aaltaay/Open_Duck_Mini_v2/altaay_lab/HARDWARE_AUDIT.md

# HARDWARE_AUDIT

Last updated: 2026-11-02 about 5:05 AM ET (integration pass by agent INT: B14 tried with the real 5.6 mm eye screw stack on coupon T1, B35 decided by D25 with the 75 tie points of cables3d.json, section 6 counts 22 of 35, section 7 test order TO17). Earlier: 2026-11-02 about 12:10 AM ET (final docs pass by agent NL2: section 6 counts, B1 screw count, B18 cleared on paper, new B33 to B35 from cables3d/CABLES_3D.md and DECISIONS.md D23, D24; about 12:47 AM ET the eye washers and the T14 bit from the BOM pass of agent NL1, D21 note). Earlier: 2026-11-01 about 10:55 PM ET (fastener schedule pass by the Claude Code agent: section 1 counts from fasteners/FASTENERS.md, B2, B7, B8, B14, B20, B21 and B30 updated, B31 and B32 added, DECISIONS.md D19 to D21). Earlier: about 6:25 PM ET with fixes at 6:44 PM ET (print-readiness pass, D8 to D12) and the 2:52 PM ET blocker pass. Question answered: "Every bracket, every washer, every item accounted for?"

Answer: every printed part, insert bore, screw hole, bearing seat and servo pocket in the upstream STLs (commit 730c14b) was measured on the box. Every item below is either measured from CAD/STL geometry or confirmed by a cited source. Anything that could not be verified is a BLOCKER with exactly what is needed to clear it (section 6). Nothing is labelled "inferred" as a final answer.

- Brackets: there are no metal brackets. All brackets are printed parts (52 prints, PRINT_CHECK.md).
- Washers: 16, two 0.3 mm M2.5 washers under each eye screw head as a spacer, because the eye pilots are blind (D21 and its note). No washer seats exist in the STLs; every other screw seats on a flat printed face, a recess or a servo horn.
- Nuts: 0. No nut traps or hex pockets exist in the STLs.
- Inserts: 58 M3 heat-set.
- Screws (fasteners/FASTENERS.md section 1, one record per screw in fasteners/fasteners.json): 322 to fit (D38 screw cut, D39 one more, D42 uniform patterns: +2, D47 mic boards: +4). 201 to buy, 59 from the STS3215 bags, 56 factory fitted servo case screws that stay in, 6 from the SG90 bags. 36 left out on purpose: 2 hip roll screws (D18), 11 idle horn screws that stay in the bags 25 by the D38 screw cut and 3 by D39 (F076, F178, F183; F179 and F182 fitted again). D39: every hole left without a screw is closed in the printed parts, except where another instance of the same STL uses it (twin/holes/HOLES_TWIN.md).
- Bearings: 3 x 6804 (20x32x7).

Method: assembly rebuilt from the URDF (Open_Duck_Mini b23317a, mini_bdx/robots/open_duck_mini_v2) and the print STLs; every cylindrical hole found by ray casting along its axis through all parts it passes (clearance, seat, anchor, pilot depth). Scripts and data: altaay_lab/audit/.

## 1. Fasteners and mechanical
Spares: 10 to 20%, or the pack minimum. "Included" = ships with a component.

| Item | Spec | Where (measured) | Need | Included | Buy | Source | US seller, pack, price | Ships to USA | Verified |
|---|---|---|---|---|---|---|---|---|---|
| M3 heat-set insert | 5.7 mm long, 4.0 mm hole, D1 4.6 | body_middle_bottom 8, body_middle_top 8, head 12, leg_spacer 4x4=16, trunk_bottom 6, foot_bottom_pla 2x2=4, foot_top 2x2=4 | 58 | 0 | 100 | bore 3.9 to 4.2 measured; CNC Kitchen hole spec | CNC Kitchen USA, 100 pcs, $10.90 | Yes | Yes |
| M3x8 SHCS | DIN 912 A2 | into inserts: trunk shell 16, head_bot_sheet to head 8, foot_bottom_tpu to foot_bottom_pla 4 | 28 | 0 | 33 | fasteners.json | Bolt Depot 6379, $0.06 each, $1.98 | Yes | Yes |
| M3x10 SHCS | DIN 912 A2 | into inserts: foot_side to foot_top 4, caches to leg_spacer 4, body_middle_bottom to trunk_bottom 4 | 12 | 0 | 14 | fasteners.json | Bolt Depot 6380, $0.84 | Yes | Yes |
| M3x12 SHCS | DIN 912 A2 | trunk_top to trunk_bottom inserts | 2 | 0 | 3 | fasteners.json | Bolt Depot 6381, $0.18 | Yes | Yes |
| M3x6 SHCS | DIN 912 A2 | printed parts to servo horns 64 (legs 56, roll_motor_top 8), thigh plates to leg_spacer inserts 10, head_roll_mount to head inserts 4 | 78 | 0 | 100 | fasteners.json | Bolt Depot 6378, $3.83 per 100 | Yes | Yes |
| M3x6 button head | ISO 7380 A2 (head 1.65 mm max) | hip pitch idle horn 8 (F196, F198, F200, F247, F209, F211, F213, F254) and thigh plate to leg_spacer 2 (F002, F010), where a DIN 912 head hits roll_to_pitch (D19, B31) | 10 | 0 | 12 | fasteners.json, sweep | BelMetric SB3X6SS, $0.09 each, $1.08 | Yes | Yes (read 2026-11-01 10:34 PM ET); head clearance +0.16 mm in CAD, first leg check |
| M3x5 SHCS | DIN 912 A2 | every neck chain horn screw: head_pitch_to_yaw 16, head_yaw_to_roll 4, neck sheets 8 | 28 | 0 | 33 | fasteners.json | Bolt Depot 6377, $0.05 each, $1.65 | Yes | Yes; 20 of them sit in 5.5 mm recesses that are drilled to 6.0 mm (D20, B32) |
| M3x6 horn centre screw | Feetech rocker screw | horn to servo output, 1 per servo | 14 | 14 (servo bag) | 0 | Feetech datasheet item 6-13 | n/a | n/a | Yes (datasheet M3X6) |
| PA3.0x5 idle screw | Feetech, washer head | idle horn to case boss where nothing else holds the idle horn: both hip yaws and head roll | 3 | 3 (servo bag) | 0 | Feetech datasheet drawing | n/a | n/a | Yes; the other 11 stay in the bags |
| M2x6 self-tapping (servo case) | Feetech bag, the "smallest screws" | printed parts to servo case pilots: legs 12 (including the 4 roll_to_pitch bottom holes, B4), trunk 24, neck 6; 2 more left out (D18) | 42 | 42 (servo bag) | 0 | fasteners.json; LeRobot SO-101 guide | n/a | n/a | BLOCKER B2: the 18-screw bag split by size is not published; the 17h kit holds 50 M2x6 if a bag is short |
| M2x5 self-tapping | pan head, 304, METALLIXITY M2/M2.6 kit, 50 of each size, head 3.7 x 1.4 mm (listing) | servo case pilots where M2x6 would bottom: knee sheets 8, roll_to_pitch 6, trunk_top 4, head_yaw_to_roll 2, head_roll_mount 2 | 22 | 0 | kit | fasteners.json | Amazon B0FS13B75Y, 400 pcs, $9.49, ships from Amazon | Yes | Yes (read 2026-11-01 10:30 PM ET); head fit on coupon C4 (B21) |
| M2x4 self-tapping | same kit | camera 4 (head.stl: 4 blind pilots 1.65 mm, 3.1 mm deep, on 20.9 x 12.5 mm) and head_roll_mount to servo 2 | 6 | 0 | kit | fasteners.json; Raspberry Pi Camera Module 3 drawing 21 x 12.5 mm | same kit | Yes | Pattern yes; camera length on test order (PCB thickness not published, B9) |
| M2x8 self-tapping | same kit | trunk_top to servo bottom case 2 | 2 | 0 | kit | fasteners.json | same kit | Yes | Yes |
| M2.5x6 SHCS | DIN 912 A2 | Pi 4, adapter 4, BNO055 4, charger 1, speaker stand to head 4 (nothing is fitted at the head board.stl copy, B7) | 17 | 0 | 20 | MOUNTING.md, fasteners.json | Bolt Depot 6370, $0.09 each, $1.80 | Yes | Yes |
| M2.5x8 SHCS | DIN 912 A2 | eyes 4 per side, each with two 0.3 mm washers (D21 note) | 8 | 0 | 10 | fasteners.json | Bolt Depot 6371, $0.90 | Yes | Yes |
| M2.5 flat washer | ISO 7092 A4 HV200, 2.7 x 5.0 x 0.3 mm | two under each eye screw head: the eye pilots are blind, 3.0 mm deep (D21 note) | 16 | 0 | 48 | BOM.md 17l | BelMetric WFHV2.5X5SSA4, $0.07 each, $3.36 (48 so the BelMetric cart reaches its $5 minimum) | Yes | Yes (read 2026-11-02 12:20 AM ET), in stock |
| M2.5x10 SHCS | DIN 912 A2 | battery_pack_lid to body_back | 4 | 0 | 5 | fasteners.json | Bolt Depot 6372, $0.10 each, $0.50 | Yes | Yes: head sits proud on the lid face (B3); the 2.5 mm lid holes are drilled to 2.7 mm (D20) |
| M2.5x5 SHCS | DIN 912 A2 | speaker_interface to the 4 side pilots 2.12 of speaker_stand (found by the fastener schedule, B8) | 4 | 0 | 5 | fasteners.json | BelMetric BSH2.5X5SS, $0.12 each, $0.60 | Yes | Yes (read 2026-11-01 10:36 PM ET) |
| Antenna screws | SG90 bag screws | holder to SG90 output shaft 2; SG90 tabs to head 4 (pilots 27.5 mm apart vs SG90 tab holes 27.6 mm) | 6 | 6 (SG90 bags) | 0 | GLB ray cast, B5; fasteners.json | n/a | n/a | Geometry yes; bag screw sizes on the test order (SG90 pack) |
| Servo case screws | PA2.0 self-tapping, factory fitted | 4 per servo, inside the case | 56 | 56 (in the servos) | 0 | Feetech datasheet drawing | n/a | n/a | Do not remove |
| Ball bearing | 6804ZZ 20x32x7 | trunk_bottom 2 seats, head 1 seat, all 32.19 mm | 3 | 0 | 10 (pack) | CAD bearing model 19.99/32.19/7.0 | Motoforti 10-pack, $7.74 | Yes | Yes (Amazon showed 1 left, 2026-11-01) |
| Threadlocker | Loctite 243 | metal to metal horn screws only (not into PLA) | 1 | 0 | 1 | Loctite TDS | Amazon, $9.90 | Yes | Yes |

Screw total (fasteners/fasteners.json, FASTENERS.md sections 1 and 2): machine screws to buy 18 + 12 + 2 + 78 + 10 + 28 + 11 + 4 + 3 + 2 = 168 (BOM 17a to 17g, 17i, 17j, 17k), plus 28 kit self-tapping screws (22 M2x5, 6 M2x4, 2 M2x8, BOM 17h) = 221 to buy; 42 + 14 + 3 = 59 from the STS3215 bags; 56 factory case screws stay in the servos; 6 from the SG90 bags; 342 to fit. Left out on purpose: 2 hip roll screws (D18) and 11 idle horn screws. Washers 16 (D21 note). 0 holes without an anchor. The earlier per-hole count (189 + 4 bought, from audit/screws2.json on the URDF meshes) is superseded: the print/ STLs differ from the URDF meshes (FASTENERS.md finding 20) and 4 leg screws were counted twice (finding 23).

## 2. Printed parts
Full per-STL measurements are in PRINT_CHECK.md. Totals: PLA 15% 50 parts, 1304.0 g, 127.7 h; TPU 40% 2 parts, 35.0 g, 3.9 h. Filament bought: 2 kg PLA, 1 kg TPU.

| STL | Qty | | STL | Qty |
|---|---|---|---|---|
| battery_pack_lid | 1 | | left_antenna_holder / right_antenna_holder | 1 / 1 |
| body_back | 1 | | left_cache / right_cache | 1 / 1 |
| body_front | 1 | | left_eye / right_eye | 1 / 1 |
| body_middle_bottom | 1 | | left_roll_to_pitch / right_roll_to_pitch | 1 / 1 |
| body_middle_top | 1 | | leg_spacer | 4 |
| bulb | 2 (guide says 1, CAD has 2) | | neck_left_sheet / neck_right_sheet | 1 / 1 |
| flash_light_module | 1 | | roll_motor_bottom | 2 |
| flash_reflector_interface | 1 | | roll_motor_top | 2 |
| foot_bottom_pla | 2 | | speaker_interface | 1 |
| foot_bottom_tpu (TPU) | 2 | | speaker_stand | 1 |
| foot_side | 2 | | trunk_bottom | 1 |
| foot_top | 2 | | trunk_top | 1 |
| head | 1 | | knee_to_ankle_left_sheet | 4 |
| head_bot_sheet | 1 | | knee_to_ankle_right_sheet | 4 |
| head_pitch_to_yaw | 1 | | head_roll_mount | 1 |
| head_yaw_to_roll | 1 | | | |

## 3. Electronics and modules
Every module, its mount and screw: MOUNTING.md. Every buy line with link and price: BOM.md.

## 4. Cables, connectors, crimps
Every cable as a row (ends, part numbers, route, length, source, tool): CABLE_MAP.md. Connectors to buy: Molex 50-37-5033 housings and 08-70-1040 terminals, BOM.md lines 21 and 22 (counts from wiring/netlist.yaml: the D15 star leads and the D23 ankle feeds), and XT30U pairs (1 used).

## 5. Tools
BOM.md, section "Tools (one-time)": Pinecil V2, insert tips, Engineer PA-09, Bondhus 12192 hex keys (2.0 mm for M2.5 and for the M3 ISO 7380 button heads, 2.5 mm for M3 DIN 912), Klein 11057 stripper, Castle Link V4, and for the drill steps after printing a 6.0 mm and a 2.7 mm HSS bit (D20) and a 4.0 mm bit (D24 and the D25 tie holes) with a T-handle holder (T11 to T14; T15 4.5 mm only if coupon C4 needs it).

## 6. BLOCKERS (status after the 2026-11-04 V1 electrical twin, about 4:50 PM ET)
Rule: an item is CLEARED only when it was measured from the upstream CAD (print STLs at 730c14b, Tnkr GLB of the upstream assembly) or confirmed by a cited source read on 2026-11-01. Everything else stays OPEN. Items that only a real part can settle are on the "Needs test order" list (section 7, priced in BOM.md).

Totals after the V1 knee swap (2026-11-05, D32 and D38): 30 of 73 cleared or decided, 7 settled by the coupon test prints, 7 waiting on the parts check, 22 assembly or bench checks; B70 to B73 new (B71 decided by D38; twin/knee/KNEE_TWIN.md).

Totals after the V1 3D track (2026-11-04 night): 26 of the then 64 rows cleared or decided, 6 then waiting on the parts check; B60 to B64 new (B60 and B61 decided by D34; B63 and B64 cleared, CAD check; B62 open, an assembly and bench check).

Totals after the V1 screws job (phase 2, 2026-11-04 about 8:46 PM ET, D36 and D38): 29 of the then 69 rows cleared or decided, 7 settled by the coupon test prints, 6 then waiting on the parts check; B65 to B69 new (twin/screws/SCREWS_TWIN.md).

Totals after the V1 assembly twin (track 2, 2026-11-04 evening): 22 of the then 59 rows cleared or decided, 6 then waiting on the parts check; B53 to B59 new (B54 fixed in the twin, CAD check; B49 fixed in the twin by D30, its bench check stays open). The count below is the track 1b one, when the table had 52 rows.

Totals after the 2026-11-04 V1 electrical fixes (track 1b, about 5:40 PM ET): 22 of the then 52 rows cleared or decided (B1, B3, B4, B5, B7, B9, B11, B12, B13, B18 cleared on paper, B19, B22, B23, B24, B25, B27, B28, B29, B30 decided by D18, B31 by D19, B34 by D24, B35 by D25), 5 then waiting on the parts check (B8 speaker, B33 ankle plugs at foot_side, B38 PLA at the hot parts, which waits for B36 and B37, and from the structure twin, FEA pass only: B42 roll_to_pitch and B43 the knee sheet eye, which wait for the proof loads of print/PRINT_PLAN.md step 2 check 7 and for D26), 5 then settled by the coupon test prints (B14, B15, B16, B26, B32 decided by D20 and tried on coupon C4), 19 assembly or bench items at that time with real parts that do not block printing (B2, B6, B10, B17, B20, B21, and from the twins and the shared lab gym, sim pass only: B36, B37, B39, B40, B41, from the structure twin: B44 fatigue life, B46 fastener data, and from the V1 electrical twin, sim pass only and calc only: B47 the BMS trip current, B48 power-on inrush, B49 the drain after the guard's poweroff, and from the track 1b fixes: B50 the servo gains in the twin, B51 the restart after a power loss, B52 the IMU on software I2C), 1 for Ahmed to decide later (B45, the floor of the first walks; a proposal, not decided). Print-blocking blockers left: none. B33 is a first-leg check before the other plates print, as D18 and D19; B42 and B43 are left-leg checks before the right leg prints; B38 (PLA or PETG at the hot parts) is settled after B36 and B37, before the full print; B31, B32, B34 and B35 are build steps (button heads at assembly, recess drilling, the D24 hole and the D25 tie holes after printing, and the D25 bundle ties checked at the harness test fit). The coupon session is the first print and needs Ahmed's OK (lab rule 4).

| # | Blocker | Status | How verified, or what is still needed |
|---|---|---|---|
| B1 | Upstream Onshape BOM export (fastener list) | CLEARED (decision, 2026-11-01 about 6:25 PM ET) | The fastener schedule (fasteners/fasteners.json, section 1) is the fastener list for ordering (201 screws by size with the 4 D47 mic screws, 47 inserts); 320 screws are fitted in all, the rest from the servo and SG90 bags or factory fitted. An upstream Onshape export is no longer needed. Upstream issue 33 still lists the screw docs as a TODO. |
| B2 | STS3215 bag contents by size (18 screws) | OPEN, assembly check (not print-blocking), test order 1 | Count the 18-screw servo bag by size on the first servo. The METALLIXITY M2 kit (BOM 17h) covers any short count: it holds 50 M2x6 against the 42 used (listing images, read 2026-11-01 10:31 PM ET). The bag M2 head also gets the 4.0 mm recess fit test on coupon C4 (D20). |
| B3 | battery_pack_lid recess 4.0 vs M2.5 head 4.5 | CLEARED | Measured in the GLB: the M2.5x10 DIN 912 head sits proud on the lid face, clamp 5.2 mm, engagement 4.8 mm into the body_back pilot, no part within 1 mm of the head envelope. No STL edit and no low-head screw needed. Keep M2.5x10 (Bolt Depot 6372). |
| B4 | roll_to_pitch: 4 clearance holes, no anchor | CLEARED | Ray cast through the GLB assembly: each hole lands on an STS3215 case pilot 1.67 mm, 4.6 mm deep. Screw: M2x6 self-tapping, the servo bag type. |
| B5 | Antenna holder holes and 39.2 mm pilot spacing | CLEARED | The 39.2 mm figure was wrong. Head tab pilots measure 27.5 mm apart; SG90 tab holes 27.6 mm (GLB sg90 model). The 2 holder holes (clearance 2.7 in a 5.05 recess) land on the SG90 horn. Screws from the SG90 bags; their sizes are confirmed on the test order (SG90 pack). |
| B6 | Horn to case gap and pilot depth at the 2 M2x5 sites | OPEN, assembly check (not print-blocking), test order 1 and 4 | Real servo plus M2x5 from the METALLIXITY kit. |
| B7 | Second board.stl in the head | CLEARED | There is one board; the adapter is on trunk_top and upstream bom.csv lists one adapter. M2.5x6 count drops from 21 to 17. Basis corrected 2026-11-01 (fasteners/FASTENERS.md finding 22): the head board.stl copy does not share the Pi holes (Pi 58 x 23 mm on the left, copy 28 x 37 mm on the right); the conclusion holds because print/head.stl has no pilots under the copy, so nothing is fitted there. |
| B8 | Speaker retention and size; projector LED retention | OPEN, test order 7 and 10 | CAD speaker_top envelope 38.5 x 38.7 x 15 mm; speaker_interface has 4 holes 2.7 mm that match 4 pilots 2.12 mm in speaker_stand (32 x 32 mm); the pilots are on the hole axis: measured on the mesh 0.01 deg off (2026-11-06 ET, twin/freeze/speaker_pilots.py, CAD check only); the "20.7 deg off" was the feat3d fit reading them along the head y axis, the artefact PR 25 found on the ear pilots. Each 2.05 mm pilot runs through 4.5 mm of stand wall, so the 2 fitted M2.5x5 DIN 912 A2 (BOM 17k, the diagonal pair F353 and F354 since D38) engage 3.4 mm with the tip 1.1 mm short of the far face (FASTENERS.md finding 19); the screws go straight in. Since D52 the interface carries the speaker duct (twin/freeze/speaker_duct.json). Upstream ANGEEK B086JH2BTD (40 mm, 4 ohm, 3 W) is not sold on amazon.com; US equivalent uxcell B07M5K17SK (40 x 40 x 20 mm per listing). Retention needs the real speaker in a printed speaker_interface. Projector: the flash_reflector_interface seat tapers to 20.0 mm (measured); retention of the LED needs the real reflector. |
| B9 | Camera not in CAD | CLEARED (part and mount); screw length on test order 8 | head.stl has 4 blind pilots 1.65 mm, 3.1 mm deep, on 20.9 x 12.5 mm. Raspberry Pi Camera Module 3 mechanical drawing (datasheets.raspberrypi.com): 25 x 24 mm board, 4 x 2.2 mm holes 2 mm from the edges, 21 x 12.5 mm pattern, which matches. Part: Adafruit 5657 ($29.25, in stock) with Adafruit 3157 Pi Zero camera cable 150 mm ($5.95). PCB thickness is not published, so M2x4 vs M2x3 is a test-order item. |
| B10 | STS3215 connector positions not modelled | OPEN, assembly check (not print-blocking), test order 1 | Tnkr: both bus ports sit side by side in a slot in the bottom case, plugs from below. Exact position on the first servo; affects cable routing only. |
| B11 | Seats not in CAD | CLEARED (2026-11-01 about 6:20 PM ET) | Seats found for every part not in the CAD by a free-space search over the swept volume of all moving trunk joints with cable keep-outs (audit/free_space.py, audit/place_parts.py, audit/placements.json): BEC Pro flat on the belly floor, fuse holder and Pololu 2815 on the battery bay front wall, 5 V regulator on the head floor. Foam tape, no new printed part. MOUNTING.md. |
| B12 | BMS fit | CLEARED (2026-11-01 about 6:20 PM ET, D10) | Tenergy 32175 (34 x 16 x 4.5 mm, 10 A working, over-current detect 22 +/- 5 A, full spec table, US seller) fits the measured envelope 17.75 x 47.2 x 5.33 mm. Current check: sim/CURRENT_BUDGET.md. |
| B13 | BNO055 2472 hole spacing | CLEARED (2026-11-01 6:05 PM ET) | Adafruit design file (github.com/adafruit/Adafruit-BNO055-Breakout-PCB, Adafruit BNO055.brd, commit 64c5a38): 4 plated holes, drill 2.5 mm, at 21.59 x 15.24 mm on a 26.67 x 20.32 mm board. CAD pilots 21.9 x 14.9: each hole is 0.23 mm off its pilot, inside normal print tolerance for an M2.5 screw self-tapping a 2.0 mm PLA pilot. Fallback: 2 diagonal screws (diagonals differ by 0.06 mm). |
| B14 | Left eye pilot 2.2 vs right 2.05 | TEST PRINT, coupon session (print/PRINT_PLAN.md, T1) | Print left_eye.stl first (T1) with the stack pieces T1b (bulb) and T1w (head wall) and drive an M2.5x8 through two 0.3 mm washers (BOM 17l), T1b and T1w, 5.6 mm under its head as in the robot: the pilots are blind, 3.0 mm deep, so the robot stack (washers 0.6, bulb 2.0, head wall 3.0) leaves 2.4 mm of thread (D21 note). If loose, add a drop of medium CA glue in the pilot and re-seat, or use an M2.5 thread-forming screw for plastic. PrusaSlicer 2.7 has no hole-only compensation (Orca and Bambu Studio do). |
| B15 | Shallowest blind insert bore (foot_bottom_pla: 5.8 mm deep with a drill-point cone, 1.06 mm floor, for a 5.7 mm insert) | TEST PRINT, coupon C3 | One insert into the bore on coupon C3 cut from the real part (print/make_coupons.py): it must sit flush with no plastic pushed up around it. The 6.7 mm depth quoted earlier does not exist in any STL (print package check, 2026-11-01). |
| B16 | foot_top insert wall 1.5 mm | TEST PRINT, coupon C2 | foot_top printed with enough perimeters to make the 1.5 mm wall solid (print/ slicer override), then a pull test on the coupon. |
| B17 | Kit servo cable lengths on 10 hops | OPEN, assembly check (not print-blocking), test order 1 | Test-fit kit cables at joint limits on the first leg. Contingency X1/X2 (made Mini-SPOX leads) is in the BOM. |
| B18 | USB cable 50 cm vs 502.6 mm rule | CLEARED (on paper, 2026-11-02: 0.9 m cable and its 3D route), test fit on test order 3 | BOM line 20 is now the 0.9 m Adafruit 3878 (Adafruit page, read 2026-11-01). The 3D route of D1 measures 523 mm worst over the full URDF ranges (499 mm in the Runtime head ranges), 563 mm with the 40 mm slack: 337 mm spare, coiled in the belly (cables3d/CABLES_3D.md). Test fit through the neck and the coil on test order 3. |
| B19 | Neck chain join | CLEARED | Tnkr wiring (upstream assembly docs, "as in the creator's wiring diagram"): no splitter; adapter socket 1 to left hip yaw, socket 2 to right hip yaw; the neck chain starts from the left ankle's free bus port and runs up to neck pitch, head pitch, head yaw, head roll. Every STS3215 has 2 ports in parallel. Made lead left ankle to neck pitch: polyline 336.4 + 45.2 + 40 + 68.1 (6.81 rad) = 489.7, cut 490 mm, 2 housings and 6 terminals. Y-lead S1Y dropped. Superseded by D15 (star wiring: SP3 feeds the neck at ID 30). |
| B20 | IMU axis signs | OPEN, bench test after assembly (not print-blocking) | Tilt test: run scripts/calibrate_imu.py from scripts/, then bench/imu_check.py --tilt (calibrate_imu.py only calibrates and saves the offsets; software/SOFTWARE.md sections 2 and 4). The walk script and calibrate_imu.py use raw_imu.py: NDOF mode, axis remap (Y, X, Z) with signs (-, +, +) when upside_down is false (imu.py, IMUPLUS mode, is not used by the walk). The policy reads only raw gyro and accelerometer. Also log 1000 still reads to catch the I2C glitches in UPSTREAM_ISSUES.md G2. |
| B21 | M2x5 head fit | OPEN, assembly check (not print-blocking), test order 1 and 4 | Test fit of M2x5 heads. 24 M2 pan heads sit in 4.0 mm recesses (trunk_top, head_yaw_to_roll, roll_to_pitch; 10 kit M2x5, 14 servo-bag M2x6). Kit head 3.7 x 1.4 mm per its listing image (read 2026-11-01 10:31 PM ET), so 0.3 mm clearance before print shrinkage. Fit test on coupon C4, which holds 4 of these recesses (D20); open a recess to 4.5 mm if a head does not drop in. |
| B22 | 15 A switch that fits the body_back cutout | CLEARED (2026-11-01 about 6:20 PM ET, D8) | Design change: a Pololu 2815 Big MOSFET Slide Switch HP carries the pack current (6 A at 55 C, 16 A at 150 C, 90 A max) and the stock panel switch in the body_back cutout only pulls its control pin to GND (microamps). No STL change. POWER.md section 6. |
| B23 | LED type and resistor | CLEARED | Upstream bom.csv: 1 W LED beads. Tnkr (m7): two 1 W eye LEDs on GPIO27 and GPIO22, each through a 100 ohm resistor. Parts: uxcell 1 W warm white 10 pcs B07DHB13J4 ($6.89), SparkFun PRT-14493 100 ohm 20-pack ($1.50). Pins: D9 (2026-11-01) wires the eyes to GPIO24 (left, pin 18) and GPIO23 (right, pin 16) per the Runtime code; the Tnkr pins GPIO27/GPIO22 are the foot switch pins in the code and are not used. Resistors: 3 needed (2 eyes plus the projector LED, D13); the 20-pack covers it. |
| B24 | Pi Zero 2 W stock | DECIDED (2026-11-01 about 6:20 PM ET, D7), not print-blocking | Bare board out of stock at Adafruit, PiShop, CanaKit and Vilros (checked 2026-11-01). In stock: CanaKit PI-Z2WH-STR32-C4-BLK kit with pre-soldered header, $89.95. The header fits: 44.3 mm free below the Pi in the head (ray cast). |
| B25 | microSD model | CLEARED | SanDisk Ultra 32 GB SDSQUAR-032G-GN6MA, https://www.amazon.com/dp/B073JWXGNT, $21.25, in stock. |
| B26 | TPU hardness | TEST PRINT, coupon session | Print foot_bottom_tpu in Overture TPU 95A, check grip and fit on foot_bottom_pla. |
| B27 | Holder mid tap for the BMS balance lead | CLEARED | Tnkr m1 and m2: the holder strip makes the series link, the MID take-off goes to BMS BM with a 24 to 26 AWG lead. Solder P3 to the strap. |
| B28 | Lead lengths | CLEARED (decision, 2026-11-01 about 6:25 PM ET) | No cost impact: every short lead is extended with the bought 16, 20, 22 and 26 AWG wire (D9 SG90 lead +20 mm of 26 AWG). Holder, regulator and BEC lead lengths are measured on arrival. |
| B29 | Order minimums | CLEARED | Bolt Depot: "Do you have a minimum order? No" (service page). Mouser: no minimum order value for stocked parts (Ordering Options help page, read via search index, direct fetch 403). DigiKey and Newark: qty 1 allowed on every line used (pricing tables). CNC Kitchen, Adafruit, SparkFun, Seeed, Amazon: pack products, no minimum. Shipping excluded by the owner. |
| B30 | Hip roll servo screw head against roll_to_pitch (upstream issue 17) | DECIDED (D18, 2026-11-01 7:32 PM ET), checked on the first leg | CAD: the outer M2 screw in roll_motor_bottom sits 0.31 mm from the roll_to_pitch arm; a pan head overlaps it by 1.3 mm over the full hip roll range, both legs (print/check_hip_roll_screw.py). Leave that screw out; if the servo is not rigid on the first leg, cut a relief in roll_to_pitch before the right leg is printed. The fastener sweep finds the same hit (0.80 mm with the screw on the pilot centre line, fasteners/FASTENERS.md finding 1). The same check on the first leg covers the hip pitch idle horn screws: B31, D19. |
| B31 | Hip pitch idle horn screw heads against roll_to_pitch (fastener sweep) | DECIDED (D19, 2026-11-01 10:50 PM ET), checked on the first leg | CAD sweep (fasteners/sweep_fasteners.py, FASTENERS.md findings 2, 5, 6): at the 8 thigh plate to hip pitch idle horn sites (F196, F198, F200, F247, F209, F211, F213, F254) a DIN 912 M3 head overlaps roll_to_pitch by 1.19 mm at every hip pitch angle, both legs; at F002 and F010 it is hit by 0.19 mm from hip pitch +/-18.9 deg. Fit M3x6 ISO 7380 A2 button heads at these 10 sites (BOM 17j): worst clearance +0.16 mm and +1.16 mm. Turn the hip pitch through its range by hand on the first leg (print/PRINT_PLAN.md left-leg check 5); if a head rubs, cut a relief in roll_to_pitch before the right leg is printed. Open note: at F198 and F211 the head still meets body_middle_bottom past 21.7 deg of hip yaw (FASTENERS.md findings 3 and 4), a joint range point for the sim and controller owners. |
| B32 | Neck chain screw recesses 5.5 mm vs DIN 912 M3 heads 5.50 to 5.68 mm | DECIDED (D20, 2026-11-01 10:50 PM ET), TEST PRINT, coupon C4 | 24 recesses in head_pitch_to_yaw (16), head_yaw_to_roll (4) and head_roll_mount (4) (FASTENERS.md finding 11). A head that does not drop in sits 2.0 to 5.0 mm high and loses its thread. Drill each recess to 6.0 mm after printing (BOM T11, T13; print/PRINT_PLAN.md "After printing"), and the 4 battery_pack_lid holes from 2.5 to 2.7 mm (T12). Coupon C4 holds 4 of these recesses: the head fit and the drill step are tried there first. |
| B33 | Ankle servo plugs and SP4/SP5 at the foot_side apex (cables3d) | OPEN, test fit on the first leg before the other plates print, test order 1 | The ankle servo sockets (ID 24, ID 14: BUS 2 takes the kit cable, BUS 1 the D23 feed SP4 or SP5) sit at the foot_side apex: the plug back is 0.5 to 1.7 mm from foot_side at the zero pose and the SP4/SP5 route touches it (0.5 mm into foot_side in the exact-mesh check); the plug protrusion is UNVERIFIED. Fit the TO1 servo with both plugs in the first printed foot_side and turn the ankle through its range (TEST_PLAN 1.5). If a plug or wire presses on the apex: a 2 mm relief at the foot_side apex (CAD change) before the other plates print. |
| B34 | Projector LED lead passage in the head (D7) | DECIDED (D24, 2026-11-02), drill after printing | flash_light_module sits outside the head left wall and its 4 mm lead channel opens outside the shell; print/head.stl has no passage (cables3d/CABLES_3D.md). D24: drill a 4.0 mm hole through the printed head wall along y at (64.5, 84.8, 209.3) mm (URDF world frame, zero pose), 2.5 mm behind the module, instead of editing head.stl; where and how on the part: print/PRINT_PLAN.md "After printing" step 4. D7 then routes 78 mm worst inside the head; its 160 mm cut stays. Tool: BOM T14 (4.0 mm bit) in the T13 holder. |
| B35 | Cable retention: 9 tie points held by a tie round the bundle only (cables3d, D25) | DECIDED (D25); test fit at the harness build (TEST_PLAN 1.4), not print-blocking | cables3d.json (2026-11-02 4:31 AM ET): 75 tie points, one anchor per spot (15 points share a nearby anchor, one tie round both bundles): 32 MB3A (BOM 34), 23 Panduit ABM1M-AT-C (BOM 34b), 6 stock holes or slots, 3 pairs of 4.0 mm tie holes drilled after printing (print/PRINT_PLAN.md After printing step 5), 2 ties to an anchored neighbour cable. 9 points have no anchor that fits: T016, T017, T023, T024, T085 (neck), T034, T045 (knee loop ends), T026 and T089 (route changes to a mount patch tried and not kept: the cuts would no longer fit with the 40 mm slack). D25 adds no printed parts and no STL change: a tie round the bundle only, checked at both joint limits at the TEST_PLAN 1.4 test fit; a drilled tie-hole pair or a printed anchor only if the bundle reaches a moving part. |
| B36 | STS3215 thermal data: thermal resistance, time constant, sensor position, winding limit (none published) | OPEN, bench test with the TO1 servo (TEST_PLAN 7.3 revised), test order 1 | twin/thermal/THERMAL_TWIN.md bounds them from physics on the measured case, the Faulhaber size class and the only published curve (Robo9, C018): central corner, the hotter knee reaches the 70 C cut after about 10 minutes (plain model) or 4 minutes (backlash model) of continuous walking at 25 C; 50/50 (plain model) and 25/75 do not cut, the backlash 50/50 cuts after 8 to 13 minutes. The TO1 holds at 0.9 and 1.2 A give the values the twin needs; re-run the twin, then the duty limit or the guard with rests (THERMAL_TWIN.md section 6), and SERVO_UPGRADE_OPTIONS.md only if those are not enough. Sim pass only. |
| B37 | CC BEC Pro efficiency, dropout and minimum input, and the trunk electronics heat in the closed body (Castle publishes no efficiency, dropout, minimum input or thermal data) | OPEN, bench tests TEST_PLAN 4.1 and 4.2, and the walking log | twin/thermal, central: 6 to 9 W in the trunk while walking, about 60 % of it the BEC at the assumed 85 %; at the battery stop BEC case 98 to 122 C, trunk air 38 to 48 C, cells 44 to 56 C (P30B discharge limit 60 C), Pololu 2815 59 to 83 C; the 4.2 gate (board under 50 C) is expected to fail. twin/electromech: at a nominal pack the walk speed follows the dropout, 0.752 / 0.706 / 0.663 of the command at 0.10 / 0.30 / 0.60 V (typical corner). Measure the efficiency and the dropout in 4.1 (input sweep down to 6.5 V, D16(b)) and log the BNO055 temperature in TEST_PLAN 9. Sim pass only. |
| B38 | PLA at the servo cases and the hot electronics | OPEN, after B36 and B37, before the full print | PLA HDT 49 to 57 C, Tg 55 to 60 C (Overture Easy PLA gives only Vicat 66.2 C). twin/thermal, central: the eight knee-to-ankle sheets see 54 to 66 C in continuous and 50/50 walking (47 to 55 C at 25/75), trunk_top and roll_to_pitch up to 61 C, the belly floor under the BEC (case 98 to 116 C) and the battery_pack_lid at the 2815 (59 to 76 C) and the BMS (49 to 60 C). Option, not decided: PETG (HDT 69 C) for those parts (THERMAL_TWIN.md section 6). Sim pass only. Structure twin note 2026-11-03 (twin/structure/STRUCTURE_TWIN.md section 5): at 50 C printed PLA keeps about 0.62 of its strength and 0.84 of its modulus (Slavkovic et al. 2024; Grasso et al. 2018), so the knee sheet eye and roll_to_pitch fall to SF about 1.0 walking and 0.7 in push; at 60 C the strength is a BLOCKER and the modulus is about 0.25. Standing, they hold 3.4 to 4.3 MPa, 2 to 10 x the HDT test stress: creep is expected above about 50 C (rate: BLOCKER). PETG (Bambu PETG HF TDS) gives about 1.1 to 1.3 walking up to about 60 C (ASSUMPTION), not 2. FEA pass only. |
| B39 | STS3215 firmware response to its bus volts: does the duty compensate when the supply sags (Feetech does not publish it) | OPEN, bench test with the TO1 servo (TEST_PLAN 7.5), test order 1 | twin/electromech/ELECTROMECH_TWIN.md uses the BAM model (motor volts = bus x duty, so the gain and the torque limit fall with V / 7.4). If the firmware compensates, the nominal-pack walk keeps 0.859 of the command (95 % of the trained speed) against 0.706 (sweep, typical corner), but the knees spend 16 to 18 % of the walk under 6.0 V against 4 to 5 %. It sets most of the twin's walk speed loss. Sim pass only. |
| B40 | Pi Zero 2 W chip temperature rise over the head air (not published) | OPEN, the walking log (TEST_PLAN 9, vcgencmd measure_temp), a bench check after assembly | twin/thermal/THERMAL_TWIN.md section 4, central: head air 34 C at a 25 C room and 41 C at 32 C; the 5 V branch 3 W typical, 5 W conservative; the Pi throttles from 80 C (Raspberry Pi documentation, THERMAL_TWIN.md source S3). The chip's own rise is the missing step. Sim pass only. |
| B41 | Real sole-to-floor friction (the TPU sole on the floors the duck will walk on), not measured | OPEN, bench check of the printed TPU sole (B26) on each floor, before the first walk | The stock policy was trained at floor friction 0.6 only: its friction randomization writes to a visual geom (history/2026-11-03_1524_duck_gym_overlay.md). In the duck's training physics (2 ms Euler, Newton with 1 iteration, pyramidal cone, mu 0.6) our build never falls under the 15 N pushes; in the shared lab gym (overlay gym/overlays/duck: 1 ms, implicitfast, elliptic cone with impratio 5, mu 1.0) it falls in 6 of 6 seeds, and mu 1.0 alone on the training physics also makes it fall (13.8 s). So the push and side step results are marginal, and the real friction says which sim to trust. Measure it, for example the tilt at which a loaded sole starts to slide on a floor sample (mu = tan of that angle). Sim pass only. |
| B42 | roll_to_pitch, both legs (D22 light profile, 2 walls 15 %): walking margin | OPEN, before the right leg prints | twin/structure/STRUCTURE_TWIN.md (FEA pass only, on sim pass only loads): SF 1.48 to 1.63 walking and 1.08 to 1.21 in push recovery (mesh levels 1 to 3), under the lab margin of 2, at the side wall between the two hip roll horn ears. Its profile before D22 (3 walls 15 %, the parts.csv heavy column) gives 1.84 / 1.25 at mesh level 1, against 1.60 / 1.11 there, for +7.2 g and +0.44 h for both legs; 4 or 6 walls with 40 % infill add little; both other print orientations are worse. At 50 C the SF are about 0.62 x these (0.93 to 1.02 walking; B38). Proof load on a spare roll_to_pitch, only if one is printed (STRUCTURE_TWIN.md P6; print/PRINT_PLAN.md step 2 check 7); DECISIONS.md D26. |
| B43 | knee_to_ankle_left_sheet at the knee drive horn eye (both legs) | OPEN, before the right leg prints | STRUCTURE_TWIN.md (FEA pass only, on sim pass only loads): SF 1.63 walking and 1.07 in push recovery (mesh level 2, in-plane: the 2.5 to 3 mm of plastic between a horn screw hole and the eye edge; the knee torque, 4.4 N m walking and up to 8.6 N m in push, gives about 80 % of the stress). The same sheet on the thigh (the hip pitch horn eye) holds 2.70 walking but 1.74 in push. At 50 C the SF are about 0.62 x these (1.02 walking; B38). Options: a CAD change of the eye (P2), 5 walls 40 % (1.82 / 1.20 at mesh level 1, against 1.56 / 1.04 there, +9.4 g and +1.1 h for all 8), PETG (P5). Proof load on the spare sheet (print/PRINT_PLAN.md step 2 check 7); DECISIONS.md D26. |
| B44 | Fatigue life of the knee sheet eye and roll_to_pitch | OPEN, bench fatigue test, needs a rig (not in the lab) | STRUCTURE_TWIN.md section 4 (FEA pass only; 6667 load cycles per hour per leg): on the design curve of Ezeh and Susmel 2018 (P_s 95 %) both last under 1 hour of walking (roll_to_pitch 0.04 to 0.7 h, the knee sheet eye 0.02 to 0.5 h); the thigh sheet (2 to 11 h), foot_top (50 h in the side step) and the neck sheets (28 h in the turn) do not reach 100 hours on it either. On the best-case print data of Gomez-Gras et al. 2018 neither fails (ratio 1.2). No mean S-N data for this filament and these settings were found. Until a rig test: the inspection schedule of TEST_PLAN 9 (floor and falls). |
| B45 | Falls on a hard floor | DECIDE (for Ahmed, later: the floor of the first walks) | STRUCTURE_TWIN.md sections 1.3 and 6 (sim pass only, FEA pass only): the contact stiffness of a fall is not known, so it is a range. A hit in the middle of a printed wall ("soft", 0.14 to 0.34 MN/m) gives the hit part 400 to 900 N and the head 15 to 71 g; an edge on a hard floor ("mid", 1.35 to 3.2 MN/m) 1300 to 2800 N and 54 to 196 g. Even at the soft level roll_to_pitch (7 to 8 of 10 falls), the neck sheets (9 of 10) and head_roll_mount (5 of 10) are under the 1.2 fall margin, and a hand calc puts a wall hit at 31 to 115 MPa in the body shell and 25 to 90 MPa in the head (strength 47.1 MPa). Proposed, not decided (P6): the first walks on a soft floor (foam mat or carpet) with a tether, and spare roll_to_pitch parts (both, 42.5 g with supports, 4.2 h). |
| B46 | Fastener data not published | OPEN, coupon and bench tests | No published pull-out data were found for M2 or M2.5 self-tapping screws in printed PLA pilots, for the M2 case screws in the STS3215 PA+GF pilots, or for the sideways strength of M3 inserts in PLA; the STS3215 horn alloy is not published (it sets the thread check of the M3 horn screws). Computed values in STRUCTURE_TWIN.md section 3 (on sim pass only loads): the left ankle servo case screws are at SF 1.6 walking (PLA bearing in the 2.0 mm sheet), the knee and ankle case screws at 1.1 to 1.9 in push. |
| B47 | Tenergy 32175 over-current trip (22 +/- 5 A after 8 +/- 4 ms) against a hard shove | OPEN, bench check (TEST_PLAN 3.3, pass line 21 A) | twin/electrical/ELECTRICAL_TWIN.md (sim pass only): a 60 N, 0.1 s shove to the left of the standing duck makes the stock policy saturate several servos at once; the pack draws 19.5 to 20.6 A, over 17 A for 4 to 13 ms (6 of 6 seeds, also with the policy running after the fall). A board that trips at 20 A or more trips in 0 of 41 simulated falls and get-ups, one at 17 A in 7. A trip opens the BMS until the load is cut: the duck goes dark (the Pi with no shutdown) until the panel switch is cycled. Walking 8.6 A, get-up throws 11.8 A, 40 N walking pushes 13.2 A (22.6 A for at most 1 ms with the policy running on the floor). Settled by the measured trip current; a board under 21 A gets a second board (BOM line 8, Ahmed's OK) or the risk is accepted. 2026-11-04 about 5:40 PM ET, track 1b FIX (sim pass only; ELECTRICAL_TWIN.md, Track 1b fixes): two twin corrections first: the robot runs P 30 on the legs and P 8 on the head (v2_rl_walk_mujoco.py lines 175 to 179), and with the policy left running on the floor (the stock runtime has no fall stop) the pack held 18.60 A for 4 ms and passed 17 A for 9 ms, tripping a 17 A board in 10 of 36 replays. Fix: twin/electrical/fix/bus_budget.py TargetGuard in the walk loop, the training's own target clip (5.24 rad/s, commented out in the runtime) plus a 10 A servo bus budget; no register change. After: every event under 17 A for 4 ms (worst 15.89 A, floor case at half charge; 13.61 A with the optional fall hold), 0 trips of a 17 A board in 252 replays; falls, pushes survived and the walk unchanged. Track 3 runs it in the real code; TEST_PLAN 3.3 stays the confirmation (any in-band board passes with the guard). |
| B48 | Power-on inrush against the BMS short-circuit function | OPEN, bench check (TEST_PLAN 3.5, 20 power-ons) | Not published: the Tenergy short-circuit threshold and delay, the CC BEC Pro input capacitance and soft start, the STS3215 input capacitance, the Pololu 2815 MOSFET gate charge (its schematic names no part; the gates turn on through 100 kOhm). Calc only (ELECTRICAL_TWIN.md): an instant switch-on gives at most 85 A decaying with 0.099 ohm x C; the over-current function would need about 25 mF on the bus to see 17 A for 4 ms, so it cannot trip; the BEC charging the servo bus at its 20 A peak rating takes about 2.9 ms for 8 mF (ASSUMPTION). The panel switch carries 84 uA (no arc); mate the XT30 with the panel switch off. 2026-11-04 track 1b (calc only): worst cited class values, TI BQ2970 family: short circuit after 125 us at the fastest, at 1.14 x the over-current point at the tolerance edges (19.4 A for a 17 A board). The 2815 turns on through R2 100 kOhm (Pololu schematic 0J1071), so the inrush depends on its unnamed MOSFETs and the unpublished BEC input capacitance. Ready fix if TEST_PLAN 3.5 trips or reads over 17 A (parts, cents, needs Ahmed's OK): 4.7 kOhm in the P15 lead and 2.2 uF from the SW pad to VOUT, a ramp of about 0.81 V/ms whatever the MOSFET, under 17 A for up to 20 mF. |
| B49 | Current drawn after the battery guard's poweroff with the panel switch still on | OPEN, bench check (TEST_PLAN 11, measure once) | Calc only (ELECTRICAL_TWIN.md): the guard powers off the Pi, but the 14 servos (6 or 21 mA idle in the two Feetech copies), the BEC, the 5 V regulator and the halted Pi (not published; 20 to 100 mA at 5 V, ASSUMPTION) stay on: 0.11 to 0.41 A, so 1.2 to 4.4 h from the standing hard stop (about 3.3 V per cell, 489 mAh left) to the P30B 2.5 V minimum; the BMS cuts only at 2.40 V. Meanwhile the TEST_PLAN 11 rule: switch off at the panel switch at once after a hard stop. 2026-11-04 track 1b: no $0 fix exists. Pololu's 2815 page: the ON pin can only turn it on, and only with the slide off; the panel switch grounding SW holds it on, and nothing latches, so a Pi GPIO cannot switch it off (and a GPIO-held off would end when the Pi's own 5 V dies). Fix with a part (needs Ahmed's OK): Pololu 2813 Big Pushbutton Power Switch HP, $8.95 (https://www.pololu.com/product/2813), same size and MOSFET ratings, OFF input for self-shutoff, under 0.2 uA off, with a momentary pushbutton for the body_back cutout (track 2 fit) and GPIO26 on OFF through dtoverlay=gpio-poweroff (active high: no pulse at boot, reboot or walk). Off drain under 10.2 uA with the BMS (10 uA max): more than 5 years to 2.5 V instead of 1.2 to 4.4 hours (calc only). 2026-11-04 V1 track 2 (D30, Ahmed's OK relayed by the lead at 5:58 PM ET): FIXED in the twin, calc only: the Pololu 2813 with the button on A and B and GPIO26 on OFF (gpio-poweroff, active high) switches the duck off after the guard's poweroff; off drain under 10.2 uA (2813 under 0.2 uA, BMS 10 uA), more than 5 years to 2.5 V; same 6 A, 16 A and 90 A ratings as the 2815 against the 15.89 A worst window. Bench check TEST_PLAN 11 stays. |
| B50 | Servo gains in the twin and the gym: the stock runtime writes firmware P 30 to the legs and P 8 to the head (Open_Duck_Mini_Runtime scripts/v2_rl_walk_mujoco.py lines 175 to 179), the trained kp is P 32 (BAM STS3215Actuator) | OPEN, bench check (TEST_PLAN 9 walking log; track 3, real code in the loop) | 2026-11-04 track 1b (sim pass only): every twin and gym result before today used P 32 on all 14 servos. With the real gains the 20 s gym walk covers 1.35 m instead of 1.78 m, the 60 N left shove holds 12.5 A of servo bus instead of 17.2 A, and the head roll data ground at the 40 mOhm hop limit is 0.075 V instead of 0.527 V in the same shoves, 0.125 V with the policy left on the floor (ELECTRICAL_TWIN.md, Track 1b fixes). fix_runs.py rtg in the shared lab gym (overlay gym/overlays/duck) sets them. |
| B51 | Restart after a power loss (a BMS trip, a pulled XT30): the root file system takes a hard power loss, and with "start_paused": false (software/duck_config.altaay.json) odm-walk-guard.service starts the policy 10 s after boot wherever the duck lies | OPEN, bench check (TEST_PLAN 8 and 11) | 2026-11-04 track 1b (calc only): the policy flailing on the floor is the worst current case of the twin. $0 fixes for the lead (software/): "start_paused": true (the runtime then waits for the A button, v2_rl_walk_mujoco.py line 95 and lines 243 to 251), the read-only root (raspi-config nonint do_overlayfs 0; RPi-Distro/raspi-config bookworm aabbd96 lines 3464 to 3495) and the walking logs on a separate ext4 partition flushed each second. The Tenergy board releases an over-current trip on "Cut load": cycle the panel switch, no charger. |
| B52 | BNO055 clock stretching on the Pi's hardware I2C (the upstream IMU opens the hardware bus, raw_imu.py line 21) | OPEN, bench check (TEST_PLAN 10.1) | 2026-11-04 track 1b: the BCM2835 I2C master "does not support clock stretching at arbitrary points" (elinux.org BCM2835 datasheet errata, p35); a third-party build traced about 25 % bad reads and backward falls to it, 0 % on software I2C (UPSTREAM_ISSUES.md G2). $0 fix: software I2C by default (PI_SETUP.md 4b lines, now only if glitches show), checked on both buses and with bench/timing_budget.py. |
| B53 | No screwdriver in the BOM for the 95 cross-head screws (M2 pan heads, Feetech horn and idle screws, SG90 screws) | OPEN, needs Ahmed's OK | V1 track 2 (twin/assembly/ASSEMBLY_TWIN.md item 2): Wera 2050 PH 0 x 60 ($7.91), PH 1 x 80 ($9.76), 851/1 Z PH 0 x 25 bit ($1.95), links in BOM.md "Needs Ahmed's OK". CAD check of the tool paths with their blades. |
| B54 | 10 screws could not be driven in any order with the BOM tools | FIXED in the twin (CAD check) | V1 track 2: BUILD_ORDER.md (0 violations): trunk core order; the 25 mm bit for F126, F128, F130, F132, F348, F350; the 2.5 mm key short arm for F158 to F161; neck pitch -9.4 deg for F083, F084. Check: dry fit in that order (TEST_PLAN 13). |
| B55 | Side projector lamp (flash_light_module, reflector interface, E5) has no mount in the CAD | FIX designed (calc only), test-fit check | VHB 4950 on the 1018 mm2 contact face: 23.6 kPa at the 196 g mid fall, SF 3.5 on 3M's 82.7 kPa design value (MOUNTING.md V1 track 2). |
| B56 | BEC Pro on tape tips about its edge in a mid fall: 75.1 kPa, SF 1.1 | FIX designed (calc only), test-fit check | One BOM 32 tie over the top through two BOM 34 mounts (spares): tape 19.6 kPa (SF 4.2), tie 14.3 N of 80 N. Check the two mount spots at TEST_PLAN 1.4. |
| B57 | Battery service: the lid faces into the trunk, its screws are not reachable in the built duck | FIXED as a procedure (CAD check), RISK left | Body_back off (8 x M3x8, all clear), pulled 20 mm back on its wires (P10 slack 85.2 mm), then the lid screws with the 2.0 mm key short arm (260 to 310 deg free). The module stays on its wires. |
| B58 | microSD and Pi USB service need head_bot_sheet off (8 x M3x8) | RISK left | Card slides 25.9 mm free, 7 % of directions open with the sheet down. Option: microSD extender (needs Ahmed's OK; board size not published, BLOCKER for its fit). |
| B59 | Mass model counts 274 screws and 1 g of ties | BLOCKER (weigh) | Recount: 286 driven screws 174.3 g (model 175.3 g); ties up to +31.5 g; 55 tie mounts unpublished. Total 2654.7 to 2686.2 g plus the mounts (sim/MASS_BUDGET.md V1 track 2). Weigh 10 trimmed ties and 10 mounts of each type. |
| B60 | Camera screws: M2x4 engages 3.0 mm in the 3.2 mm pilots, under the 4.0 mm rule | DECIDED (D34 lead note), checked on TO8 | M2x5 from BOM 17h with the 4 pilots drilled to 4.5 mm (print/PRINT_PLAN.md After printing step 6): 4.0 mm engaged at a 1.0 mm PCB, 0.5 mm to the bottom, 1.7 mm of material left (twin/complete3d/camera_seat.json, CAD check only). PCB thickness on TO8 (B9). Needs a 1/16 in (1.59 mm) HSS drill bit, not in the tool lines: Hyper Tough 3-piece $1.98 at Walmart (https://www.walmart.com/ip/Hyper-Tough-3-Piece-1-16-inch-Hss-Roll-Forged-Drill-Bits-Hss-Material-AU00040K/516905753) or EazyPower $1.95 each at Zoro (https://www.zoro.com/eazypower-drill-bit-hss-116-in-79763/i/G7628266/), both read via search index 2026-11-04; needs Ahmed's OK. |
| B61 | Camera ribbon D12 as a flat strip needs 227.3 mm; the 150 and 200 mm cables are short | DECIDED (D34), checked on TO9 | 300 mm Raspberry Pi Standard-Mini cable (BOM E7, $2.94); 72.7 mm spare in one gentle loop of radius 6 mm, 1.74 mm clear (twin/complete3d/d12_ribbon.json, CAD check only). FPC width, thickness and bend rule BLOCKER until the caliper check on TO9. Clearance (cables3d/check_cables.py full run, 2026-11-05): the 227.3 mm strip route rubs neck_yaw_assembly by 0.6 mm at head roll 0.35 rad (checked as a 1 mm tube; the 16 mm strip is wider), and a strip search with the neck parts swept over the head ranges found no route without a twist (twin/complete3d/d12_ribbon_swept.json): D12 needs one twist or another path, decided at TO9. |
| B62 | OFF wire (Pi GPIO26 to the 2813 OFF input, D30) had no cable entry | OPEN (assembly and bench check, TEST_PLAN 13) | Cable D13 in the netlist, CABLE_MAP.md and cables3d.json on the P13 route: worst 542 mm, cut 590 mm, check pass with notes (calc only). The 2813 OFF pad position is a BLOCKER (Pololu 2813 drawing not read in this session). Clearance: D13 rubs head_pitch_to_yaw by 1.2 mm at head yaw 0.93 rad, inherited from the committed P13 neck route it follows (P13 rubs 2.3 mm there); a local push of the points does not clear it (twin/complete3d/fix_rubs.py): the neck passage of P13 and D13 needs a re-route with the rub as a constraint. |
| B63 | roll_to_pitch mount text said 4 x M2x6 | CLEARED (CAD check: 2 holes per part) | The CAD has 2 pilots per roll_to_pitch (fasteners.json F029 to F032 into the servo bottom case, no empty hole there); the viewer mount text now says 2. |
| B64 | 3D twin gaps: camera off its seat, D12 drawn as a tube, D10 fan-out and SP lead-ins missing, the board.stl copy drawn in the head (B7), no x-ray or labels | CLEARED (twin, CAD check) | Fixed in phase 2 of the V1 3D track (twin/complete3d/COMPLETE3D.md section 9); viewer files regenerated. |
| B65 | Screw count (Ahmed: about 90 % fewer, 2026-11-04 6:36 PM ET) | DECIDED (D38) | 342 to 317 fitted screws, 58 to 48 inserts, 16 to 8 washers (twin/screws/SCREWS_TWIN.md, calc only): covers and boards keep 2 diagonal screws (Pi, servo adapter, camera, speaker stand and interface, eyes), plates 3 (lid, head_bot_sheet), body_front 4 with the tongue and groove, body_back 7 (D38). The servo chain, frame and leg stack keep every screw: 34 of their 39 groups are under the lab margin today (STRUCTURE_TWIN.md table 5). Every unused hole stays. |
| B66 | Shell shear features for the cut shell screws | DECIDED (D38), TEST PRINT, coupons K1 and K2 | print/body_front.stl (3.5 mm groove), print/body_middle_top.stl (3.0 mm tongue), print/body_middle_bottom.stl (back side lips and 6 ribs): CAD fit 0.25 to 0.41 mm, walls 2.5 mm or more, +812 mm2 supported overhang on body_middle_bottom; capacity front side 1732 N, vertical 3564 N, back side 2925 N, up 2261 N (calc only). Re-slice the 3 parts. |
| B67 | Printed cable clip and tie bridge (fast cable work) | DECIDED (D36), TEST PRINT, coupons K3 and K4 | K3 snap strain 0.375 % against 0.535 % allowed (calc only); K4 slot 3.0 x 1.6 mm for the 2.5 mm tie. The 55 stick-on mounts become tie bridges only after the coupons pass and the 3D job places them (X2). |
| B68 | Control button 10b (NKK MB2011SS1W01) out of stock | DECIDED (D38) | NKK MB2011LS1W01-BB, same MB2000 bushing and 13 mm body as the D30 plate inputs, solder lugs, snap-on cap BB; Newark 941 in stock, $10.37 (search index). Plate unchanged (CAD check: same bushing and body). The cap height is not published in what was read: check it clears the body_back opening at the first fit (TEST_PLAN 14.7). |
| B69 | Pi header plugs, P13 service plug, battery bay lever splices | DECIDED (D36) | X1: KK 254 terminals (BOM 22b, $0.085 each) in 1-row housings (22c, price BLOCKER) on the 27 Pi header ends; X3a: XT30U pair in P13 at the neck base (15 A continuous against 2.21 A peak); X4: WAGO 221-415 at G and 221-413 at VSW (20 A). No route or cut length moves. Tug test after the walk (TEST_PLAN 14.4). |
| B70 | Stock policy on STS3250 knees (D32) | OPEN: bench BAM test of one STS3250 (TEST_PLAN 15), then the run2_sts3250 retrain | twin/knee/KNEE_TWIN.md sections 1, 3, 4 (sim pass only): with the knee damping the published torque-speed line implies (1.00 Nm s/rad against the C001's 0.56) the stock policy walks 0.023 to 0.038 m/s against 0.063 to 0.096 and falls in 4 of 5 backlash sessions, no protection active; with 0.56 it walks 0.086 m/s, no fall. Heat is fixed: no knee cut, 47 to 63 C. |
| B71 | roll_to_pitch with STS3250 knee loads | DECIDED (D38: D26 option P1, 3 walls) | twin/knee/KNEE_TWIN.md section 5 (FEA pass only, calc only): 1.48 to 1.45 walking, 1.08 to 1.04 in push; with 3 walls 1.81 / 1.20, above today's values, still under the lab margin 2 (D26 stays open for the margin). parts.csv and print/PRINT_PLAN.md updated, +3.6 g and +0.22 h per part. |
| B72 | Track 1b target guard with STS3250 knees | OPEN: track 3 runs it in the real code | twin/knee/knee_budget.py: the same guard with the knees' torque limit and current law; bus_budget.py would over-predict a held knee 2.3 to 3.5 x and cut its torque in pushes. With knee_budget.py: 0 of 252 replays over 17 A for 4 ms (sim pass only). |
| B73 | Register 21 (position P) for the two knees only | OPEN: the bench BAM fit (TEST_PLAN 15), then track 3 | P 11 (published Kt and R) to 19 (stall line) gives the C001's stiffness at P 30; the runtime writes one P to all 10 leg servos, so IDs 13 and 23 need their own write and a read-back (twin/knee/KNEE_TWIN.md section 6). |

## 7. Needs test order
Parts that only a real part can settle. Full list with prices and links in BOM.md, section "Needs test order". All 17 lines are BOM lines (buy them first; TO16 brings the coupon C4 recess test parts, D20; TO17 the BelMetric order with the T1 eye washers, D21 note), so the build total does not change, except the servo price break (1 at $20.00 now, 13 at $19.00 later is $267.00 vs $266.00).
