aaltaay/Open_Duck_Mini_v2/altaay_lab/audit/ERC_REPORT.md

# ERC report (generated by audit/erc.py from wiring/netlist.yaml)

Components 89, pins 349, cables 70 (4 removed), wires 203 (1 superseded, not joined).
Findings: 0 ERROR, 0 WARN, 8 INFO.

Ampacity limits: chassis wiring, PowerStream wire gauge table (powerstream.com/Wire_Size.htm). Kit servo cables assumed 26 AWG (gauge not published).

## references (0)
No findings.

## schema (0)
No findings.

## pin use (0)
No findings.

## shorts (0)
No findings.

## domains (0)
No findings.

## ampacity (8)
- INFO: cable D1: gauge 'USB 2.0 cable' not parsed (PI.USB -> U2.USB)
- INFO: cable D8: gauge 'SG90 lead' not parsed (SGL.SIG -> PI.33)
- INFO: cable D8: gauge 'SG90 lead' not parsed (SGL.VCC -> J5.S)
- INFO: cable D8: gauge 'SG90 lead' not parsed (SGL.GND -> JG.S)
- INFO: cable D9: gauge 'SG90 lead' not parsed (SGR.SIG -> PI.32)
- INFO: cable D9: gauge 'SG90 lead' not parsed (SGR.VCC -> J5.S)
- INFO: cable D9: gauge 'SG90 lead' not parsed (SGR.GND -> JG.S)
- INFO: cable D12: gauge 'FPC ribbon' not parsed (PI.CSI -> CAM.CSI)

## crimps (0)
No findings.

## connector match (0)
No findings.

## Largest voltage drops at the worst 100 ms current

| mV | cable | from | to | AWG | cut mm | A |
|---|---|---|---|---|---|---|
| 50.3 | SP5 | SPG.S | SV14.BUS1.G | 22 | 450 | 2.11 |
| 50.3 | SP5 | EFR.OUT | SV14.BUS1.V | 22 | 450 | 2.11 |
| 44.0 | SP4 | SPG.S | SV24.BUS1.G | 22 | 420 | 1.98 |
| 44.0 | SP4 | EFL.OUT | SV24.BUS1.V | 22 | 420 | 1.98 |
| 35.0 | P13 | VSW.S | U3.VIN | 20 | 550 | 1.91 |
| 35.0 | P13 | G.S | U3.GND.1 | 20 | 550 | 1.91 |
| 20.3 | DC2 | JGD.S | BMS.P- | 20 | 210 | 2.9 |
| 17.6 | SP2 | EFR.OUT | SV10.BUS2.V | 22 | 150 | 2.21 |
| 14.5 | SP3 | EFN.OUT | SV30.BUS2.V | 22 | 180 | 1.52 |
| 13.9 | SP1 | EFL.OUT | SV20.BUS2.V | 22 | 160 | 1.64 |
| 13.9 | P8 | BMS.P- | XT30.F- | 16 | 150 | 7.04 |
| 13.9 | P6 | BMS.P+ | XT30.F+ | 16 | 150 | 7.04 |
| 13.0 | P14 | XT30.M- | G.S | 16 | 140 | 7.04 |
| 12.9 | SP2 | SPG.S | JG10.S | 22 | 130 | 1.88 |
| 12.3 | P10 | VSW.S | U1.IN+ | 16 | 150 | 6.23 |

Continuity checklist for TEST_PLAN.md section 2: audit/continuity_checklist.csv (203 rows).
