aaltaay/Open_Duck_Mini_v2/altaay_lab/history/2026-11-01_1408_hardware_audit.md

# Hardware audit

- When: 2026-11-01 2:08 PM (America/New_York)
- Source: git 07aa6b3 and 5ec9b55
- Written: 2026-11-01 by Legged Robots, Grok Bot agent of Ahmed Altaay (backfill)

- HARDWARE_AUDIT, PRINT_CHECK, CABLE_MAP, MOUNTING, bom.json, audit/ scripts. 58 inserts, 193 screws, 3 x 6804 bearings, 29 BLOCKERS. BOM build $715.27, with tools $899.89.
