aaltaay/Open_Duck_Mini_v2/altaay_lab/twin/out/REPORT.md

# One duck, one run

Command: `make twin`

Same command, short: `python3 -m altaay_lab.twin.run_twin --short`

This is a simulation. Nothing here was measured on a servo, a cell, or a board.

Policy file that ran: `sts12_runD_policy.onnx` (altaay_lab/problems/retrain_sts12/sts12_runD_policy.onnx). Sha256 7a0be46af5b8061ee7b85aaca4050772da4fbd29303fffad76a93d59225dfb1e. The policy loader was called 4 times and every call loaded this file.
The earlier merged report, 30.07 walking minutes and 17.48 A pack peak, was the stock BEST_WALK_ONNX_2 policy and is superseded.

It walked until the pack cutoff at 2488.80 s (sim pass only).
The clock on this run is 41.48 minutes (sim pass only). It stops at the 10 V pack cutoff or at 45 minutes, whichever comes first.
It covered 379.05 m along the path, and ended 0.39 m from the start (sim pass only).
The command is a room circuit: 6 s forward at 0.20 m/s, then a 2.2 s turn, four times around. An earlier run with the forward command held fixed logged 17.29 m of path and only 1.34 m from the start in 2 minutes, because the heading drifts and the path folds into a curve. That was not a room.
Mean speed along the path was 0.152 m/s (sim pass only, path divided by time).
Battery at the end was 24.2 percent of the 4.50 Ah nameplate, 3413 mAh used (sim pass only for the coulomb count, cited for the nameplate).
The pack hit the 10.0 V walk cutoff at 2488.8 s (sim pass only for the clock, cited for the cutoff).
Pack voltage in the logged stats was 11.28 V mean and 9.90 V minimum (sim pass only).
Pack peak 13.81 A is this 0.20 m/s room loop on the held 12.0 V rail, counting steps whose pack voltage stayed between 8 V and 13.2 V (sim pass only). The 15.837 A in eval_table_bec12.md is a different case: the 0.40 m/s piece of a speed sequence, and that table still drops the regulator by 0.3 V instead of holding 12.0 V. The same table's 0.15 m/s typical peak is 8.956 A. Both peaks are sim pass only. Neither was measured on a pack. No solver step left the 8 V to 13.2 V window.
The 15 A ATOF holds at 110 percent (16.5 A) for at least 360000 s, and it is required to open only from 135 percent (20.25 A), in 0.75 s to 600 s (cited, problems/KNEE_HEAT_CHAFE.md, the Littelfuse 0287 sheet). Time at or above 15 A was 0.000 s, longest run 0.000 s. Time at or above 16.5 A was 0.000 s, longest run 0.000 s. Time at or above 20.25 A was 0.000 s (sim pass only). The fuse does not open on this walk. The rating stays 15 A.
Hottest reading was the left hip yaw at 47.1 C (sim pass only). The limit on that reading is the 60 C operating line on the servo page used by the thermal model, and the 55.0 C rest in the limits file.
The 55 C rest is inside the walk. At 55 C the command goes to zero and the policy stands. Folding to the sit from a walk tips this model, so the session does not fold. It rested 0 times. Upright walking is the figure in the table (sim pass only).
The rest check reached a right knee of 147 deg, then torque off. Stance current was 0.58 A. The crouch, measured after the knee had settled at 21 deg, was 0.26 A. Torque off was 0.000 A (sim pass only). From a 55 C start, torque off reached 45 C in 3.51 min. The powered stand reached 45 C in 4.80 min. Both clocks are sim pass only, on the cited 1.0 ohm.
Knee high stop used here is 147 deg, the register soft stop. The CAD bumper is 150 deg (software/servo_limits.json, CAD check only). The walk model was compiled at 90 deg, and this run raises that stop before the sit.
The 50 C figure in the heat audit is the case temperature for a flat 1.5 A if the copper stayed at its cold resistance and the sensor sat on the case. While this session was walking the right knee was 0.88 A RMS (sim pass only), which is 0.78 W in cold copper at 1.0 ohm (calc only). The knee reading peaked at 38.4 C, under the 55.0 C rest, so the guard did not stand the duck. The knee rested 0 times.
Dock: BLOCKER. The nest sim does not use a camera. It drives on the true pose plus noise. A seat in that sim is not a dock. The mechanical sim used the run D policy (sts12_runD_policy.onnx) and a 12 V rail. It did not sit (sim pass only). The aim offset table has no 12 V row, so that offset stayed at the 7.2 V measurement. Finding the nest by camera was not simulated.
The cell node is three P45B cans, 70 g and 21.55 mm by 70.15 mm (cited, THERMAL_TWIN.md from the P45B sheet). Half of each can faces bay air. The trunk has no vent in this model, so the air exchange is the closed-bay assumption. Specific heat is the old 18650 range, a guess. An earlier 56.7 C figure used two 47 g 18650s for the same three-cell heat, which runs hot.
Charge: the NTC gate is open at a cell temperature of 44.5 C. The hot stop is 57.0 C, where the divider fraction equals the cited 0.442 hot threshold (calc only, bead beta 3950 and the BQ24133 divider). The P45B charge limit is 60 C (cited). The gate does not hold off charge at the end of this discharge. Time to put the used 3413 mAh back at 1.006 A is 3.39 hours (calc only).
Limits this run touched: pack fell to 9.90 V, under the 10.0 V walk cutoff.

## Numbers

| What | Value | Label |
|---|---|---|
| policy file | sts12_runD_policy.onnx | asserted |
| policy sha256 | 7a0be46af5b8061ee7b85aaca4050772da4fbd29303fffad76a93d59225dfb1e | the file |
| policy loads | 4 | asserted |
| earlier merged walking minutes | 30.07 min | stock policy, superseded, sim pass only |
| earlier merged pack peak | 17.48 A | stock policy, superseded, sim pass only |
| walked | yes | sim pass only |
| duration | 41.48 min | sim pass only |
| path | 379.05 m | sim pass only |
| net travel | 0.39 m | sim pass only |
| rests | 0 | sim pass only |
| body speed | 0.130 m/s | sim pass only |
| duck mass | 2.949 kg | CAD mass model |
| battery left | 24.2 percent | sim pass only |
| nameplate | 4.50 Ah | cited |
| pack mean | 11.28 V | sim pass only |
| pack minimum | 9.90 V | sim pass only |
| pack mean current | 4.94 A | sim pass only |
| pack peak current | 13.81 A | sim pass only |
| servo rail set point | 12.0 V | cited |
| regulator efficiency used | 0.94 | cited |
| walk cutoff | 10.0 V | cited |
| hottest part | left hip yaw | sim pass only |
| hottest reading | 47.1 C | sim pass only |
| rest stop | 55 C | limits file |
| rest resume | 45 C | limits file |
| cell temperature | 44.5 C | sim pass only |
| dock | BLOCKER | BLOCKER |
| charge current | 1.006 A | cited |
| time to replace what was used | 3.39 h | calc only |
| NTC allows charge | yes | calc only |
| fuse | 15 A | cited |
| thermal step | 0.1 s | sim pass only |
| scenario length asked | 45.00 min | the command |
| walking minutes | 41.48 min | sim pass only |
| terminal resistance | 1.0 ohm | cited |
| knee high stop | 147 deg | CAD check only |
| sit knee reached | 147 deg | sim pass only |
| torque-off cool from 55 C | reached 45 C in 3.51 min | sim pass only |
| powered-stand cool from 55 C | reached 45 C in 4.80 min | sim pass only |

## What this twin does not model

- A camera finding the nest. That is BLOCKER. The nest program uses the true pose plus noise.
- A pack-voltage sensor on the Pi. The 10 V stop is in the guard, and this sim passes the modeled pack voltage in. The Pi still has no sensor (BLOCKER).
- A bench measurement of the C018 terminal resistance. The heat uses the 1.0 ohm printed in specification A/0 item 5-10. The stall line 12 V / 2.7 A is 4.444 ohm on the same sheet, and the old 3.753 ohm figure was that stall line times the C001 winding share. The audit is altaay_lab/twin/thermal/HEAT_AUDIT.md.
- The i7C current below 10 V, the TRIM resistor, and the wide boost tolerance above 100 W (BLOCKER).
- Felt, dirt, and a measured well contact.
- The turn-offset table at 12 V. The dock uses the 7.2 V aim offset with a 12 V rail.
- Hardware. Every temperature, speed, and current above that says sim pass only is a model output.

The duck mass is the whole robot. The trunk body alone is 1.207 kg. The stock Open Duck Mini model is 2.107 kg. MuJoCo loads 2.949 kg, and the parts rollup is 2.949 kg. The rollup includes three P45B cells at the cited 70 g, the i7C at the cited 75 g, the 3S protection board, the BQ24133 board, and three limb breakers. The protection-board grams are the cited size times 1.2 g/cm3 (calc only). The BQ24133 assembled grams and the breaker package grams are not on a datasheet.

## What was compared

Each row replays this run's walking current for 45 min. The rest is the measured stance current, the measured crouch current, or torque off. Sim pass only. Mass is the change from the C018 knees. No new part is on the bill.

| Option | Walking minutes | Knee peak C | Added mass g | Kind |
|---|---|---|---|---|
| cited 1.0 ohm, powered stand | 45.0 | 38.4 | 0 | this run |
| cited 1.0 ohm, torque-off sit | 45.0 | 38.4 | 0 | sit check |
| old stall-line 4.444 ohm, torque-off sit | 14.5 | 48.2 | 0 | comparison |
| old stall-line 4.444 ohm, powered stand | 3.3 | 52.9 | 0 | the 3 percent run |
| knee current times 0.70 | 45.0 | 33.5 | 0 | retrain |
| 20 deg knee crouch, torque on | 45.0 | 38.4 | 0 | stance |
| knee area times 1.3 | 45.0 | 35.6 | 0 | heatsink |
| knee area times 1.8 | 45.0 | 32.9 | 0 | heatsink |
| STS3250 knees, cited 1.2 ohm | 45.0 | 40.4 | 39 | servo swap |
| gear ratio times 1.5 | 45.0 | 33.0 | 0 | not a catalog part |

Chosen: the cited 1.0 ohm terminal resistance, and a stand with the command at zero when the reading reaches 55 C. This session's upright walking is 41.5 min with the knee at 38.4 C, and it adds no mass. The 45 min replay of the walking current, resting at the measured stance current, walks 45.0 min with the knee at 38.4 C. A separate check folds to 147 deg from a settled stand and turns the gains off. Folding from a walk tips this model, so that fold is not the session rest. Fold-to-sit from a walk and sit-to-stand are not trained yet. The heatsink rows assume extra case area. The servo swap and the gear row are studies. This walk is run D, recorded as D66.
