aaltaay/Open_Duck_Mini_v2/altaay_lab/DECISIONS.md

# DECISIONS (open questions for Ahmed)

Status 2026-11-02: D1 to D25 are all decided. D1 through D7 below are the questions as first asked; the answers are under Decided and Delegated decisions. What still needs Ahmed is in STATE.md.

Status 2026-11-03 about 5:00 PM ET (structure twin integration): D26 below, after D7, is a new open question for Ahmed. It is not decided.

D1. Servo variant. Deep dive done (SERVO_DEEP_DIVE.md). Evidence says apirrone uses the STS3215 7.4 V 1:345 "19 kg.cm" (C001), confidence about 85%. His own BAM identification implies about 5.43 rad/s no load, which matches the C001 datasheet (52 RPM = 5.45 rad/s at 7.4 V), and the sim and policy were trained on that model. The earlier "about 2.7 rad/s" note was wrong; it came from issue #48, not from a datasheet. Issue #48 tracking looks like a servo setup, firmware or supply problem, not a gear ratio problem. Options: (a) buy C001 as written and bench test 1 or 2 first (recommended), (b) C046 or C044 for legs (not recommended: mismatches the trained policy), (c) also ask upstream the draft question in SERVO_DEEP_DIVE.md section 7. Update 2026-11-01: (c) is done. The question was posted on issue #48 by aaltaay on 2026-11-01 1:08 PM ET: https://github.com/apirrone/Open_Duck_Mini/issues/48#issuecomment-6561836208 . No reply recorded yet. C001 deep-dive conclusion (SERVO_DEEP_DIVE.md section 1): upstream uses the C001 (7.4 V, 1:345, 19 kg.cm), about 85% confidence; the BAM model's implied no-load speed of 5.43 rad/s matches the C001 datasheet 5.45 rad/s at 7.4 V; issue #48 is most likely a servo setup, firmware or supply problem, not a wrong variant. Still open for Ahmed: pick (a) or (b).

D2. Accept Feetech under the lab rule? Spec gives rated torque but no thermal duty curve. Warranty is 12 months, 6 months for motor, gears and housing, with round-trip freight paid by us and over-voltage excluded. A sim model exists (MJCF plus BAM). Accept, or require a duty test in the lab first?

D3. Supply voltage. DECIDED 2026-11-01 1:09 PM ET: add a regulator (see Decided). Implemented as a lab change: Castle CC BEC Pro set to 7.2 V, 15 A ATO fuse (POWER.md, WIRING.md, BOM.md lab change lines).

D4. Generic Chinese power parts (BMS, UBEC, charger, holder) have no spec or warranty. Swap the UBEC for Pololu D36V28F5 (US, spec'd)? Swapping changes the as-is build.

D5. Lab-rule features not in the design (docking, get-up, stairs). Build v2 strictly as-is first and add these as a separate lab fork later, or add them before the first build?

D6. Runtime and Playground have no license. Ask upstream to add one before we modify or redistribute code from them? (No message sent; needs Ahmed approval.)

D7. Pi Zero 2 W is out of stock at US resellers (2026-11-01). Wait, pay eBay prices (about $82+), or test a different board (not as-is)?

D26. Weak printed parts from the structure twin (open, 2026-11-03; for Ahmed, not decided). twin/structure/STRUCTURE_TWIN.md (FEA pass only, on sim pass only loads): walking on a flat floor, roll_to_pitch (HARDWARE_AUDIT B42, SF 1.48 to 1.63) and the knee sheet eye (B43, SF 1.63) are under the lab margin of 2; no print setting tested reaches 2. Options, before the right leg prints, for one or both parts: (a) keep the D22 profile and rely on the proof loads (print/PRINT_PLAN.md step 2 check 7) and the inspection schedule (TEST_PLAN 9); (b) P1, roll_to_pitch back to 3 walls, its profile before D22 (+7.2 g and +0.44 h for both legs; SF 1.84 / 1.25 at mesh level 1, against 1.60 / 1.11 there); (c) P2, a CAD change of the knee sheet eye (not modelled; it needs its own FEA); (d) P3, 5 walls 40 % on the knee sheets (+9.4 g and +1.1 h for all 8; 1.82 / 1.20 at mesh level 1, against 1.56 / 1.04 there); (e) P5, PETG for the knee sheets and roll_to_pitch, only if the thermal guard cannot keep them under about 50 C. Numbers: twin/structure/STRUCTURE_TWIN.md section 6. Still open for Ahmed: which, if any?

## Decided
- 2026-11-01 12:51 PM ET (Ahmed): The Open Duck Mini v2 is EXEMPT from the lab 15-step stair rule (see GAPS.md B7). Self-docking and get-up after falls are not exempted.
- 2026-11-01 12:53 PM ET (Ahmed, answers D5): Build v2 stock first, exactly as designed. Add self-docking and get-up after falls later as a separate lab step.
- 2026-11-01 1:09 PM ET (Ahmed, answers D3): Add a regulator so the servos never see more than 7.4 V. Lab pick: Castle Creations CC BEC Pro 010-0004-01 set to 7.2 V, programmed with Castle Link V4 011-0173-00, plus a Littelfuse 15 A ATO fuse after BMS P+ (POWER.md). Nothing bought.

## Delegated decisions (2026-11-01 and 2026-11-02, made by the Claude Code agent under Ahmed's delegation)

Ahmed's words (2026-11-01, about 5:40 PM ET, Claude Code session): objective "allow this project to reach the 3D printing phase", and "The majority of the decisions you're going to have to make, over the majority of it, maybe almost 100%. If something fails, you don't ask me. You just improvise on that solution in a way where it continues and helps you to reach the final destination."
Scope: Open Duck Mini v2 only (lab rule 18). Not lab-wide. Still NOT delegated: buying anything, sending any message or post, deleting anything, starting a print (lab rules 4 and 7). Writer: Claude Code agent, on branch claude/print-ready, through a pull request into altaay-lab (one writer per file, the owner bot is Legged Robots).

- D1 Servo variant. DECIDED about 6:20 PM ET: STS3215 C001 (7.4 V, 1:345, 19 kg.cm), as recommended in SERVO_DEEP_DIVE.md. Buy 1 first (test order TO1) and run the bench test in SERVO_DEEP_DIVE.md section 6 before the other 13. Issue #48 stays on watch; it does not block printing. Supersedes: open question D1.
- D2 Feetech under the lab rule. DECIDED about 6:20 PM ET: accept for the stock build, conditional on the TO1 bench test adding a thermal run (updated 10:13 PM ET from sim/RUNTIME_THERMAL.md: hold the servo at Present Current 1.5 A, the knee's walking RMS, at 7.2 V for 30 minutes or until the temperature settles, log every 10 s, compute the thermal resistance and time constant; pass if the predicted knee temperature after 31 minutes of walking is at least 10 C below both the Max Temperature Limit register and the 70 C cut. The first version held 1.5 Nm for 10 minutes; 1.5 Nm is 1.2 A by the BAM model but 2.0 A by the datasheet torque constant, right at the servo's own 2 A / 2 s cut, so the hold is now set by current; TEST_PLAN.md 7.3). Reason: rated torque and a sim model exist, warranty is 12 months; the sim current budget (sim/CURRENT_BUDGET.md) shows 1.45 A RMS at the worst servo while walking, about half the 2.67 A stall current. Supersedes: open question D2.
- D2 note, 2026-11-03 about 4:00 PM ET (twin/thermal/THERMAL_TWIN.md sections 3 and 7, applied by the twin integration agent for the lead; sim pass only): the 1.5 A hold of TEST_PLAN 7.3 reaches the 70 C cut in about 4 minutes in the twin (1 to 5 over its corners, twin/thermal/to1_predict.json), so it cannot settle. TEST_PLAN 7.3 now holds 0.9 A to settle and 1.2 A to 60 C, and its pass rule is the re-run twin: every knee at least 10 C under the 70 C cut through a full charge of the session the lab runs first (proposed: stand and walk 50/50 at a 32 C room). D2 itself stands (accept for the stock build, conditional on the TO1 thermal run); this note records only the new hold and pass rule. Nothing is bought.
- D4 Generic power parts. DECIDED about 6:20 PM ET: replace the generic HENGE UBEC with an in-stock Pololu step-down regulator (US made, full spec; part in BOM line 9), moved to the head floor next to the Pi so the neck carries pack voltage at lower current instead of 5 V. The generic BMS is replaced too (D10). Charger and holder stay stock (no US equivalent that fits; holder drop is checked at 10 A on the bench, POWER.md). Supersedes: open question D4.
- D6 Licenses. DECIDED about 6:20 PM ET: no message to upstream (none is needed for a personal build). We use Runtime and Playground unmodified at pinned commits and do not republish their code. If the lab later needs to publish modified code, that needs Ahmed's OK and an upstream license first. Current license status: UPSTREAM_ISSUES.md and BOM.md notes. Supersedes: open question D6.
- D7 Pi Zero 2 W stock. DECIDED about 6:20 PM ET: buy the bare board (Adafruit 5291, PiShop, SparkFun) if any is in stock at order time. Fallback, in stock 2026-11-01: CanaKit Pi Zero 2 W Starter Kit with Pre-Soldered Header PI-Z2WH-STR32-C4-BLK ($89.95). The pre-soldered header fits: the Pi hangs from the upper inner wall of head.stl with its components facing down, and there is 44.3 mm free below the whole board (ray cast on the CAD), enough for the header plus 2.54 mm housings. Not print-blocking. Supersedes: open question D7.
- D8 Power path. DECIDED about 6:20 PM ET: pack -> Tenergy 32175 BMS -> XT30U -> 15 A ATO fuse -> Pololu 2815 Big MOSFET Slide Switch HP -> switched pack bus -> (a) Castle CC BEC Pro at 7.2 V -> adapter H1, (b) 20 AWG through the neck -> 5 V regulator in the head -> Pi pins 2 and 6. The stock panel switch in the body_back cutout stays, wired to the Pololu control pin, so it carries microamps only (clears B22 with no STL change). The 15 A fuse from D3 stays. Reason and numbers: sim/CURRENT_BUDGET.md (sim pass only): walking about 4.2 A mean at the pack, about 7.5 A worst 100 ms, falls up to about 17 A for 20 ms with every allowance stacked. Supersedes: POWER.md section 2 estimates.
- D9 GPIO mapping. DECIDED about 6:20 PM ET: wire to the Runtime code at 376de65, not the assembly_guide table: feet left GPIO22 (pin 15), right GPIO27 (pin 13); eyes left GPIO24 (pin 18), right GPIO23 (pin 16); projector GPIO25 (pin 22); antennas left GPIO13 (pin 33), right GPIO12 (pin 32). Reason: we run the Runtime unmodified; the code is what reads the pins. The Tnkr pin choices (feet 7/11, eyes 13/15) would need code changes and clash with the code's feet pins. Supersedes: the open pin note in CABLE_MAP.md D3.
- D10 BMS. DECIDED about 6:20 PM ET: Tenergy P/N 32175 2S protection board (10 A working, over-current detect 22 +/- 5 A, main loop resistance 25 mOhm max, 34 x 16 x 4.5 mm, US seller with a full spec table, in stock 2026-11-01, $22.99). Fits the measured BMS envelope 17.75 x 47.2 x 5.33 mm. Replaces the JZK 8 A board (no datasheet). Clears B12. Supersedes: JZK in BOM line 8.
- D11 Placement of parts not in the CAD. DECIDED about 6:20 PM ET: BEC Pro flat on the belly floor, fuse holder and Pololu 2815 on the inner face of the battery bay front wall (one each side), 5 V regulator on the head floor, all with double-sided foam tape. Found by a free-space search over the swept volume of every moving trunk joint, with keep-outs for cables and unmodelled board components (audit/free_space.py, audit/place_parts.py, audit/placements.json, MOUNTING.md). No new printed part and no STL edit. Clears B11.
- D12 Print path. DECIDED about 6:20 PM ET: print the coupon session first (real geometry cut from the upstream STLs, print/PRINT_PLAN.md), then one leg to test servo fits, then the rest. Still needs Ahmed's OK before the first print (lab rule 4).
- D13 LEDs. DECIDED 6:44 PM ET: eyes stay as upstream (GPIO24/GPIO23 through 100 ohm, about 3 mA, dim but inside GPIO limits); the projector LED (GPIO25) gets a 100 ohm resistor too (our BOM had none). Reason: upstream issue 34 and the issue 33 TODO say 1 W LEDs straight on GPIO overload the pins. Brighter LEDs with MOSFET drivers belong to a later expression step.
- D14 Neck chain on its own Y-lead from the adapter. DECIDED 6:44 PM ET, SUPERSEDED by D15 at 6:48 PM ET. Reason it was made: the ngspice power sim (sim/POWER_PATH_SIM.md) showed the 4 neck servos, hung off the left ankle, dipping to 2.0 to 4.3 V during knee peaks.
- D15 Servo power bypasses the adapter. DECIDED 6:48 PM ET: Castle CC BEC Pro -> 16 AWG -> V+ and GND splices in the belly -> three 22 AWG power leads, one per chain (SP1 left leg at ID 20, SP2 right leg at ID 10, SP3 neck at ID 30). The adapter carries only DATA and GND (H3 to ID 20 and, through a data-only Y, ID 30; H5 to ID 10); its H1 screw terminal is not connected. S1, S6 and S14 are replaced. Reasons: the Waveshare schematic marks "MAX:6A" at the servo header and the adapter is specced for 9 to 12.6 V input (parts check), while the sim BEC output peaks at 8.3 to 9.1 A; the adapter logic runs from USB VBUS (schematic). Power sim at a nominal pack: worst ankle 5.04 V (typical corner) vs 4.78 V with the Y-lead, head servos at 5.0 V or more in both corners. Supersedes: D14, the Tnkr neck wiring (B19), the screw-terminal feed in WIRING.md.
- D16 Battery cut-off and BEC low input. DECIDED 6:55 PM ET: the Tenergy board only cuts at 2.40 V per cell (below the P30B 2.5 V minimum) and Castle does not publish the CC BEC Pro minimum input. So: (a) software stop of walking at about 3.5 V per cell under load and hard stop at servo Present Voltage 6.0 V (about 3.3 V per cell); (b) the BEC is swept from 8.4 V down to 6.5 V on the bench before assembly (TEST_PLAN.md section 4); if it shuts off instead of passing the input through, use the Pololu D42V110F6 (6 V fixed) from POWER.md section 3.
- D16 note, 2026-11-01 10:50 PM ET (from the software agent's battery guard, software/SOFTWARE.md section 5 and bench/battery_guard.py): (a) cannot be applied literally, because while walking the 14-servo median Present Voltage reads 6.0 V at about 3.57 V per cell (sim pass only, bench/sim_profiles.py). So: the walk stop is the 5 s mean of the 14-servo median at or under 6.0 V while walking (near 3.57 V per cell, sim). The 6.0 V hard stop applies standing (3 s mean), and 5.4 V while walking (2 s mean) also hard-stops. D16(b)'s 6 V fixed regulator fallback (Pololu D42V110F6) would need a pack voltage sense first, because the guard reads servo voltage and every servo would then read about 6 V at any charge.
- D11 update 6:49 PM ET: placements re-run with the measured envelopes from the parts check (BEC Pro 47 x 33 x 26 mm to cover all three published sizes, fuse holder 52 x 22 x 18 mm with its cover) plus the D15 power splices and the USB cable slack coil. All still fit with no STL change (audit/placements.json).
- D17 Foot switch contacts. DECIDED 7:24 PM ET: the Runtime feeds feet_contacts into the policy observation (scripts/v2_rl_walk_mujoco.py lines 154 and 167), so contact reliability matters for walking. Omron SS datasheet (en-ss.pdf): SS-10 silver contacts need a minimum load of 5 VDC 160 mA; SS-01 gold alloy crossbar contacts need 5 VDC 1 mA (0.1 A rating, same housing). Decision: Omron SS-01 where in stock at order time (US stock is thin: Avnet showed 0, read via search index), SS-10 as the fallback, and in both cases one external 2.2 kOhm pull-up per foot from Pi pin 17 (3V3) to GPIO22 and GPIO27, about 1.5 mA per foot circuit when closed instead of about 60 uA. Parts: BOM lines 13 and 13b.
- D18 Hip roll screw against roll_to_pitch (upstream issue 17). DECIDED 7:32 PM ET: the CAD check (print/check_hip_roll_screw.py) shows the outer of the 2 servo-bag M2 screws that hold the hip roll servo in roll_motor_bottom sits 0.31 mm from the roll_to_pitch arm; an M2 pan head (4.0 x 1.6 mm) overlaps the arm by 1.3 mm at every hip roll angle from -25 to +25 degrees, on both legs. Decision: leave that outer screw out on both legs (no STL edit, stock first). On the first leg (print/PRINT_PLAN.md left-leg check) confirm the servo is held rigidly by the inner screw plus the roll_motor_top clamp; if it moves under a hand load, make a relief cut in roll_to_pitch (CAD change) before the right leg is printed.
- D19 Hip pitch idle horn screws against roll_to_pitch. DECIDED 10:50 PM ET: the fastener sweep (fasteners/FASTENERS.md section 3 findings 2, 5 and 6 and the section 5 table, fasteners/sweep_fasteners.py, method as print/check_hip_roll_screw.py) shows that at the 8 sites where a thigh plate screws to the idle horn of the hip pitch servo (F196, F198, F200, F247 left; F209, F211, F213, F254 right) the head sits in a 6.5 mm recess only 0.8 mm deep, with the roll_to_pitch wall 1.83 mm above the recess floor. A DIN 912 M3 head (3.0 mm tall) overlaps roll_to_pitch by 1.19 mm at every hip pitch angle, on both legs. At F002 and F010 (thigh plate to leg_spacer) a DIN 912 head is hit by 0.19 mm from hip pitch +18.9 deg (left) and -18.9 deg (right) on. Decision: M3x6 ISO 7380 A2 button head screws (head 5.7 x 1.65 mm max, ISO 7380-1 via https://westfieldfasteners.co.uk/Standards/ScrewBolt-SHBtn-M.html) at these 10 sites, stock parts unchanged (BOM line 17j). The CAD sweep gives a worst clearance of +0.16 mm at the 8 idle horn sites (under the 0.3 mm lab margin) and +1.16 mm at F002 and F010. Check on the first leg, as for D18 (print/PRINT_PLAN.md left-leg check 5): turn the hip pitch through its range by hand; if a head rubs, make a relief cut in roll_to_pitch (CAD change) before the right leg is printed. Not fixed by the button head (FASTENERS.md findings 3 and 4): at F198 and F211 the head, button or DIN 912, meets body_middle_bottom once hip yaw passes 21.7 deg (left_hip_yaw +21.7, right_hip_yaw -21.7; URDF limit 30 deg), where the bare thigh passes close. That is a joint range point for the sim and controller owners, checked at the first powered joint sweep (TEST_PLAN 8.3).
- D20 Neck chain screw recesses. DECIDED 10:50 PM ET: 24 M3 heads sit in 5.5 mm recesses: head_pitch_to_yaw 16 (M3x5 to the drive and idle horns, recess 2.0 mm deep), head_yaw_to_roll 4 (M3x5 to the drive horn, 4.0 mm deep), head_roll_mount 4 (M3x6 into head inserts, 5.0 mm deep) (fasteners/FASTENERS.md section 3 finding 11; depths from fasteners.json). DIN 912 / ISO 4762 M3 heads measure 5.50 mm (smooth) to 5.68 mm (knurled) (https://westfieldfasteners.co.uk/Standards/ScrewBolt-SHCap-M.html) and FDM holes print undersize, so a head would sit on the face, 2.0 to 5.0 mm higher than designed, and lose most of its thread (an M3x5 engages only 2.4 mm of horn). Decision: drill those 24 recesses to 6.0 mm after printing (print/PRINT_PLAN.md "After printing"; BOM T11 and T13). Confirm on the coupon session with a recess fit test: coupon C4 (head_yaw_to_roll) already holds 4 of these 5.5 mm recesses and 4 of the 4.0 mm recesses, so no new coupon is needed (print/make_coupons.py measures both). The same coupon tests the 4.0 mm recesses for the M2 pan heads: 24 sites in trunk_top, head_yaw_to_roll and roll_to_pitch, 14 with servo-bag M2x6 (B2) and 10 with kit M2x5 (B21; kit head 3.7 x 1.4 mm per its Amazon listing image, read 10:31 PM ET). Also drill the 4 battery_pack_lid clearance holes from 2.5 to 2.7 mm (FASTENERS.md finding 13) so the lid clamps instead of threading.
- D21 Eye screws. DECIDED 10:50 PM ET: the 4 pilots in each eye are blind, 3.0 mm deep behind a 1.5 mm front skin (1.3 mm on the left eye; ray cast on print/left_eye.stl and right_eye.stl, FASTENERS.md section 3 finding 14 and print/make_coupons.py T1), not open as MOUNTING.md said. The screw passes the bulb (2.0 mm) and the head wall (3.0 mm) before the eye, so an M2.5x8 alone lands on the pilot floor (M2.5x6 would leave only 1.0 mm of thread). Decision: M2.5x8 DIN 912 A2 (BOM 17g, unchanged) with one 0.5 mm flat washer under each head: 2.5 mm of thread engaged, 0.5 mm short of the floor. 8 washers, ISO 7092 small series (2.7 x 5.0 x 0.5 mm) so the washer stays close to the 4.5 mm head (BOM line 17l). Still below the 2 x d rule (5.0 mm), set by the pilot depth; the eyes are light parts. Tested on coupon T1 (print/PRINT_PLAN.md).
- D21 note, 2026-11-02 12:47 AM ET (from the netlist and BOM pass by agent NL1, BOM lines 17g and 17l): the 0.5 mm washer came only in a special-order box of 2000, so line 17l is now the stocked BelMetric WFHV2.5X5SSA4 (ISO 7092 A4 HV200, 2.7 x 5.0 x 0.3 mm). Two go under each eye screw head: a 0.6 mm stack, 2.4 mm of thread engaged, 0.6 mm short of the blind pilot floor. 16 washers needed, 48 on the buy list (BOM 17l, the store's $5 minimum). The robot stack under the head becomes 5.6 mm (washers 0.6, bulb 2.0, head wall 3.0).
- D21 note, 2026-11-02 2:13 AM ET (agent PRT, print/PRINT_PLAN.md T1): coupon T1 tests the 5.6 mm stack with two printed pieces, T1b (a bulb) and T1w (the head wall behind the left eye), under two 0.3 mm washers; S1 is 11 pieces, 41.2 g, 4.14 h. Lead decision L2 (2026-11-02, under Ahmed's delegation): the 8 washers T1 needs come from BOM 17l, so the test order gets the BelMetric lines 17j, 17k and 17l as one order, TO17, $5.04 (the store's $5 minimum checkout). Plan only; nothing is bought.
- D22 Lighter print profile. DECIDED 2026-11-02 12:12 AM ET: adopt variant (c) of print/MASS_STUDY.md. Every part prints with 2 walls unless a rule needs more. The insert bores of the 10 insert parts (body_middle_bottom, body_middle_top, foot_top x2, foot_bottom_pla x2, leg_spacer x4) and the 5 screw pilots of body_back get a solid ring (a 100 % infill modifier, print/config/mod_ring.ini) instead of extra walls on the whole part. The head (4 walls), the neck chain (5 walls, 40 %), the knee sheets, roll_motor_bottom, the antenna holders, trunk_top, trunk_bottom, the eyes, the speaker stand and all spares stay heavy (their settings before D22). Reason: it saves 128.2 g (the build goes from 31 % to 25 % over the trained model) and moves the centre of mass 0.5 mm forward. Sim pass only. Gate: light copies of coupons C2a, C2b and C3 (C2aL, C2bL, C3L) print next to the current ones in session S1. If a light ring fails the insert pull or fit check, those parts keep 4 walls (+61.7 g). Applied in print/ (config/ with the old base kept as config/pla_print_heavy.ini and tpu_print_heavy.ini, parts.csv profile, rings and heavy columns, make_coupons.py, slice.py, PRINT_PLAN.md, SLICE_SUMMARY.md), PrusaSlicer 2.7.2 estimates: coupon session S1 36.2 g, 3.60 h and S2 17.6 g, 2.19 h; full print on a 220 bed 18 jobs, 1347.8 g PLA, 17.6 g TPU, 118.6 h (was 15 jobs, 1474.5 g, 18.1 g, 126.4 h); a failed gate adds 61.5 g and 4.1 h. Supersedes: the 3-wall base and the whole-part insert walls of the print package before D22.
- D23 Ankle power feeds. DECIDED 2026-11-02 12:12 AM ET (sim/POWER_FIX.md option 3b, study by agent PW): add cables SP4 and SP5, a 22 AWG pair (V and G only, data cavity empty) from the belly splices SPV and SPG to the free BUS 1 port of SV24 (left ankle) and SV14 (right ankle). Reason: the TEST_PLAN 9 ankle gate failed in sim as wired (D15 star). With the feeds the ankle time under 6 V at a nominal pack falls from 23.9 % to 5.8 % (typical corner; 67.0 % to 20.5 % high-side), with no new purchases (BOM spares) and +11.7 g. Sim pass only. The 3S pack is held until the TEST_PLAN 9 walking log on the real robot: 3 x 18650 cannot fit the battery bay (a 20 x 41 x 76.5 mm box), so 3S means a pouch pack, a 3S BMS, a 3S charger, a pack monitor and an over-voltage cut; POWER_FIX.md has the 3S plan (option 6+3b passes both corners in sim). Until then: 2S with the tighter bench gates (TEST_PLAN 3.2, 4.1, 4.2, 5, 9). Applied in wiring/netlist.yaml, BOM.md and cables3d/ (routes and ties of SP4 and SP5). Supersedes: the 22 AWG made-lead plan of sim/POWER_PATH_SIM.md item 4 (contingency X1/X2 stays for the B17 length test fit only).
- D23 note (2026-11-02 about 2:20 AM ET, agent PWR, sim pass only): the as-built model (sim/power_path_sim.py topology as_built, every length from the netlist: SP4 390 mm, SP5 420 mm, P9 and P14 included) gives, at a nominal pack for our 2.65 kg build, ankle time under 6.0 V 6.2 % (typical) and 21.4 % (high-side), close to the 3b study. The knee is now the lowest leg servo (right knee 9.6 % under 6 V, typical) and the neck chain, with no second feed, has the lowest servo in the high-side corner (head roll 4.88 V). Pack RMS 5.90 to 5.92 A, 99 % of the Pololu 2815's 6 A point at 55 C (TEST_PLAN 4.2). Details: sim/POWER_PATH_SIM.md 'As built'.
- D23 note (2026-11-02, lead decision L1 under Ahmed's delegation, after PWR's 2:20 AM ET report): TEST_PLAN 9 times the knees and the head roll too, with the 10 % gate on each (Option A). As written into TEST_PLAN.md section 9 (agent SW's text of 4:46 AM ET, applied by agent INT): no servo under 6.0 V for more than 10 % of the walking time at a nominal pack, counted in time (ankles, knees and head roll named). The section 5 hop gate stays 40 mOhm per conductor (fix before assembly); its note that the sim holds every servo under 10 % only to about 28 mOhm (VERIFICATION.md E6b; 29 mOhm in PWR's run, before the D25 cut changes) is the early warning that section 9 may fail and the 3S plan comes up (sim/POWER_FIX.md option 6).
- D23 note (2026-11-02 about 6:15 AM ET, lead decision L3 under Ahmed's delegation; written by agent SFX, sim pass only): TEST_PLAN 5 gets three bands per conductor for the 2S pack with SP4/SP5, in place of the single 40 mOhm gate of the L1 note. Pass: at most 28 mOhm per conductor ("Gate: 28 mOhm per conductor"), the largest whole mOhm at which every section 9 gate holds in sim for our build (right knee 9.9 % under 6.0 V at 28 mOhm, 10.2 % at 29 mOhm; the typical corner is 27.6 mOhm). Warn: over 28 up to 40 mOhm: the build goes on; the sim predicts a knee over 10 % in section 9 at a nominal pack (right knee 13.4 %, ankles 8.0 % at 40 mOhm), so the walking log decides, and the 3S plan (sim/POWER_FIX.md option 6) is made ready for Ahmed. Fail: over 40 mOhm: a contact or crimp worse than any corner we modelled as typical; find and fix it before the full assembly. VERIFICATION.md E6b runs the pass value (it must pass, else FAIL) and the 40 mOhm warn limit (WARN with the knee and ankle numbers; FAIL only if a servo goes under 4.5 V there).
- D24 Projector lead hole. DECIDED 2026-11-02 12:12 AM ET (cables3d/CABLES_3D.md finding): flash_light_module sits outside the head's left wall and its 4 mm lead channel opens outside the shell; print/head.stl has no passage, so D7 has no inside route. Decision: drill a 4.0 mm hole through the printed head wall, along y at (64.5, 84.8, 209.3) mm (URDF world, zero pose; head.stl frame (83.5, 84.7, 144.5) mm), 2.5 mm behind the module, instead of editing head.stl (stock STL kept). How and where on the part: print/PRINT_PLAN.md "After printing" step 4. D7 then runs inside the head and through the hole into the channel, 78 mm worst, so its cut stays 160 mm. Tool: BOM T14, a 4.0 mm HSS bit, turned in the T13 holder. Clears HARDWARE_AUDIT B34. Supersedes: the cables3d proposal to add the hole to head.stl.
- D25 (decided 2026-11-02 by the lead under Ahmed's delegation; carried out by agent CAB, history/2026-11-02_0437_d25_cable_retention_twist.md and history/2026-11-02_0455_d25_bundle_ties_route_tries.md): cable retention, joint loops, twist and the camera cable.
  1. Stick-on mounts: MB3A (BOM 34) where a flat 19 x 19 mm patch fits, else a Panduit ABM1M-AT-C 12.7 x 12.7 mm (new BOM line 34b, Hisco, 1 pack of 100, $72.41; tie width up to 0.1 in, the line 32 tie is at that maximum). One anchor per spot: a tie point whose spot is taken shares the nearest anchor of its link (one tie round both bundles).
  2. Where no mount fits, in this order: (i) a tie to a neighbour cable that its own anchor holds; (ii) two 4.0 mm tie holes (BOM T14) drilled through the printed part after printing, checked in CAD (1.6 mm of plastic round and between the holes, wall 1.6 to 12 mm, screws, inserts and empty holes at least 1.6 mm off, 1.5 mm free behind the wall, the strap at least 1 mm from moving parts over the joint sweep; print/PRINT_PLAN.md After printing step 5); (iii) the loop tie moved further along the route while the loop still meets 3 x OD; (iv) a route change to a mount patch, kept only if the loops still meet 3 x OD and every cut still fits with the 40 mm slack.
  3. No new printed parts and no STL change (keep it simple). Where nothing above fits, a tie round the bundle only, checked at both joint limits at the TEST_PLAN 1.4 test fit ("bundle tie, test fit"). A drilled tie-hole pair or a printed anchor is the fallback only if the test fit shows the bundle reaching a moving part.
  Result: 75 tie points: 32 MB3A, 23 ABM1M-AT-C, 6 stock holes or slots, 3 drilled tie-hole pairs (T014 and T084 in neck_right_sheet, T072 in the left leg's knee_to_ankle_right_sheet), 2 ties to an anchored neighbour cable, 9 bundle ties checked at the test fit (T016, T017, T023, T024, T085 at the neck; T034, T045 at the knee loop ends; T026 and T089, where the route changes were tried and not kept: T026 would leave D2 and D3 18 to 25 mm short of the 40 mm slack, T089 would put the SP5 route 18 mm past its 430 mm cut). Nothing is open.
  4. Head yaw: the neck bundle runs over head pitch and head yaw as one loop (no tie on head_pitch_to_yaw). All 43 joint loops meet 3 x OD over the full URDF range, head yaw +/-160 deg included, and within the Runtime head ranges. Keep the full loop; manual moves keep head yaw within +/-45 deg (TEST_PLAN 8.2b).
  5. Twist: made multi-wire cables are twisted where one lay fits after 20 mm untwisted ends (NASA-STD-8739.4A 7.2.16 to 7.2.18, lay 8 to 16 x the bundle OD): SP3, SP4, SP5, P13, D2, D3, D4, D6, D10 and SD1 branch b. Their cuts carry the take-up: SP4 and SP5 V and G +10 mm (400 and 430 mm), D10 LRC +10 mm (220 mm). Kit cables stay as shipped.
  6. D12 keeps the 150 mm camera cable (test order TO9). The fallback, Adafruit 5818 (200 mm), is named in the BOM E7 note; it has no buy line.
- D27 V1 scope. DECIDED by Ahmed 2026-11-04 about 4:08 PM ET: "Now let's do this as a version 1, forget about the wheel. Forget about chasing a human and that's fine." Scope: V1 is the stock walking duck on legs, indoors, our 2.65 kg build; no heel wheels and no human pace work (answers STATE.md open question 6, asked 2026-11-03). The wheel and human pace sim work stays as history; none of it is built. Then about 5:05 PM ET: "if you see bad signals or bad spikes, we got to fix that, not just detect them", so every V1 FAIL or RISK gets a fix shown in the twin (V1_PLAN.md, How it runs).
- D28 Electrical fixes in the walk loop and the Pi setup. DECIDED 2026-11-04 about 5:50 PM ET by the lead under Ahmed's instruction of about 5:05 PM ET ("if you see bad signals or bad spikes, we got to fix that, not just detect them"); work by the track 1b agent (twin/electrical/ELECTRICAL_TWIN.md, Track 1b fixes; history/2026-11-04_1740_v1_elec_fixes.md). The walk loop runs the target guard (twin/electrical/fix/bus_budget.py: the training's own target clip plus a 10 A servo budget); start_paused is true; the Pi runs a read-only root with logs on their own partition; the BNO055 runs on software I2C. Scope: the robot's V1 runtime setup (software/); track 3 runs the guard in the real code. Sim pass only.
- D29 Eye lamps. DECIDED by Ahmed 2026-11-04 about 5:12 PM ET: "The lamp is cheap. We can have two lamps in each eye." He had asked at about 5:05 PM ET "Also, why do we have the LED on the side? Put it in the eyeglass disc." and was told that the side LED is the upstream projector lamp and that each eye disc already has its eye LED. Read by the lead as: each eye disc holds two 1 W LED beads, its eye LED and a lamp LED; the side projector lamp (flash_light_module, flash_reflector_interface, the BOM E5 reflector and its lead) is dropped, which supersedes D24. The two lamp LEDs stay on the projector GPIO, each with its own resistor, so the runtime's lamp button works unchanged. Scope: the V1 head; track 2 does the fit, mount, wire, BOM and mass work.
- D30 Main switch: Pololu 2813 pushbutton power switch. DECIDED by Ahmed 2026-11-04 5:58 PM ET: "yes, swap to the 2813", after he was told that the Pi cannot switch the Pololu 2815 off, so the cells pass 2.5 V within hours after the battery hard stop (HARDWARE_AUDIT B49). Scope: BOM line 10 becomes the Pololu 2813 ($8.95); the 2815 stays as line 10r with quantity 0; line 10b becomes a momentary button in a printed plate in the body_back cutout; the Pi switches the duck fully off through the 2813's OFF input (GPIO26, the gpio-poweroff overlay). Applied by the assembly track (twin/assembly/ASSEMBLY_TWIN.md). Nothing is bought.
- D31 Camera cable 200 mm. DECIDED by Ahmed 2026-11-04 6:07 PM ET: "yes, use the 200 mm camera cable". Superseded by D34 the same evening, before it was applied.
- D32 Knee servos: Feetech STS3250 on both knees. DECIDED by Ahmed 2026-11-04 6:18 PM ET: "yes, put STS3250s on both knees", after he asked "can we replace them with something stronger, maybe even safer?" and was shown SERVO_UPGRADE_OPTIONS.md Option A. Scope: the two knee servos become STS3250 (OpenELAB STS3250-C002, $73.99 each); the other 12 stay STS3215 C001; the 2S pack, BEC, fuse and BMS stay; the walk policy is retrained with the new knees (RunPod, STATE.md open question 1). The knee track runs the swap in the twin (twin/knee/). Nothing is bought.
- D33 Eyes back to the original; reverts D29. DECIDED by Ahmed 2026-11-04 6:42 PM ET: "I'm thinking about reverting the eyes the way they were, having the flashlight module like how we had it originally. Because it's just going to look creepy, to be honest with you, with a the eyes flashing light, we don't want that. Keeping it black is nice. It gives it a friendly look." Asked whether the eyes keep the original dim blinking glow, at 6:44 PM ET: "Yes, revert to the original." Scope: one eye LED per eye with the upstream random blink (the runtime's eyes.py), the side projector lamp as upstream, and D24 (the projector lead hole) stands again. D29 was never applied.
- D34 Camera cable 300 mm; supersedes D31. DECIDED by Ahmed 2026-11-04 6:48 PM ET: "yes, switch to the 300 mm camera cable", after the 3D track found that the camera ribbon, as a flat strip without a twist, needs a 227.4 mm route (twin/complete3d/COMPLETE3D.md), so 200 mm is 27 mm short. Scope: BOM E7 becomes a 300 mm Pi Zero camera cable (part and price from the 3D track); the extra length lies in a gentle loop, not a fold. Lead note, same exchange: the 4 camera screws become M2x5 from the BOM 17h kit with their pilots drilled to 4.5 mm, because M2x4 engages 3.0 mm, under the 4 mm rule. Nothing is bought.
- D35 Assembly. DECIDED 2026-11-04 about 7:20 PM ET by the lead under Ahmed's V1 request ("every component is accounted for: how it's going to attach to each other"); work by the assembly track (twin/assembly/ASSEMBLY_TWIN.md and BUILD_ORDER.md; history/2026-11-04_1855_v1_assembly.md). Build in the BUILD_ORDER.md order; tape the side lamp to the head (VHB 4950); tie the BEC Pro over the top with one spare cable tie; service the cells by taking body_back off and pulling it 20 mm back on its wires. The three Wera cross-head screwdrivers wait for Ahmed's OK (STATE.md open question 8). CAD check and calc only.
- D36 Parts list additions. DECIDED by Ahmed 2026-11-04 7:47 PM ET: "yes, add all of them to the parts list", for three Wera cross-head screwdrivers (PH0 x 60 $7.91, PH1 x 80 $9.76, a PH0 x 25 bit $1.95), WAGO 221 lever splices for the battery bay (about $0.94 each), KK 254 crimp plugs and an XT30U plug pair so the head and the Pi unplug (twin/screws/SCREWS_TWIN.md X1, X3a, X4). At 7:50 PM ET, "yes." for a 1/16 in drill bit ($1.98) for the camera pilots (D34). They go on the parts list; nothing is bought.
- D37 Self-charging is a V1 must-have. DECIDED by Ahmed 2026-11-04 7:50 PM ET: "But I feel like self-charging is extremely, extremely important. If there is actually any feature we want to add on version 1, whether we use Kmini, Q Mini, or we use Open Duck Mini, I really want a self-charge. It's a toy. It has to charge itself", and "The self-charge is important." Scope: whichever robot V1 uses finds its charger and docks by itself; for V1 this replaces D5's "the dock stays a later lab step". The robot choice for phase one is compared in a separate session.
- D38 Lead calls under Ahmed's delegation of 2026-11-04 7:50 PM ET ("While you do all of the other stuff, stop asking me about the other stuff. Just make your best decisions, merge, and let's pause."): (1) the back shell keeps 7 screws, not 3 (one upside-down landing would fall from SF 1.21 to 0.45, twin/screws/SCREWS_TWIN.md); (2) the out-of-stock 2813 button gets an in-stock replacement that fits the D30 plate (track 2d); (3) D26 P1, three walls on roll_to_pitch, is taken (twin/knee/KNEE_TWIN.md: 1.45 to 1.81 walking, 1.04 to 1.20 in push, still under 2, so the rest of D26 stays open); (4) the cable rubs B61 and B62 go to track 4; (5) the knee retrain waits for a bench BAM test of one STS3250, a purchase for Ahmed's OK (STATE.md open question 9).
- D39 Closed holes and fewer screws, set by the stress test. DECIDED by Ahmed 2026-11-04 9:03 PM ET (artifact comments on the 3D view): "Hey dude, throughout the entire design, any hole without a screw, close it. I know you did some managing of the screws, but fix up the 3D design with it, please." At 9:16 PM ET, after the lead had read his corner example ("one screw at each corner") as a rule: "Well, it's not me who says that, dude. It's the stress test where it could break that you add the screw to. That's not my rules. I was just giving you an example, but you removed the screws earlier, and you forgot to fix the design. The design needs to be focused on fewer screws. If you can remove more, please go ahead and do so, but I don't know. We already did a pass." Scope: every fastener hole and insert bore in a printed part that has no screw is filled; this reverses track 2d's "holes stay, so any screw can come back", so a screw that has to come back means a reprint. Holes that do a job stay open (vents, cables, ties, light, sound, the camera lens, bearings, tool access). Screws stay only where the stress checks need them, with one more pass for screws that can go; where a rattle or plug check needs it, a printed seat, pin or wall holds the part instead of a screw. Track 2e (V1_PLAN.md); CAD check and calc only.
- D40 V1 stays on Open Duck Mini v2; Qmini is dropped. DECIDED by Ahmed 2026-11-04 9:37 PM ET: "no, we're not going to be using Q mini because I don't like it, so we're sticking with this one." Scope: V1 and the self-charging work (D37) are built on this robot. The Qmini comparison is closed; its session had reached the same answer (stay with the duck).
- D41 Self-charging dock: design it now, heat included. DECIDED by Ahmed 2026-11-04 9:37 PM ET, asked whether to start the dock design now or wait for the Qmini comparison: "I want, but assume the heat as well, so it needs to be good. We need full research." At 9:43 PM ET: "So instead of having pins or pegs, how about we do a magnetic field, just like how the robo cleaners and wireless phones ?? Could you study that?" Scope: track 8 researches and designs how the duck finds its dock, walks in, sits and charges by itself, with contacts and wireless (inductive) charging both studied; heat is checked at every step (hot servos at docking, charging heat in the body, the pack's charge temperature window, cooling on the dock, a 32 C room); the dock works with today's pack and with a DeWalt 20V MAX pack (track 9, his same 9:37 PM ET message). Research and twin checks first; nothing is bought or printed.
- D42 Uniform screw patterns. LEAD CALL 2026-11-04 about 10:35 PM ET under D38's delegation ("the screws left must form a uniform pattern"), after Ahmed's comments on the 3D view at about 10:35 PM ET: "You still mist. Why are the belly screws not uniform? What the fuck is this? Do you see the error first before you do anything?" and, about the head bottom plate, "Over here, you also have three screws. Why is it only three, and why are they also not uniform?" D39 still holds (the stress test decides where a screw goes, fewer screws is the aim); on top, the screws left on any part form a uniform pattern: mirror-symmetric about the part's own centre line, or a diagonal pair through the centre, never an L, a Z or a scattered triangle. Scope (track 2f, twin/holes/HOLES_TWIN.md addendum): body_front on its 4 corners (F067, F068, F071, F072; F069 out), the battery lid on all 4 (F027 back), head_bot_sheet on 4 mirrored corners (F083, F084, F089, F090; F088 out); every other screw group audited (twin/holes/data/sym_checks.json). Also from Ahmed at about 10:45 PM ET on the back shell ears ("And these two, I thought we need to remove from them as well: these two holes."): the F075 and F076 ear plugs were not flush (a 6 mm dimple up to 5.4 mm deep on the slanted face), so every plug cap is now fitted to the part surface and checked for flushness (0.05 mm). Screws 316 to 318, inserts 47 to 48. CAD check only, calc only.
- D43 Dock charge path and dock behaviour code. DECIDED by Ahmed 2026-11-04 11:06 PM ET: "go with contacts, use the winner". Scope: the dock charges through contacts (no wireless charging); the dock behaviour code is a port of osrf/autodock (Apache-2.0, commit fd9c2a9), the winner of the dock survey (track 8: 62 projects, scored rubric). The duck repo LICENSE is Apache-2.0, so the copy is allowed with its headers and LICENSE kept.
- D44 Battery cells. DECIDED by Ahmed 2026-11-04 11:09 PM ET: "go with the P45B cells then .. Or are there better batteries out there? .. Okay, cool. Are our batteries swappable?" Scope: the DeWalt DCB200 is rejected (not a fit); the pack moves to 2S1P Molicel P45B 21700 unless the battery study (track 9) finds a better cell by the D45 criteria; the battery bay resize follows in track 9.
- D45 Swapping, self-charge and how to choose. DECIDED by Ahmed 2026-11-04 11:13 PM ET: "I think we're good on the swappable battery, but we definitely need to secure the self-charge. And the research is ongoing, so take your time. Regardless of what this research says, just go ahead and implement the changes, please. I do really expect the simplest solution, the cheapest and the most reliable one, all at once". Scope: no tool-free swappable pack (a battery change stays a screwdriver job); the self-charging dock is a must; the dock and battery changes are implemented without a further go, choosing the simplest, cheapest and most reliable option together.
- D46 Precision, the walk retrain and perception. DECIDED by Ahmed 2026-11-05 1:29 AM ET: "Okay, that's fine, but I'm also all about precision. Like, we need to achieve a precision. If you need to train the walk, do so. The ducky, I really wanted to be extremely, good, agile. I hope we have enough technology built in, such as Wi-Fi, Bluetooth. I don't know, what about perception? Why don't we rely on perception as well?" Scope: robot (duck). Precision is a goal in its own right, not only a forgiving dock: the dock work reports the error at the seat (lateral, yaw, fore-aft) as well as the rate; the walk is retrained for precision and agility (V1 track 10: creep, turns that match left and right, sidesteps both ways); perception (the head camera and the dock's tags) closes the dock loop down to the paddle; Wi-Fi and Bluetooth are on the Pi Zero 2 W but are not used for docking (the dock gate stays hardware, with no Wi-Fi handshake).
- D47 Companion hardware: microphones, ears and looking at the caller (V1 track 11). DECIDED by Ahmed 2026-11-05 ET (scope), details by the track under D45 (simplest, cheapest, most reliable together): "I'm thinking of having a companion... It's going to be powered by a Hermes agent, an AI agent of sorts, so it's going to be a fun toy. Maybe it can also send email for us, but this is all software... It's going to be a homebody, so maybe we don't need the additional speed." Then: "Forget about the safety tests for now, but do focus on these items that you mentioned, such as a mic or maybe the ear twist. I'm thinking that if we call it, it would just look at the human, things like that. I don't think we should change the eyes much right now." Then: "Yeah, maybe we don't need the software stuff yet. I'm just trying to really cover the hardware." Scope: hardware only for now. Two I2S MEMS mics (Adafruit 3421, SPH0645LM4H; BOM E8, $13.90), one per side wall of the head, 120.5 mm apart, sharing the MAX98357A clocks, data on GPIO20 (pin 38), one overlay (googlevoicehat-soundcard); front or back settled by a head turn; the 2 antenna SG90s become the ears (no new servo); the camera does the last step of the look; no radar, UWB, BLE or PIR. The head gets 2 bosses, a port tube and a 1.2 mm sound port per side (twin/companion/mic_seat.py, CAD check only), screws in mirror pairs (D42), no empty hole (D39). The agent (Hermes) stays off-board; email and any other action stay off-board and need a parent's approval. Eyes unchanged. Safety tests skipped for now (Ahmed). twin/companion/COMPANION.md.
- D48 Companion accuracy, self-noise and the hybrid (V1 track 11, hardware). DECIDED by Ahmed 2026-11-05 about 2:45 PM ET (scope), details by the track under D45: "I do care about accuracy... Maybe we do a hybrid. We do two mics, and maybe then we need to drill and change the shape of the 3D head. Make sure they're being positioned properly, so when it turns its head, it finds a human... We could do, and we probably will do, Bluetooth direction as well, like a mixed algorithm... how do we make sure the speaker and the mic do not interfere? The servos, when it walks, probably are going to disturb the mic, so we probably need a multi-directional answer." Scope: two mics stay (GCC-PHAT on the pair, the head turn for front or back and to bring the voice broadside, the camera for the last step); no third mic (one I2S data pin carries 2 slots); the seats stay mirrored on the side walls, no reshape (section, close-ups and port checks in twin/companion/); GPIO16 now drives the MAX98357A SD pin so the amp is off while the duck listens (half duplex in hardware); a foam ring on each port tube; listening gated on motion; the mic cables D14 and D15 are twisted and routed away from the pack feed P13 and the SG90 leads. Bluetooth (and UWB) direction finding needs a worn tag and is not in V1; the UART pins GPIO14 and 15 stay free for it. twin/companion/COMPANION.md section 11.
- D49 The duck listens all the time; its own noise is removed by a learned model (V1 track 11, design and plan). DECIDED by Ahmed 2026-11-05 ET. At 5:40 PM ET, quoting the D48 line "Walking: it doesn't listen while walking or turning its neck. How loud the servo noise really is needs a bench test.": "... but thats really not cool, maybe a machine learning that can figure this out 😕 ??" At 7:22 PM ET: "yes, add it to the design". Scope: listening stays on while the duck walks and moves its neck or ears. Ego-noise is removed in layers (twin/companion/COMPANION.md section 12): L1 a motor-informed estimate from the joint commands, joint speeds, ear commands, gait phase and IMU (the small-robot NPSS idea of Ito et al. 2005, with a motion template table as its first version); L2 RNNoise retrained with the duck's ego-noise; L3 an openWakeWord model of the duck's own name trained with that ego-noise; L4 DeepFilterNet on the home PC for the speech the agent hears. Direction finding weights each time-frequency bin by the L1 ego-noise mask before GCC-PHAT. Audio frames and servo state share one clock (CLOCK_MONOTONIC_RAW, ALSA timestamps, a chirp check). Motion gating (D48) stays only as the fallback. A bench data plan from day one is TEST_PLAN 17 (380 min, about 9.0 GB raw, big files kept out of git). No new parts; no software module is written (D47).
- D50 Awake while docked. DECIDED by Ahmed 2026-11-05 7:32 and 7:33 PM ET: "How long to charge? Can the Ducky stay running for like 8 hours?" Then: "Since it's a home buddy, it doesn't need to be small. And since it can charge for like 6 hours at night, that's awesome." Scope: robot (duck) and its dock. The duck stays on while docked: a fourth chest contact (SYS) brings the dock's gated 9 V, ORed with the fused pack through two ideal diodes (BOM DK6, DK7) at the 2813 input, so the dock runs the duck and the pack only charges (the MCP73213 keeps its CC/CV, 10 % end of charge and 6 h timer); torque off while docked, servo power left on; the 2813 OFF stays a full shutdown and the wake pulse stays for it; the extra size goes into the dock (9 V 4 A adapter), not the duck. twin/dock/DOCK_TWIN.md section 11.
- D51 Touch: two MPR121 boards and copper pads (V1 freeze). APPROVED by Ahmed. His words: "How about we need to make it as real as possible for Ducky, understood and friendly, and show a lot of emotions? However, we need to keep ... focus on the hardware design right now." The part choice (2x Adafruit MPR121 (1982) with copper-foil pads at I2C 0x5A and 0x5B) is the expression study's, carried in the freeze brief of 2026-11-06 ET. Scope: the head board TCHH (0x5A, ADDR left on its pull-down) on VHB 4950 on the inner roof of the head, the body board TCHB (0x5B, ADDR to 3Vo) on VHB on the left inner side wall of body_middle_top; pads of Adafruit 1127 copper foil on the inner shell, each with a 3 mm guard ring to GND: PH1 head top 30 x 30 mm, PH2 back of the head 20 x 30 mm, PB1 back behind the neck 17 x 34 mm (twin/freeze/touch_pads.json, CAD check only; palm about 3.6 to 11.9 pF through the wall, calc only). Cheeks were looked for and not placed: no place on both side walls passes (the speaker grille and duct on the right, the side lamp opening on the left). Wiring: D16 Pi header to TCHH, D17 and D18 to PH1 and PH2, D19 taps D2 at the BNO055 for TCHB, D20 to PB1; no new GPIO, polled (IRQ unwired) on the software I2C bus 1. BOM E9 ($15.90) and E10 ($19.95). Nothing is bought.
- D52 Speaker duct (V1 freeze). APPROVED by Ahmed, freeze brief of 2026-11-06 ET: "fix the about -8 dB rear leakage per the study. Change the CAD, keep clear of the mics and the ears". Origin: the expression study he asked for ("expressive and friendly hardware"); the brief's line is the study's fix, not his own wording. Scope: print/speaker_interface.stl gets a round duct, one piece with its plate, 33.0 mm bore, 1.9 mm wall, 12.0 mm long, to 1.0 mm short of the inner wall, sealed there by a ring of BOM 29 foam with one liner left on (it seals and does not bond); the 36 holes of the outer grille ring (r 18 mm), which the duct would leave outside, are closed flush in print/head.stl; 91 holes stay (286 mm2); grille corner about 4.1 kHz (calc only). The duct clears the fitted interface screw heads by 2.0 mm, the mic boards by 30.8 mm and the ear servos by 53 mm (twin/freeze/speaker_duct.json, CAD check only). The bench A/B sweep of the expression study settles the gain.
- D53 Ears on hardware PWM (V1 freeze). APPROVED by Ahmed, freeze brief of 2026-11-06 ET: "dtoverlay=pwm-2chan,pin=12,func=4,pin2=13,func2=4". Origin: the expression study he asked for ("expressive and friendly hardware"); the quoted line is the study's config, not his own wording. Scope: GPIO12 (PWM0, right ear) and GPIO13 (PWM1, left ear) in config.txt (software/PI_SETUP.md 4c, check_pi_setup.sh), netlist pin notes, WIRING.md; pulses stop after each move. Open for Ahmed: the Runtime's antennas.py uses Blinka software PWM, so it must write the hardware PWM channels instead, a Runtime change against D6 (Runtime unmodified).
- D54 Cliff sensor (V1 freeze). APPROVED by Ahmed. His words: "If there are good algorithms out there using vision, let's use that... If you think we need a cliff sensor or a distance sensor, let's do that." Then, after the study: "As far as the sensor, do you think it's necessary? Cool." The part (Adafruit 5396, VL53L4CD downward ToF) is perception study 3.1. Scope: BOM line 5b ($14.95), I2C 0x29 on the software I2C bus 1 (BNO055 0x28 with ADR low, MPR121 0x5A and 0x5B: no clash), optional interrupt to GPIO17 (pin 11, wire D22 in the D21, D19 and D2 bundles). Seat in print/body_front.stl, centred, low in the chest, beam 52 deg below horizontal: 4 printed standoffs, 2 x M2.5x6 (17f) on the diagonal pair of the board's holes (D42), the other 2 holes on solid standoffs (D39), a window that follows the 18 deg field of view (14 deg half angle); sensor 165 mm and window centre 150 mm above the floor standing (the study said about 140: the 17.8 mm board tilted in the 10 mm wall has to sit higher so the cone clears the bottom rim); window z -31.1 to -6.8 mm, 6.8 mm under the D50 pad and 39 mm under the 6 mm lead hole; floor spot 93 to 178 mm ahead of the toe, 209 mm slant on a flat floor, trigger over 250 mm (a 32 mm drop trips it); no foot in the field of view in the 7 stock walk cases, walking slant 190 to 216 mm (twin/freeze/cliff_seat.json and cliff_walk.json; CAD check only and sim pass only). body_front now prints with its front face on the bed. Wires D21 from TCHB, D22 the interrupt. Nothing is bought.
- D55 Being picked up (V1 freeze, design only, no new hardware). APPROVED by Ahmed. His words: "Don't forget the motion when people pick up the robot." The freeze brief of 2026-11-06 ET set the design: detect it "from the IMU (lift and tilt), from servo load dropping on the leg servos, and from the cliff ToF jumping to a long range; at least 2 of 3 must agree", then "go limp and safe, stop walking, with an optional 'whee' reaction; on set-down, check the floor before any step". Scope: twin/companion/COMPANION.md section 13; no software module is written (D47).
- D56 One arbitration layer (V1 freeze, design). DECIDED by Ahmed. His words: "we're going to have a server that processes these things" and "...all of this data is going to work in harmony. Collectively". Scope: every input (camera and home server, mics, touch, IMU, servo load, cliff ToF, dock) feeds one arbiter on the Pi with a fixed priority: 1 safety (cliff, picked up, falling, low battery), 2 dock and charge, 3 people, 4 play. The home server only suggests: an off-board command carries a 300 ms time-to-live against a 100 ms heartbeat, and the robot keeps the final say on safety. twin/companion/COMPANION.md section 14.
- D57 No colour eyes for now. DECIDED by Ahmed 2026-11-06 ET: "no colour eyes for now, keep them simple". Scope: the optional RGBW eye of the expression study (Adafruit 4776 on GPIO10, SPI) is not added; the eyes stay as they are (one dim warm white bead per eye, D33); GPIO10 stays free in the netlist. Deferred, not rejected for good (COMPANION.md section 15).
- D58 Feet-contact dock. DECIDED by Ahmed 2026-11-06 ET, after the feet-dock study he asked for ("we can just make each foot a contact... why does it have to look like a toilet"). His words: "Yeah, I think I would like to go with the feet... It looks natural, and it really makes much, much sense." The concept (sketches and sims, no CAD yet; sim pass only and calc): each foot is a contact. The duck walks onto a thin flat mat (about 7 mm, with a bevel and two foot pockets) and charges through its soles: two pads per foot carry the four nets of D50 (CHG+, SENSE, GND, SYS), spring pins in the mat (2 rows of 7 at a 6 mm pitch per pad, a pad counted made with at least 2 pins within 1.0 mm; pin force 0.30 to 0.58 N over 1.2 mm of travel). Standing on the mat with torque on: the best tall stance (hip pitch -15, knee +5, ankle 0 deg) draws about 0.86 A on the bus and warms the hottest servo winding about +4 K; with torque off the standing duck falls within a second, so standing is the torque-on mode. Sitting on the mat with torque off is the other mode (D59 alert sit: 4 of 4 pads made, sim pass only), so D50's "torque off while docked" stands when the duck sits. Alignment: about 7 mm of lateral margin in the sim walk-in; fore-aft is the tight axis (about 1 mm before the foot stagger at the stop). Bench tests before any build: (1) a 6 h hold of the stance on a real servo pair with the thermal log; (2) a flex test of the new wires in the knee loop (to 150 deg since D59, TEST_PLAN.md 19.7); (3) pad wear and contact resistance after walking on carpet and tile (pass under 50 milliohm per pad). Superseded: the wall and paddle dock's dock-side geometry of D43 to D50 (the dock, paddle, carrier and seat parts of twin/dock); its CAD stays in the repo until the feet-dock CAD job replaces it. Carried over: D50's electrical design (the four nets, the gate, awake while docked). BLOCKERs: no flex-life data for any wire in this loop geometry; the contact resistance of the pad finish against gold crown pins is not measured; the sim servo has no deadband or hunting. SUPERSEDED by D61 on 2026-11-11 ET: the nest dock with four pins under the body replaces the feet contacts; no CAD and no part of D58 was made. The text above is kept as written.
- D59 Alert sit (option A1b). APPROVED by Ahmed 2026-11-06 ET. His words: "Yes it's great!", then "go ahead and make the changes for the sitting and new angles then". The duck sits on its folded legs with the head up and alert, then lets its torque go: it rests on hard stops, a TPU seat under the rear belly and a TPU bumper under the front, so it can charge with torque fully off on the feet-dock pads (D58; sim pass only). Reference: Ahmed pointed at the Pollen Robotics and Hugging Face Microduck's sit; we took the pose idea only (no parts, files or code). Changes (twin/sit/SIT.md, CAD check only; stress calc only): knee fold to 150 deg (the shin sheets joggled 9 mm outboard below the knee horn, a 54.8 mm shin spacer at the back edge carrying a TPU knee bumper, the thigh sheets and the leg cover relieved where the shin passes); hip roll outward stop at 8 deg (a printed lug on roll_to_pitch); ankle stop at -95 deg (TPU pads on the foot plates, a heel notch in foot_top and foot_side, the heel screw and its insert moved 20 mm toward the toe out of the notch); a TPU face where the leg cover meets roll_to_pitch at hip pitch -75 deg; neck back stop +25 deg (a printed block on trunk_top behind the neck, held by the hip yaw servo screws F127 and F129 lengthened M2x6 to M2x12 through its 4 mm flange, with a TPU face in a pocket on each pillar that the stock neck sheet's back edge meets, the sheet loaded in its plane; the neck sheets stay stock) and head forward stop -25 deg (a printed hook on the left arm of head_pitch_to_yaw with a TPU face in a pocket that the left neck sheet's front edge meets, at twice the radius of the first lug; the right side carries the neck cables); TPU seat block and belly bumper on VHB. The stop loads are the energy method (the impact speed from the sim, the stack compliance of the TPU face) or the sustained push, whichever is larger (SIT.md section 4, 2026-11-07). The URDF and MJCF ranges are the hard stops; every servo command and the servo angle limit registers stay 3 deg inside them (software/servo_limits.json, bench/set_angle_limits.py); joint zeros to 0.5 deg, matched between legs (software/CALIBRATION.md). The sit and stand path leans the trunk forward at the middle waypoints and brings hip roll back to 0 before rising (sim pass only, twin/sit/SIT.md section 5). No tail pad. BLOCKERs: the pull-out strength of the two M2x12 screws that hold the neck stop block (TEST_PLAN.md 19.8; the two screws are not in any bag or kit, BOM 17m, nothing bought); unpowered servo friction (bench test, TEST_PLAN.md 19.5); the calibration repeatability at the stops (software/CALIBRATION.md); the joggled sheet's strength on a printed coupon (TEST_PLAN.md 19.6). Design round 2 (2026-11-10 ET, lead's brief after the stress of 2026-11-07, twin/sit/SIT.md section 4): the neck pads low on the sheets' back edges (r 28) with a foot behind the block, so the screws carry no pull-out at the stop; the hook's doubler over the whole arm face with a 10 mm face; a conformal TPU face on each hip roll lug (roll_pad_left, roll_pad_right); every sim and record run again on it.
- D60 Get-up after a fall goes through the sit. DECIDED 2026-11-07 about 1:16 AM ET, by Ahmed on the coordinator's recommendation. Asked "Go with option 1?" (option 1: keep the head-up sit and teach a new get-up through it; option 2: move the stops and reshape the knee and ankle parts for the old get-up), he answered: "Whatever you recommend. I don't know. Whatever you recommend." The recommendation was option 1, so option 1 was taken. The alert sit stays as designed (D59), the neck +25 and head -25 stops included: the head stops are not moved and the knee and ankle contacts are not relieved for the get-up. Get-up after a fall will roll onto the belly, tuck into the sit pose, then use the sit's own stand-up; it is to be found by a search on our own machines first and, if that fails, trained as part of the walk retrain (track 10, the shared lab gym (overlay gym/overlays/duck)) after the freeze. Why: the stored get-up programs need knee -88, ankle +80.7, neck +61 and head -43 deg, which the printed parts cannot reach on the base either (sim pass only; twin/sit/getup/GETUP_SIT.md, SIT.md section 8).
- D61 Nest charging dock; supersedes D58. DECIDED by Ahmed 2026-11-11 ET, after the natural-dock study he asked for. His words that drove it: the mat is "Against the wall"; he prefers no tags: "it looks more futuristic and it would be better if we can pull it off in software only, using the camera"; and "I want something that feels natural and the pad feels natural". Shown the nest concept: "I like that". Asked whether to record the decision and start the CAD: "Yes go ahead". The concept (sketches, sims and arithmetic, no CAD yet; twin/dock/nest/README.md): a felt nest about 2 mm thick against the wall, about 49 cm across, with a golden cloth disc 10 cm across in the middle (the sun, plus), a 32 mm felt gap, then a pale gold cloth ring out to 47 cm (minus), and a soft rim 3 cm high along the wall that holds the plug and the electronics; the sun centre is 190 mm from the wall (concept values, calc only; twin/dock/nest/NATURAL_DOCK_IDEAS.md section 6 A). Duck side: four spring pins under the body, 2 in the TPU seat block (plus) and 2 in the belly bumper (minus), 20 mm apart in each pair, the pairs 130 mm apart (sim pass only; 130 mm in the study's section 1, 130.5 mm in the sim's pin table). Nothing in the feet, no wires down the legs, plain soles. About 15 to 20 g added, all in the trunk (calc only, an estimate with no part chosen; BLOCKER). Sequence: walk on, turn 180 deg on the spot, sit facing the room (the D59 alert sit, torque off), later stand and walk straight out. No tags or markers: the duck finds the nest by camera only (untested, BLOCKER). What it changes: D58 (feet-contact dock) is replaced. D50's four nets become two; awake while docked is kept, the nest runs the duck through the ideal diode DK6 and the pack only charges. D43 stands (contacts, not wireless), but its tags are dropped. D59 (the sit) is unchanged; the duck now charges through the belly pins, not through foot pads. The charger (MCP73213, 8.40 V, 1.0 A, 6 h timer) moves from the dock into the duck, and the nest becomes a gated supply of about 9.5 V (calc only; the MCP73213 dropout is a BLOCKER): about 1.9 to 3.2 W of new heat in the trunk while charging, against 0.11 W before (calc only; twin/dock/nest/stripes/STRIPE_MAT_STUDY.md section 2.5). Why not the others: (1) D58 as drawn does not fit. In the sit each sole is rolled about 8 deg (7.9 to 8.2 deg, sim pass only) and rests on its inner edge, and the printed sole's flat face is only 84.8 x 15.8 mm (CAD check only), so D58's two 44 x 34 mm pads per sole have no flat face to sit on (STRIPE_MAT_STUDY.md section 1.1). (2) The striped mat needs 20 diodes and 10 sprung sole contacts, puts up to 2.0 W typical in the feet (calc only) and has the weakest safety case: a large bare striped field with 5 mm gaps that any coin bridges, and one check plus a leak test (STRIPE_MAT_STUDY.md sections 2.3, 3.3 and 7). (3) Wireless: phone-size coils forgive about 10 mm against the 45 mm the nest forgives, a coil pad makes the mat 3 to 6 mm thick, and a 15 W receiver cannot cover the 24.6 W peak of awake while docked (13.6 to 17.4 W typical; calc only; NATURAL_DOCK_IDEAS.md section 4). (4) Thickness: the stock walk crossed a 2 mm mat 6 of 6 times, a 3 mm mat 5 of 6 and the 7 mm mat 0 of 6 (sim pass only, from the earlier feet-dock analysis as cited in NATURAL_DOCK_IDEAS.md section 4.4; that analysis is not in the repo), so the 7 mm mat of D58 trips the duck and a 2 mm one does not when crossed straight (see the mat-edge BLOCKER below for steering). Evidence (sim pass only unless marked; twin/dock/nest/sim/NEST_SIM.md; the pose is a stand-in of true pose plus noise, not a camera): 540 runs of the whole sequence (3 pose noise levels x 2 voltages x 3 mat frictions x 30 seeds). The first sit ends charging in 93.1 % (503 of 540), within 3 sits in 94.1 % (508 of 540); of the 511 runs that reached the sit, 98.4 % (503) charge at the first sit and 99.4 % within 3 sits. Falls: 29 of 540, all at 7.2 V (10.7 % of the 270 runs at 7.2 V, 0 at 6.0 V), all while steering across the 2 mm mat edge in the walk-on; the same 29 seeds with the mat removed: 0 falls; straight crossings with no steering at 7.2 V: 80 of 80. Zero falls in the fine moves, turn and stop (511), in the sits (522), in the stand-ups for a re-sit (11) and in the walk-off (511). The seat pins may land within 45 mm of the sun centre at any heading (calc only; NATURAL_DOCK_IDEAS.md section 6 A). No part touched the wall or the rim in 511 runs. BLOCKERs: (a) mat-edge falls when steering at 7.2 V; the fix to try first is to line up before the mat and cross straight with no yaw command (a sim re-run is in progress, no result yet), then a real felt edge on the bench. (b) The stock walk cannot creep slowly or side-step right, and its step size changes with battery voltage (move sizes differ by a factor 1.6 to 3.3 between 6.0 and 7.2 V, sim pass only); this goes on the walk retrain list (track 10). (c) Nothing is sensed after the turn: the first sit is blind. (d) Camera-only nest finding is untested. (e) Bumper pin reach: the gap under the bumper is 2.5 to 3.0 mm with one mat contact model and 2.7 to 6.0 mm with the other, against an assumed 5 mm pin (sim pass only; NEST_SIM.md section 2.7); the pin part and its spring force and travel are assumptions, and pin pockets for a belly-down fall are not designed. (f) Pin on cloth: contact resistance, dirt, hair and wear are not measured; the fallback is metal inlays in the same shapes. (g) The two-net "is it the duck" safety gate (a signature plus a leak check) is untested. (h) Charger heat inside the duck: the thermal twin is not re-run with it; the MCP73213 dropout is not read. (i) Real felt and carpet are not modelled (the sim mat is rigid). (j) The rim and wall margins are small: at worst the head came 23.5 mm from the wall and a foot 9.5 mm from the rim (sim pass only). (k) Prices: felt, cloth, rim, adapter and pins are not priced. Nothing bought. Runner-up kept on record: the pond rug (the same duck parts, a flat two-tone rug along the wall, plus or minus 247 mm of room along the wall; calc only; NATURAL_DOCK_IDEAS.md section 6 B). Next steps: CAD of the belly pins, the mat and the wall box; replace the old wall and paddle dock in the 3D viewer; redo the dock electrical design for two nets; bench tests (pins on cloth, the gate, a felt edge); camera-only nest finding. The wall and paddle dock's files in twin/dock stay in the repo until that CAD job replaces them.
- D62 Striped felt nest; supersedes the spring-pin nest in D61. APPROVED by Ahmed 2026-11-12 6:19 PM ET. The cute sit stays. The duck charges while sitting, torque off, head up, facing the room. The mat stays against the wall. Finding stays camera only. The four spring pins under the body are dropped. Nothing sticks out of the duck. The feet stay plain. No new wire runs down a leg. The mat is felt, 2 mm, with two 1 mm steps at the stations already scored (247 mm and 267 mm from the sun). The sun stays 190 mm from the wall. The contact is a flush striped field: 20 mm foil, 5 mm felt, five 3 mm gold wells in the seat. The seat may land anywhere inside +/-254 mm along the wall and +/-161 mm deep, up to 46 deg, and still have one well on each pole (calc only, the flush study). On the stored 540 seeds (sim pass only, not hardware): the blind walk puts the first seat in that window in 380 of 540, with 0 falls. The same walk with the 40 mm wall card does it in 533 of 540, with 1 fall. The true-pose walk does it in 540 of 540. The old pins do it in 35 of 540 blind. The 40 mm card is a plain square on the wall at 350 mm, not a coded tag. It is still a mark. The mat is official either way. Without the card the first-sit count is 380 of 540. The charger stays the MCP73213 board already drawn, in the duck, on the 2S P45B pack, 8.40 V, 1.00 A, 6 hour timer. The mat is a gated supply into that board. Awake while docked stays. Not taken: magnetic pads (largest housing read is 16.5 mm, capture distance not published, 5 of 540 blind seats); inductive including Qi2 15 W and Qi2 25W (a 10 mm coil offset holds 3 of 540 blind seats, and 15 W does not cover the awake-while-docked peak); a cradle or wedge (a low slope does not slide the foot, and a tall guide is a step the walk already trips on); springs in the mat (a field dense enough for the 3 mm wells is about 45,000 pins). The drawing is altaay_lab/cad/nest_v2/. The spring-pin CAD in twin/dock/nest/cad/ stays in the repo and is not the nest to build. Open BLOCKERs, not hardware passes: dirt on the gold (contact resistance unmeasured); the gate board, and a coin short across a live 5 mm gap once the field is on; charger heat at 2.30 W and 3.50 W (the thermal twin was not re-run at those watts); a real camera detector. Nothing in this decision was run on hardware. D61 is not edited. This entry supersedes the spring pins in D61. The sit, the wall, the camera, and the in-duck charger stay.
- D63 Castle CC BEC Pro set to 12.0 V on the 3S rail. Recorded 2026-11-13. Supersedes the 7.2 V set point of D3 for this rail, and supersedes the 16 V pass-through used in the first 3S walks (problems/sts12.py, problems/train_sts12.py, problems/retrain_sts12/eval_table.md). 16 V is outside the cited output range, 4.8 V to 12.5 V in POWER.md section 3 and 4.9 V to 12.5 V on the Castle chart (twin/battery/BATTERY_STUDY.md). 12.0 V is inside both. It is inside the C018 page range 4 V to 14 V and the Waveshare range 6 V to 12.6 V, and it equals the PDF line that prints 12.0 V as both minimum and maximum. The netlist pack domain is 9.0 V to 12.6 V (about 3.0 V to 4.2 V per cell). U3 VIN uses that domain. The old 7.2 V domain and the 16 V set point stay in the files, marked superseded. D61 was not edited. BLOCKER: Castle does not publish the minimum input or the behavior below the set point. A 3S pack is under 12 V for most of the discharge (full is 12.6 V, the domain floor is 9.0 V). With the 0.3 V dropout assumption, the sim regulates only when the BEC input is at least 12.3 V. Below that the sim follows the input minus 0.3 V. The real part might shut off. The bench sweep has to be run at 12.0 V before this is trusted on hardware. The netlist protection board is still the Tenergy 32175 2S part, and the netlist charger is still the 8.4 V 2S board. Neither covers 12.6 V. That remains the open item in problems/STS12.md. Nothing bought. No retrain. The check is altaay_lab/verify/check_power_limits.py. A power-design change has to pass it before a sim uses the change. The shared sim default in sim/power_path_sim.py stays 7.2 V so the two-cell runs still regulate. The 3S studies pass 12.0 V themselves. A 2S pack cannot hold 12 V.
- D64 Keep the Castle regulator. DECIDED by Ahmed 2026-11-13 10:18 PM ET. His words: "we definitely need regulator and all the nice stuff so we study it properly". The adopted servo rail keeps the Castle CC BEC Pro, part 010-0004-01, set to 12.0 V (D63), and a power-design change still has to pass verify/check_power_limits.py. The straight-wire ranking in problems/SYSTEM_VOLTAGE.md is a study result. It is not the rail to build. On that study the wire scored higher (sim pass only) because a 12.0 V Castle on this 3S pack is in dropout while walking: the regulator input stays under 12.3 V, which is 12.0 plus the 0.3 V dropout assumption. Open follow-up, not a part pick: find a regulator that holds a fixed servo voltage across the whole 3S discharge. The study list is a buck-boost, a lower set point such as 10 to 11 V, or a 4S pack with a buck. The 4S row in that same study already fails the bay, a cited 4S protection board, and the 15 V nest. D61 was not edited. Nothing bought. No retrain. The part on the rail is superseded by D65. This paragraph is kept as written.
- D65 Held 12.0 V servo rail on the 3S pack. Recorded 2026-11-14. Ahmed's D64 stands: the duck keeps a regulator. This entry picks the part that holds the voltage. The rail is the TDK-Lambda i7C2W020A120V-0F1-R, set to 12.0 V. It is a non-isolated buck-boost. Catalog output is 8 V to 24 V, so 12.0 V is inside it. Input operating range is 9 V to 36 V, which covers the pack domain 9.0 V to 12.6 V. Output tolerance is plus or minus 4 percent, so the servo domain is 11.52 V to 12.48 V, inside Waveshare 6 V to 12.6 V and the Feetech page 4 V to 14 V. At 12 V out the cited current is 16.5 A at 10 V in and 20 A from 12 V in up. Overcurrent threshold is 26 A typical. The walk peak in problems/retrain_sts12/eval_table_bec12.md is 15.837 A on the sequence row and 15.599 A at 0.40 m/s (sim pass only). 16.5 minus 15.837 is 0.663 A (calc only). Efficiency is cited as 94 to 97 percent. The sim uses 0.94, the low end of that band. Buy page, DigiKey, $86.34, 18 in stock, read 2026-11-14. Datasheet is the i7C catalog, 4 February 2025, V8. Heatsink outline 34 x 36.8 x 24.9 mm, 75 g. The Castle body in the mass model is 29 g, so this part is 46 g more (calc only). Not rejected: a buck set to 10 V or 11 V, because a buck cannot hold a voltage above its input, and the pack floor is 9.0 V. Stall at 12 V is 30 kg.cm. At 11 V that is 27.5 kg.cm and at 10 V it is 25.0 kg.cm (calc only, 30 times the voltage ratio). That option does not hold across the whole pack, so it is not the pick. Castle is not the pick: its datasheet does not show a fixed output from 9.0 V to 12.6 V, and it does not publish dropout. Vicor PI3740 is about 5 A to 7 A at 12 V, under the peak. The i7C 8 A and 12.5 A models are under the peak on the 12 V column. The protection board is BatterySpace PCM-L04S30-566: 30 A continuous discharge, 20 A charge, overcurrent 120 A to 160 A, overcharge 4.25 V plus or minus 0.025 V, loop at most 30 mohm, charge voltage 12.6 V on the spec page. Tenergy 32007 at 9 A working is not used, because a 16 A peak sits in its 13 A to 21 A trip band. The PCM is 60 x 60 x 5 mm. The measured slot is about 17.75 x 47.2 x 5.33 mm and cannot hold it. The pocket was redrawn on the rear face of print/body_back.stl (CAD check only): a boss 66 x 66 x 8 mm, a recess 61 x 61 x 6 mm, board center x -159.2, y 0, z 40 mm. The edited solid is watertight. The board box does not meet the plastic or the cell cylinders. Added plastic is 14387 mm3, about 18 g at 1.24 g per cm3 (CAD check only). The walk mass was not re-run. The charger in the netlist is the BQ24133 board. CELL tied to VREF regulates 12.6 V (cited). A 12.3 V number is not a pin setting. The Pi can end charge early at 12.3 V. That is software, not a second hardware set point. The pack bead reaches TS. Bias is 2.87 kOhm from VREF, and 12.7 kOhm to ground in parallel with the bead. Calc only, from the cited bead (31.77 kOhm at 0 C, 10 kOhm at 25 C, 2.472 kOhm at 60 C) and the cited TS window: the fraction is 0.760 at 0 C, 0.661 at 25 C, and 0.419 at 60 C. 0 C is above 0.745, so charge stops. 25 C is inside the window. 60 C is below 0.442, so charge stops. An open bead is 0.816 and stops. A short is 0 and stops. The limb breakers EFL, EFR, and EFN are in series with the live feeds: SP1 and SP4 leave EFL, SP2 and SP5 leave EFR, SP3 leaves EFN. The 16 AWG pack leads get an abrasion sleeve. A 1 ohm nick on that lead is still about 11.5 A, under the 15 A fuse and under the 120 A trip, so a current limit on the main lead cannot see it without also opening on the walk. The current table that was read starts at 10 V in, 16.5 A at 12 V out. No 9 V row was found. Turn-on is 9.5 V typical. Walking stops at 10.0 V pack, 3.33 V per cell, which is that first cited row. 16.5 A covers the 15.837 A peak by 0.663 A (calc only). Below 10.0 V the duck does not walk. Servo Present Voltage stays near 12 V while the regulator holds, so this cutoff is pack voltage, in the netlist and in bench/battery_guard.py. The Pi has no pack-voltage sensor, so reading that 10.0 V is still BLOCKER. BLOCKER still open: wider boost tolerance when the input is under 20 V and the power is over 100 W (that chart was not read), the TRIM ohm, the resistor order codes for 2.87 kOhm, 12.7 kOhm, and 8.25 kOhm, and the pack-voltage sensor. D61 was not edited. Nothing bought. No retrain. The check is verify/check_power_limits.py.
- D66 Run D is the twin's default walk. Recorded 2026-11-14. Run C stays in problems/retrain_sts12/ and is superseded as the current walk. The policy is sts12_runD_policy.onnx (sha256 7a0be46af5b8061ee7b85aaca4050772da4fbd29303fffad76a93d59225dfb1e, the file), the final 300,482,560 export, 101 in and 14 out. Rewards add knee_current -0.5 and pack_hinge -0.02 on top of run C. The 13 A hinge is a reward threshold. The fuse stays 15 A (cited). The model is the current mass rollup, 2.949 kg (CAD mass model), the held 12.0 V rail (cited), and a knee stop of 147 deg. `make twin` had been walking BEST_WALK_ONNX_2 because the walk set ODM_ONNX after parts_truth imported added_mass_sim. That import setdefaulted the stock file, and current_budget froze the path. The merged report's 30.07 walking minutes and 17.48 A pack peak are that stock policy and are superseded. This `make twin` rerun (sim pass only, twin/out/REPORT.md): 41.48 walking minutes, 0 rests, right knee 0.88 A RMS, knee peak 38.4 C, hottest reading left hip yaw 47.1 C, pack peak 13.81 A, 0.000 s at or above 15 A. That peak is under the 15 A fuse and under the cited 16.5 A regulator row at 10 V in. The policy loader recorded sts12_runD_policy.onnx on every call. Fold-to-sit from a walk and sit-to-stand are not trained. Camera docking is BLOCKER. No hardware. D61 was not edited. Nothing bought. The check is verify/check_power_limits.py.
