aaltaay/Open_Duck_Mini_v2/altaay_lab/STATE.md

# STATE

Last updated: 2026-11-11 7:38 PM ET (America/New_York) by the nest dock archive and handover job (branch claude/nest-dock-archive-handover; the Nest dock section below; the project is paused pending Ahmed). Before that: 2026-11-11 5:03 PM ET (America/New_York) by the nest dock decision job (D61, branch claude/nest-dock-d61). Before that: 2026-11-10 about 11:30 AM ET (America/New_York) by the get-up through the sit job (task 44, branch claude/getup-via-sit; the get-up notes below). Before that: 2026-11-04 about 5:40 PM ET (America/New_York) by the V1 electrical fixes track (track 1b, twin/electrical/fix, branch claude/v1-elec; the lead integrates). Before that: 2026-11-04 about 4:50 PM ET by the V1 electrical track (twin/electrical). Before that: 2026-11-03 about 10:40 PM ET by the twin wave 2 integration agent for the lead (the live twin, get-up, walking speed, human pace and wheels, the GPU retrain stage 0; branch claude/twin-wave2, the lead commits). Before that: 2026-11-03 about 5:00 PM ET by the structure twin integration agent (twin wave 1, the structure twin); 2026-11-03 about 4:00 PM ET by the twin integration agent (power and heat, plus the shared lab gym port); 2026-11-02 about 6:33 AM ET by agent SFX, the last fixes for PR 6. Each job has its own entry in history/.

Phase: digital twin first. Ahmed, 2026-11-03: nothing is printed until the full digital twin is done (physics, heat, strength, the real robot code against the twin, falls, get-up and dock in sim). Nothing bought, nothing printed.

## Nest dock (2026-11-11 ET, D61; twin/dock/nest/HANDOVER.md and README.md; sim pass only, calc only, CAD check only)
- PAUSED 2026-11-11 evening ET, pending Ahmed. The next agent starts at twin/dock/nest/HANDOVER.md (status, the ranked open problems, his standing rules).
- Decided by Ahmed (D61): the nest charging dock replaces the feet-contact dock (D58). A felt mat about 2 mm thick against the wall with a 10 cm golden cloth disc (plus) and a pale gold ring (minus); four spring pins under the body (2 in the seat block, 2 in the belly bumper, 130 mm apart; sim pass only); nothing in the feet. The duck walks on, turns 180 deg, sits facing the room with the torque off (D59), later stands and walks straight out. No tags: camera only (untested, BLOCKER).
- Status: concept decided; CAD drawn but NOT installed; nothing built, nothing bought, nothing on hardware. All the work is archived in twin/dock/nest/ (reports, figures, scripts, raw results, clips, the CAD). The scripts were moved from a working folder, syntax-checked and not re-run after the move.
- First sim of the whole sequence, steering walk-on (sim pass only; twin/dock/nest/sim/NEST_SIM.md; the pose is a stand-in, not a camera): the first sit ends charging in 93.1 % of 540 runs (503). 29 falls, all at 7.2 V, all while steering across the 2 mm mat edge. Landing window 45 mm radius (calc only).
- Re-run with "line up, then cross the edge straight" (sim pass only; twin/dock/nest/sim/v2/NEST_SIM_V2.md section 3; finished after D61 was written): the fix did NOT work overall. First sit 84.3 % (455 of 540) against 93.1 %; within 3 sits 91.3 % (493) against 94.1 % (508); falls 13 against 29. 6.0 V got worse (215 against 263 of 270 at the first sit, 3 falls where there were none); 7.2 V is the same at the first sit (240 of 270) and better within 3 sits (259 against 241). The 10 falls left at 7.2 V happen while walking straight, so the trips are not only a steering matter. It points to a walk retrain (toe lift over a small edge, a right side-step), which needs GPU spend and Ahmed's OK.
- D61's text is now partly contradicted and is kept as written: it names the straight crossing as the fix to try first with no result yet, and it quotes 80 of 80 straight crossings at 7.2 V (the larger samples give 5 falls in 180 walks and 10 in 270 runs, sim pass only). It also says there is no CAD yet. D61's "head 23.5 mm from the wall, a foot 9.5 mm from the rim" covered only the 511 runs that reached a sit; over all 540 runs of that controller the worst values are the same (23.5 mm and 9.5 mm, 0 runs inside the wall plane or the rim; sim pass only). A new decision entry by Ahmed settles this; D61 is not edited.
- Wall and rim with the straight crossing, all 540 runs (sim pass only; twin/dock/nest/sim/v2/NEST_SIM_V2.md section 3, corrected after a review finding): 9 runs had a part inside the wall plane or the rim (5 that reached a sit, by 0 to 4 mm; 3 fallen ducks; 1 that never sat, head 105.9 mm beyond the wall plane on its feet), against 0 of 540 with the steering walk-on. The first summaries counted only the runs that reached a sit (5); sim/analyze.py and sim/v2/compare.py are fixed and their summaries made again from the archived run files.
- CAD (twin/dock/nest/cad/NEST_CAD.md; CAD check only unless marked): the duck pins, the mat and the rim are drawn and checks A to H pass. Archived, NOT installed: print/, the URDF, the netlist, the BOM and the viewer still show the old wall and paddle dock. Ahmed was shown the renders and has NOT yet said the look is approved. The mat is about 47 cm across the ring (felt 451 x 534 mm); its edge is two 1 mm steps, not simulated yet; 14.4 g added to the duck (calc only). The spring pin part was chosen from search results only, data sheet unverified: BLOCKER.
- Electrical change, not designed yet: D50's four nets become two, awake while docked is kept, the MCP73213 charger moves into the duck (about 1.9 to 3.2 W of heat in the trunk, calc only; thermal twin not re-run, BLOCKER). The gate board in the rim is not designed.
- Open problems in rank order (detail in HANDOVER.md section 6): (1) Ahmed's approval of the CAD look; (2) mat edge trips and the untested ideas (a mixed controller, aiming 10 to 20 mm right at 7.2 V, the two 1 mm stepped edge or a tapered edge in sim, a walk retrain); (3) camera-only nest finding and sensing after the turn; (4) the pin data sheet and pin-on-cloth tests; (5) the electrical redo; (6) the head-to-wall margin and moving the sun from 190 to 215 mm; (7) landing the CAD and swapping the viewer's wall dock for the nest; (8) records that still mention the D58 foot pads (TEST_PLAN.md, twin/sit/SIT.md).
- Known script issues (twin/dock/nest/README.md): twin/sit/sit_sim.py and the nest's sit_contacts.py toggle floor contact at run time, which has no effect in MuJoCo 3.17 (the numbers this touches are not worked out: BLOCKER); the superseded feet harness had the mat in the world body, so its stagger numbers are off.
- Runner-up on record: the pond rug.

## V1 sit (2026-11-06 ET, twin/sit/SIT.md; D58 and D59; CAD check only, calc, sim pass only)
- The alert sit (A1b) is in the CAD: joggled shin sheets, shin spacer, the hip roll stop lug with its conformal TPU face, the neck stop block on trunk_top with its two TPU faces and a back foot, and the head hook on head_pitch_to_yaw with its 10 mm TPU face (round 2, 2026-11-10; the first pass's neck and head lugs are gone, the neck sheets are stock), TPU knee bumpers, ankle pads, hip pads, seat and belly bumper; the heel screw moved 20 mm; ranges knee 150, ankle -95, hip roll out 8, hip pitch back 75, neck +25, head -25 deg with software limits 3 deg inside (software/servo_limits.json) and a calibration procedure (software/CALIBRATION.md). Robot set 49 STLs, 68 parts; mass 2807.8 g.
- 2026-11-10 (round 2; calc, sim pass only, CAD check only): every stress row passes (sit_stress.json all_ok, shove, abuse and stall): the neck block's screws see 0.0 N (the pad load passes in front of the block's foot; TEST_PLAN.md 19.8 stays as a check), the head hook 2.90 and 1.84 against 1.5 at the free 12 N forward shove, the roll lug's pad 3.83 at service. Every sim run again on the round-2 model: stand-up 20 / 20 / 20 at 0 / 0.5 / 1.0 deg zero error and 20 / 20 / 19 on held-out seeds, push 0 falls (4 pads at the end in 16 of 17), walk 0.1004 against 0.1029 m/s with 0 falls, balance gate PASS (75.6 mm worst margin; with the torque off about 4.3 N forward at the head tips it). The sweep is clean (6 of 6 stops, path, walk and get-up states). Cables: the neck loops go round the block now; with the run lengths taken again from the points, the knee kit leads S5 and S10 and the ankle feeds SP4 and SP5 are 17 to 25 mm short of the slack rule (fit taut): BLOCKER until the test fit (twin/sit/SIT.md sections 6 and 8). Fall get-up on the real geometry is open (D60, SIT.md section 8).
- The feet-contact dock is decided (D58); the wall and paddle dock's CAD stays until the feet-dock CAD job. Note 2026-11-11: D58 is replaced by the nest dock (D61, section above); the wall and paddle dock's CAD now stays until the nest CAD job. BLOCKERs: unpowered servo friction, calibration repeatability, the joggled sheet coupon (TEST_PLAN.md 19).

## V1 freeze pass (2026-11-06 ET, twin/freeze/FREEZE.md; CAD check only, calc only, sim pass only)
- Mic seats now in print/head.stl (the ear mount unchanged); C1, C3 and E4 FAILs cleared at their cause; test order total $228.49 confirmed; speaker stand pilots coaxial (the 20.7 deg was a fit artefact).
- Added: touch (D51), speaker duct (D52), ears on hardware PWM (D53), cliff ToF (D54), being picked up (D55), one arbiter (D56), no colour eyes for now (D57). Wiring sheet 6 (touch and cliff). Nothing bought.

## Done (2026-11-01 evening into 2026-11-03)

- 2026-11-05 about 1:00 AM ET, V1 battery job (track 9; twin/battery/BATTERY_STUDY.md, BAY.md, CHARGE_INTERFACE.md; D44, D45; sim pass only, calc only, CAD check only): the DeWalt DCB200 is not a fit (3.0 Ah and 624 to 644 g, not 5 Ah and 500 g; only a belly seat works and the shins hit it at the hip yaw and roll range ends; the duck goes to 3.24 kg and walks at a third of the speed). The pack is now 2S1P Molicel P45B 21700 (D44), spot-welded, no holder: body_back's bay grown (2.25 to 9.65 mm walls, 0 overlap), lid, BMS and XT30 seats unchanged; +24.3 g, 2.72 kg, centre of mass 1.1 mm back; 21.6 to 32.4 Wh, about 39 walking minutes at 32 C (calc on the twin) against 24.6; falls, walk and get-ups as today. The P50B is the in-stock drop-in. No tool-free swap (D45).
- 2026-11-04 about 8:46 PM ET, V1 screws job phase 2 (twin/screws/SCREWS_TWIN.md, calc only, CAD check only; D36, D38): 342 to 317 fitted screws, 58 to 48 inserts, 16 to 8 washers (fasteners.json LEAVE OUT (D38 screw cut), BOM need counts, MOUNTING.md); body_front, body_middle_top and body_middle_bottom in print/ carry the tongue, groove, lips and ribs (coupons K1 to K4 proposed for S1, TEST_PLAN 14); Pi header on KK 254 plugs (X1), P13 service plug (X3a), WAGO splices G and VSW (X4); 10b NKK MB2011LS1W01-BB; Wera tools and the 1/16 in bit on tool lines T16 to T19. Build time (cited per operation times): fastening 0.81 to 0.73 h, cables 5.79 to 5.51 h; insert time BLOCKER.
- 2026-11-04 about 7:40 PM ET, V1 3D track phase 2 (twin/complete3d/COMPLETE3D.md section 9, CAD check only): the camera is seated on its measured pilots with 4 x M2x5 in pilots drilled to 4.5 mm (D34); D12 is the 300 mm flat strip, route 227.3 mm, 72.7 mm spare in one gentle loop (D34); new cable D13, the OFF wire (D30), cut 590 mm, check pass with notes; the D10 fan-out is drawn; SP1, SP2, SP4 and SP5 reach their splice bodies; the head_board ghost is gone; the viewer has an x-ray switch and part and cable labels; HARDWARE_AUDIT B60 to B64.
- V1 assembly, track 2 (2026-11-04, twin/assembly/ASSEMBLY_TWIN.md, CAD check and calc only): every part held (side lamp and BEC fixes, B55, B56); every one of the 286 driven screws reachable in BUILD_ORDER.md (0 violations; B53 drivers need Ahmed's OK, B54); battery and microSD service steps (B57, B58); mass recount (B59); D30 applied (Pololu 2813, NKK button in a printed plate, GPIO26 on OFF); D29 reverted (D33), only the viewer LED labels changed.
- Every-part BOM (BOM_FULL.md: 196 rows, 798 pieces, 0 needing action) and the cable-by-cable harness build sheet (HARNESS_BUILD.md).
- Mass budget: the build is 2.65 kg (2652.8 g; 2.77 kg before D22), 26 % over the trained 2.107 kg; the stock policy still walks it on flat ground, slower (sim pass only; the walks ran at 2.77 and 2.64 kg, and the print/MASS_STUDY.md (c) walk again at 2.65 kg).
- Sourcing pass: missing purchase lines and test equipment TE1 to TE4 (SOURCING_2026-11-02.md, BOM.md).
- Connectors, splices, solder joints and small parts in the 3D view (viewer/scene_extras.json, blueprint/).
- Fastener schedule: 317 screws to fit, 196 to buy, 48 inserts, 8 washers (D38 screw cut), two 0.3 mm under each eye screw (fasteners/; D19 to D21 and the D21 notes).
- Pi setup from a blank SD card, and bench scripts tested on a simulated servo bus (software/, bench/).
- Servo upgrade options in case the TO1 heat test fails (SERVO_UPGRADE_OPTIONS.md).
- Clean wiring sheets, one subsystem per sheet (wiring/sheets/).
- Verification matrix of every check that needs no robot (VERIFICATION.md, verify/).
- Every cable routed in 3D with seats, ties and joint loops (cables3d/).
- Light print profile: 128 g lighter, gated by light coupons in S1 (print/MASS_STUDY.md; D22).
- Power fix: second feeds SP4 and SP5 into both ankles, 3S pack held (sim/POWER_FIX.md; D23).
- Power path as wired is the checked case now (sim/POWER_PATH_SIM.md 'As built'; VERIFICATION.md E6, E6b, C7; sim pass only): D15 plus the D23 feeds with the netlist lengths. Nominal pack, our 2.65 kg build: ankles under 6 V 6.4 % of the walk (typical corner, gate 10 %) and 21.4 % (high-side); the knees and the head roll are now the lowest servos (right knee 9.8 %, typical); no servo under 4.5 V. Pololu 2815 at 99 % of its 6 A point (sim RMS 5.93 A; TEST_PLAN 4.2 heat check).
- Netlist final pass and final docs pass (agents NL1 and NL2, 12:44 and 1:17 AM ET).
- Eye screw stack coupon (agent PRT): coupon T1 clamps the real 5.6 mm stack, two 0.3 mm washers (BOM 17l) on the printed bulb T1b and head wall T1w (D21 note). S1 is now 17 coupons, 46.8 g PLA, 4.69 h. Every heat shrink sleeve is counted (34, by the BOM_FULL rule) and drawn; the 16 eye washers are drawn; C4 checks the kit counts per size.
- Walking voltage log on its own timer (agent SW): bench/power_log.py --walk reads every servo at a random time in each 27 ms slot, only inside the walk loop's own sleep, so no read delays a control write, and counts time under 6 V by phase of the 20 ms cycle for every servo (TEST_PLAN 9). 63 bench tests pass on the simulated bus.
- Cable retention, D25 (agent CAB): 75 tie points: 32 MB3A mounts (BOM 34), 23 Panduit ABM1M-AT-C mounts (new BOM 34b), 6 stock holes or slots, 3 drilled tie-hole pairs (print/PRINT_PLAN.md After printing step 5), 2 ties to an anchored neighbour cable and 9 bundle ties checked at the TEST_PLAN 1.4 test fit. All 43 joint loops meet 3 x OD in CAD; the made multi-wire cables are twisted; C3 passes.
- Integration pass (agent INT): the four jobs' texts in DECISIONS.md, TEST_PLAN.md, HARDWARE_AUDIT.md, BOM.md, print/PRINT_PLAN.md and the scripts; test order line TO17; scene extras, viewer data and BOM_FULL regenerated; the full verification run.
- Last fixes for PR 6 (agent SFX): sim/mass_budget.py re-run on today's netlist (2652.8 g) and the print/MASS_STUDY.md (c) walk re-run on that model (C8: the 15 N pushes run moved from 0.631 to 0.618, run-to-run noise; no falls, in the duck's training physics only: in the shared lab gym our build falls in that push series, see the twin and gym lines below); sim/POWER_PATH_SIM.md 'As built' and its figure re-run; TEST_PLAN 5 in three bands (lead decision L3); the cable check writes "test fit" for D12, S2 and S7 (they reach, but with less than the 40 mm slack) and "fail" only for a cable that cannot reach; viewer data and BOM_FULL rebuilt.
- Electromechanical twin (twin/electromech/ELECTROMECH_TWIN.md, 2026-11-03, sim pass only): the walk, the 14 servos (gain and torque limit from each servo's supply volts, BAM) and the as-built power path (the ngspice circuit, solved every 2 ms) with a 2S P30B pack from its data sheet and the D16 guard, in one closed loop. At 7.4 V it is the trained robot exactly; the network matches ngspice within 3.8 mV. The sag slows the walk: at a nominal pack our build walks at 79 % (typical) to 76 % (high-side) of its trained speed (backlash model). No fall in 85 closed-loop runs, but only in the duck's training physics (2 ms Euler, Newton with 1 iteration, pyramidal cone, floor friction 0.6); in the shared lab gym (overlay gym/overlays/duck: 1 ms, implicitfast, elliptic cone with impratio 5, floor friction 1.0) our build falls in the 15 N push series in 6 of 6 seeds, with no supply sag (history/2026-11-03_1524_duck_gym_overlay.md): the push result is marginal, not a margin. From a full charge the walk falls under 85 % of its full-charge speed at minute 14 to 17, before the D16 walk stop (minute 18 to 30).
- Thermal twin (twin/thermal/THERMAL_TWIN.md, 2026-11-03, sim pass only): with the stock walk on our 2.65 kg build, the hotter knee reaches the STS3215's 70 C torque cut after about 10 minutes of continuous walking (plain sim model) or 4 minutes (backlash model) at a 25 C room, 7 and 3 minutes at 32 C; stand and walk 50/50 (plain model) peaks at 61 to 68 C and 25/75 at 50 to 66 C with no cut, while the backlash 50/50 cuts after 8 to 13 minutes. A thermal guard with rests prevents every cut in sim (central set). Confidence medium that continuous walking cuts within a charge, low on the minutes: the STS3215 thermal data are still a BLOCKER (B36; TO1 measures them, TEST_PLAN 7.3). Trunk while walking 6 to 9 W; at the battery stop trunk air 38 to 48 C, cells 44 to 56 C, CC BEC Pro case 98 to 122 C at the assumed 85 % efficiency (B37). The knee-to-ankle sheets see 54 to 66 C in continuous and 50/50 walking (PLA HDT 49 to 57 C; B38).
- Duck port to the shared lab gym (overlay gym/overlays/duck, 2026-11-03, sim pass only; history/2026-11-03_1524_duck_gym_overlay.md): an independent copy of the control loop gives this repo's numbers to the digit on the Playground scene (VERIFICATION.md C8, sim/ADDED_MASS_SIM.md tables 1 and 2). The side step finding and the push result depend on the 2 ms, 1 iteration training numerics (sim/ADDED_MASS_SIM.md and VERIFICATION.md C8 notes of 2026-11-03).
- Structure twin (twin/structure/STRUCTURE_TWIN.md, 2026-11-03, sim pass only, FEA pass only; history/2026-11-03_1640_twin_structure.md): loads at all 14 joints of our 2.65 kg build from 16 walking runs, 100 single pushes and the 15 N push series with converged contact forces (30 Newton iterations), 10 falls over a range of contact stiffness, FEA of the seven leg and neck stages (roll_to_pitch to mesh level 3, the shin to level 2), the horn and case screws and the inserts, fatigue on two cited bounds and the hot case from the thermal twin; a weak list and proposals P1 to P8, none decided (HARDWARE_AUDIT.md B42 to B46, DECISIONS.md D26). With converged contact forces our build falls in 4 of 4 runs of the 15 N push case (sim/ADDED_MASS_SIM.md note of 2026-11-03).
- Get-up after falls (lab requirement 2), scripted, sim pass only (the shared lab gym (overlay gym/overlays/duck), getup/GETUP.md, 2026-11-03): in sim the duck gets up by itself from most falls, with its 14 joints and inside the STS3215 limits; not yet from falls that end head down on a down ramp. 74 rest poses from falls in gym runs: back 53 %, side 23 %, front 24 %. Scripted programs found by search: from the back the legs fold into a backward bridge (hips -68 deg, knees bent backward -88 deg) with a fast throw, the robot stands on its feet lying back and rises; side and front falls first roll onto the back with a fast head-yaw swing. Our 2.65 kg build: back 114 of 114 and side 60 of 60 (7.2 and 6.0 V, floor friction 0.6 to 1.0); front 22 of 54: 16 of 18 on a flat floor, 6 of 36 on down ramps. Trained mass: back 103 of 120, side 34 of 42, front 25 of 54. Upright 10.3 s (back), 11.8 s (side), 13.5 s (front) after the program starts. No servo over 2.0 A for more than 0.19 s or over 80 % duty for more than 0.50 s (the Feetech protections need 2 s); a get-up warms a cold knee by 0.5 C (thermal twin). Torque is not the limit (holding any pose on the way needs at most 44 % of the servo limit at 7.2 V, 53 % at 6.0 V); balance is, so each get-up is a dynamic throw. The real joint stops are a BLOCKER (GAPS.md B6 note). Nothing ran on hardware.
  Note 2026-11-07 ET (fall get-up retest, sim pass only; twin/sit/getup/GETUP_SIT.md): the earlier sim results used the sim model's +-90 deg knee and ankle ranges, which the printed parts cannot reach (the CAD contacts are knee -28.5, ankle +49.5, head yaw -108/+82, neck +37.5 deg; the stored programs need knee -88, ankle +80.7, neck +61 and head -43). With the CAD contacts as limits the base raises 0 of 296 cases (254 of 296 on the sim ranges) and the sit model 0 of 296 (its own new limits are the neck +25 and head -25 stops). Get-up after falls on the real geometry is open; D60 (2026-11-07): it will go through the sit (roll onto the belly, tuck into the sit, the sit's stand-up), searched first, else trained in the walk retrain.
  Note 2026-11-10 ET (get-up through the sit, D60, sim pass only; twin/sit/getup/GETUP_VIA_SIT.md and VIA_SIT_EVAL.md): the search's program (roll onto the belly, a flat-foot sit-up into the sit, the sit's own stand-up) is a get-up family of the shared lab gym (overlay gym/overlays/duck) now and was run again on the merged sit model (aad3a9a): 248 of 296, the same as the search case by case (back 156 of 156, side 68 of 68, front 24 of 72). Every front rest on a down ramp (48) still fails at the tuck: training (track 10). Hip pitch at its torque limit for up to 1.08 s in the sit-up, no servo over a Feetech protection line for its 2 s (calc only); every pose inside the stops (0.30 deg of give at most) and the neck and head rule of SIT.md section 3. Not run on hardware (TEST_PLAN.md 19.9).
- V1 electrical twin (twin/electrical/ELECTRICAL_TWIN.md, 2026-11-04, sim pass only and calc only; history/2026-11-04_1647_v1_electrical.md): 38 falls of the collision duck, the 3 scripted get-ups and the walk in the shared lab gym (overlay gym/overlays/duck) replayed through the as-built power network with the P30B pack. Nothing fails. RISK: a 60 N shove to the left of the standing duck makes the pack draw 19.5 to 20.6 A, over 17 A for 4 to 13 ms (6 of 6 seeds), inside the Tenergy 32175 band (22 +/- 5 A after 8 +/- 4 ms), so a low-band board switches the duck off until the panel switch is cycled; fix ($0): TEST_PLAN 3.3 pass line, trip at 21 A or more (0 of 41 events trip a 20 A board). RISK: left switched on after the guard's battery poweroff, the duck still draws 0.11 to 0.41 A and takes its cells below the P30B 2.5 V minimum in 1.2 to 4.4 hours (calc only); fix: the TEST_PLAN 11 switch-off rule and a measurement. OK: no net regeneration in walking or any fall (only the later get-up throw, -4.06 W, 0.026 J); the data ground at the far knee and ankle 0.10 V walking (typical), 0.21 V high-side, against the adapter's 0.8 V VIL. BLOCKERs B47 to B49 (HARDWARE_AUDIT.md section 6).
- V1 electrical fixes, track 1b (twin/electrical/ELECTRICAL_TWIN.md section Track 1b fixes, 2026-11-04, sim pass only and calc only; history/2026-11-04_1740_v1_elec_fixes.md): B47 fixed in the twin by a target guard for the walk loop (twin/electrical/fix/bus_budget.py: the training's own target clip, commented out in the runtime, plus a 10 A servo bus budget; no register change), with the same falls and the same walk; two twin corrections (the runtime's real gains P 30 / P 8, and the policy left running on the floor); B49 has no $0 fix (a part for Ahmed's OK, the Pololu 2813); B48 bounded with a ready soft start; the head roll data ground is fine with the real gains; software I2C for the BNO055 by default; new B50 to B52. Track 3 runs the guard in the real code.
- GPU retrain of the current duck, stage 0: ready and tested on CPU, not run (train/TRAIN.md in the shared lab gym (overlay gym/overlays/duck), 2026-11-03, sim pass only). A training overlay on the upstream Open_Duck_Playground pin b9be205 with our mass, the friction fix, the gym's contact physics at 2 ms (it matches 1 ms in the CPU check), voltage-scaled servos, pushes, terrain and a knee heat cost; a RunPod launcher with a spend ledger that refuses any run that would pass $18, under the $20 cap. Ahmed approved the RunPod spend on 2026-11-03, capped at $20 (the lead's record; DECISIONS.md does not carry his words yet). Nothing ran on a GPU and nothing was spent: the environment has no RunPod key yet. The speed study puts the forward command range at up to about 0.35 m/s on this hardware, but above 0.2 m/s every gait shown runs at the servos' limit and cuts the knee within 4 to 7 minutes (walking speed line below).

## Decisions
D1 to D25 are in DECISIONS.md, all decided (D14 superseded by D15). Tonight: D19 button heads at the hip pitch, D20 drill the neck recesses, D21 eye screw washers, D22 light print profile, D23 ankle feeds with the 3S pack held, D24 drill the projector lead hole, D25 cable retention, joint loops, twist and the camera cable. Lead decisions under Ahmed's delegation: L1, TEST_PLAN 9 times every servo, none under 6.0 V for more than 10 % of the walk at a nominal pack (D23 note); L2, the BelMetric lines 17j to 17l join the test order as one order, TO17, so coupon T1 has its washers (D21 note); L3, TEST_PLAN 5 hop bands per conductor: pass up to 28 mOhm, warn over 28 up to 40 mOhm (the walking log decides and the 3S plan is made ready for Ahmed), fail over 40 mOhm (D23 note).

## Numbers now
- Assembly (2026-11-04, V1 track 2): 286 screws driven (342 fitted less 56 factory; 261 after the D38 cut, BUILD_ORDER.md not yet regenerated), 115 reachable with everything in place, all 286 in BUILD_ORDER.md; mass 2654.7 g counted, up to 2686.2 g with the tie upper bound (+1.26 %), tie mounts not published; side lamp tape SF 3.5, BEC with its tie SF 4.2 (mid fall).
- Print package (print/PRINT_PLAN.md, PrusaSlicer 2.7.2 estimates, D22 profile): coupon session S1 46.8 g PLA and S2 17.6 g TPU; the full print on a 220 bed 18 jobs, 1360.4 g PLA, 17.6 g TPU, 119.9 h; with the coupons 1407.2 g PLA, 35.1 g TPU, 126.9 h.
- Mass: 2.72 kg by sim/MASS_BUDGET.md (2720.1 g with the STS3250 knees, D32, roll_to_pitch at 3 walls, D38, and the 2S1P P45B pack, D44; not weighed).
- Fasteners: 317 screws to fit, 196 to buy, 48 inserts, 8 washers (D38 screw cut). Heat shrink: 34 sleeves.
- Tie points (D25): 75, as listed above.
- BOM.md, item prices without shipping: build total $1,303.35, with the expression parts $1,432.49, with tools $1,704.15 (D65 replaced the Castle and the 2S board; before that build total $1,258.70, with the expression parts $1,387.84, with tools $1,659.50 (the full dock job of 2026-11-06 adds +$67.20 on DK1 and DK5, priced at last; the V1 freeze of 2026-11-06 ET adds the cliff ToF, line 5b, +$14.95 (D54), and in the expression part the two touch boards E9, +$15.90, and the copper foil E10, +$19.95 (D51); before that $1,176.55, $1,269.84 and $1,541.50; D50 adds DK6 and DK7, +$8.74; before that, V1 track 8 adds the duck side of the dock, lines DK1 to DK5, +$12.41 with two lines priced BLOCKER; before that $1,155.40 after D44, when the totals were re-run 2026-11-05: they were stale at $1,146.28 before; the line items gave $1,163.39); test order $228.49 (17 lines).
- Power path as built (sim pass only): see the line above. TEST_PLAN 5 hop bands (L3): pass up to 28 mOhm per conductor (in sim every servo then meets section 9: right knee 9.9 % at 28 mOhm, 10.2 % at 29), warn up to 40 mOhm (right knee 13.4 %, ankles 8.0 % at 40 mOhm), fail over 40 mOhm.
- Twin (sim pass only): backlash walk, share of the trained speed at full / nominal / near D16: 93 / 79 / 76 % (typical), 91 / 76 / 68 % (high-side). Closed-loop knee time under 6.0 V at nominal 4 to 5 % (typical) and 27 to 30 % (high-side), against 11 to 14 % and 33 to 34 % in the open-loop replay with the same pack. Knee to the 70 C cut, central, 25 C room, continuous walking: about 10 minutes (plain model), 4 minutes (backlash model).
- Live twin in the shared lab gym (overlay gym/overlays/duck, twin_live/TWIN_LIVE.md, 2026-11-03): the walk, the 14 servos, the as-built power path, the P30B pack and the heat in one loop on the gym physics (the walk and the power path every 1 ms, the heat in 0.5 s steps), our 2.65 kg build, from a full charge (sim pass only). Continuous walking reaches the STS3215's 70 C cut after about 16 minutes (plain model) and 8 minutes (backlash model) of walking at a 25 C room, 10 and 5.5 minutes at 32 C, and the duck falls each time. That is later than the heat twin's 10 and 4 minutes at 25 C, mainly because a hot winding has more resistance and draws less current (with the resistance held cold the live twin gives 9.1 and 4.7 minutes). With bench/walk_with_guard.py and the heat twin's rest rule (rest standing, torque on, at 55 C; walk again at 45 C) no session fell, but a charge of continuous walking gives 12.8 / 8.1 walking minutes at 25 C and 3.6 / 2.4 at 32 C (plain / backlash): at 32 C the standing knee settles at 48 to 50 C, so the first rest lasts until the pack is empty. Stand and walk 50/50 does not cut at 25 C (17.6 / 13.7 walking minutes per charge, no guard) and 25/75 does not cut at either room; at 32 C the backlash-model 50/50 falls from weak knees (hot windings and sag) after 11.9 walking minutes without a guard, and walks 2.5 minutes with it (plain 3.8). Best $0 lever: torque-off rests on a stand (19.1 walking minutes at 25 C, 15.4 at 32 C, plain model; no stand is chosen or sourced). The pack lasts 27 to 60 minutes of session time (walking 4.1 to 4.7 A in the plain model, 5.4 to 5.7 A in the backlash model; standing 2.0 to 2.2 A).
- Terrain (the shared lab gym, overlay gym/overlays/duck: 1 ms, implicitfast, elliptic cone, floor friction 1.0, the trained servos with no supply sag, 5 seeds per course and mass; sim pass only): the stock policy walks only on flat ground. It fails every up ramp, even 5 deg (0 of 40), and the down ramps from 10 deg (0 of 30; 5 deg down passes 10 of 10), and it stubs its toe and falls at the 13 mm threshold (0 of 10) and the 50 mm bump (0 of 10). Our build also trips on a 3 mm edge (0 of 5; the trained mass passes 5 of 5): its median swing peak is 9.7 to 10.0 mm against 12.7 to 13.8 mm at the trained mass. Low friction (mu 0.30) and the friction patches pass (one fall of our build at the 3 mm patch edge), ice (mu 0.10) passes 3 of 5 for each mass at about half speed, and walking to a dock target works 10 of 10 (no docking scored). Terrain needs a policy trained on terrain: a training job, not a fix in the sim.
- Structure twin (2026-11-03, sim pass only, FEA pass only): walking on a flat floor at room temperature, roll_to_pitch (SF 1.48 to 1.63) and the knee sheet eye of the shin (1.63) are under the lab margin of 2; in push recovery 1.08 to 1.21 and 1.07; at 50 C about 1.0 walking. Even the soft fall contact level puts roll_to_pitch (7 to 8 of 10 falls), the neck sheets (9 of 10) and head_roll_mount (5 of 10) under the 1.2 fall margin. Screws and inserts hold walking except the left ankle servo case screws (SF 1.6); fatigue life unknown (B44). Proposals and bench checks in twin/structure/STRUCTURE_TWIN.md section 6, nothing decided (D26).
- V1 electrical twin (twin/electrical/ELECTRICAL_TWIN.md, 2026-11-04, sim pass only): pack current, worst event: walking 8.6 A, get-up throws 11.8 A, 40 N walking pushes 13.2 A (up to 22.6 A for at most 1 ms with the policy running on the floor), the 60 N left shove of the standing duck 20.6 A peak, held 19.8 A for 4 ms and 17.4 A for 12 ms; net servo bus power never negative in walking or falls; data ground offset at the far servo, walking: knees 0.10 V and ankles 0.07 V (typical), head roll 0.15 V (typical) and 0.38 V (high-side), falls at the 40 mOhm hop limit 0.52 V, all under the adapter's 0.8 V VIL; after the guard's poweroff 0.11 to 0.41 A (calc only).
- V1 electrical fixes (2026-11-04, sim pass only): with the runtime's real gains and the policy left running on the floor, the pack held 18.60 A for 4 ms before the fix (10 of 36 replays trip a 17 A board); with the target guard the worst is 15.89 A (floor, half charge), 13.61 A with the fall hold, 0 trips in 252 replays; walk 1.353 m in 20 s either way; head roll data ground 0.075 V at the 40 mOhm hop limit in the shoves, 0.125 V with the policy on the floor (0.8 V threshold; track 1 had 0.527 V); off drain with the Pololu 2813 (if approved) under 10.2 uA, more than 5 years to 2.5 V (calc only).
- Walking speed (speed/SPEED.md in the shared lab gym (overlay gym/overlays/duck), 2026-11-03, sim pass only: 1 ms, implicitfast, elliptic cone, floor friction 1.0, this repo's STS3215 twin model at 7.2 V and 6.0 V; our 2.65 kg build unless noted). Today the stock policy walks 0.097 m/s at its trained 0.15 m/s command with the servo model at 7.4 V (0.091 m/s at 7.2 V); at a 0.4 m/s command and 7.2 V it reaches 0.19 m/s (0.20 m/s at the trained mass), and it falls from 0.45 (at 6.0 V from 0.3). Walks planned by the upstream reference motion generator stay inside the servos' torque-speed limits at every 1 ms sample only up to 0.12 m/s at 7.2 V and 0.10 m/s at 6.0 V, on a 0.12 m stance (on the upstream 0.16 m stance none fits at any speed); the swing hip pitch and then the knee limit them, mostly through the servo's own geared rotor (1:345). Closed-loop gaits searched with CMA-ES on the stock policy's own cycle with an IMU balance loop walk 20 s on 5 of 5 seeds at 0.36 m/s at 7.2 V and 0.34 m/s at 6.0 V (each searched at its voltage), with the most loaded servos at their force limit 22 to 34 % of the time, so no reserve for pushes or slopes; the searches were still gaining when they stopped, so these are speeds shown, not a ceiling. At 0.36 m/s the thermal twin (central corner) puts the knee's 70 C cut at 3.7 minutes of continuous walking in a 25 C room and the D16 battery stop at 14 minutes. Human pace is out of reach for this leg and servo: a dynamically similar walk is 0.6 to 0.7 m/s, and 1.3 m/s would be a run. BLOCKER: the servo's torque and rotor inertia on our own units (the C001 data sheet is weaker than the sim model; Blockers below).
- Human pace on legs (Ahmed's question of 2026-11-03: can the duck walk at a human pace, so we can take it outside? human_pace/HARDWARE_OPTIONS.md in the shared lab gym, overlay gym/overlays/duck; model bounds, sim pass only). Walking at about 1.3 m/s is impossible at this size: it is Froude number 1.08 on the 160 mm crouch hip height (0.88 on the 196 mm straight leg), past the walk-to-run change near 0.5, so it would be a run. The best same-size bus servos (C044 at 7.2 V, STS3250 at 12 V) give about 0.2 to 0.45 m/s with a retrain (model bound with an 80 % torque margin; none reaches 0.6 m/s). 0.6 m/s needs small brushless CAN joints on new legs (+1.5 to 2.7 kg; joint bound 0.7 to 1.25 m/s, capped near 0.88 m/s by the Froude number) or a 1.5x duck (about 63 cm, 12 kg). 1.3 m/s walking needs a duck about twice the size (about 84 cm, 25 kg; model bound), which would likely lose the stair exemption (Ahmed decides). Nothing bought.
- Human pace on wheels (wheels/WHEELS.md in the shared lab gym, overlay gym/overlays/duck, 2026-11-03, sim pass only): on wheels the duck holds 1.3 m/s at today's size in sim. Best option: powered heel wheels (2 LKMTECH MF5015-V2 hub motors, 90 mm wheels, a 12 V boost; about +400 g and $272 of parts; a wheel motor already used elsewhere in the lab, a candidate for Ahmed, not a decision). It still walks on its soles indoors with the stock policy (0.086 m/s against 0.096 m/s without wheels, 0 falls in 3 runs), and outdoors raises its toes 60 deg and balances on the heel wheels: 1.3 m/s on flat (top 5 m/s), ramps 5 to 20 deg up and down 24 of 24, 15 N pushes cruising and standing, doorway thresholds of 13 to 25 mm at 0.6 m/s (not at 1.3 m/s on the 12 V boost), 10 mm gravel and loose pebbles; 58 to 94 minutes of rolling at 1.3 m/s on pavement per charge. Limits: square edges only to about 15 mm, no curbs (the legs cannot hop), the park tier's roots, rocks, 51 mm steps and 51 mm water bars fail, a 15 mm washboard topples it, grass is a BLOCKER (no surface model), and rolling back to walking falls 5 of 5 (walking to rolling works 5 of 5). Nothing bought; the motor's data sheet, driver input range and warranty are BLOCKERs (Chinese, single source, the US listing backordered).

## Blockers and checks
- 2026-11-05 V1 knee swap (D32, twin/knee/KNEE_TWIN.md, sim pass only): B70 to B73 new. RISK B70: on STS3250 knees the stock policy walks a third to two fifths as fast and falls in 4 of 5 backlash sessions (the knee damping of the published torque-speed line, 1.00 against 0.56 Nm s/rad); fix: the run2_sts3250 retrain after a bench BAM test of one STS3250 (TEST_PLAN 15). Heat is fixed (no knee cut, 47 to 63 C) and the 1b guard still gives 0 trips at 17 A with knee_budget.py (B72). BLOCKERs: the bench BAM test at 7.2 V, register 15 and the 7.2 V operation, the STS3250 heat values, the factory registers 19, 21, 22, 28 and the model number, the M2 thread depth.
- 2026-11-04 V1 3D track: 26 of the then 64 rows cleared or decided; B60 to B64 new (HARDWARE_AUDIT.md).
- 2026-11-04 V1 track 2: 22 of the then 59 rows cleared or decided; B53 to B59 new (HARDWARE_AUDIT.md).
- Blockers: 30 of 73 cleared or decided, 7 waiting on the parts check, 7 settled by the coupon test prints, 22 assembly or bench checks, 1 for Ahmed to decide later (B45, the floor of the first walks). None blocks the coupon print; B38 comes before the full print, B42 and B43 before the right leg prints (HARDWARE_AUDIT.md section 6). B42 to B46 come from the structure twin (FEA pass only; the structure line above). B47 to B49 come from the V1 electrical twin (sim pass only and calc only; the V1 electrical line in Done): the BMS trip current, power-on inrush and the drain after the guard's poweroff, all bench checks. B50 to B52 come from the V1 electrical fixes (track 1b): the servo gains in the twin, the restart after a power loss, and the IMU on software I2C, all bench checks; B47 is fixed in the twin (target guard, track 3 runs it in the real code), B49 needs a part for Ahmed's OK (Pololu 2813, $8.95).
- Twin and gym BLOCKERs (HARDWARE_AUDIT.md B36 to B41, sim pass only): the STS3215 thermal data (B36, TEST_PLAN 7.3); the CC BEC Pro efficiency, dropout and minimum input (B37, TEST_PLAN 4.1); PLA at the hot parts (B38); whether the Feetech firmware compensates for its bus volts, not published: in sim it moves the nominal-pack walk from 0.706 to 0.859 of the command, 95 % of the trained speed (B39, proposed bench test TEST_PLAN 7.5); the Pi Zero 2 W chip rise over the head air (B40, the walking log); the real sole-to-floor friction, which the policy only saw at 0.6 and the gym runs at 1.0 (B41). The twin's own open items: the real hop and holder resistance (TEST_PLAN 5 and 3.2), and the real servos tracking worse than the sim servo in upstream issue #48 (UPSTREAM_ISSUES.md G1: hip pitch, knee and ankle track 31 to 49 % in the partly read thread; our question is posted there, no maintainer reply seen, DECISIONS.md D1).
- The sim servo may be stronger than the real one: every twin and gym result uses the BAM fit of the STS3215 (3.23 Nm at 7.4 V), while the C001 data sheet gives 1.91 Nm stall (19.5 kg.cm) at 7.4 V (SERVO_UPGRADE_OPTIONS.md), and upstream issue 48 (UPSTREAM_ISSUES.md G1) reports real servos tracking worse than the sim servo. Its rotor inertia (armature 0.027 kg m2 in the model) has never been measured on our units. A weaker real servo lowers every speed of the walking speed line (speed/SPEED.md section 6; sim pass only). TO1 (TEST_PLAN 7.3) measures the servo; a step-response test of one knee on the bench would measure the armature.
- BLOCKERs from twin wave 2 (sim pass only; not numbered in HARDWARE_AUDIT.md section 6 yet, so not in the counts above): how the STS3215 releases its 70 C cut and its overload action with register 19 = 44 (the live twin assumes the torque comes back at 70 C with no hysteresis, and 20 % torque on overload; TEST_PLAN 7.3 item 3 logs the release); the real knee and hip stops the scripted get-up uses (GAPS.md B6 note); for the heel wheels, grass (no surface model), the MF5015-V2 data sheet, driver input range and warranty, and the roll-to-walk switch; for the GPU retrain, the RunPod key and whether a pod can terminate itself (checked on the first pod).
- Verification re-run in full 2026-11-03, 3:47 to 3:59 PM ET, after the twin integration (history/2026-11-03_1601_twin_integration.md): the same result, 22 PASS, 0 FAIL, 0 NOT RUN and the same 21 WARN findings, so VERIFICATION.md stays the 2026-11-02 page, with a dated C8 note added by hand (the gym result).
- Verification re-run in full 2026-11-03, 5:01 to 5:14 PM ET, after the structure integration (history/2026-11-03_1716_twin_structure_integration.md): the same result, 22 PASS, 0 FAIL, 0 NOT RUN and the same 21 WARN findings; C9 reads 46 rows with 0 disagreements.
- Verification re-run in full 2026-11-03, 10:42 to 10:53 PM ET, after the twin wave 2 integration (history/2026-11-03_2257_twin_wave2_integration.md): the same result, 22 PASS, 0 FAIL, 0 NOT RUN and the same 21 WARN findings (C9's WARN on the dated decision range in GAPS.md now points at line 67, two lines lower); E8 63 tests pass; C9 reads 46 rows with 0 disagreements. VERIFICATION.md stays the committed page.
- Verification (VERIFICATION.md, full run 2026-11-02 6:19 to 6:32 AM ET): 22 checks, 22 PASS, 0 FAIL, 0 NOT RUN (0 FAIL and 21 WARN findings: risks, test fits and notes to measure on the bench). The integration run's 2 FAILs are closed without loosening a check: C8 now compares with the (c) walk re-run on today's model, and E6b checks the TEST_PLAN 5 pass gate of 28 mOhm per conductor (every servo within the section 9 gates in sim) and warns at the 40 mOhm warn limit (right knee 13.4 %). E8: 63 bench tests pass; C3 passes (D12, S2 and S7 test fits are WARN); C9 finds 0 disagreements (4 WARN, all from before). Sim and test pass only; nothing has run on real parts.
- 3D view data (viewer/make_viewer_data.py --write-bom, run of 11:08 UTC): 62 cable runs, 59 pass, 3 test fit (D12, S2, S7), 0 fail; printed parts 52/52, servos 14/14, inserts 48/48, bearings 3/3; 317 screws (since D38 the viewer draws only fitted screws: 38 left out or not fitted rows skipped; XT30 pairs 2 of 2, line 12); BOM_FULL 196 rows. The page reads "test fit" with the changed page copy the lead publishes.

## Open questions for Ahmed (one at a time, most important first)
- 2026-11-04 V1 track 2: question 7 was answered yes (D30, relayed by the lead at 5:58 PM ET). New: OK to buy the three Wera drivers for the 95 cross-head screws ($19.62, BOM.md "Needs Ahmed's OK", B53)?
1. Asked 2026-11-03, approved by Ahmed the same day ("go ahead and do a run pod", for training the current model), capped at $20 as asked: rented GPU time (RunPod) to train a walk policy at our real mass and on small terrain, and a get-up policy. Waiting for the RunPod key: the environment has none, so nothing ran on a GPU and nothing was spent; stage 0 is ready and tested on CPU (Done above; sim pass only). The stock policy walks on flat ground only in the shared lab gym (overlay gym/overlays/duck); this box has no GPU. (lab rule 7)
2. On hold until the twin is done (Ahmed, 2026-11-03): OK to start the coupon print session? S1: 17 coupons, 46.8 g PLA, 4.69 h. S2: one TPU sole, 17.6 g, 2.19 h (print/PRINT_PLAN.md; lab rule 4).
3. OK to buy the test order (BOM.md "Needs test order", 17 lines, $228.49)? (lab rule 7; it was $231.50 before D34 moved TO9 to the $2.94 300 mm cable)
4. Which printer will print the duck? The package needs a bed of at least 220 x 220 mm.
5. Before the right leg prints: DECISIONS.md D26 (roll_to_pitch and the knee sheet eye, HARDWARE_AUDIT B42 and B43), and the floor for the first walks (B45).
6. Asked 2026-11-03: keep developing the heel-wheel version in sim (the roll-to-walk switch, the wheel mounts)? (the human pace on wheels line above; sim pass only) ANSWERED 2026-11-04 about 4:08 PM ET: no wheels in V1 ("forget about the wheel"), DECISIONS.md D27.
7. Asked 2026-11-04: OK to swap the main switch to the Pololu 2813 pushbutton power switch ($8.95, https://www.pololu.com/product/2813) with a momentary button in body_back, so the Pi can switch the duck fully off after the battery hard stop (HARDWARE_AUDIT B49; twin/electrical/ELECTRICAL_TWIN.md, Track 1b fixes)? Nothing is bought until he says yes. ANSWERED 2026-11-04 5:58 PM ET: yes ("yes, swap to the 2813"), DECISIONS.md D30.
8. Asked 2026-11-04: OK to add three Wera cross-head screwdrivers to the tools (PH0 x 60 $7.91, PH1 x 80 $9.76, a PH0 x 25 bit $1.95; links in BOM.md)? The BOM had no tool for the 95 cross-head screws (twin/assembly/ASSEMBLY_TWIN.md). Nothing is bought until he says yes. ANSWERED 2026-11-04 7:47 PM ET: yes ("yes, add all of them to the parts list"), DECISIONS.md D36.
10. Asked 2026-11-06 (V1 freeze, D53): the ears on hardware PWM need the Runtime's antennas.py to write the PWM channels instead of Blinka software PWM; D6 keeps the Runtime unmodified. OK to change that one file? (software/PI_SETUP.md 4c)
11. Asked 2026-11-06 (V1 freeze, D54): the cliff sensor sits 165 mm above the floor (window centre 150 mm), not the study's 140 mm, so the cone clears the chest's bottom rim; its floor spot is 93 to 178 mm ahead of the toe. OK as is? (twin/freeze/FREEZE.md)
9. For when the duck resumes (Ahmed paused it 2026-11-04, D38): OK to buy one STS3250 ($73.99, OpenELAB) for the bench BAM test that the knee retrain needs (D32, twin/knee/KNEE_TWIN.md)? Nothing is bought until he says yes.

## Next
1. Coupon session; results into history/.
2. Test order: TEST_PLAN.md sections 1 to 7 (cables, battery and BMS, BEC dropout, Pololu 2815 heat, 5 V regulator, one servo with register 85, firmware and the thermal hold, Kelvin hop: pass up to 28 mOhm, warn up to 40, fail over 40).
3. First leg print and its checks (D18, D19, the B33 foot_side fit), then the other plates: the full print on a 220 bed is 18 jobs, 1360.4 g PLA, 17.6 g TPU, 119.9 h (with the coupons 1407.2 g PLA, 126.9 h). After printing, the drill steps: the D20 recesses, the D24 projector hole and the 3 D25 tie-hole pairs (print/PRINT_PLAN.md). Then the freeze tag.
4. Harness build and the test fit: TEST_PLAN 1.3 (sleeves, twist), 1.4 (loops, the 75 tie points, and the fixed-length D12, S2 and S7 at both joint limits), 1.5 (ankle plugs).
5. Staged power-up with the hip yaw and head yaw limits (TEST_PLAN 8.2a, 8.2b), then the walking voltage log (sections 8 to 12). The log decides the 3S pack (D23); a hop in the section 5 warn band makes the 3S plan ready before the log.
6. Later lab step: self-docking, in sim first. Get-up after falls already works in sim with scripted programs (sim pass only; Done above); the real knee and hip stops are a BLOCKER.
   Note 2026-11-07 ET to Next 6 (fall get-up retest, sim pass only; twin/sit/getup/GETUP_SIT.md): the earlier sim results used the sim model's +-90 deg knee and ankle ranges, which the printed parts cannot reach (the CAD contacts are knee -28.5, ankle +49.5, head yaw -108/+82, neck +37.5 deg; the stored programs need knee -88, ankle +80.7, neck +61 and head -43). With the CAD contacts as limits the base raises 0 of 296 cases (254 of 296 on the sim ranges) and the sit model 0 of 296 (its own new limits are the neck +25 and head -25 stops). Get-up after falls on the real geometry is open; D60 (2026-11-07): it will go through the sit (roll onto the belly, tuck into the sit, the sit's stand-up), searched first, else trained in the walk retrain.
   Note 2026-11-10 ET to Next 6: the get-up through the sit gets up in 248 of 296 cases on the merged sit model (sim pass only; twin/sit/getup/VIA_SIT_EVAL.md); open: the 48 down-ramp front rests (training) and the hip pitch hold on a real servo (TEST_PLAN.md 19.9).

## Open for other owners (not blockers)
- sim/MASS_BUDGET.md models 274 screws; fasteners.json fits 342 (VERIFICATION.md C9 WARN): the screw mass (175 g) is from the older count, and a re-run on fasteners.json changes the mass model, so it belongs to the sim owner.
- sim/MASS_BUDGET.md counts 1 g of cable ties ("a few small cable ties", UNVERIFIED); the 75 ties and 55 stick-on mounts of D25 are not in it, and no lab file gives their mass.
- print/MASS_STUDY.md's own slice of variant (c) differs from print/SLICE_SUMMARY.md by 0.01 g (left_roll_to_pitch support 1.29 against 1.30 g); its (c) walk now runs the SLICE_SUMMARY.md table, which is the build. A single nominal 15 N pushes run moves by about 0.01 from changes this small (MASS_STUDY.md walking section).
- bench/sim_profiles.py still replays the star profiles (the battery guard replays and the D16 table in software/SOFTWARE.md section 5 rest on them): its own job.
- walk_with_guard.py's guard tick still reads inside its cycle (0.71 ms every 0.25 s). On the Pi, the share of the walk read (9.coverage) and when a servo copies Present Voltage into its reply are UNVERIFIED.
- UPSTREAM_ISSUES.md was triaged against the decisions up to D12 only; D13 to D25 are not checked against the upstream issues (VERIFICATION.md C9 WARN).
- Not published: the XT30U cup diameter, the resistor, LED and cell holder lead diameters (3 sleeve sizes open), the holder lead length. The projector's 4 mm lead channel holds one sleeved joint at a time: the cathode joint sits staggered behind the resistor (a fit check at the build).

3D view (private artifact): https://claude.ai/artifact/PHSJH2PwQZLhZnTf9WgaMo
