aaltaay/Open_Duck_Mini_v2/altaay_lab/MOUNTING.md

# MOUNTING

Last updated:
V1 freeze note (2026-11-06 ET, twin/freeze/; CAD check only): rows for the cliff ToF (D54), the two touch boards and their pads (D51) and the speaker duct (D52) at the end; the speaker stand pilots are coaxial (B8 corrected); the mic seats are in print/head.stl.

D42 note (2026-11-04 11:01 PM ET, twin/holes/HOLES_TWIN.md addendum): the screws left on a part form a uniform pattern. body_front: 4 corners (F067, F068 into body_middle_top; F071, F072 into body_middle_bottom; F069 out, hole closed). Battery lid: all 4 M2.5x10 (F027 back). head_bot_sheet: 4 mirrored corners (F083, F084, F089, F090; F088 out, hole closed). Plug caps are flush with the part surface (0.05 mm).

D39 note (2026-11-04 10:12 PM ET, twin/holes/HOLES_TWIN.md): every pilot and clearance hole of a left out screw is closed in the printed parts, so a left out screw comes back only with a reprint. Left eye: F179 and F182 are fitted, F178 and F183 are out (one bulb STL serves both eyes). Back shell: 6 screws (F076 out) with 4 printed seats under its lower ears. The Pi, adapter and camera rest on their 2 closed seats, which stay solid.
 2026-11-02 about 12:05 AM ET (final docs pass: BNO055 wires from the underside, adapter USB-C side exit, fuse holder lead and XT30 and amp seats from cables3d/CABLES_3D.md; seat centres from audit/placements.json after the tape fix; SP4 and SP5, D23; about 12:47 AM ET two 0.3 mm eye washers per screw and the P7 lead extensions from the netlist and BOM pass, D21 note). Earlier: 2026-11-01 about 10:55 PM ET fastener schedule pass (FASTENERS.md section 9, D20, D21), 6:57 PM ET placement pass, first at 6:20 PM ET for parts not in the CAD; 2:52 PM ET blocker pass. Measured on the upstream assembly (URDF meshes + print STLs, STL commit 730c14b) with trimesh: for each modelled board, rays were cast down each hole to find the printed part under it, the pilot diameter, and where the pilot starts and ends below the board top face ("engagement window"). Scripts: audit/screws2.py, audit/sites.py; data: audit/screws2.json, audit/screws_head.json.

Screw rule: choose the length so the thread end stays inside the pilot (length less than the window far end) and engages at least 3 mm (length minus window near end). All electronics pilots are 2.0 mm printed holes, which an M2.5 machine screw self-taps into (no insert, no nut, no washer; no nut traps or washer seats exist in the STLs). The one washer use is a spacer: two 0.3 mm washers under each eye screw head, because the eye pilots are blind (D21 and its note).

| Component | Printed part it mounts to | Holes (CAD) | Pilot | Engagement window below board top (mm) | Screw | Engagement | Orientation | Status |
|---|---|---|---|---|---|---|---|---|
| Raspberry Pi Zero 2 W | head.stl | 4, clearance 2.6 in CAD; real board 2.75 on 58 x 23 mm (Raspberry Pi product brief RP-008359-DS-1) | 2.0 plastic | 1.4 to 6.4 | M2.5x6 DIN 912 A2, 2 pcs (the diagonal pair, D38; the other 2 holes stay empty) | 4.6 | flat, components side up, in head | verified CAD; real 65 x 30 vs CAD 65.9 x 31.25 OK |
| Waveshare Bus Servo Adapter (A) | trunk_top.stl, on 4 bosses 5 mm high (standoffs printed in) | 4 at 2.5, board 42.02 x 33.02 x 1.6 (Waveshare wiki 42 x 33, 2.5 holes) | 2.0 plastic | 1.6 to 6.6 | M2.5x6, 4 pcs | 4.4 | flat; the bosses fix the 42 mm side along x, so the USB-C end of the long edge faces forward and the plug exits sideways (-y) at x -73; both servo sockets are on the +y edge, H3 = front socket (lab choice) | verified; USB-C side exit from cables3d/CABLES_3D.md, confirm at the first fit |
| Second board.stl copy | head.stl | 4 holes on 28 x 37 mm, right side of the head; print/head.stl has no pilots under them (the URDF head mesh did), so nothing is fitted there | none in print/head.stl | n/a | none | n/a | n/a | CLEARED (B7): nothing is fitted there; upstream bom.csv lists one adapter, which sits on trunk_top (basis corrected by fasteners/FASTENERS.md finding 22: the copy does not share the Pi holes) |
| BNO055 (Adafruit 2472) | trunk_top.stl | 4 at 2.5; CAD board 20 x 27 x 3.0 | 2.0 plastic | 3.0 to 8.0 with the 3.0 CAD board; 1.6 to 6.6 with the real 1.6 PCB | M2.5x6, 4 pcs (M2.5x8 would reach 8.0 and bottom out with a 1.6 PCB) | 4.4 | flat, chip up; board x (20 mm edge) along robot +X (forward), 27 mm edge along +Y (left), z up. Centre at (-87.1, 0, 43.3) mm in the trunk frame. Wires leave from the underside: the board sits just under the trunk_top plate with only 3 mm above it, so solder the four D2 wires from below and lead them down (cables3d/CABLES_3D.md); header edge forward (lab choice, B20) | B13 CLEARED (HARDWARE_AUDIT.md): Adafruit design file holes 21.59 x 15.24 mm, each 0.23 mm off its CAD pilot (CAD 21.9 x 14.9) |
| USB-C 2S charger | body_back.stl | 2 at 2.5 (14.4 pitch); only 1 has a pilot under it; D39: stays on 1 screw, the USB-C end sits line to line in the body_back slot (20 N plug, 0.144 N m, 4 N on the slot edge; twin/holes/HOLES_TWIN.md) | 2.0 plastic | 2.1 to 6.9 | M2.5x6, 1 pc | 3.9 | USB-C facing out of the body_back opening | 2nd hole has no pilot (ray hits holder.stl at 5.2 mm); 1 screw plus the USB-C cutout hold it |
| Replaced (D30) by the NKK MB2011SS1W01 button in a printed plate, see V1 track 2 below. Control switch (stock panel slide switch, CAD power_switch.stl 23.4 x 7.4 x 16.8) | body_back.stl cutout | 2 at 1.8 aimed at no printed part | none | none | none: held by the cutout, as upstream | n/a | actuator out through body_back | verified contact 0.00 mm (CAD). B22 CLEARED 2026-11-01 about 6:20 PM ET by design change: this switch now only pulls the Pololu 2815 control pin to GND (microamps), so its current rating no longer matters. Part with a datasheet: BOM line 10b |
| 2S BMS: Tenergy 32175 (34 x 16 x 4.5 mm, Tenergy page) in the upstream BMS slot (CAD bms.stl 40.6 x 15.85 x 3.6) | between body_back and battery_pack_lid, standing, centre (-126.3, -26.7, 18.9) | none | none | n/a | none: sandwiched, as upstream; wrap in kapton tape before it goes in | n/a | flat on the battery bay | B12 CLEARED 2026-11-01 about 6:20 PM ET: fits the measured free envelope 17.75 x 47.2 x 5.33 mm with 1.75 mm (width), 13.2 mm (length, room for the wire exits) and 0.83 mm (thickness) to spare |
| 2S1P Molicel P45B pack (D44, V1 track 9): 2 x 21.40 x 70.00 mm cells side by side in y, axes along z, spot-welded nickel strip, PVC sleeve; envelope 22.2 x 43.7 x 71.0 mm (twin/battery/BAY.md). Replaces the 2x18650 holder (76 x 41 x 20 CAD) | body_back battery bay, grown for the pack: cell axes at x -133.1, y -9.35 and +12.2 mm, z -4.0 to 67.0 (trunk frame), closed by battery_pack_lid (unchanged) | none | none | n/a | none: captive between the bay walls, the bay floor ledges and the lid pad, a 1 mm foam pad (BOM 7) on the lid pad | n/a | cells along z, side by side in y | CAD check only: 0 overlap with the edited body_back and with every other part; 0.5 mm to the lid pad (x -121.5); walls left 9.65 mm back, 5.5 and 7.5 mm at the chamfers, 2.25 mm at +y, 5.1 mm at -y (unchanged); lid screws F017, F018, F027, F028 3.3 mm or more from the cut, charger screw F123 1.0 mm as before. Service as before (ASSEMBLY_TWIN.md section 3, D45) |
| battery_pack_lid | body_back.stl | 4 clearance 2.5 in a 4.0 recess | 2.0 plastic | 2.1 to 15.3 (2 holes) and 2.1 to 20.1 (2 holes) | M2.5x10 DIN 912, 4 pcs (D42: F027 back, its pilot reopened) | 4.8 (clamp 5.2) | n/a | CLEARED (B3): measured in the GLB assembly, the head sits proud on the lid face with no part within 1 mm of the head envelope. No STL edit and no low-head screw needed |
| Speaker | speaker_stand.stl and speaker_interface.stl, stand screwed to head.stl | stand: 4 clearance 2.7; speaker_interface: 4 clearance 2.7 on 32 x 32 mm over the 4 side pilots 2.12 of speaker_stand | 2.0 plastic in head; 2.12 plastic in speaker_stand | 3.0 to 8.0 (stand to head); 2.2 to 5.4 (interface to stand) | M2.5x6, 4 pcs (stand to head); speaker_interface screws to the 4 side pilots of speaker_stand: 4 x M2.5x5 (fasteners/, BOM 17k) | 3.0 (stand); 3.4 (interface, measured on the pilot axis) | facing the right side wall (D52 duct) | BLOCKER B8 (test order 7): CAD envelope 38.5 x 38.7 x 15 mm. The stand pilots are on the interface hole axis (0.01 deg, twin/freeze/speaker_pilots.py; the 20.7 deg was a feat3d fit artefact), so the M2.5x5 go straight in (fasteners/FASTENERS.md finding 15). Upstream ANGEEK 40 mm 4 ohm 3 W; US part uxcell B07M5K17SK 40 x 40 x 20 mm. Retention needs the real speaker |
| Eyes (left_eye, right_eye, bulb x2) | head.stl: screw passes bulb (2.0 mm, clearance 2.7) then head wall (3.0 mm, clearance 2.7) into the eye | 4 per side (8 total), at y = +/-27.5 and +/-52.5, z = 126.9 and 151.9 mm | right_eye 2.05, left_eye 2.2 | 5.0 to 8.0 below the bulb face (blind pilot 3.0 mm with a 1.5 mm front skin, 1.3 mm on the left eye; ray cast, print/left_eye.stl, right_eye.stl) | M2.5x8 DIN 912 A2 plus two 0.3 mm washers under the head (BOM 17l), 8 screws, 16 washers (D21 note) | 2.4 engaged, 0.6 mm to the floor (BOM 17g) | facing forward | BLOCKER B14 (test order 11): left pilot 2.2 vs right 2.05 (a 2.2 pilot leaves about 0.15 mm thread depth per side for M2.5). Needed: test print of left_eye; if loose, use 2.05 or an M2.5 thread-forming screw. LED: 1 W bead with 100 ohm (B23, Tnkr m7); eye glass seat ø29.6 x 1.85 mm |
| Projector LED (stays, D33) | flash_light_module.stl + flash_reflector_interface.stl | none found (V1 track 2: VHB 4950 on the 1018 mm2 contact face, see below) | none | n/a | none found | n/a | forward | Reflector seat measured: tapers to 20.0 mm, about 10 mm deep, narrow end 8.07 mm. Part: Aurorad S5 20 x 15 mm. Height and retention on test order 10 |
| Antenna servos, the ears (SG90 x2, 32.6 x 13 x 30.97 CAD; GPIO12 and 13) | head.stl side plate, one per side: each servo hangs under it on its 2 tabs, the body ends in the plate pocket; antenna holders on the output shafts | tab holes 2.0 mm, 27.5 mm apart; holders: 2 clearance 2.7 in 5.05 recess onto the SG90 horn | head: blind 1.5 mm, 4.7 mm to the drill tip, coaxial with the tab holes (axis 0.4 deg, centre 0.001 mm off) | 2.5 to 7.2 above the tab underside (each tab flat on 7.25 mm of plastic, 58.5 mm2 per tab) | SG90 bag screws: 2 tab screws per servo, 1 holder screw per horn (6 total) | a 7 mm screw has 4.5 mm in the pilot (2.25 x d, calc only); bag screw length not published | output shaft out through the side plate (sideways, 14 deg up) | CLEARED (B5): the 39.2 mm figure was wrong; tab pilots 27.5 mm vs SG90 tab holes 27.6 mm (GLB sg90 model). Bag screw sizes checked with test order 6. The body ends bear on the pocket ends (117.7 mm2, gap 0 to 0.1 mm): that and the 2 screws stop it turning. The ear clears the shell by 2.02 mm and the mic boards by 10.07 mm over -90 to 90 deg. Same in print/head.stl and twin/companion/stl/head.stl (twin/companion/ear_mount.json, CAD check only, 2026-11-05 ET) |
| Castle CC BEC Pro (envelope 47 x 33 x 26 mm to cover the 3 published sizes, plus 8 mm for the leads) | belly floor (inside body_middle_bottom), between the battery bay and trunk_bottom, centre (-64.5, -0.5, -9.8) on the 1.1 mm tape (audit/placements.json seat fix; was -71.5, -0.5, -7.0), 47 mm edge along y, 26 mm up | none | none | n/a | double-sided foam tape (BOM line 29) on the 47 x 33 face against the floor | n/a | flat, leads toward the battery bay | B11 CLEARED 2026-11-01 about 6:20 PM ET by the free-space search (audit/free_space.py, audit/place_parts.py): fully free in the swept volume of hip yaw, hip roll and neck pitch over their full ranges, 1 mm clearance, clear of the cable corridors and the unmodelled adapter components; 57.7 mm from the BNO055 (the walk script runs the BNO055 in NDOF mode via raw_imu.py, but the policy reads only raw gyro and accelerometer, which a magnetic field from the BEC does not change) |
| 5 V regulator (Pololu step-down, BOM line 9) | head floor below the Pi (the Pi hangs from the upper inner wall of head.stl, components down, 44.3 mm free below it, measured by ray casting) | | | | double-sided foam tape (BOM line 29) | | flat | Fed from the switched pack bus through the neck (P13, 20 AWG), 5 V leads to Pi pins 2 and 6 kept short. Replaces the HENGE UBEC (D4) |
| Fuse holder FHAC0001ZXJ (body 50 x 17.2 x 17.2 mm plus cover on a strap; envelope 52 x 22 x 18) | inner face of the battery bay front wall, BMS side, centre (-103.9, -20.0, 25.0) on the tape (placements.json) | | | | double-sided foam tape (BOM line 29) | | 52 mm edge along y | B11 CLEARED 2026-11-01 (same method as the BEC Pro). Inline between XT30 and the Pololu 2815. The -y end lead leaves only about 4 mm from the body wall, so it turns at once; both 90 mm holder leads get a 16 AWG red extension at splices JFI (20 mm) and JFO (40 mm) (wiring/netlist.yaml P7, from cables3d/CABLES_3D.md) |
| Replaced (D30) by the Pololu 2813, see V1 track 2 below. Pololu 2815 Big MOSFET Slide Switch HP (20.3 x 25.4 x 4.1 mm, 0.8 x 1.0 x 0.16 in, Pololu page) | inner face of the battery bay front wall, opposite side to the fuse, standing, centre (-110.9, 24.0, 36.5) on the tape (placements.json) | | | | double-sided foam tape (BOM line 29) | | on-board slide switch set OFF | Carries the full pack current (6 A with the MOSFETs at 55 C, 16 A at 150 C, 90 A max, Pololu table at 12 V, 22 C still air). Control pin wired to the body_back control switch. Thermal check TEST_PLAN 4.2 (sim RMS 99 to 101 % of 6 A with D23); a second 2815 fits in parallel below it (40.8 mm free, sim/POWER_FIX.md) |
| Servo power splices (D15): V+ and GND, soldered in adhesive heat shrink, envelope 30 x 16 x 10 mm | belly, on the trunk_bottom side face near the BEC, centre (-62.0, 0.0, 39.0) | | | | cable tie or foam tape | | | Feed SP1 to SP5 (22 AWG; SP4 and SP5 are the D23 ankle feeds) from the BEC output (16 AWG) |
| USB cable slack (Adafruit 3878, about 0.4 m coiled), envelope 45 x 35 x 10 mm | belly side wall, left side, centre (-76.5, 45.9, 22.5) on the tape (placements.json) | | | | cable tie to the coil, foam tape | | | Keeps the extra length away from the hip joints |
| XT30 pair | body_back, left of the holder, standing (Tnkr placement), centre (-123.0, 31.0, 30.0), female half down | | | | none: inline | | | Seat from cables3d/CABLES_3D.md terminals |
| MAX98357A amp | head floor, flat, right of the speaker stand (Tnkr placement), centre (62.0, -68.0, 180.1) on the 1.1 mm tape | | | | double-sided foam | | | Seat from cables3d/CABLES_3D.md terminals |
| Foot switches Omron SS-01 (D17; SS-10 fallback) | foot_top.stl: 2 slots per foot, 6.4 x 19.8 mm (measured) | none | none | n/a | none: press fit | n/a | lever down toward foot_bottom | CLEARED seat (B11 part): slot equals the Omron SS datasheet body 19.8 x 6.4 x 10.2; press fit per upstream docs/assembly_guide.md and issue #14; 2 per foot per Tnkr m11. Fit checked with test order 14 |
| Camera Module 3 (Adafruit 5657) | head.stl: 4 blind pilots 1.65 mm, 3.1 mm deep, on 20.9 x 12.5 mm (measured) | 4 at 2.2 on 21 x 12.5 (Raspberry Pi drawing) | 1.65 plastic | PCB thickness not published | M2x4 self-tapping, 4 pcs | test order 8 | facing forward | CLEARED part and pattern (B9); screw length on test order |
| I2S mic boards, left and right (Adafruit 3421, BOM E8, D47) | head.stl as edited by twin/companion/mic_seat.py (twin/companion/stl/head.stl): per side 2 printed bosses 5.0 mm on the inner side wall, 3.5 mm high, plus a port tube 4.0 OD / 2.0 bore, 3.5 mm long, on the PCB port, and a 1.2 mm sound port through the wall on the same axis (a sound hole, kept by D39) | 2 at 2.5 plated, 11.43 mm apart, on a 16.51 x 12.7 mm board; PCB port 1.025 mm at (8.255, 7.822) mm from the outline corner, 0.71 mm from the mic centre (the 3421 board files and fab print, read 2026-11-05) | 1.65 plastic, 5.6 deep | PCB thickness not published: 0.8 to 1.6 checked (the product page's 1.8 mm overall points to about 0.8) | M2x6 self-tapping, 2 per board, 4 pcs (BOM 17h kit) | 5.2 to 4.4 (rule 4.0); tip gap 0.4 to 1.2 mm; 0.9 mm of wall past the pilot | board back to the wall, PCB port on the tube, a closed-cell foam ring from the BOM 29 tape on the port tube end (D48); the pair is a mirror pair about the board centre line (D42), both holes used (D39); left board SEL to GND, right SEL to 3V | CAD check only (mic_seats.json PASS: 6.05 mm to the SG90, 121.6 mm mic spacing; seats redrawn 2026-11-05 about 7:50 PM ET) |

## IMU axes (BNO055)
- Board lies flat in trunk_top; local x to robot +X (forward, toward the eyes), local y to +Y, local z to +Z (up). URDF +X is forward; the battery sits at x about -126 mm (back).
- Runtime raw_imu.py (Open_Duck_Mini_Runtime 376de65, lines 27 to 48; the walk uses raw_imu.py, not imu.py) sets axis_remap (Y, X, Z) with signs (-, +, +) when imu_upside_down is false. Verify on hardware: run scripts/calibrate_imu.py from scripts/, then bench/imu_check.py --tilt (pitch nose down should read the sign the policy expects; software/SOFTWARE.md section 4). Sign is BLOCKER B20 until tested (test order 5).

## Screw count from this file
M2.5x6: Pi 4 + adapter 4 + BNO055 4 + charger 1 + speaker stand 4 = 17 before D38; since D38 and D54 the BOM 17f Need is 13 with the 2 cliff ToF screws (BOM buys 20). Nothing is fitted at the head board.stl copy (B7).
M2x4 self-tapping: camera 4 (METALLIXITY kit, BOM 17h).
M2.5x8: eyes 4 since D38 (2 per eye, the diagonal pair), each with two 0.3 mm M2.5 washers (8 washers; BOM line 17g, line 17l; D21 note). M2.5x10: lid 4 since D42 (3 from D38 to D41) (drill the lid holes to 2.7 mm, D20). D38 also: Pi, servo adapter, camera, speaker stand and speaker interface on their 2 diagonal screws; head_bot_sheet on 3 of 8; body_front on 4 of 8 with the tongue and groove; body_back on 7 of 8 with the lips (twin/screws/SCREWS_TWIN.md). Every unused hole stays, so a screw can go back.
M2.5x5: speaker_interface to speaker_stand 4 (BOM 17k buys 5).
Every other screw (horns, inserts, servo cases): fasteners/FASTENERS.md section 4.

## V1 track 2 (2026-11-04, twin/assembly/ASSEMBLY_TWIN.md; CAD check and calc only)
Fall shock: mid 196 g head, 128 g trunk (twin/structure/STRUCTURE_TWIN.md); VHB 4950 design value 82.7 kPa (3M, 12 lb/in2), dynamic overlap shear 552 kPa.

| Part | Mount | Check |
|---|---|---|
| Pololu 2813 (D30), 20.3 x 25.4 x 4.1 mm (0.8 x 1.0 x 0.16 in), 2.7 g (Pololu) | VHB 4950 on the 2815 seat on the lid face, 353 mm2 contact (THERMAL_TWIN.md) | 9.6 kPa at the mid fall, SF 8.6. Its own small pushbutton stays in parallel. Button on A and B (P15), GPIO26 on OFF |
| NKK MB2011SS1W01 button (BOM 10b) | printed plate twin/assembly/button_plate_d30.stl in the body_back cutout: 15.0 x 6.5 x 3.0 mm plug in the measured 15.5 x 7.0 mm opening, 23.4 x 11.0 x 1.5 mm flange outside, 6.4 mm hole; the button nut clamps it; VHB on the 149 mm2 flange ring | flange takes the push; 42 mm free behind the plug; 4.0 mm of the 8.5 mm bushing left for the nut |
| Side lamp (flash_light_module, flash_reflector_interface, E5, LED; 12.5 g) | VHB 4950 on the module's 1018 mm2 contact face with the head; VHB between the reflector interface and the module; a VHB ring under E5 | 23.6 kPa at the mid fall, SF 3.5 (needs 291 mm2) |
| Castle CC BEC Pro | the tape as before, plus one BOM 32 tie over the top through two BOM 34 mounts beside it (spares) | tipping edge 75.1 kPa (SF 1.1) before; after: tape 19.6 kPa (SF 4.2), tie 14.3 N of 80 N |
| USB cable slack coil | one BOM 32 tie to a BOM 34 mount (not tape alone) | 13.8 N of 80 N |
| Eye LED beads | dome in the bulb's 8.0 mm centre hole, a VHB ring from the bead base to the bulb back | needs 7 mm2 |

Service: the lid faces into the trunk. Cells and XT30: 7 x M3x8 body_back screws out (D38), pull body_back 20 mm back on its wires, then the 4 lid screws (D42) with the 2.0 mm key's short arm. microSD and Pi USB: the 8 x M3x8 head_bot_sheet screws out (2 with the neck pitch at -9.4 deg), drop the sheet down the neck. Build order: twin/assembly/BUILD_ORDER.md.

## V1 track 8: the duck side of the contact dock (2026-11-05, twin/dock/DOCK_TWIN.md; CAD check and calc only)
The pad sticks on the existing flat chest face. Its four leads pass one 6.0 mm hole printed in print/body_front.stl since the D50
review (PR 24, round 4; twin/dock/chest_hole.py): it replaces the 4 mm hole that was to be drilled after printing, which could not
pass the bundle. The hole carries the leads, so D39 does not close it. The 0.8 mm pocket that would locate the pad is not made.

| Part | Mount | Check |
|---|---|---|
| Chest contact pad (BOM DK1), 100 x 64 x 0.8 mm FR4, 9.5 g (calc: FR4 1.85 g/cm3); superseded by the four-strip 100 x 76 mm pad of the V1 track 8 phase 3 rows below (D50) | VHB 4950 (BOM 29) over its whole back, 6400 mm2, on the flat chest face of body_front (flat from trunk z -2.8 to 78.9 mm, ray tests on the V1 STL), pad at trunk z 0 to 64, centred on y 0; the three solder pads on its back over the lead hole at the pad centre (now the printed 6 mm feedthrough, D50 rows below), leads 20 AWG (CHG+, GND) and 26 AWG (SENSE) | fall shock 128 g (the V1 track 2 trunk value): 11.9 N, 1.9 kPa of 82.7 kPa (SF 44); the paddle presses at most 3 N straight on (no peel) and drags 0.45 N (PTFE 0.15, ASSUMPTION), 0.07 kPa. Behind the hole inside the trunk: the DK2 seat and the inside splices (D50 rows below) |
| Pololu 5382 ideal diode (BOM DK2) with the 100 k across it (DK5) | VHB 4950 inside the trunk on the chest side, next to the pad leads | seat since D50: twin/dock/dock_seats.json, on the inner face of body_front at world (33, 0, 24) (CAD check only) |
| Charge path fuse holder (BOM DK3, the L3 part, 50 x 17.2 x 17.2 mm) | inline on the CHG+ lead between DK2 and the pack side (BMS P+) | seat since D50: twin/dock/dock_seats.json, standing on the left inner side wall of body_middle_bottom at (-85, -42, 26) (CAD check only) |
| Cell NTC (BOM DK5) | in the seat between the two cells that the battery track left (twin/battery/BAY.md), lead along the pack to the SENSE strip; the wake branch (zener, diode, 10 k) from SENSE to the Pololu 2813 ON pad | as BAY.md |

## V1 track 8 phase 3: awake while docked (2026-11-05, D50; CAD check only for the pad, calc only for the rest)
| Part | Mount | Check |
|---|---|---|
| Chest contact pad DK1, now 100 x 76 x 0.8 mm with four strips (SYS, GND, SENSE, CHG+ from the bottom), 11.2 g (calc) | VHB 4950 (BOM 29) over its back on the flat chest face of body_front, trunk z 0 to 76 (flat from -2.8 to 78.9 mm) | fall shock 128 g: 14.1 N on 7600 mm2, 1.9 kPa of 82.7 kPa. Lead feedthrough printed in print/body_front.stl (twin/dock/chest_hole.py, section twin/dock/stl/chest_hole_section.png; CAD check only): one 6.0 mm hole at world (y 0, z 38) through the 10 mm chest wall (x 36 to 46). Strain relief printed in the wall: a 45 deg bell mouth 2 mm deep inside (10 mm across at the inner face), where the leads turn, and a 0.8 mm 45 deg chamfer on the pad side, so the leads bend over a wide mouth, not a sharp edge; -0.33 cm3, re-sliced 57.63 g and 3.97 h (+0.07 g, no support). A grommet ring standing proud inside was tried and dropped: body_front prints +x up, the ring would hang under the chest wall and needs 1.8 g of support inside the shell. Only the four pad conductors pass it (3 x 20 AWG at 1.9 mm and 1 x 26 AWG at 1.3 mm: a 4.6 mm bundle, 0.7 mm a side to spare). The GND branch (splice JGD, to DK2 G and BMS P-) and the SENSE branch (splice JSN, to the NTC and the wake branch) are joined inside the trunk, 60 mm from the pad (wiring/netlist.yaml DC2, DC3). The outer mouth lies under the pad |
| DK6 Pololu 5382 (SYS) and DK7 Pololu 5383 (pack side), 7.6 x 12.7 mm, 0.2 g each | VHB 4950 under trunk_top beside the 2813 (SW1): DK6 at world (-104, 1, 45), DK7 at (-104, 13, 45), 16 mm leads to SW1 VIN; DK2 on the inner face of body_front at (33, 0, 24); the DK3 holder standing on the left inner side wall of body_middle_bottom at (-85, -42, 26) | twin/dock/dock_seats.json and dock_seats.png: clear of every part, box and routed cable by 1 mm, large face 1.5 mm off the wall (CAD check only); no screw, no new hole (D42, D39) |

## V1 freeze (2026-11-06 ET, twin/freeze/; CAD check only)
| Part | Mount | Check |
|---|---|---|
| Cliff sensor, Adafruit 5396 VL53L4CD (BOM 5b, D54), 25.4 x 17.8 x 4.6 mm, 1.8 g | print/body_front.stl, low in the chest, centred: 4 printed standoffs 5.0 mm, 3.3 mm high, on a floor that grows from the inner face; 2 x M2.5x6 DIN 912 (17f) from the back of the board into 2.0 mm pilots in the standoffs on the diagonal pair of holes (D42), the other 2 holes on solid standoffs (D39); sensor face 52 deg below horizontal; a window through the wall on the 18 deg field of view (14 deg half angle) | 4.4 mm engaged; 1.7 mm of wall over the board's upper end; window z -31.1 to -6.8 mm, 6.8 mm under the dock pad (D50), 39 mm under the 6 mm lead hole; seat 10.9 mm from body_middle_bottom, 15.7 mm from DK2; no foot in the field of view in the stock walk (cliff_walk.json, sim pass only). body_front prints front face down (parts.csv up -x) |
| Touch boards, Adafruit MPR121 1982 (BOM E9, D51), 33.0 x 19.1 mm | TCHH: VHB 4950 on the inner roof of the head at (-35, 35, 223) mm, parts down, 12.5 deg tilt; TCHB: VHB on the left inner side wall of body_middle_top at (-88, 52, 74) mm, parts facing in | 13.1 and 9.5 mm from every other part, 8.4 and 31.5 mm from the pad guard rings (touch_pads.json) |
| Touch pads, copper foil Adafruit 1127 (BOM E10, D51) | stuck on the inner shell, no air gap (AN3863): PH1 head top 30 x 30 mm, PH2 back of the head 20 x 30 mm, PB1 inner roof of body_middle_top behind the neck 17 x 34 mm; a 3 mm guard ring 3 mm outside each, to GND | wall 3.0 mm under each; 4.1 mm or more from every cable, 3 mm or more from every part |
| Speaker duct (D52) | one piece with print/speaker_interface.stl: bore 33.0 mm, wall 1.9 mm, 12.0 mm long, 1.0 mm short of the inner head wall, a ring of BOM 29 foam on its end with one liner left on | 2.0 mm from the fitted interface screw heads (hex key reaches them), 0.62 mm from speaker_stand (screwed to it), 30.8 mm from the right mic board, 53 mm from the ear servo; the 36 outer grille holes closed flush in print/head.stl |

## V1 sit (2026-11-06 ET, D59, twin/sit/SIT.md; CAD check only, calc only)
Every sit part but the neck stop block is TPU 95A on VHB 4950 (BOM 29, 1.1 mm; no new holes); the block (PLA) sits under two lengthened stock screws. VHB design value 82.7 kPa (3M, as above); fall shock 196 g (the head value of twin/structure/STRUCTURE_TWIN.md, the larger one, used for every part here). Stop and sitting loads press the pads onto their faces (compression); only a fall loads the tape in shear.

| Part | Mount | Check |
|---|---|---|
| Seat, print/sit_seat.stl (22.6 g, 1 per robot) | VHB on its 1670 mm2 top face, under body_middle_bottom's rear belly (sitlib/sit_cad.py SEAT: x -110 mm, lowest point z -66 mm at the zero pose), printed on that face | fall shear 43.5 N, 26 kPa, SF 3.2; sitting load in compression |
| Belly bumper, print/sit_bumper.stl (12.2 g, 1) | VHB on its 1440 mm2 top face, under the front belly (x +20 mm, lowest point z -69 mm, 3 mm off the floor in the sit) | fall shear 23.4 N, 16 kPa, SF 5.1 |
| Knee bumper, print/knee_bumper.stl (1.2 g, 2) | VHB on the front face of shin_spacer (392 mm2), facing the knee servo case at the 150 deg fold | fall shear 2.3 N, 5.9 kPa; the stop load is compression (twin/sit/sit_stress.json) |
| Ankle pads, print/ankle_pad.stl (0.17 g, 4) | VHB in a pocket 0.3 mm larger than the pad on the pad seats of foot_top and foot_side (45 mm2 each) | the pocket walls take any shear; the -95 deg stop load is compression |
| Hip pads, print/hip_pad.stl (0.24 g, 2) | VHB on the top face of roll_to_pitch (132 mm2) where the thigh cover lands at hip pitch -75 deg | compression at the stop; fall shear 0.5 N |
| Neck pads, print/neck_pad.stl (0.23 g, 2) | VHB in a pocket 2.5 mm deep (0.4 mm larger than the pad) on the front face of each pillar of the neck stop block (60 mm2), low on the stock neck sheet's back edge at +25 deg (round 2: centre r 28.0 mm from the neck axis, on the edge's lower straight run, the face 33 deg from the horizontal) | compression at the stop; the sheet's slide along the face (0.39 of the stop force) goes into the pocket's lower wall, not the VHB (twin/sit/sit_stress.json: pad SF 4.28 at service, 2.63 at the 12 N back shove with the torque on; pocket wall 5.97 and 3.67) |
| Head pad, print/head_pad.stl (0.93 g, 1) | 12 x 6.1 x 10 mm (round 2: a 10 mm face, 6 mm in the first round), VHB in a pocket 2.5 mm deep in the hook of head_pitch_to_yaw (73 mm2), the face on the left neck sheet's front edge at head -25 deg, r 29.3 mm | compression at the stop; the slide (0.52 of the stop force) on the pocket wall (sit_stress.json: pad SF 3.15 and pocket wall 2.76 at the free 12 N forward shove; the hook's root 2.90 and the arm with its doubler 1.84 against 1.5, SIT.md section 4) |
| Roll pads, print/roll_pad_left.stl and roll_pad_right.stl (0.11 g each, 1 of each; round 2) | VHB in the conformal pocket of the hip roll stop lug on each roll_to_pitch (the pocket is the roll_motor_bottom case corner's path, 3.0 mm pad plus 1.1 mm VHB deep, 12 x 9 mm), the pad's face on the case corner at hip roll -8 deg, r 17.5 mm; left and right are a mirror pair, not interchangeable | compression at the stop over 32 mm2 of the case (sit_stress.json: pad SF 3.83 at service, 1.92 at the fall load, 2.29 at the stall); the lug's walls round the pocket take any shear |
| Neck stop block, print/neck_stop.stl (14.7 g, 1, PLA) | the two hip yaw servo screws F127 and F129, M2x6 to M2x12 through the block's 4 mm flange (seat 6 mm higher, the stock thread engagement in the servo case; a 4.6 mm counterbore open above, driven with the body shell off, as the stock screws are); round 2: a 4 mm foot behind the pillars to x -56 (|y| 15 to 22) rests on trunk_top's flat top face, off the F126/F128 recesses; no VHB, no new hole | the pad load's line passes in front of the foot's back edge (the tip pivot, 28.7 mm behind the screws), so the stop puts no pull on the screws in any design case (0.0 N, calc only; the first round's block put 482 N on one screw at the fall load); the pull test of TEST_PLAN.md 19.8 stays as a check of the assembly; pillar SF 12.5 at service, 7.7 at the 12 N back shove with the torque on; the two M2x12 are not in any bag or kit (BOM 17m) |
