aaltaay/Open_Duck_Mini_v2/altaay_lab/V1_PLAN.md

# V1 plan

Written 2026-11-04 4:21 PM ET (America/New_York) by the lead. The lead keeps this file; the status column changes at each merge.

Ahmed, 2026-11-04 about 4:08 PM ET: "Now let's do this as a version 1, forget about the wheel. Forget about chasing a human and that's fine. Do make sure that our design works, is optimized, and there are no missing pieces: electronics, cables, spin, power, electricity, heat test, vibration. I guess all of the good stuff. I need a true digital twin so we're not surprised when we start printing. The designs also need to be optimized so every component is accounted for: how it's going to attach to each other, all of it, please."
Then: "But don't waste my tokens, please." "Each one needs to have some serious outcome or find serious gaps." "Or start one by one to make sure we're not just doing a wrong motion here." "And have a plan in case we don't finish today."
Then, about 5:05 PM ET, after track 1: "Also, why do we have the LED on the side? Put it in the eyeglass disc." "Well, dude, just continue all of them, dude. Don't leave leftover branches, and make sure: if you see bad signals or bad spikes, we got to fix that, not just detect them. Anticipate any possible problems, please, please, please." "continue through all the tests dont stop." He listed the scope again: electronics, cables, spin, power, electricity, heat test, vibration.

V1 scope: the stock walking duck on legs, indoors, our 2.65 kg build. No wheels, no human pace work. The dock stays a later lab step (DECISIONS.md D5). Nothing is printed or bought. "Spin" is read as joint rotation: what each joint hits as it turns, and what the cables do.

## Pause (2026-11-04 about 7:50 PM ET)
Ahmed: "Just make your best decisions, merge, and let's pause." The running tracks (2b, 2c, 2d) finish and merge; tracks 3 to 7 wait for his go. Self-charging is now a V1 must-have (D37). A separate session compares Open Duck Mini v2 with Qmini for phase one.
2026-11-04 9:03 and 9:16 PM ET: Ahmed asked for track 2e from the 3D view (artifact comments); it runs during the pause.
2026-11-04 9:37 PM ET: Ahmed keeps this robot (D40, no Qmini), starts the self-charging dock now with heat included (D41, track 8) and asks for a study of a DeWalt 20V MAX pack (track 9). At 9:43 PM ET he asks for wireless charging to be studied too (track 8). Tracks 3 to 7 still wait for his go.
2026-11-04 11:06 to 11:13 PM ET: Ahmed picks contacts and the osrf/autodock port for the dock (D43, track 8), 2S1P Molicel P45B 21700 cells instead of the DeWalt DCB200 (D44, track 9), and no tool-free swap, the self-charge a must, changes implemented without a further go, simplest, cheapest and most reliable together (D45, tracks 8 and 9).
2026-11-05 1:29 AM ET: Ahmed asks for precision, a walk retrain if needed, and perception (D46, tracks 8 and 10). Track 10 is new: the walk retrain; its run waits on his RunPod OK.

## How it runs
- One track at a time, one agent per track. Track 1 was the pilot. Since "continue through all the tests dont stop" (about 5:05 PM ET) the tracks run back to back: each starts as soon as the one before is merged.
- A track must end with serious outcomes: FAIL or RISK items with numbers and a fix, or "checked, nothing serious" with the evidence. Full detail only for FAIL and RISK.
- Fix, not just detect: every FAIL or RISK gets a fix that the twin runs again and shows working, with the numbers before and after. A bench check alone is not a fix. Where a number is not published, the fix must hold at the worst cited value, and the bench check stays. A fix that needs a part names the part and its price and waits for Ahmed's OK; nothing is bought.
- Anticipate: each track ends with the problems in its area that no track covers yet, each with the check that settles it. The lead keeps them in the list at the end of this file.
- Branches: every V1 track pushes to one reused branch, claude/v1-elec in both repos, restarted from the base after each merge, so the tracks leave no new branches. Cloud sessions cannot delete remote branches (the git proxy refuses), so the older merged branches wait for Ahmed.
- If a track finds nothing serious after its first pass, it stops and says so.
- Each finished track is merged the same day (PR, then merge), with its history entry and its own lines in STATE.md, HARDWARE_AUDIT.md and TEST_PLAN.md. Nothing finished stays only on the box.

## Tracks, in order
| # | track | the question | status |
|---|---|---|---|
| 1 | electrical | Does the power system trip, over-volt or drop out? Power-on inrush and the summed get-up and fall peaks against the BMS limits, regeneration at a full 8.4 V pack and with the BMS open, the servo bus signal with the ground offset at the far servo; one quick pass over the 5 V side, protection, grounding and charging. | done 2026-11-04 (twin/electrical/ELECTRICAL_TWIN.md): 0 FAIL, 2 RISK with $0 fixes. B47: a hard 60 N shove of the standing duck draws 19.5 to 20.6 A, so a BMS at the low end of its 22 +/- 5 A band trips (TEST_PLAN 3.3 pass line 21 A). B49: left switched on after the battery hard stop, the cells pass 2.5 V in 1.2 to 4.4 hours (switch-off rule, TEST_PLAN 11). B48: power-on data not published (TEST_PLAN 3.5). Regeneration and the far servo signal are OK. Sim pass only and calc only. |
| 1b | electrical fixes | Fix what track 1 found, in the twin: B47 (the shove spike), B49 (the drain after the hard stop), B48 (power-on, fixed for the worst cited case), the far servo ground margin, and the bus signal edges at the real baud rate and cable lengths. What happens to the Pi and its microSD if the BMS trips anyway? | done 2026-11-04 (twin/electrical/ELECTRICAL_TWIN.md, Track 1b fixes; D28). B47 FIXED by a target guard in the walk loop (the training's own target clip plus a 10 A servo budget): worst 4 ms window 18.60 A before, 15.89 A after, 0 trips at 17 A in 252 replays, falls and walk unchanged. Track 1 corrected: the runtime's real gains (P 30 legs, P 8 head) and the fall hold in floor runs. BMS trip anyway: it releases when the load is cut; $0 software fixes (start_paused, read-only root, B51). B49: no $0 fix; the Pololu 2813 pushbutton switch waits for Ahmed's OK. B48: bounded, a soft start is ready if TEST_PLAN 3.5 fails. Signals OK after the fixes; BNO055 on software I2C (B52). Sim pass only and calc only. |
| 2 | assembly | Is every part held by something? Can every screw be driven in some order? Can the cells, the microSD and the Pi be serviced? Does the mass model count every piece (342 screws fitted, 274 modelled; the D25 ties not counted)? Ahmed's LED ask (D29): two LEDs in each eye disc, its eye LED and a lamp LED, and the side projector lamp goes (fit, mount, wire, light, BOM, mass, and viewer labels that say which LED is which). The fit of a momentary button for the Pololu 2813 swap (B49, waits for Ahmed's OK). | done 2026-11-04 (twin/assembly/ASSEMBLY_TWIN.md, BUILD_ORDER.md; D35). Held: the side lamp had no mount, now taped (SF 3.5 in the mid fall); the BEC Pro could tip off its tape (SF 1.1), now tied over the top (SF 4.2). All 286 screws can be driven in the BUILD_ORDER.md order (only 115 with every part in place). Cells and XT30: body_back off and pulled 20 mm. RISK left: the microSD and the Pi USB need head_bot_sheet off (8 screws); track 2d takes it. Mass 2654.7 g, up to 2686.2 g if the ties weigh their upper bound (BLOCKER: weigh them). D30 applied (Pololu 2813, button plate in body_back). Ahmed reverted the lamp move (D33): the head stays as upstream, every LED named in the viewer. CAD check and calc only. |
| 2b | everything in 3D | Ahmed: "I don't see that all cables have been modeled" and "I also don't see the camera being inserted". Every part seated, every cable drawn with both ends on the right connector, every screw, labels, an x-ray view, the camera seated with its screws (M2x5, D34) and the 300 mm flat ribbon (D34). | done 2026-11-04 (twin/complete3d/COMPLETE3D.md): 48 cables in 68 runs, all drawn, 48 of 48 with both ends at the right part; 146 labels, none overlapping; an x-ray switch; the camera seated on its measured pilots with M2x5 (D34); D12 the 300 mm flat strip; the OFF wire D13 (D30); the head_board ghost out of the viewer. RISK left (B61, B62): D12, D13 and P13 rub the swept neck parts at head roll (0.6 and 1.2 mm); SP4 and SP5 rub foot_side (0.49 and 2.1 mm, older); track 4 re-routes them. CAD check only. |
| 2c | knee servos | D32: STS3250 on both knees, in the twin: heat, torque, speed, current, falls, get-up, the printed knee parts, the runtime settings, and the RunPod training option. | done 2026-11-05 (twin/knee/KNEE_TWIN.md; D32, D38): heat fixed, no 70 C cut in any session (hottest knee 47 to 63 C at a 32 C room); knee saturation 0.00 to 0.03 % of walking (was 21 to 22 %); 0 trips at 17 A with the 1b guard. RISK B70: with the damping the sheet implies, the stock policy walks 0.023 to 0.038 m/s (was 0.063 to 0.096) and falls in 4 of 5 backlash sessions; fix: the run2_sts3250 retrain after a bench BAM test of one STS3250 (TEST_PLAN 15, open question 9). roll_to_pitch at 3 walls (D26 P1): 1.81 walking, 1.20 in push. Mass 2.70 kg; BOM build $1,146.28 with line 1b (nothing bought). Sim pass only, FEA pass only, calc only. |
| 2d | fewer screws, fast assembly | Ahmed: "Cut the screws where it's safe" (target 90 %), "Cable management and thinking about how a human can assemble it fast". Every joint at the minimum that holds with margin 2, snap fits and ties where safe, magnets only on unloaded covers with a backup, assembly hours before and after, the microSD and Pi USB access. | done 2026-11-04 (twin/screws/SCREWS_TWIN.md; D36, D38): 342 to 317 fitted screws, inserts 58 to 48, washers 16 to 8, no magnets; the back shell keeps 7 screws; a tongue and groove on body_front and lips and ribs on body_middle_bottom carry the fall loads (coupons K1 to K4); assembly 6.6 h to 6.2 h. 90 % is not safe: 75 are servo internals and the 168 servo horn and case screws are under margin in falls (D26). PLA with coupons 1389.0 g to 1400.0 g, 125.0 h to 126.5 h. The 2813 button is now NKK MB2011LS1W01-BB (in stock). CAD check and calc only. |
| 2e | closed holes, fewer screws | Ahmed (artifact comments, 2026-11-04 9:03 PM ET): "throughout the entire design, any hole without a screw, close it". At 9:16 PM ET, about his corner example: "It's the stress test where it could break that you add the screw to. That's not my rules." and "The design needs to be focused on fewer screws. If you can remove more, please go ahead and do so". Every fastener hole and insert bore left without a screw is filled in the printed part; holes that do a job stay open (vents, cables, ties, light, sound, the lens, bearings, tool access). Screws stay only where the stress checks need them, with one more pass for screws that can go; printed seats, pins or walls keep a part on fewer screws from rocking or turning. | running: phase 1 (hole inventory, stress checks, new meshes), then phase 2 applies it |
| 3 | real code in the loop | Does the robot's own runtime code, run unchanged against the sim (simulated servo bus and IMU), stand and walk? Ids, signs, units, IMU orientation (B20), the start pose, loop timing, faults. Runs the track 1b spike fix (twin/electrical/fix/bus_budget.py) in the real code, with start_paused and the torque-on surge at power-up. | not started |
| 4 | joint motion | Where do the real parts hit each other through each joint's turn, the walk, the get-up (knees -88 deg, hips -68 deg) and falls? What do the cables do through that motion? | not started |
| 5 | vibration (lean) | Does walking vibration push the IMU outside what the policy was trained on? Does the head ring on the neck chain? Does a servo chatter at hold? Which screws and connectors loosen? | not started |
| 6 | heat (lean) | The twin's reading for every bench heat test, and the one lever not tried yet: lower holding gains while standing. The main heat result is already known (the live twin). | not started |
| 7 | electrical leftovers (lean) | The anticipated electrical items no track covers: the BEC dropout at half charge, the 5 V rail with every extra on, ESD on carpet. | not started |
| 8 | self-charging dock (D37, D41) | Ahmed (9:37 PM ET): "I want, but assume the heat as well, so it needs to be good. We need full research." At 9:43 PM ET: "So instead of having pins or pegs, how about we do a magnetic field, just like how the robo cleaners and wireless phones ?? Could you study that?" How the duck finds its dock, walks in, sits and charges by itself: how real docking robots do it, contacts against wireless charging, the camera marker, the approach and the sit, the behavior layer, power states while docked, safety, cost, and heat at every step (hot servos at docking, charging heat in the body, the pack's charge temperature window, cooling on the dock, a 32 C room). It must work with today's pack and with a DeWalt pack (track 9). | phase 2 done 2026-11-05, acceptance not met yet (18/16/10 of 20; sim pass only). 2026-11-04 11:06 PM ET (D43): contacts, no wireless; behaviour code ported from osrf/autodock (Apache-2.0, fd9c2a9), the dock survey winner; 11:13 PM ET (D45): implement without a further go, simplest, cheapest, most reliable. 2026-11-05 1:29 AM ET (D46): precision and perception. 2026-11-05 about 3:40 AM ET: contacts on the chest (three strips on body_front, a sprung paddle that swivels +/- 10 deg), the port with 11 unit tests (software/dock/), the dock STLs (916 g, 67.0 h), the hardware gate with no microcontroller, the MCP73213 charger, heat at 25 and 32 C (cells at or under 45 C through every charge). The gym acceptance (20 seeds per floor, bar 19/20 within 3 tries and no fall), best run acc8: hard 18/20, train 16/20, soft 10/20, falls 0, 1, 10; every docked run has the pins inside their window. The soft floor falls because the stock policy falls on its first back pulse there. Options (twin/dock/DOCK_TWIN.md section 4.6): track 10's walk first, then a ramped dock mat, no retries on soft floors. 2026-11-05 about 3:50 AM ET: the duck-side dock parts in BOM.md (DK1 to DK5) and MOUNTING.md; no STL change for V1. 2026-11-05 about 4:35 AM ET: review fixes (PR 20: the undock's own timeout and detections, gates fail instead of being waived; PR 24: the sim's settle gain), acc10 re-run: the same 18/16/10 of 20; undock 19/19, 16/16 and 0/10 (on the soft floor every undock falls on the back pulses). 2026-11-05 about 8:00 PM ET, phase 3 (D50): awake while docked: a fourth contact carries the dock's 9 V, ORed with the pack at the 2813 input; the MCP73213 stays (4.3 h from empty, 2.4 h from 48 %, full in a 6 h night, calc only); cells at or under 45 C while charging with the duck awake at 25 and 32 C (sim pass only); +$8.74 on the duck, dock adapter price BLOCKER. 2026-11-05 about 10:50 PM ET (PR 24 review 4): the chest leads pass one 6.0 mm hole now printed in body_front with a 45 deg bell mouth inside (the drilled 4 mm hole could not pass the bundle); GND and SENSE branch at splices inside the trunk, so only the four pad conductors pass it (CAD check only) |
| 9 | battery option: DeWalt 20V MAX | Ahmed (9:37 PM ET): "I'm really trying to maybe replace the batteries with DCB200. It's a Dewalt. I think for 5 A, we're talking about 500 g, around that. You could do your research and spec". The DCB200 and its family against today's 2S P30B pack and simpler upgrades: specs, mass and centre of mass, the mount, the power path (15 to 20 V against 7.4 V servos), protection, charging on the dock, runtime, walk, falls, heat, cost. | running: phase 1 (research, spec, twin numbers); 2026-11-04 11:09 PM ET (D44): DCB200 rejected, pack to 2S1P Molicel P45B 21700 unless the study finds a better cell by the D45 criteria, bay resize here; 11:13 PM ET (D45): no tool-free swap (screwdriver job), implement without a further go |
| 10 | walk retrain for precision and agility (D46) | Ahmed (2026-11-05 1:29 AM ET): "If you need to train the walk, do so. The ducky, I really wanted to be extremely, good, agile." A walk policy for the V1 build (V1 inertials, STS3250 knees) that creeps, turns the same both ways and sidesteps both ways, so the dock's last mile and the soft floor work without turn, walk, turn back moves. | 2026-11-05: recipe merged in the shared lab gym (overlay gym/overlays/duck, PR 23: the run3 preset and a fail-closed precision eval, train/TRAIN.md); the training run waits on Ahmed's RunPod OK and the key. Then the dock acceptance is re-run with the new policy (gym/overlays/duck/dock/DOCK.md) |
| 11 | companion hardware (D47) | Ahmed (2026-11-05 ET): "if we call it, it would just look at the human"; a mic, the ear twist; "maybe we don't need the software stuff yet. I'm just trying to really cover the hardware." Which mics and how many give the voice direction in the small head, on the Pi Zero 2 W next to the MAX98357A; the antenna SG90s as ears; what turns the head to the caller. | done 2026-11-05 (twin/companion/COMPANION.md; D47): 2 x Adafruit 3421 SPH0645LM4H I2S mics ($13.90, BOM E8) on the side walls, 121.6 mm apart since the 2026-11-05 about 7:50 PM ET seat fix (was 120.5; 0.34 deg at the front, calc only), shared I2S clocks with the amp, data on GPIO20; 3 or 4 mics need a codec or USB array (one data pin carries 2 slots); seats in head.stl CAD check PASS; no radar, UWB, BLE or PIR. BLOCKERs: the 3421 page and the SPH0645LM4H datasheet not reachable, D14 and D15 3D routes, SG90 travel and speed, noise at the ports (bench). D48 (2026-11-05 about 5:25 PM ET): accuracy and self-noise pass, GPIO16 to the amp SD (half duplex), D14 and D15 routed, sheets rebuilt; BLE or UWB direction later, with a worn tag. D49 (2026-11-05 about 7:40 PM ET): the duck listens always; ego-noise removed by a motor-informed model, RNNoise and a wake word trained on the duck's own noise, a heavier enhancer on the home PC; motion gating only as the fallback; bench data plan TEST_PLAN 17 (380 min, about 9.0 GB raw); no new parts, no software yet. |
| freeze | pre-freeze cleanup (2026-11-06 ET) | Fix the standing drift and add the hardware Ahmed approved before the design freeze: mic seats into print/head.stl, the C1, C3 and E4 FAILs, the test order total, the speaker stand pilots; touch, the speaker duct, ears on hardware PWM, the cliff ToF, being picked up, one arbiter. | done 2026-11-06 (twin/freeze/FREEZE.md; D51 to D57): every check without the robot runs with no FAIL; CAD check only, calc only, sim pass only. |

## If we do not finish today
- This file is the plan, and it is merged, so it survives the box.
- Finished tracks are merged the same day, so their work survives too. A track still running when the box stops starts again from its question above.
- To resume in a new session: clone this repo (branch altaay-lab) and the shared lab repo (main), read this file and STATE.md, and start the first track that is not done.

## Anticipated problems not yet covered
The lead adds each track's list here, with the track that settles each one.
- From track 1b: the torque-on surge at power-up and microSD wear (track 3); the BEC dropout at half charge, the 5 V rail with every extra on, ESD on carpet (track 7); the Pololu 2813 losing its state on a short pack break (track 5, connector breaks under vibration).
- From track 2: the body_back pull on its wires at each battery service (track 4); wear of the lid screw holes, hand torque on the 25 mm bit, VHB cure time and the Loctite cure order in the build (track 2d); the 2813 button (NKK MB2011SS1W01) is out of stock at both stores read (an in-stock alternative before any order); the tie and tie mount masses (weigh 10 of each), then the final mass with the knee swap for the gym model and the RunPod training.
- From track 1b: at 2652.8 g the stock policy topples from 15 N standing pushes. Settled by the walk policy trained at our real mass (RunPod, STATE.md open question 1); track 3 checks that the real code does not make it worse.
- From track 2b: the cable rubs at head roll (D12, D13, P13) and at foot_side (SP4, SP5), B61 and B62 (track 4); the camera ribbon's real width and thickness (caliper at TO9); the Pololu 2813 OFF and A/B pad layout (read it on the board).
- From track 2c: a bench BAM test of one STS3250 at 7.2 V before the retrain; the STS3250's 60 C rated limit at a 32 C room (the thermal guard stays on); register 21 for the knees only, and the 1b guard with knee_budget.py (track 3).
- From track 2d: warm creep of the PLA lips and clips (track 6), rattles feeding the IMU and plugs or screws loosening (track 5), wear of the lid screw threads at each service, the fit of the new tongue, lips and clips (coupons K1 to K4), the KK 254 housing price (BLOCKER).
- From track 11 (D47 to D49): the ego-noise levels and spectra of the servos, ears and footsteps, the mic overload point, the direction error while walking, and the Pi Zero 2 W CPU time of the walk policy, RNNoise, the wake word and the face detection (TEST_PLAN 17 and a bench CPU run); the mic boards (BOM E8) are not bought.
