aaltaay/Open_Duck_Mini_v2/altaay_lab/redteam/VERDICT_2026-11-13.md

# Red team verdict, 2026-11-13

A skeptical read of what merged into altaay-lab on 2026-11-13 and 2026-11-14, and of the twin those merges sit on. The question is whether we are deceiving ourselves. Nothing here was measured on a servo, a cell, a board, or a printed part. Nothing was bought.

Labels used below: sim pass only, calc only, CAD check only, cited, BLOCKER. A sim pass only number is a model output. A calc only number is arithmetic. Neither is a duck.

## Verdict in plain words

We know the file history, the cited datasheet windows we actually opened, and which model bugs we caught because a reviewer or a rerun tripped over them. We believe a 3S pack, a 12 V servo, a Castle set to 12.0 V, a 55 C rest, PETG knee sheets, and three limb breakers will make a walking duck. That belief is a stack of sims and assumptions. Gate 0 is open. The twin does not match a real duck, and the bill cannot be ordered as one consistent duck.

The straight-wire ranking is a study. Ahmed kept the regulator on 2026-11-13 at 10:18 PM ET (D64): "we definitely need regulator and all the nice stuff so we study it properly". The adopted rail is the Castle CC BEC Pro at 12.0 V (D63), checked by verify/check_power_limits.py. The wire is not the rail to build.

## What landed, and what not to quote

PRs 84, 83, 85, 86, and 87 merged as merge commits. PR 87's first commit, 6d8c153, logged joint current and then ran the knee heat with two bugs: a fall time stored as a list, and a thermal step of 0.5 s on current bins of 0.1 s, so four bins of every five never heated the model. The heat clocks in that commit, and the same clocks in the PR 87 description, are UNRELIABLE. Do not quote them.

Those unreliable clocks were: reading 55 C at 1.22 min, 60 C at 1.43 min, case peak 61.41 C, 32 C case peak 62.14 C, guard walk share 0.142 at 25 C and 0.090 at 32 C, guard case peaks 50.44 C and 51.20 C. History was not rewritten. Commit a0e2251, which merge 89da799 brought in with 6d8c153, is the correction: the first fall time is a scalar, and each current bin is one thermal step. The CPU rerun of that correction is the table in problems/RUNC_JOINT_CURRENT.md.

The corrected design row, 0.15 m/s typical, 10 min current, central corner, cut at 70 C, 25 C room, sim pass only: reading 55 C at 1.16 min, 60 C at 1.37 min, case peak 61.06 C, case at 49 C at 1.40 min. At 32 C the case peaks at 61.90 C and does not reach 62 C. The 55/45 guard walk share is 0.140 at 25 C and 0.090 at 32 C. Guard case peaks are 50.31 C and 51.01 C. The 32 C guard cooled over the last 10 min of the 90 min run. Right-knee motor RMS on the 60 s typical walk is 1.551 A (sim pass only).

Fixing the skip moved the 55 C clock by a few seconds. It did not remove it. The one-minute knee is still what this model prints. See the implausible-numbers section.

## Claims that are not hardware

Sim pass only, not a bench pass:

- Every walk speed, pack current, and per-joint current in the run C log, including 0.1233 m/s and 8.132 A pack peak at 0.15 m/s typical against the PR 85 print of 0.1183 m/s and 8.114 A.
- Every temperature and walk share in the thermal twin, including the corrected 1.16 min and the older knee-heat clocks (60 C in 3.33 min on the backlash log, body 94.67 C with the cut disabled).
- The 55/45 guard shares in PR 86 (0.388 at 25 C and about 0.20 at 32 C on the Kt-scaled old log) and the corrected run C shares above.
- MuJoCo trunk masses after the mass write: wire about 1.0994 kg, Castle kept about 1.1354 kg. The check that MuJoCo reads the file is sim pass only.
- Structure margins, sit counts, and dock seat counts elsewhere in the twin. They were not re-run for this verdict. They stay sim pass only or FEA pass only, as their own notes say.
- The 2S power-path gate that still fails in verify: a servo under 6.0 V for 11.1 percent of a nominal walk (sim pass only). That fail was already in VERIFICATION.md before these merges. It is the 2S model, not a new 12 V result.

Calc only:

- Winding resistance 3.753 ohm: C018 stall line 4.444 ohm times the C001 winding share 2.5/2.96. The C018 page does not print a separate winding resistance.
- Torque constant scale Kt 7.4 V over Kt 12 V, about 0.702, used to map an old log onto the 12 V servo.
- Dropout loss equals current times 0.30 V. Regulating loss equals output power times (1/0.85 - 1).
- eFuse blanking 150 ms to 557 ms at 600 nF, from the cited ITIMER current and voltage delta.
- Chafe current 11.46 A at 12.6 V and 1.00 ohm, and 131.3 W in the nick.
- Fuse percent-of-rating rows. The time windows are cited. The percents are calc only.
- Run time in twin/battery/BATTERY_STUDY.md: 39 walking minutes and 50 minute sessions for a 2S1P P45B (calc only on a twin run). No reserve is stated. That figure is not a 3S walk and not a measurement.

CAD check only:

- Placements and sheet routes that the lab already marks that way. The three limb breakers have no 3D route. Cable EF is no_route. They are not in series with SP1 to SP5.

Cited:

- Castle output window used as the gate: 4.9 V to 12.5 V on the chart, and 4.8 V to 12.5 V in POWER.md. 12.0 V is inside both. 16 V is outside both.
- C018 page range 4 V to 14 V, and Waveshare 6 V to 12.6 V. The PDF that prints 12.0 V as both minimum and maximum was not adopted.
- P45B discharge 0 C to 60 C. PLA low-edge HDT 49 C. PETG HF 62 C at 1.8 MPa and 69 C at 0.45 MPa.
- TPS259827 window in SLVSFE7, including ILIM 7.23 A to 9.07 A over temperature at 182 ohm.
- ATOF fuse time-current windows used in the knee-heat note.
- Robo9 / STS3215 C018 bench curve cited in twin/thermal/THERMAL_TWIN.md: about 48 C to 60 C in 40 to 50 minutes under an oscillation, not under this walk.

Assumed, and still BLOCKER until a bench replaces them:

- Castle dropout 0.30 V. Castle does not publish it.
- Castle efficiency 0.85. Castle does not publish it.
- What the Castle does when the input is below the set point. The sim follows input minus 0.3 V. The part might shut off.
- C018 operating temperature and torque-off current. The 60 C line, the 70 C cut, and the 21 mA idle are the C001 sheet.
- The 3.753 ohm split.
- Knee-sheet creep at about 4.3 MPa (the structure twin's standing stress, itself sim pass only).
- Whether 600 nF is under the TPS25982 startup limit. The Pi pin for power-good. Normal-walk time above 7.23 A.
- 2S protection board and 2S charger on a 3S pack. See below.

## Numbers that look implausible

Knee 55 C in about one minute at about 1.5 A RMS. After the bin fix the model still says 1.16 min to a 55 C reading at 1.551 A RMS (sim pass only). The unreliable draft said 1.22 min. The only published clock we cited for this servo family, the Robo9 oscillation, took on the order of 40 to 50 minutes to climb from about 48 C to 60 C (cited, THERMAL_TWIN.md). That hold is not this walk, and it does not look like one minute. Until one servo is logged on the bench, the one-minute knee is a model output we should not believe as a hardware time.

The 3.753 ohm winding. It is an assumed share of a stall line, not a measured resistance. Copper heat scales with it. If the winding is softer or stiffer, the one-minute clock moves. Calc only, and BLOCKER as a C018 fact.

The 0.85 regulator efficiency. Used when someone asks what a buck would dissipate. At the STS12 current that hypothetical is about 10 W and a case near 172 C (sim pass only, the playbook). The walk itself is modeled in dropout, at about 1.44 W and about 61 C (sim pass only). Quoting 0.85 as if Castle measured it is how a scary case temperature gets invented. BLOCKER.

The 0.30 V dropout. The whole "regulates only above 12.3 V" sentence hangs on it. Full pack is 12.6 V (calc only, 3 times 4.2 V). If the real dropout is larger, or the part shuts off, the 12.0 V set point does not mean 12.0 V at the servo for any useful part of the discharge. BLOCKER.

The 50 minute run time with no reserve. BATTERY_STUDY.md prints 50 minute sessions and 39 walking minutes for a 2S P45B (calc only). No reserve, no 3S measurement, no heater, no failed-cell margin. A home duck that plans on 50 minutes is planning on that calc.

## Model bugs found today, and what they say

16 V set point. The first 3S walks told the solver to regulate at 16 V. That is outside the cited 4.8 V to 12.5 V output. The sim then spent the walk in dropout, which looks like a wire, and the files talked as if 16 V were a Castle setting. PR 84 moved the 3S studies to 12.0 V and left the shared 2S default at 7.2 V. The behavior below the set point is still unpublished. A legal set point is not a measured regulator.

Mass patch not reaching MuJoCo. PR 85 edited the trunk inertial in memory and did not write the file. MuJoCo loaded the unpatched trunk, so the Castle-on and Castle-off walks were the same body. The identical speed and current were not a physics result. PR 87 wrote the file and the digits moved (sim pass only). Any earlier "we removed the part and the walk did not change" line from that patch has the same hole until someone checks the loaded body mass.

Thermal bins skipped. Commit 6d8c153 advanced the thermal model at 0.5 s and sampled the schedule once per step. The walk bins are 0.1 s. Four of five bins were skipped. A repeating pattern of one hot bin and four cold bins can be held at the hot value for the whole step. The fall list bug is the twin of that: the code looked fine on the walks that did not fall, and it crashes when one does. No logged walk in that set fell, so the crash did not show up in the table. The heat bug did show up, and only because the clocks were regenerated after the step was changed.

That is the point. These bugs lived in code that had already printed a confident table and a pull-request description. Passing a self-check on the walks that do not fall, or publishing a temperature to two decimals, did not prove the integrator. Other callers of twin_thermal.simulate still default to a 0.5 s step (knee_heat_chafe.py, thermal_cases.py, gate_p45b.py). Their inputs are not all 0.1 s bins, so they are not automatically the same four-out-of-five skip, and they were not re-audited bin by bin for this note. A second untested script can be wrong in the same quiet way. Treat every thermal clock that was not regenerated after a bin-width check as untrusted, including the 6d8c153 set, which is UNRELIABLE.

## Parts still on the old 2S components

The walk pack in the netlist domain is 9.0 V to 12.6 V. The protection board on the netlist is still the Tenergy 32175, a 2S board whose over-charge point is about 8.61 V (cited). The charger on the netlist is still the 8.4 V 2S board. D62 still describes that 2S charger on a 2S pack. D61 was not edited, and this verdict does not edit it. A 3S pack on a 2S protector is not a finished power path. check_power_limits.py prints both as open items. They are BLOCKER for gate 0 electrical, not a footnote.

The limb breakers, the PETG knee sheets, and the 55 C rest rule are now written down (netlist cable EF, part_limits, FMEA). The breakers are not in series with the live feeds. The slicer profile for those sheets is still PLA (D22). The rest rule is not the code on the Pi. Writing the row is not installing the part.

## Top 5 measurements

These five would cut more uncertainty than another sim pass.

1. One STS3215 bench heat and current test. Hold a C018 near the logged knee RMS, about 1.5 A, at the voltage the rail actually delivers, and log Present Temperature and current until 55 C or 30 minutes. That is the measurement that tells us whether 1.16 min is the servo or the model.
2. Castle at a 12.0 V set point, input swept from 12.6 V down to 9.0 V at a few amps. Does it hold 12.0 V, pass the input through, or shut off? That replaces the 0.30 V dropout and the 0.85 efficiency, or shows they were the wrong model.
3. Cold resistance of one C018 winding, next to a stall-current measurement at a known voltage. That confirms or throws out 3.753 ohm.
4. One limb's supply current during a real walk, as a time above 7.23 A, not as a 100 ms average. That is the blanking check for the TPS259827. Until it exists, nuisance trip is BLOCKER.
5. Rested full-pack voltage and a few minutes of pack voltage and current on a real 3S walk. That puts a clock and a voltmeter on the dropout claim and on the 50 minute calc, which has no reserve.

## Gate 0

Open. DEFINITION_OF_DONE.md: the duck is not printed, the pack is not welded, and the full order is not placed before gate 0 passes. Gate 0 needs the twin and the bill to describe the same duck. They do not. The thermal twin, the run C walk, and the structure twin are sim pass only. The netlist still carries a 2S protector and a 2S charger beside a 3S domain. The regulator we kept has no measured dropout. The heat clock we quote was, in the commit that first published it, an integrator bug. The corrected clock is still only a sim. Gate 0 has not passed.
