aaltaay/Open_Duck_Mini_v2/altaay_lab/compliance/DOMESTIC_CONTENT.md

# Domestic component share for one duck

This is not legal advice. A lawyer has to apply the test. Nothing was bought. No one was contacted. A sentence is quoted only from a page that was opened. A number is marked cited, calc only, or BLOCKER.

The walking duck is the end product in this worksheet. Tools, the controller, process aids, and the nest are not components of that article. Nest lines stay on the order. They are not in the share. If the duck and the nest are sold as one article, a lawyer adds the nest lines, and most of those lines have no price.

## What the test requires

DA 26-786, opened as text this session, accepts the definition and does not restate the arithmetic in the body. Cited from that text:

"We accept the National Security Determinations' definitions of "foreign-produced," "power inverters," and "advanced robotic devices," as provided in the Appendices below."

https://docs.fcc.gov/public/attachments/DA-26-786A1.txt

The appendix text is not in that text file. The FCC FAQ states the definition in words. The FAQ page was opened this session. It says it was updated Tuesday, October 27, 2026. Cited from the question "What constitutes "foreign-produced"? Is there a content threshold?":

"For the purposes of "foreign-produced advanced robotic devices," the term "foreign-produced" refers to any article that would not qualify as a "domestic end product," as that term is defined in 48 CFR § 25.101(a). The FCC's Covered List therefore tracks this language."

The same answer says the test has two prongs. Cited:

"The device must be "manufactured in the United States" and "the cost of domestic components shall exceed 65 percent for items delivered in calendar years 2024 through 2028 and 75 percent for items delivered starting in calendar year 2029.""

Cited from the same answer:
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
