aaltaay/Open_Duck_Mini_v2/altaay_lab/cables3d/cables_detail.png

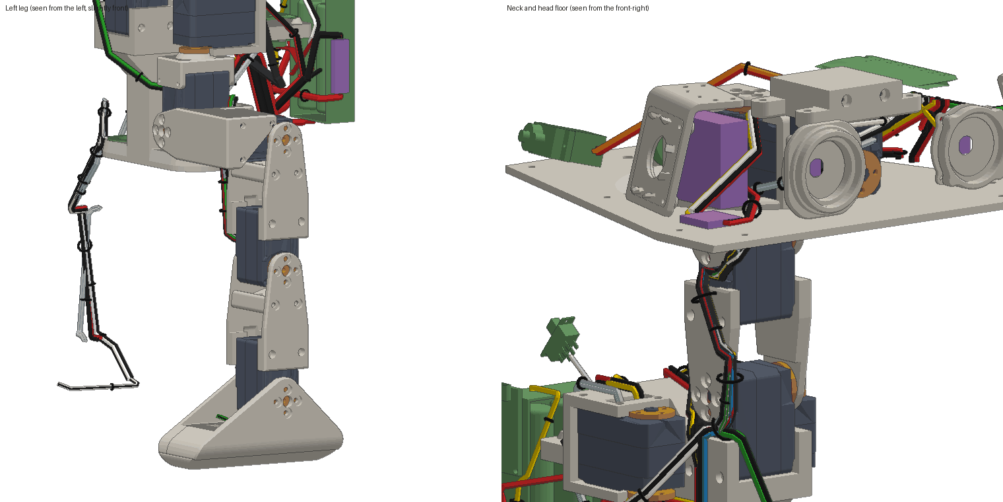
altaay_lab/cables3d/cables_detail.png
