aaltaay/Open_Duck_Mini_v2/altaay_lab/cad/dfa/dfa_before_after.png

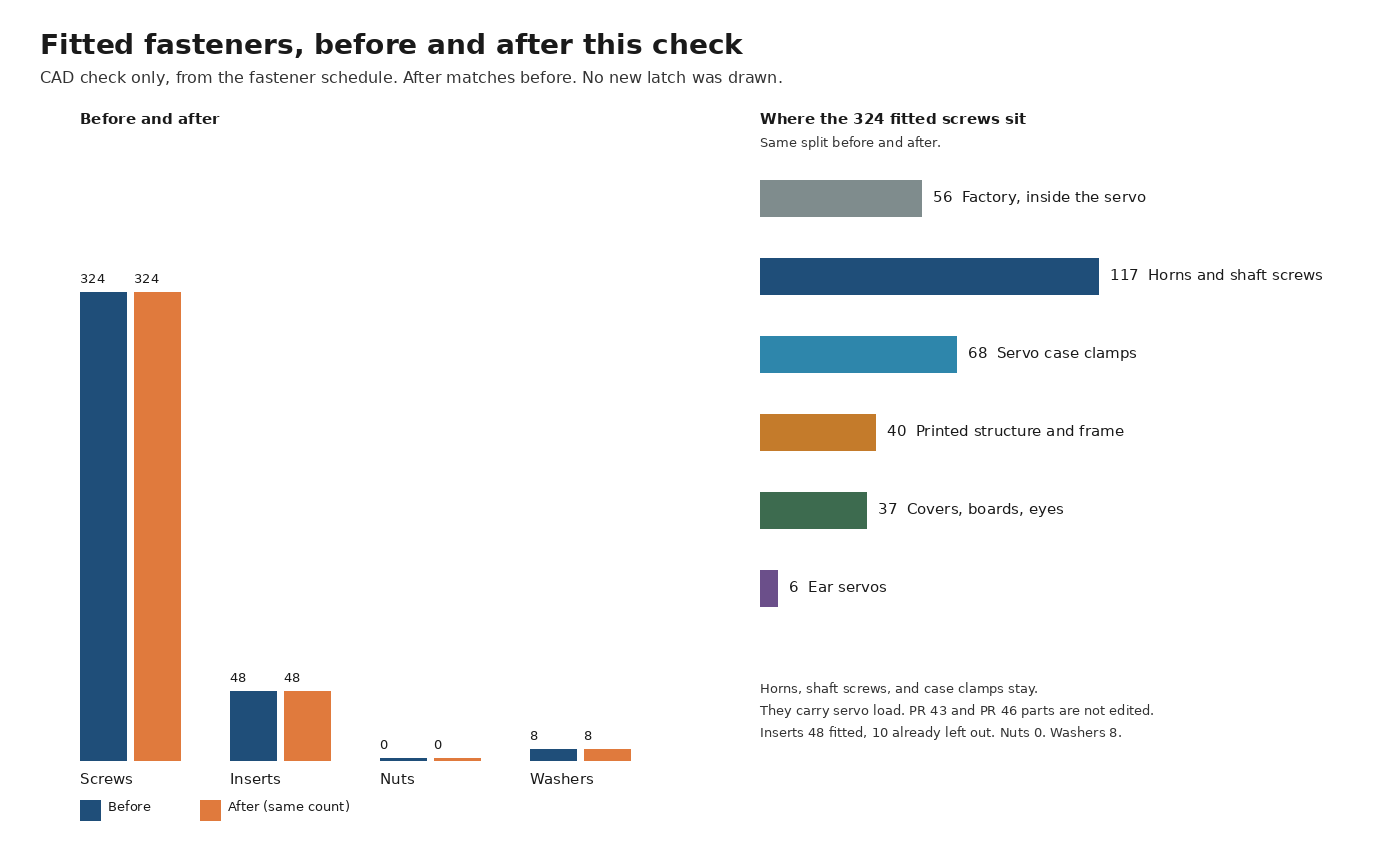
altaay_lab/cad/dfa/dfa_before_after.png
