aaltaay/Open_Duck_Mini_v2/altaay_lab/cad/nest_v2/renders/mat_top.png

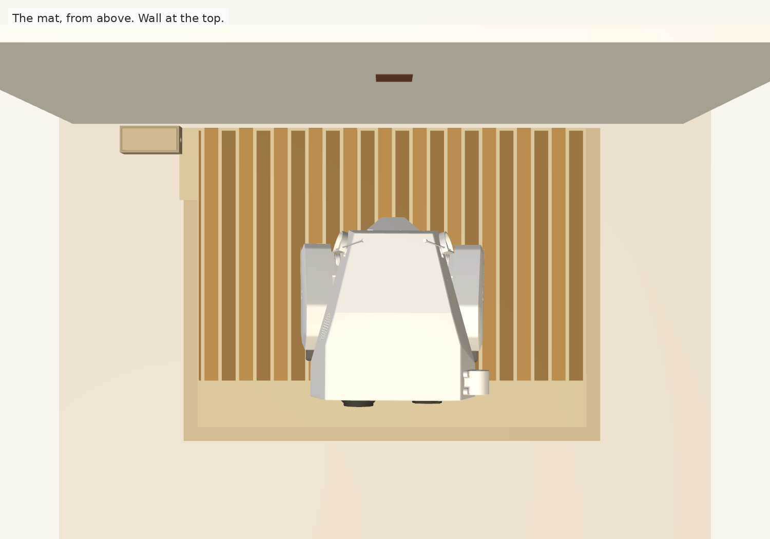
altaay_lab/cad/nest_v2/renders/mat_top.png
