aaltaay/Open_Duck_Mini_v2/altaay_lab/cad/nest_v2/renders/sit_front.png

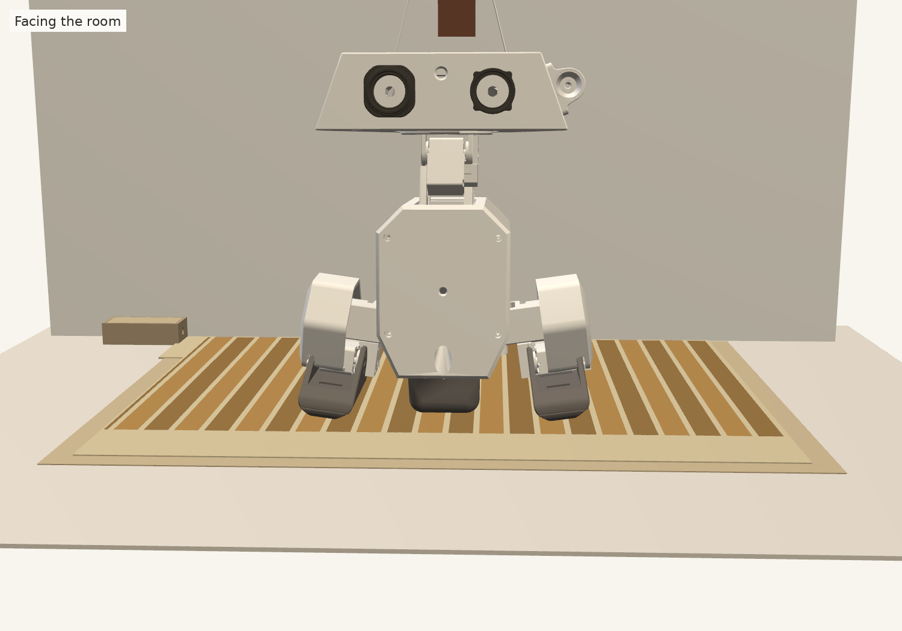
altaay_lab/cad/nest_v2/renders/sit_front.png
