aaltaay/Open_Duck_Mini_v2/altaay_lab/cad/nest_v2/renders/sit_three_quarter.png

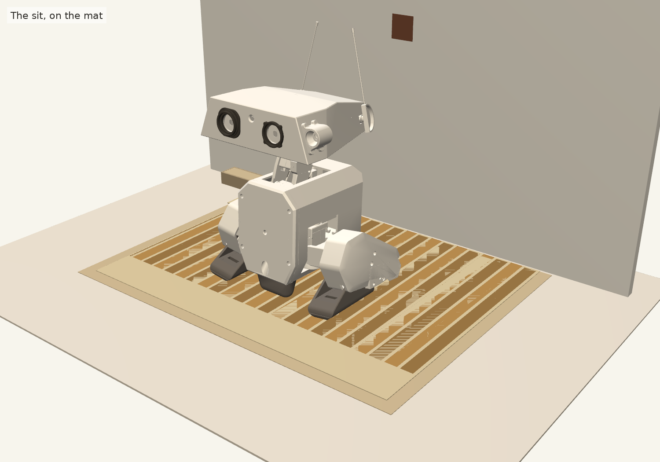
altaay_lab/cad/nest_v2/renders/sit_three_quarter.png
