aaltaay/Open_Duck_Mini_v2/altaay_lab/fasteners/fasteners_exploded.png

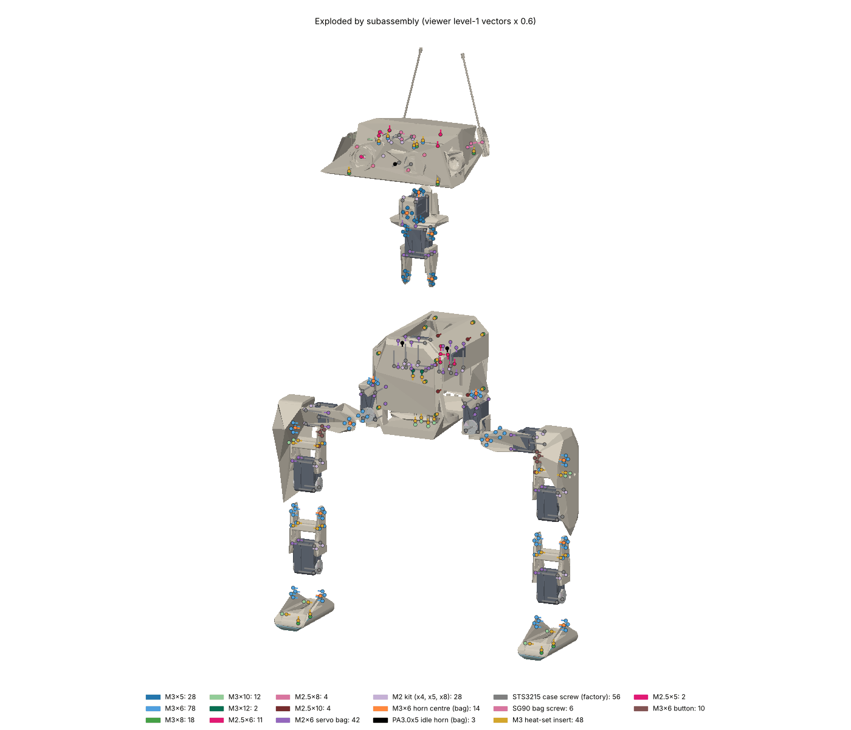
altaay_lab/fasteners/fasteners_exploded.png
