aaltaay/Open_Duck_Mini_v2/altaay_lab/sim/added_mass_forward_walk.png

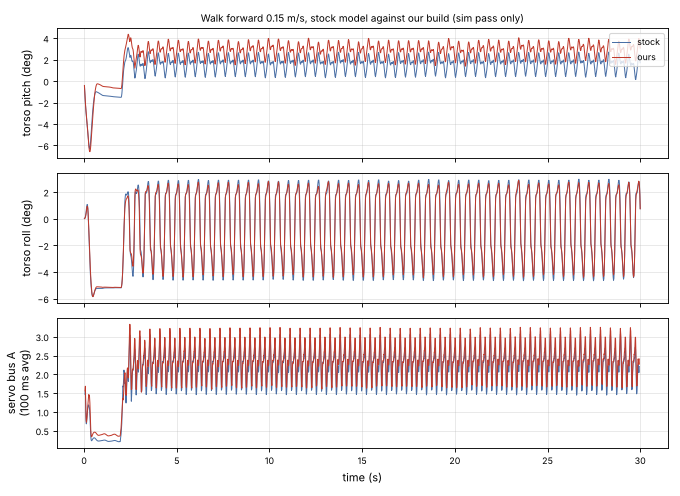
altaay_lab/sim/added_mass_forward_walk.png
