aaltaay/Open_Duck_Mini_v2/altaay_lab/sim/added_mass_margin_sweep.png

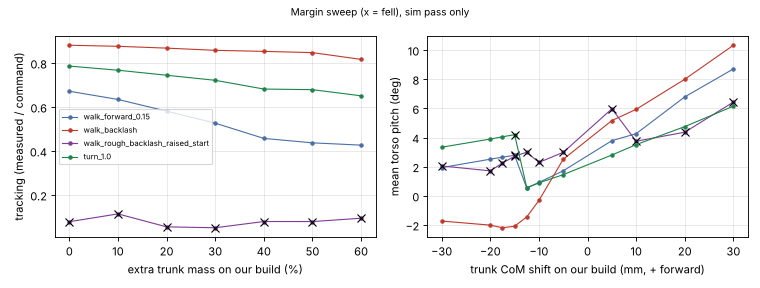
altaay_lab/sim/added_mass_margin_sweep.png
