aaltaay/Open_Duck_Mini_v2/altaay_lab/sim/mass_budget.png

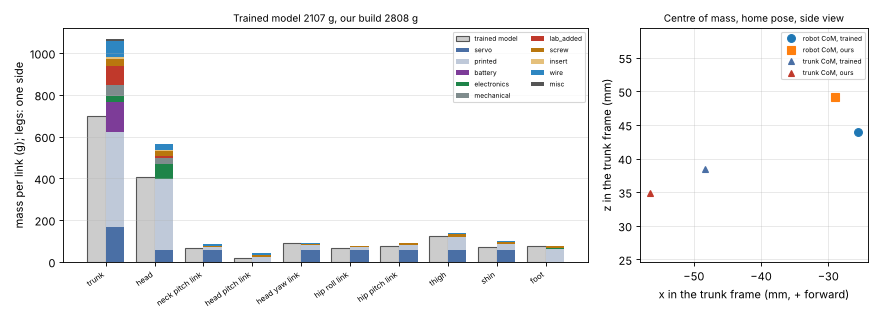
altaay_lab/sim/mass_budget.png
