aaltaay/Open_Duck_Mini_v2/altaay_lab/sim/odm_v2_power_path_voltages.png

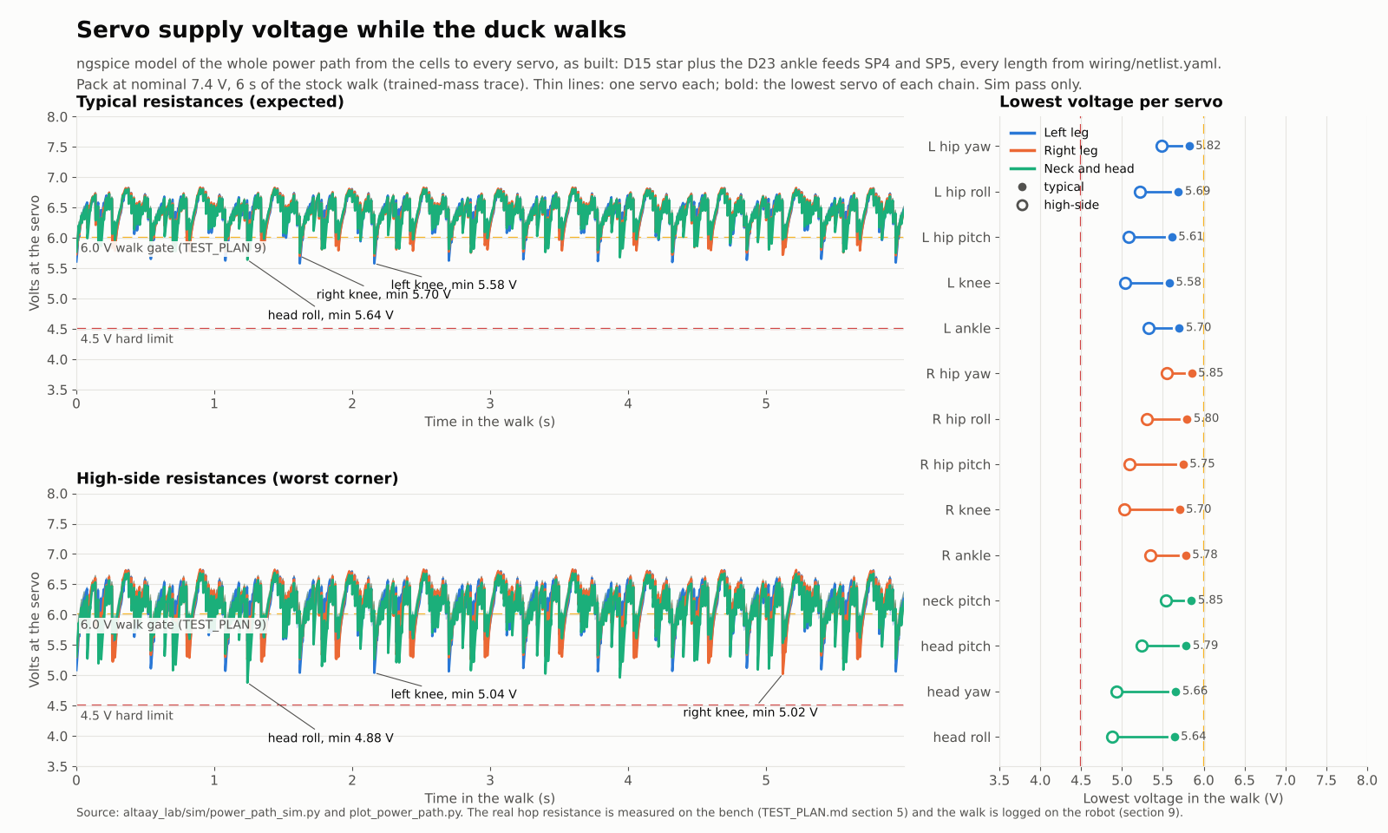
altaay_lab/sim/odm_v2_power_path_voltages.png
