aaltaay/Open_Duck_Mini_v2/altaay_lab/sim/odm_v2_stock_walk_still_17s_turn.png

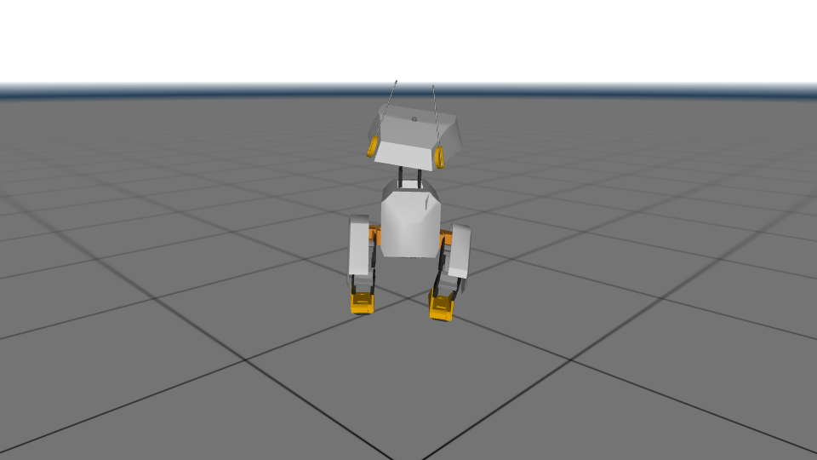
altaay_lab/sim/odm_v2_stock_walk_still_17s_turn.png
