aaltaay/Open_Duck_Mini_v2/altaay_lab/sim/runtime_thermal.png

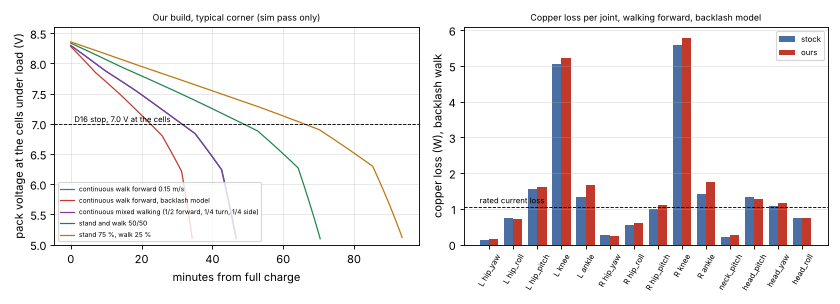
altaay_lab/sim/runtime_thermal.png
