aaltaay/Open_Duck_Mini_v2/altaay_lab/twin/camera/figs/floor_stand.png

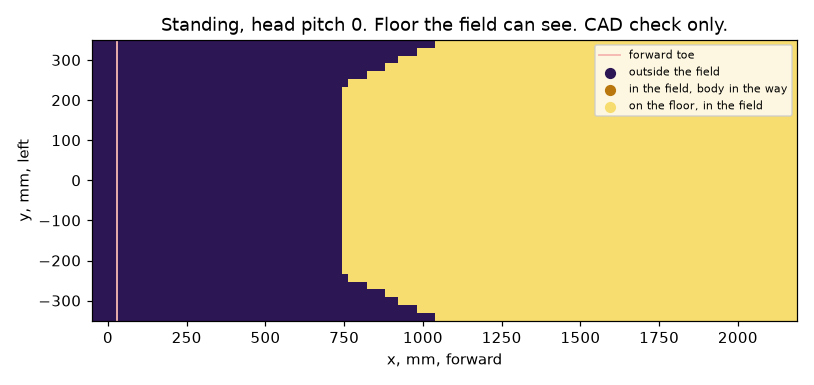
altaay_lab/twin/camera/figs/floor_stand.png
