aaltaay/Open_Duck_Mini_v2/altaay_lab/twin/camera/figs/pixels_range.png

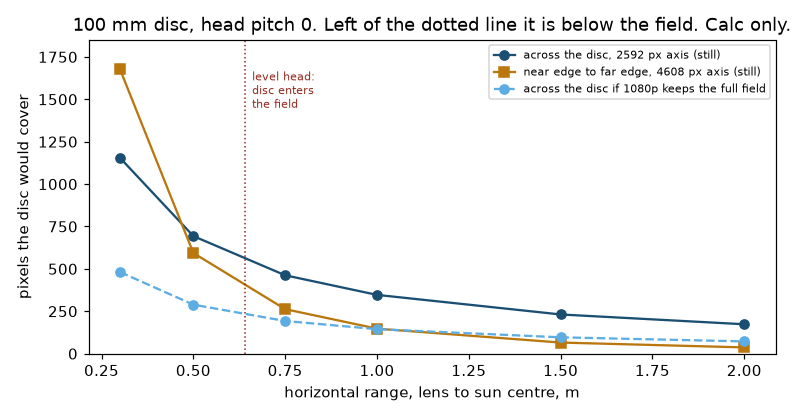
altaay_lab/twin/camera/figs/pixels_range.png
