aaltaay/Open_Duck_Mini_v2/altaay_lab/twin/camera/figs/side_cone.png

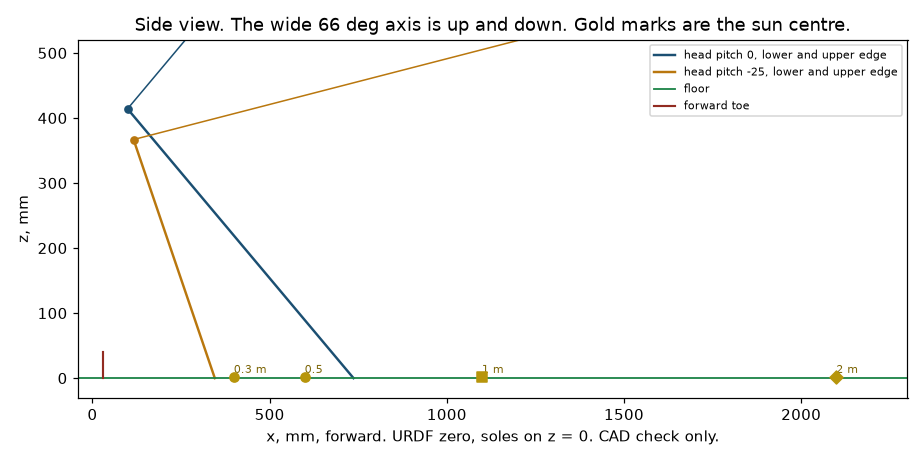
altaay_lab/twin/camera/figs/side_cone.png
