aaltaay/Open_Duck_Mini_v2/altaay_lab/twin/companion/mic_seat_left.png

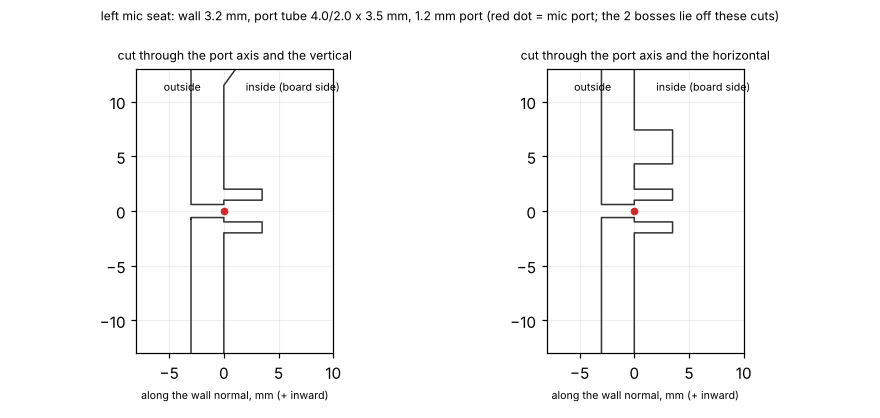
altaay_lab/twin/companion/mic_seat_left.png
