aaltaay/Open_Duck_Mini_v2/altaay_lab/twin/companion/mic_section.png

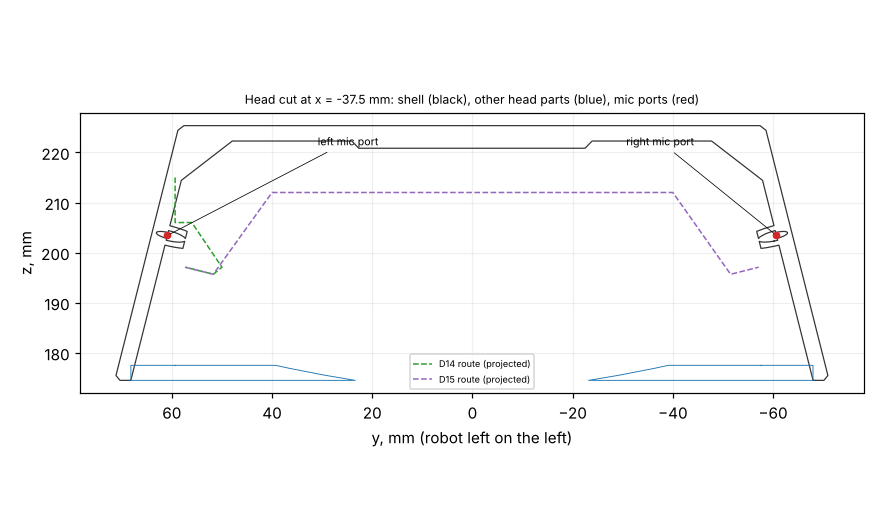
altaay_lab/twin/companion/mic_section.png
