aaltaay/Open_Duck_Mini_v2/altaay_lab/twin/dock/blind/F1_blind.png

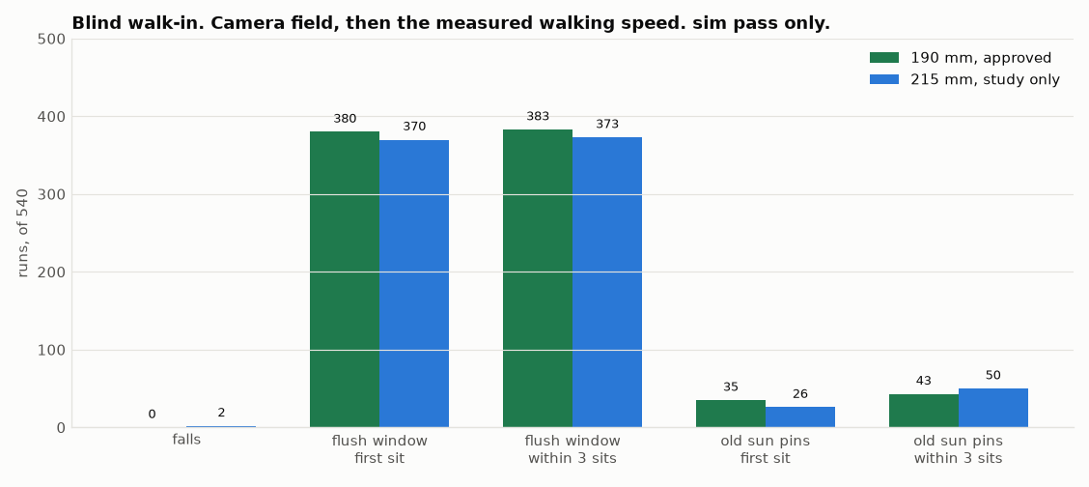
altaay_lab/twin/dock/blind/F1_blind.png
