aaltaay/Open_Duck_Mini_v2/altaay_lab/twin/dock/closeup/F1_closeup.png

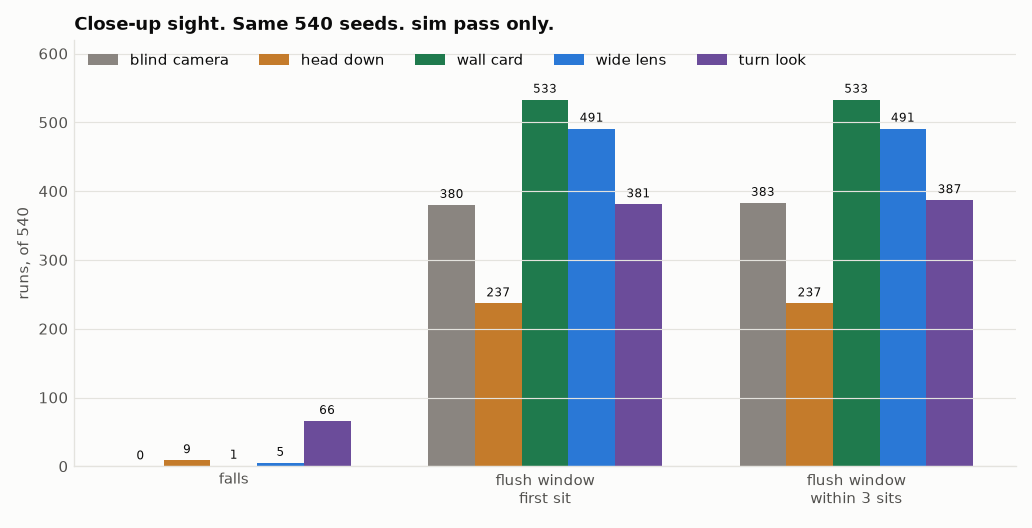
altaay_lab/twin/dock/closeup/F1_closeup.png
