aaltaay/Open_Duck_Mini_v2/altaay_lab/twin/dock/dock_seats.png

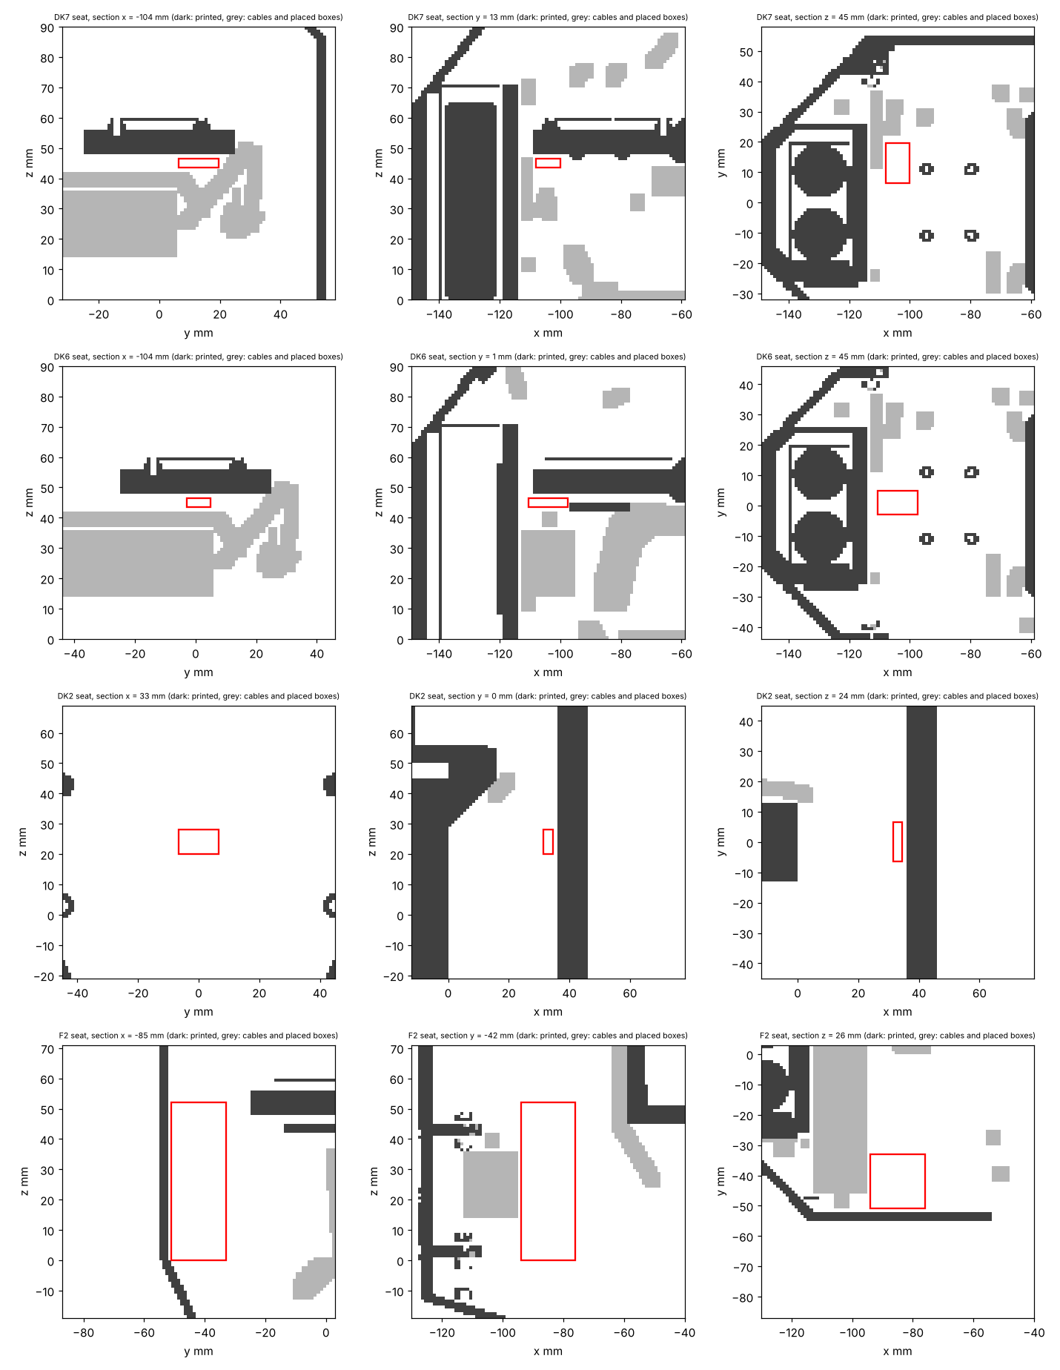
altaay_lab/twin/dock/dock_seats.png
