aaltaay/Open_Duck_Mini_v2/altaay_lab/twin/dock/flush/figs/F1_belly_field.png

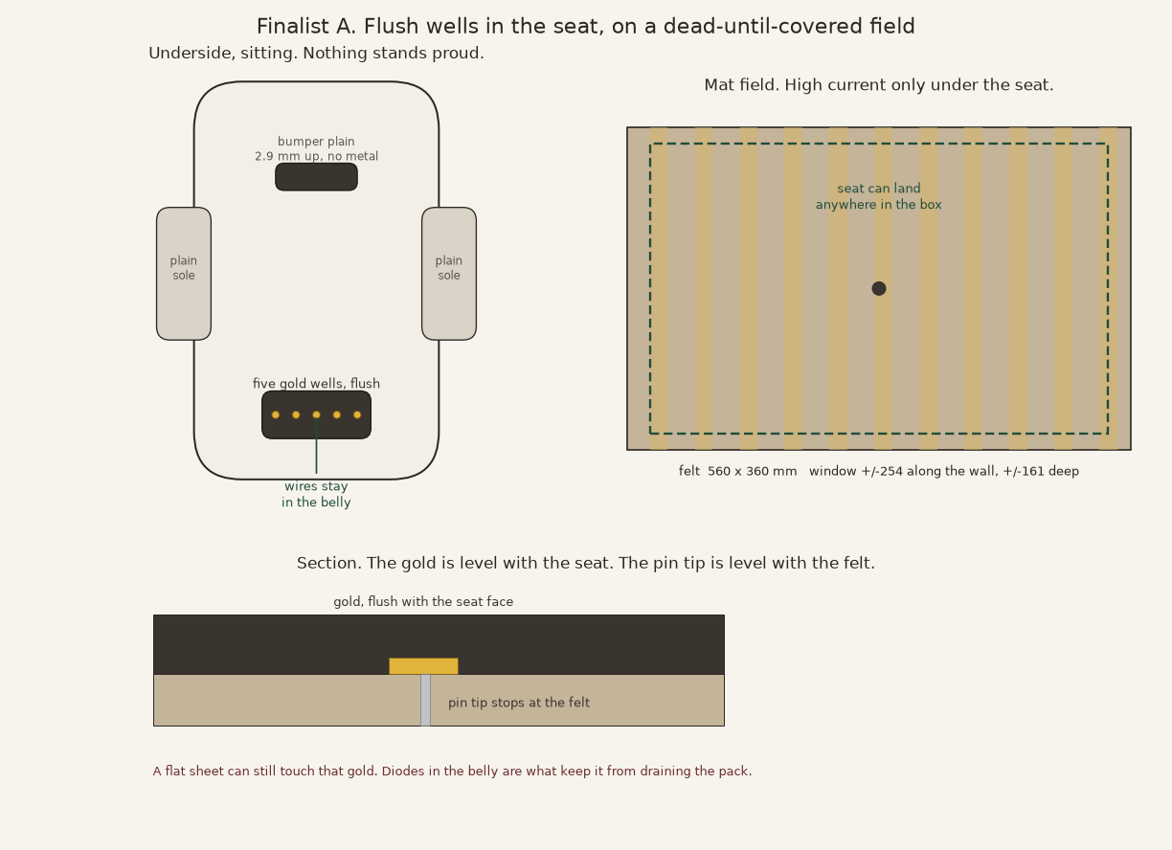
altaay_lab/twin/dock/flush/figs/F1_belly_field.png
