aaltaay/Open_Duck_Mini_v2/altaay_lab/twin/dock/flush/figs/F2_feet_zones.png

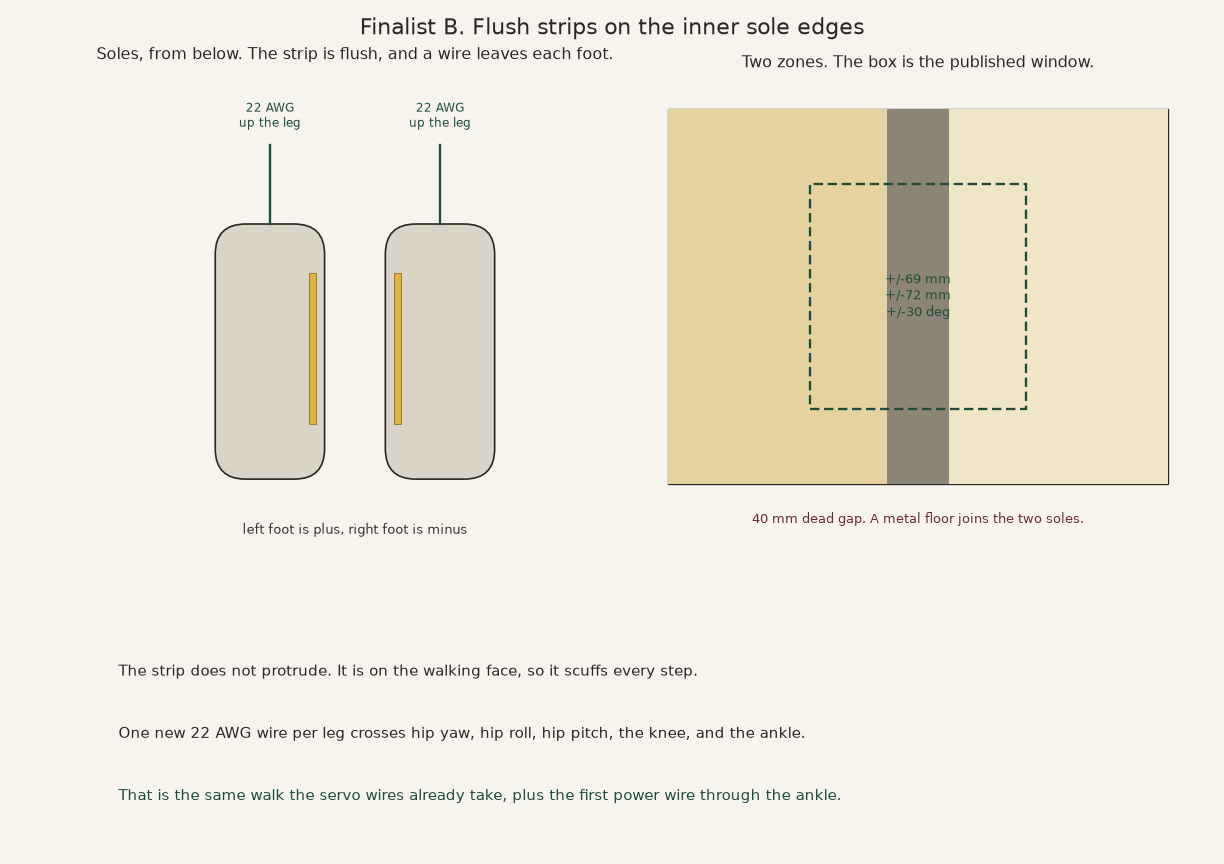
altaay_lab/twin/dock/flush/figs/F2_feet_zones.png
