aaltaay/Open_Duck_Mini_v2/altaay_lab/twin/dock/nest/A1_nest_sun_side_top.png

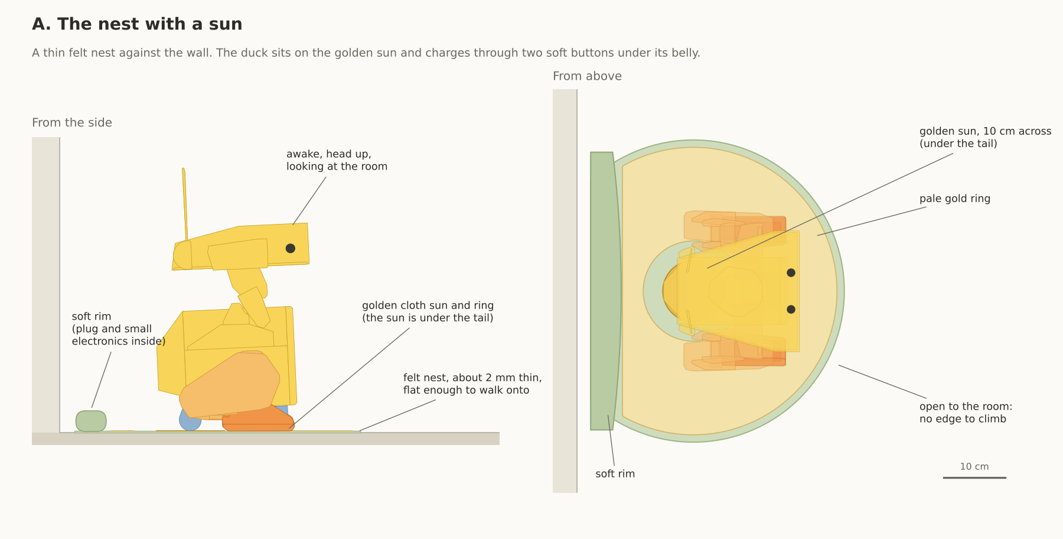
altaay_lab/twin/dock/nest/A1_nest_sun_side_top.png
