aaltaay/Open_Duck_Mini_v2/altaay_lab/twin/dock/nest/A2_nest_sun_approach.png

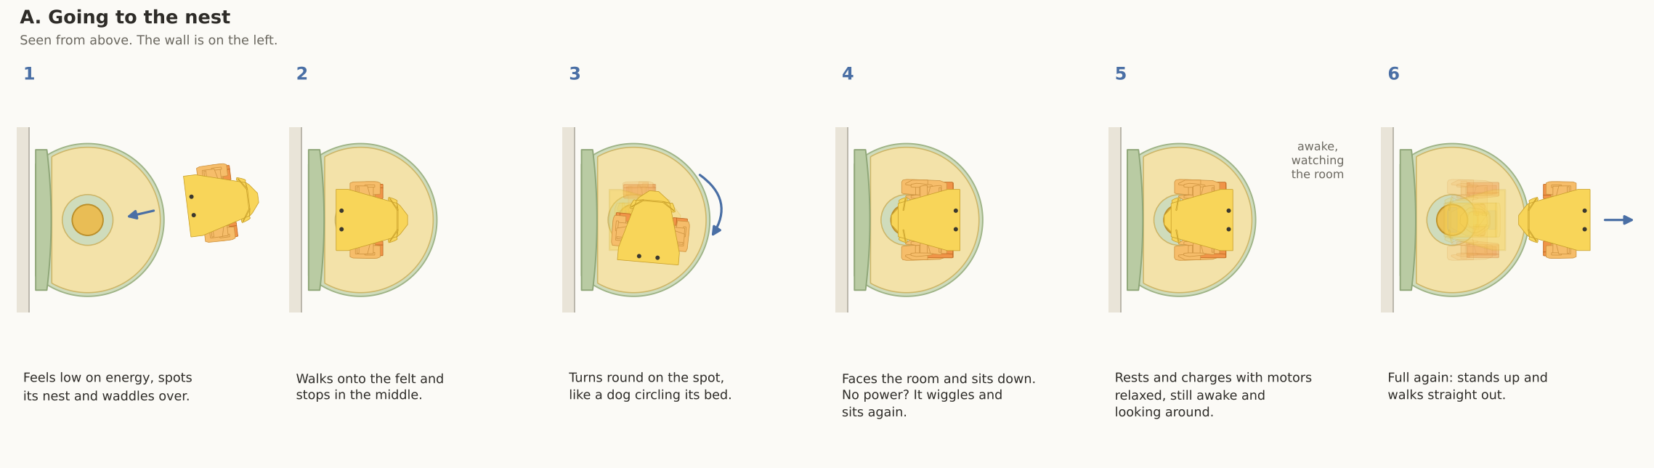
altaay_lab/twin/dock/nest/A2_nest_sun_approach.png
