aaltaay/Open_Duck_Mini_v2/altaay_lab/twin/dock/nest/A3_nest_sun_technical.png

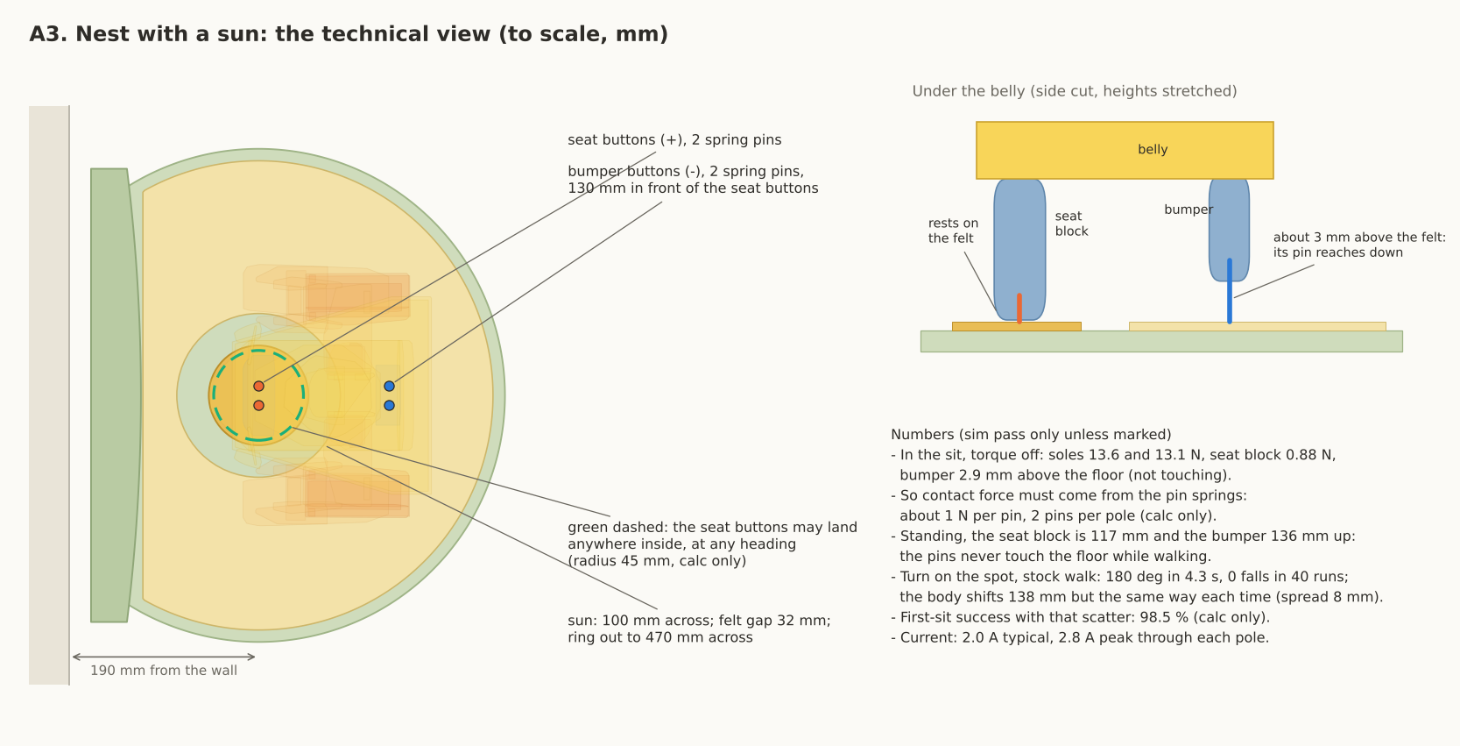
altaay_lab/twin/dock/nest/A3_nest_sun_technical.png
