aaltaay/Open_Duck_Mini_v2/altaay_lab/twin/dock/nest/B1_pond_rug_side_top.png

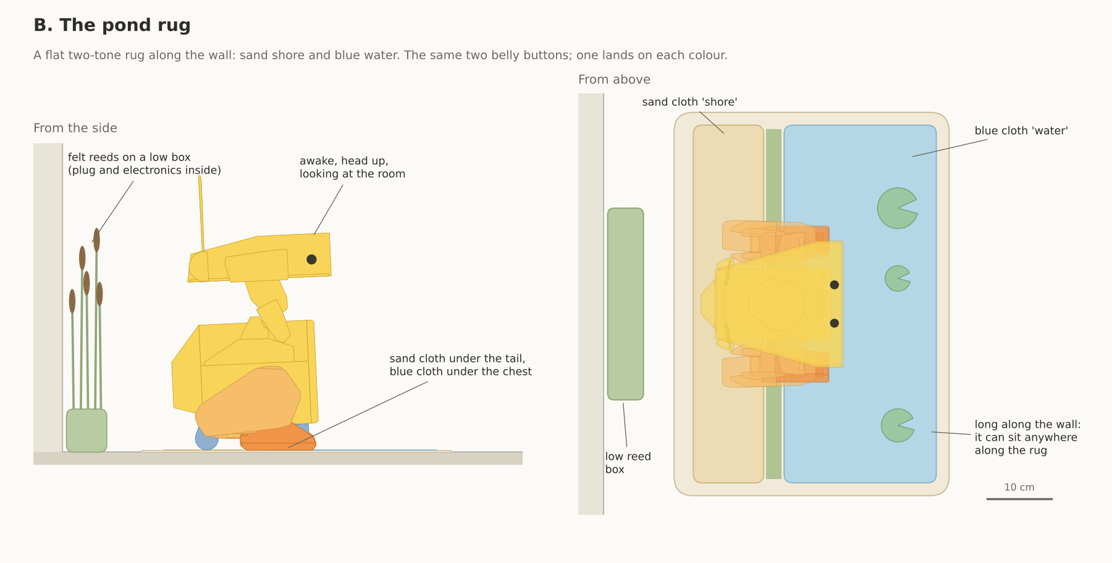
altaay_lab/twin/dock/nest/B1_pond_rug_side_top.png
