aaltaay/Open_Duck_Mini_v2/altaay_lab/twin/dock/nest/B2_pond_rug_approach.png

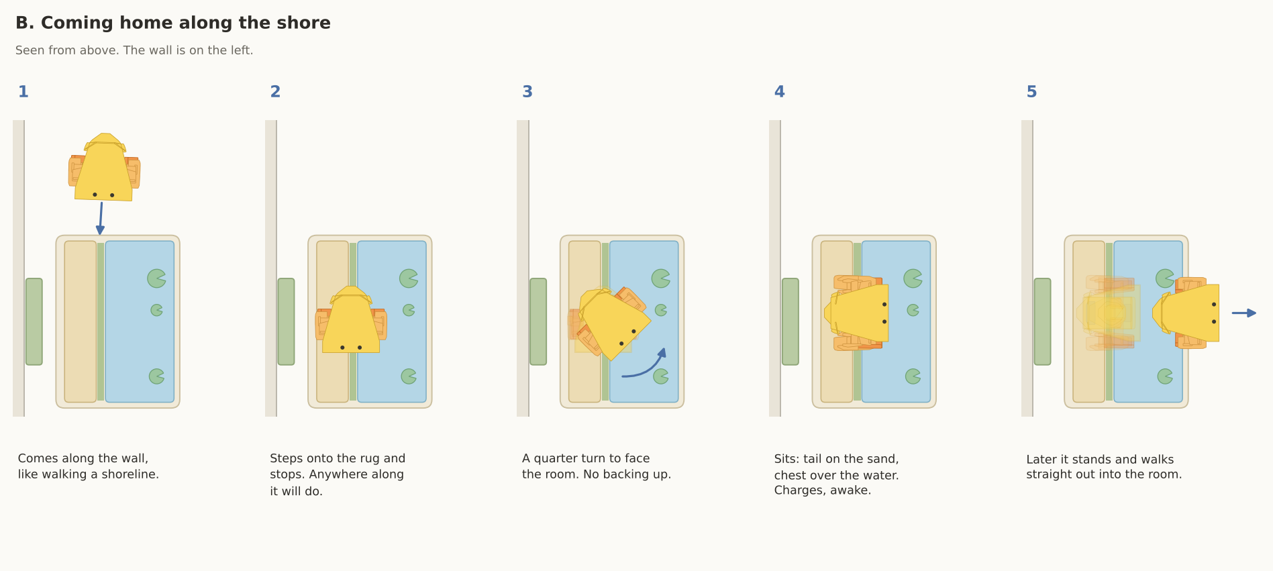
altaay_lab/twin/dock/nest/B2_pond_rug_approach.png
