aaltaay/Open_Duck_Mini_v2/altaay_lab/twin/dock/nest/B3_pond_rug_technical.png

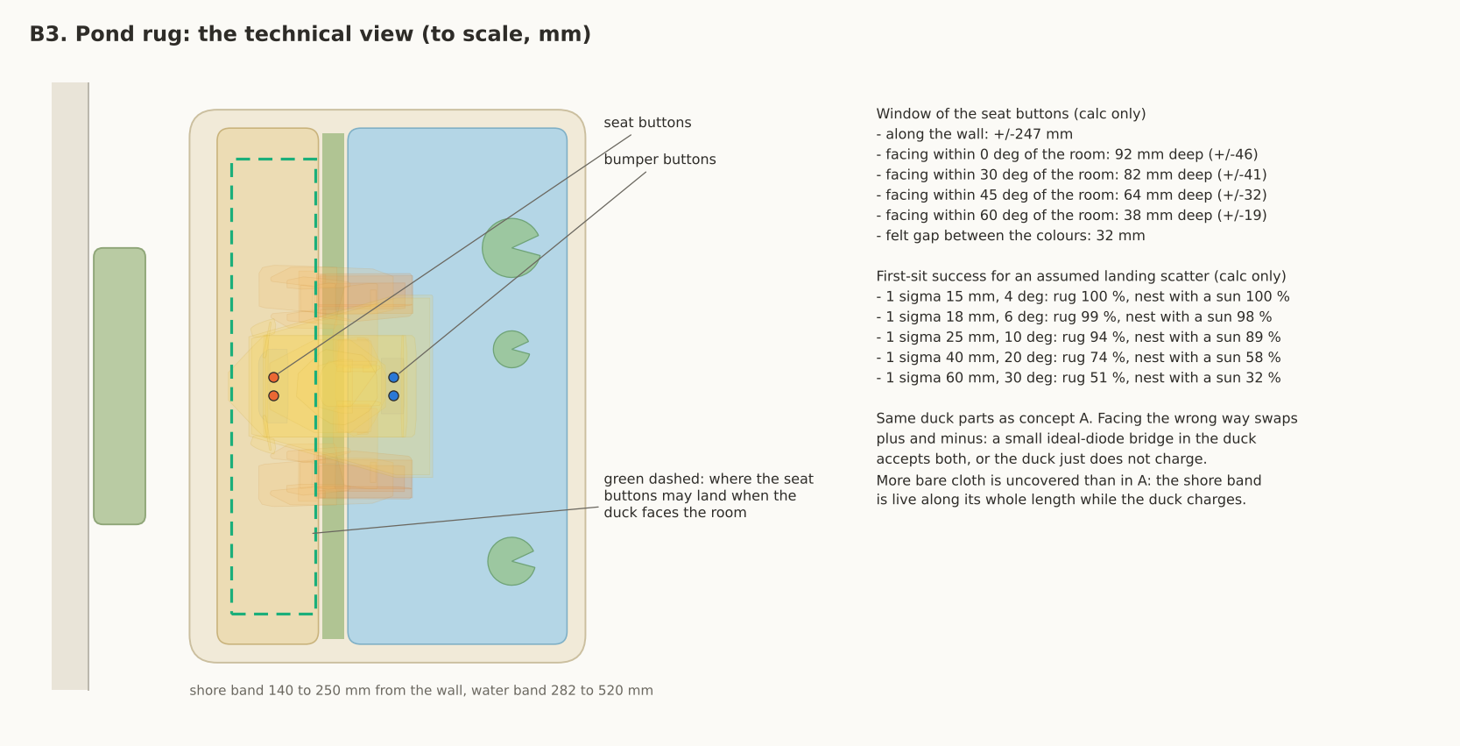
altaay_lab/twin/dock/nest/B3_pond_rug_technical.png
