aaltaay/Open_Duck_Mini_v2/altaay_lab/twin/dock/nest/C1_plain_nest_side_top.png

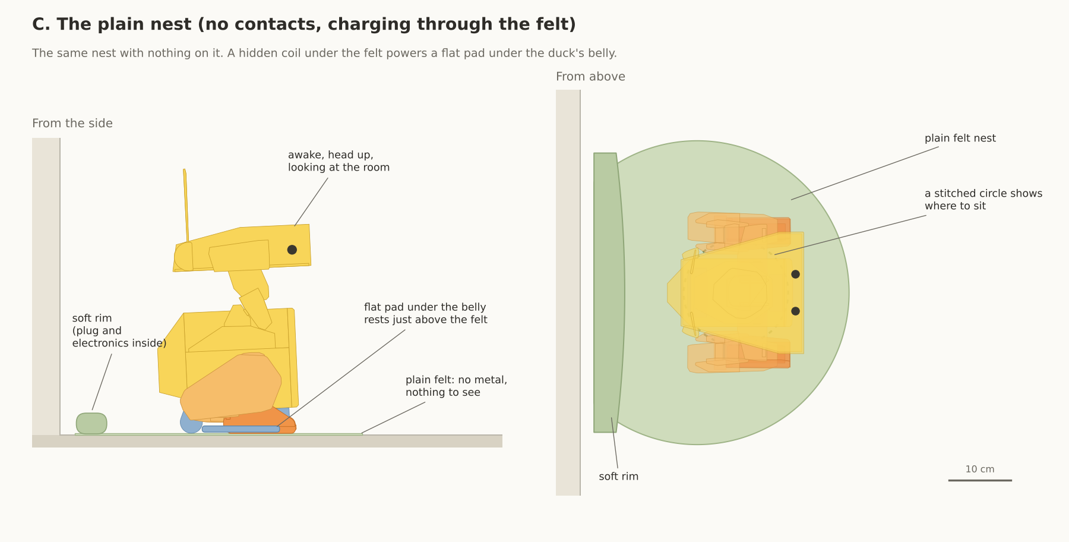
altaay_lab/twin/dock/nest/C1_plain_nest_side_top.png
