aaltaay/Open_Duck_Mini_v2/altaay_lab/twin/dock/nest/C2_plain_nest_approach.png

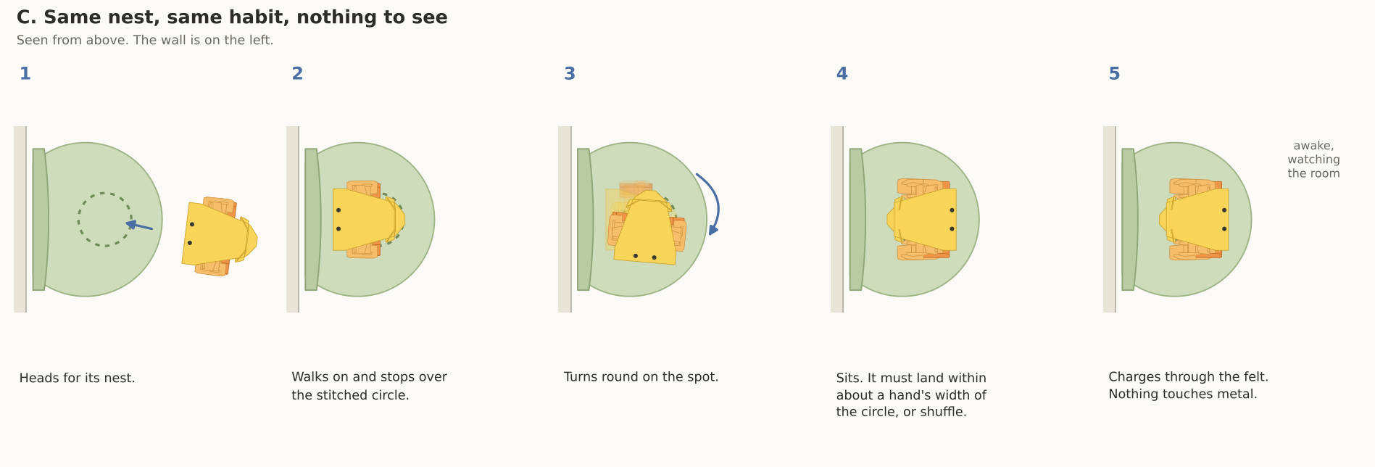
altaay_lab/twin/dock/nest/C2_plain_nest_approach.png
