aaltaay/Open_Duck_Mini_v2/altaay_lab/twin/dock/nest/C3_plain_nest_technical.png

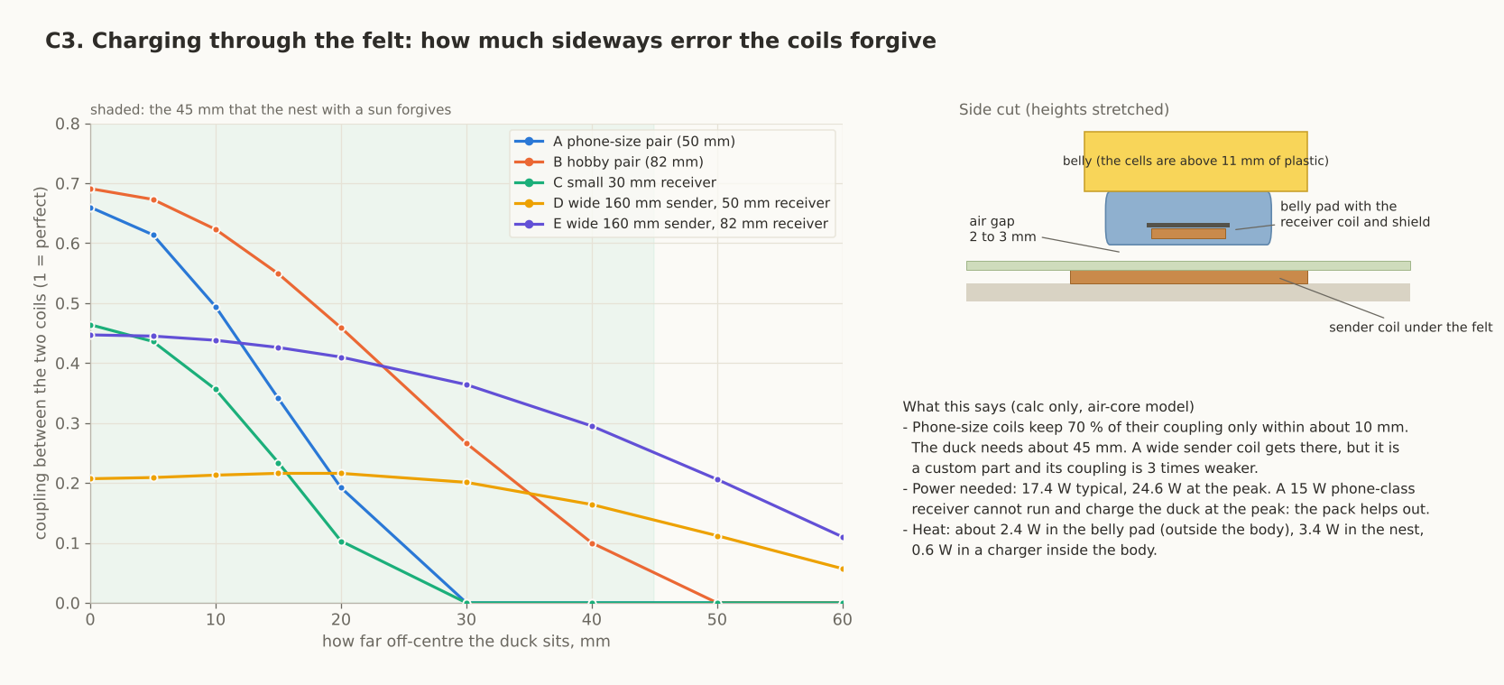
altaay_lab/twin/dock/nest/C3_plain_nest_technical.png
