aaltaay/Open_Duck_Mini_v2/altaay_lab/twin/dock/nest/cad/renders/mat_layers.png

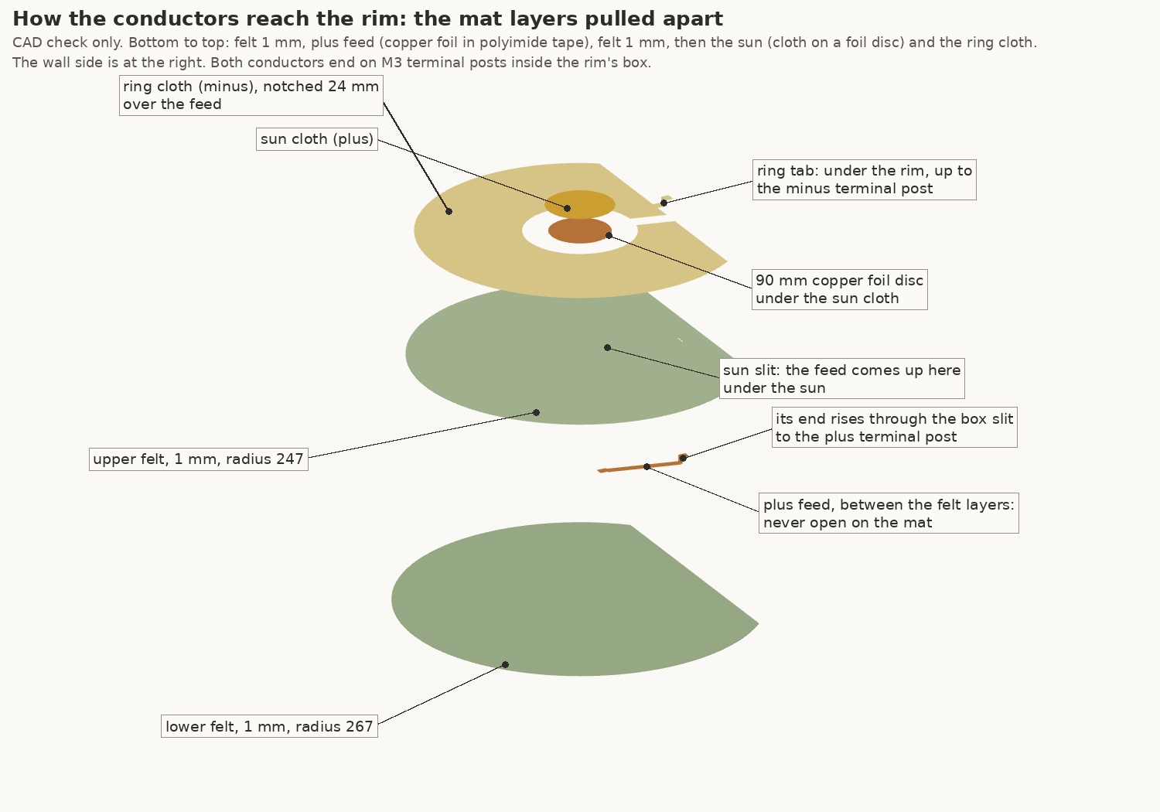
altaay_lab/twin/dock/nest/cad/renders/mat_layers.png
