aaltaay/Open_Duck_Mini_v2/altaay_lab/twin/dock/nest/cad/renders/nest_alone.png

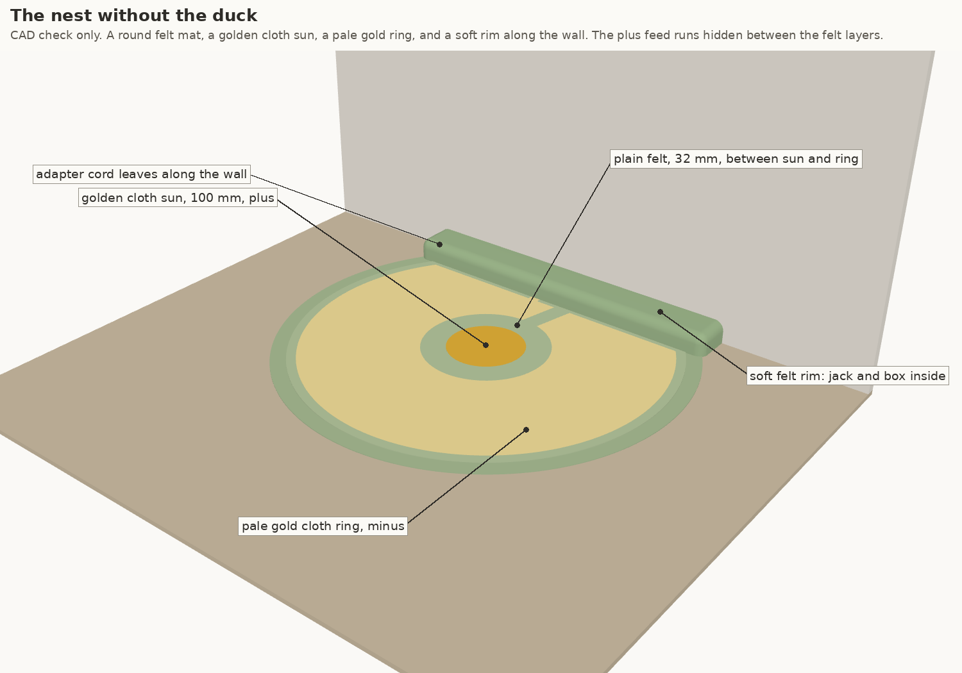
altaay_lab/twin/dock/nest/cad/renders/nest_alone.png
