aaltaay/Open_Duck_Mini_v2/altaay_lab/twin/dock/nest/cad/renders/nest_three_quarter.png

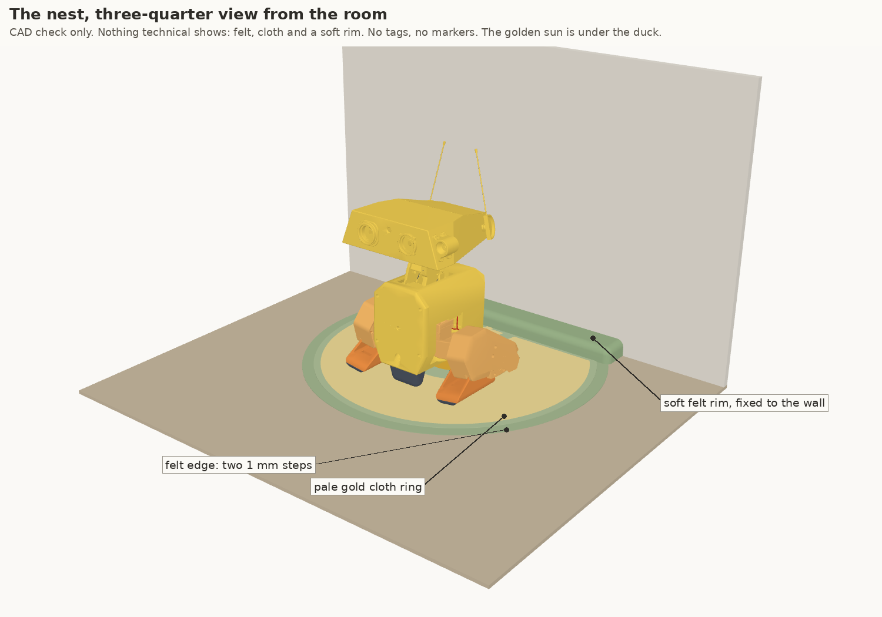
altaay_lab/twin/dock/nest/cad/renders/nest_three_quarter.png
