aaltaay/Open_Duck_Mini_v2/altaay_lab/twin/dock/nest/cad/renders/pins_underside.png

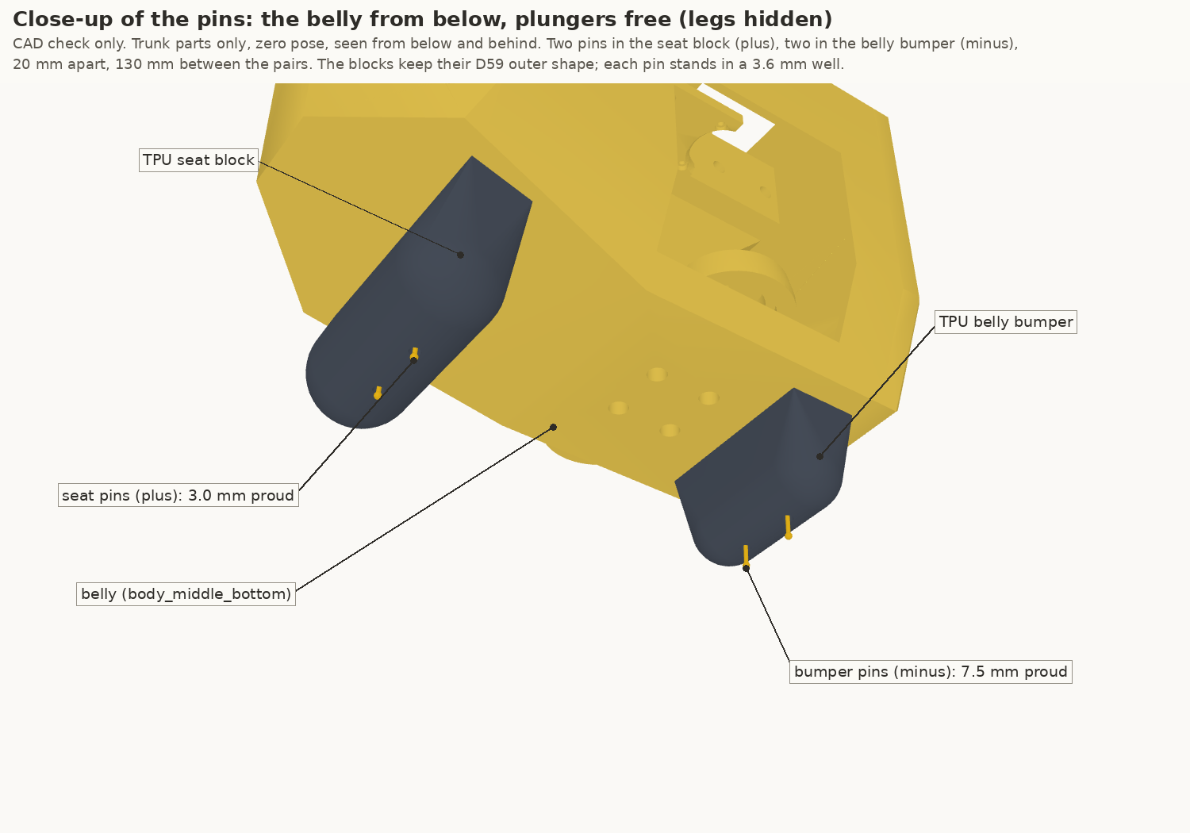
altaay_lab/twin/dock/nest/cad/renders/pins_underside.png
