aaltaay/Open_Duck_Mini_v2/altaay_lab/twin/dock/nest/sim/F1_pin_landing.png

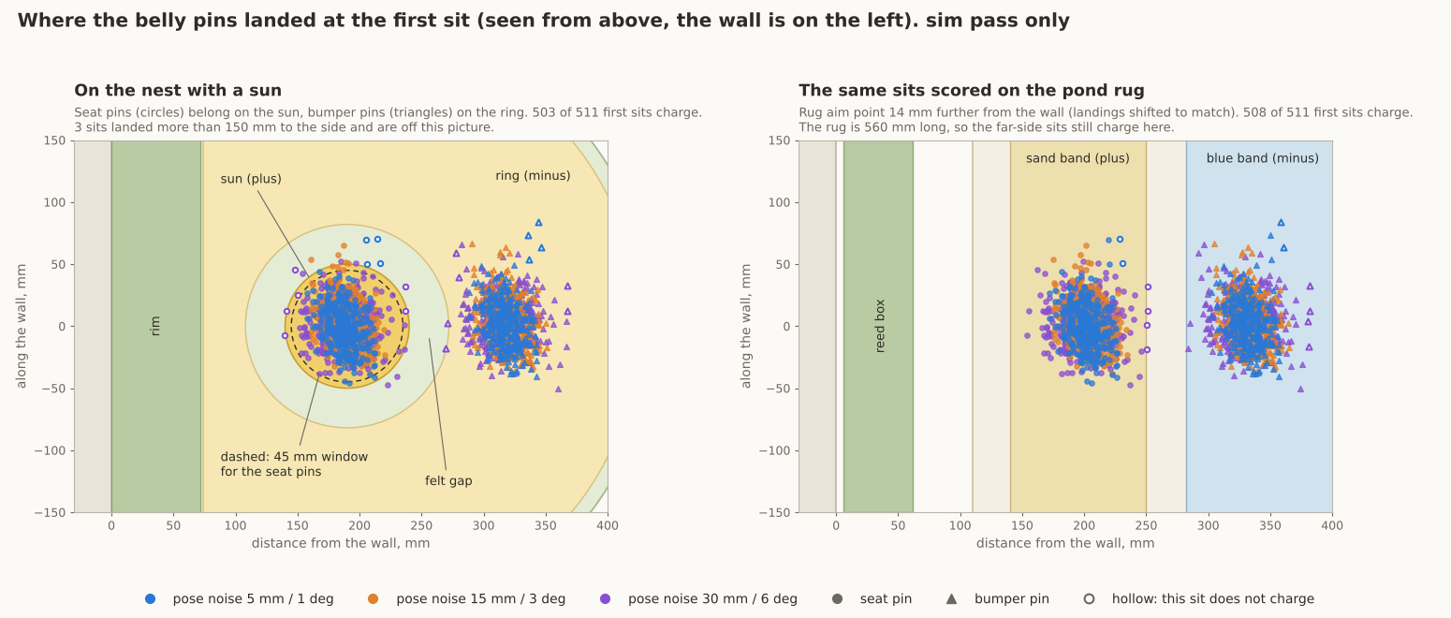
altaay_lab/twin/dock/nest/sim/F1_pin_landing.png
