aaltaay/Open_Duck_Mini_v2/altaay_lab/twin/dock/nest/sim/F2_run_traces.png

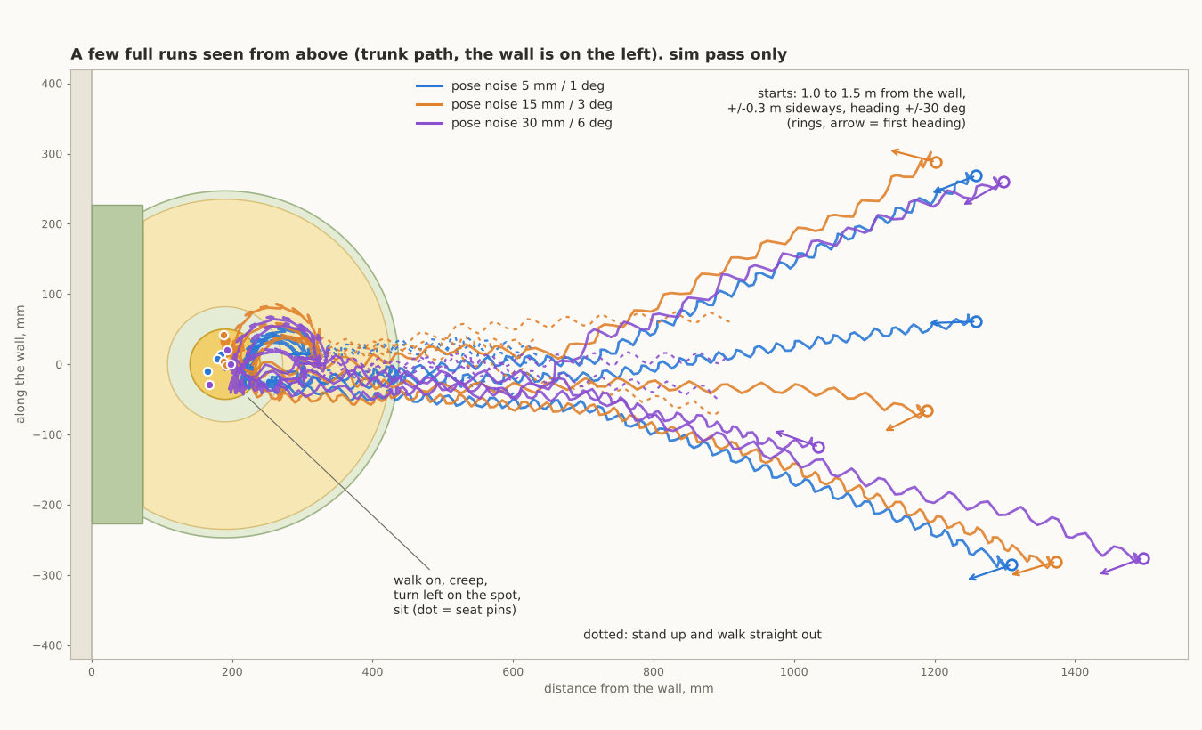
altaay_lab/twin/dock/nest/sim/F2_run_traces.png
