aaltaay/Open_Duck_Mini_v2/altaay_lab/twin/dock/nest/sim/F3_success.png

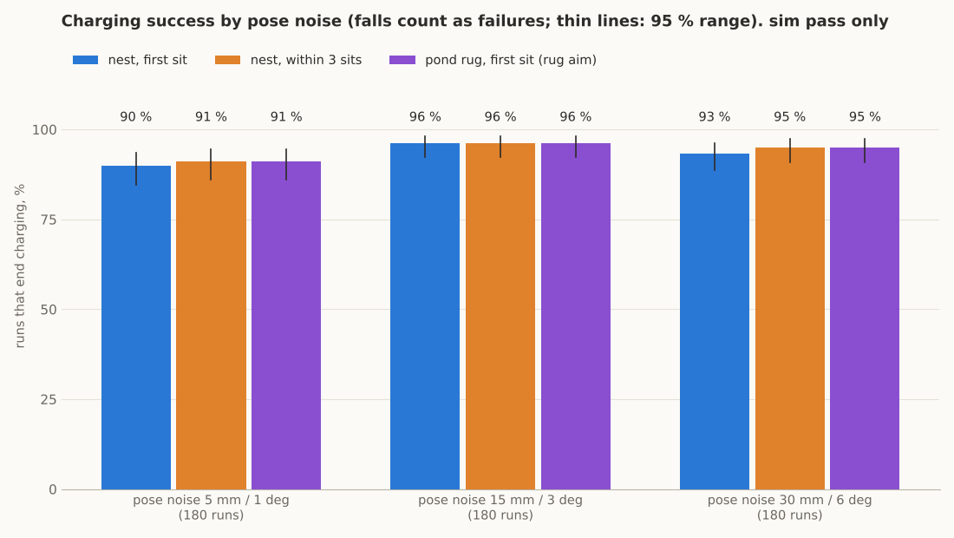
altaay_lab/twin/dock/nest/sim/F3_success.png
