aaltaay/Open_Duck_Mini_v2/altaay_lab/twin/dock/nest/sim/v3/V3_clearance.png

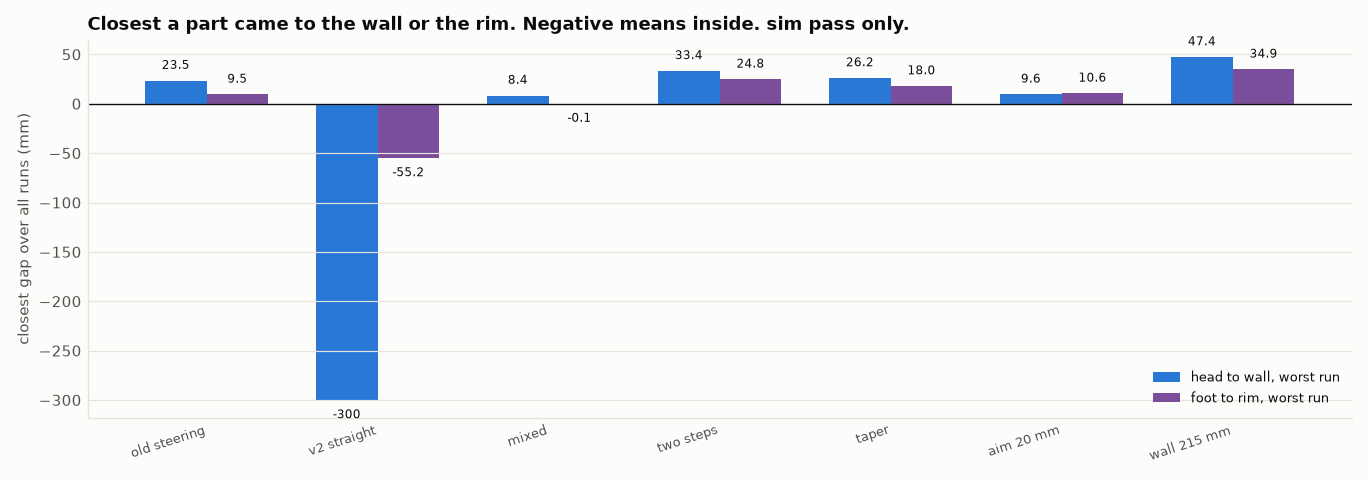
altaay_lab/twin/dock/nest/sim/v3/V3_clearance.png
