aaltaay/Open_Duck_Mini_v2/altaay_lab/twin/dock/nest/stripes/F1_pattern_poses.png

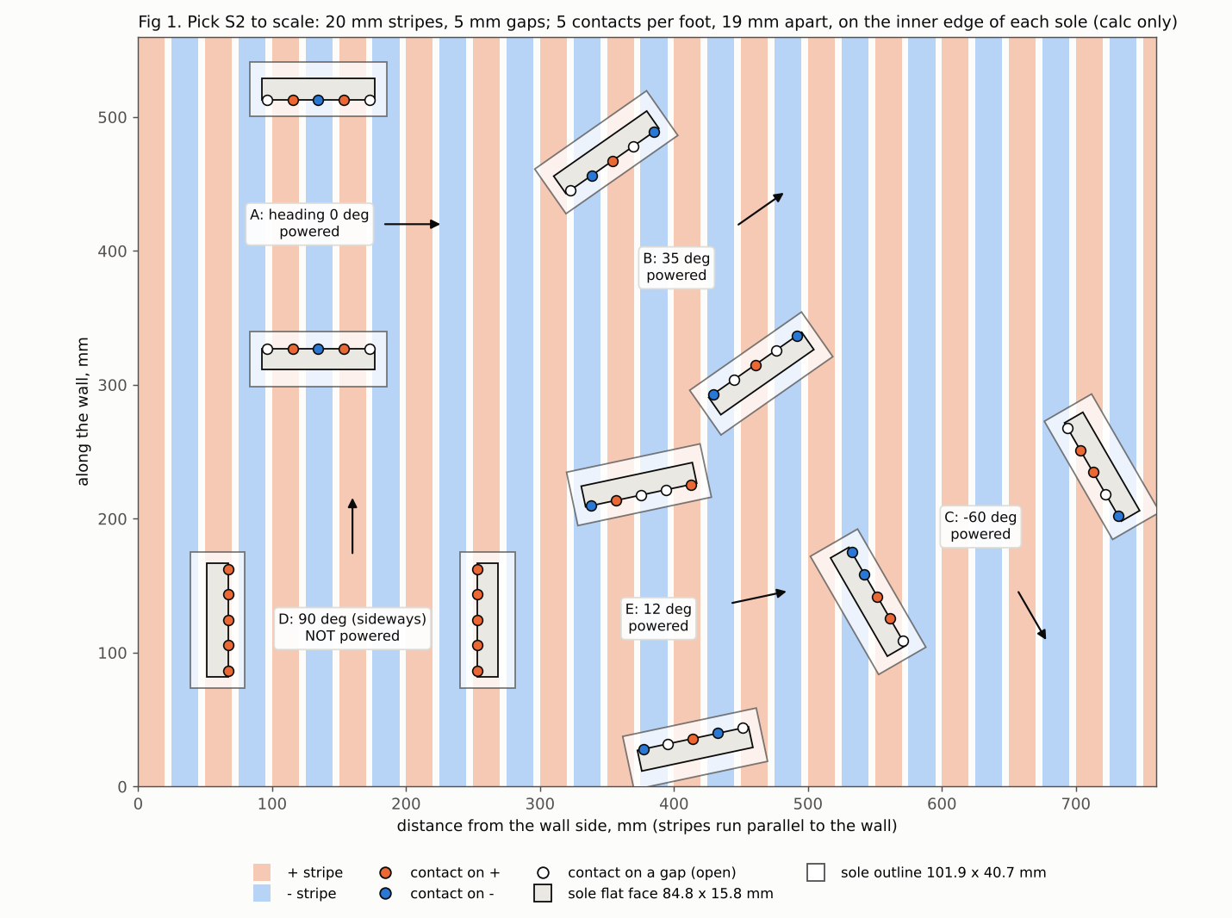
altaay_lab/twin/dock/nest/stripes/F1_pattern_poses.png
