aaltaay/Open_Duck_Mini_v2/altaay_lab/twin/dock/nest/stripes/F2_coverage.png

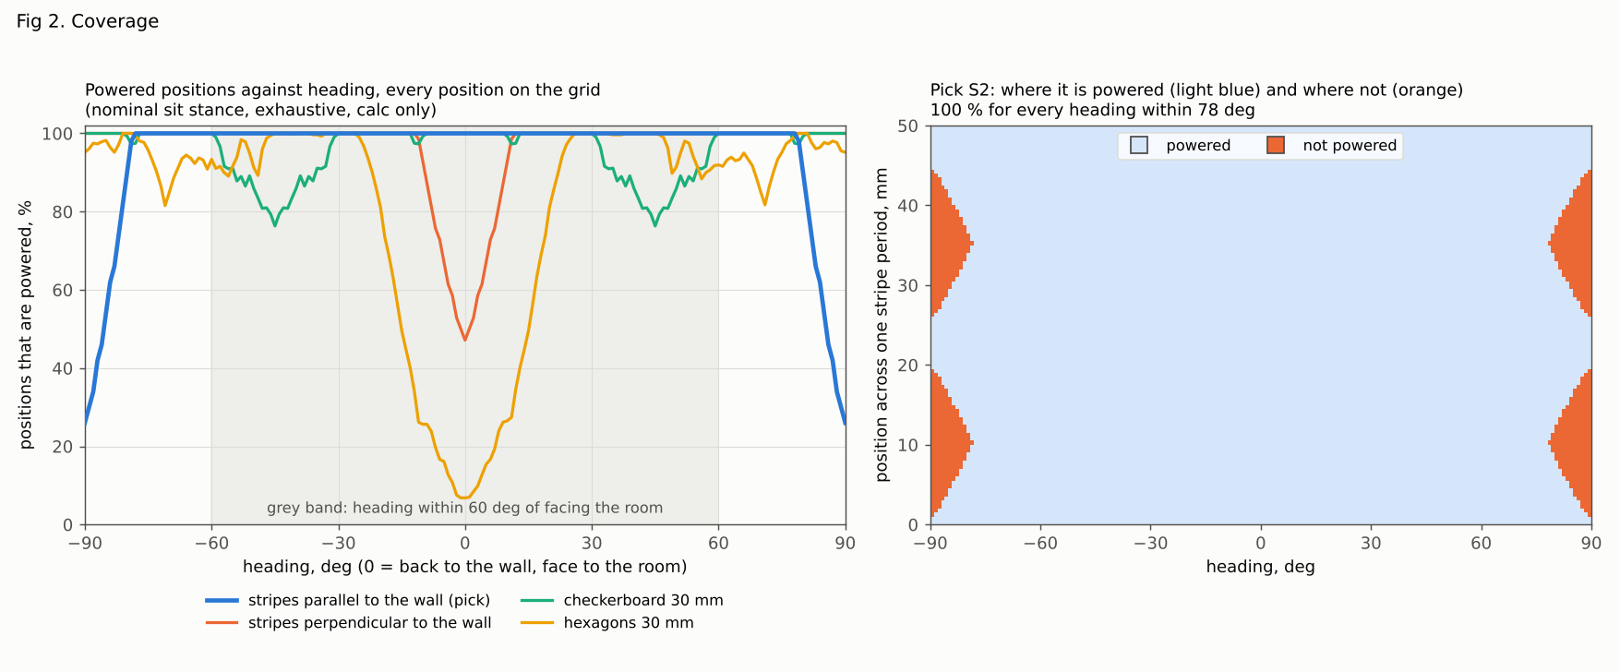
altaay_lab/twin/dock/nest/stripes/F2_coverage.png
