aaltaay/Open_Duck_Mini_v2/altaay_lab/twin/dock/nest/stripes/F3_circuit_2net.png

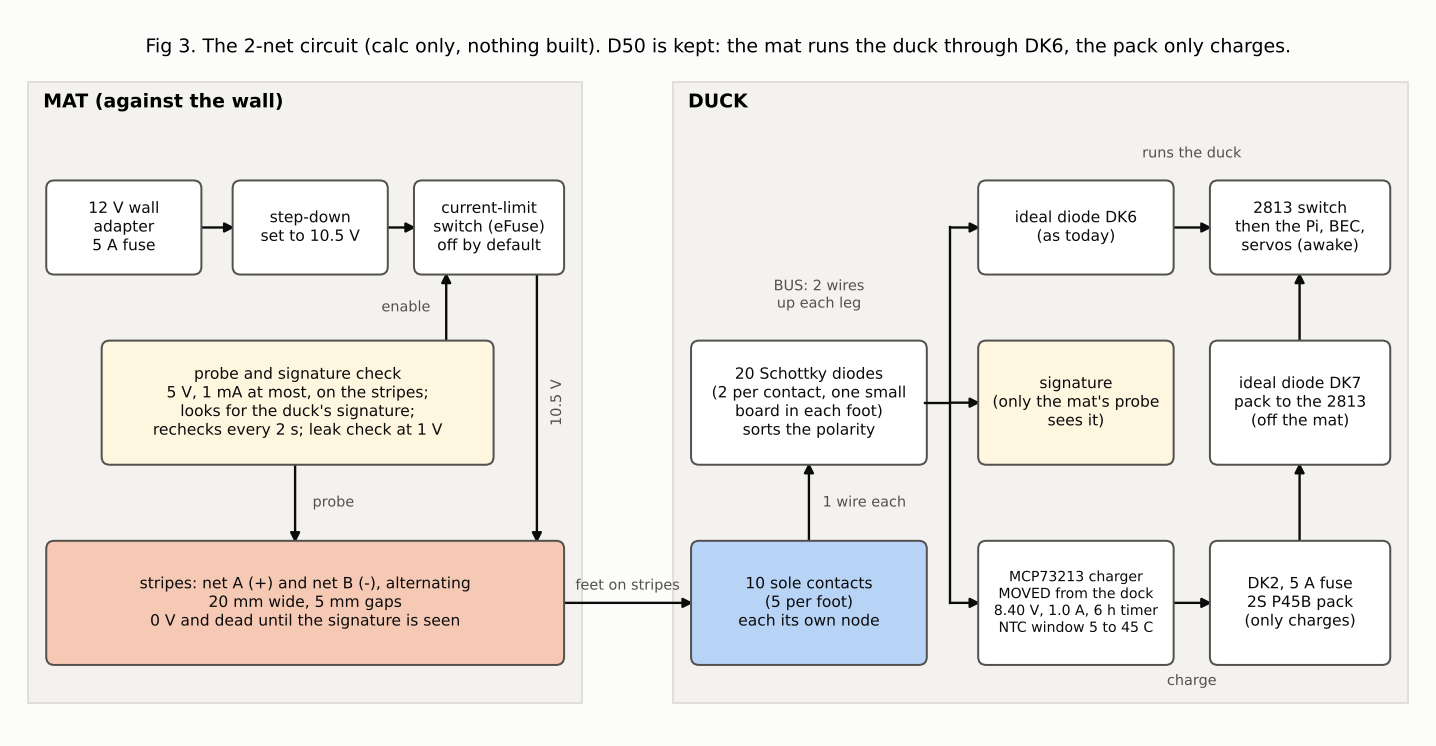
altaay_lab/twin/dock/nest/stripes/F3_circuit_2net.png
