aaltaay/Open_Duck_Mini_v2/altaay_lab/twin/dock/nest/stripes/F4_mat_wall_top.png

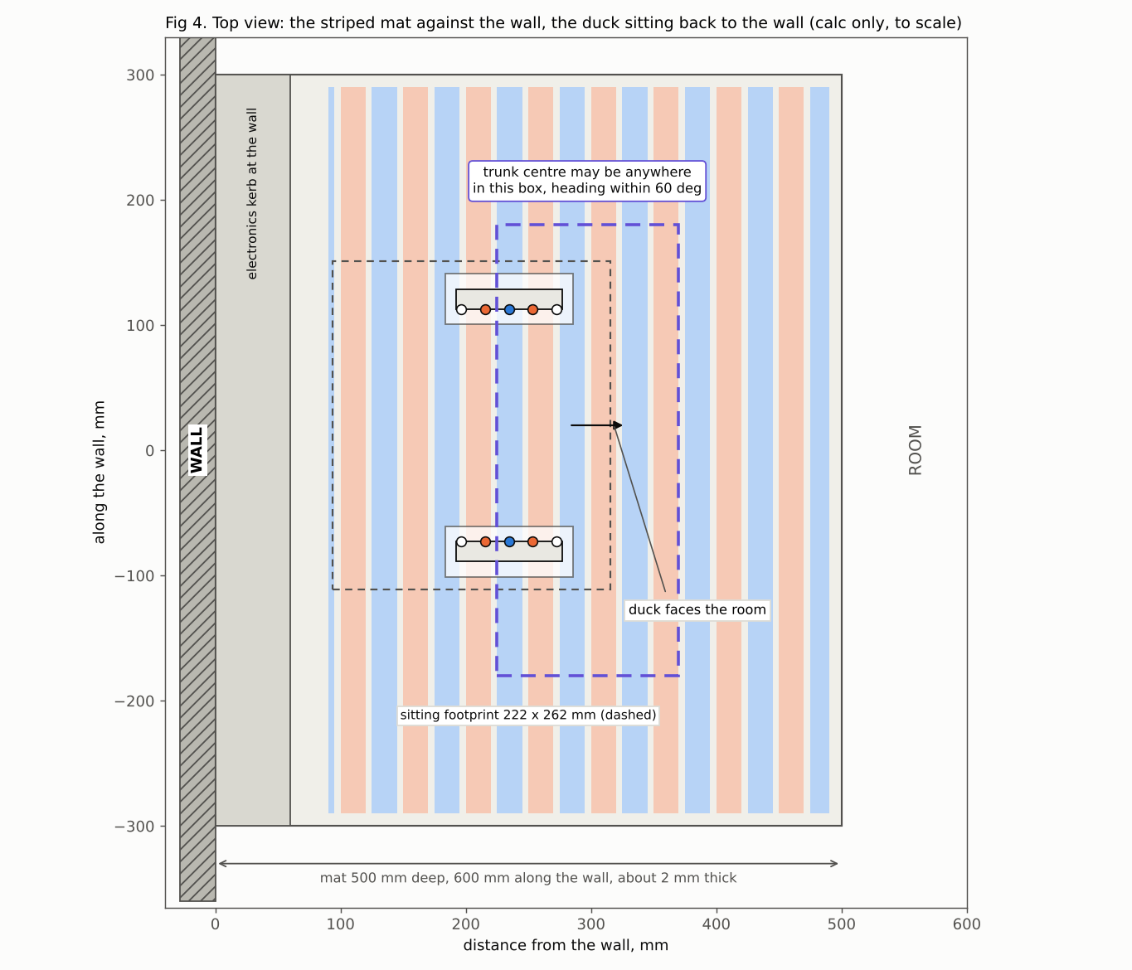
altaay_lab/twin/dock/nest/stripes/F4_mat_wall_top.png
