aaltaay/Open_Duck_Mini_v2/altaay_lab/twin/dock/nest/T1_sit_contacts.png

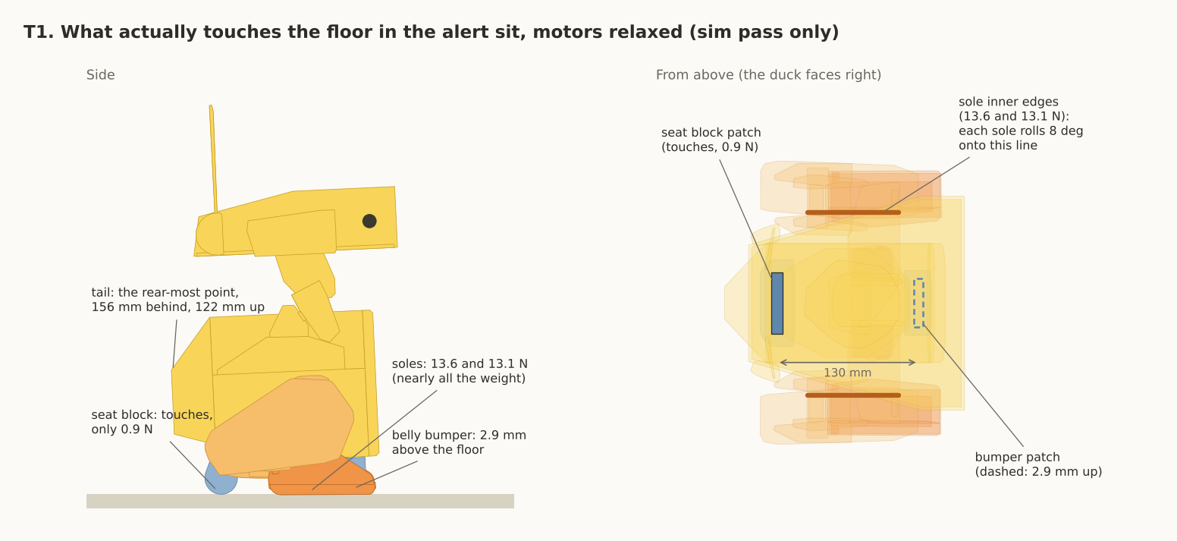
altaay_lab/twin/dock/nest/T1_sit_contacts.png
