aaltaay/Open_Duck_Mini_v2/altaay_lab/twin/dock/stl/chest_hole_section.png

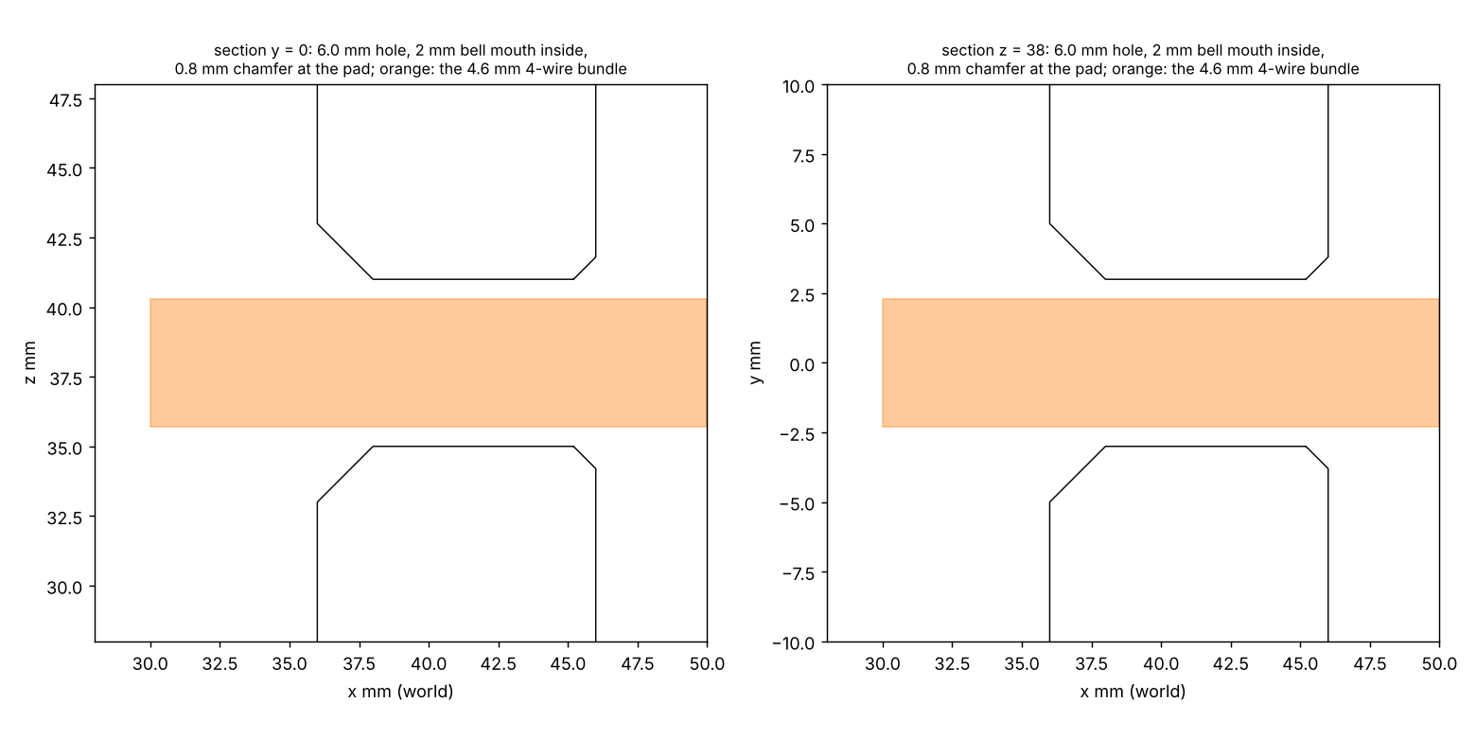
altaay_lab/twin/dock/stl/chest_hole_section.png
