aaltaay/Open_Duck_Mini_v2/altaay_lab/twin/electromech/em_twin_states.png

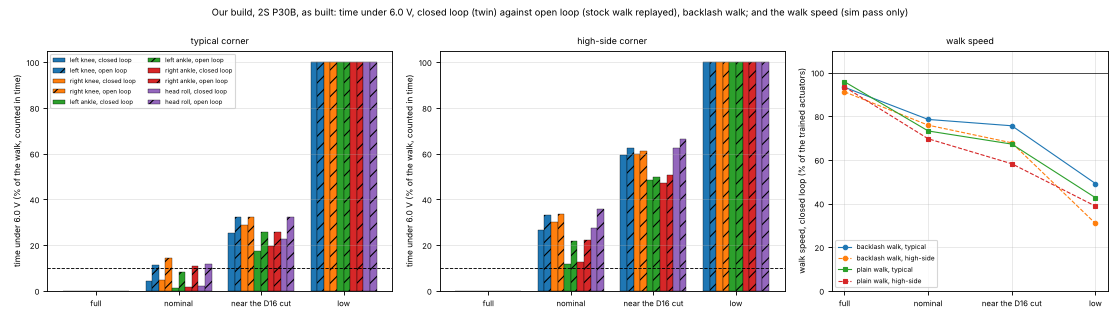
altaay_lab/twin/electromech/em_twin_states.png
