aaltaay/Open_Duck_Mini_v2/altaay_lab/twin/life/heat_modes.png

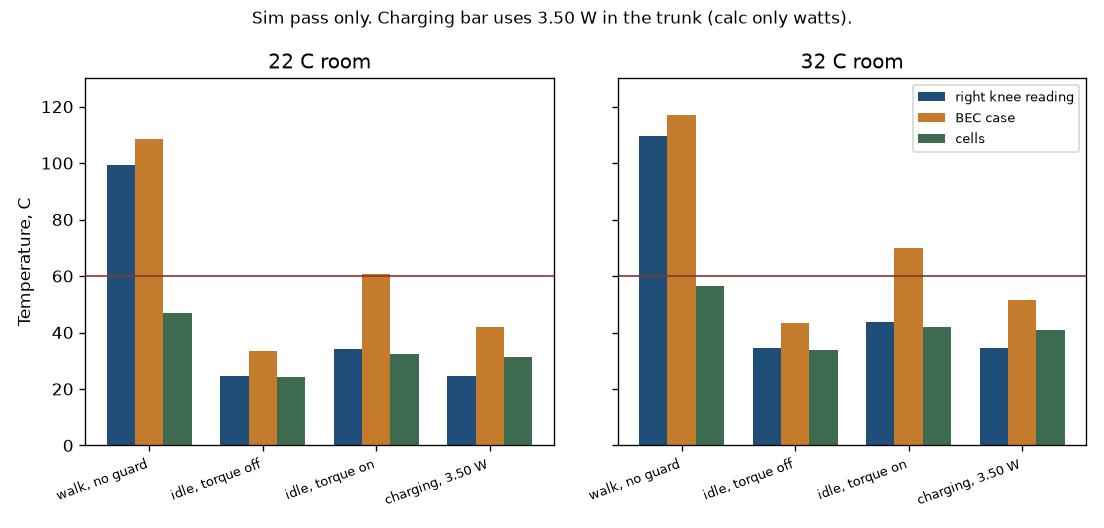
altaay_lab/twin/life/heat_modes.png
