aaltaay/Open_Duck_Mini_v2/altaay_lab/twin/life/stress_sf.png

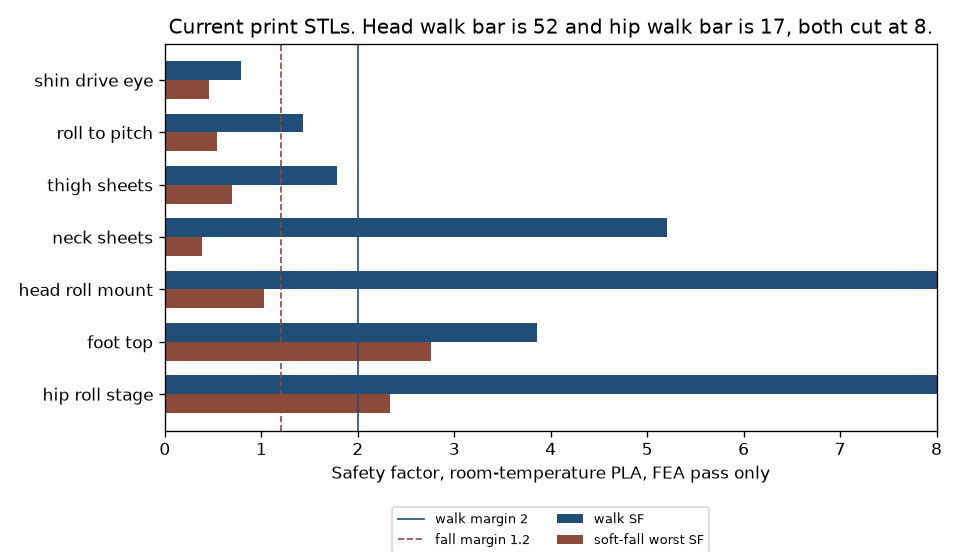
altaay_lab/twin/life/stress_sf.png
