aaltaay/Open_Duck_Mini_v2/altaay_lab/twin/out/walk.png

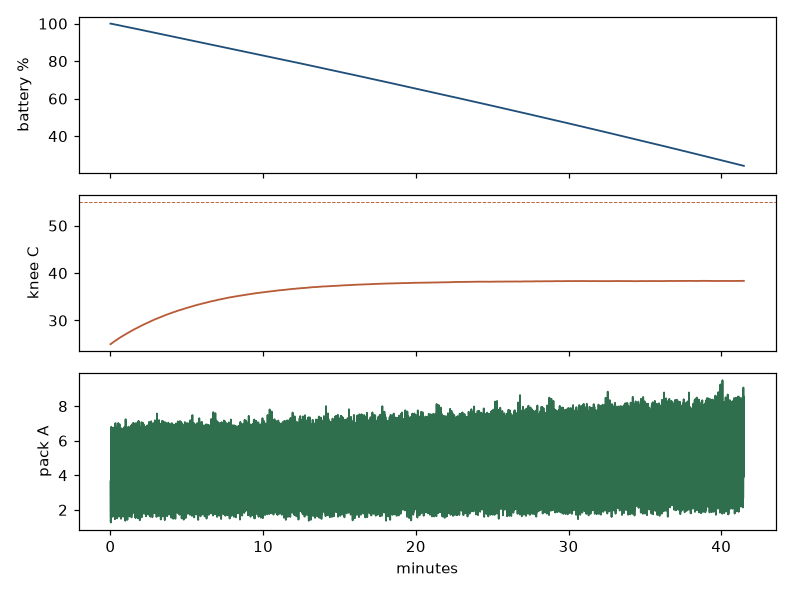
altaay_lab/twin/out/walk.png
