aaltaay/Open_Duck_Mini_v2/altaay_lab/twin/structure/topology/img/final_roll_right_xz.png

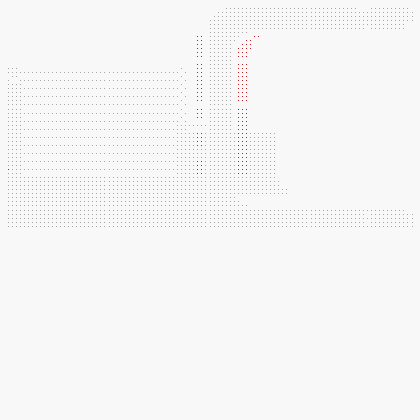
altaay_lab/twin/structure/topology/img/final_roll_right_xz.png
