aaltaay/Open_Duck_Mini_v2/altaay_lab/twin/structure/topology/img/final_shin_xy.png

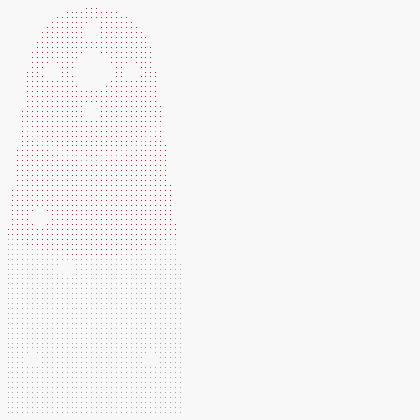
altaay_lab/twin/structure/topology/img/final_shin_xy.png
