aaltaay/Open_Duck_Mini_v2/altaay_lab/twin/thermal/twin_thermal.png

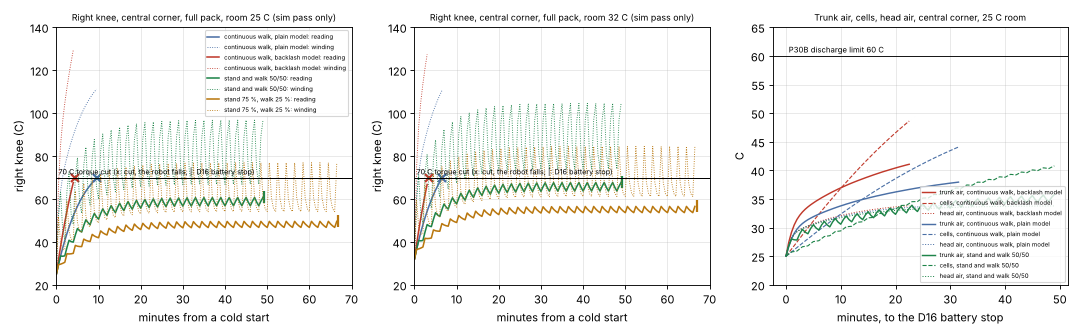
altaay_lab/twin/thermal/twin_thermal.png
