aaltaay/Open_Duck_Mini_v2/altaay_lab/wiring/odm_v2_schematic.png

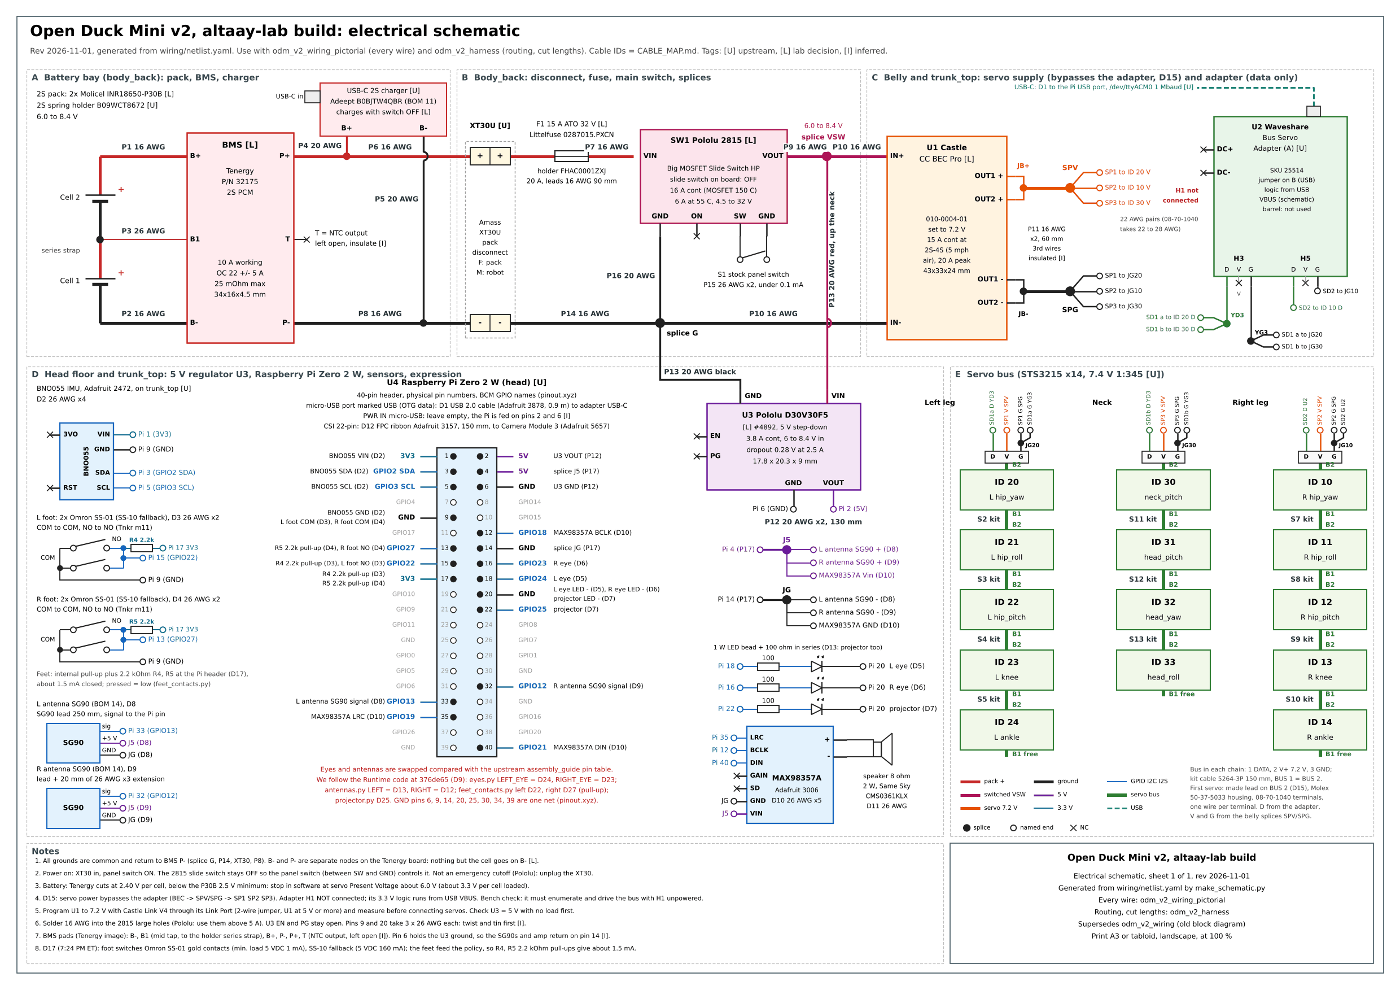
altaay_lab/wiring/odm_v2_schematic.png
