aaltaay/Open_Duck_Mini_v2/altaay_lab/BOM.md

# BOM (final, end to end)

Last updated: 2026-11-02 about 5:10 AM ET integration pass (agent INT): line 26 sleeve counts per size, line 27 Need 1389 g (coupon T1 stack pieces), line 30 counts from the current netlist (15 splices), lines TO11 and T14 text, new test order line TO17 (BelMetric 17j to 17l, lead decision L2; test order total $231.50); earlier 2026-11-02 about 5:00 AM ET D25 cable pass (agent CAB): new line 34b (Panduit ABM1M-AT-C), lines 24, 32, 34 and 35 Need from cables3d.json of 4:31 AM ET, line 32 Buy back to 1 pack, E7 fallback note; earlier 2026-11-02 about 12:45 AM ET (netlist final pass: lines 21 and 22 Need for the D23 ankle feeds, wire Need L5, 24 and 25 from wiring/netlist.yaml, line 17l now the stocked 0.3 mm washer, lines 32 and 34 Need from cables3d.json of 11:50 PM ET, line 28 Need from print/PRINT_PLAN.md, new tools T14 and T15, test order TO6 text, blocker list matched to HARDWARE_AUDIT.md; earlier 2026-11-01 about 11:30 PM ET tie mount pass from cables3d/cables3d.json retention: new lines 34 adhesive tie mounts and 35 isopropyl alcohol, line 32 Need and Buy; earlier 10:50 PM ET fastener schedule pass from fasteners/FASTENERS.md and DECISIONS.md D19 to D21: Need for 17a, 17d, 17e and 17h, new lines 17j to 17l, tools T11 to T13, test order TO16; 10:00 PM ET sourcing pass from SOURCING_2026-11-02.md, 7:00 PM ET print-readiness pass and 2:52 PM ET blocker pass). Prices read on supplier pages 2026-11-01, before tax. Shipping is excluded by the owner's rule; every line ships to the USA. Nothing purchased.

Rules: every quantity comes from CAD/STL measurement (HARDWARE_AUDIT.md, PRINT_CHECK.md, CABLE_MAP.md, MOUNTING.md) or a cited source. Anything that could not be verified is marked BLOCKER with what is needed. Spares are 10 to 20% or the pack minimum, whichever is larger.

Columns: Need = measured requirement; Buy = what to order; Line = price for the Buy quantity.

## Robot

| # | Item | Spec | Need | Buy | Pack | Line $ | Supplier | Link | Ships to USA | Verified |
|---|---|---|---|---|---|---|---|---|---|---|
| 1 | Smart serial bus servo | Feetech STS3215 7.4 V 1:345 (C001); ships with one 15 cm 5264-3P cable and a screw bag each; 12 since D32 (the two knees are line 1b) | 12 | 12 | 1 | 228.00 | Seeed Studio | https://www.seeedstudio.com/STS3215-19kg-cm-7-4V-Serial-Servo-p-6338.html | Yes | Yes: $19.00 each at 10+ ($20.00 at 1 to 9), in stock 2026-11-01. Bag split: test order (B2) |
| 1b | Smart serial bus servo, knees (D32) | Feetech STS3250-C002 (the STS3250 without bracket): 50 kg.cm and 4.2 A at 12 V, rated input 6 to 12 V, aluminium case tapped 4-M2.0, 74.5 g, the same 45.22 x 24.72 x 35 mm outline, 25T horn and 5264 connector as the C001 (SERVO_UPGRADE_OPTIONS.md F5, F9) | 2 | 2 | 1 | 147.98 | OpenELAB | https://openelab.com/products/feetech-sts3250-c002-servo-12v | No: ships from China, 8 to 15 business days | Design (D32), nothing bought: $73.99 each read 2026-11-01 (SERVO_UPGRADE_OPTIONS.md P5). Chinese part, single source (lab rule 6). Buy one first for TEST_PLAN 15 (7.2 V, registers, bench BAM fit), then the second. twin/knee/KNEE_TWIN.md.
| 2 | Servo bus adapter | Waveshare Bus Servo Adapter (A), SKU 25514, 42x33 mm, 2 servo sockets (H3, H5 in parallel per schematic). Used for USB data only (D15): its schematic marks "MAX:6A" at the servo header and its spec input is 9 to 12.6 V, so servo power bypasses it and H1 stays unconnected; logic runs from USB VBUS | 1 | 1 | 1 | 4.99 | Waveshare | https://www.waveshare.com/bus-servo-adapter-a.htm | Yes (from China/HK) | Yes; flagged Chinese part, single source |
| 3 | Compute | Raspberry Pi Zero 2 W | 1 | 1 | 1 | 19.05 | Adafruit 5291 | https://www.adafruit.com/product/5291 | Yes | DECIDED (D7). Re-read 2026-11-01 9:02 to 9:08 PM ET: bare board still out of stock everywhere checked: Adafruit 5291 $19.05 "Out of stock" (header version 6008, $19.80, out of stock), SparkFun DEV-18713 $19.00 "Out of stock", PiShop.us $17.25 "Out of stock", CanaKit PI-Z2W $16.35 and PI-Z2WH $19.60 "Sold Out", Vilros RPZW2 $17.43, every variant sold out. Chicago Electronic Distributors no longer takes orders (its page sends buyers to PiShop.us). Micro Center and DigiKey refuse curl (403); DigiKey search index copies of SC0721 disagree (0 to 133 in stock), so UNVERIFIED. In stock with the board: PiShop.us Starter Kit K2B-1388 $74.95, "Current Stock: 170" (https://www.pishop.us/product/raspberry-pi-zero-2-w-starter-kit/; kit adds a case, mini HDMI adapter, OTG cable, blank 32 GB microSD, 5.1 V 2.5 A supply, unsoldered 2x20 header, heatsinks); CanaKit PI-Z2WH-STR32-C4-BLK $89.95, "Add to Cart", no count shown (https://www.canakit.com/raspberry-pi-zero-2-w.html), with pre-soldered header (fits: 44.3 mm free below the Pi). Kit price minus this line goes to contingency X4 |
| 4 | microSD | SanDisk Ultra 32 GB microSDHC A1 C10, SDSQUAR-032G-GN6MA | 1 | 1 | 1 | 21.25 | Amazon | https://www.amazon.com/dp/B073JWXGNT | Yes | Yes (in stock 2026-11-01, B25) |
| 5 | IMU | Adafruit BNO055 breakout 2472 (NOT 4646: 4646 hole pattern does not match CAD, MOUNTING.md) | 1 | 1 | 1 | 34.95 | Adafruit 2472 | https://www.adafruit.com/product/2472 | Yes | Yes (in stock 2026-11-01) |
| 5b | Cliff sensor (D54) | Adafruit 5396 VL53L4CD time-of-flight breakout, STEMMA QT: ST VL53L4CD, 0 to 1300 mm, 18 deg diagonal FoV, up to 100 Hz, I2C 0x29, active 22 mA typ / 24 mA max at 2.8 V, VCSEL peak 40 mA (ST DS13812 Rev 3 Table 12); 25.4 x 17.8 x 4.6 mm, 1.8 g. In the chest of body_front, 52 deg down, on 4 printed standoffs with 2 x M2.5x6 (17f); wires D21 and D22 soldered, the STEMMA QT sockets not used (twin/freeze/cliff_seat.json) | 1 | 1 | 1 | 14.95 | Adafruit | https://www.adafruit.com/product/5396 | Yes | Yes: $14.95 (1 to 9), in stock, read 2026-11-06 ET |
| 6 | Li-ion cell | Molicel INR21700-P45B (D44, D65): 4.5 Ah, 45 A, 70.0 g max, 21.40 x 70.00 mm; 3S1P. Alternate if out of stock: Molicel P50B, same size, $11.99 each, in stock 2026-11-04 | 3 | 3 | 1 | 29.97 | 18650 Battery Store | https://www.18650batterystore.com/products/molicel-p45b | Yes | Price yes ($9.99 each, read 2026-11-04 ET); out of stock that day. The order bill buys three from illumn at $8.99. |
| 7 | 3S pack build (D44, D65) | 3S1P pack build, no holder: pure nickel strip 0.15 x 8 mm, PVC sleeve, fish-paper rings, 16 AWG leads, a 1 mm foam pad on the lid pad; spot-welded, never soldered (twin/battery/BAY.md). Replaces the 2x18650 holder (Amazon B09WCT8672, $9.99) | 1 | 1 | 1 | 0.00 | not chosen | BLOCKER: strip, sleeve and welding (tool or pack shop) not sourced or priced | No | No: BLOCKER |
| 8 | 3S BMS | BatterySpace PCM-L04S30-566: 11.1 V 3S, 30 A continuous discharge, 20 A charge, overcurrent 120 A to 160 A, overcharge 4.25 V plus or minus 0.025 V, loop at most 30 mohm, 60 x 60 x 5 mm. Seated in the rear pocket on body_back (CAD check only, D65). The old 17.75 x 47.2 mm slot does not hold it | 1 | 1 | 1 | 34.25 | BatterySpace | https://www.batteryspace.com/custom-protection-circuit-module-pcm-with-equilibrium-function-for-11-1v-li-ion-battery-pack-at-30a-with-thermistor.aspx | Yes | Yes: $34.25, in stock, read 2026-11-14. Spec http://www.batteryspace.com/prod-specs/7758.pdf . Replaces Tenergy 32175. |
| 9 | 5 V regulator | Pololu D30V30F5 5 V step-down, 3.4 A typical max, input 5 to 45 V (subject to dropout), 0.7 x 0.8 in, US made; on the head floor, fed from the switched pack bus through the neck (D4, D8) | 1 | 1 | 1 | 29.95 | Pololu (Las Vegas, NV) | https://www.pololu.com/product/4892 | Yes | Yes: $29.95, status "Rationed (Active and Preferred)", backorders allowed; supply outlook: "505 completed units in stock", parts on site for "at least 100 more units within a few days" (https://www.pololu.com/product/4892/supply-outlook), read 2026-11-01 9:02 PM ET. Replaces the HENGE UBEC (no datasheet) |
| 10 | Main power switch (D30) | Pololu 2813 Big Pushbutton Power Switch with Reverse Voltage Protection, HP: 4.5 to 40 V, 6 A at 55 C and 16 A at 150 C MOSFET temperature, 90 A max (the 2815 ratings), off state under 0.2 uA, 0.8 x 1.0 x 0.16 in, 2.7 g; momentary button on A and B (line 10b), Pi GPIO26 (pin 37) on OFF with dtoverlay=gpio-poweroff,gpiopin=26 (twin/assembly/ASSEMBLY_TWIN.md item 6) | 1 | 1 | 1 | 8.95 | Pololu (Las Vegas, NV) | https://www.pololu.com/product/2813 | Yes | Yes: $8.95, status "Rationed (Active and Preferred)", backorders allowed, read 2026-11-04 with curl (V1 track 2); D30, Ahmed's OK relayed by the lead at 5:58 PM ET |
| 10r | Main power switch: replaced (D30) | Pololu 2815 Big MOSFET Slide Switch with Reverse Voltage Protection, HP: 4.5 to 32 V, 6 A at 55 C and 16 A at 150 C MOSFET temperature, 90 A max, 0.8 x 1.0 x 0.16 in; on-board slide set OFF, controlled by line 10b | 0 | 0 | 1 | 8.49 | Pololu (Las Vegas, NV) | https://www.pololu.com/product/2815 | Yes | Yes: $8.49, status "Rationed (Active and Preferred)", backorders allowed; supply outlook: "30 completed units in stock", parts for "at least 100 more units within a few days" (https://www.pololu.com/product/2815/supply-outlook), read 2026-11-01 9:02 PM ET (B22 cleared, D8) |
| 10b | Control button (D30, D38) | NKK MB2011LS1W01-BB momentary pushbutton, MB2000 series (same 1/4-40 threaded bushing with keyway and 13 mm body as the MB2011SS1W01 the D30 plate was drawn for: NKK MB2000 drawing, https://mm.digikey.com/Volume0/opasdata/d220001/medias/docus/923/MB2000Bushing.pdf, via search index), solder lug terminals (code 01), L plunger with its snap-on cap BB (the S plunger takes screw-on caps; NKK codes via search index); across the 2813 A and B pins (cable P15); held in the body_back cutout by the printed plate twin/assembly/button_plate_d30.stl, unchanged | 1 | 1 | 1 | 10.37 | Newark (941 in stock, search index) | https://www.electronicsdatasheets.com/parts/nkk-switches/MB2011LS1W01-BB | Yes | Yes: $10.37 at 1 (Newark via electronicsdatasheets.com, search index 2026-11-04); replaces MB2011SS1W01 (0 in stock, $8.16). Snap-on cap height not read: check it clears the body_back opening at the first fit |
| 10b-old | Control switch: replaced (D30) | Stock panel slide switch in the body_back cutout (CAD power_switch.stl: flange 23.4 x 7.4, body 15.7 x 7.4, actuator 5.4 x 3.8 mm), switches only the Pololu 2815 control pin (microamps) | 0 | 0 | 1 | 6.00 | see Verified | (part with datasheet: see Verified) | Yes | PENDING parts check: a datasheet part matching the CAD shape is being sourced; $6.00 is a placeholder; the upstream part (Amazon B0CH3JCQM5) also works electrically now |
| 11 | 3S charger board | TI BQ24133 board, CELL at VREF, regulates 12.6 V (circuitry/BQ24133_BOARD.md). The Adeept 8.4 V board is not ordered. Assembled cost is BLOCKER because several passives have no opened order code | 1 | 1 | 1 | 0.00 | built | circuitry/BQ24133_BOARD.md | Yes | BLOCKER for the assembled dollar total. The chip regulation is 12.6 V (cited). |
| 12 | XT30 pair | Amass XT30U, 10 pairs; 15 A continuous, 30 A peak ([I] https://shop.pimoroni.com/products/amass-xt30-connector, search text); 2 pairs used: the battery disconnect and the P13 service plug at the neck base (X3a, D36: 2.21 A peak) | 2 | 1 | 10 pairs | 8.58 | Amazon | https://www.amazon.com/dp/B08P5HVMYT | Yes | Yes |
| 13 | Foot contact switch | Omron SS-01 (gold alloy contacts, 0.1 A, minimum load 5 VDC 1 mA) preferred, Omron SS-10 (silver, minimum load 5 VDC 160 mA) as the fallback; same body 19.8 x 6.4 x 10.2 mm (Omron SS datasheet), 2 per foot (Tnkr m11) (D17) | 4 | 5 | 1 | 14.70 | DigiKey | https://www.digikey.com/en/products/detail/aratas-formerly-omron-components/SS-10/369860 | Yes | SS-10: $2.94 each at 1 ($2.43 at 10), 3,148 in stock, DigiKey 39-SS-10-ND (read via search index 2026-11-01; direct fetch 403 at 9:28 PM ET). SS-01 (read via search index only): DigiKey SW1059-ND showed 5,728 and 6,556 in stock at $2.14 in two cached copies of unknown date, while a DigiKey DE copy shows a 26 week standard lead time; Avnet Americas 0 in stock, 180 week factory lead time. Live US stock UNVERIFIED; buy SS-01 if DigiKey shows stock at order time, else SS-10 (D17). Seat: foot_top has 2 slots 6.4 x 19.8 mm per foot (measured), press fit per upstream |
| 13b | Foot switch pull-up | 2.2 kOhm 5% 1/4 W through-hole, pack of 25; one per foot from Pi pin 17 (3V3) to GPIO22 / GPIO27 (D17) | 2 | 25 | 25 | 0.75 | Adafruit 2782 | https://www.adafruit.com/product/2782 | Yes | Yes: $0.75, in stock 2026-11-01 |
| 14 | Antenna servo | SG90-class 9 g, 10-pack | 2 | 10 | 10 | 19.99 | Amazon (Miuzei) | https://www.amazon.com/dp/B072V529YD | Yes | Yes: lead 250 +/- 5 mm per listing (B28); tab holes 27.6 mm match head pilots 27.5 mm (B5) |
| 15 | Game controller | Microsoft Xbox Wireless Controller with Bluetooth (the Runtime drives the walk from an Xbox controller over Bluetooth, README "Setup xbox one controller over bluetooth") | 1 | 1 | 1 | 64.99 | Microsoft Store (also Walmart, Best Buy) | https://www.microsoft.com/en-us/d/xbox-wireless-controller/8mzbmmcjzpb2 | Yes | Read via search index: list price $64.99 after the May 2025 increase; retailers lower; stock not verified. Upstream BOM has none (UPSTREAM_ISSUES.md G9) |
| L1 | Servo buck-boost | TDK-Lambda I7C2W020A120V-0F1-R set to 12.0 V. Input 9 V to 36 V, output 8 V to 24 V, 20 A, heatsink, 34 x 36.8 x 24.9 mm, 75 g. Castle 010-0004-01 is superseded (D65) | 1 | 1 | 1 | 86.34 | DigiKey | https://www.digikey.com/en/products/detail/tdk-lambda/I7C2W020A120V-0F1-R/22260923 | Yes | Yes: $86.34, 18 in stock, read 2026-11-14. Datasheet https://product.tdk.com/info/en/catalog/datasheets/i7c_e.pdf |
| L3 | Inline fuse holder | Littelfuse FHAC0001ZXJ ATO 20 A, body 50 x 17.2 x 17.2 mm plus cover on a strap, 16 AWG leads 90 mm (Littelfuse drawing, parts check 2026-11-01); seat measured on the battery bay front wall (MOUNTING.md) | 1 | 1 | 1 | 7.74 | Newark 56P4171 | https://www.newark.com/littelfuse/fhac0001zxj/fuse-holder-in-line/dp/56P4171 | Yes | Yes: 3,553 in stock 2026-11-01; not re-read at the 2026-11-01 9:05 PM ET recheck: Newark and Mouser refuse plain curl (HTTP/2 stream reset, empty reply), so only the search index can re-read this line until that changes |
| L4 | Fuse | Littelfuse 0287015.PXCN ATO 15 A | 1 | 5 | 1 | 2.20 | DigiKey | https://www.digikey.com/en/products/detail/littelfuse-inc/0287015-PXCN/2519816 | Yes | Yes: $0.44 each, min qty 1 (read via search index, direct fetch 403). Rating vs BMS: B12 |
| DK1 | Chest contact pad (dock, D43, D50) | One 100 x 76 x 0.8 mm FR4 board, 2 oz, ENIG, four strips 100 x 17.5 mm with 2 mm gaps (SYS at trunk z 0 to 17.5, GND 19.5 to 37, SENSE 39 to 56.5, CHG+ 58.5 to 76), a solder pad per strip on the back; on the flat chest face of body_front (twin/dock/DOCK_TWIN.md sections 2 and 12) | 1 | 3 | 3 | 58.90 | OSH Park (Portland, OR) | https://docs.oshpark.com/services/two-layer-hhdc | Yes (US made) | index: 2 layer 2 oz 0.8 mm service, $5 per sq in x 11.78 sq in for 3 copies, ENIG standard; the area rule, not a live quote (sourcing 2026-11-06) |
| DK2 | Charge input ideal diode (dock, V1 track 8) | Pololu 5382 ideal diode reverse voltage protector, 4 to 60 V, 10 A, under 10 mOhm, LM74700-Q1 with an N-channel MOSFET, blocks reverse current: from the CHG+ strip to the pack side, so the strips never carry pack current; 100 k across it (line DK5) lets the dock read the pack | 1 | 1 | 1 | 3.79 | Pololu | https://www.pololu.com/product/5382 | Yes | Yes: $3.79 on the Pololu listing and blog, read via the search index 2026-11-05 |
| DK3 | Charge path fuse holder (dock, V1 track 8) | Littelfuse FHAC0001ZXJ inline ATO holder, the line L3 part, a second one on the CHG+ lead after DK2 | 1 | 1 | 1 | 7.74 | Newark 56P4171 | https://www.newark.com/littelfuse/fhac0001zxj/fuse-holder-in-line/dp/56P4171 | Yes | As line L3; seat in twin/dock/dock_seats.json (MOUNTING.md V1 track 8) |
| DK4 | Charge path fuse (dock, V1 track 8) | Littelfuse 0287005.PXCN ATOF 5 A 32 V fast acting, DigiKey F4197-ND | 1 | 2 | 1 | 0.88 | DigiKey | https://www.digikey.com/en/products/result?keywords=0287005.PXCN | Yes | $0.44 each, min qty 1 (an aggregator's DigiKey snapshot via the search index 2026-11-05; not read on DigiKey; the link is a DigiKey search) |
| DK5 | Cell NTC and wake branch parts (dock, V1 track 8) | 10 k NTC B3950 (Adafruit 372) in the cell seat to the SENSE strip; 3.9 V zener onsemi 1N5228B, a 1N4148 and 10 k (SENSE to the Pololu 2813 ON pad); 100 k across DK2. The 1N4148 and the resistors come from the dock kits (DOCK_TWIN.md section 7, K4f and K4g) | 1 set | 2 NTC, 2 zeners | 1 | 8.30 | Adafruit, DigiKey | https://www.adafruit.com/product/372 | Yes | page: NTC $4.00 (Adafruit); index: zener $0.15 (DigiKey) |
| DK6 | Dock supply ideal diode (D50, V1 track 8) | Pololu 5382 ideal diode, 4 to 60 V, 10 A, under 10 mOhm, blocks reverse current: from the SYS strip (the dock's gated 9 V) to the switch input node PACK_OR, so the docked duck runs on the dock and the strip is dead when undocked | 1 | 1 | 1 | 3.79 | Pololu | https://www.pololu.com/product/5382 | Yes | Yes: $3.79 (as DK2) |
| DK7 | Pack side ideal diode (D50, V1 track 8) | Pololu 5383 ideal diode, 4 to 60 V, 12 A continuous (about 40 A for a few seconds), under 5 mOhm, LM74700-Q1, 7.6 x 12.7 mm, 0.2 g: between the fused pack (JFO) and the 2813 input, so the dock supply never back-feeds the pack | 1 | 1 | 1 | 4.95 | Pololu | https://www.pololu.com/product/5383 | Yes | page: $4.95, in stock 2026-11-06 (was RobotShop while Pololu was out) |

Subtotal: $892.79

## Fasteners and mechanical

| # | Item | Spec | Need | Buy | Pack | Line $ | Supplier | Link | Ships to USA | Verified |
|---|---|---|---|---|---|---|---|---|---|---|
| 16 | M3 heat-set insert | CNC Kitchen M3 x 5.7, D1 4.6 mm, hole 4.0 mm | 48 | 100 | 100 | 10.90 | CNC Kitchen USA | https://cnckitchenus.store/products/heat-set-insert-m3-x-5-7-100-pieces | Yes (US store) | Yes |
| 17a | M3x8 SHCS | DIN 912 A2 stainless, Bolt Depot 6379 | 18 | 33 | each | 1.98 | Bolt Depot | https://boltdepot.com/Product-Details?product=6379 | Yes (US) | Yes. D42: Need 18 (uniform patterns: body_front on its 4 corners F067, F068, F071, F072; head_bot_sheet on 4 mirrored corners F083, F084, F089, F090; F069 and F088 out; twin/holes/HOLES_TWIN.md addendum). D39: Need 17 (F076 out, back shell on 6 with the ear seats, twin/holes/HOLES_TWIN.md). Need 28 by the per-screw count (fasteners/FASTENERS.md section 2; was 44), Buy cut to the spare rule. $0.06 each from the earlier read (52 for $3.12); Bolt Depot refused plain curl at 2026-11-01 10:30 PM ET (HTTP 403, Cloudflare challenge), so not re-read |
| 17b | M3x10 SHCS | DIN 912 A2, Bolt Depot 6380 | 12 | 14 | each | 0.84 | Bolt Depot | https://boltdepot.com/Product-Details?product=6380 | Yes | Yes |
| 17c | M3x12 SHCS | DIN 912 A2, Bolt Depot 6381 | 2 | 3 | each | 0.18 | Bolt Depot | https://boltdepot.com/Product-Details?product=6381 | Yes | Yes |
| 17d | M3x6 SHCS | DIN 912 A2, Bolt Depot 6378 (horn screws; the 10 hip pitch sites take line 17j, D19) | 78 | 100 | 100 | 3.83 | Bolt Depot | https://boltdepot.com/Product-Details?product=6378 | Yes | Yes. Need 78 by the per-screw count (FASTENERS.md section 2; was 88); one pack of 100 still covers it |
| 17e | M3x5 SHCS | DIN 912 A2, Bolt Depot 6377 (short horn sites: every neck chain horn screw, FASTENERS.md section 4) | 28 | 33 | each | 1.65 | Bolt Depot | https://boltdepot.com/Product-Details?product=6377 | Yes | Yes. Need 28 by the per-screw count (was 12). $0.05 each, $3.78 per 100 (read via search index 2026-11-01 about 10:45 PM ET; plain curl refused, HTTP 403) |
| 17f | M2.5x6 SHCS | DIN 912 A2, Bolt Depot 6370 (electronics; 2 since D54 for the cliff ToF in body_front) | 13 | 20 | each | 1.80 | Bolt Depot | https://boltdepot.com/Product-Details?product=6370 | Yes | Yes (one board: nothing is fitted at the head board.stl copy, B7, FASTENERS.md finding 22) |
| 17g | M2.5x8 SHCS | DIN 912 A2, Bolt Depot 6371 (eyes, each with two 0.3 mm washers from line 17l under the head: 2.4 mm engaged, 0.6 mm to the blind pilot floor, D21) | 4 | 10 | each | 0.90 | Bolt Depot | https://boltdepot.com/Product-Details?product=6371 | Yes | Yes |
| 17i | M2.5x10 SHCS | DIN 912 A2, Bolt Depot 6372 (battery lid, pilot depth 2.1 to 15.3 mm; the 2.5 mm lid holes are drilled to 2.7 mm, D20) | 4 | 5 | each | 0.50 | Bolt Depot | https://boltdepot.com/Product-Details?product=6372 | Yes | Yes: head sits proud on the lid face, clamp 5.2 mm, engagement 4.8 mm, no interference (GLB measured, B3). D42: Need 4 (the lid on all 4 corners, F027 back) |
| 17h | M2 self-tapping kit | METALLIXITY 304 SS M2/M2.6 pan head kit, 400 pcs: 50 each of M2x4, M2x5, M2x6, M2x8 and M2.6x6, x8, x10, x12; M2 head 3.7 x 1.4 mm (listing images). Used: 22 x M2x5 and 2 x M2x8 at servo case pilots, 2 x M2x5 for the camera (the diagonal pair, D38; pilots drilled to 4.5 mm, D34) and 2 x M2x4 at head_roll_mount (FASTENERS.md section 4), 4 x M2x6 at the two mic boards (D47); its 50 M2x6 also cover the 42 servo-bag screws if a bag is short (B2) | 32 (M2x5 24, M2x6 4, M2x4 2, M2x8 2; D38: 2 camera screws out; D47: 4 M2x6 for the two mic boards) | 1 | kit | 9.49 | Amazon (ships from Amazon) | https://www.amazon.com/dp/B0FS13B75Y | Yes | Yes: $9.49, "Only 6 left in stock - order soon", sold by METALLIXITY, ships from Amazon, read 2026-11-01 10:30 PM ET with plain curl; 50 pcs of each size and the head size from the listing images, read 10:31 PM ET. The kit covers every size with spares (50 against 22, 6 and 2), so no extra line. Head fit on coupon C4 and camera length on test order (B21, B9). Alternatives checked 9:08 PM ET: MCMASKE B0B7SK7BKN $13.99 has M2x5 but no M2x4, LBY B07GL2WLDD $9.89 has only M2x6, x10, x16 |
| 17j | M3x6 button head | ISO 7380-1 A2 stainless hex socket button head (head 5.7 x 1.65 mm max, ISO 7380-1), BelMetric SB3X6SS; the 10 hip pitch sites: idle horn F196, F198, F200, F247 (left), F209, F211, F213, F254 (right) and leg_spacer F002, F010 (D19) | 10 | 12 | each | 1.08 | BelMetric (US: "Stocked in the USA", since 1976, +1-978-649-6201) | https://belmetric.com/m3x0-5-button-head-cap-screw-a2-stainless-iso-7380-1/ | Yes (US) | Yes: $0.09 each (1 to 24), $0.07 at 25 to 99, in stock, variant 6 mm SB3X6SS, read 2026-11-01 10:34 PM ET (variant price from the store's own attribute call). Not Bolt Depot: it refused plain curl. Commodity, many sources |
| 17k | M2.5x5 SHCS | DIN 912 A2, BelMetric BSH2.5X5SS; speaker_interface to the 4 side pilots of speaker_stand, F352 to F355 (HARDWARE_AUDIT B8) | 2 | 5 | each | 0.60 | BelMetric (US) | https://belmetric.com/m2-5x0-45-a2-stainless-din-912-allen-socket-head-cap-screw/ | Yes (US) | Yes: $0.12 each (1 to 24), in stock, variant 5 mm BSH2.5X5SS, read 2026-11-01 10:36 PM ET. Commodity |
| 17l | M2.5 flat washer, small series | ISO 7092 A4 HV200, 2.7 x 5.0 x 0.3 mm, BelMetric WFHV2.5X5SSA4; two under each eye screw head (0.6 mm stack: 2.4 mm engaged, 0.6 mm to the blind pilot floor, D21) | 8 | 48 | each | 3.36 | BelMetric (US) | https://belmetric.com/small-o-d-washer-a4-stainless-iso-7092-hv-200-hardened/ | Yes (US) | Yes: $0.07 each (1 to 99; $0.04 at 100 and up), in stock and purchasable, variant WFHV2.5X5SSA4 (M2.5, OD 5 mm, ID 2.7 mm, 0.3 mm thick, A4 HV200) from the store's own attribute call and the page's variant data, read with plain curl 2026-11-02 12:20 AM ET. Buy 48, not 19, so the BelMetric cart (17j to 17l, $5.04) reaches the store's $5 minimum checkout. Replaces the A2 0.5 mm washer Y7092-A2-2.5-2000, a special order box of 2000 for $20.00. Commodity, many sources |
| 17m | M2x12 self-tapping pan head | 304 SS pan head thread-forming screw, M2 x 12 mm (dk 4.0, k 1.6 as the servo bag M2x6): F127 and F129, the hip yaw servo screws that also hold the neck back stop block (D59; twin/sit/SIT.md section 1, fasteners.json); the stock M2x6 cannot reach the case through the block's 4 mm flange, and neither the servo bag nor line 17h (M2x4 to M2x8) has an M2x12 | 2 | 2 | each | 0.00 | BLOCKER | BLOCKER: price not read (no listing read for an M2 x 12 thread-forming pan head in this session); nothing bought | - | BLOCKER: no listing read; a commodity size (M2 x 12 thread-forming pan head, 304 SS), to be read live and bought with the next order; nothing bought in this pass |
| 18 | Ball bearing | 6804ZZ 20x32x7 (CAD model measured 19.99/32.19/7.0), Motoforti 10-pack | 3 | 10 | 10 | 7.74 | Amazon | https://www.amazon.com/dp/B0D99THG1M | Yes | UNVERIFIED at the 2026-11-01 evening recheck: the Motoforti page returned HTTP 503 to plain curl 6 times from 9:08 to 9:40 PM ET while other Amazon pages loaded; the search index has no copy of the listing. Last good read: $7.74, "only 1 left" earlier on 2026-11-01. In-stock US alternative: VXB Bearings (Anaheim, CA) 6804ZZ, 20 x 32 x 7 mm, chrome steel, double metal shields, pre-lubricated, $7.77 each, schema "InStock" (https://vxb.com/products/6804zz-bearing-20x32x7-shielded-20mm-bore); or VXB 10-pack $39.99, "InStock" (https://vxb.com/products/10-pack-6804zz-bearings), read 9:27 PM ET. Fallback buy: 4 singles (3 needed plus 1 spare) = $31.08 |
| 19 | Threadlocker | Loctite 243, 6 mL, P/N 1330799 | 1 | 1 | 1 | 9.90 | Amazon | https://www.amazon.com/dp/B004L439FE | Yes | Yes |
| 29 | Foam mounting tape | 3M VHB 4950, 3/4 in x 5 yd, 1.1 mm (45 mil) acrylic foam, for the BEC Pro, fuse holder, Pololu 2813 (D30), 5 V regulator, amp, the eye LED rings, the side lamp module, its reflector interface and E5 (D33), the D30 button plate flange (MOUNTING.md; twin/assembly/ASSEMBLY_TWIN.md item 1), the chest contact pad DK1 (4 strips of 100 mm), the two MPR121 touch boards (D51) and the foam ring on the speaker duct end, one liner left on (D52); the D59 sit parts: seat (2 strips of 80 mm), belly bumper (2 of 60 mm), 2 knee bumpers (28 mm each), 2 hip pads (22 mm each), 4 ankle pads (8 mm each), about 0.41 m (MOUNTING.md V1 sit) | 1.2 m | 1 | 5 yd | 19.00 | Zoro (3M) | https://www.zoro.com/3m-double-sided-foam-tape-34-in-w-5-yd-l-45-mil-acrylic-foam-double-sided-4950/i/G4323846 | Yes | Read via search index (zoro.com refuses curl, 403); price is the low end of the range shown, stock not verified |

Subtotal: $73.75

## Cables, connectors, wire

| # | Item | Spec | Need | Buy | Pack | Line $ | Supplier | Link | Ships to USA | Verified |
|---|---|---|---|---|---|---|---|---|---|---|
| 20 | USB data cable | Adafruit 3878 USB C to Micro B, 0.9 m, 3.5 mm diameter; the route needs 502.6 mm by the lab rule, coil the rest in the belly (placement usb_slack) | 1 | 1 | 1 | 3.50 | Adafruit | https://www.adafruit.com/product/3878 | Yes | Yes: $3.50, in stock 2026-11-01 (B18 cleared) |
| 21 | Mini-SPOX housing | Molex 50-37-5033, 3 pos 2.5 mm (mates STS3215 5264 sockets); 7 made-lead housings after D15 and D23: ID 20, ID 10 and ID 30 BUS 2 (power plus data), adapter H3 and H5 (data only) and ID 24 and ID 14 BUS 1 (SP4, SP5: V and G only), netlist count | 7 | 10 | 1 | 1.43 | Newark 57H1785 | https://www.newark.com/search?st=50-37-5033 | Yes | Yes: $0.143 each at 1+ (one made lead, S14); not re-read at the 2026-11-01 9:05 PM ET recheck: Newark and Mouser refuse plain curl (HTTP/2 stream reset, empty reply), so only the search index can re-read this line until that changes |
| 22 | Mini-SPOX crimp terminal | Molex 08-70-1040 (5263, 22 to 28 AWG); 17 crimped ends in the netlist (D15, D23) | 17 | 30 | 1 | 5.40 | Newark 54H5573 | https://www.newark.com/search?st=08-70-1040 | Yes | Yes: $0.180 each at 25+ (Mouser $0.23, 160,210 in stock, read via search index); not re-read at the 2026-11-01 9:05 PM ET recheck: Newark and Mouser refuse plain curl (HTTP/2 stream reset, empty reply), so only the search index can re-read this line until that changes |
| 22b | KK 254 crimp terminal (X1, D36) | Molex 08-50-0114, KK 254 2759 series, 22 to 30 AWG, 3 A ([I] https://www.datasheets.com/molex/08-50-0114, search text; 4 A on Octopart); the 27 Pi header ends (D2 to D10, P12, P17) crimped instead of soldered, so the Pi unplugs | 27 | 30 | each | 2.55 | Octopart (lowest listed) | https://octopart.com/part/molex/08-50-0114 | Yes | Yes: $0.085 each (Octopart, search index 2026-11-04) |
| 22c | KK 254 crimp housings (X1, D36) | Molex KK 254 1-row housings (2695 series), one per Pi header cable, widths from the pin map in wiring/netlist.yaml (11 cables) | 11 | 11 | each | 0.00 | BLOCKER | BLOCKER: price not read (no listing found for 22-01-3027 in this session) | Yes | BLOCKER: price |
| L5 | Power wire 16 AWG | BNTECHGO silicone red and black 25 ft each (netlist cut lengths: red 0.68 m, black 0.66 m, with the P7 extensions) | 1.3 m | 1 | 50 ft | 19.98 | Amazon | https://www.amazon.com/dp/B01MCRY7OT | Yes | Yes |
| 23 | Wire 20 AWG | BNTECHGO silicone red 25 ft and black 25 ft (netlist cut lengths: red 1.51 m, black 1.26 m since D50; the dock SYS leads are red) | 2.8 m | 1 | 50 ft | 12.48 | Amazon | https://www.amazon.com/BNTECHGO-Gauge-Silicone-Wire-Temperature/dp/B01F8PO5XE | Yes | Yes |
| 24 | Wire 22 AWG | BNTECHGO silicone 6 colors 25 ft each (netlist cut lengths: black 1.78 m, red 1.31 m, yellow 0.48 m, with SP4 and SP5 and the 30 mm splice tails) | 3.6 m | 1 | 150 ft | 16.98 | Amazon | https://www.amazon.com/BNTECHGO-Silicone-Spool-Color-100ft/dp/B09X4KY56S | Yes | Yes |
| 25 | Wire 26 AWG | BNTECHGO silicone 7 colors 25 ft each (netlist cut lengths 12.7 m in all, black 4.37 m the most of one colour, 2026-11-05 with D50) | 12.7 m | 1 | 175 ft | 15.98 | Amazon | https://www.amazon.com/dp/B08F9CF85N | Yes | Yes |
| 26 | Heat shrink | Wirefy 3:1 adhesive lined, 180 pcs, 3.5 in each: 70 x 3/32 in, 50 x 1/8 in, 25 x 3/16 in, 16 x 1/4 in, 9 x 3/8 in, 5 x 1/2 in, 5 x 3/4 in (the 3/4 in count is 180 less the other six). The robot uses 42 sleeves (BOM_FULL rule, with D50): 6 x 3/32, 11 x 1/8, 10 x 3/16, 9 x 1/4, 3 x 3/8 in, and 3 small lead joints whose size waits for the lead diameters (D50 adds 4 x 3/32 on the NTC and wake diode leads, 1/8 on splice JSN, 3/16 on splice JGD and the two DK3 holder leads; calc only) | 1 | 1 | 180 | 14.99 | Amazon | https://www.amazon.com/Wirefy-180-Heat-Shrink-Tubing/dp/B084GDLSCK | Yes | Yes; count per size from the amazon.fr listing of the same ASIN B084GDLSCK read through the search index 2026-11-02 about 1:30 AM ET (amazon.com is outside this session's network); 3.5 in pieces from the everymarket.com and thecncsource.com listings and wirefyshop.com, search index, same time |
| 26b | Lever splices (X4, D36) | WAGO 221 pocket pack: 3 each of 221-412, 221-413 and 221-415 (24 to 12 AWG, 20 A, 600 V: [I] https://core-electronics.com.au/wago-snap-action-solderless-connection-5-conductor-221-415.html, search text); splice G uses one 221-415 (4 wires), VSW one 221-413 (3 wires), in the battery bay | 2 | 1 | 9 | 13.25 | eBay | https://www.ebay.com/p/2255633067 | Yes | Yes: $13.25 with free shipping (eBay, search index 2026-11-04); outline not read: the 3D job checks the battery bay space |
| 30 | Solder wire | Adafruit 1886: tin-lead, 63/37 since 2019-09-20 (page), no-clean rosin core, 0.5 mm (page also says about 0.6 mm), 50 g. Leaded: easier on 16 AWG with the Pinecil; wash hands after use | 145 soldered wire ends in wiring/netlist.yaml, 24 of them 16 AWG, 15 splices with 52 wire ends in them (recounted 2026-11-02 about 5:15 AM ET by agent INT with the viewer/bom_full.py rule behind BOM_FULL.md K01: solder, header pin, resistor and LED lead, splice and XT30 cup ends of active wires; ends marked 'holder lead' or 'BEC lead', the part's own lead, are not counted) | 1 | 50 g | 9.25 | Adafruit 1886 | https://www.adafruit.com/product/1886 | Yes (US store) | Yes: $9.25, "7 in stock", read 2026-11-01 9:25 PM ET. 50 g is about 21 to 30 m of wire at 0.6 to 0.5 mm (calculated with 8.4 g/cm3). Lead-free option: Adafruit 2473, Sn99.3 Cu0.7, 2.2 % no-clean rosin flux, 0.5 mm, 50 g, $12.50, "29 in stock" (https://www.adafruit.com/product/2473). Adafruit 0.8 mm spools 5897 and 734 are out of stock. Commodity, many sources |
| 31 | Flux pen (optional, recommended for 16 AWG) | Chip Quik CQ4LF no-clean liquid flux pen, 10 mL, for leaded and lead-free solder, classification printed as "INM0", shelf life over 24 months (page) | 1 | 1 | 10 mL | 7.95 | Adafruit 3468 | https://www.adafruit.com/product/3468 | Yes (US store) | Yes: $7.95, "In stock", read 2026-11-01 9:26 PM ET. Commodity, many sources |
| 32 | Cable ties | Commercial Electric GT-100MCB, 4 in (about 100 mm), 0.1 in (2.5 mm) wide, PA66 nylon, 18 lbf, UL 21 rated, UV black (page); one through each line 34 or 34b mount, through each drilled tie-hole pair (print/PRINT_PLAN.md After printing), through the stock holes and around the bundle along every cable (cables3d/cables3d.json retention), and at the servo power splices and the USB slack coil (MOUNTING.md) | 75 along the cables (cables3d.json retention, file of 2026-11-02 4:31 AM ET: 27 through line 34 MB3A mounts, 24 through line 34b ABM1M-AT-C mounts (D59); 3 through drilled tie-hole pairs; 6 through stock holes in printed parts; 2 to an anchored neighbour cable; 9 round the bundle only, checked at the TEST_PLAN 1.4 test fit (D25: no anchor fits there)) plus 1 to 3 (MOUNTING.md); 94 with 20 % spares | 1 | 100 | 9.41 | Home Depot | https://www.homedepot.com/p/Commercial-Electric-4in-Miniature-Standard-UL-21-Rated-Cable-Zip-Ties-100-Pack-UV-Black-GT-100MCB/203531918 | Yes | Yes: $9.41 a pack ("09¢ /tie"), "Includes 100 ties", width 0.1 in, page data buyable, stock count not in the page; re-read 2026-11-01 11:23 PM ET with plain curl (first read 9:25 PM ET). Buy back to 1 pack: the D25 count with spares is 94 (it was 2 packs for the 114 of the 2:27 AM ET file). The search page showed $10.78 for the same model at the first read; the product page says local store prices may vary. Commodity, many sources |
| 34 | Adhesive tie mount | HellermannTyton 151-01629 (type MB3A): 19.0 x 19.0 x 4.8 mm, 4-way, for ties up to 3.6 mm wide (the 2.5 mm line 32 ties fit), 3M VHB acrylic foam adhesive, two predrilled 3.0 mm holes at 13.2 mm centres for a screw as the backup (the M2.6 self-tapping screws in the line 17h kit pass), PA66 impact modified, heat and UV stabilized, black, -40 to +80 C, UL 94 HB (HellermannTyton spec sheet, https://ftcelectronics.com/datasheets-3c/151-01629.pdf, read 2026-11-01 11:17 PM ET). One line 32 tie through each. Fitting: wipe the spot with isopropyl alcohol first; press 30 s; let the adhesive cure before loading (alcohol: line 35) | 27 (cables3d.json retention, file of 2026-11-02 4:31 AM ET: the spots where a flat 19 x 19 mm patch with 4.8 mm free height fits, exact-ray check, one mount per spot; 24 more spots take only the line 34b mount; cables3d/CABLES_3D.md. D59 sit: 32 to 27, the stop lugs and cuts took 5 spots: T030, T035 and T044 take the small mount now, T046 and T071 a tie round the bundle at the test fit, twin/sit/sit_cables.py); 39 with 20 % spares | 1 | 100 | 58.00 | Standard Electric Supply (US) | https://www.standardelectricsupply.com/Hellermann-Tyton-151-01629-151-01629-offers-adhesive-mounts-in-a-variety-of-sizes-to-match-your-cable-tie-size-and-extreme-dut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 | Yes (US) | Read via search index (the site gives plain curl a Cloudflare challenge, HTTP 403, 2026-11-01 11:17 PM ET): $58.00 per 100, 1,100 in stock, same-day shipping in the newest copy; an older copy showed $56.00 per 100 and 400 in stock. Read live with plain curl, the fallback: Hisco (Houston, TX) $112.00 per pack of 100, "Available to Order - 0 on Hand", maker lead time 14 days (https://www.hisco.com/Product/151-01629-22951, 11:18 PM ET). VHB option with no screw hole stated: Panduit ABMM-AV-C, 0.75 x 0.75 in, Elliott Electric $131.00 per 100, "Available from manufacturer" (https://www.elliottelectric.com/P/Item/PAN/ABMMAVC, 11:21 PM ET) |
| 34b | Adhesive tie mount, small | Panduit ABM1M-AT-C: 4-way cable tie mount, 0.50 x 0.50 in (12.7 x 12.7 mm), nylon 6.6, acrylic adhesive tape for indoor high-temperature use, white, in strips of 2, packs of 100, for miniature cable ties (Hisco page). Largest tie width 0.1 in (2.54 mm): Steiner Electric listing title "Cable Tie Mount, 4-Way, Adhesive Mount, 0.1 in W Max, Nylon, White" (https://www.steinerelectric.com/Product/Panduit-ABM1M-AT-C-Cable-Tie-Mount4-WayAdhesive-Mount0-1-in-W-MaxNylonWhite-328854); height 0.16 in (4.06 mm): myMectronic (https://www.mymectronic.com/part-detail/Panduit/ABM1MATC); North Coast lists ABM1M-AT-M at .50 x .50 in (12.7 mm), height 0.15 in (https://www.northcoast.com/product/detail/287824/panduit-abm1m-at-m); all read through a search index at about 4:50 AM ET 2026-11-02. The 2.5 mm (0.1 in) line 32 tie is at the 0.1 in (2.54 mm) maximum; the CAD check left 4.1 mm free height. No screw hole. Goes where cables3d finds a flat 13 x 13 mm patch but no 19 x 19 mm one (exact-ray check). One line 32 tie through each. Fitting as line 34 (alcohol wipe, line 35) | 24 (cables3d.json retention, file of 2026-11-02 4:31 AM ET; D59 sit: 23 to 24, +3 from line 34, -2 where the cuts took the patch, T047 and T048); 28 with 20 % spares | 1 | 100 | 72.41 | Hisco (Houston, TX) | https://www.hisco.com/Catalog/Electrical/Cable-Ties-Fasteners/Cable-Tie-Mounts/ABM1M-AT-C-38146 | Yes (US) | Yes: $72.41 per package of 100 (5 packs $70.29 each), "Availability: 2 In Stock" (packages), maker lead time 38 days when not in stock, minimum 1 package, country of origin US, not discontinued in the page data (Hisco #10014870), read 2026-11-02 2:43 AM ET with plain curl. Not single source: Steiner Electric, Stanion, Heilind and Connecticc are other US distributors that list it (search index, about 4:50 AM ET; prices not read). If the 2 Hisco packs go first, the 38-day lead time applies there. Equal named in D25: HellermannTyton MB2APT 151-00996 (13.0 x 13.0 x 4.1 mm, ties up to 2.7 mm, HellermannTyton catalogue 2016/2017 p. 1.7 via docs.rs-online.com, read 1:53 AM ET), no US price read. No test order: the fit is checked at the dry fit (TEST_PLAN.md 1.4) |
| 35 | Isopropyl alcohol | Techspray 1610-P, 99.8 % anhydrous isopropyl alcohol, no denaturant, ACS reagent grade, 1 pint bottle, flammable (flash point 53 C), shelf life 1825 days (page). Wipe each line 34 and 34b mount spot and each line 29 VHB tape spot with a clean cloth or paper towel wetted with it, then let it dry before the adhesive goes on; 3M's VHB surface preparation bulletin calls for a 50:50 isopropyl alcohol and water wipe on most surfaces and 3M also lists 70:30 (read via search index; 3m.com refuses curl), so a 70 % pharmacy rubbing alcohol also works | 1 bottle (55 mount spots of lines 34 and 34b plus the line 29 tape spots) | 1 | 1 pt | 14.33 | TestEquity (Moorpark, CA) | https://www.testequity.com/brand/Techspray/category/Chemicals-Cleaning-And-Abrasives/Industrial-Chemicals-And-Cleaners/Alcohol/754CH610-1610-P | Yes (US; ground only, "Cannot Ship Air") | Yes: $14.33, schema "InStock", no minimum shown, read 2026-11-01 11:25 PM ET. Smaller bottle checked: MG Chemicals 824-100ML (125 mL) $9.75 at TestEquity but minimum 10 and "OutOfStock" (https://www.testequity.com/product/484-431-824-100ML), $11.24 "Sold out" at Marvac (https://marvac.com/collections/isopropyl-alcohol), both 11:25 PM ET. Same cart as line 32: Home Depot Max Pro ISO-3467, 10 oz, "99.9% pure", $16.99, page data buyable (https://www.homedepot.com/p/Max-Pro-10-oz-Isopropyl-Alcohol-Precision-All-Purpose-Cleaner-ISO-3467/319907805, 11:24 PM ET). Commodity, many sources |
| 33 | Polyimide (Kapton) tape | Adafruit 3057 polyimide tape, 10 mm wide, 33 m roll, stable from about -269 C to +400 C (page); thickness and dielectric strength not stated (UNVERIFIED). Wraps the Tenergy BMS, 34 x 16 x 4.5 mm (MOUNTING.md: "wrap in kapton tape before it goes in") | about 0.2 m (2 turns of 77 mm around the 34 x 4.5 mm section to cover the 16 mm width, calculated) | 1 | 33 m roll | 4.95 | Adafruit 3057 | https://www.adafruit.com/product/3057 | Yes (US store) | Yes: $4.95, "35 in stock", read 2026-11-01 9:26 PM ET. Commodity, many sources |

Subtotal: $282.84

## Print material

| # | Item | Spec | Need | Buy | Pack | Line $ | Supplier | Link | Ships to USA | Verified |
|---|---|---|---|---|---|---|---|---|---|---|
| 27 | PLA | Overture Easy PLA 1.75 mm 1 kg, black (need 1407 g sliced with the light profile of DECISIONS.md D22: robot set 1258 g (roll_to_pitch at 3 walls since D38) plus the coupon session and 10 spares, print/PRINT_PLAN.md; about 593 g left for failed prints; 1450 g if the D22 coupon gate fails. D59 sit: the robot set +28.5 g of PLA (joggled shin sheets and the longer shin spacer in place of the shin knee_to_ankle pair and leg_spacer, the cache cuts, the foot notches, the hip roll lugs, the neck stop block 14.7 g, the head hook +8.2 g of filament on head_pitch_to_yaw (24.8 g with its support), the roll lugs 25.8 g each; print/SLICE_SUMMARY.md D59 rows: robot set 1355.5 g) and one spare of each shin sheet +22.7 g, so about 1440 g, still 2 x 1 kg) | 1420 g | 2 | 1 kg | 29.98 | Amazon | https://www.amazon.com/dp/B09LCK7QJ2 | Yes | Yes; note 2026-11-01: Easy Black was out of stock at overture3d.com (other colors in stock, nozzle 190 to 220 C, bed 25 to 60 C); any in-stock color works |
| 28 | TPU | Overture TPU 95A 1.75 mm 1 kg, black (need 75.1 g sliced with the D22 profile: two soles, one of them in coupon session S2, print/PRINT_PLAN.md, 35.1 g; the D59 sit parts 40.0 g: seat 22.6 g, belly bumper 12.2 g, 2 knee bumpers, 4 ankle pads, 2 hip pads, 2 neck pads 0.5 g, 1 head pad 0.9 g, 2 roll pads 0.2 g; hardness not stated upstream) | 75.1 g | 1 | 1 kg | 23.99 | Amazon | https://www.amazon.com/dp/B0BGMP1MZ7 | Yes | Yes: maker states "95A Shore hardness", nozzle 210 to 240 C, bed 35 to 50 C, print at 20 to 40 mm/s; Matte Black $22.99 in stock at overture3d.com 2026-11-01; grip on the coupon session (B26) |

Subtotal: $53.97

## Expression (optional upstream)

| # | Item | Spec | Need | Buy | Pack | Line $ | Supplier | Link | Ships to USA | Verified |
|---|---|---|---|---|---|---|---|---|---|---|
| E1 | Speaker | Same Sky CMS0361KLX, 36 x 36 x 14.5 mm square frame, 8 ohm, 2 W, 4 x 1.6 mm holes; fits the CAD envelope 38.5 x 38.7 x 15 mm (1.2 mm per side, 0.2 to 0.8 mm depth); MAX98357A gives 1.8 W into 8 ohm; held with foam tape (BOM 29) | 1 | 1 | 1 | 14.82 | DigiKey 102-1304-ND | https://www.digikey.com/en/products/detail/same-sky-formerly-cui-devices/CMS0361KLX/765285 | Yes | Read via search index: $14.82, 2,707 in stock (digikey.com refuses curl). B8 open: fit checked on test order TO7 and TO10 (HARDWARE_AUDIT.md); alternative Same Sky CLS0361-L152 (36 x 6 mm) if depth is tight |
| E2 | I2S amplifier | Adafruit MAX98357A 3006 | 1 | 1 | 1 | 5.95 | Adafruit | https://www.adafruit.com/product/3006 | Yes | Price yes; mount NO (not in CAD) |
| E3 | LEDs | 1 W warm white LED beads, 10 pcs (upstream bom.csv: 1 W beads) | 3 | 10 | 10 | 6.89 | Amazon (uxcell) | https://www.amazon.com/dp/B07DHB13J4 | Yes | Yes (B23) |
| E3b | LED resistor | 100 ohm 1/4 W, 20 pcs (Tnkr m7: 100 ohm per eye LED on GPIO; a third one for the projector LED, D13) | 3 | 20 | 20 | 1.50 | SparkFun PRT-14493 | https://www.sparkfun.com/resistor-100-ohm-1-4-watt-pth-20-pack-thick-leads.html | Yes | Yes (B23) |
| E4 | Eye glass | round discs for the CAD eye glass ø29.6 x 1.85 mm, 60 pcs | 2 | 60 | 60 | 8.89 | Amazon (FINGERINSPIRE) | https://www.amazon.com/dp/B0C4H17QSH | Yes | Price yes; disc fit checked with the left_eye test print |
| E5 | Projector reflector | Aurorad S5 aluminium reflector 20x15 mm, 7 mm LED hole (CAD seat tapers to 20.0 mm, about 10 mm deep, narrow end 8.07 mm) | 1 | 1 | 1 | 9.15 | Amazon (Aurorad) | https://www.amazon.com/dp/B0BGS3C42N | Yes | Price yes (in stock, ships in 3 to 4 days); seat height on test order |
| E6 | Camera | Raspberry Pi Camera Module 3, 21 x 12.5 mm holes match head.stl pilots 20.9 x 12.5 (B9) | 1 | 1 | 1 | 29.25 | Adafruit 5657 | https://www.adafruit.com/product/5657 | Yes | Yes (in stock 2026-11-01) |
| E7 | Camera cable (D34) | Raspberry Pi Camera Cable Standard-Mini 300 mm, 22-pin 0.5 mm (Pi Zero) to 15-pin 1 mm (camera); flat strip route 227.3 mm, 72.7 mm spare in one gentle loop of radius 6 mm (twin/complete3d/COMPLETE3D.md section 9) | 1 | 1 | 1 | 2.94 | X-On Electronics | https://www.xonelec.com/mpn/raspberrypi/rpicameracablestandardmini300mm | Yes | Price US$2.94 via search index 2026-11-04, stock not verified; same part at Pakronics, RPI-SC1129, A$3.52 (https://www.pakronics.com.au/products/raspberry-pi-camera-cable-standard-mini-300mm-rpi-sc1129); width and thickness BLOCKER until the TO9 caliper check (B61) |
| E7r | Camera cable, replaced (D34) | Pi Zero camera cable 150 mm, Adafruit 3157: 77 mm short of the flat strip route (B61) | 0 | 0 | 1 | 0.00 | Adafruit 3157 | https://www.adafruit.com/product/3157 | Yes | replaced (D34), quantity 0 |
| E8 | I2S microphones (D47) | Adafruit I2S MEMS Microphone Breakout SPH0645LM4H, product 3421: Knowles SPH0645LM4H-B bottom-port I2S mic (datasheet Rev B: 2.048 to 4.096 MHz clock, AOP 120 dB SPL, SNR 65 dB(A)); 2 boards, one per side wall of the head, SEL low on the left, high on the right, sharing the MAX98357A clocks, data on GPIO20; board 16.51 x 12.7 mm (board files), 16.7 x 12.7 x 1.8 mm overall and 0.4 g (product page); Adafruit marks its ICS-43434 board (6049) discontinued with the SPH0645LM4H as the drop-in; the bare SPH0645LM4H is listed obsolete at one parts index and a DigiKey search result, so buy both boards in one order (single source, Knowles, US maker; not Chinese) | 2 | 2 | 1 | 13.90 | Adafruit 3421 | https://www.adafruit.com/product/3421 | Yes | Yes: $6.95 each (1 to 9), "In stock", read on the Adafruit page 2026-11-05 about 7:45 PM ET with plain curl; Jameco also lists 3421 (jameco.com) |
| E9 | Touch boards (D51) | Adafruit MPR121 12-key capacitive touch breakout, STEMMA QT, product 1982: I2C 0x5A, 0x5B with ADDR to 3Vo; 3 to 5 V (own regulator); 33.0 x 19.1 mm; mass not published. Head board TCHH (0x5A) on VHB on the inner roof of the head, body board TCHB (0x5B) on VHB on the left inner side wall of body_middle_top; polled on the software I2C bus 1 (IRQ unwired) (twin/freeze/touch_pads.json) | 2 | 2 | 1 | 15.90 | Adafruit | https://www.adafruit.com/product/1982 | Yes | Yes: $7.95 each (1 to 9), in stock, read 2026-11-06 ET |
| E10 | Touch pad foil (D51) | Adafruit 1127 copper foil tape with conductive adhesive, 25 mm x 15 m, 0.07 mm: pads PH1 30 x 30 mm (head top), PH2 20 x 30 mm (back of the head), PB1 17 x 34 mm (back behind the neck), each with a 3 mm guard ring 3 mm outside it to GND (NXP AN3863); about 0.3 m of tape in all | 0.3 m | 1 | 15 m | 19.95 | Adafruit | https://www.adafruit.com/product/1127 | Yes | Yes: $19.95, 22 in stock, read 2026-11-06 ET; $0 if a roll is on hand |

Subtotal: $129.14

## Tools (one-time)

| # | Item | Spec | Need | Buy | Pack | Line $ | Supplier | Link | Ships to USA | Verified |
|---|---|---|---|---|---|---|---|---|---|---|
| T1 | Soldering iron | Pine64 Pinecil V2 (needs a USB-C PD 20 V 3.25 A supply: lines T6 and T6b) | 1 | 1 | 1 | 25.99 | Pine64 | https://pine64.com/product/pinecil-smart-mini-portable-soldering-iron/ | Yes (ships from Pine64; US warehouse not verified) | Yes |
| T2 | Insert tips | Pinecil threaded insert tips set and adapter | 1 | 1 | 1 | 14.99 | Pine64 | https://pine64.com/product/pinecil-threaded-insert-tips-set-and-adapter/ | Yes | Yes |
| T3 | Crimper | Engineer PA-09 (Mini-SPOX 5263 and JST XH per DigiKey chart) | 1 | 1 | 1 | 37.93 | Amazon | https://www.amazon.com/Engineer-PA-09-Micro-Connector-Crimpers/dp/B002AVVO7K | Yes | Yes |
| T4 | Hex keys | Bondhus 12192 hex L-keys 1.5 to 6 mm, 7 pc (2.0 mm for M2.5, 2.5 mm for M3 SHCS) | 1 | 1 | 7 pc | 7.84 | Crawford Tool | https://crawfordtool.com/products/bondhus-12192-metric-hex-key-set-l-wrenches-7-pieces-1-5mm-to-6mm | Yes | Yes |
| T5 | Wire stripper | Klein 11057, 22 to 32 AWG stranded | 1 | 1 | 1 | 21.97 | Home Depot | https://www.homedepot.com/p/Klein-Tools-Klein-Kurve-Wire-Stripper-and-Cutter-20-30-AWG-Solid-22-32-AWG-Stranded-11057/100352112 | Yes | Yes |
| L2 | BEC programmer | Castle Link V4 011-0173-00 (needs Windows 10 PC) | 1 | 1 | 1 | 29.95 | Castle Creations | https://castlecreations.com/products/accessories-castle-link-v4-psoc-usb-programming-kit-011-0173-00 | Yes | Yes |
| T6 | USB-C PD supply for T1 | Amazon Basics 65W One-Port GaN, PD 3.0: 5 V 3 A, 9 V 3 A, 12 V 3 A, 15 V 3 A, 20 V 3.25 A; no cable in the box; 1 year limited warranty (page). Pinecil V2 need: "minimum of 3 amps"; the stock ST-B2 short tip is 6.2 ohm, so 20 V / 6.2 ohm = 3.2 A = 64 W (Pine64 power chart, https://wiki.pine64.org/wiki/Pinecil); Pine64 recommends "a USB-C PD65W, 20V, 3+ A charger"; this charger is on Pine64's tested list (https://wiki.pine64.org/wiki/Pinecil_Power_Supplies). Store spec: "USB type C: PD and QC 3.0 12V-20V 3A" (https://pine64.com/product/pinecil-smart-mini-portable-soldering-iron/) | 1 | 1 | 1 | 18.89 | Amazon (ships from and sold by Amazon.com) | https://www.amazon.com/dp/B087MD5MYH | Yes | Yes: $18.89, "In Stock", "Ships from and sold by Amazon.com", read 2026-11-01 9:10 PM ET. Multi-source item (any PD 3.0 65 W supply with a 20 V 3.25 A profile) |
| T6b | USB-C to USB-C cable, 5 A | Adafruit 4199, USB 3.1 Gen 4 with E-Mark, 1 m; Adafruit: it "includes an EMARK chip ... you can use this for high current (5A) charging". The 3.2 A short tip draw at 20 V is above 3 A, so the cable needs the 5 A e-marker | 1 | 1 | 1 | 9.95 | Adafruit 4199 | https://www.adafruit.com/product/4199 | Yes (US store) | Yes: $9.95, "In stock", read 2026-11-01 9:12 PM ET. Not silicone; the silicone cables on Pine64's list read "Currently unavailable" on Amazon today (B096XWD2HG, B093GFBD2M). Also fits as the PC to Waveshare adapter USB-C cable for the Feetech tool |
| T7 | Robot charge adapter, 5 V | Amazon Basics 12W One-Port USB-A wall charger, up to 2.4 A, no Quick Charge, cable not included (page). Adeept board (line 11) input from its listing: "Charging board input voltage DC 3-6V (DC 3.7V 5V recommended)", input current 2 A and charging current 1.1 A for the 2A version, charging voltage 8.4 V; no PD or QC input is listed (https://www.amazon.com/Adeept-18650-Charge-Charging-Board/dp/B0BJTW4QBR, read 9:08 PM ET) | 1 | 1 | 1 | 8.70 | Amazon (ships from and sold by Amazon.com) | https://www.amazon.com/dp/B0773J79KC | Yes | Yes: $8.70, "In Stock", "Ships from and sold by Amazon.com", read 2026-11-01 9:13 PM ET. Commodity, many sources |
| T7b | USB-A to USB-C cable | Amazon Basics USB-A to USB-C, USB 2.0, USB-IF certified, 3 ft, maximum current 3 A, 15 W at 5 V (page). An A to C cable carries the resistor that tells the board it may draw 5 V (Adafruit on its A to C cable: "The cable has built in resistors to force it to 5V power", https://www.adafruit.com/product/4474), so it works whether or not the Adeept board has USB-C CC pull-down resistors (its listing does not say) | 1 | 1 | 1 | 4.88 | Amazon (ships from and sold by Amazon.com) | https://www.amazon.com/dp/B085SBKFJR | Yes | Yes: $4.88, "In Stock", "Ships from and sold by Amazon.com", read 2026-11-01 9:14 PM ET. Also a PC (USB-A) to Waveshare adapter data cable. The 6 ft version B01GGKYN0A read "Temporarily out of stock" |
| T8 | microSD card reader (optional, often on hand) | Adafruit 5212 USB Type C microSD card reader/writer, mass storage, no driver (page); USB-C plug, so the PC needs a USB-C port | 1 | 1 | 1 | 6.95 | Adafruit 5212 | https://www.adafruit.com/product/5212 | Yes (US store) | Yes: $6.95, "86 in stock", read 2026-11-01 9:23 PM ET. USB-A readers checked are out: Adafruit 939 "No longer stocked", SparkFun COM-13004 "Out of stock", PiShop reader "Out of stock" |
| T9 | Wire stripper 12 to 20 AWG | Klein 11055, "Strips, cuts, loops 10-18 AWG solid and 12-20 AWG stranded wire" (page); covers the 16 AWG and 20 AWG runs that T5 (22 to 32 AWG) cannot | 1 | 1 | 1 | 20.99 | Home Depot | https://www.homedepot.com/p/Klein-Tools-Solid-and-Stranded-Copper-Wire-Stripper-and-Cutter-11055/100630708 | Yes | Yes: $20.99, page data buyable, not discontinued, stock count not in the page; read 2026-11-01 9:31 PM ET |
| T10 | Heat gun | Wagner Furno 300, dual temperature, corded, 10 A, 20 cu ft/min, minimum temperature 750 F, 2 year limited warranty (page specs); for the adhesive lined 3:1 heat shrink (line 26); shrink each joint before it goes near printed PLA | 1 | 1 | 1 | 29.00 | Home Depot | https://www.homedepot.com/p/Wagner-Furno-300-Dual-Temperature-Corded-Heat-Gun-0503059/206723935 | Yes | Yes: $29.00, page data buyable, not discontinued, stock count not in the page; read 2026-11-01 9:31 PM ET |
| T11 | Drill bit 6.0 mm | HSS jobber, black oxide, 118 deg point, round shank, 70 mm flutes, Qualtech DWDMM6.00; opens the 24 neck chain screw recesses from 5.5 to 6.0 mm after printing and on coupon C4 (D20, print/PRINT_PLAN.md "After printing") | 1 | 1 | 1 | 1.41 | Drills and Cutters (Doral, FL) | https://drillsandcutters.com/6-00mm-hss-jobber-length-drill-bit/ | Yes (US) | Yes: $1.41 (list $2.47), "Ships Today!", read 2026-11-01 10:42 PM ET. Commodity, many sources |
| T12 | Drill bit 2.7 mm | HSS jobber, black oxide, 118 deg point, round shank, Qualtech DWDMM2.70; opens the 4 battery_pack_lid clearance holes from 2.5 to 2.7 mm (D20) | 1 | 1 | 1 | 0.74 | Drills and Cutters (Doral, FL) | https://drillsandcutters.com/2-70mm-hss-jobber-length-drill-bit/ | Yes (US) | Yes: $0.74 (list $1.29), "Ships Today!", read 2026-11-01 10:42 PM ET. Commodity, many sources |
| T13 | Hand holder for T11, T12, T14 and T15 | Qualtech DWTD328 T-handle tap wrench for 1/16 to 1/4 in taps, carbon steel; turns the bits by hand, slowly, so the cut in PLA stays controlled (no power tool) | 1 | 1 | 1 | 7.99 | Drills and Cutters (Doral, FL) | https://drillsandcutters.com/1-16-1-4-t-handle-tap-wrench/ | Yes (US) | Price yes: $7.99 (list $14.01), "Ships Today!", read 2026-11-01 10:42 PM ET. The page rates it by tap size only; its grip on round 2.7 and 6.0 mm shanks is not stated (UNVERIFIED). Fallback: turn the bits by hand, as print/PRINT_PLAN.md already does with bare bits, or a cordless drill at low speed if one is on hand |
| T14 | Drill bit 4.0 mm | HSS jobber, black oxide, 118 deg point, round shank, 75 mm long, 54 mm flutes, Qualtech DWDMM4.00; drills the 4.0 mm lead hole for the projector LED (D7) through the printed head wall (D24) and the three D25 cable tie-hole pairs (two in neck_right_sheet, one in the left leg's knee_to_ankle_right_sheet) (print/PRINT_PLAN.md "After printing" steps 4 and 5); turned in the T13 holder | 1 | 1 | 1 | 0.93 | Drills and Cutters (Doral, FL) | https://drillsandcutters.com/4-00mm-hss-jobber-length-drill-bit/ | Yes (US) | Yes: $0.93 (list $1.62), in stock, "Ships Today!", read 2026-11-02 12:36 AM ET with plain curl. Commodity, many sources |
| T15 | Drill bit 4.5 mm (contingency) | HSS jobber, black oxide, 118 deg point, round shank, 80 mm long, 56 mm flutes, Qualtech DWDMM4.50; opens the M2 screw recesses only if coupon C4 shows a servo-bag screw head that does not fit (D20 coupon gate) | 1 | 1 | 1 | 0.96 | Drills and Cutters (Doral, FL) | https://drillsandcutters.com/4-50mm-hss-jobber-length-drill-bit/ | Yes (US) | Yes: $0.96 (list $1.69), in stock, "Ships Today!", read 2026-11-02 12:36 AM ET with plain curl; same supplier as T11 to T14, so it rides on that order. Commodity, many sources |
| T16 | Screwdriver PH 0 (D36) | Wera 2050 PH 0 x 60 mm, blade 3.0 mm, for the cross-head screws (twin/assembly/ASSEMBLY_TWIN.md item 2, B53) | 1 | 1 | 1 | 7.91 | Haus of Tools | https://hausoftools.com/products/wera-05118022001-2050-precision-phillips-electronics-screwdriver-ph-0-x-60-mm | Yes | Yes (D36) |
| T17 | Screwdriver PH 1 (D36) | Wera 2050 PH 1 x 80 mm, blade 4.0 mm | 1 | 1 | 1 | 9.76 | Haus of Tools | https://www.hausoftools.com/products/wera-05118024001-2050-ph-screwdriver-for-phillips-screws-for-electronic-applications-ph-1-x-80-mm | Yes | Yes (D36) |
| T18 | Bit PH 0 x 25 mm (D36) | Wera 851/1 Z PH 0 x 25 mm, 1/4 in hex, for the six screws with 35.6 to 58.5 mm free | 1 | 1 | 1 | 1.95 | Jensen Tools | https://www.jensentools.com/product/873SC5651-05056500001 | Yes | Yes (D36) |
| T19 | Drill bit 1/16 in (D36) | Hyper Tough 3 piece 1/16 in HSS roll forged bits, AU00040K; the camera pilots (print/PRINT_PLAN.md After printing) | 1 | 1 | 3 | 1.98 | Walmart | https://www.walmart.com/ip/Hyper-Tough-3-Piece-1-16-inch-Hss-Roll-Forged-Drill-Bits-Hss-Material-AU00040K/516905753 | Yes | Yes: $1.98 for 3 (Walmart, search index 2026-11-04) |

Subtotal: $271.66

## Test equipment (if not on hand)

Not in any total: buy a line only if Ahmed does not already own that instrument (TEST_PLAN.md section 0 says which tests use it).

| # | Item | Spec | Need | Buy | Pack | Line $ | Supplier | Link | Ships to USA | Verified |
|---|---|---|---|---|---|---|---|---|---|---|
| TE1 | Digital multimeter | Klein MM420: auto-ranging TRMS, 4000 count; DC V 400.0 mV, 4.000 V, 40.00 V ranges at +/-(0.5 % + 5 digits); DC current up to 10.00 A at +/-(2.0 % + 5 digits); 500 mA / 600 V and 10 A / 600 V fuses; continuity "Audible signal <50 ohm"; CAT III 600 V (Klein manual, https://data.kleintools.com/sites/all/product_assets/documents/instructions/klein/MM420%20Instructions_web.pdf; product page https://www.kleintools.com/catalog/multimeters/digital-multimeter-auto-ranging-600v-0) | 1 | 1 | 1 | 69.97 | Home Depot | https://www.homedepot.com/p/Klein-Tools-600-Volt-Digital-Multimeter-TRMS-Auto-Ranging-Temp-MM420/320822810 | Yes | Yes: $69.97, page data buyable, not discontinued, stock count not in the page; read 2026-11-01 9:15 PM ET. Budget option: SparkFun TOL-12966, $21.50, "In stock", DC current to 10 A, continuity buzzer, 1999 count, no accuracy published (https://www.sparkfun.com/digital-multimeter-basic.html, read 9:16 PM ET) |
| TE2 | Bench DC supply with current limit | Siglent SPD1168X: linear, 0 to 16 V, 0 to 8 A, 128 W, resolution 1 mV / 1 mA, ripple and noise <= 350 uVrms / 3 mVpp / <2 mArms, remote sense, USB and LAN (page). Meets 8.4 V and the 8 A limit of TEST_PLAN 8.4, at its maximum current | 1 | 1 | 1 | 305.00 | Siglent Technologies America (North Plains, OR) | https://siglentna.com/product/spd1168x/ | Yes | Yes: $305.00, "In Stock: will ship in 1-3 days", read 2026-11-01 9:17 PM ET; same $305.00 and "In Stock" at https://shop-us.siglent.com/products/spd1168x/. Flag: Siglent is a Chinese brand sold by its US company. No 10 A supply was found in stock today: Korad KA3010P on Amazon reads "Currently unavailable" (https://www.amazon.com/dp/B072RDTNHL) |
| TE3 | Digital calipers 150 mm | iGaging 100-700-06 Absolute Origin: 0 to 150 mm, resolution 0.01 mm, accuracy 0.02 mm, IP54, hardened stainless steel, CR2032, DIN 862, 2 year warranty (page). Good enough for coupon C1 (32.10 to 32.25 mm) and the BNO055 hole check (B13) | 1 | 1 | 1 | 83.95 | Penn Tool Co. (Maplewood, NJ) | https://www.penntoolco.com/igaging-6-ip54-digital-caliper-absolute-origin-100-700-06/ | Yes | Yes: $83.95, page schema "InStock" (no count shown), read 2026-11-01 9:22 PM ET. Premium option: Mitutoyo 500-196-30, $205.28, schema "InStock" (https://www.penntoolco.com/62529482/). Rejected: Adafruit 3720, $14.95, accuracy +/-0.2 mm, too coarse for C1; Adafruit 294 (Mitutoyo) "No longer stocked" |
| TE4 | DC electronic load | Siglent SDL1020X-E: 150 V, 30 A, 200 W, CC / CV / CR / CP, resolution 1 mV / 1 mA, 4-wire sense, battery test mode, over-current, over-power, over-voltage and over-temperature protection (page). Covers every load step in TEST_PLAN sections 3 and 4 (table in SOURCING_2026-11-02.md section 4) | 1 | 1 | 1 | 574.00 | Siglent Technologies America (North Plains, OR) | https://siglentna.com/product/sdl1020x-e/ | Yes | Yes: $574.00, "In Stock: will ship in 1-3 days", read 2026-11-01 9:18 PM ET; same $574.00 and "In Stock" at https://shop-us.siglent.com/products/sdl1020x-e/ (9:35 PM ET). Flag: Chinese brand sold by its US company |

Subtotal: $1032.92

Change 2026-11-04 about 8:50 PM ET (V1 screws job phase 2, D36 and D38, twin/screws/SCREWS_TWIN.md): Need from the screw cut: 16 58 to 48, 17a 28 to 18, 17f 17 to 11, 17g 8 to 4, 17i 4 to 3, 17k 4 to 2, 17h 30 to 28, 17l 16 to 8 (Buy and $ kept: the packs already bought cover the new need); new lines 22b and 22c (KK 254, X1), 26b (WAGO 221, X4), 12 Need 2 (XT30U in P13, X3a), T16 to T18 (the Wera tools, from 'Needs Ahmed's OK'), T19 (1/16 in drill); 10b NKK MB2011LS1W01-BB in place of the out-of-stock MB2011SS1W01 (+$2.21). Robot +$2.21, cables +$15.80, tools +$21.60.

## Totals

| Scope | $ |
|---|---|
| Robot | 892.79 |
| Fasteners and mechanical | 73.75 |
| Cables, connectors, wire | 282.84 |
| Print material | 53.97 |
| Expression (optional upstream) | 129.14 |
| Tools (one-time) | 271.66 |
| Build total (robot + fasteners + cables + filament) | 1303.35 |
| Build + expression pack | 1432.49 |
| Build + expression + tools | 1704.15 |

ORDER.md is the live cart. This table stays the older rollup. The build total $1258.70 (calc only) is robot $848.14 plus fasteners $73.75 plus cables $282.84 plus filament $53.97. Tools $271.66 are one-time and are outside that build total. The order's buy-today total and its per-duck parts total (tools and full filament spools left out) are in bom/order/ORDER.md.

Change 2026-11-05 about 7:50 PM ET (V1 track 11): line E8 verified on adafruit.com/product/3421 ($6.95 each, in stock, 0.4 g, 16.7 x 12.7 x 1.8 mm) and against its datasheet and board files; no cost change. Nothing bought.

Change 2026-11-05 about 4:50 PM ET (V1 track 11, companion, D47): line E8, 2 x Adafruit 3421 SPH0645LM4H I2S mic boards ($13.90) in Expression; 17h Need 28 to 32 (4 x M2x6 from the same kit, no new line); the mic wires come from the 26 AWG stock already bought. Expression $79.39 to $93.29, build + expression $1247.20 to $1261.10, build + expression + tools $1518.86 to $1532.76. Nothing bought.

Change 2026-11-05 about 8:00 PM ET (V1 track 8 phase 3, D50, awake while docked): DK6 (Pololu 5382, $3.79) and DK7 (Pololu 5383, $4.95) added; DK1 grows to four strips (price still BLOCKER). +$8.74 on the build total. The dock side (9 V 4 A adapter, two more spring pins) is costed in twin/dock/DOCK_TWIN.md section 11.

Change 2026-11-07 about 3:40 AM ET (V1 sit stop redesign, twin/sit/SIT.md section 4; D59): new line 17m, 2 x M2x12 self-tapping pan head for F127 and F129, which now hold the neck back stop block through its 4 mm flange (the stock M2x6 go back to the servo bag: 2 fewer used). PLA need and TPU need follow print/SLICE_SUMMARY.md (the neck stop block, two neck pads and one head pad added; the neck sheets stock again). BLOCKER: no listing read for 17m, so no price in the totals; nothing bought.

Change 2026-11-06 ET (V1 freeze pass, twin/freeze/; D51, D52, D54): new line 5b cliff ToF Adafruit 5396 ($14.95, in the build total), new lines E9 two MPR121 touch boards Adafruit 1982 ($15.90) and E10 copper foil Adafruit 1127 ($19.95); line 17f Need 11 to 13 (2 x M2.5x6 for the ToF; Buy 20 covers it); line 29 also takes the touch boards and the speaker duct foam ring. The test order total stays $228.49 (it is the sum of TO1 to TO17; the $231.50 in STATE.md and START_HERE.md was the total before D34 moved TO9 from the $5.95 150 mm cable to the $2.94 300 mm one, commit 068176b). Nothing is bought.

Change 2026-11-05 about 3:50 AM ET (V1 track 8, D43, D45): the duck side of the contact dock, lines DK1 to DK5 in Robot: the chest contact pad (price BLOCKER), the Pololu 5382 ideal diode ($3.79), a second FHAC0001ZXJ holder ($7.74) and two 5 A ATO fuses ($0.88), the cell NTC and wake branch parts (BLOCKER); line 29 Need 0.4 to 0.8 m (the pad), Buy unchanged. +$12.41 on the build total. The dock itself (charger, gate, printed dock) is costed in twin/dock/DOCK_TWIN.md section 7, not here.

Change 2026-11-05 about 12:45 AM ET (V1 track 9, D44): line 6 becomes 2 x Molicel INR21700-P45B ($19.98, +$2.00; out of stock at the seller 2026-11-04 ET, the P50B is the in-stock alternate at $11.99 each); line 7 becomes the 2S1P pack build with no holder (-$9.99 for the holder; the strip, sleeve and welding are a BLOCKER at $0.00 until priced). The bay in body_back grows for the pack (twin/battery/BAY.md). The BOM totals were stale before this change (the line items gave $1,163.39 build, not the $1,146.28 shown; audit/bom_totals.py re-run): after D44 the build is $1,155.40. Nothing bought.

Change 2026-11-01 evening (print-readiness pass, D4, D7, D8, D10, D13, D15): Tenergy BMS (+$16.10 vs JZK), Pololu 2815 main switch ($8.49, the old $6.00 placeholder becomes the line 10b control switch), Pololu D30V30F5 (+$12.66 vs HENGE), game controller (+$64.99, line 15), foam tape (+$19.00, line 29), Adafruit USB cable (-$1.50), Same Sky speaker (+$2.43). Before this pass the build total was $716.65.

Change 2026-11-01 late evening (sourcing pass, SOURCING_2026-11-02.md): solder (+$9.25, line 30), flux pen (+$7.95, line 31), cable ties (+$9.41, line 32) and polyimide tape for the BMS wrap (+$4.95, line 33) add $31.56 to the build total, now $868.70. Tools add the Pinecil PD supply and 5 A cable (T6, T6b), the 5 V robot charge adapter and cable (T7, T7b), the optional microSD reader (T8), a 12 to 20 AWG stripper for the 16 and 20 AWG runs (T9) and a heat gun (T10): +$99.36, so build + expression + tools is $1,189.13 ($1,182.18 without T8). The new Test equipment section ($1,032.92) stays outside every total. Before this pass the build total was $837.14 and build + expression + tools $1,058.21.

Change 2026-11-01 10:50 PM ET (fastener schedule pass, fasteners/FASTENERS.md, DECISIONS.md D19 to D21): Need from the per-screw count: 17a 44 to 28 (Buy 52 to 33, -$1.14), 17d 88 to 78 (Buy unchanged, one pack of 100), 17e 12 to 28 (Buy 14 to 33, +$0.95), 17h 6 to 30 by size (22 M2x5, 6 M2x4, 2 M2x8; the kit holds 50 of each, so no new line). New lines: 17j M3x6 ISO 7380 button heads for the 10 hip pitch sites (D19, +$1.08), 17k M2.5x5 for speaker_interface (+$0.60), 17l M2.5 small series washers for the eye screws (D21, +$20.00: the only small series 0.5 mm washer read live comes in a minimum box of 2000). Fasteners and mechanical $68.90 to $90.39; build total +$21.49, now $890.19; build + expression $972.59. Tools T11 to T13 (6.0 and 2.7 mm HSS bits and a T-handle holder for the D20 drill steps) add $10.14, so build + expression + tools is $1,220.76. Test order: TO16 (+$9.65, coupon C4 recess test), total $226.46. Before this pass the build total was $868.70 and build + expression + tools $1,189.13.

Change 2026-11-01 about 11:30 PM ET (tie mount pass, cables3d/cables3d.json retention of 11:26 PM ET): the cable agent's retention list holds 93 ties: 77 on adhesive tie mounts, 8 through 5 mm holes in printed parts, 8 around the bundle in free air; no printed guides. New line 34, adhesive tie mounts: HellermannTyton 151-01629, 19 mm square, 3M VHB acrylic foam, two 3.0 mm screw holes; one pack of 100 covers 77 plus 20 % (+$58.00, read via search index; the live read is $112.00 at Hisco). New line 35, isopropyl alcohol for the mount spots and the line 29 tape (+$14.33). Line 32: Need 1 to 3 becomes 93 plus 1 to 3, so Buy goes from 1 to 2 packs (+$9.41). Cables, connectors, wire $122.30 to $204.04; build total +$81.74, now $971.93; build + expression $1,054.33; build + expression + tools $1,302.50. Before this pass the build total was $890.19 and build + expression + tools $1,220.76.

Change 2026-11-02 about 12:45 AM ET (netlist final pass, wiring/netlist.yaml rev 2026-11-02, D23, D24): no new purchase for D23. Line 21 Need 5 to 7 and line 22 Need 13 to 17 (SP4 and SP5 end in a housing with V and G only at the ankle BUS 1), Buy unchanged (10 and 30). Wire Need from the netlist cut lengths: L5 1.1 to 1.3 m (P3, P6, P8, P11 longer, P7 extensions), 24 1.9 to 3.5 m (SP4, SP5), 25 8.8 to 9.1 m (foot jumpers, D10, D11; the D9 extension is gone); line 23 unchanged; every colour stays inside its 25 ft. Line 17l: the stocked BelMetric WFHV2.5X5SSA4 (0.3 mm, two per eye screw, 16) replaces the $20.00 box of 2000; Buy 48 for the $5 minimum checkout (-$16.64). Lines 32 and 34 Need follow cables3d.json of 11:50 PM ET (76 mounts, 12 free-air ties, 5 printed holes); Buy unchanged. Line 28 Need 35.1 g (D22 profile). New tools T14, 4.0 mm bit for the D24 head hole (+$0.93), and T15, 4.5 mm bit as the coupon C4 contingency (+$0.96). Fasteners and mechanical $90.39 to $73.75; build total -$16.64, now $955.29; build + expression $1,037.69; build + expression + tools $1,287.75. Before this pass the build total was $971.93 and build + expression + tools $1,302.50.

Change 2026-11-02 about 4:31 to 5:00 AM ET (D25 cable pass by agent CAB, cables3d/cables3d.json retention of 4:31 AM ET; this note written by agent INT from the line changes): new line 34b, Panduit ABM1M-AT-C small tie mounts for the 23 spots where only a 13 x 13 mm patch fits (+$72.41); line 32 Need 75 along the cables (94 with spares), Buy back from 2 packs to 1 (-$9.41); lines 34 and 35 Need 32 MB3A and 55 mount spots; line 24 Need 3.6 m. Cables, connectors, wire $204.04 to $267.04; build total +$63.00, now $1,018.29; build + expression $1,100.69; build + expression + tools $1,350.75. Before this pass the build total was $955.29 and build + expression + tools $1,287.75.

Change 2026-11-02 about 5:10 AM ET (integration pass, agent INT, from the PRT job and lead decision L2): no line price changes. Line 27 Need 1384 to 1389 g (the coupon T1 stack pieces T1b and T1w, print/PRINT_PLAN.md), still 2 spools. Line 26: count per size of the kit and the 34 sleeves of the BOM_FULL rule. Line 30: counts from the current netlist by the BOM_FULL rule (145 soldered wire ends, 24 of them 16 AWG, 15 splices; it said 13 splices). Test order: new line TO17, the BelMetric lines 17j, 17k and 17l as one order ($5.04, the store's $5 minimum checkout), so coupon T1 gets its 8 eye washers from line 17l; test order total $226.46 to $231.50. The build total stays $1,018.29 (TO17 buys BOM lines).

Previous BOM (before this audit): core $684.99, grand $730.94 with lab changes. The build total now adds fasteners, inserts, bearings, filament, wire, connectors and heat shrink that were missing or unverified, and moves the Castle Link to Tools.

Order minimums (B29, cleared): Bolt Depot has no minimum order (service page); DigiKey and Newark allow qty 1 on every line used; Mouser has no minimum for stocked parts (help page, read via search index); the rest are pack products. BelMetric (17j to 17l): "No Quantity Minimums" for stocked parts (its 50th anniversary page, read 2026-11-01 10:36 PM ET), its store data shows a $5 minimum checkout (read again 2026-11-02 12:20 AM ET); these 3 lines are $5.04 because line 17l buys 48 stocked washers. Drills and Cutters (T11 to T15): single pieces in the cart, no minimum seen. Standard Electric Supply (34): sold by the pack of 100 (search index copy); its order minimum could not be read (plain curl refused). TestEquity (35): quantity 1 in the price table, no minimum shown. Shipping is excluded by the owner's rule.

Not costed: sales tax and the line 10b control switch (upstream part, $6.00 placeholder, price not readable). The test equipment section (TE1 to TE4, $1,032.92) is listed but kept out of the totals because Ahmed may own it.

## Contingency (not in totals)

| # | Item | Qty | $ | Trigger |
|---|---|---|---|---|
| X1 | Extra Molex 50-37-5033 housings (Newark 57H1785, $0.143) | 20 | 2.86 | Kit 15 cm servo cables too short on test fit (CABLE_MAP S-hops) |
| X2 | Extra Molex 08-70-1040 terminals (Newark 54H5573, $0.170 at 50+) | 60 | 10.20 | Same as X1 (10 made leads at 22 AWG) |
| X3 | (closed) the BOM cable is now the 0.9 m Adafruit 3878 | 0 | 0.00 | B18 cleared on paper |
| X4 | Pi Zero 2 W in a kit if the bare board is still out of stock: PiShop.us K2B-1388 ($74.95) or CanaKit PI-Z2WH-STR32-C4-BLK ($89.95) | 1 | 55.90 to 70.90 more than line 3 | B24 / D7 |

## Removed from the previous BOM

- Barrel jack lead (old row 12): the lab build feeds the adapter through its screw terminal H1, so 0 needed.
- Braided cable sheath (old row 21): not required by any measured route; price was unverified. Dropped.
- Adafruit 4646 BNO055: replaced by 2472 because 4646 holes do not match the CAD pilots (MOUNTING.md).
- Castle Link V4 moved to Tools.
- Y-lead parts (old Need 3 housings, 9 terminals): dropped, the neck chain hangs off the left ankle (B19).
- AITRIP 20 A BMS: measured not to fit the CAD envelope (B12); replaced by the upstream JZK part, rating decision open.
- IMSCREWS M2x5 100 pcs: replaced by the METALLIXITY kit, which also has the camera M2x4.

## BLOCKERS that affect this BOM

See HARDWARE_AUDIT.md section 6 for all 73 with the method for each.
- 8: the Tenergy 32175 must trip at 21 A or more (TEST_PLAN 3.3, B47; twin/electrical/ELECTRICAL_TWIN.md, sim pass only); a board under that means a second board at $22.99 (buying needs Ahmed's OK) or accepting that a hard shove can switch the duck off.
- 17j: hip pitch button heads clear roll_to_pitch by +0.16 mm in CAD; checked on the first leg (B31, D19).
- 17e, T11, T13: the 24 neck chain recesses are drilled to 6.0 mm after printing, confirmed on coupon C4 first (B32, D20).
- 1, 17h, 20, 28, E1, E5, E7 and row 11: fit or length settled only by the test order below.
- DK1 and DK5 (V1 track 8): price not read; seats placed (twin/dock/dock_seats.json); the 2813 ON pad position is a stand-in.

## Needs test order

Parts where only a real part can settle the question. Every line below is already a BOM line, so buying these first adds nothing to the build total except the servo price break (1 now at $20.00 plus 13 later at $19.00 is $267.00, $1.00 more than 14 at once). Nothing has been bought.

| # | What to buy | Qty | $ | BOM line | Why (blockers) |
|---|---|---|---|---|---|
| TO1 | Feetech STS3215 7.4 V, Seeed | 1 | 20.00 | 1 | Count the 18-screw bag by size (B2); horn to case gap and pilot depth at the 2 M2x5 sites (B6); bus port positions (B10); kit cable length on the longest hop (B17); M2x5 head fit (B21) |
| TO2 | Tenergy 32175 2S protection board | 1 | 22.99 | 8 | Fit in the printed BMS slot, solder pad access, over-current and over-discharge behavior on the bench (B12 is cleared on paper; this confirms it) |
| TO3 | Adafruit 3878 USB C to Micro B 0.9 m | 1 | 3.50 | 20 | Route through the neck at the joint limits, coil the slack (B18 cleared on paper) |
| TO4 | METALLIXITY M2 self-tapping kit | 1 | 9.49 | 17h | M2x5 head fit (B21); M2x4 vs camera PCB thickness (B9) |
| TO5 | Adafruit BNO055 2472 | 1 | 34.95 | 5 | Hole spacing with calipers (B13); IMU axis tilt test (B20) |
| TO6 | Miuzei SG90 10-pack | 1 | 19.99 | 14 | Bag screw sizes for the antenna holder and tabs (B5); D9 lead reach without an extension (cables3d: 170 mm worst on the 250 mm lead) |
| TO7 | Same Sky CMS0361KLX speaker | 1 | 14.82 | E1 | Depth in speaker_interface (0.2 to 0.8 mm margin), retention (B8) |
| TO8 | Raspberry Pi Camera Module 3, Adafruit 5657 | 1 | 29.25 | E6 | PCB thickness (caliper) for the M2x5 in the pilots drilled to 4.5 mm (B9, B60) |
| TO9 | Raspberry Pi Camera Cable Standard-Mini 300 mm, X-On Electronics (D34) | 1 | 2.94 | E7 | Flat strip route and gentle loop fit, both ZIF ends seated, caliper width and thickness (TEST_PLAN 13, B61) |
| TO10 | Aurorad S5 reflector | 1 | 9.15 | E5 | Height in the 20.0 mm seat |
| TO11 | Bolt Depot M2.5x8 SHCS, 10 pcs, plus a left_eye test print | 10 | 0.90 | 17g | Left eye pilot 2.2 mm vs right 2.05 mm (B14); eye glass disc fit; the pilots are blind, so T1 clamps the robot stack, 5.6 mm: two 0.3 mm washers from 17l on the printed bulb T1b and head wall T1w (D21 note, PRINT_PLAN T1) |
| TO12 | CNC Kitchen M3 inserts, 100 pcs | 1 | 10.90 | 16 | Bore depth 5.8 vs 6.7 (B15); foot_top wall 1.5 mm pull test (B16) |
| TO13 | Overture TPU 95A 1 kg | 1 | 23.99 | 28 | Print foot_bottom_tpu, grip and fit (B26) |
| TO14 | Omron SS-10, DigiKey | 1 | 2.94 | 13 | Press fit in the foot_top 6.4 x 19.8 mm slot |
| TO15 | Adeept USB-C 2S charge board | 1 | 7.99 | 11 | Hole pattern vs CAD 2.5 mm at 14.4 mm pitch (no drawing published) |
| TO16 | Bolt Depot M3x5 SHCS, 5 pcs, the 6.0 mm HSS bit and the T-handle holder | 5 + 1 + 1 | 9.65 | 17e, T11, T13 | Coupon C4 recess fit: a DIN 912 M3 head in the 5.5 mm recesses, then one recess opened to 6.0 mm (D20, B32); the M2 heads come from TO1 and TO4 |
| TO17 | BelMetric, one order (the store's $5 minimum checkout): 12 M3x6 button heads, 5 M2.5x5 SHCS, 48 M2.5 flat washers 0.3 mm | 12 + 5 + 48 | 5.04 | 17j, 17k, 17l | Coupon T1 eye screw stack: 8 of the 17l washers, two under each M2.5x8 head, 5.6 mm with T1b and T1w (B14, D21 note); 17j (D19 first-leg hip pitch check, B31) and 17k (speaker_interface, B8) ride along to reach the minimum: 12 x $0.09 + 5 x $0.12 + 48 x $0.07 (lines 17j to 17l). Lead decision L2 |

Test order total: $228.49.

## Needs Ahmed's OK (V1 track 2, 2026-11-04; not on the buy lines)
The three Wera tools are tool lines T16 to T18 since D36 (2026-11-04). Still only proposed, nothing bought:
- Option only, not recommended now: 25 cm microSD extender cablecc EP-009 (microSD to SD), $7.99 (Amazon B08SW7ZCDM via specpicks.com); socket board size not published.
