aaltaay/Open_Duck_Mini_v2/altaay_lab/SOURCING_2026-11-02.md

# SOURCING 2026-11-02: missing purchase lines and stock rechecks

Written by agent P (sourcing agent) for the lead agent, under Ahmed's BOM rules. Nothing bought, nothing signed in, nothing posted. BOM.md and every other file are untouched; the lead applies these lines.

Clock: every page below was read on 2026-11-01 between 9:02 PM and 9:40 PM ET (2026-11-02 UTC). In ET this is still the same day as the BOM reads (2:00 PM to 7:00 PM ET), only a few hours later.

Method: plain curl 8.5.0 with its default user agent (curl/8.5.0), no browser user agent. Page dumps are in this session's scratch folder, not in git. Where a site refused curl, the line says "read via search index" and gives what the search result showed. Prices exclude shipping and tax.

Amazon note: on some Amazon pages the buy box price is hidden from curl. There the price was read in the page's own "This item:" block, which also names the seller and stock text.

## 0. Index

| Brief item | Proposed line | Section | Line $ |
|---|---|---|---|
| 1 Solder wire | 30 | Cables, connectors, wire | 9.25 |
| 2 Cable ties | 32 | Fasteners and mechanical | 9.41 |
| 3 Flux pen (optional) | 31 | Cables, connectors, wire | 7.95 |
| 4 Polyimide (Kapton) tape | 33 | Fasteners and mechanical | 4.95 |
| 5 USB-C PD supply for the Pinecil | T6 and T6b (5 A cable) | Tools (one-time) | 18.89 + 9.95 |
| 6 Supply for the Adeept charge board | T7 and T7b (USB-A to C cable) | Tools (one-time) | 8.70 + 4.88 |
| 7 Multimeter | TE1 | Test equipment (if not on hand) | 69.97 |
| 8 Bench DC supply | TE2 | Test equipment (if not on hand) | 305.00 |
| 9 Calipers 150 mm | TE3 | Test equipment (if not on hand) | 83.95 |
| 10 Electronic load | TE4 | Test equipment (if not on hand) | 574.00 |
| 11 microSD reader (optional) | T8 | Tools (one-time) | 6.95 |
| Found missing (not in the brief) | T9 stripper 12 to 20 AWG, T10 heat gun | Tools (one-time) | 20.99 + 29.00 |
| 12 to 17 rechecks | lines 3, X4, 18, 17h, 13, 9, 10, L1 | section 5 below | |

## 1. Fasteners and mechanical (add after line 29)

| # | Item | Spec | Need | Buy | Pack | Line $ | Supplier | Link | Ships to USA | Verified |
|---|---|---|---|---|---|---|---|---|---|---|
| 32 | Cable ties | Commercial Electric GT-100MCB, 4 in (about 100 mm), PA66 nylon, 18 lbf, UL 21 rated, UV black (page); at the servo power splices and the USB slack coil (MOUNTING.md) | 1 to 3 | 1 | 100 | 9.41 | Home Depot | https://www.homedepot.com/p/Commercial-Electric-4in-Miniature-Standard-UL-21-Rated-Cable-Zip-Ties-100-Pack-UV-Black-GT-100MCB/203531918 | Yes | Yes: $9.41 ("09¢ /tie"), page data buyable, not discontinued, stock count not in the page; read 2026-11-01 9:25 PM ET. The search page showed $10.78 for the same model; the product page says local store prices may vary. Commodity, many sources |
| 33 | Polyimide (Kapton) tape | Adafruit 3057 polyimide tape, 10 mm wide, 33 m roll, stable from about -269 C to +400 C (page); thickness and dielectric strength not stated (UNVERIFIED). Wraps the Tenergy BMS, 34 x 16 x 4.5 mm (MOUNTING.md: "wrap in kapton tape before it goes in") | about 0.2 m (2 turns of 77 mm around the 34 x 4.5 mm section to cover the 16 mm width, calculated) | 1 | 33 m roll | 4.95 | Adafruit 3057 | https://www.adafruit.com/product/3057 | Yes (US store) | Yes: $4.95, "35 in stock", read 2026-11-01 9:26 PM ET. Commodity, many sources |

Reasoning:
- 32: MOUNTING.md names cable ties at the servo power splices (tie or foam tape) and at the USB slack coil; a UL rated nylon 4 in tie from a US store is the plain choice.
- 33: Not optional: MOUNTING.md tells the builder to wrap the BMS in kapton before it goes between body_back and the lid; the splices need none, they sit in adhesive heat shrink (line 26).

## 2. Cables, connectors, wire (add after line 26)

| # | Item | Spec | Need | Buy | Pack | Line $ | Supplier | Link | Ships to USA | Verified |
|---|---|---|---|---|---|---|---|---|---|---|
| 30 | Solder wire | Adafruit 1886: tin-lead, 63/37 since 2019-09-20 (page), no-clean rosin core, 0.5 mm (page also says about 0.6 mm), 50 g. Leaded: easier on 16 AWG with the Pinecil; wash hands after use | 145 soldered wire ends in wiring/netlist.yaml, 24 of them 16 AWG, 13 splices (count by agent P) | 1 | 50 g | 9.25 | Adafruit 1886 | https://www.adafruit.com/product/1886 | Yes (US store) | Yes: $9.25, "7 in stock", read 2026-11-01 9:25 PM ET. 50 g is about 21 to 30 m of wire at 0.6 to 0.5 mm (calculated with 8.4 g/cm3). Lead-free option: Adafruit 2473, Sn99.3 Cu0.7, 2.2 % no-clean rosin flux, 0.5 mm, 50 g, $12.50, "29 in stock" (https://www.adafruit.com/product/2473). Adafruit 0.8 mm spools 5897 and 734 are out of stock. Commodity, many sources |
| 31 | Flux pen (optional, recommended for 16 AWG) | Chip Quik CQ4LF no-clean liquid flux pen, 10 mL, for leaded and lead-free solder, classification printed as "INM0", shelf life over 24 months (page) | 1 | 1 | 10 mL | 7.95 | Adafruit 3468 | https://www.adafruit.com/product/3468 | Yes (US store) | Yes: $7.95, "In stock", read 2026-11-01 9:26 PM ET. Commodity, many sources |

Reasoning:
- 30: Adafruit is the preferred US electronics supplier; the only in-stock rosin core sizes there today are 0.5 mm. That size is right for the Pi header and BMS pads and still works on 16 AWG (more wire fed per joint). SparkFun's 0.8 mm spools use water-soluble flux, which must be washed off, so they are not proposed.
- 31: No-clean flux helps solder wet stranded 16 AWG in the splices and XT30 cups, and it needs no cleaning inside the heat shrink.

## 3. Tools (one-time) (add after line L2)

| # | Item | Spec | Need | Buy | Pack | Line $ | Supplier | Link | Ships to USA | Verified |
|---|---|---|---|---|---|---|---|---|---|---|
| T6 | USB-C PD supply for T1 | Amazon Basics 65W One-Port GaN, PD 3.0: 5 V 3 A, 9 V 3 A, 12 V 3 A, 15 V 3 A, 20 V 3.25 A; no cable in the box; 1 year limited warranty (page). Pinecil V2 need: "minimum of 3 amps"; the stock ST-B2 short tip is 6.2 ohm, so 20 V / 6.2 ohm = 3.2 A = 64 W (Pine64 power chart, https://wiki.pine64.org/wiki/Pinecil); Pine64 recommends "a USB-C PD65W, 20V, 3+ A charger"; this charger is on Pine64's tested list (https://wiki.pine64.org/wiki/Pinecil_Power_Supplies). Store spec: "USB type C: PD and QC 3.0 12V-20V 3A" (https://pine64.com/product/pinecil-smart-mini-portable-soldering-iron/) | 1 | 1 | 1 | 18.89 | Amazon (ships from and sold by Amazon.com) | https://www.amazon.com/dp/B087MD5MYH | Yes | Yes: $18.89, "In Stock", "Ships from and sold by Amazon.com", read 2026-11-01 9:10 PM ET. Multi-source item (any PD 3.0 65 W supply with a 20 V 3.25 A profile) |
| T6b | USB-C to USB-C cable, 5 A | Adafruit 4199, USB 3.1 Gen 4 with E-Mark, 1 m; Adafruit: it "includes an EMARK chip ... you can use this for high current (5A) charging". The 3.2 A short tip draw at 20 V is above 3 A, so the cable needs the 5 A e-marker | 1 | 1 | 1 | 9.95 | Adafruit 4199 | https://www.adafruit.com/product/4199 | Yes (US store) | Yes: $9.95, "In stock", read 2026-11-01 9:12 PM ET. Not silicone; the silicone cables on Pine64's list read "Currently unavailable" on Amazon today (B096XWD2HG, B093GFBD2M). Also fits as the PC to Waveshare adapter USB-C cable for the Feetech tool |
| T7 | Robot charge adapter, 5 V | Amazon Basics 12W One-Port USB-A wall charger, up to 2.4 A, no Quick Charge, cable not included (page). Adeept board (line 11) input from its listing: "Charging board input voltage DC 3-6V (DC 3.7V 5V recommended)", input current 2 A and charging current 1.1 A for the 2A version, charging voltage 8.4 V; no PD or QC input is listed (https://www.amazon.com/Adeept-18650-Charge-Charging-Board/dp/B0BJTW4QBR, read 9:08 PM ET) | 1 | 1 | 1 | 8.70 | Amazon (ships from and sold by Amazon.com) | https://www.amazon.com/dp/B0773J79KC | Yes | Yes: $8.70, "In Stock", "Ships from and sold by Amazon.com", read 2026-11-01 9:13 PM ET. Commodity, many sources |
| T7b | USB-A to USB-C cable | Amazon Basics USB-A to USB-C, USB 2.0, USB-IF certified, 3 ft, maximum current 3 A, 15 W at 5 V (page). An A to C cable carries the resistor that tells the board it may draw 5 V (Adafruit on its A to C cable: "The cable has built in resistors to force it to 5V power", https://www.adafruit.com/product/4474), so it works whether or not the Adeept board has USB-C CC pull-down resistors (its listing does not say) | 1 | 1 | 1 | 4.88 | Amazon (ships from and sold by Amazon.com) | https://www.amazon.com/dp/B085SBKFJR | Yes | Yes: $4.88, "In Stock", "Ships from and sold by Amazon.com", read 2026-11-01 9:14 PM ET. Also a PC (USB-A) to Waveshare adapter data cable. The 6 ft version B01GGKYN0A read "Temporarily out of stock" |
| T8 | microSD card reader (optional, often on hand) | Adafruit 5212 USB Type C microSD card reader/writer, mass storage, no driver (page); USB-C plug, so the PC needs a USB-C port | 1 | 1 | 1 | 6.95 | Adafruit 5212 | https://www.adafruit.com/product/5212 | Yes (US store) | Yes: $6.95, "86 in stock", read 2026-11-01 9:23 PM ET. USB-A readers checked are out: Adafruit 939 "No longer stocked", SparkFun COM-13004 "Out of stock", PiShop reader "Out of stock" |
| T9 | Wire stripper 12 to 20 AWG | Klein 11055, "Strips, cuts, loops 10-18 AWG solid and 12-20 AWG stranded wire" (page); covers the 16 AWG and 20 AWG runs that T5 (22 to 32 AWG) cannot | 1 | 1 | 1 | 20.99 | Home Depot | https://www.homedepot.com/p/Klein-Tools-Solid-and-Stranded-Copper-Wire-Stripper-and-Cutter-11055/100630708 | Yes | Yes: $20.99, page data buyable, not discontinued, stock count not in the page; read 2026-11-01 9:31 PM ET |
| T10 | Heat gun | Wagner Furno 300, dual temperature, corded, 10 A, 20 cu ft/min, minimum temperature 750 F, 2 year limited warranty (page specs); for the adhesive lined 3:1 heat shrink (line 26); shrink each joint before it goes near printed PLA | 1 | 1 | 1 | 29.00 | Home Depot | https://www.homedepot.com/p/Wagner-Furno-300-Dual-Temperature-Corded-Heat-Gun-0503059/206723935 | Yes | Yes: $29.00, page data buyable, not discontinued, stock count not in the page; read 2026-11-01 9:31 PM ET |

Reasoning:
- T6: Minimum PD profile for full power over USB-C is PD 3.0 fixed 20 V at 3.25 A (65 W): the 6.2 ohm stock tip draws 3.2 A at 20 V. 12 V 3 A is the bare minimum to heat, slowly (Pine64 wiki). This is the cheapest 65 W supply on Pine64's own tested list, sold by Amazon.com.
- T6b: The supply has no cable, and above 3 A the cable must be e-marked for 5 A; Adafruit states that for 4199.
- T7: The Adeept input is plain 5 V (3 to 6 V, 2 A), so no PD supply is needed; a 2.4 A USB-A port covers the 2 A input. If test order TO15 shows the board charges from T6 over a C to C cable, drop T7 and T7b: T6 offers 5 V 3 A.
- T7b: USB-A plus an A to C cable is the one path that gives 5 V whatever the board's CC resistors are; 3 A rated.
- T8: Optional; the only in-stock reader at the US electronics stores checked has a USB-C plug.
- T9: Found missing: BOM.md "Not costed" lists "a 16 to 20 AWG stripper"; T5 stops at 22 AWG.
- T10: Found missing: the older audit/mkbom.py listed "a heat gun or lighter for heat shrink" as not costed, and the current BOM has neither; adhesive lined 3:1 tube needs real heat. The lead can drop it if one is on hand.
- T7 and T7b could sit in the Robot section next to line 11 instead (like line 15, an off-board accessory); the brief allowed only these sections, so they are under Tools.

## 4. New section: Test equipment (if not on hand)

Not in the build totals. Each line is only for what Ahmed does not already own.

| # | Item | Spec | Need | Buy | Pack | Line $ | Supplier | Link | Ships to USA | Verified |
|---|---|---|---|---|---|---|---|---|---|---|
| TE1 | Digital multimeter | Klein MM420: auto-ranging TRMS, 4000 count; DC V 400.0 mV, 4.000 V, 40.00 V ranges at +/-(0.5 % + 5 digits); DC current up to 10.00 A at +/-(2.0 % + 5 digits); 500 mA / 600 V and 10 A / 600 V fuses; continuity "Audible signal <50 ohm"; CAT III 600 V (Klein manual, https://data.kleintools.com/sites/all/product_assets/documents/instructions/klein/MM420%20Instructions_web.pdf; product page https://www.kleintools.com/catalog/multimeters/digital-multimeter-auto-ranging-600v-0) | 1 | 1 | 1 | 69.97 | Home Depot | https://www.homedepot.com/p/Klein-Tools-600-Volt-Digital-Multimeter-TRMS-Auto-Ranging-Temp-MM420/320822810 | Yes | Yes: $69.97, page data buyable, not discontinued, stock count not in the page; read 2026-11-01 9:15 PM ET. Budget option: SparkFun TOL-12966, $21.50, "In stock", DC current to 10 A, continuity buzzer, 1999 count, no accuracy published (https://www.sparkfun.com/digital-multimeter-basic.html, read 9:16 PM ET) |
| TE2 | Bench DC supply with current limit | Siglent SPD1168X: linear, 0 to 16 V, 0 to 8 A, 128 W, resolution 1 mV / 1 mA, ripple and noise <= 350 uVrms / 3 mVpp / <2 mArms, remote sense, USB and LAN (page). Meets 8.4 V and the 8 A limit of TEST_PLAN 8.4, at its maximum current | 1 | 1 | 1 | 305.00 | Siglent Technologies America (North Plains, OR) | https://siglentna.com/product/spd1168x/ | Yes | Yes: $305.00, "In Stock: will ship in 1-3 days", read 2026-11-01 9:17 PM ET; same $305.00 and "In Stock" at https://shop-us.siglent.com/products/spd1168x/. Flag: Siglent is a Chinese brand sold by its US company. No 10 A supply was found in stock today: Korad KA3010P on Amazon reads "Currently unavailable" (https://www.amazon.com/dp/B072RDTNHL) |
| TE3 | Digital calipers 150 mm | iGaging 100-700-06 Absolute Origin: 0 to 150 mm, resolution 0.01 mm, accuracy 0.02 mm, IP54, hardened stainless steel, CR2032, DIN 862, 2 year warranty (page). Good enough for coupon C1 (32.10 to 32.25 mm) and the BNO055 hole check (B13) | 1 | 1 | 1 | 83.95 | Penn Tool Co. (Maplewood, NJ) | https://www.penntoolco.com/igaging-6-ip54-digital-caliper-absolute-origin-100-700-06/ | Yes | Yes: $83.95, page schema "InStock" (no count shown), read 2026-11-01 9:22 PM ET. Premium option: Mitutoyo 500-196-30, $205.28, schema "InStock" (https://www.penntoolco.com/62529482/). Rejected: Adafruit 3720, $14.95, accuracy +/-0.2 mm, too coarse for C1; Adafruit 294 (Mitutoyo) "No longer stocked" |
| TE4 | DC electronic load | Siglent SDL1020X-E: 150 V, 30 A, 200 W, CC / CV / CR / CP, resolution 1 mV / 1 mA, 4-wire sense, battery test mode, over-current, over-power, over-voltage and over-temperature protection (page). Covers every load step in TEST_PLAN sections 3 and 4 (table below) | 1 | 1 | 1 | 574.00 | Siglent Technologies America (North Plains, OR) | https://siglentna.com/product/sdl1020x-e/ | Yes | Yes: $574.00, "In Stock: will ship in 1-3 days", read 2026-11-01 9:18 PM ET; same $574.00 and "In Stock" at https://shop-us.siglent.com/products/sdl1020x-e/ (9:35 PM ET). Flag: Chinese brand sold by its US company |

Test equipment subtotal: $1,032.92.

Reasoning:
- TE1: A US brand meter with a full published accuracy table, 10 A range and audible continuity; its 400.0 mV range (0.1 mV) resolves the Kelvin test: 35 mOhm x 2.0 A = 70 mV.
- TE2: The cheapest in-stock US-sold bench supply found that reaches both 8.4 V and 8 A with a current limit; linear, so low noise on the servo bus.
- TE3: 0.02 mm accuracy at well under half the Mitutoyo price; the cheap Adafruit caliper is 10 times too coarse.
- TE4: One instrument sets the exact current for every load test below; resistors cannot hold 2 A, 2.4 A, 5 A and 10 A at the changing sweep voltages. It is the most expensive line; the resistor option below is the fallback.

Load current each test needs (TEST_PLAN.md, read today):

| TEST_PLAN step | Where the load sits | Current | Power in the load | Notes |
|---|---|---|---|---|
| 3.2 holder drop | pack, 7.4 to 8.4 V | 10 A for 30 s | 74 to 84 W | TE2 stops at 8 A, so run it from the pack into TE4 |
| 3.3 BMS trip (optional) | 0.5 ohm across the pack at 8.4 V | 16.8 A at most | about 141 W for under 1 s | see finding F2 |
| 4.1 BEC input sweep | BEC output, 7.2 V | 2 A | 14.4 W | |
| 4.1 BEC soak | BEC output, 7.2 V | 5 A for 10 min | 36 W | |
| 4.2 Pololu 2815 | VOUT, about 7.4 V | 5 A | 37 W | |
| 4.3 5 V regulator | 5.00 V | 2.4 A for 1 min | 12 W | the brief called this section 5; it is 4.3 |
| 4.4 fuse holder and 5 Kelvin hop | TE2 in current limit | 2.0 A (section 5) | under 1 W | no load needed |

Resistor fallback (not proposed as a line, price UNVERIFIED): 2 x 1.5 ohm 100 W aluminium housed resistors on a heat sink (one: 4.8 A at 7.2 V; two in series: 2.4 A at 7.2 V; two in parallel: 9.9 A at 7.4 V) plus 1 x 2.0 ohm 100 W (2.5 A at 5 V). The current then follows V / R at each sweep step and must be read on TE1. Prices could not be read: Amazon returned HTTP 503 to curl for uxcell B07FS6FSFT twice (9:30 and 9:34 PM ET), and DigiKey, Mouser, Newark and Jameco refuse curl.

## 5. Rechecks (stock was thin on 2026-11-01 afternoon)

| BOM line | Proposed Verified text for today |
|---|---|
| 3 (and X4) | DECIDED (D7). Re-read 2026-11-01 9:02 to 9:08 PM ET: bare board still out of stock everywhere checked: Adafruit 5291 $19.05 "Out of stock" (header version 6008, $19.80, out of stock), SparkFun DEV-18713 $19.00 "Out of stock", PiShop.us $17.25 "Out of stock", CanaKit PI-Z2W $16.35 and PI-Z2WH $19.60 "Sold Out", Vilros RPZW2 $17.43, every variant sold out. Chicago Electronic Distributors no longer takes orders (its page sends buyers to PiShop.us). Micro Center and DigiKey refuse curl (403); DigiKey search index copies of SC0721 disagree (0 to 133 in stock), so UNVERIFIED. In stock with the board: PiShop.us Starter Kit K2B-1388 $74.95, "Current Stock: 170" (https://www.pishop.us/product/raspberry-pi-zero-2-w-starter-kit/; kit adds a case, mini HDMI adapter, OTG cable, blank 32 GB microSD, 5.1 V 2.5 A supply, unsoldered 2x20 header, heatsinks); CanaKit PI-Z2WH-STR32-C4-BLK $89.95, "Add to Cart", no count shown (https://www.canakit.com/raspberry-pi-zero-2-w.html). X4 stays as written |
| 18 | UNVERIFIED today: the Motoforti page returned HTTP 503 to plain curl 6 times from 9:08 to 9:40 PM ET while other Amazon pages loaded; the search index has no copy of the listing. Last good read: $7.74, "only 1 left" earlier on 2026-11-01. In-stock US alternative: VXB Bearings (Anaheim, CA) 6804ZZ, 20 x 32 x 7 mm, chrome steel, double metal shields, pre-lubricated, $7.77 each, schema "InStock" (https://vxb.com/products/6804zz-bearing-20x32x7-shielded-20mm-bore); or VXB 10-pack $39.99, "InStock" (https://vxb.com/products/10-pack-6804zz-bearings), read 9:27 PM ET. Fallback buy: 4 singles (3 needed plus 1 spare) = $31.08 |
| 17h | Price yes: $9.49, "Only 6 left in stock - order soon", sold by METALLIXITY, ships from Amazon, read 2026-11-01 9:08 PM ET (same count as the afternoon read). Head fit and camera length on test order (B21, B9). Not out, so no swap; no drop-in kit was found with both M2x4 and M2x5: MCMASKE B0B7SK7BKN $13.99 "In Stock" has M2x5 but no M2x4, LBY B07GL2WLDD $9.89 has only M2x6, x10, x16 |
| 13 | SS-10: $2.94 each at 1 ($2.43 at 10), 3,148 in stock, DigiKey 39-SS-10-ND (read via search index; direct fetch 403 at 9:28 PM ET). SS-01 (read via search index only): DigiKey SW1059-ND showed 5,728 and 6,556 in stock at $2.14 in two cached copies of unknown date, while a DigiKey DE copy shows a 26 week standard lead time; Avnet Americas 0 in stock, 180 week factory lead time. Live US stock UNVERIFIED; buy SS-01 if DigiKey shows stock at order time, else SS-10 (D17) |
| 9 | Yes: $29.95, status "Rationed (Active and Preferred)", backorders allowed; supply outlook: "505 completed units in stock", parts on site for "at least 100 more units within a few days" (https://www.pololu.com/product/4892/supply-outlook), read 2026-11-01 9:02 PM ET. Replaces the HENGE UBEC (no datasheet) |
| 10 | Yes: $8.49, status "Rationed (Active and Preferred)", backorders allowed; supply outlook: "30 completed units in stock", parts for "at least 100 more units within a few days" (https://www.pololu.com/product/2815/supply-outlook), read 2026-11-01 9:02 PM ET (B22 cleared, D8) |
| L1 | Yes: Horizon Hobby CSE010000401 $54.95, "In Stock", page data stockLevel 369 (horizon-us-inventory), not discontinued, read 2026-11-01 9:02 PM ET; Motion RC 010-0004-01 $54.95, schema "InStock", no count shown (https://motionrc.com/products/castle-creations-20a-bec-pro-010-0004-01), read 9:04 PM ET; castlecreations.com not re-read (it refuses curl). Motion RC still lists "Input voltage: 16V to 40V" (D16 sweep stands) |

Reasoning:
- 3: Same picture as the afternoon; the PiShop kit is the cheapest in-stock way to get the board. Chicago Electronic Distributors should come off the list.
- 18: Not shown out, but not readable; VXB is a US bearing seller with a readable price and stock.
- 17h: Still in stock at the same thin count; nothing to swap yet.
- 13: The only US distributor with possible SS-01 stock (DigiKey) refuses curl, so the order-day check stays.
- 9, 10, L1: In stock with counts; no alternative needed.

## 6. Text for the lead to update in BOM.md

If all of sections 1 to 3 are added (T8 optional):
- Fasteners and mechanical: $68.90 + $14.36 = $83.26.
- Cables, connectors, wire: $90.74 + $17.20 = $107.94.
- Tools (one-time): $138.67 + $92.41 = $231.08 ($238.03 with T8).
- Build total (robot + fasteners + cables + filament): $837.14 + $31.56 = $868.70.
- Build + expression pack: $919.54 + $31.56 = $951.10.
- Build + expression + tools: $1,058.21 + $31.56 + $92.41 = $1,182.18 ($1,189.13 with T8).
- Test equipment (if not on hand), outside the totals: $1,032.92.

Proposed "Not costed" line: Not costed: sales tax and the line 10b control switch (upstream part, $6.00 placeholder, price not readable). The test equipment section (TE1 to TE4, $1,032.92) is listed but kept out of the totals because Ahmed may own it.

## 7. Findings outside the brief

- F1. TEST_PLAN section 0 asks for "about 1 ohm 50 W" for the load tests. That fits none of them: 1 ohm at the 7.2 V BEC output draws 7.2 A (52 W), not 2 A or 5 A, and 10 A through 1 ohm (step 3.2) is 100 W. The table in section 4 above lists what each step needs.
- F2. TEST_PLAN 3.3 shorts the pack through a 0.5 ohm resistor and expects the BMS to trip. At 8.4 V that is at most 16.8 A before any wiring or cell resistance, under the bottom of the Tenergy trip window (22 +/- 5 A, so 17 to 27 A). The BMS may not trip even when it is good. The lead may want a lower resistance or to keep the step optional, as written.
- F3. TEST_PLAN 3.2 says "bench supply in current limit": TE2 tops out at 8 A, so 10 A needs the pack into TE4 (or a 10 A supply; none found in stock today).
- F4. The TE1 continuity beep sounds below 50 ohm (Klein manual), so the TEST_PLAN 2 pass "under 1 ohm" must be read on the ohms range with the probe leads shorted first, not judged by the beep.
- F5. BOM line 11 (Adeept charge board) now reads "Only 3 left in stock - order soon" (read 9:08 PM ET). It is also test order TO15; a different board would need a new fit check against the CAD (38.2 x 18.1 x 5.2 mm, holes at 14.4 mm pitch).
- F6. Newark and Mouser refuse plain curl today (HTTP/2 stream reset and empty reply at 9:05 PM ET). Lines L3, 21, 22, X1 and X2 (Newark) can only be re-read via the search index until that changes.
- F7. The PRINT_PLAN pull tests need "a 5 kg weight or luggage scale": a filled 5 L water jug is about 5 kg, so no line is proposed.
- F8. TEST_PLAN 3.1 needs both cells within 0.05 V before they go in, and the BOM has no single-cell charger. If they arrive further apart, TE4 in constant current can bring the higher cell down; otherwise a charger line is needed.
- F9. A PC to Waveshare adapter USB cable for the Feetech firmware tool was not in the BOM (line 20 is the Pi cable). T6b (USB-C PC) or T7b (USB-A PC) covers it.

## 8. Could not source or verify

- Motoforti 6804ZZ (line 18) stock and price today: Amazon 503 to curl; VXB alternative given.
- Omron SS-01 live US stock: DigiKey, Mouser, Newark, Arrow, Avnet and TME refuse curl; search index copies conflict.
- Raspberry Pi Zero 2 W bare board: no US seller in stock (kits only).
- Resistor fallback prices for TE4.
- Stock counts at Home Depot (lines 32, T9, T10, TE1): the pages show buyable and not discontinued, but no count.
- Whether the Adeept board has USB-C CC pull-down resistors (not in its listing); T7 and T7b avoid the question.
- Polyimide tape thickness and dielectric strength (not on the Adafruit page).
