aaltaay/Open_Duck_Mini_v2/altaay_lab/history/2026-11-12_2305_us_parts.md

# 2026-11-12 11:05 PM ET: US-made parts study

A part-by-part look for United States equivalents is in problems/US_PARTS.md, with the line table in problems/US_PARTS.csv. The share math is problems/us_parts_share.py. The selected BOM, the order, the twin, and the domestic worksheet were not edited.

One line passes: 3DXTech ECOMAX PLA, made in Grand Rapids, two spools at $36.00. All passing swaps: domestic $119.33 of $941.38, which is 12.68 percent (calc only). Per-duck parts stay $957.75 because full spools are outside that total. No set of passing swaps clears 65 percent, and none clears 75 percent. The 14 servos have no US equivalent that meets torque, speed, size, and the bus. Nothing was bought. Not legal advice.
