aaltaay/Open_Duck_Mini_v2/altaay_lab/history/2026-11-12_2149_12v_order_share.md

# 12 V servo on the order, and one share

2026-11-12 9:49 PM ET. The order line is the Waveshare 12 V ST-3215-C018, SKU 22414, at $20.63 (cited, problems/NEST3.md). Fourteen is $288.82 (calc only). The 7.4 V Seeed line at $280.00 is superseded.

Buy-today total is $1204.26 (calc only). Per-duck parts, leaving one-time tools ($130.95) and full filament spools ($115.56) out, are $957.75 (calc only). BOM.md build total $1258.70 (calc only) stays the older robot, fastener, cable, and filament rollup.

Domestic share is 5.23 percent (calc only, $47.33 of $905.36). The 6.07 percent in the earlier history notes and the 5.28 percent from 9:45 PM ET are superseded. The Waveshare page did not print a country of origin, so the servos are unknown and counted foreign. Not legal advice. D61 was not edited.
