aaltaay/Open_Duck_Mini_v2/altaay_lab/history/2026-11-12_2132_order_rest.md

# 2026-11-12 9:32 PM ET: more live pages on the order bill

Opened US seller pages for the PLA and TPU spools, the four silicone wire gauges, the KK 254 replacement terminal, the microSD card, the Xbox controller, the 1 W LEDs, Loctite 243, polyimide tape, 0.5 mm solder, a 3:1 adhesive heat-shrink kit, 4 inch cable ties, and the crimper, hex keys, fine stripper, and 65 W USB-C supply.

PA6-CF was already on the bill. The named heat-shrink ASIN and the named USB-A to USB-C cable were unavailable. Felt, cloth, foam, gold wells, and the weld kit still have no listing that met the lab spec on a page opened today. The charger board, rim gate, and well-route stay blocked. Nothing was bought.
