aaltaay/Open_Duck_Mini_v2/altaay_lab/history/2026-11-12_1816_order_pages.md

# 2026-11-12 6:16 PM ET: live pages for the order bill

Opened US seller pages for the charger passives, the two fuses, the speaker, the foot switch fallback, the in-stock amplifier board, the surface-mount small-signal diode, the 4.7 V zener that replaced the out-of-stock candidate, the Mini-SPOX housing order code, and the Bolt Depot socket screws already named in the bill.

A page that was out of stock was replaced only when a live page showed the same value, package, and rating. Lines that still have no opened page, no part number, or no design stay BLOCKER. Nothing was bought.
