aaltaay/Open_Duck_Mini_v2/altaay_lab/history/2026-11-12_1804_order_bill.md

# 2026-11-12 6:04 PM ET: one order bill for the duck and the nest

Labels: calc only for the gram arithmetic in the bill, CAD check only where a count is taken from fasteners.json or NEST_CAD.md, and a cited page where a supplier page was opened the same day. Pages that were not opened stay BLOCKER. Nothing was bought.

- The bill is altaay_lab/bom/order/. It collects the existing BOM, the netlist, the charger board, the nest CAD, the flush study, the wall card, the shin-eye grams, and the topology gram delta. It does not add a new part.
- The match script fails if a current-design part is missing from the bill, or if the bill names a part the current design does not have.
- altaay_lab/compliance/ is not in the tree. Maker screening was not started here.
- verify/c9_docs.py passed. Its warnings are older files, not this bill.
