aaltaay/Open_Duck_Mini_v2/altaay_lab/history/2026-11-12_1808_order_review.md

# 2026-11-12 6:08 PM ET: two gaps the review named

The order bill was missing two things the existing files already name.

- BOM.md lines 22b and 22c are now on the bill. The terminal is Molex 08-50-0114. The housing line stays BLOCKER: 22-01-3027 is not a Molex number, and the widths cannot be one buy. Netlist cable D13 is the end that already says KK 254 socket. That end was not in the old count of 27, so the terminal need is 28. Buy 34 is 28 times 1.2, rounded up (calc only, the existing spare rule). The page was not opened, so there is no price.
- FLUSH_CONTACTS.md section 6 asks for an ideal-diode path from each of the five wells to either rail. The part is not chosen. That line is BLOCKER. It is not DK6, not DK7, not the charger board, and not the rim gate.
