aaltaay/Open_Duck_Mini_v2/altaay_lab/history/2026-11-11_2310_parts_order_gaps.md

# 2026-11-11 11:10 PM ET: part numbers and live stock

Labels: catalog numbers are from the QA Technology 2023 catalog, pages 32 and 33. Stock words are from distributor pages opened this evening. Nest sizes cited from the nest CAD stay CAD check only. BOM.md and bom.json were not edited.

- The spring probe part number is now 100-PRP4030S (tip 30 Round, 1.40 mm, standard spring). The drawn 2.3 mm tip is not on that catalog. The socket 100-SDN250S is on the same pages. TestEquity showed the socket out of stock. No in-stock page was opened for the probe.
- Felt, the two gold cloths, the 90 mm foil disc, the rim foam, the gate board, the pack weld, and the M2x12 screw still have no orderable part number. Shieldex Nora Dell 1401101S80 was opened and is not gold. 3M 1181 X 1/2 can be bought for the feed and is 12.7 mm wide.
- Molex 22-01-3027 is not a real housing number. The 2-circuit housing is 0022012027. The 11-piece line still cannot be ordered, because header pins are shared.
- The bare Pi Zero 2 W was out of stock at Adafruit 5291 and as a CanaKit bare board. CanaKit kit PI-Z2WH-STR32-C4-BLK showed Add to Cart. The P45B was sold out at 18650 Battery Store and at Liion Wholesale. No P50B stock page was opened.
- Heat shrink, solder, polyimide tape, the MAX98357A board, the Castle Link, and the electronic load were out of stock on the pages that opened.
