aaltaay/Open_Duck_Mini_v2/altaay_lab/history/2026-11-11_2024_bench_parts_compliance.md

# 2026-11-11 8:24 PM ET: bench plan for the nest, parts audit, compliance first pass, definition of done, twin checklist

Labels: datasheets opened this session are cited in PARTS_AUDIT.md. Sim, calc, and CAD numbers stay labeled
in the files they came from. Nothing was bought, built, or run on hardware.

- TEST_PLAN.md section 19 no longer sends charge current through the feet. D61 put the pins under the body.
  The knee-loop flex test is the leg bundle only. New section 20 is the nest bench, cheapest and riskiest
  first: cloth contact, snag, hair and dirt, a short wear look, the two-wire gate, a real felt edge, the
  180 deg sit, charger heat in the duck, and camera-only finding. Sections 1 to 19 keep their numbers.
- twin/sit/SIT.md now says the torque-off rest charges through the nest pins, not the feet-dock pads.
- PARTS_AUDIT.md: the QA Technology 100-40 catalog, the STS3215 sheet, the P45B sheet version 1.2, the Pi
  Zero 2 W brief, and the Camera Module 3 brief were opened. The pin tip assumed in the nest CAD is not on
  the catalog page. The STS3215 operating range on the sheet is -20 C to 60 C, not the twin's 70 C cut, and
  the sheet stall is lower than the twin. The P45B maximum size is larger than the drawn bay. The Pi at
  Adafruit and the P45B at the named cell store were out of stock. The MCP73213 datasheet was not opened.
  Nothing is orderable today by the rule in that file. The bill was not edited. Proposed changes are listed
  there.
- COMPLIANCE_FIRST_PASS.md is research, not legal advice. The three items that can force a design change
  before freeze are the live cloth on the floor, the charger heat inside the duck, and a homemade pack
  against UN 38.3 plus the cell envelope. FCC modular approval for the Pi was not confirmed from the grant.
- DEFINITION_OF_DONE.md is gates 0 through 8. A passing sim is not done. Nothing physical is built before
  gate 0. Every gate is open.
- TWIN_CHECKLIST.md is the gate 0 checklist, one row per twin plus the missing camera, felt, pin, limits,
  and bill rows. No row is PASS. The ranked blockers are in that file.

STATE.md was not edited. Nothing under twin/dock/nest/ was edited. No decision record was edited.
