aaltaay/Open_Duck_Mini_v2/altaay_lab/history/2026-11-01_2211_sourcing_pass.md

# Sourcing pass: missing purchase lines, test equipment section, stock rechecks, test plan fixes

- When: 2026-11-01 10:11 PM (America/New_York)
- Source: this commit, branch claude/every-part
- Written: 2026-11-01 by the Claude Code agent (integration by its sub-agent I1; lines and rechecks from SOURCING_2026-11-02.md by its sourcing sub-agent; steps 7.3 and 8.0 from the sim sub-agent's proposed text)

- BOM.md: lines 30 to 33 (solder, flux pen, cable ties, polyimide tape for the BMS wrap) added to "Cables, connectors, wire" as the lead asked (the sourcing file had 32 and 33 under "Fasteners and mechanical"; the build total is the same either way). Tools T6 and T6b (Pinecil PD supply, 5 A cable), T7 and T7b (5 V charge adapter, A to C cable), T8 (microSD reader, optional), T9 (12 to 20 AWG stripper), T10 (heat gun). New section "Test equipment (if not on hand)": TE1 Klein MM420, TE2 Siglent SPD1168X, TE3 iGaging calipers, TE4 Siglent SDL1020X-E, subtotal $1,032.92, outside every total.
- Verified cells from the 9:02 to 9:40 PM ET rechecks: lines 3, 9, 10, 11, 13, 17h, 18 (Motoforti UNVERIFIED, VXB alternative) and L1; L3, 21 and 22 note that Newark and Mouser refuse plain curl. "Not costed" now lists only sales tax and the line 10b placeholder.
- Totals (audit/bom_totals.py): build $868.70 (was $837.14), build + expression $951.10, build + expression + tools $1,189.13 with the optional T8 ($1,182.18 without). bom.json rebuilt (72 rows). Neither BOM script needed a change.
- BOM_FULL.md (viewer/make_viewer_data.py --write-bom): the 8 needs with no purchase line now point at lines 30, 32, T6, T7 and TE1 to TE4. 181 rows: bought 73, in kit 20, printed 37, made 32, tool 17, SHORT 1, MISSING 1. The two left come from the newer fastener schedule, not this pass: F02 M2.5x5 at the speaker stand has no line; F11 M3x5 needs 28 where line 17e buys 14.
- TEST_PLAN.md:
  - Section 0 lists TE1 to TE4 and which tests use the bench supply and which the electronic load; the "1 ohm 50 W" load is gone.
  - 3.2 runs 10 A from the pack into the load, because the supply stops at 8 A.
  - 3.3 was a 0.5 ohm short, at most 16.8 A, under the 17 A bottom of the Tenergy trip window. It is now a 7 step program on the load, 15 to 27 A, 50 ms per step. The pack starts at 7.40 V or less so 27 A stays under the load's 200 W. Sources read for it: SDL1000X datasheet and user manual (9:53 PM ET), Tenergy spec table (9:57 PM ET).
  - Sections 2, 3.3 and 12 read the 1 ohm passes in ohms: the MM420 beeps for anything under 50 ohm (Klein manual, 9:52 PM ET).
  - 7.3 (sim/RUNTIME_THERMAL.md): hold at 1.5 A Present Current for 30 min or until the temperature settles, then predict the knee after 31 min of walking against the Max Temperature Limit register and the 70 C cut.
  - New 8.0 (sim/ADDED_MASS_SIM.md): weigh the robot before any power (2.77 +/- 0.05 kg) and find its centre of mass on a toe scale and a heel scale. Move rear parts forward if it is more than 4 mm behind the ankle axes. The centre of mass part waits until 8.1 to 8.3 pass, because the robot must hold its pose with torque on and should not get its first power standing on scales.
- Left for the file owners: the T1 spec still says the PD supply is "not costed"; DECISIONS.md D2 still says 1.5 Nm; audit/continuity_checklist.csv (from audit/erc.py) still says "beep, under 1 ohm"; BOM_VIEW in viewer/make_viewer_data.py has no entry for the 15 new lines (15 "no view mapping" warnings); the BOM "BLOCKERS that affect this BOM" list predates D8 and D10.
