aaltaay/Open_Duck_Mini_v2/altaay_lab/bom/order/ORDER.md

# Order: one Duckie and one nest

One bill for one finished duck and its nest. Prices that were read on a live page on 2026-11-12 use the label cited, checked 2026-11-12. Shipping and tax are not included, the same rule as BOM.md. Nothing was bought, and nothing was added to a cart.

Current bill, 2026-11-14. The servo line is the 12 V Waveshare ST-3215-C018, SKU 22414, at $20.63 each for four or more (cited, problems/NEST3.md). Fourteen is $288.82 (calc only, 14 times 20.63). The pack is three P45B cells. The charger to build is the BQ24133 board at 12.6 V (D65). The servo regulator is the TDK-Lambda I7C2W020A120V-0F1-R at $86.34 (cited, DigiKey, read 2026-11-14). The protection board is BatterySpace PCM-L04S30-566 at $34.25 (cited, read 2026-11-14). Castle at $54.95 and Tenergy 32175 at $22.99 are superseded. The nest supply on this bill that still says 8.70 V to 10.0 V is the old 2S window and is superseded by the 15.0 V nest (problems/NEST3.md, circuitry/SERVO_RAIL.md).

BOM.md build total $1258.70 (calc only) is the older table in that file: robot, fasteners, cables, and filament. It is not this cart. The buy-today total below is every priced in-stock line on this order, including one-time tools and full filament spools. The per-duck parts total leaves those two groups out. Earlier buy-today figures $839.60, $1186.45, and $1195.44 are superseded.

Update 2026-11-12 6:23 PM ET, D62. The official nest is the flush striped felt mat and the five seat wells in altaay_lab/cad/nest_v2/. The spring pins in twin/dock/nest/cad/NEST_CAD.md and the QA Technology probe are superseded. Do not order them. The Mill-Max 0906 line below stays on this bill as a record of a pin that was studied. It is not a pin field to buy, and it is not the duck-side contact. Felt and foil still have no orderable part (BLOCKER). Still open, and not a reason to buy: dirt on the gold, the gate board and a coin short, charger heat, and a camera detector. This note does not change the dollar total.

This file only collects parts that the lab files already name. It does not add a new contact, a new board, or a new fastener pattern. Where a file has no part number, the line says BLOCKER.

Maker screening against restricted lists is altaay_lab/compliance/. The sentence that said that folder was not in the tree is superseded.

## What was reused

- BOM.md, fasteners/fasteners.json, and fasteners/FASTENERS.md for the duck screws, inserts, washers, wire, and tools.
- wiring/netlist.yaml for the duck components. Splices whose part text says solder stay on the solder line. G, VSW, SPV, and SPG name WAGO 221, so they are the wago line.
- circuitry/CHARGER_BOARD.md stays the 2S MCP73213 record. The board to build is circuitry/BQ24133_BOARD.md. The Adeept board is not ordered.
- BOM.md lines 22b and 22c for the Pi-header KK 254 terminals and housings. Cable D13 in wiring/netlist.yaml is the end that already says KK 254 socket. Mini-SPOX does not cover that header.
- altaay_lab/cad/nest_v2/ for the official nest at 190 mm: felt, foil stripes, five wells, and the cord pocket. twin/dock/nest/cad/NEST_CAD.md is the superseded spring-pin drawing. Its six extra inserts and six extra screws are not this nest.
- twin/dock/flush/FLUSH_CONTACTS.md for the five seat wells and the undesigned ideal-diode path from each well to either rail. The Mill-Max 0906 pin is not ordered as a field. Proud probes are not ordered. DK6 and DK7 stay the supply OR diodes. They are not that path.
- twin/dock/closeup/CLOSEUP.md for the 40 mm wall card. It is a plain square, not a coded tag.
- twin/structure/shin_eye/SHIN_EYE.md and shin_eye/slice.json for PA6-CF grams. twin/structure/TOPOLOGY.md for the PLA gram delta. print/SLICE_SUMMARY.md and print/PRINT_PLAN.md for the installed slice.
- The foot carve in the topology study is not ordered. That study already left it out.

## Not ordered, and why

- Chest pad, charge ideal diode DK2, the SENSE splice, the wake branch, and the Adeept USB-C board. CHARGER_BOARD.md and D61 already retire them. The netlist still contains those ids. check_order.py excludes them by those citations.
- The paddle dock in twin/dock/DOCK_BOM_FULL.md. D61 replaced it. Its gate, springs, ballast, and tags are not this nest.
- QA Technology probes, and a field of Mill-Max spring pins. D62 superseded both. The nest CAD still draws the long probes. They are not on this bill. The pin line in the BLOCKER list is the studied part, not a quantity to buy.
- A knee servo other than the STS3215. D32 names one. The current pick for this bill is STS3215 on all 14 joints, including the two knees.
- A second splice part on the same node. G, VSW, SPV, and SPG are WAGO in the netlist. The other splices stay solder. This bill does not buy both for one node.
- The 5 V wall supply that existed only to feed the Adeept board.
- Test equipment TE1 to TE4. BOM.md already keeps them out of the build. Their pages were not opened today, so they are not copied here as prices.
- Magnets: none. The flush study looked at a magnetic connector and did not pick it. fasteners.json has no magnet.
- Standoffs to buy: none. FASTENERS.md says the bosses are printed.
- Nuts to buy: none. fasteners.json has no nut. The DC jack brings its own nut.

## Totals

These sums are calc only. They add the line_usd column. A line is in that column only when a page opened today showed a price, the part was not out of stock, and the buy quantity is known. A proposed pick is in the sum and is labeled proposed pick, not yet verified. Designed-later lines stay out.

- Adafruit: $155.05
- Amazon: $300.87
- Bolt Depot: $11.68
- CNC Kitchen USA: $10.90
- CanaKit: $89.95
- BatterySpace: $34.25
- DigiKey: $136.62
- MatterHackers: $57.99
- Overture: $35.98
- Pine64: $40.98
- Pololu: $47.64
- Waveshare: $288.82
- SparkFun: $9.00
- illumn: $26.97

Grand total of lines that can be bought today: $1246.70

Per-duck parts, calc only: $1000.19. That is the buy-today total minus one-time tools (crimper, hex keys, stripper, 65 W supply, Pinecil, and insert tips, $130.95) and minus full filament spools (PLA $35.98, TPU $21.59, PA6-CF $57.99, together $115.56). 1246.70 minus 130.95 minus 115.56 is 1000.19. Against the previous per-duck total of $957.75, this bill is $42.44 more (calc only): the regulator is $86.34 instead of $54.95, the protection board is $34.25 instead of $22.99, and two resistor lines left the priced total because their new values were not opened. A spool can cover more than one duck. Dollars for the grams actually printed are BLOCKER. The controller stays in the parts total. The three limb breakers and the pack-lead sleeve are on the bill without a price (BLOCKER).
## Filament grams

Calc only. Not weighed.

- Installed robot PLA is 1355.5 g (print/SLICE_SUMMARY.md total). The shin sheets in that total are 23.2 g and 22.2 g. 1355.5 minus 23.2 minus 22.2 is 1310.1 g of PLA that stays.
- Topology deltas that stay PLA are 44.09 minus 7.48, which is 36.61 g (twin/structure/TOPOLOGY.md). The 7.48 g is the shin row, and those sheets move to PA6-CF instead. The topology shin base is 10.38 g each. The installed slice is 11.58 g each. The 36.61 g is from the other slice, added onto the installed set. It is about 3 percent of 1310 g, which matches pads on existing parts, not a new body.
- Duck PLA after those two studies: 1310.1 plus 36.61 is 1346.71 g. The existing spare rule is 10 to 20 percent. At 20 percent, 1346.71 times 1.2 is 1616.05 g, which is under 2 kg. The buy stays 2 spools of 1 kg, the existing line. The spool page was opened. Two 1 kg spools are in the total. Nest box grams are still not sliced, so whether those two spools cover the nest is still BLOCKER.
- Nest box and lid were not sliced (NEST_CAD.md). Whether 2 spools cover them is BLOCKER. No guessed gram number is added.
- TPU is 75.1 g (print/PRINT_PLAN.md, the D59 robot set). One 1 kg spool is the existing line. The flush wells were not re-sliced, so that delta is BLOCKER.
- PA6-CF is 28.03 g for the drive pair plus 17.97 g for the idle pair, 46.00 g (twin/structure/shin_eye/slice.json). One 0.5 kg spool covers that. The drive sheet is the recessed web. The idle sheet is the stock shin. The spacer stays PLA. Hot tensile, wet tensile, and the printer chamber are still BLOCKER in SHIN_EYE.md. The filament is still the named material.

## Fasteners

Duck counts are the fitted rows in fasteners/fasteners.json (CAD check only). Nest adds, from NEST_CAD.md section 5, 6 inserts, 4 of M3x6 button head, and 2 of M3x8. No new screw size. The lid is four corners. The terminals are a mirror pair. That is the pattern already in that file. D39 and D42 are unchanged by this bill.

## BLOCKER lines

A line stays BLOCKER when the part is not designed yet, the count is not in the files, the named page was unavailable, or no same-spec listing was opened. A proposed pick has a live price and is labeled proposed pick, not yet verified.

- sdread: USB-C microSD reader. out of stock
- pin: Short-stroke spring pin for the flush mat. count is not in FLUSH_CONTACTS.md
- adapter: Nest wall supply, 8.70 V to 10.0 V. tolerance was not opened
- alcohol: Isopropyl alcohol, 99.8 percent, 1 pint. page not opened 2026-11-12
- asm: Charger board assembly. no gerber in the lab files
- bearing: Ball bearing 20 x 32 x 7 mm. page not opened 2026-11-12
- button: Momentary pushbutton. page not opened 2026-11-12
- camcable: Camera cable, standard to mini, 300 mm. page not opened 2026-11-12
- feed: Copper foil tape, 1/2 in, for the hidden feed. page not opened 2026-11-12
- felt1: Nest felt, 1 mm. no maker part number in the lab files
- felt2: Rim felt, 2 mm. no maker part number in the lab files
- foam: Rim bolster foam. no maker part number in the lab files
- fs17h: M2 self-tapping kit, 304 SS. page not opened 2026-11-12
- fs17j: M3x6 button head, A2. page not opened 2026-11-12
- fs17k: M2.5x5 socket head, A2. page not opened 2026-11-12
- fs17l: M2.5 flat washer, 0.3 mm. page not opened 2026-11-12
- fs17m: M2x12 thread-forming pan head. no listing in the lab files and none opened today
- gate: Rim gate board. the board is not designed
- glass: Eye glass discs. page not opened 2026-11-12
- holder: ATO inline fuse holder. page not opened 2026-11-12
- jack: DC jack, 2.1 mm. page not opened 2026-11-12
- kk-h: KK 254 crimp housings, 2695 series. the line as specified cannot be ordered
- l2: BEC programmer. page not opened 2026-11-12
- mount: Adhesive tie mount, 19 mm. page not opened 2026-11-12
- mounts: Adhesive tie mount, 12.7 mm. page not opened 2026-11-12
- nestpla: Nest box and lid, PLA, grams not sliced. grams were not sliced
- nozzle: Hardened nozzle, 0.6 mm recommended. no listing opened today
- pcb: Charger board fabrication. no gerber in the lab files
- reflector: Projector reflector. page not opened 2026-11-12
- ring: Pale gold conductive cloth, ring. no maker part number in the lab files
- sg90: SG90-class 9 g servo, pack of 10. page not opened 2026-11-12
- spoxt: Mini-SPOX crimp terminal. page not opened 2026-11-12
- sun: Gold conductive cloth, sun disc. no maker part number in the lab files
- t10: Heat gun. page not opened 2026-11-12
- t11: Drill bit 6.0 mm. page not opened 2026-11-12
- t12: Drill bit 2.7 mm. page not opened 2026-11-12
- t13: T-handle tap wrench. page not opened 2026-11-12
- t14: Drill bit 4.0 mm. page not opened 2026-11-12
- t15: Drill bit 4.5 mm. page not opened 2026-11-12
- t16: Screwdriver PH 0. page not opened 2026-11-12
- t17: Screwdriver PH 1. page not opened 2026-11-12
- t18: Bit PH 0 x 25 mm. page not opened 2026-11-12
- t19: Drill bit 1/16 in, pack of 3. page not opened 2026-11-12
- t7b: USB-A to USB-C cable, 3 ft. page not opened 2026-11-12
- t9: Wire stripper, 12 to 20 AWG. page not opened 2026-11-12
- vhb: Foam tape, 3M VHB 4950, 3/4 in x 5 yd. page not opened 2026-11-12
- wall: Wall card, 40 mm square, cut from felt, no electronics. no separate part to buy until the felt has a part number
- waveshare: Bus servo adapter, USB data only. page not opened 2026-11-12
- weld: 2S pack build: nickel strip, sleeve, fish paper, weld. no maker part number in the lab files
- well-route: Duck-side ideal-diode path for each flush well. part is not chosen
- wells: Flush gold wells in the seat, 3 mm, five of them. no maker part number in the lab files
- xt30: XT30U pair, pack. page not opened 2026-11-12
## Check

python3 altaay_lab/bom/order/check_order.py

The script fails if a netlist part, a charger part, a print part, or a fastener line is missing from ORDER.csv, or if ORDER.csv maps a token the current design does not have.
