aaltaay/Open_Duck_Mini_v2/altaay_lab/cad/nest_v2/BOM.md

# Nest v2 cost notes

Prices live in this file only. Nothing was bought. A page that was not opened is BLOCKER, not a guess.

## Opened

Mill-Max 0906-0-15-20-76-14-11-0, spring pin. DigiKey product page, opened 2026-11-12:

https://www.digikey.com/en/products/detail/mill-max-manufacturing-corp/0906-0-15-20-76-14-11-0/1147049

The page's bulk table, USD:

| Quantity | Unit price |
|---|---|
| 1 | 0.86 |
| 10 | 0.733 |
| 25 | 0.6868 |
| 50 | 0.654 |
| 100 | 0.6227 |
| 250 | 0.58364 |
| 500 | 0.55574 |

This pin is not in the picked mat. It is the part a spring field (option e) would use. A point-tip grid fine enough for a 3 mm well, over a 560 mm by 360 mm field, is about 45,000 pins (calc only, NEST_V2.md). At the quantity-1 price that is about 38,700 USD (calc only, 45000 times 0.86). At the 500-piece price it is about 25,000 USD (calc only, 45000 times 0.55574). The page's 1,000-piece break was not copied here. Either way it is not a rug.

The picked mat uses no Mill-Max pins.

## Not opened, so no dollar figure

- Felt sheet. BLOCKER.
- Copper foil tape for the stripes. BLOCKER.
- The five gold well discs. BLOCKER. They can be punched from the same foil if a later pass says so. That is not a price.
- EDAC magnetic housings. BLOCKER.
- Qi2 coil and receiver module. BLOCKER. The ST brief and the WPC page that were opened do not print a price.
- The 40 mm wall card. It is a felt or printed square. No electronics. Not on the order list, so no price.

## What the picked mat adds, without a price

| Part | Count | Note |
|---|---|---|
| Felt, 1 mm sheet | 2 | base and top, cut |
| Foil stripe, 20 mm | 23 | 11 plus, 12 minus, on 2 buses |
| Gold well, 3 mm | 5 | in the seat, flush |
| Cord pocket, printed | 1 | no screws |
| Felt cap | 1 | sits in the pocket opening, 0.4 mm clear a side |
| Wall card, 40 mm | 1 | optional, Ahmed has not approved it |
| Charger board | 0 new | already drawn, in the duck |

The gate board that turns the field on is not designed. Its pocket is sized. It is not a line on this list.
