aaltaay/Open_Duck_Mini_v2/altaay_lab/twin/dock/DOCK_BOM_FULL.md

# DOCK_BOM_FULL: every item of the charging dock

Generated by twin/dock/dock_bom.py --write from dock_assembly.json, dock_fasteners.json, dock_netlist.yaml and stl/slice.json; do not edit by hand. Prices and links: DOCK_TWIN.md section 7. CAD check only, calc only.

## Printed parts

| Part | Qty | g each | h each | Line |
|---|---|---|---|---|
| dock_seat_base | 1 | 97.44 | 7.85 | K7 |
| dock_seat_top | 1 | 19.81 | 1.66 | K7 |
| dock_spine | 1 | 53.16 | 3.95 | K7 |
| dock_base_l | 1 | 97.19 | 6.67 | K7 |
| dock_base_r | 1 | 96.23 | 6.55 | K7 |
| dock_column_l1 | 1 | 86.63 | 5.86 | K7 |
| dock_column_l2 | 1 | 87.43 | 5.96 | K7 |
| dock_column_l3 | 1 | 87.24 | 5.88 | K7 |
| dock_column_r1 | 1 | 115.09 | 7.81 | K7 |
| dock_column_r2 | 1 | 87.23 | 5.88 | K7 |
| dock_column_r3 | 1 | 59.02 | 4.01 | K7 |
| dock_paddle | 1 | 46.04 | 3.31 | K7 |
| dock_paddle_carrier | 1 | 11.7 | 1.0 | K7 |
| dock_spring_cup | 2 | 13.39 | 1.17 | K7 |
| dock_spring_carriage | 2 | 1.42 | 0.16 | K7 |
| dock_spring_drum | 2 | 0.31 | 0.07 | K7 |
| dock_bay_tray | 1 | 89.59 | 6.07 | K7 |
| dock_bay_lid | 1 | 38.44 | 2.5 | K7 |

Total 1102.5 g, 77.8 h.

## Bought parts and board parts

| Id | Item | Line | Mount |
|---|---|---|---|
| pin_SYS_R | Spring pin SYS_R (Mill-Max 0933) | K5 | press-fit into the 1.60 mm bore, solder cup at the back |
| pin_SYS_L | Spring pin SYS_L (Mill-Max 0933) | K5 | press-fit into the 1.60 mm bore, solder cup at the back |
| pin_GND_R | Spring pin GND_R (Mill-Max 0933) | K5 | press-fit into the 1.60 mm bore, solder cup at the back |
| pin_GND_L | Spring pin GND_L (Mill-Max 0933) | K5 | press-fit into the 1.60 mm bore, solder cup at the back |
| pin_SENSE | Spring pin SENSE (Mill-Max 0933) | K5 | press-fit into the 1.60 mm bore, solder cup at the back |
| pin_CHG | Spring pin CHG (Mill-Max 0933) | K5 | press-fit into the 1.60 mm bore, solder cup at the back |
| rod_l | Guide rod left, 4 x 76 mm | K8a | pressed into the carrier crossbar and the carriage |
| cf_l | Constant-force spring left (Century CF37CS), coil | K8c | coil on the printed drum (fixed: it stays on the drum at every push) |
| cf_l_strip | Constant-force spring left (Century CF37CS), extended strip | K8c | the strip from the coil to the carriage, its length rebuilt for the push; its end under an M3x8 on the carriage |
| rod_r | Guide rod right, 4 x 76 mm | K8a | pressed into the carrier crossbar and the carriage |
| cf_r | Constant-force spring right (Century CF37CS), coil | K8c | coil on the printed drum (fixed: it stays on the drum at every push) |
| cf_r_strip | Constant-force spring right (Century CF37CS), extended strip | K8c | the strip from the coil to the carriage, its length rebuilt for the push; its end under an M3x8 on the carriage |
| seat_spring_b | Seat spring (Century CC-28CS) | K8d | in the post pocket, round the guide pin |
| seat_spring_f | Seat spring (Century CC-28CS) | K8d | in the post pocket, round the guide pin |
| switch | Seat microswitch (Omron D2F-01L) | K3 | 2 x M2x12 through its holes into the slotted tower, nylon nuts; height set at BT5 |
| ballast_l | Ballast bar left (1018 steel 120 x 63.5 x 7.9) | K8k | in the base pocket, held down by the bay tray |
| ballast_r | Ballast bar right (1018 steel 120 x 63.5 x 7.9) | K8k | in the base pocket, held down by the bay tray |
| foot_1 | Rubber foot (Adafruit 550) | K10 | adhesive, in a 2 mm pocket |
| foot_2 | Rubber foot (Adafruit 550) | K10 | adhesive, in a 2 mm pocket |
| foot_3 | Rubber foot (Adafruit 550) | K10 | adhesive, in a 2 mm pocket |
| foot_4 | Rubber foot (Adafruit 550) | K10 | adhesive, in a 2 mm pocket |
| foot_5 | Rubber foot (Adafruit 550) | K10 | adhesive, in a 2 mm pocket |
| foot_6 | Rubber foot (Adafruit 550) | K10 | adhesive, in a 2 mm pocket |
| foot_7 | Rubber foot (Adafruit 550) | K10 | adhesive, in a 2 mm pocket |
| foot_8 | Rubber foot (Adafruit 550) | K10 | adhesive, in a 2 mm pocket |
| foot_9 | Rubber foot (Adafruit 550) | K10 | adhesive, in a 2 mm pocket |
| foot_10 | Rubber foot (Adafruit 550) | K10 | adhesive, in a 2 mm pocket |
| foot_11 | Rubber foot (Adafruit 550) | K10 | adhesive, in a 2 mm pocket |
| foot_12 | Rubber foot (Adafruit 550) | K10 | adhesive, in a 2 mm pocket |
| tag_0 | AprilTag tag36h11 id 0 (40 mm) | K13 | printed on paper, glued on the mast face |
| tag_1 | AprilTag tag36h11 id 1 (60 mm) | K13 | printed on paper, glued on the mast face |
| tag_2 | AprilTag tag36h11 id 2 (60 mm) | K13 | printed on paper, glued on the mast face |
| evm | Charger board (Microchip MCP73213EV-2SOVP) | K1 | on VHB 4950 in a printed rim (bump-ons removed); no mounting holes |
| vhb_evm | VHB pad under the charger board | K12b |  |
| swg | Gate switch (Pololu 2815) | K2 | on VHB 4950 in a printed rim (as the robot's 2813) |
| vhb_swg | VHB pad under the 2815 | K12b |  |
| fuse_holder | Adapter fuse holder (Littelfuse FHAC0001ZXJ) with 5 A ATO fuse | K9 | on VHB 4950 in a printed rim |
| vhb_fh | VHB pad under the fuse holder | K12b |  |
| jack | DC jack (Same Sky PJ-005A) | K6b | through the 8 mm hole in the tray's rear wall, nut and washer outside |
| plug | Adapter plug 5.5 x 2.1 mm (Mean Well P1J) | K6 |  |
| adapter_cord | Adapter cord (part of K6, 1.5 m; 0.25 m drawn) | K6 |  |
| adapter | Wall adapter Mean Well GSM36U09-P1J (stand-in size) | K6 | in the wall socket |
| perf | Gate board (Adafruit 1609 Perma-Proto half) | K4i | 2 x M3x8 into inserts in 2 printed standoffs |
| gate_U1 | U1 TI LM393P (A1 hot side, A2 cold side) | K4a | soldered on the gate board |
| gate_U2 | U2 TI LM393P (B1 pack there, B2 not over) | K4a | soldered on the gate board |
| gate_U3 | U3 TI NE555P one-shot, 110 ms | K4b | soldered on the gate board |
| gate_VR1 | VR1 TI TL431A 2.50 V reference (cathode and ref tied) | K4c | soldered on the gate board |
| gate_Q1 | Q1 onsemi 2N3904 gate driver | K4d | soldered on the gate board |
| gate_Q3 | Q3 onsemi 2N3904 STAT inverter | K4d | soldered on the gate board |
| gate_D1 | D1 1N4148 TRIG clamp to the 9 V rail | K4f | soldered on the gate board |
| gate_D2 | D2 1N4148 wake pulse onto SENSE | K4f | soldered on the gate board |
| gate_R1 | R1 2.2 k TL431 bias | K4g | soldered on the gate board |
| gate_R2 | R2 10 k REF to SENSE | K4g | soldered on the gate board |
| gate_R3 | R3 26.7 k = 22 k + 4.7 k in series (window A top) | K4g | soldered on the gate board |
| gate_R4 | R4 42 k = 22 k + 10 k + 10 k in series (window A middle) | K4g | soldered on the gate board |
| gate_R5 | R5 32 k = 22 k + 10 k in series (window A bottom) | K4g | soldered on the gate board |
| gate_R6 | R6 14.7 k = 10 k + 4.7 k in series (window B top) | K4g | soldered on the gate board |
| gate_R7 | R7 38.9 k = 22 k + 10 k + 4.7 k + 2.2 k in series (window B middle) | K4g | soldered on the gate board |
| gate_R8 | R8 47 k (window B bottom) | K4g | soldered on the gate board |
| gate_R9 | R9 1 M CHG+ divider top | K4g | soldered on the gate board |
| gate_R10 | R10 330 k = 220 k + 100 k + 10 k in series (CHG+ divider bottom) | K4g | soldered on the gate board |
| gate_R11 | R11 10 k OK pull-up | K4g | soldered on the gate board |
| gate_R12 | R12 10 k Q1 base | K4g | soldered on the gate board |
| gate_R13 | R13 10 k STAT pull-up to V_SYS (never to the always-on 9 V: the charger is unpowered then) | K4g | soldered on the gate board |
| gate_R14 | R14 10 k Q3 base | K4g | soldered on the gate board |
| gate_R15 | R15 10 k Q3 collector pull-up to V_SYS: at power-up STAT and Q3 rise with V_SYS, so Q3C never falls and the 555 does not fire (no pulse loop after each wake) | K4g | soldered on the gate board |
| gate_R16 | R16 10 k TRIG pull-up | K4g | soldered on the gate board |
| gate_R17 | R17 100 k 555 timing: 1.1 x 100 k x 1 uF, 110 ms | K4g | soldered on the gate board |
| gate_R18 | R18 1 k wake pulse series | K4g | soldered on the gate board |
| gate_C1 | C1 100 nF U1 supply | K4h | soldered on the gate board |
| gate_C2 | C2 100 nF U2 supply | K4h | soldered on the gate board |
| gate_C3 | C3 100 nF U3 supply | K4h | soldered on the gate board |
| gate_C4 | C4 1 uF 555 timing | K4h | soldered on the gate board |
| gate_C5 | C5 10 nF trigger coupling (Q3 collector falling edge to TRIG) | K4h | soldered on the gate board |
| gate_C6 | C6 10 nF 555 CV | K4h | soldered on the gate board |

## Gate board parts (dock_netlist.yaml)

| Ref | Part | Line |
|---|---|---|
| U1 | TI LM393P (A1 hot side, A2 cold side) | K4a |
| U2 | TI LM393P (B1 pack there, B2 not over) | K4a |
| U3 | TI NE555P one-shot, 110 ms | K4b |
| VR1 | TI TL431A 2.50 V reference (cathode and ref tied) | K4c |
| Q1 | onsemi 2N3904 gate driver | K4d |
| Q3 | onsemi 2N3904 STAT inverter | K4d |
| D1 | 1N4148 TRIG clamp to the 9 V rail | K4f |
| D2 | 1N4148 wake pulse onto SENSE | K4f |
| R1 | 2.2 k TL431 bias | K4g |
| R2 | 10 k REF to SENSE | K4g |
| R3 | 26.7 k = 22 k + 4.7 k in series (window A top) | K4g |
| R4 | 42 k = 22 k + 10 k + 10 k in series (window A middle) | K4g |
| R5 | 32 k = 22 k + 10 k in series (window A bottom) | K4g |
| R6 | 14.7 k = 10 k + 4.7 k in series (window B top) | K4g |
| R7 | 38.9 k = 22 k + 10 k + 4.7 k + 2.2 k in series (window B middle) | K4g |
| R8 | 47 k (window B bottom) | K4g |
| R9 | 1 M CHG+ divider top | K4g |
| R10 | 330 k = 220 k + 100 k + 10 k in series (CHG+ divider bottom) | K4g |
| R11 | 10 k OK pull-up | K4g |
| R12 | 10 k Q1 base | K4g |
| R13 | 10 k STAT pull-up to V_SYS (never to the always-on 9 V: the charger is unpowered then) | K4g |
| R14 | 10 k Q3 base | K4g |
| R15 | 10 k Q3 collector pull-up to V_SYS: at power-up STAT and Q3 rise with V_SYS, so Q3C never falls and the 555 does not fire (no pulse loop after each wake) | K4g |
| R16 | 10 k TRIG pull-up | K4g |
| R17 | 100 k 555 timing: 1.1 x 100 k x 1 uF, 110 ms | K4g |
| R18 | 1 k wake pulse series | K4g |
| C1 | 100 nF U1 supply | K4h |
| C2 | 100 nF U2 supply | K4h |
| C3 | 100 nF U3 supply | K4h |
| C4 | 1 uF 555 timing | K4h |
| C5 | 10 nF trigger coupling (Q3 collector falling edge to TRIG) | K4h |
| C6 | 10 nF 555 CV | K4h |

## Screws, nuts, inserts (dock_fasteners.json)

| Spec | Count | Line |
|---|---|---|
| 5/16-32 hex nut and washer (with the jack) | 1 | K6b |
| M2 nylon insert lock nut DIN 985 A2 | 2 | K8n |
| M2x12 DIN 7985 A2 pan head | 2 | K8m |
| M3 heat-set insert CNC Kitchen M3 x 5.7 | 20 | K8o |
| M3 nylon insert lock nut DIN 985 A2 | 15 | K8i |
| M3x12 DIN 912 A2 | 8 | K8h |
| M3x16 DIN 912 A2 | 4 | K8f |
| M3x18 DIN 912 A2 | 4 | K8e |
| M3x30 DIN 912 A2 | 9 | K8g |
| M3x8 DIN 912 A2 | 14 | K8l |

## Wires (dock_netlist.yaml, cut lengths from the 3D routes)

| Cable | From | To | Gauge | Colour | Cut mm |
|---|---|---|---|---|---|
| KC2 | J1.TIP | FD.IN | 16 AWG | red | 90 |
| KC2 | J1.SLV | GATE.GND | 20 AWG | black | 140 |
| KC3 | FD.OUT | SWG.VIN | 16 AWG | red | 90 |
| KC3 | SWG.VIN | GATE.V9 | 26 AWG | red | 120 |
| KC4 | SWG.VOUT | CH.VDD | 20 AWG | red | 100 |
| KC4 | SWG.GND | GATE.GND | 26 AWG | black | 110 |
| KC4 | CH.VSS | GATE.GND | 20 AWG | black | 80 |
| KC4 | CH.STAT | GATE.STAT | 26 AWG | white | 110 |
| KC4 | CH.VBATP | GATE.CHGS | 26 AWG | yellow | 130 |
| KC4 | SWG.VOUT | GATE.VSYS | 26 AWG | red | 130 |
| KC5 | SWG.CTRL | MS.C | 26 AWG | blue | 370 |
| KC5 | MS.NO | GATE.Q1C | 26 AWG | green | 320 |
| KP1 | CH.VBATP | PADDLE.CHG | 20 AWG | red | 420 |
| KP1 | GATE.SNS | PADDLE.SNS | 26 AWG | white | 360 |
| KP1 | GATE.GND | PADDLE.GND_L | 20 AWG | black | 360 |
| KP1 | SWG.VOUT | PADDLE.SYS_L | 20 AWG | red | 410 |
| KP2 | PADDLE.GND_L | PADDLE.GND_R | 20 AWG | black | 50 |
| KP2 | PADDLE.SYS_L | PADDLE.SYS_R | 20 AWG | red | 50 |

Wire to cut, by gauge and colour (line K11): 20 AWG black 630 mm, 20 AWG red 980 mm, 26 AWG black 110 mm, 26 AWG blue 370 mm, 26 AWG green 320 mm, 26 AWG red 250 mm, 26 AWG white 470 mm, 26 AWG yellow 130 mm.
