aaltaay/Open_Duck_Mini_v2/altaay_lab/bom_full.csv

id | section | item | spec | qty | unit | spare | where | line | supplier | buy | pack | line_cost | link | status | note | source
P01 | Printed parts | Ankle pad | print/ankle_pad.stl, TPU, light (base), 0.2 g, 0.04 h each | 4 | pcs | 0 | Left foot 2, Right foot 2 | 28 | Amazon | 1 | 1 kg | 23.99 | https://www.amazon.com/dp/B0BGMP1MZ7 | printed | TPU 2 walls 40 % (the sole profile): the 6 x 7.5 x 3 mm ankle stop pads on VHB 4950; 2 per foot (D59) | [L] print/parts.csv, CAD instances in the viewer
P02 | Printed parts | Battery pack lid | print/battery_pack_lid.stl, PLA, light (base), 13.6 g, 0.99 h each | 1 | pcs | 0 | Trunk | 27 | Amazon | 2 | 1 kg | 29.98 | https://www.amazon.com/dp/B09LCK7QJ2 | printed | 2 walls 15 % (upstream default): a lid whose screws thread into body_back; no rule asks for more | [L] print/parts.csv, CAD instances in the viewer
P03 | Printed parts | Body back | print/body_back.stl, PLA, rings (base + 4 pilot rings), 79.2 g, 6.54 h each | 1 | pcs | 0 | Trunk | 27 | Amazon | 2 | 1 kg | 29.98 | https://www.amazon.com/dp/B09LCK7QJ2 | printed | 2 walls 15 % plus a 1.5 mm solid ring round each of its 5 screw pilots (4 lid and 1 charger; D42 reopened the F027 lid pilot that D39 closed): the pilot rule at each hole instead of 3 walls on the whole shell; no coupon | [L] print/parts.csv, CAD instances in the viewer
P04 | Printed parts | Body front | print/body_front.stl, PLA, light (base), 57.6 g, 3.94 h each | 1 | pcs | 0 | Trunk | 27 | Amazon | 2 | 1 kg | 29.98 | https://www.amazon.com/dp/B09LCK7QJ2 | printed | 2 walls 15 % (upstream default): no rule asks for more; front face on the bed since D54 (the cliff ToF seat grows from the inner face) | [L] print/parts.csv, CAD instances in the viewer
P05 | Printed parts | Body middle bottom | print/body_middle_bottom.stl, PLA, rings (base + 4 insert rings), 106.5 g, 9.35 h each | 1 | pcs | 0 | Trunk | 27 | Amazon | 2 | 1 kg | 29.98 | https://www.amazon.com/dp/B09LCK7QJ2 | printed | 2 walls 15 % plus a 2.0 mm solid ring round each of its insert bores | [L] print/parts.csv, CAD instances in the viewer
P06 | Printed parts | Body middle top | print/body_middle_top.stl, PLA, rings (base + 6 insert rings), 74.6 g, 6.62 h each | 1 | pcs | 0 | Trunk | 27 | Amazon | 2 | 1 kg | 29.98 | https://www.amazon.com/dp/B09LCK7QJ2 | printed | 2 walls 15 % plus a 2.0 mm solid ring round each of its 6 insert bores (D39 closed 2): the insert rule at each bore; waits for the S1 gate (C2aL C2bL C3L): if a light coupon fails it prints with 4 walls (insert) and no rings | [L] print/parts.csv, CAD instances in the viewer
P07 | Printed parts | Eye bulb | print/bulb.stl, PLA, light (base), 2.1 g, 0.17 h each | 2 | pcs | 0 | Head 2 | 27 | Amazon | 2 | 1 kg | 29.98 | https://www.amazon.com/dp/B09LCK7QJ2 | printed | 2 walls 15 % (upstream default); guide says x1 but the CAD has 2 (issue #26) | [L] print/parts.csv, CAD instances in the viewer
P08 | Printed parts | Flash light module | print/flash_light_module.stl, PLA, light (base), 8.6 g, 0.80 h each | 1 | pcs | 0 | Head | 27 | Amazon | 2 | 1 kg | 29.98 | https://www.amazon.com/dp/B09LCK7QJ2 | printed | 2 walls 15 % (upstream default); its 4.0 mm hole is a 14.6 mm light channel and not an insert bore | [L] print/parts.csv, CAD instances in the viewer
P09 | Printed parts | Flash reflector interface | print/flash_reflector_interface.stl, PLA, light (base), 2.3 g, 0.24 h each | 1 | pcs | 0 | Head | 27 | Amazon | 2 | 1 kg | 29.98 | https://www.amazon.com/dp/B09LCK7QJ2 | printed | 2 walls 15 % (upstream default): no rule asks for more | [L] print/parts.csv, CAD instances in the viewer
P10 | Printed parts | Foot bottom plate | print/foot_bottom_pla.stl, PLA, rings (base + 2 insert rings), 9.8 g, 0.78 h each | 2 | pcs | 0 | Left foot, Right foot | 27 | Amazon | 2 | 1 kg | 29.98 | https://www.amazon.com/dp/B09LCK7QJ2 | printed | 2 walls 15 % plus a 2.0 mm solid ring round each of its 2 blind insert bores 5.8 mm (C3): the insert rule at each bore; waits for the S1 gate (C2aL C2bL C3L): if a light coupon fails it prints with 4 walls (insert) and no rings | [L] print/parts.csv, CAD instances in the viewer
P11 | Printed parts | Foot sole (TPU) | print/foot_bottom_tpu.stl, TPU, light (base), 17.6 g, 2.18 h each | 2 | pcs | 0 | Left foot, Right foot | 28 | Amazon | 1 | 1 kg | 23.99 | https://www.amazon.com/dp/B0BGMP1MZ7 | printed | TPU 2 walls 40 % (upstream infill; B26): no strength rule for the sole; coupon T2 is the left leg sole and checks fit | [L] print/parts.csv, CAD instances in the viewer
P12 | Printed parts | Foot side | print/foot_side.stl, PLA, light (base), 13.5 g, 1.14 h each | 2 | pcs | 0 | Left foot, Right foot | 27 | Amazon | 2 | 1 kg | 29.98 | https://www.amazon.com/dp/B09LCK7QJ2 | printed | 2 walls 15 % (upstream default): no rule asks for more; D59: heel notch where the shin clamp passes down to the -95 deg ankle stop and a flat seat for the ankle pad; D59: the heel screw (F024/F026) and its insert moved 20 mm toward the toe | [L] print/parts.csv, CAD instances in the viewer
P13 | Printed parts | Foot top | print/foot_top.stl, PLA, rings (base + 2 insert rings), 23.4 g, 2.06 h each | 2 | pcs | 0 | Left foot, Right foot | 27 | Amazon | 2 | 1 kg | 29.98 | https://www.amazon.com/dp/B09LCK7QJ2 | printed | 2 walls 15 % plus a 2.0 mm solid ring round each of its 2 insert bores (the 1.5 mm bore wall of B16 prints solid either way): the insert rule at each bore; waits for the S1 gate (C2aL C2bL C3L): if a light coupon fails it prints with 4 walls (insert) and no rings; D59: heel notch where the shin clamp passes down to the -95 deg ankle stop and a flat seat for the ankle pad; D59: the heel screw (F024/F026) and its insert moved 20 mm toward the toe | [L] print/parts.csv, CAD instances in the viewer
P14 | Printed parts | Head shell | print/head.stl, PLA, heavy (insert), 262.0 g, 21.77 h each | 1 | pcs | 0 | Head | 27 | Amazon | 2 | 1 kg | 29.98 | https://www.amazon.com/dp/B09LCK7QJ2 | printed | 4 walls (insert) as before D22: 12 insert bores and a bearing seat (horizontal in this orientation); in the sim its mass is the forward counterweight (a light head costs one step of backward margin; MASS_STUDY.md option d) | [L] print/parts.csv, CAD instances in the viewer
P15 | Printed parts | Head bot sheet | print/head_bot_sheet.stl, PLA, light (base), 57.2 g, 3.76 h each | 1 | pcs | 0 | Head | 27 | Amazon | 2 | 1 kg | 29.98 | https://www.amazon.com/dp/B09LCK7QJ2 | printed | 2 walls 15 % (upstream default): a 3 mm floor sheet | [L] print/parts.csv, CAD instances in the viewer
P16 | Printed parts | Head pad | print/head_pad.stl, TPU, light (base), 0.9 g, 0.18 h each | 1 | pcs | 0 | Trunk | 28 | Amazon | 1 | 1 kg | 23.99 | https://www.amazon.com/dp/B0BGMP1MZ7 | printed | TPU 2 walls 40 % (the sole profile): the 12 x 6.1 x 10 mm head forward stop face in the hook's pocket on VHB 4950 (D59) | [L] print/parts.csv, CAD instances in the viewer
P17 | Printed parts | Head pitch to yaw | print/head_pitch_to_yaw.stl, PLA, heavy (neck), 24.8 g, 2.65 h each | 1 | pcs | 1 | Neck | 27 | Amazon | 2 | 1 kg | 29.98 | https://www.amazon.com/dp/B09LCK7QJ2 | printed | 5 walls 40 % (neck) as before D22: neck chain (G5); thinnest part at head_pitch and head_yaw (G6); D59: the -25 deg head forward stop hook on the left arm (a TPU face in its pocket) | [L] print/parts.csv, CAD instances in the viewer
P18 | Printed parts | Head roll mount | print/head_roll_mount.stl, PLA, heavy (neck+fit), 15.7 g, 1.42 h each | 1 | pcs | 1 | Head | 27 | Amazon | 2 | 1 kg | 29.98 | https://www.amazon.com/dp/B09LCK7QJ2 | printed | 5 walls 40 % and fit (neck+fit) as before D22: neck chain (G5); servo pocket line to line (0.00 mm net) | [L] print/parts.csv, CAD instances in the viewer
P19 | Printed parts | Head yaw to roll | print/head_yaw_to_roll.stl, PLA, heavy (neck+fit), 29.1 g, 2.81 h each | 1 | pcs | 1 | Neck | 27 | Amazon | 2 | 1 kg | 29.98 | https://www.amazon.com/dp/B09LCK7QJ2 | printed | 5 walls 40 % and fit (neck+fit) as before D22: neck chain (G5); servo pocket 0.10 mm undersize (C4) | [L] print/parts.csv, CAD instances in the viewer
P20 | Printed parts | Hip pad | print/hip_pad.stl, TPU, light (base), 0.2 g, 0.03 h each | 2 | pcs | 0 | Left hip bracket, Right hip bracket | 28 | Amazon | 1 | 1 kg | 23.99 | https://www.amazon.com/dp/B0BGMP1MZ7 | printed | TPU 2 walls 40 % (the sole profile): the 22 x 6 x 1.5 mm hip pitch -75 deg face on VHB 4950 (D59) | [L] print/parts.csv, CAD instances in the viewer
P21 | Printed parts | Knee bumper | print/knee_bumper.stl, TPU, light (base), 1.2 g, 0.15 h each | 2 | pcs | 0 | Left shin, Right shin | 28 | Amazon | 1 | 1 kg | 23.99 | https://www.amazon.com/dp/B0BGMP1MZ7 | printed | TPU 2 walls 40 % (the sole profile): the 28 x 14 x 3 mm knee stop pad on VHB 4950 (D59) | [L] print/parts.csv, CAD instances in the viewer
P22 | Printed parts | Knee to ankle left sheet | print/knee_to_ankle_left_sheet.stl, PLA, heavy (wall3+fit), 6.7 g, 0.63 h each | 2 | pcs | 1 | Left thigh, Right thigh | 27 | Amazon | 2 | 1 kg | 29.98 | https://www.amazon.com/dp/B09LCK7QJ2 | printed | 3 walls and fit (wall3+fit) as before D22: thinnest leg plate (G6); servo tabs line to line (0.01 mm); the thigh pair only since D59 (the shins print shin_left_sheet and shin_right_sheet); front edge trimmed where the shin clamp passes at the knee fold (twin/sit/SIT.md) | [L] print/parts.csv, CAD instances in the viewer
P23 | Printed parts | Knee to ankle right sheet | print/knee_to_ankle_right_sheet.stl, PLA, heavy (wall3+fit), 6.1 g, 0.59 h each | 2 | pcs | 1 | Left thigh, Right thigh | 27 | Amazon | 2 | 1 kg | 29.98 | https://www.amazon.com/dp/B09LCK7QJ2 | printed | 3 walls and fit (wall3+fit) as before D22: thinnest leg plate (G6); servo tabs line to line (0.01 mm); the thigh pair only since D59 (the shins print shin_left_sheet and shin_right_sheet); front edge trimmed where the shin clamp passes at the knee fold (twin/sit/SIT.md) | [L] print/parts.csv, CAD instances in the viewer
P24 | Printed parts | Left antenna holder | print/left_antenna_holder.stl, PLA, heavy (wall3), 3.6 g, 0.28 h each | 1 | pcs | 1 | Head | 27 | Amazon | 2 | 1 kg | 29.98 | https://www.amazon.com/dp/B09LCK7QJ2 | printed | 3 walls (wall3) as before D22: thinnest part (2.0 mm); first hit if the head swings (G6) | [L] print/parts.csv, CAD instances in the viewer
P25 | Printed parts | Left leg cover | print/left_cache.stl, PLA, light (base), 49.5 g, 4.38 h each | 1 | pcs | 0 | Left thigh | 27 | Amazon | 2 | 1 kg | 29.98 | https://www.amazon.com/dp/B09LCK7QJ2 | printed | 2 walls 15 % (upstream default): a cover (PRINT_PLAN.md G6: not spared); D59: recessed where the joggled shin | [L] print/parts.csv, CAD instances in the viewer
P26 | Printed parts | Left eye | print/left_eye.stl, PLA, heavy (wall3), 1.8 g, 0.17 h each | 1 | pcs | 0 | Head | 27 | Amazon | 2 | 1 kg | 29.98 | https://www.amazon.com/dp/B09LCK7QJ2 | printed | 3 walls (wall3) as before D22: 4 screw pilots; whole-part test print T1 (B14) in this profile | [L] print/parts.csv, CAD instances in the viewer
P27 | Printed parts | Left roll to pitch | print/left_roll_to_pitch.stl, PLA, heavy (wall3+fit), D38, 25.8 g, 2.42 h each | 1 | pcs | 0 | Left hip bracket | 27 | Amazon | 2 | 1 kg | 29.98 | https://www.amazon.com/dp/B09LCK7QJ2 | printed | 3 walls and fit (wall3+fit) as before D22: D38 takes D26 option P1 for the structure twin's weakest part (twin/structure/STRUCTURE_TWIN.md P1; with STS3250 knees twin/knee/KNEE_TWIN.md section 5); servo pocket line to line (0.10 mm face overlap); G12 check; D59: the 8 deg outward hip roll stop lug | [L] print/parts.csv, CAD instances in the viewer
P28 | Printed parts | Leg spacer | print/leg_spacer.stl, PLA, rings (base + 4 insert rings), 6.0 g, 0.72 h each | 2 | pcs | 0 | Left thigh, Right thigh | 27 | Amazon | 2 | 1 kg | 29.98 | https://www.amazon.com/dp/B09LCK7QJ2 | printed | 2 walls 15 % plus a 2.0 mm solid ring round each of its 4 insert bores (2 per end): the insert rule at each bore; waits for the S1 gate (C2aL C2bL C3L): if a light coupon fails it prints with 4 walls (insert) and no rings; the thigh spacer only since D59 (the shins use shin_spacer.stl) | [L] print/parts.csv, CAD instances in the viewer
P29 | Printed parts | Neck left sheet | print/neck_left_sheet.stl, PLA, heavy (neck), 7.5 g, 0.70 h each | 1 | pcs | 1 | Neck | 27 | Amazon | 2 | 1 kg | 29.98 | https://www.amazon.com/dp/B09LCK7QJ2 | printed | 5 walls 40 % (neck) as before D22: neck chain (G5); thin sheet at neck_pitch and head_pitch (G6); D59: the +25 deg neck back stop lug | [L] print/parts.csv, CAD instances in the viewer
P30 | Printed parts | Neck pad | print/neck_pad.stl, TPU, light (base), 0.2 g, 0.04 h each | 2 | pcs | 0 | Trunk 2 | 28 | Amazon | 1 | 1 kg | 23.99 | https://www.amazon.com/dp/B0BGMP1MZ7 | printed | TPU 2 walls 40 % (the sole profile): the 10 x 6 x 3 mm neck back stop faces in the block's pockets on VHB 4950; 1 per pillar (D59) | [L] print/parts.csv, CAD instances in the viewer
P31 | Printed parts | Neck right sheet | print/neck_right_sheet.stl, PLA, heavy (neck), 6.7 g, 0.62 h each | 1 | pcs | 1 | Neck | 27 | Amazon | 2 | 1 kg | 29.98 | https://www.amazon.com/dp/B09LCK7QJ2 | printed | 5 walls 40 % (neck) as before D22: neck chain (G5); thin sheet at neck_pitch and head_pitch (G6); D59: the +25 deg neck back stop lug | [L] print/parts.csv, CAD instances in the viewer
P32 | Printed parts | Neck stop | print/neck_stop.stl, PLA, heavy (neck), 14.7 g, 1.38 h each | 1 | pcs | 0 | Trunk | 27 | Amazon | 2 | 1 kg | 29.98 | https://www.amazon.com/dp/B09LCK7QJ2 | printed | 5 walls 40 % (neck): the neck back stop block on trunk_top behind the neck (F127 and F129 M2x12); stands on its base (D59) | [L] print/parts.csv, CAD instances in the viewer
P33 | Printed parts | Right antenna holder | print/right_antenna_holder.stl, PLA, heavy (wall3), 3.6 g, 0.28 h each | 1 | pcs | 1 | Head | 27 | Amazon | 2 | 1 kg | 29.98 | https://www.amazon.com/dp/B09LCK7QJ2 | printed | 3 walls (wall3) as before D22: thinnest part (2.0 mm); first hit if the head swings (G6) | [L] print/parts.csv, CAD instances in the viewer
P34 | Printed parts | Right leg cover | print/right_cache.stl, PLA, light (base), 49.6 g, 4.37 h each | 1 | pcs | 0 | Right thigh | 27 | Amazon | 2 | 1 kg | 29.98 | https://www.amazon.com/dp/B09LCK7QJ2 | printed | 2 walls 15 % (upstream default): a cover (PRINT_PLAN.md G6: not spared); D59: recessed where the joggled shin | [L] print/parts.csv, CAD instances in the viewer
P35 | Printed parts | Right eye | print/right_eye.stl, PLA, heavy (wall3), 4.5 g, 0.36 h each | 1 | pcs | 0 | Head | 27 | Amazon | 2 | 1 kg | 29.98 | https://www.amazon.com/dp/B09LCK7QJ2 | printed | 3 walls (wall3) as before D22: 4 screw pilots | [L] print/parts.csv, CAD instances in the viewer
P36 | Printed parts | Right roll to pitch | print/right_roll_to_pitch.stl, PLA, heavy (wall3+fit), D38, 25.8 g, 2.44 h each | 1 | pcs | 0 | Right hip bracket | 27 | Amazon | 2 | 1 kg | 29.98 | https://www.amazon.com/dp/B09LCK7QJ2 | printed | 3 walls and fit (wall3+fit) as before D22: D38 takes D26 option P1 for the structure twin's weakest part (twin/structure/STRUCTURE_TWIN.md P1; with STS3250 knees twin/knee/KNEE_TWIN.md section 5); servo pocket line to line (0.10 mm face overlap); G12 check; D59: the 8 deg outward hip roll stop lug | [L] print/parts.csv, CAD instances in the viewer
P37 | Printed parts | Roll motor bottom | print/roll_motor_bottom.stl, PLA, heavy (wall3), 8.8 g, 0.72 h each | 2 | pcs | 1 | Left hip, Right hip | 27 | Amazon | 2 | 1 kg | 29.98 | https://www.amazon.com/dp/B09LCK7QJ2 | printed | 3 walls (wall3) as before D22: thinnest hip part (2.97 mm median) at hip yaw and hip roll; G12 screw (G6) | [L] print/parts.csv, CAD instances in the viewer
P38 | Printed parts | Roll motor top | print/roll_motor_top.stl, PLA, light (fit), 7.1 g, 0.73 h each | 2 | pcs | 0 | Left hip, Right hip | 27 | Amazon | 2 | 1 kg | 29.98 | https://www.amazon.com/dp/B09LCK7QJ2 | printed | 2 walls 15 % with fit: servo pocket line to line (0.01 mm); no rule asks for more walls | [L] print/parts.csv, CAD instances in the viewer
P39 | Printed parts | Roll pad left | print/roll_pad_left.stl, TPU, light (base), 0.1 g, 0.04 h each | 1 | pcs | 0 | Left hip bracket | 28 | Amazon | 1 | 1 kg | 23.99 | https://www.amazon.com/dp/B0BGMP1MZ7 | printed | TPU 2 walls 40 % (the sole profile): the hip roll -8 deg stop face in the left lug pocket on VHB 4950 | [L] print/parts.csv, CAD instances in the viewer
P40 | Printed parts | Roll pad right | print/roll_pad_right.stl, TPU, light (base), 0.1 g, 0.04 h each | 1 | pcs | 0 | Right hip bracket | 28 | Amazon | 1 | 1 kg | 23.99 | https://www.amazon.com/dp/B0BGMP1MZ7 | printed | TPU 2 walls 40 % (the sole profile): the right lug face | [L] print/parts.csv, CAD instances in the viewer
P41 | Printed parts | Shin left sheet | print/shin_left_sheet.stl, PLA, heavy (wall3+fit), 11.6 g, 1.09 h each | 2 | pcs | 1 | Left shin, Right shin | 27 | Amazon | 2 | 1 kg | 29.98 | https://www.amazon.com/dp/B09LCK7QJ2 | printed | 3 walls and fit (wall3+fit) as the knee_to_ankle sheet it is made from (D59): the plate joggled 9 mm and the clamp block with its M2 counterbores (twin/sit/SIT.md); thinnest leg plate (G6) | [L] print/parts.csv, CAD instances in the viewer
P42 | Printed parts | Shin right sheet | print/shin_right_sheet.stl, PLA, heavy (wall3+fit), 11.1 g, 1.07 h each | 2 | pcs | 1 | Left shin, Right shin | 27 | Amazon | 2 | 1 kg | 29.98 | https://www.amazon.com/dp/B09LCK7QJ2 | printed | 3 walls and fit (wall3+fit) as the knee_to_ankle sheet it is made from (D59); see shin_left_sheet | [L] print/parts.csv, CAD instances in the viewer
P43 | Printed parts | Shin spacer | print/shin_spacer.stl, PLA, rings (base + 4 insert rings), 7.3 g, 0.94 h each | 2 | pcs | 0 | Left shin, Right shin | 27 | Amazon | 2 | 1 kg | 29.98 | https://www.amazon.com/dp/B09LCK7QJ2 | printed | 2 walls 15 % plus a 2.0 mm solid ring round each of its 4 insert bores as leg_spacer (D59: at the shin back edge; 54.8 mm long; carries the knee bumper); waits for the S1 gate like leg_spacer | [L] print/parts.csv, CAD instances in the viewer
P44 | Printed parts | Sit bumper | print/sit_bumper.stl, TPU, light (sparse), 12.2 g, 1.46 h each | 1 | pcs | 0 | Trunk | 28 | Amazon | 1 | 1 kg | 23.99 | https://www.amazon.com/dp/B0BGMP1MZ7 | printed | TPU 2 walls and 10 % infill (sparse): the belly bumper under the front on VHB 4950; printed on its flat glue face (D59) | [L] print/parts.csv, CAD instances in the viewer
P45 | Printed parts | Sit seat | print/sit_seat.stl, TPU, light (sparse), 22.6 g, 2.67 h each | 1 | pcs | 0 | Trunk | 28 | Amazon | 1 | 1 kg | 23.99 | https://www.amazon.com/dp/B0BGMP1MZ7 | printed | TPU 2 walls and 10 % infill (sparse): the seat under the rear belly on VHB 4950; printed on its sloped glue face (D59) | [L] print/parts.csv, CAD instances in the viewer
P46 | Printed parts | Speaker interface | print/speaker_interface.stl, PLA, light (base), 2.4 g, 0.22 h each | 1 | pcs | 0 | Head | 27 | Amazon | 2 | 1 kg | 29.98 | https://www.amazon.com/dp/B09LCK7QJ2 | printed | 2 walls 15 % (upstream default); laid flat (PRINT_CHECK had it on a 48 mm2 edge) | [L] print/parts.csv, CAD instances in the viewer
P47 | Printed parts | Speaker stand | print/speaker_stand.stl, PLA, heavy (wall3), 10.0 g, 1.11 h each | 1 | pcs | 0 | Head | 27 | Amazon | 2 | 1 kg | 29.98 | https://www.amazon.com/dp/B09LCK7QJ2 | printed | 3 walls (wall3) as before D22: 2 screw pilots | [L] print/parts.csv, CAD instances in the viewer
P48 | Printed parts | Trunk bottom frame | print/trunk_bottom.stl, PLA, heavy (insert+fit), 42.0 g, 3.54 h each | 1 | pcs | 0 | Trunk | 27 | Amazon | 2 | 1 kg | 29.98 | https://www.amazon.com/dp/B09LCK7QJ2 | printed | 4 walls and fit (insert+fit) as before D22: frame part; both legs hang from its 2 hip yaw 6804 seats 32.19 mm (C1); 6 insert bores | [L] print/parts.csv, CAD instances in the viewer
P49 | Printed parts | Trunk top frame | print/trunk_top.stl, PLA, heavy (wall3+fit), 75.1 g, 6.13 h each | 1 | pcs | 0 | Trunk | 27 | Amazon | 2 | 1 kg | 29.98 | https://www.amazon.com/dp/B09LCK7QJ2 | printed | 3 walls and fit (wall3+fit) as before D22: frame part that holds the 2 hip yaw servos and the neck pitch servo; 3 servo pockets line to line (0.10 mm face overlap) | [L] print/parts.csv, CAD instances in the viewer
P50 | Printed parts | Antenna rod (optional) | URDF antenna.stl, PLA, 1.8 g for 2 (print/PRINT_PLAN.md optional part) | 2 | pcs | 0 | Head 2 | 27 | Amazon | 2 | 1 kg | 29.98 | https://www.amazon.com/dp/B09LCK7QJ2 | printed | In the CAD but not in print/: export from the URDF mesh (PRINT_PLAN.md) | [L] print/PRINT_PLAN.md
S01 | Servos | Feetech STS3215 C001, ID 10, right hip yaw | 7.4 V 1:345; ships with 1 horn set, 1 x 15 cm 5264 cable and a screw bag (BOM line 1) | 1 | pcs | 0 | Trunk | 1 | Seeed Studio | 12 | 1 | 228.0 | https://www.seeedstudio.com/STS3215-19kg-cm-7-4V-Serial-Servo-p-6338.html | bought |  | [U] Runtime IDs (WIRING.md section 2), CAD; model from wiring/netlist.yaml
S02 | Servos | Feetech STS3215 C001, ID 11, right hip roll | 7.4 V 1:345; ships with 1 horn set, 1 x 15 cm 5264 cable and a screw bag (BOM line 1) | 1 | pcs | 0 | Right hip | 1 | Seeed Studio | 12 | 1 | 228.0 | https://www.seeedstudio.com/STS3215-19kg-cm-7-4V-Serial-Servo-p-6338.html | bought |  | [U] Runtime IDs (WIRING.md section 2), CAD; model from wiring/netlist.yaml
S03 | Servos | Feetech STS3215 C001, ID 12, right hip pitch | 7.4 V 1:345; ships with 1 horn set, 1 x 15 cm 5264 cable and a screw bag (BOM line 1) | 1 | pcs | 0 | Right hip bracket | 1 | Seeed Studio | 12 | 1 | 228.0 | https://www.seeedstudio.com/STS3215-19kg-cm-7-4V-Serial-Servo-p-6338.html | bought |  | [U] Runtime IDs (WIRING.md section 2), CAD; model from wiring/netlist.yaml
S04 | Servos | Feetech STS3250-C002, ID 13, right knee | 50 kg.cm, same outline, 25T horn and 5264 ports as the C001 (BOM line 1b, D32) | 1 | pcs | 0 | Right thigh | 1b | OpenELAB | 2 | 1 | 147.98 | https://openelab.com/products/feetech-sts3250-c002-servo-12v | bought |  | [U] Runtime IDs (WIRING.md section 2), CAD; model from wiring/netlist.yaml
S05 | Servos | Feetech STS3215 C001, ID 14, right ankle | 7.4 V 1:345; ships with 1 horn set, 1 x 15 cm 5264 cable and a screw bag (BOM line 1) | 1 | pcs | 0 | Right shin | 1 | Seeed Studio | 12 | 1 | 228.0 | https://www.seeedstudio.com/STS3215-19kg-cm-7-4V-Serial-Servo-p-6338.html | bought |  | [U] Runtime IDs (WIRING.md section 2), CAD; model from wiring/netlist.yaml
S06 | Servos | Feetech STS3215 C001, ID 20, left hip yaw | 7.4 V 1:345; ships with 1 horn set, 1 x 15 cm 5264 cable and a screw bag (BOM line 1) | 1 | pcs | 0 | Trunk | 1 | Seeed Studio | 12 | 1 | 228.0 | https://www.seeedstudio.com/STS3215-19kg-cm-7-4V-Serial-Servo-p-6338.html | bought |  | [U] Runtime IDs (WIRING.md section 2), CAD; model from wiring/netlist.yaml
S07 | Servos | Feetech STS3215 C001, ID 21, left hip roll | 7.4 V 1:345; ships with 1 horn set, 1 x 15 cm 5264 cable and a screw bag (BOM line 1) | 1 | pcs | 0 | Left hip | 1 | Seeed Studio | 12 | 1 | 228.0 | https://www.seeedstudio.com/STS3215-19kg-cm-7-4V-Serial-Servo-p-6338.html | bought |  | [U] Runtime IDs (WIRING.md section 2), CAD; model from wiring/netlist.yaml
S08 | Servos | Feetech STS3215 C001, ID 22, left hip pitch | 7.4 V 1:345; ships with 1 horn set, 1 x 15 cm 5264 cable and a screw bag (BOM line 1) | 1 | pcs | 0 | Left hip bracket | 1 | Seeed Studio | 12 | 1 | 228.0 | https://www.seeedstudio.com/STS3215-19kg-cm-7-4V-Serial-Servo-p-6338.html | bought |  | [U] Runtime IDs (WIRING.md section 2), CAD; model from wiring/netlist.yaml
S09 | Servos | Feetech STS3250-C002, ID 23, left knee | 50 kg.cm, same outline, 25T horn and 5264 ports as the C001 (BOM line 1b, D32) | 1 | pcs | 0 | Left thigh | 1b | OpenELAB | 2 | 1 | 147.98 | https://openelab.com/products/feetech-sts3250-c002-servo-12v | bought |  | [U] Runtime IDs (WIRING.md section 2), CAD; model from wiring/netlist.yaml
S10 | Servos | Feetech STS3215 C001, ID 24, left ankle | 7.4 V 1:345; ships with 1 horn set, 1 x 15 cm 5264 cable and a screw bag (BOM line 1) | 1 | pcs | 0 | Left shin | 1 | Seeed Studio | 12 | 1 | 228.0 | https://www.seeedstudio.com/STS3215-19kg-cm-7-4V-Serial-Servo-p-6338.html | bought |  | [U] Runtime IDs (WIRING.md section 2), CAD; model from wiring/netlist.yaml
S11 | Servos | Feetech STS3215 C001, ID 30, neck pitch | 7.4 V 1:345; ships with 1 horn set, 1 x 15 cm 5264 cable and a screw bag (BOM line 1) | 1 | pcs | 0 | Trunk | 1 | Seeed Studio | 12 | 1 | 228.0 | https://www.seeedstudio.com/STS3215-19kg-cm-7-4V-Serial-Servo-p-6338.html | bought |  | [U] Runtime IDs (WIRING.md section 2), CAD; model from wiring/netlist.yaml
S12 | Servos | Feetech STS3215 C001, ID 31, head pitch | 7.4 V 1:345; ships with 1 horn set, 1 x 15 cm 5264 cable and a screw bag (BOM line 1) | 1 | pcs | 0 | Neck | 1 | Seeed Studio | 12 | 1 | 228.0 | https://www.seeedstudio.com/STS3215-19kg-cm-7-4V-Serial-Servo-p-6338.html | bought |  | [U] Runtime IDs (WIRING.md section 2), CAD; model from wiring/netlist.yaml
S13 | Servos | Feetech STS3215 C001, ID 32, head yaw | 7.4 V 1:345; ships with 1 horn set, 1 x 15 cm 5264 cable and a screw bag (BOM line 1) | 1 | pcs | 0 | Neck | 1 | Seeed Studio | 12 | 1 | 228.0 | https://www.seeedstudio.com/STS3215-19kg-cm-7-4V-Serial-Servo-p-6338.html | bought |  | [U] Runtime IDs (WIRING.md section 2), CAD; model from wiring/netlist.yaml
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
