aaltaay/Open_Duck_Mini_v2/altaay_lab/twin/dock/nest/cad/nest_assembly_new_parts.stl

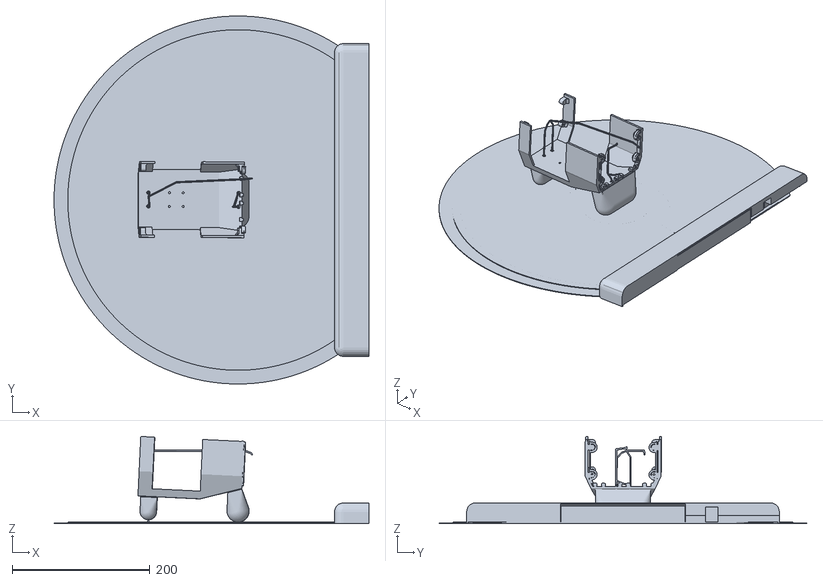
[picture p77: CAD file, 2026-11-12]
altaay_lab/twin/dock/nest/cad/nest_assembly_new_parts.stl
457.0 x 534.0 x 126.4
