aaltaay/Open_Duck_Mini_v2/altaay_lab/cad/nest_v2/step/stripe_plus.step

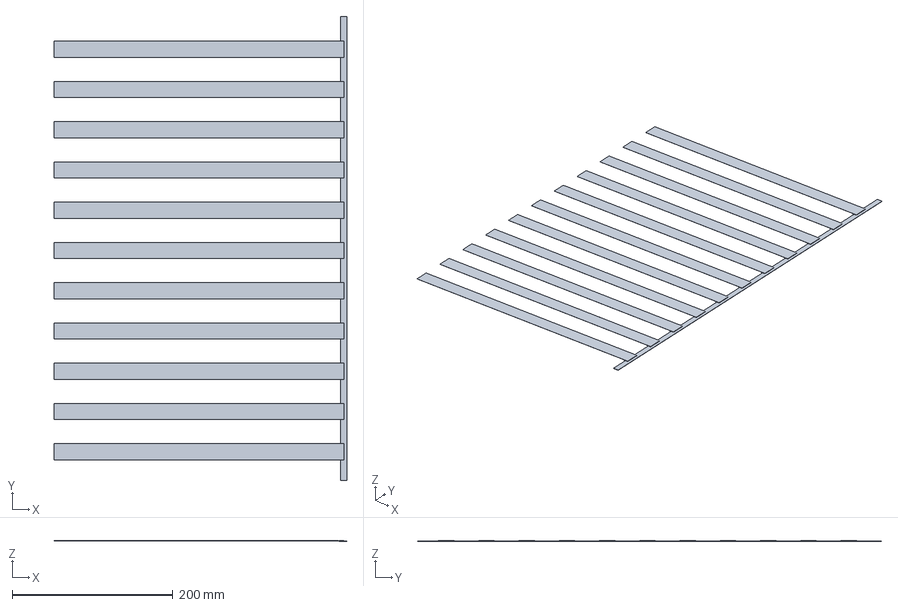
[picture p78: CAD file, 2026-11-12]
altaay_lab/cad/nest_v2/step/stripe_plus.step
364.0 x 577.0 x 1.00 mm
