aaltaay/Open_Duck_Mini_v2/altaay_lab/twin/assembly/button_plate_d30.stl

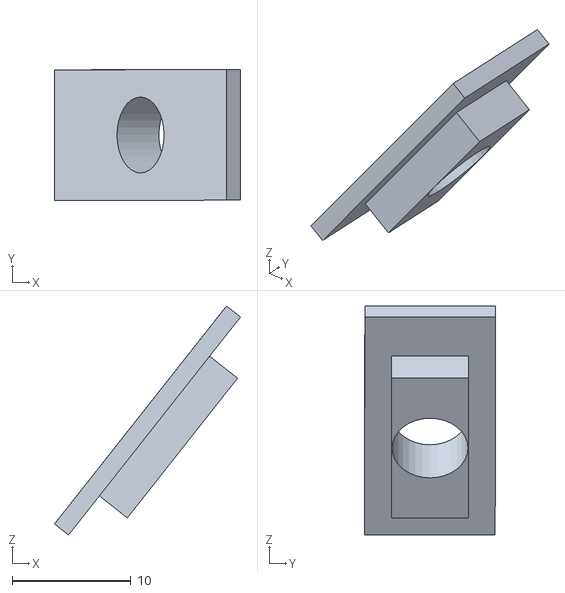
[picture p79: CAD file, 2026-11-04]
altaay_lab/twin/assembly/button_plate_d30.stl
15.7 x 11.0 x 19.3
