aaltaay/Open_Duck_Mini_v2/altaay_lab/twin/companion/stl/head.stl

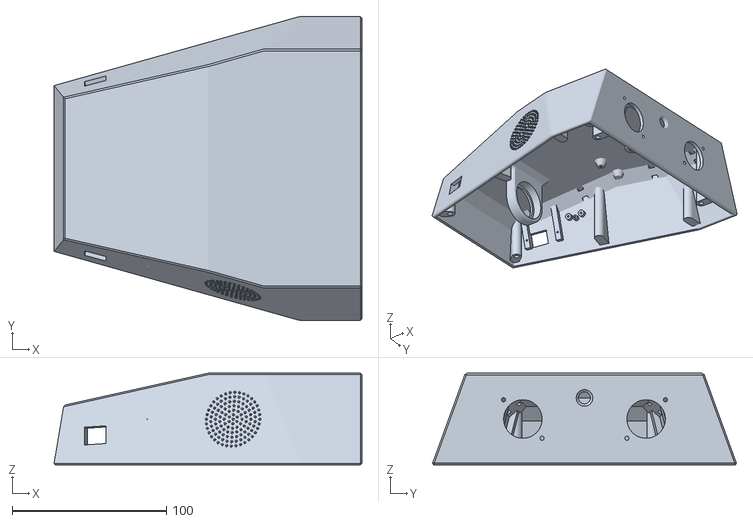
[picture p80: CAD file, 2026-11-06]
altaay_lab/twin/companion/stl/head.stl
199.8 x 197.3 x 59.4
