aaltaay/Open_Duck_Mini_v2/altaay_lab/twin/dock/nest/cad/step/pin_gauge.step

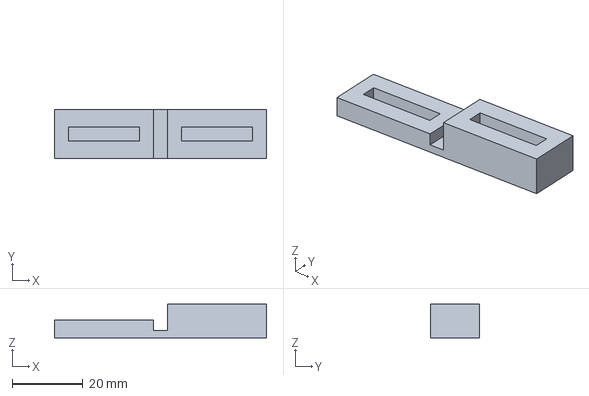
[picture p81: CAD file, 2026-11-12]
altaay_lab/twin/dock/nest/cad/step/pin_gauge.step
60.0 x 14.0 x 9.50 mm
