aaltaay/Open_Duck_Mini_v2/altaay_lab/twin/dock/nest/cad/stl/nest_box_tray.stl

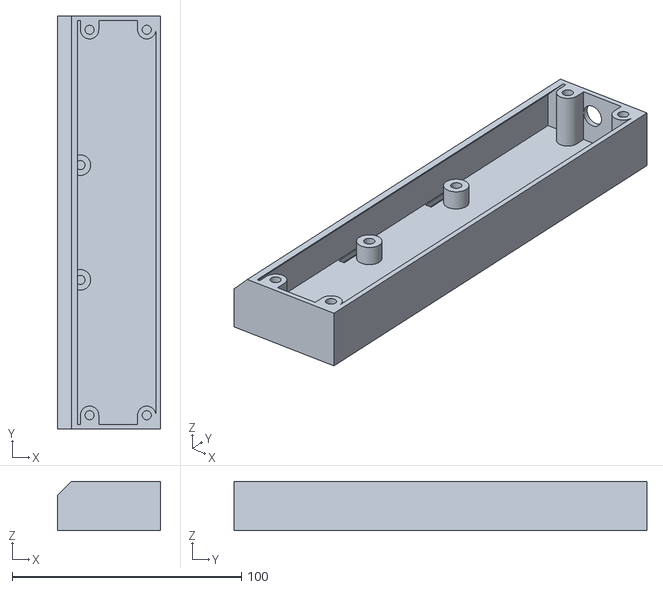
[picture p82: CAD file, 2026-11-12]
altaay_lab/twin/dock/nest/cad/stl/nest_box_tray.stl
44.9 x 180.0 x 21.5
