aaltaay/Open_Duck_Mini_v2/altaay_lab/twin/dock/stl/dock_spring_carriage.stl

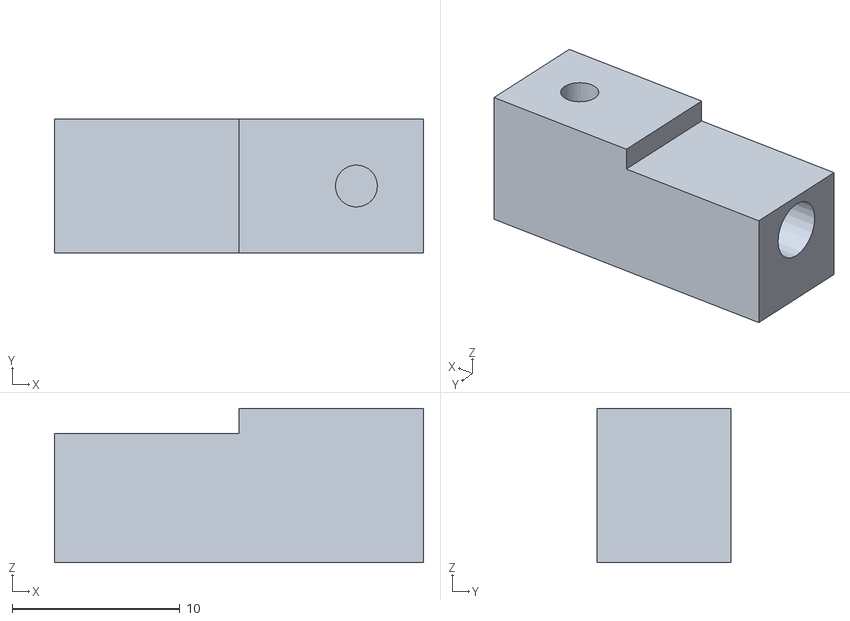
[picture p83: CAD file, 2026-11-06]
altaay_lab/twin/dock/stl/dock_spring_carriage.stl
22.0 x 8.00 x 9.20
