aaltaay/Open_Duck_Mini_v2/altaay_lab/twin/structure/topology/stl/knee_to_ankle_left_sheet.stl

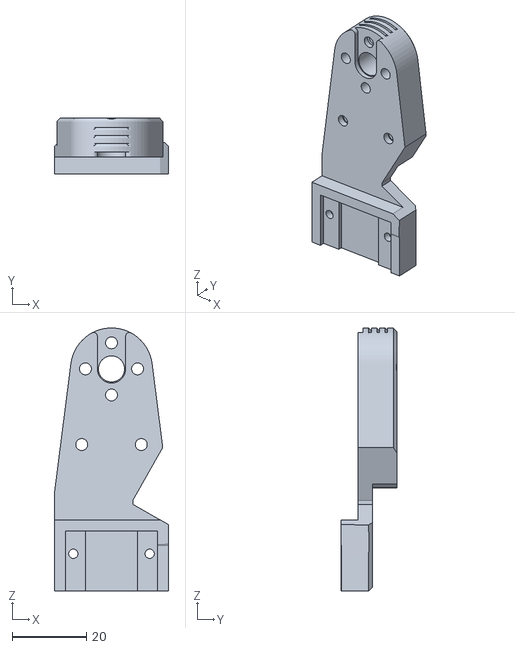
[picture p85: CAD file, 2026-11-12]
altaay_lab/twin/structure/topology/stl/knee_to_ankle_left_sheet.stl
30.7 x 15.0 x 70.6
