aaltaay/Open_Duck_Mini_v2/altaay_lab/twin/structure/topology/stl_topo/foot_top.stl

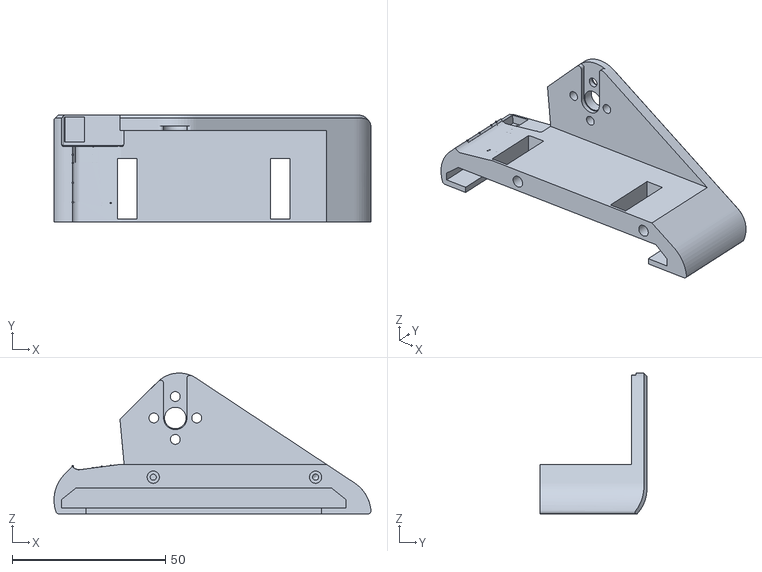
[picture p86: CAD file, 2026-11-12]
altaay_lab/twin/structure/topology/stl_topo/foot_top.stl
103.5 x 34.9 x 46.0
