aaltaay/Open_Duck_Mini_v2/mini_bdx/robots/open_duck_mini_v2/left_roll_to_pitch.stl

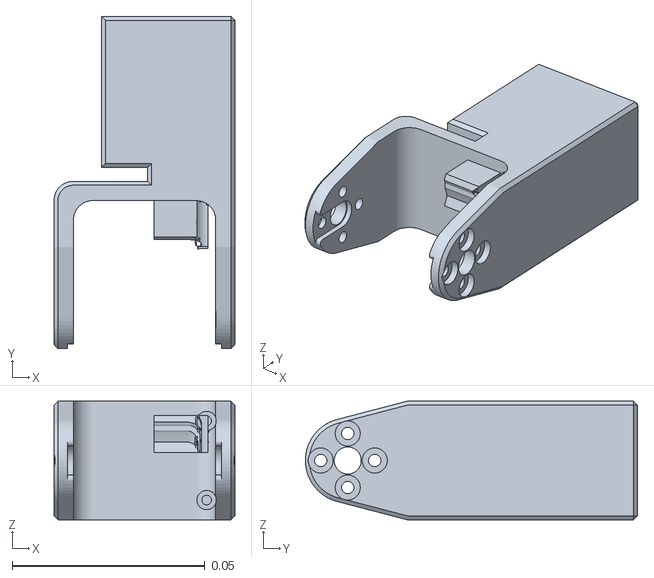
[picture p87: CAD file, 2026-11-10]
mini_bdx/robots/open_duck_mini_v2/left_roll_to_pitch.stl
0.0469 x 0.0861 x 0.0307
