aaltaay/Open_Duck_Mini_v2/print/body_back.stl

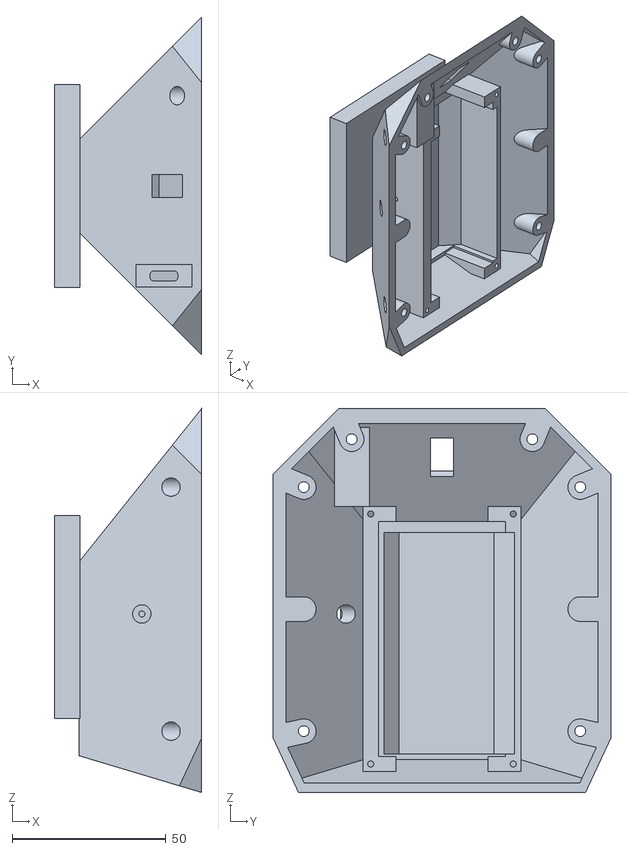
[picture p88: CAD file, 2026-11-14]
print/body_back.stl
48.0 x 110.0 x 125.0
