aaltaay/Open_Duck_Mini_v2/altaay_lab/cad/nest_v2/step/felt_top.step

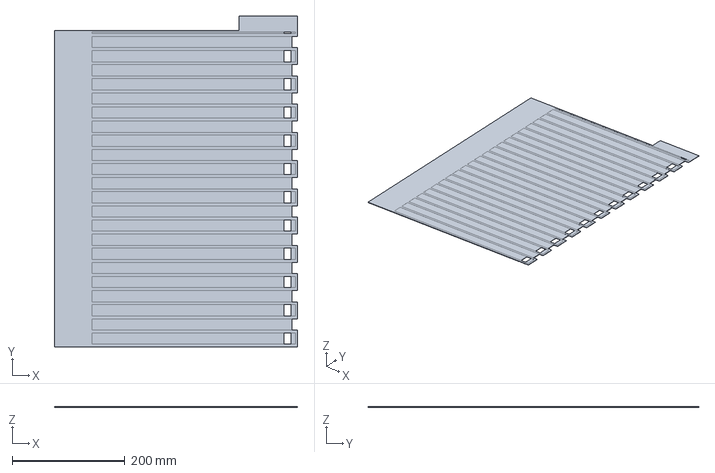
[picture p89: CAD file, 2026-11-12]
altaay_lab/cad/nest_v2/step/felt_top.step
431.0 x 586.0 x 1.00 mm
