aaltaay/Open_Duck_Mini_v2/altaay_lab/twin/dock/nest/cad/step/nest_bolster_right.step

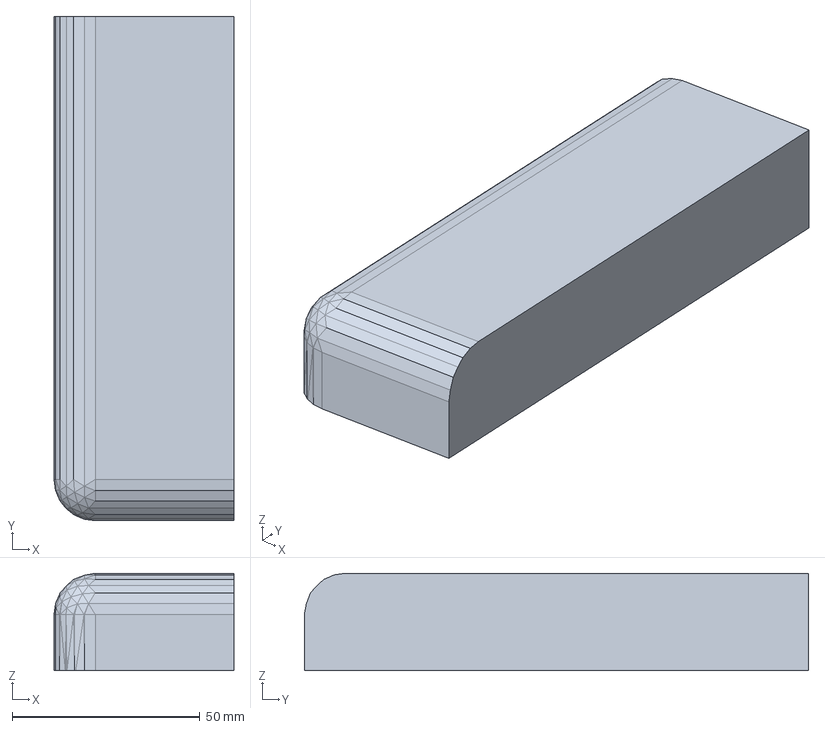
[picture p90: CAD file, 2026-11-12]
altaay_lab/twin/dock/nest/cad/step/nest_bolster_right.step
48.0 x 134.5 x 26.0 mm
