aaltaay/Open_Duck_Mini_v2/altaay_lab/twin/dock/nest/cad/stl/body_middle_bottom_feedthroughs.stl

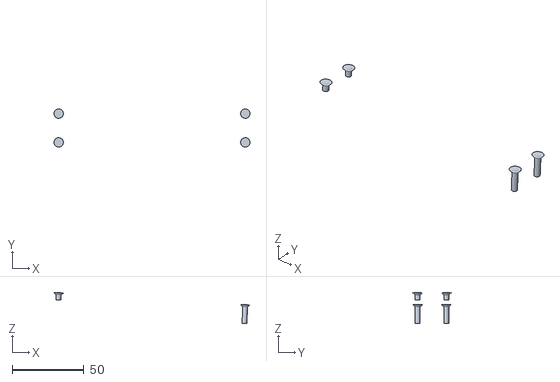
[picture p91: CAD file, 2026-11-12]
altaay_lab/twin/dock/nest/cad/stl/body_middle_bottom_feedthroughs.stl
136.5 x 26.6 x 21.6
