aaltaay/Open_Duck_Mini_v2/altaay_lab/twin/dock/stl/dock_column_r3.stl

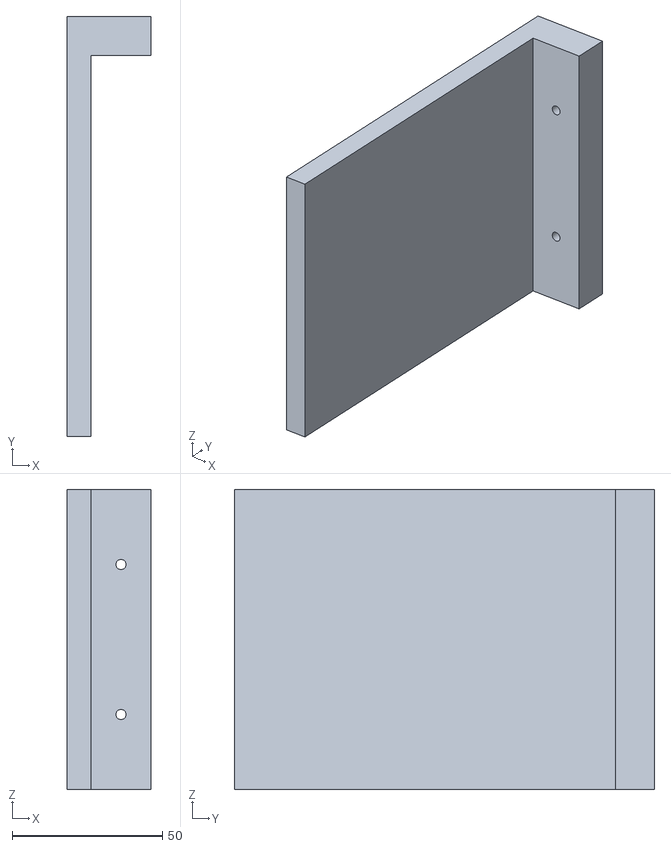
[picture p92: CAD file, 2026-11-06]
altaay_lab/twin/dock/stl/dock_column_r3.stl
28.0 x 140.0 x 100.0
