aaltaay/Open_Duck_Mini_v2/altaay_lab/twin/structure/shin_eye/stl/shin_left_sheet_taper_cbore.stl

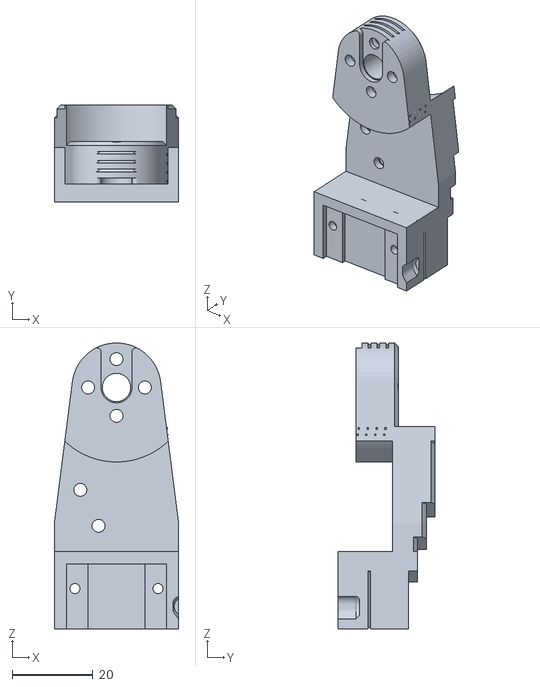
[picture p93: CAD file, 2026-11-12]
altaay_lab/twin/structure/shin_eye/stl/shin_left_sheet_taper_cbore.stl
30.7 x 24.1 x 70.6
