aaltaay/Open_Duck_Mini_v2/print/shin_right_sheet.stl

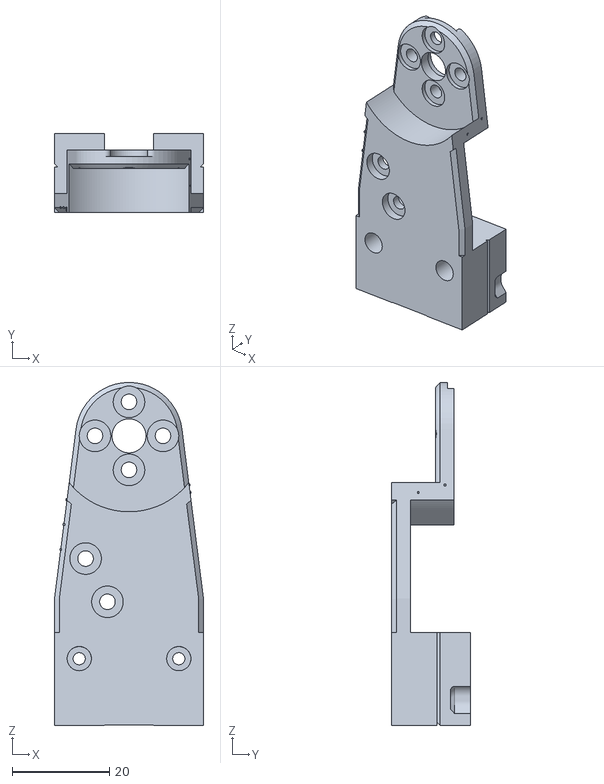
[picture p96: CAD file, 2026-11-10]
print/shin_right_sheet.stl
30.7 x 16.2 x 70.6
