aaltaay/Open_Duck_Mini_v2/altaay_lab/cad/nest_v2/step/cord_cap.step

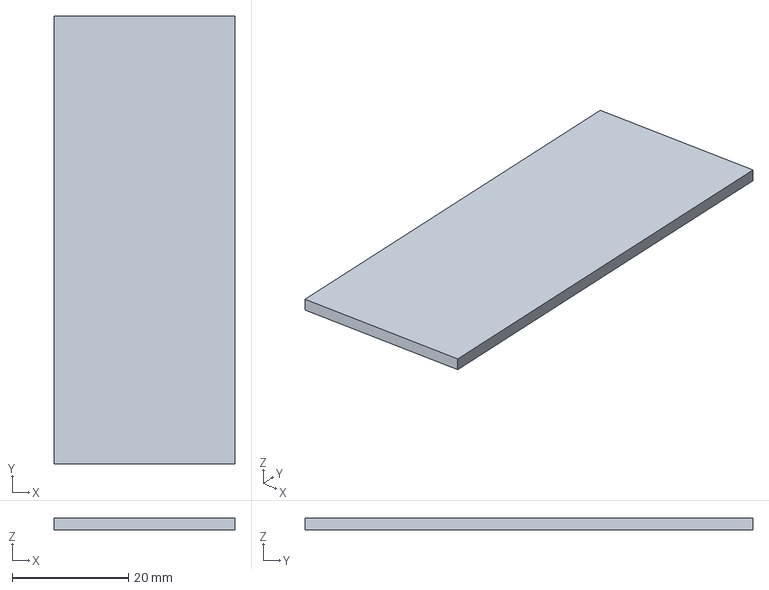
[picture p97: CAD file, 2026-11-12]
altaay_lab/cad/nest_v2/step/cord_cap.step
31.2 x 77.2 x 2.00 mm
