aaltaay/Open_Duck_Mini_v2/altaay_lab/twin/dock/nest/cad/step/nest_felt_base.step

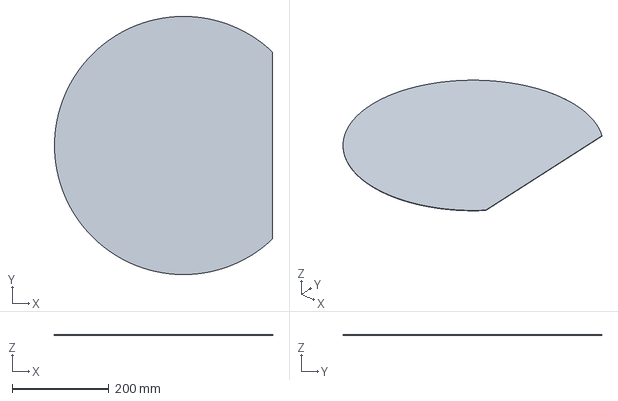
[picture p98: CAD file, 2026-11-12]
altaay_lab/twin/dock/nest/cad/step/nest_felt_base.step
451.0 x 534.0 x 1.00 mm
