aaltaay/Open_Duck_Mini_v2/altaay_lab/twin/dock/nest/cad/stl/body_middle_bottom.stl

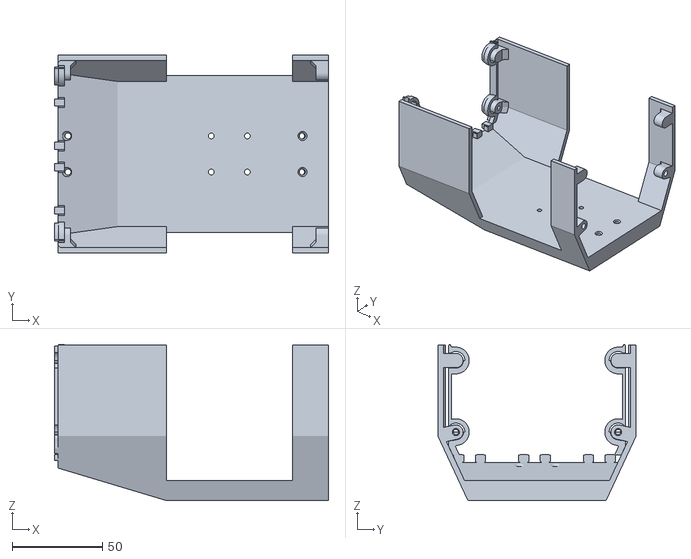
[picture p99: CAD file, 2026-11-12]
altaay_lab/twin/dock/nest/cad/stl/body_middle_bottom.stl
152.0 x 110.0 x 86.6
