aaltaay/Open_Duck_Mini_v2/altaay_lab/twin/dock/stl/dock_bay_lid.stl

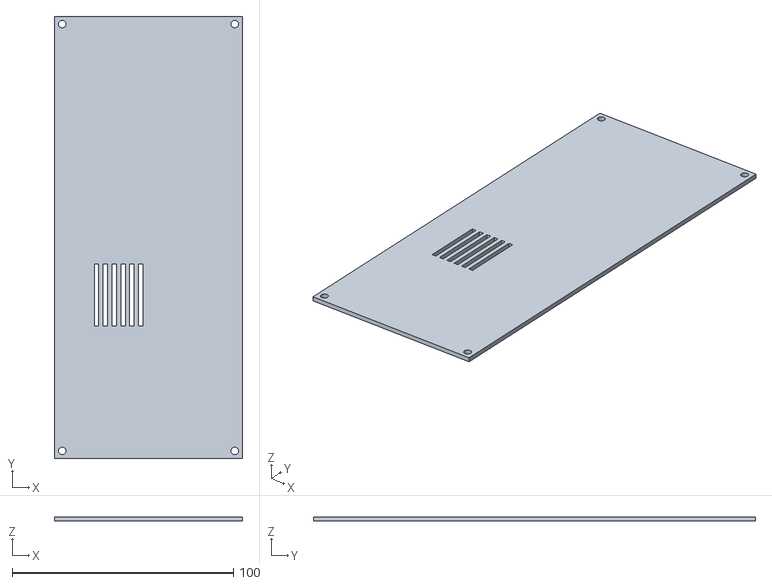
[picture p100: CAD file, 2026-11-06]
altaay_lab/twin/dock/stl/dock_bay_lid.stl
85.0 x 200.0 x 2.00
