aaltaay/Open_Duck_Mini_v2/altaay_lab/twin/structure/topology/stl/neck_left_sheet.stl

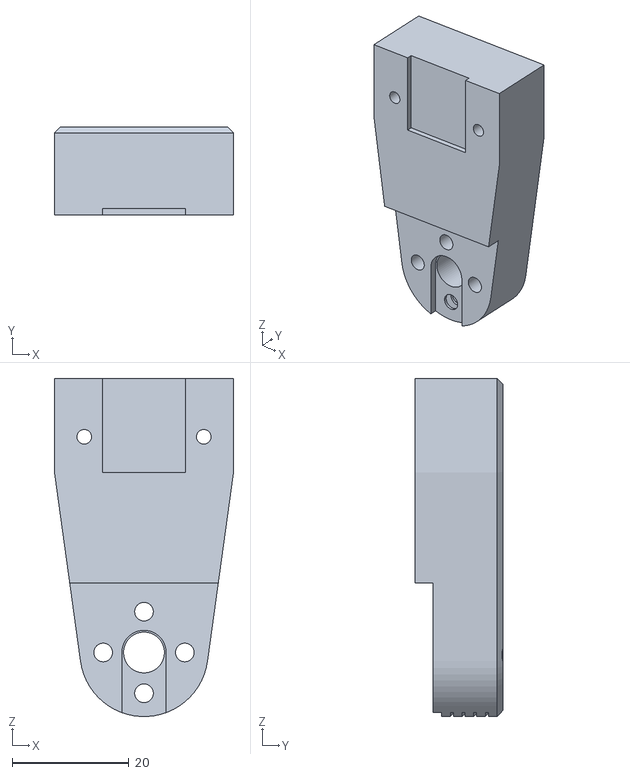
[picture p102: CAD file, 2026-11-12]
altaay_lab/twin/structure/topology/stl/neck_left_sheet.stl
30.7 x 15.1 x 58.0
