aaltaay/Open_Duck_Mini_v2/mini_bdx/robots/open_duck_mini_v2/knee_bumper.stl

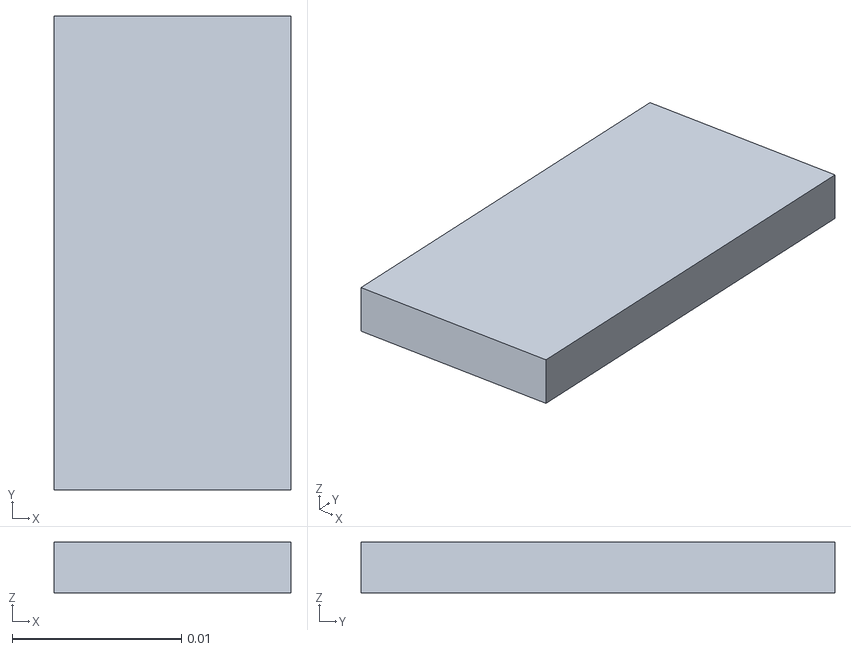
[picture p103: CAD file, 2026-11-10]
mini_bdx/robots/open_duck_mini_v2/knee_bumper.stl
0.014 x 0.028 x 0.003
