aaltaay/Open_Duck_Mini_v2/print/shin_spacer.stl

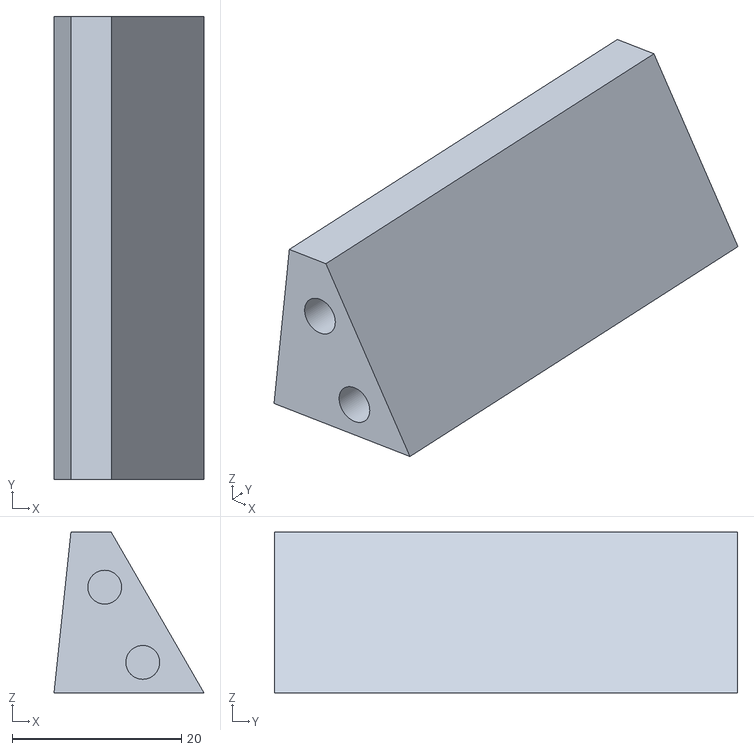
[picture p104: CAD file, 2026-11-10]
print/shin_spacer.stl
17.7 x 54.8 x 19.0
