aaltaay/Open_Duck_Mini_v2/altaay_lab/cad/nest_v2/step/seat_wells.step

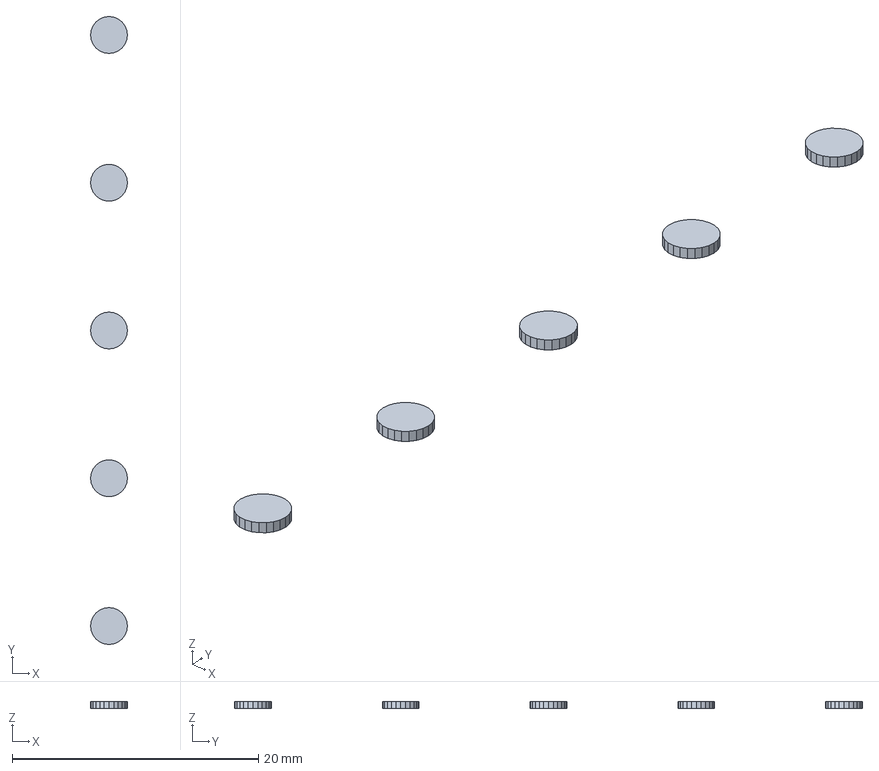
[picture p105: CAD file, 2026-11-12]
altaay_lab/cad/nest_v2/step/seat_wells.step
3.00 x 51.0 x 0.6 mm
