aaltaay/Open_Duck_Mini_v2/altaay_lab/twin/dock/nest/cad/step/nest_feed.step

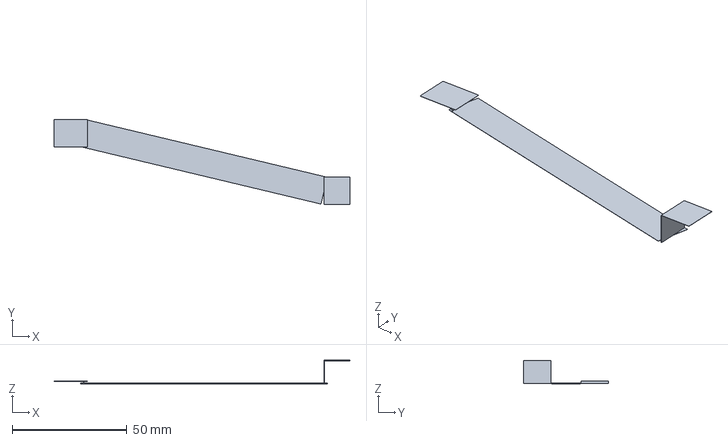
[picture p106: CAD file, 2026-11-12]
altaay_lab/twin/dock/nest/cad/step/nest_feed.step
129.0 x 37.0 x 10.1 mm
