aaltaay/Open_Duck_Mini_v2/altaay_lab/twin/dock/nest/cad/stl/sit_bumper.stl

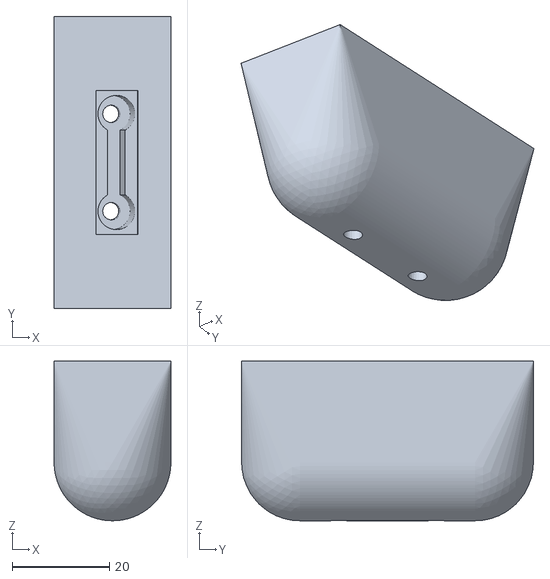
[picture p107: CAD file, 2026-11-12]
altaay_lab/twin/dock/nest/cad/stl/sit_bumper.stl
24.0 x 60.0 x 32.8
