aaltaay/Open_Duck_Mini_v2/altaay_lab/twin/dock/stl/dock_seat_base.stl

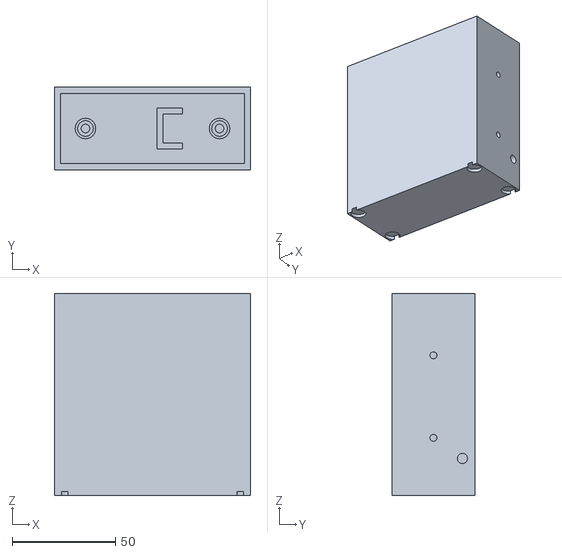
[picture p108: CAD file, 2026-11-06]
altaay_lab/twin/dock/stl/dock_seat_base.stl
95.0 x 40.0 x 98.0
