aaltaay/Open_Duck_Mini_v2/altaay_lab/twin/structure/topology/stl/neck_right_sheet.stl

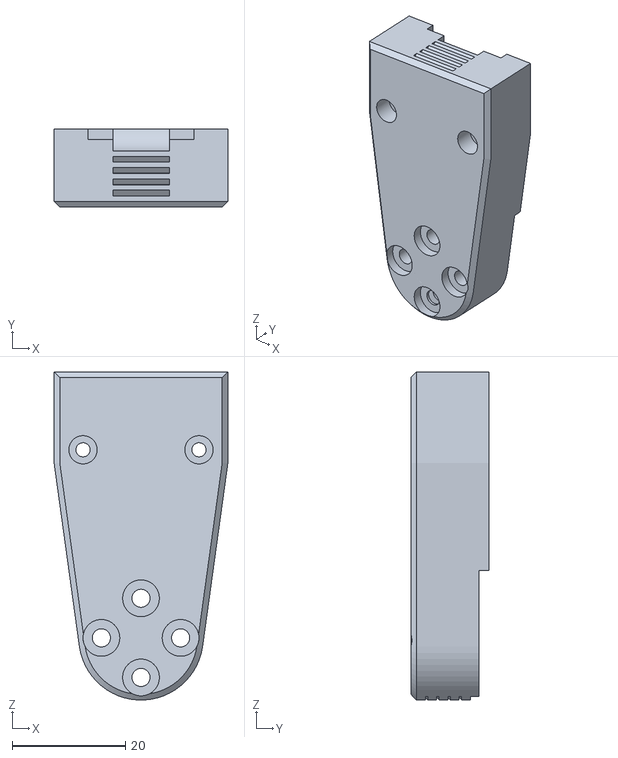
[picture p110: CAD file, 2026-11-12]
altaay_lab/twin/structure/topology/stl/neck_right_sheet.stl
30.7 x 13.8 x 58.0
