aaltaay/Open_Duck_Mini_v2/mini_bdx/robots/open_duck_mini_v2/roll_pad_left.stl

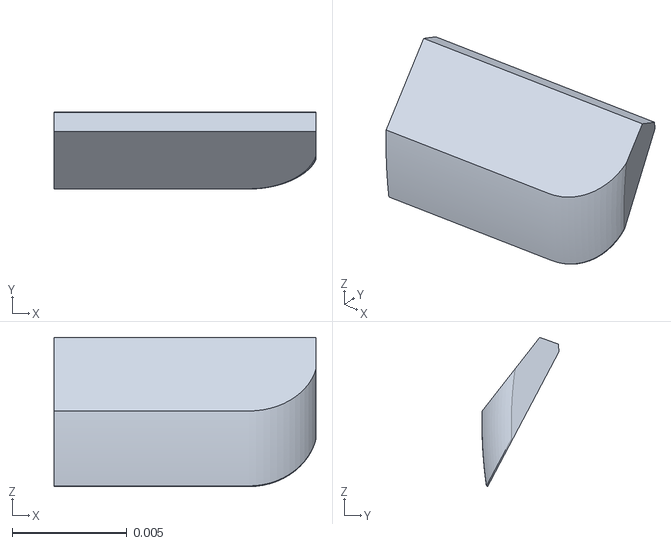
[picture p111: CAD file, 2026-11-10]
mini_bdx/robots/open_duck_mini_v2/roll_pad_left.stl
0.0114 x 0.00336 x 0.00651
