aaltaay/Open_Duck_Mini_v2/print/head_pitch_to_yaw.stl

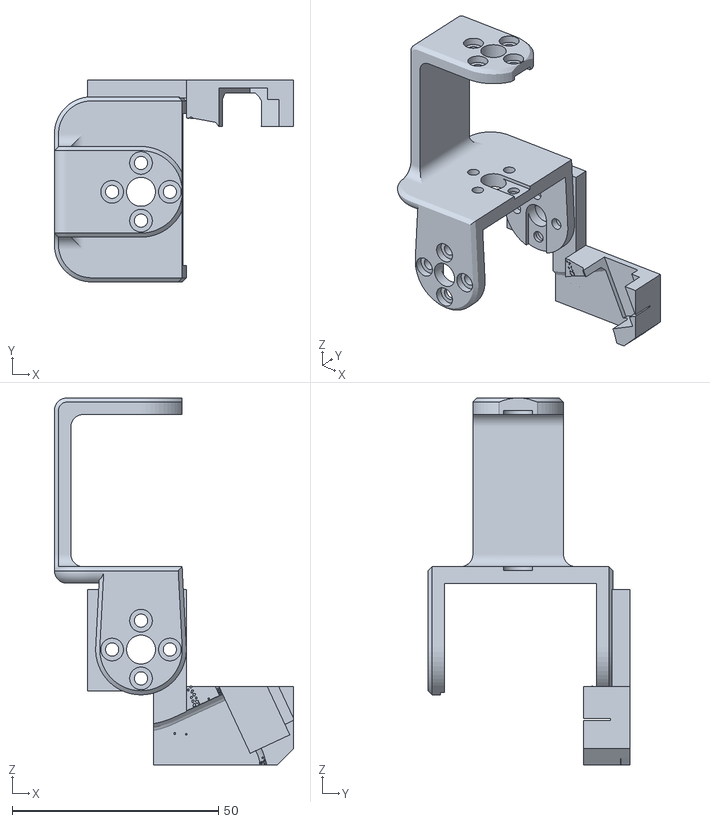
[picture p112: CAD file, 2026-11-10]
print/head_pitch_to_yaw.stl
58.0 x 48.9 x 89.0
