aaltaay/Open_Duck_Mini_v2/altaay_lab/cad/nest_v2/step/felt_base.step

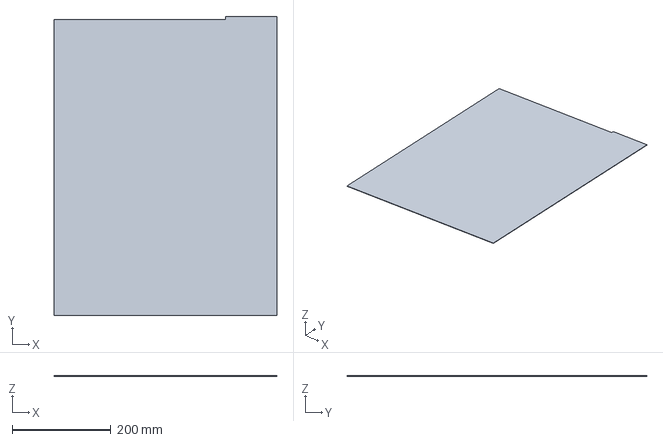
[picture p113: CAD file, 2026-11-12]
altaay_lab/cad/nest_v2/step/felt_base.step
451.0 x 606.0 x 1.00 mm
