aaltaay/Open_Duck_Mini_v2/altaay_lab/twin/dock/nest/cad/step/nest_sun_foil.step

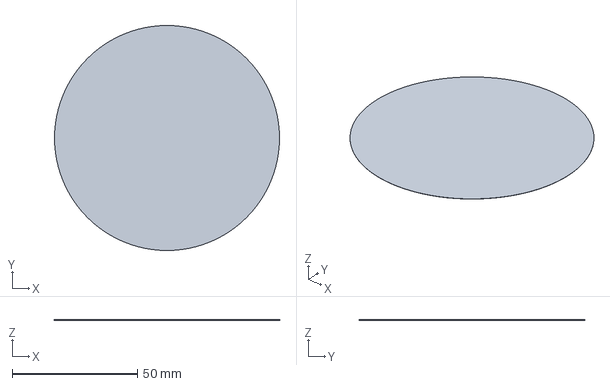
[picture p114: CAD file, 2026-11-12]
altaay_lab/twin/dock/nest/cad/step/nest_sun_foil.step
90.0 x 90.0 x 0.07 mm
