aaltaay/Open_Duck_Mini_v2/altaay_lab/twin/dock/nest/cad/stl/sit_seat.stl

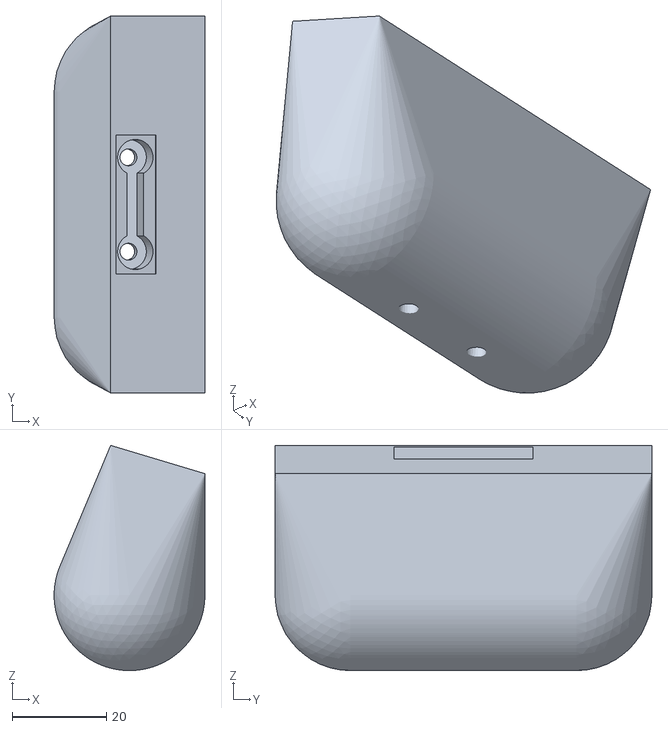
[picture p115: CAD file, 2026-11-12]
altaay_lab/twin/dock/nest/cad/stl/sit_seat.stl
32.0 x 80.0 x 47.8
