aaltaay/Open_Duck_Mini_v2/altaay_lab/twin/dock/stl/dock_bay_tray.stl

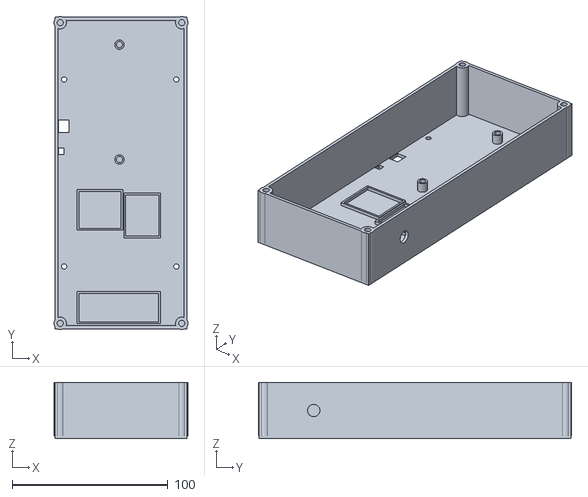
[picture p116: CAD file, 2026-11-06]
altaay_lab/twin/dock/stl/dock_bay_tray.stl
86.0 x 201.0 x 36.0
