aaltaay/Open_Duck_Mini_v2/mini_bdx/robots/open_duck_mini_v2/left_cache.stl

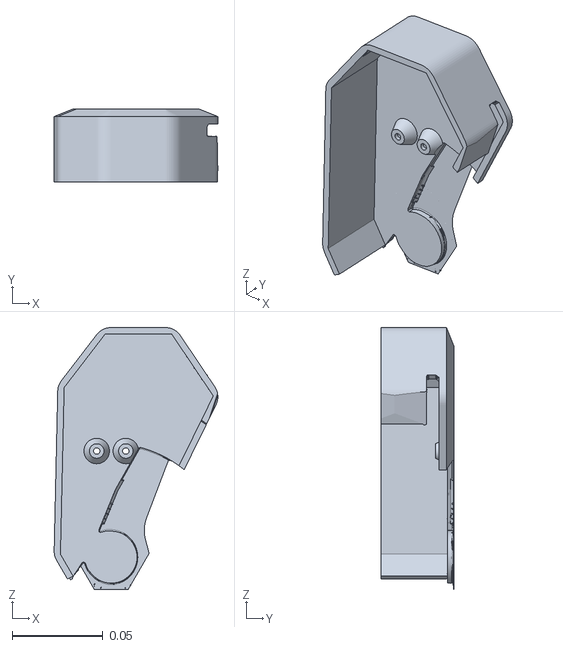
[picture p119: CAD file, 2026-11-10]
mini_bdx/robots/open_duck_mini_v2/left_cache.stl
0.09 x 0.0402 x 0.144
