aaltaay/Open_Duck_Mini_v2/print/neck_stop.stl

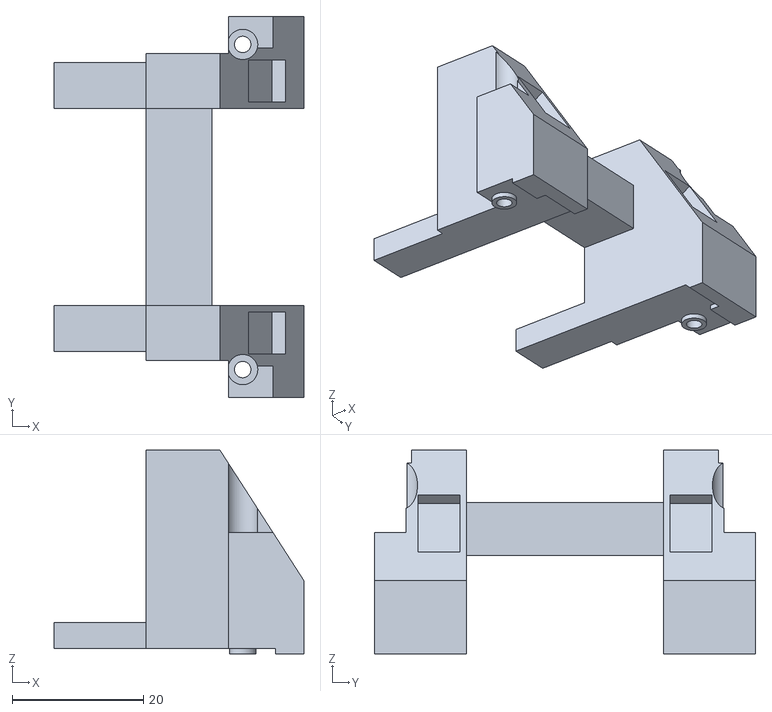
[picture p120: CAD file, 2026-11-10]
print/neck_stop.stl
38.0 x 58.0 x 31.0
