aaltaay/Open_Duck_Mini_v2/altaay_lab/twin/dock/stl/dock_paddle.stl

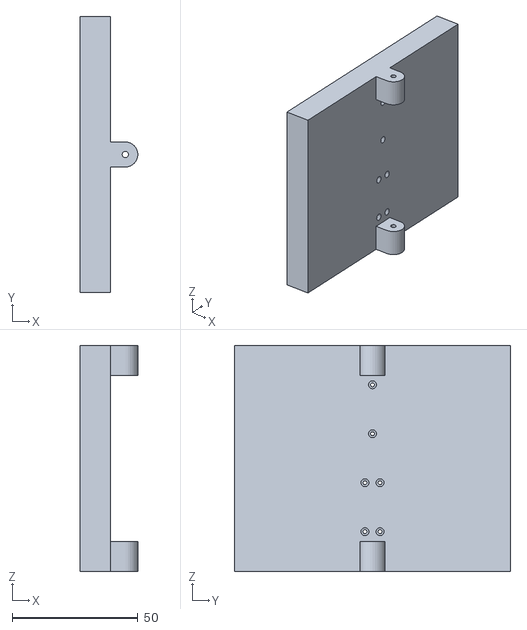
[picture p122: CAD file, 2026-11-06]
altaay_lab/twin/dock/stl/dock_paddle.stl
23.0 x 110.0 x 90.0
