aaltaay/Open_Duck_Mini_v2/altaay_lab/twin/structure/topology/stl/right_roll_to_pitch.stl

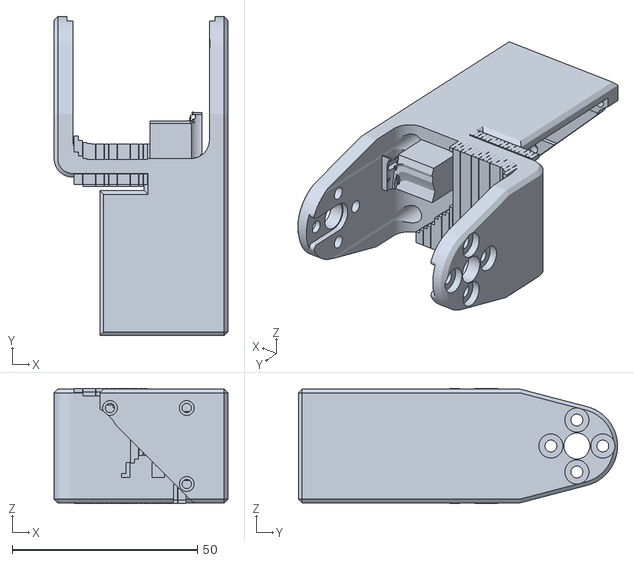
[picture p123: CAD file, 2026-11-12]
altaay_lab/twin/structure/topology/stl/right_roll_to_pitch.stl
46.9 x 86.1 x 31.1
