aaltaay/Open_Duck_Mini_v2/print/foot_side.stl

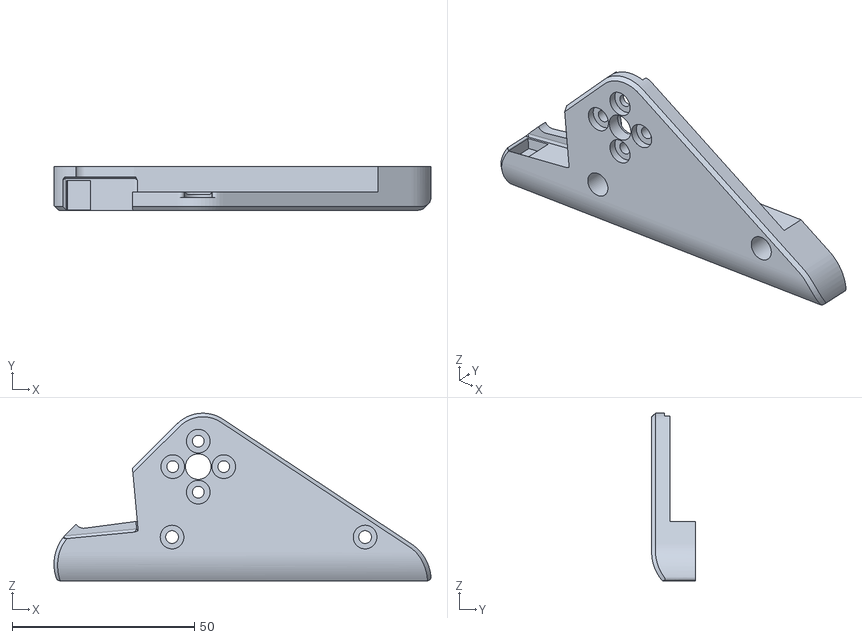
[picture p124: CAD file, 2026-11-10]
print/foot_side.stl
103.5 x 12.0 x 46.0
