aaltaay/Open_Duck_Mini_v2/altaay_lab/cad/nest_v2/step/cord_pocket.step

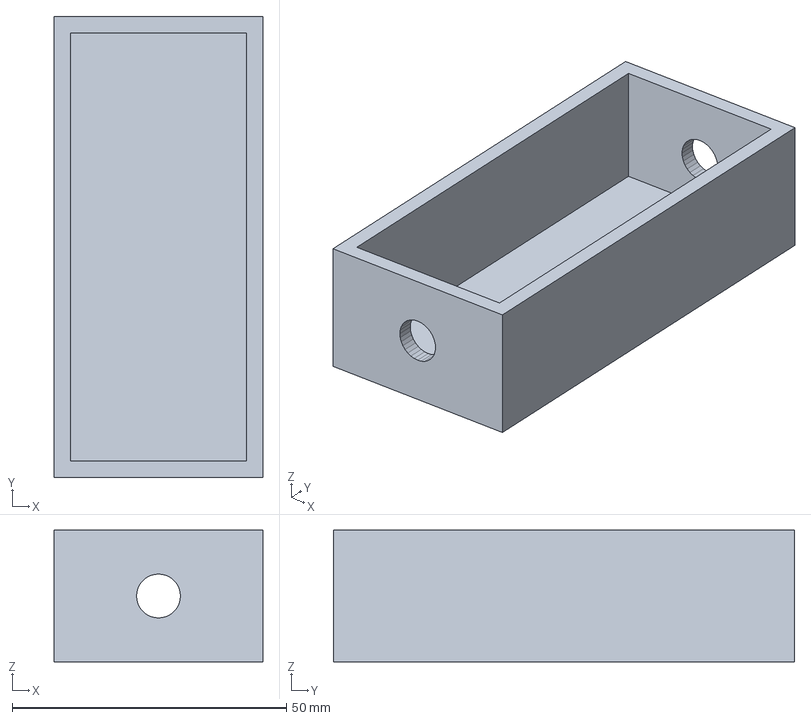
[picture p125: CAD file, 2026-11-12]
altaay_lab/cad/nest_v2/step/cord_pocket.step
38.0 x 84.0 x 24.0 mm
