aaltaay/Open_Duck_Mini_v2/altaay_lab/twin/dock/nest/cad/step/nest_box_lid.step

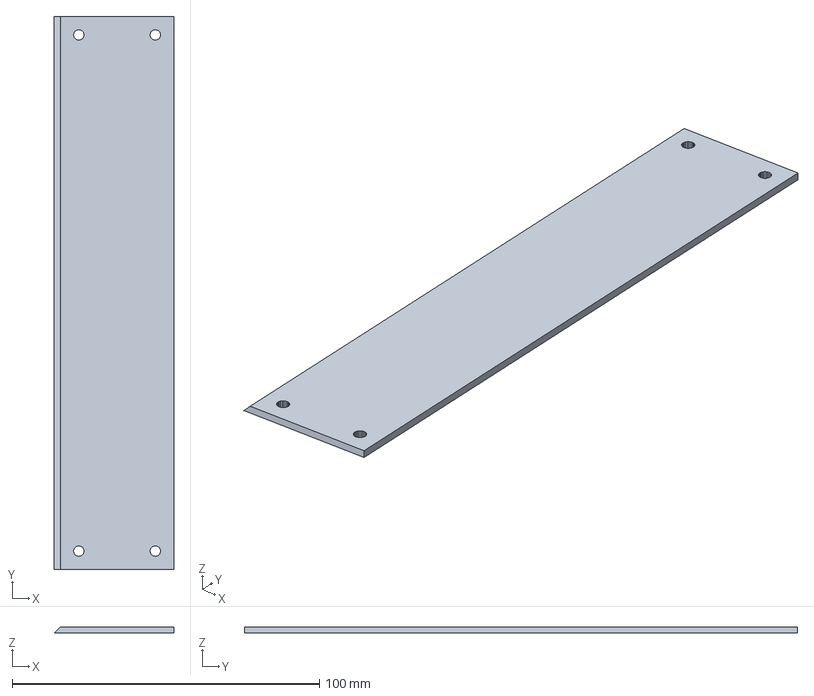
[picture p126: CAD file, 2026-11-12]
altaay_lab/twin/dock/nest/cad/step/nest_box_lid.step
38.9 x 180.0 x 2.00 mm
