aaltaay/Open_Duck_Mini_v2/altaay_lab/twin/dock/stl/dock_spring_cup.stl

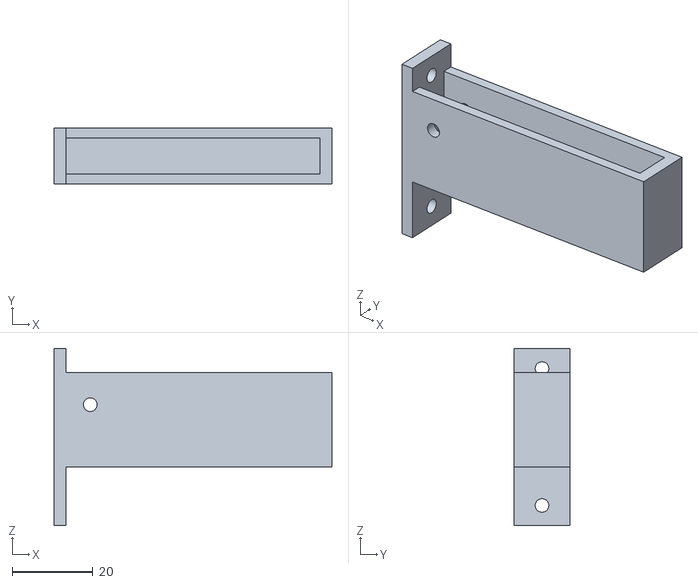
[picture p127: CAD file, 2026-11-06]
altaay_lab/twin/dock/stl/dock_spring_cup.stl
69.0 x 14.0 x 44.0
