aaltaay/Open_Duck_Mini_v2/altaay_lab/twin/structure/topology/stl/shin_left_sheet.stl

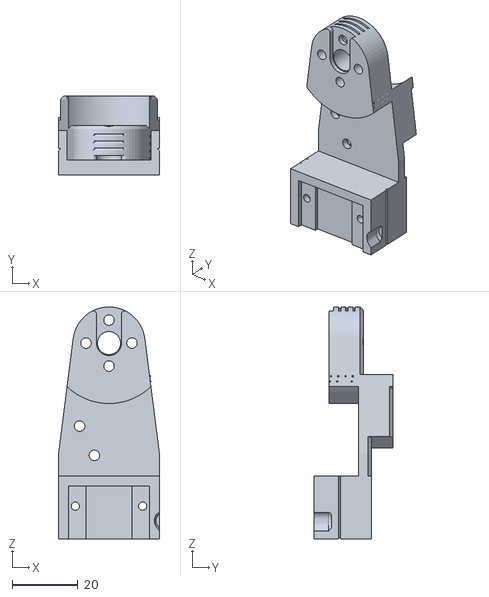
[picture p128: CAD file, 2026-11-12]
altaay_lab/twin/structure/topology/stl/shin_left_sheet.stl
30.7 x 24.1 x 70.6
