aaltaay/Open_Duck_Mini_v2/print/sit_seat.stl

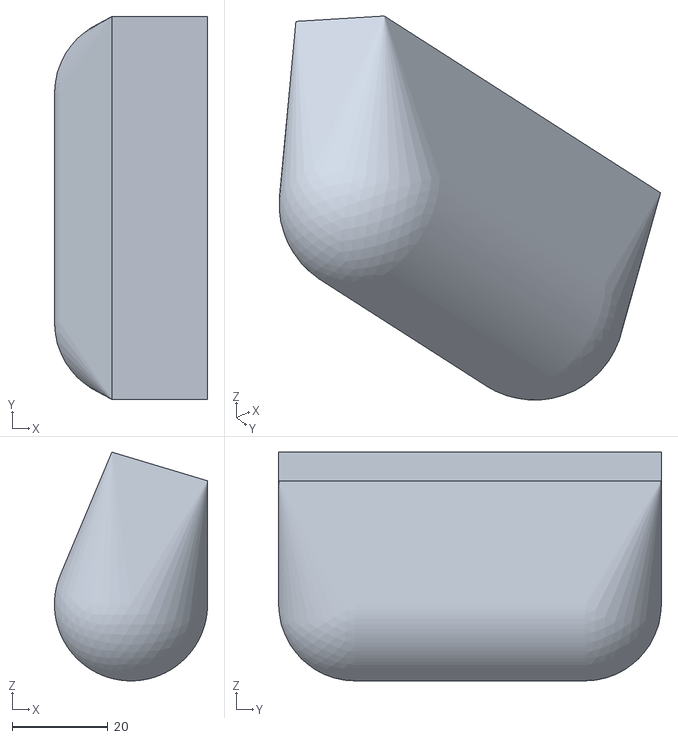
[picture p130: CAD file, 2026-11-10]
print/sit_seat.stl
32.0 x 80.0 x 47.8
