aaltaay/Open_Duck_Mini_v2/altaay_lab/cad/nest_v2/step/wall_card.step

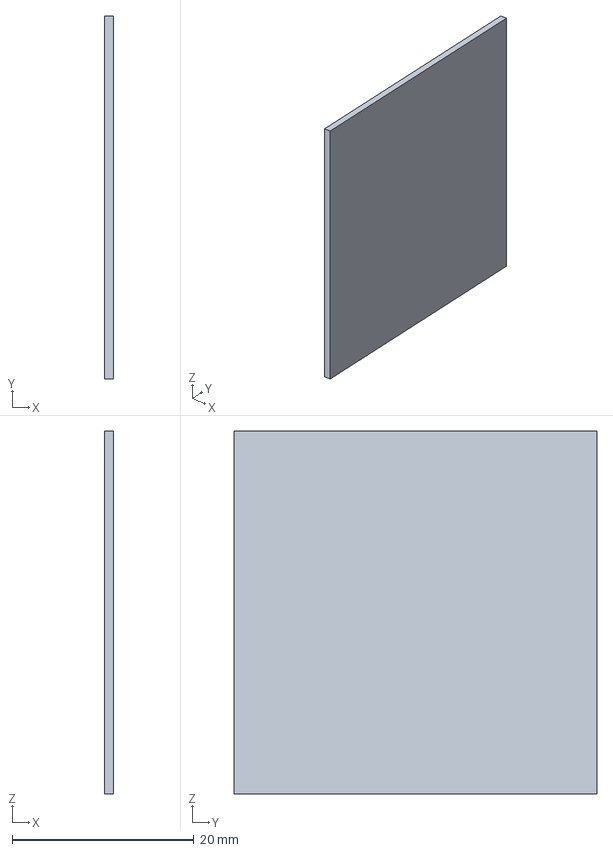
[picture p131: CAD file, 2026-11-12]
altaay_lab/cad/nest_v2/step/wall_card.step
1.00 x 40.0 x 40.0 mm
