aaltaay/Open_Duck_Mini_v2/altaay_lab/twin/dock/nest/cad/step/nest_sun.step

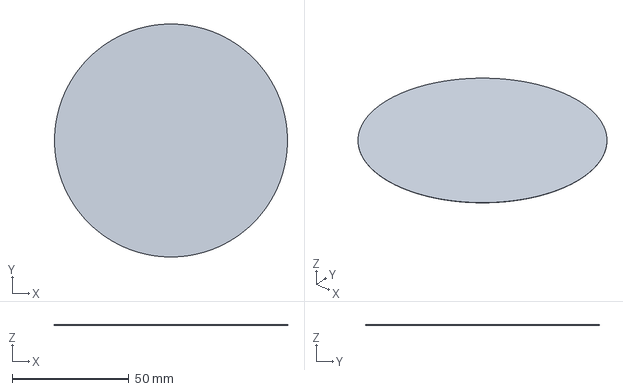
[picture p132: CAD file, 2026-11-12]
altaay_lab/twin/dock/nest/cad/step/nest_sun.step
100.0 x 100.0 x 0.1 mm
