aaltaay/Open_Duck_Mini_v2/altaay_lab/twin/dock/stl/dock_column_l2.stl

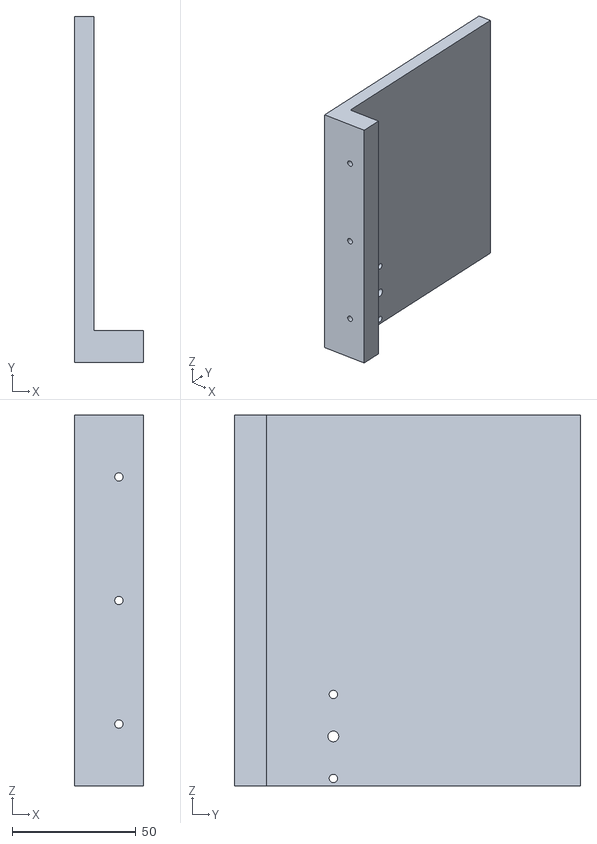
[picture p133: CAD file, 2026-11-06]
altaay_lab/twin/dock/stl/dock_column_l2.stl
28.0 x 140.0 x 150.0
