aaltaay/Open_Duck_Mini_v2/mini_bdx/robots/open_duck_mini_v2/foot_top.stl

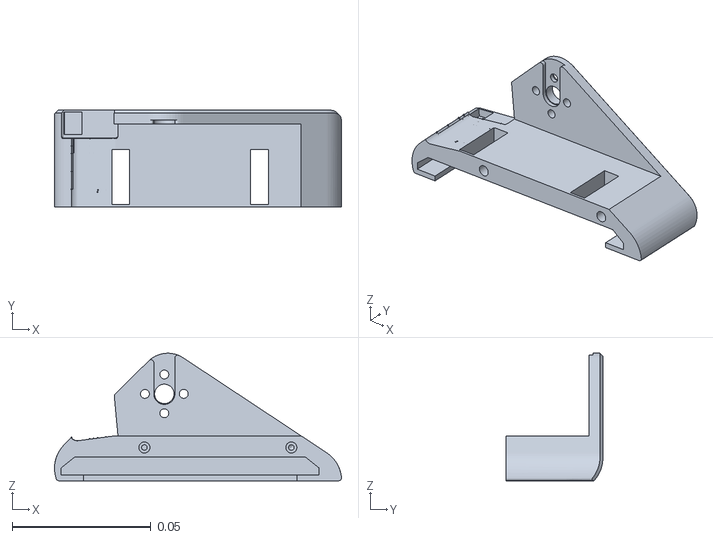
[picture p134: CAD file, 2026-11-10]
mini_bdx/robots/open_duck_mini_v2/foot_top.stl
0.103 x 0.0349 x 0.046
