aaltaay/Open_Duck_Mini_v2/print/right_roll_to_pitch.stl

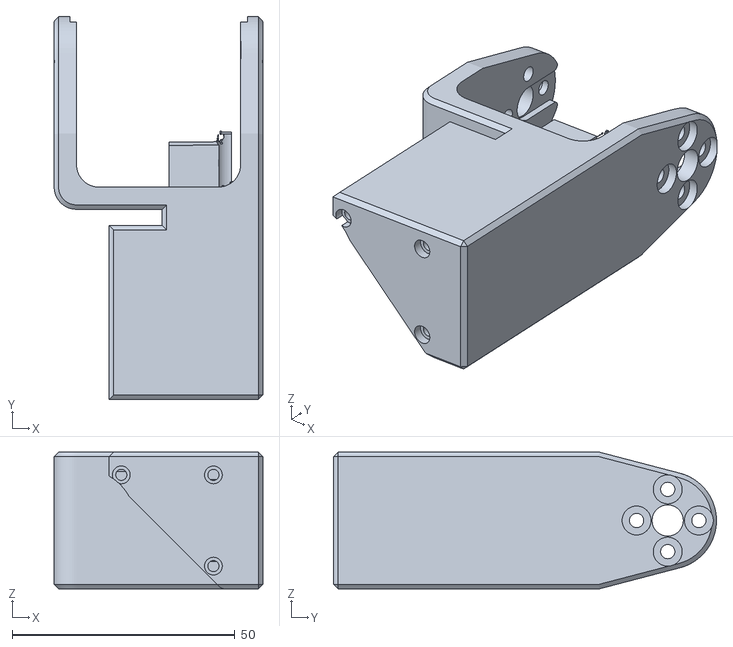
[picture p135: CAD file, 2026-11-10]
print/right_roll_to_pitch.stl
46.9 x 86.1 x 30.7
