aaltaay/Open_Duck_Mini_v2/altaay_lab/twin/dock/nest/cad/step/nest_rim_cover.step

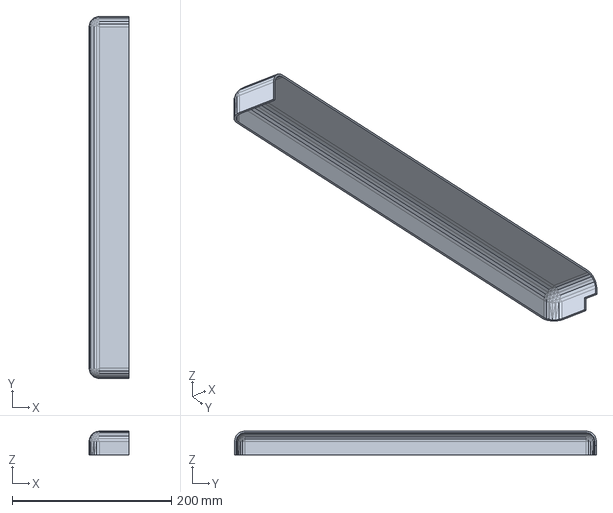
[picture p136: CAD file, 2026-11-12]
altaay_lab/twin/dock/nest/cad/step/nest_rim_cover.step
50.0 x 454.0 x 30.0 mm
