aaltaay/Open_Duck_Mini_v2/altaay_lab/twin/dock/stl/dock_spine.stl

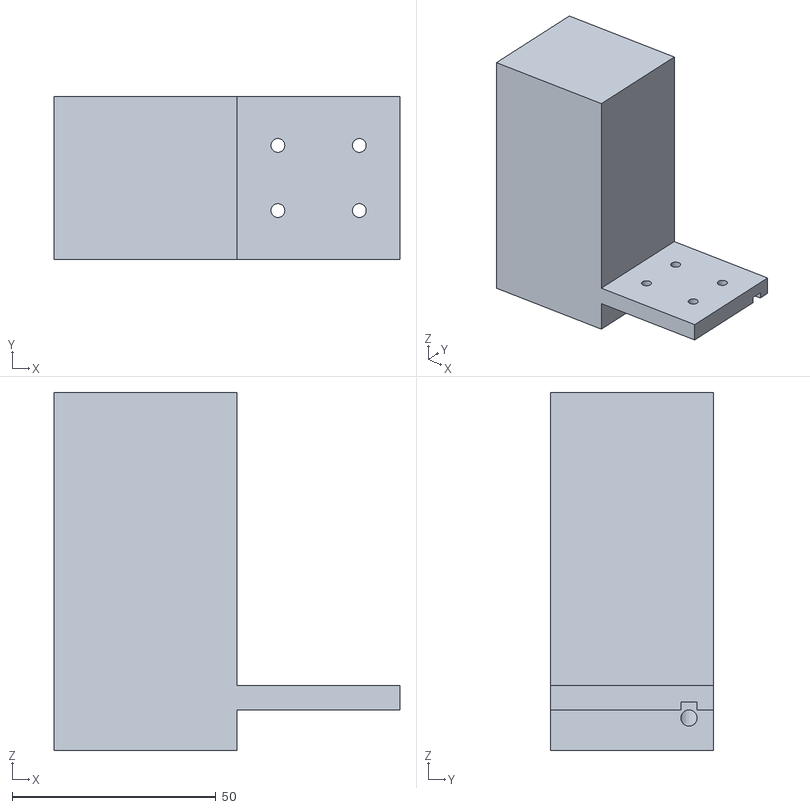
[picture p137: CAD file, 2026-11-06]
altaay_lab/twin/dock/stl/dock_spine.stl
85.0 x 40.0 x 88.0
