aaltaay/Open_Duck_Mini_v2/mini_bdx/robots/open_duck_mini_v2/ankle_pad.stl

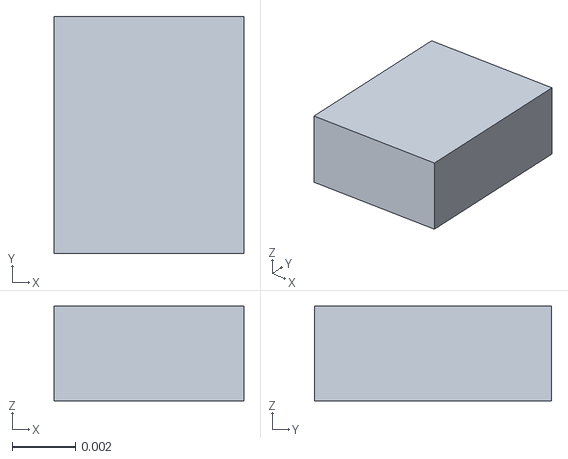
[picture p138: CAD file, 2026-11-10]
mini_bdx/robots/open_duck_mini_v2/ankle_pad.stl
0.006 x 0.0075 x 0.003
