aaltaay/Open_Duck_Mini_v2/print/roll_pad_left.stl

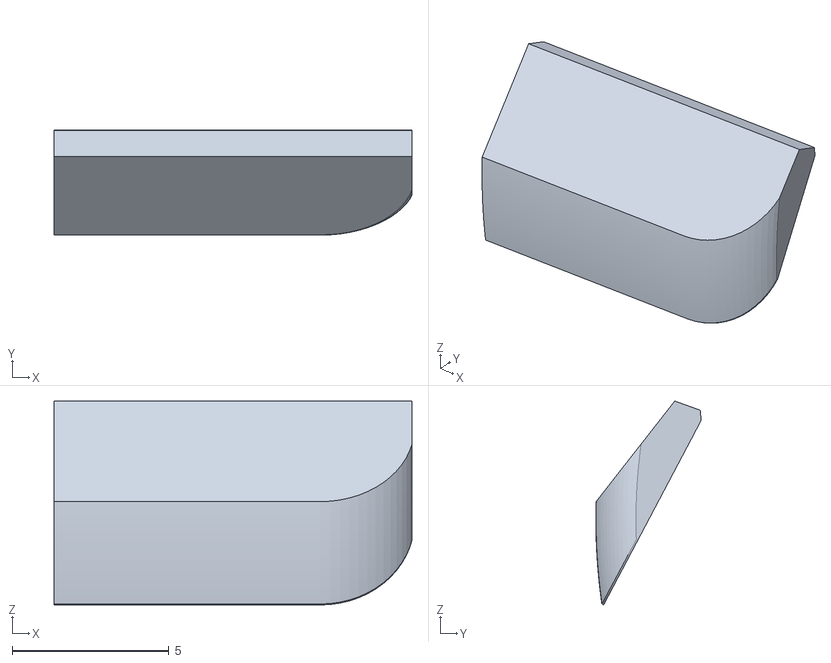
[picture p139: CAD file, 2026-11-10]
print/roll_pad_left.stl
11.4 x 3.36 x 6.51
