aaltaay/Open_Duck_Mini_v2/altaay_lab/twin/dock/nest/cad/step/nest_ring.step

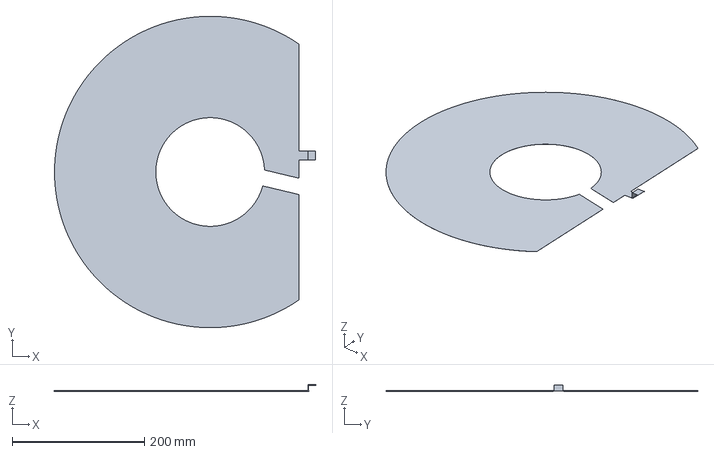
[picture p140: CAD file, 2026-11-12]
altaay_lab/twin/dock/nest/cad/step/nest_ring.step
394.0 x 470.0 x 9.10 mm
