aaltaay/Open_Duck_Mini_v2/mini_bdx/robots/open_duck_mini_v2/sit_bumper.stl

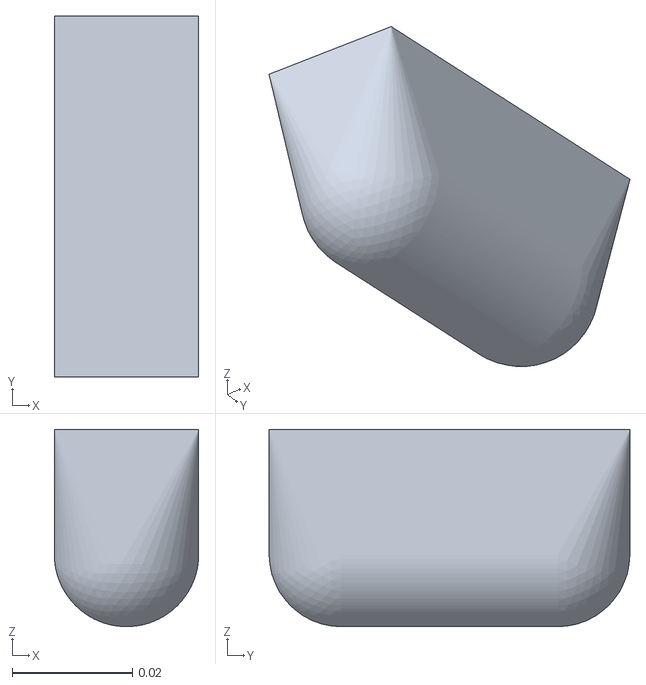
[picture p141: CAD file, 2026-11-10]
mini_bdx/robots/open_duck_mini_v2/sit_bumper.stl
0.024 x 0.06 x 0.0328
