aaltaay/Open_Duck_Mini_v2/altaay_lab/twin/dock/nest/cad/step/pin_carrier_bumper.step

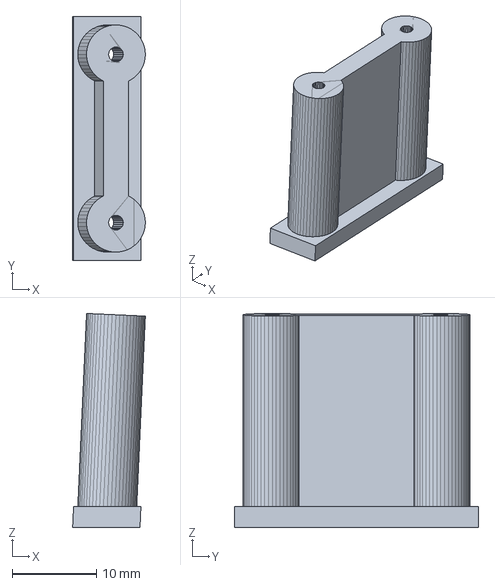
[picture p142: CAD file, 2026-11-12]
altaay_lab/twin/dock/nest/cad/step/pin_carrier_bumper.step
8.65 x 29.0 x 25.4 mm
