aaltaay/Open_Duck_Mini_v2/mini_bdx/robots/open_duck_mini_v2/head_pitch_to_yaw.stl

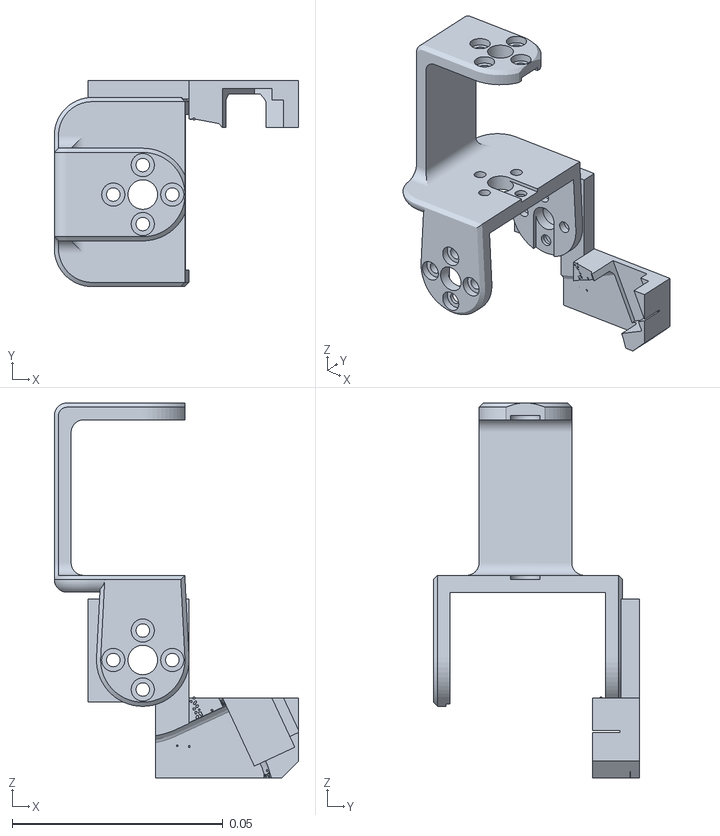
[picture p143: CAD file, 2026-11-10]
mini_bdx/robots/open_duck_mini_v2/head_pitch_to_yaw.stl
0.058 x 0.0489 x 0.089
