aaltaay/Open_Duck_Mini_v2/print/ankle_pad.stl

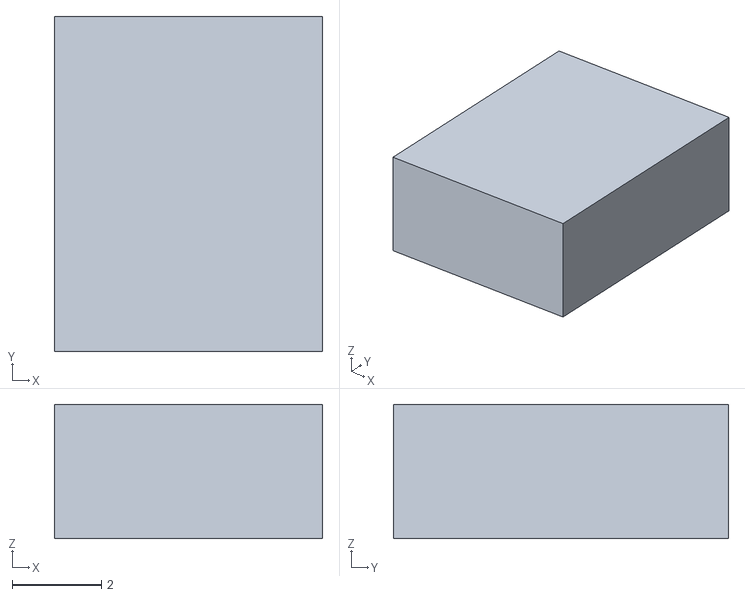
[picture p144: CAD file, 2026-11-10]
print/ankle_pad.stl
6.00 x 7.50 x 3.00
