aaltaay/Open_Duck_Mini_v2/altaay_lab/twin/dock/nest/cad/step/nest_felt_top.step

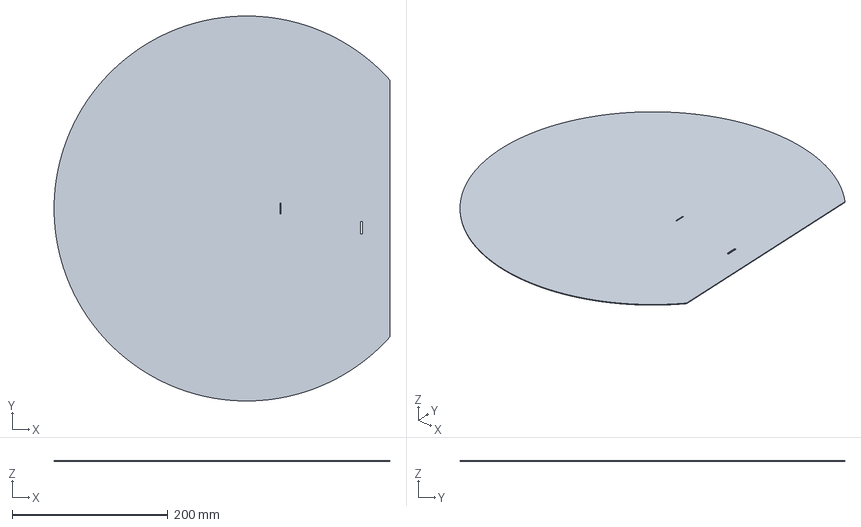
[picture p145: CAD file, 2026-11-12]
altaay_lab/twin/dock/nest/cad/step/nest_felt_top.step
431.0 x 494.0 x 1.00 mm
