aaltaay/Open_Duck_Mini_v2/altaay_lab/twin/dock/stl/dock_spring_drum.stl

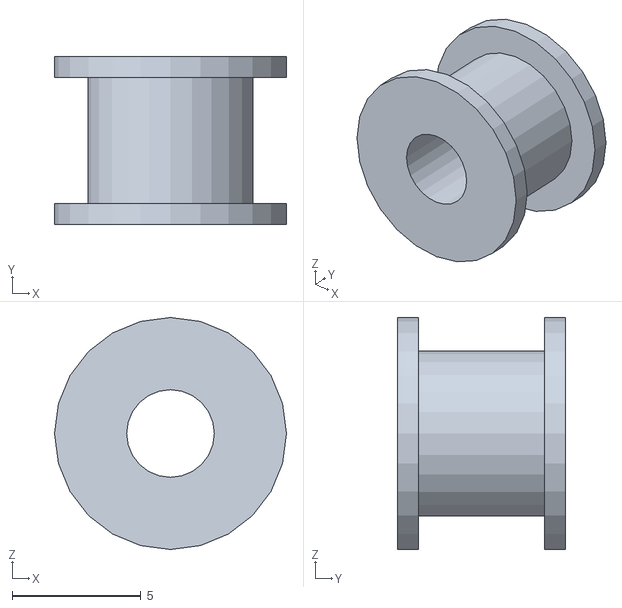
[picture p146: CAD file, 2026-11-06]
altaay_lab/twin/dock/stl/dock_spring_drum.stl
9.00 x 6.50 x 9.00
