aaltaay/Open_Duck_Mini_v2/mini_bdx/robots/open_duck_mini_v2/hip_pad.stl

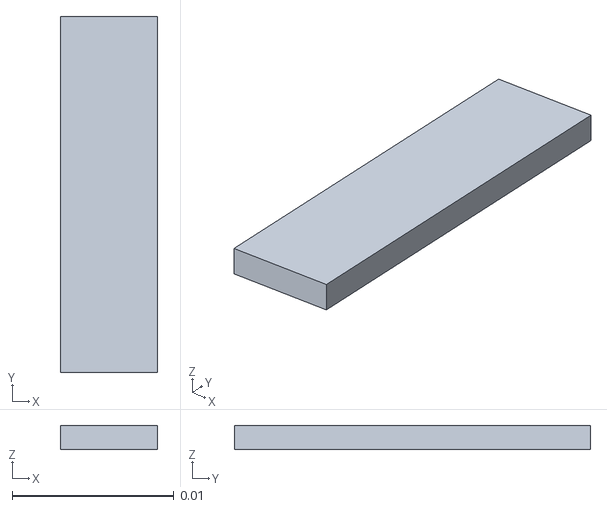
[picture p147: CAD file, 2026-11-10]
mini_bdx/robots/open_duck_mini_v2/hip_pad.stl
0.006 x 0.022 x 0.0015
