aaltaay/Open_Duck_Mini_v2/altaay_lab/twin/dock/nest/cad/step/spring_pin_ref.step

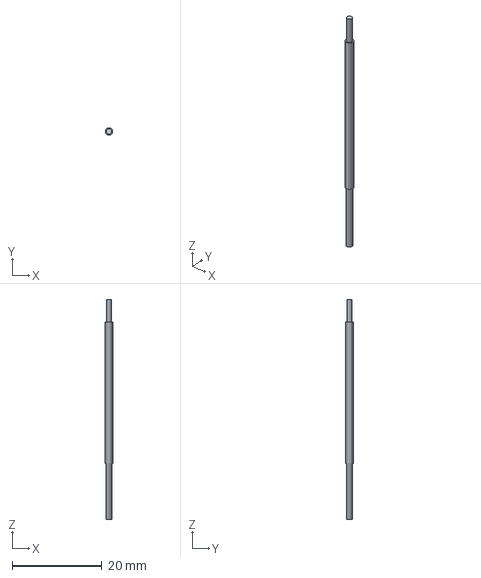
[picture p148: CAD file, 2026-11-12]
altaay_lab/twin/dock/nest/cad/step/spring_pin_ref.step
1.68 x 1.68 x 49.0 mm
