aaltaay/Open_Duck_Mini_v2/mini_bdx/robots/open_duck_mini_v2/left_knee_to_ankle_left_sheet.stl

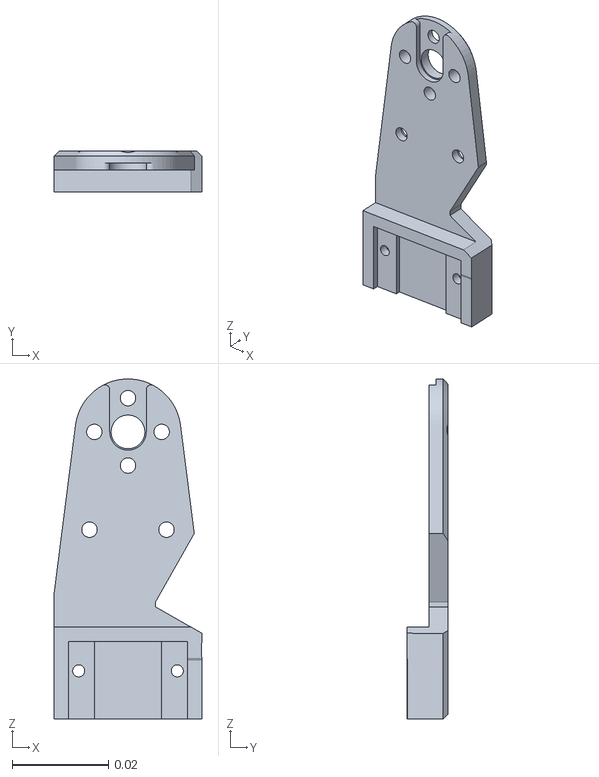
[picture p150: CAD file, 2026-11-10]
mini_bdx/robots/open_duck_mini_v2/left_knee_to_ankle_left_sheet.stl
0.0307 x 0.00845 x 0.0706
