aaltaay/Open_Duck_Mini_v2/print/neck_pad.stl

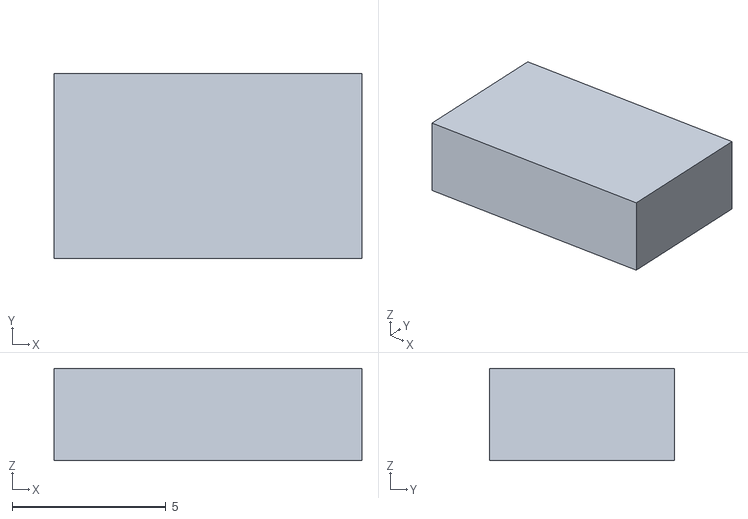
[picture p151: CAD file, 2026-11-10]
print/neck_pad.stl
10.0 x 6.00 x 3.00
