aaltaay/Open_Duck_Mini_v2/altaay_lab/twin/dock/nest/cad/step/pin_carrier_seat.step

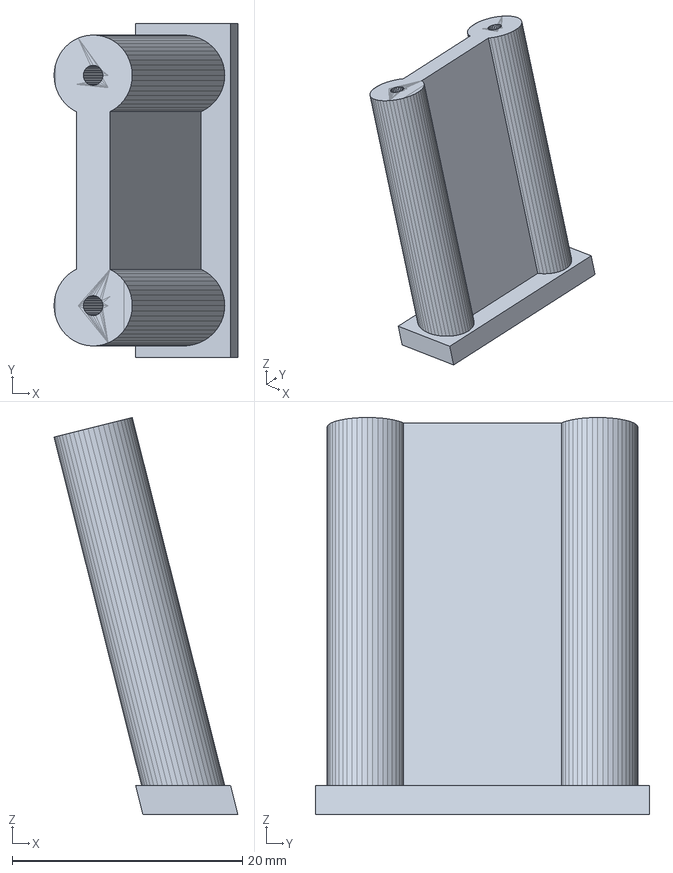
[picture p152: CAD file, 2026-11-12]
altaay_lab/twin/dock/nest/cad/step/pin_carrier_seat.step
16.0 x 29.0 x 34.5 mm
