aaltaay/Open_Duck_Mini_v2/altaay_lab/twin/dock/stl/dock_column_l1.stl

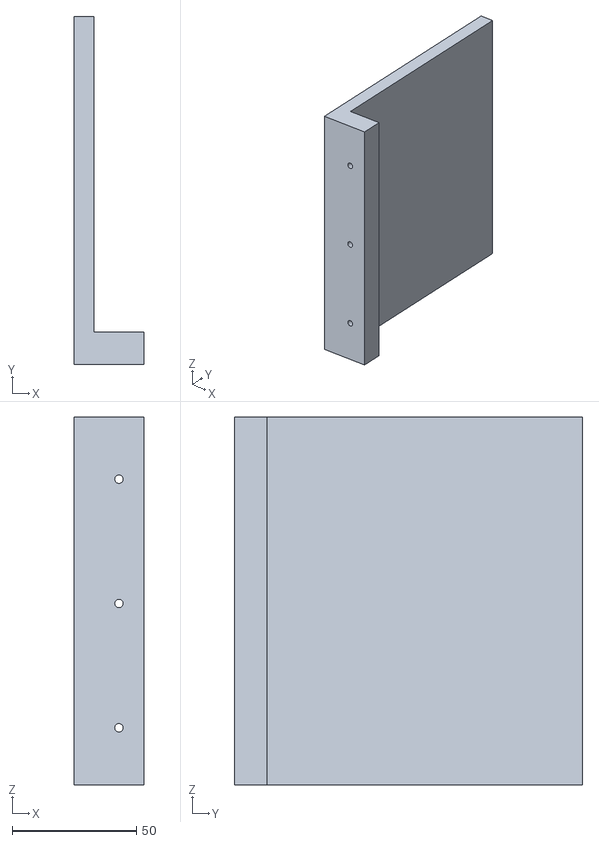
[picture p153: CAD file, 2026-11-06]
altaay_lab/twin/dock/stl/dock_column_l1.stl
28.0 x 140.0 x 148.0
