aaltaay/Open_Duck_Mini_v2/mini_bdx/robots/open_duck_mini_v2/shin_left_sheet.stl

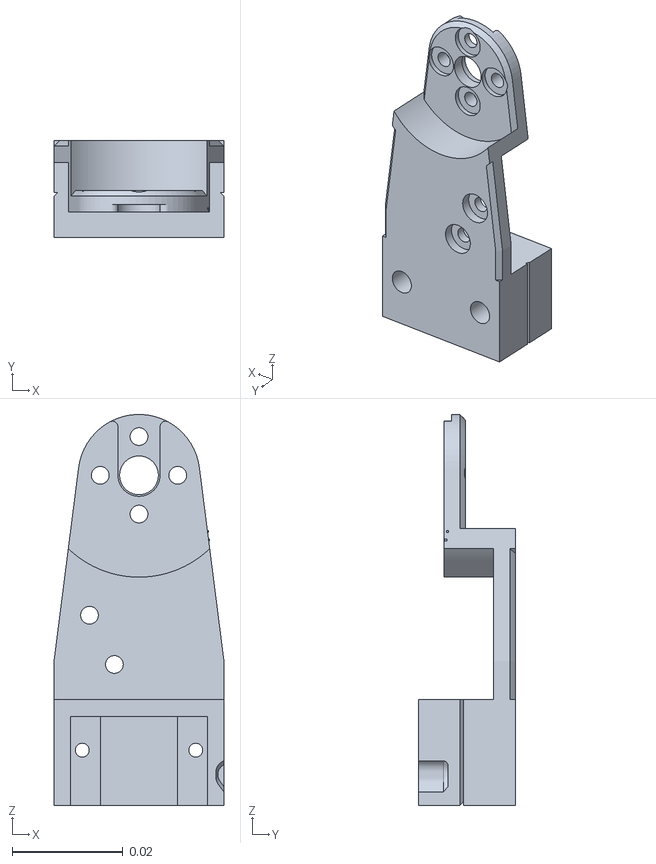
[picture p154: CAD file, 2026-11-10]
mini_bdx/robots/open_duck_mini_v2/shin_left_sheet.stl
0.0307 x 0.0175 x 0.0706
