aaltaay/Open_Duck_Mini_v2/print/sit_bumper.stl

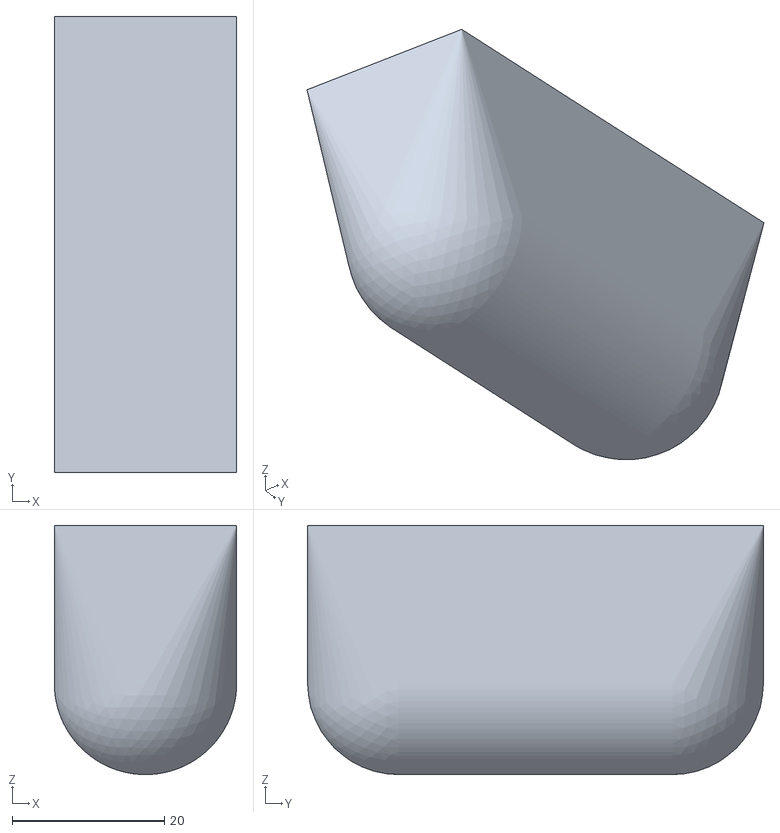
[picture p155: CAD file, 2026-11-10]
print/sit_bumper.stl
24.0 x 60.0 x 32.8
