aaltaay/Open_Duck_Mini_v2/mini_bdx/robots/open_duck_mini_v2/sit_seat.stl

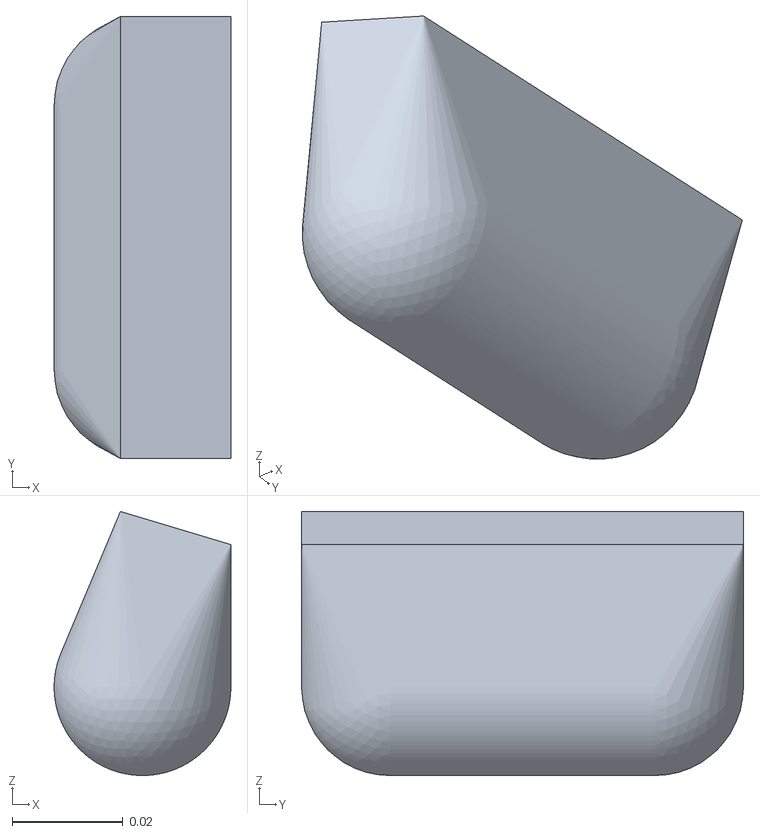
[picture p157: CAD file, 2026-11-10]
mini_bdx/robots/open_duck_mini_v2/sit_seat.stl
0.032 x 0.08 x 0.0478
