aaltaay/Open_Duck_Mini_v2/print/knee_to_ankle_right_sheet.stl

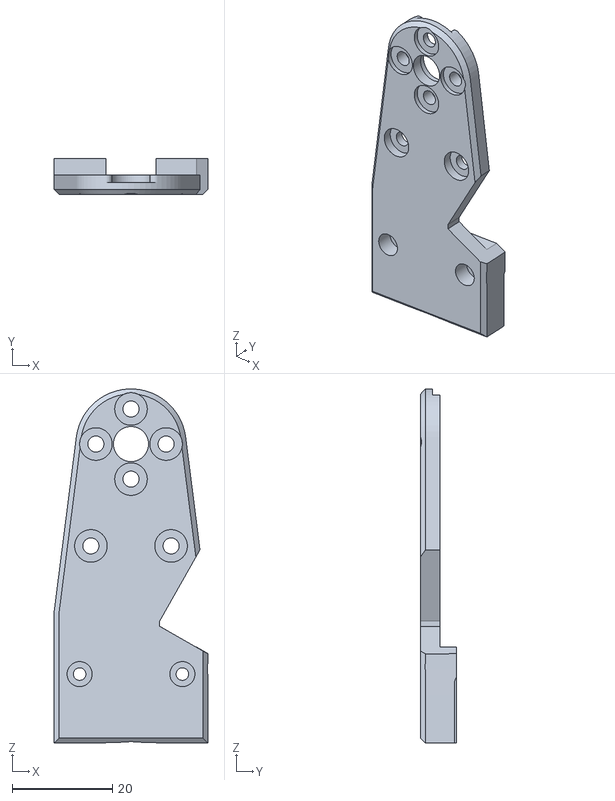
[picture p158: CAD file, 2026-11-10]
print/knee_to_ankle_right_sheet.stl
30.7 x 7.20 x 70.6
