aaltaay/Open_Duck_Mini_v2/altaay_lab/twin/dock/stl/dock_base_l.stl

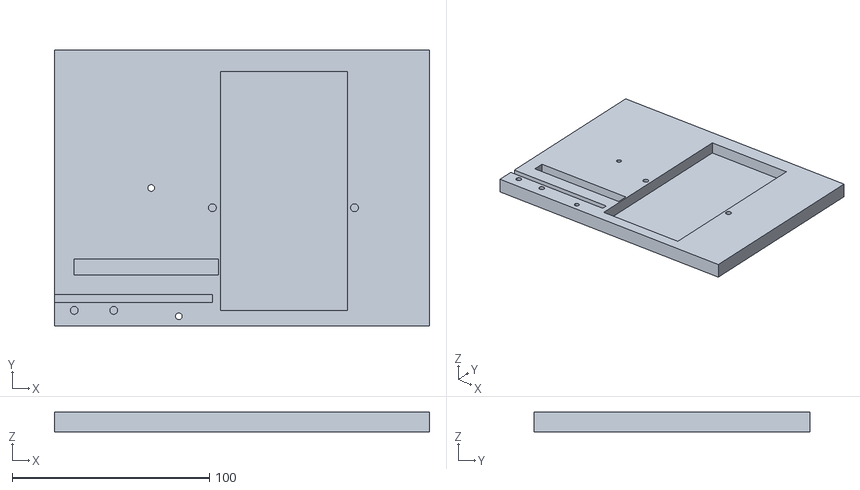
[picture p159: CAD file, 2026-11-06]
altaay_lab/twin/dock/stl/dock_base_l.stl
190.0 x 140.0 x 10.0
