aaltaay/Open_Duck_Mini_v2/mini_bdx/robots/open_duck_mini_v2/shin_spacer.stl

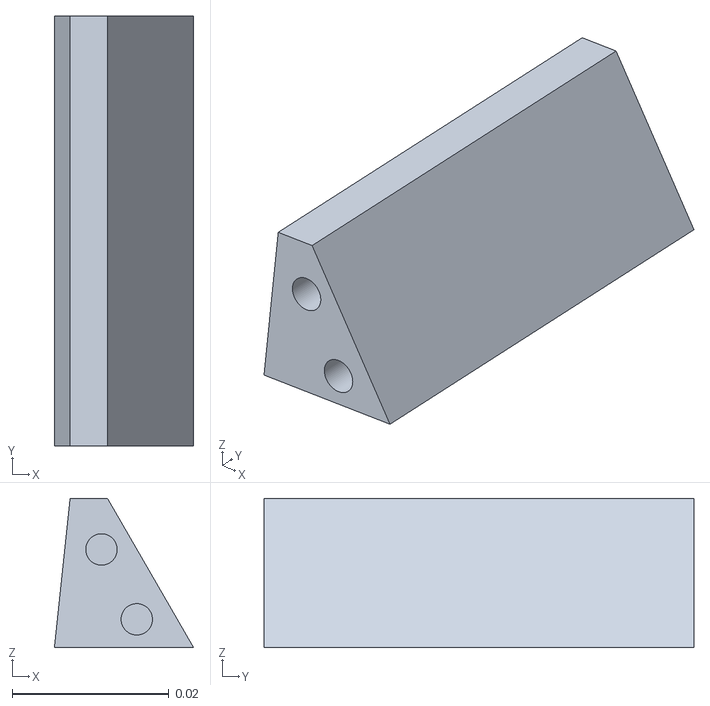
[picture p160: CAD file, 2026-11-10]
mini_bdx/robots/open_duck_mini_v2/shin_spacer.stl
0.0177 x 0.0548 x 0.019
