aaltaay/Open_Duck_Mini_v2/print/foot_top.stl

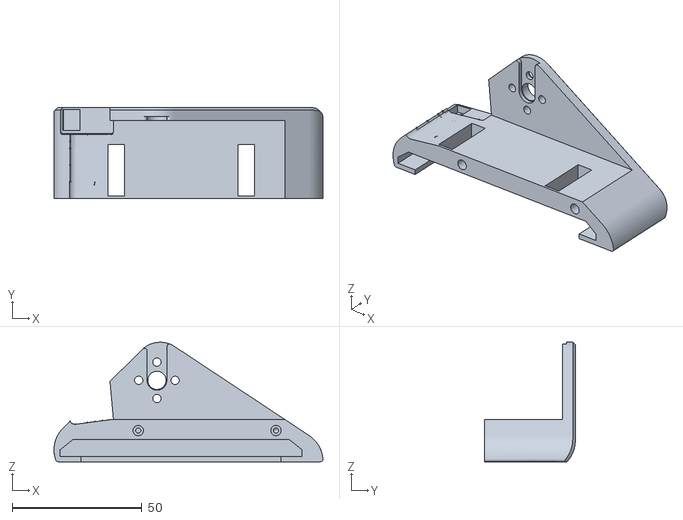
[picture p161: CAD file, 2026-11-10]
print/foot_top.stl
103.5 x 34.9 x 46.0
