aaltaay/Open_Duck_Mini_v2/altaay_lab/twin/dock/stl/dock_seat_top.stl

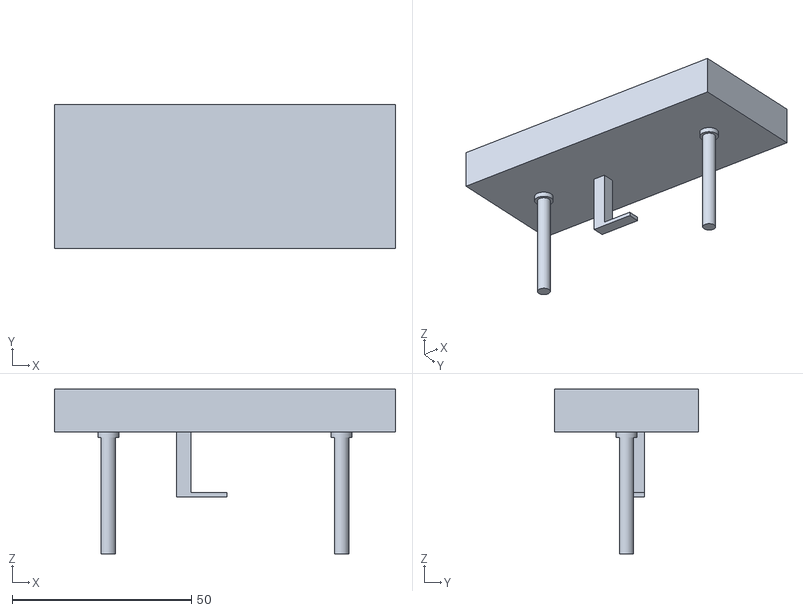
[picture p162: CAD file, 2026-11-06]
altaay_lab/twin/dock/stl/dock_seat_top.stl
95.0 x 40.0 x 45.9
