aaltaay/Open_Duck_Mini_v2/mini_bdx/robots/open_duck_mini_v2/neck_stop.stl

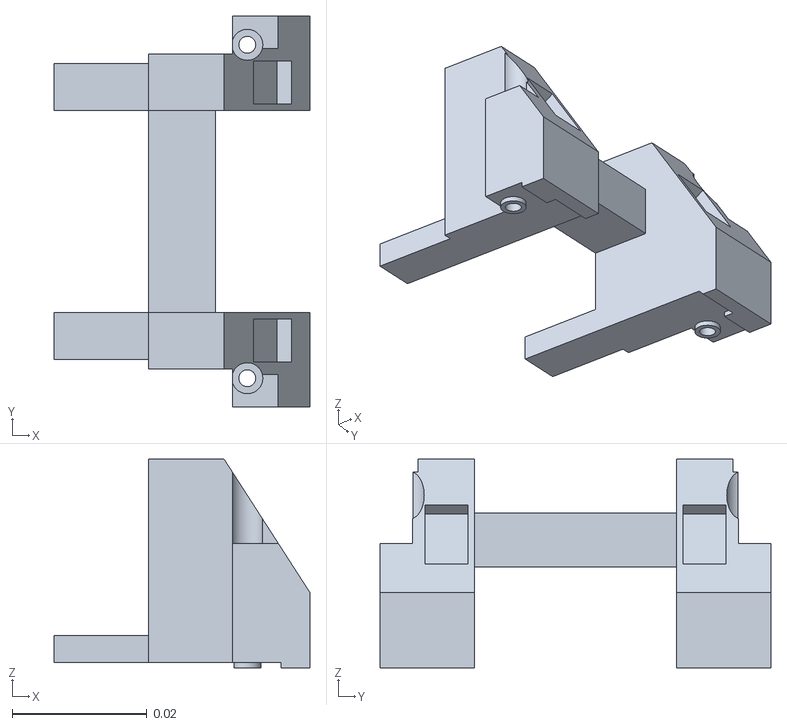
[picture p163: CAD file, 2026-11-10]
mini_bdx/robots/open_duck_mini_v2/neck_stop.stl
0.038 x 0.058 x 0.031
