aaltaay/Open_Duck_Mini_v2/print/shin_left_sheet.stl

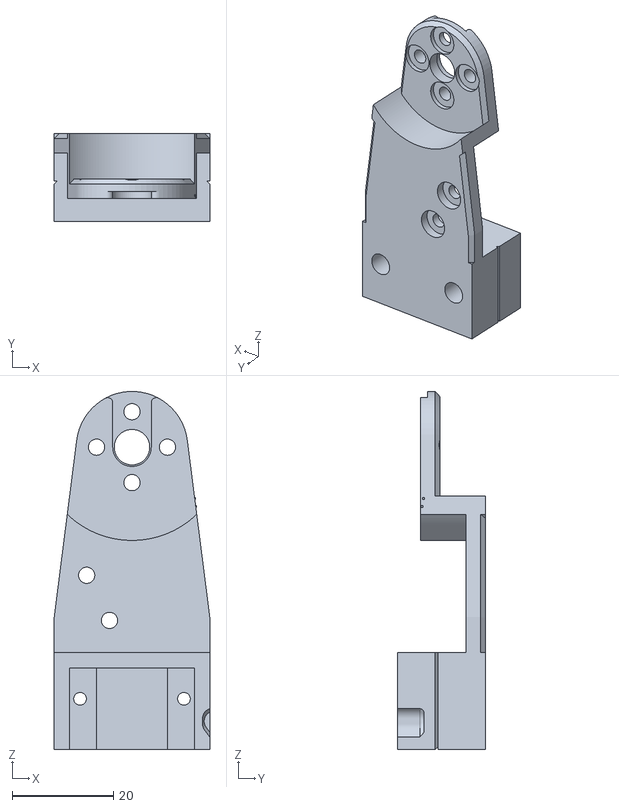
[picture p164: CAD file, 2026-11-10]
print/shin_left_sheet.stl
30.7 x 17.5 x 70.6
