aaltaay/Open_Duck_Mini_v2/altaay_lab/twin/dock/stl/dock_paddle_carrier.stl

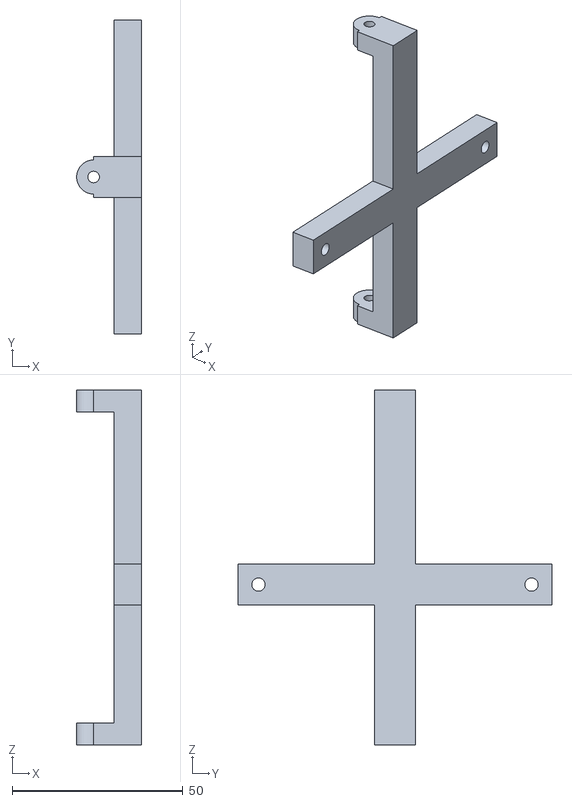
[picture p165: CAD file, 2026-11-06]
altaay_lab/twin/dock/stl/dock_paddle_carrier.stl
19.0 x 92.0 x 104.0
