aaltaay/Open_Duck_Mini_v2/mini_bdx/robots/open_duck_mini_v2/neck_pad.stl

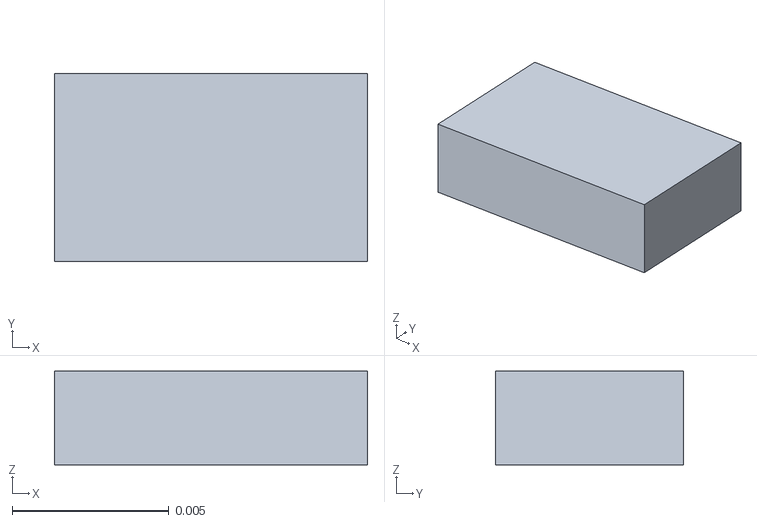
[picture p166: CAD file, 2026-11-10]
mini_bdx/robots/open_duck_mini_v2/neck_pad.stl
0.01 x 0.006 x 0.003
