aaltaay/Open_Duck_Mini_v2/print/right_cache.stl

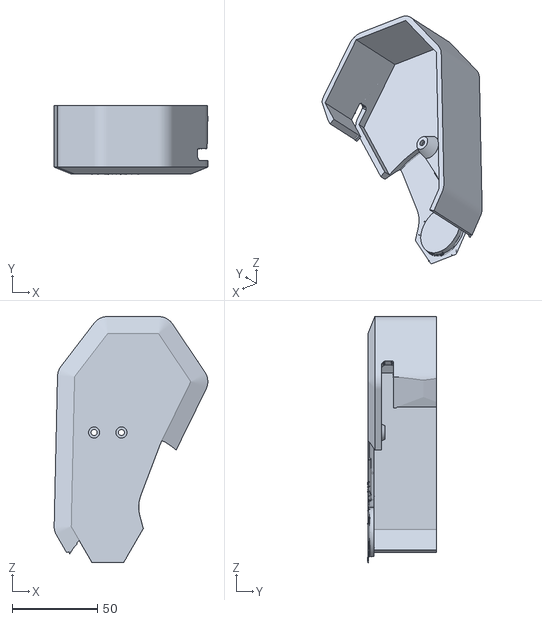
[picture p167: CAD file, 2026-11-10]
print/right_cache.stl
90.0 x 40.2 x 144.0
