aaltaay/Open_Duck_Mini_v2/altaay_lab/twin/dock/stl/dock_pin_holder.stl

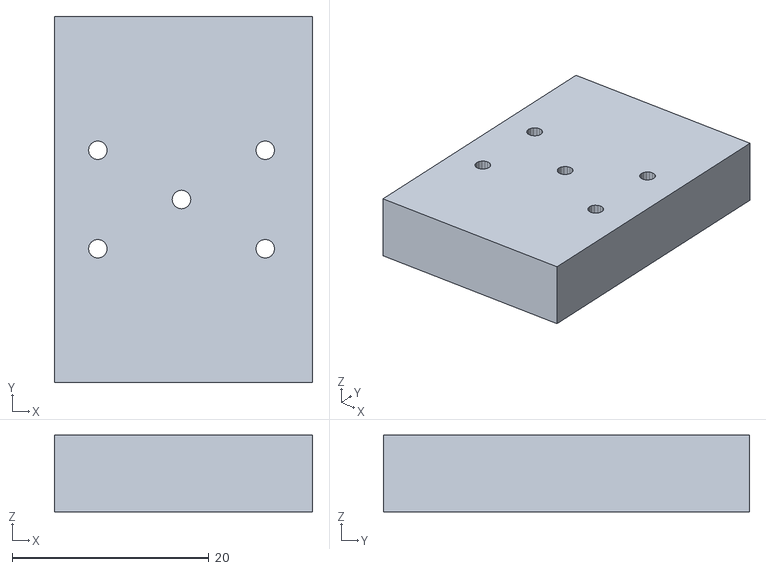
[picture p168: CAD file, 2026-11-05]
altaay_lab/twin/dock/stl/dock_pin_holder.stl
26.2 x 37.2 x 7.80
