aaltaay/Open_Duck_Mini_v2/mini_bdx/robots/open_duck_mini_v2/foot_side.stl

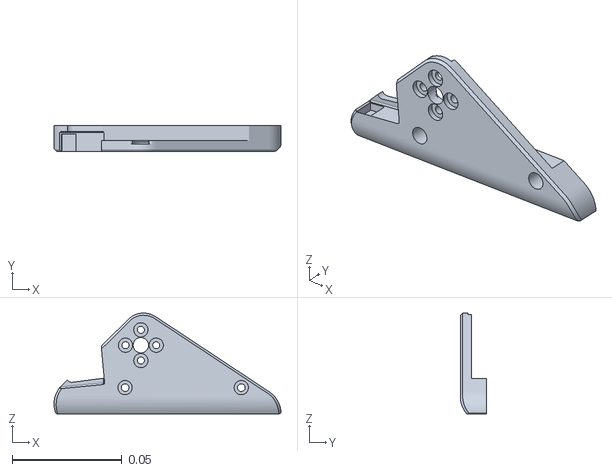
[picture p169: CAD file, 2026-11-10]
mini_bdx/robots/open_duck_mini_v2/foot_side.stl
0.103 x 0.012 x 0.046
