aaltaay/Open_Duck_Mini_v2/print/knee_bumper.stl

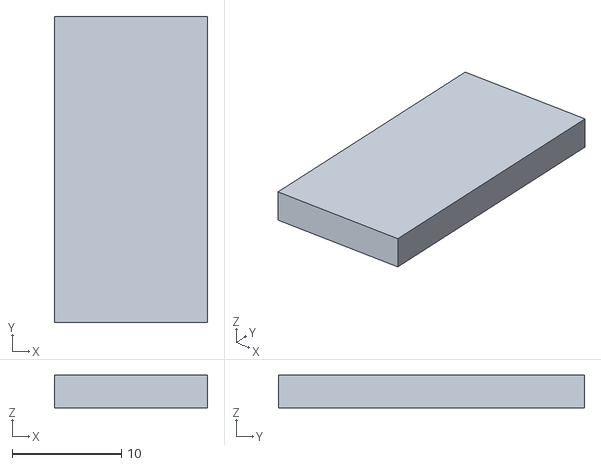
[picture p170: CAD file, 2026-11-10]
print/knee_bumper.stl
14.0 x 28.0 x 3.00
