aaltaay/Open_Duck_Mini_v2/print/hip_pad.stl

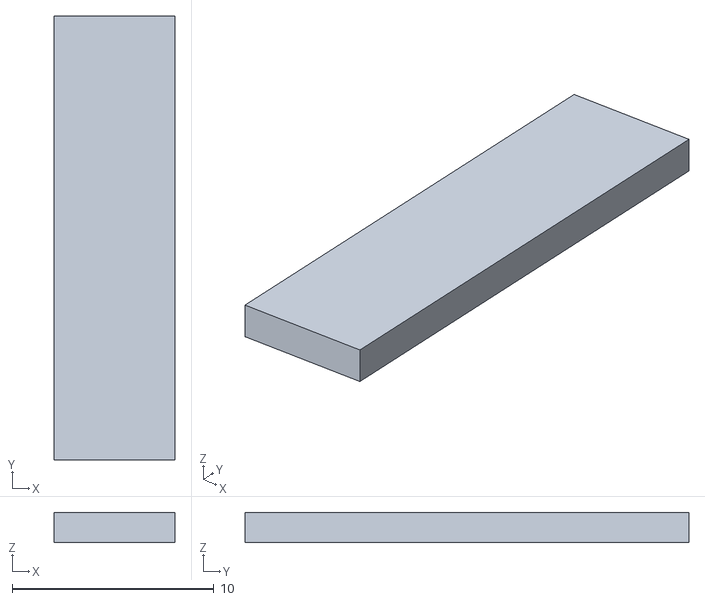
[picture p172: CAD file, 2026-11-10]
print/hip_pad.stl
6.00 x 22.0 x 1.50
