aaltaay/Open_Duck_Mini_v2/print/knee_to_ankle_left_sheet.stl

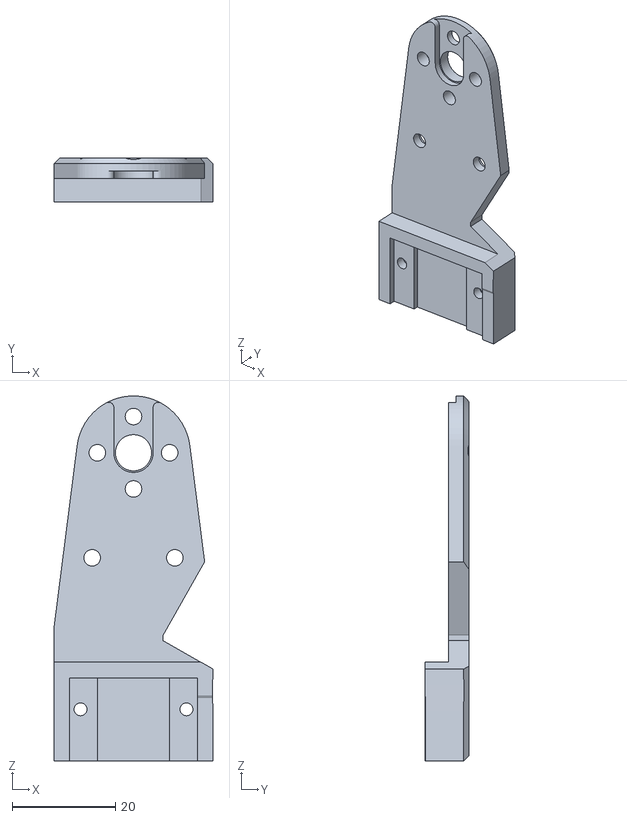
[picture p173: CAD file, 2026-11-10]
print/knee_to_ankle_left_sheet.stl
30.7 x 8.45 x 70.6
