aaltaay/Open_Duck_Mini_v2/print/head_pad.stl

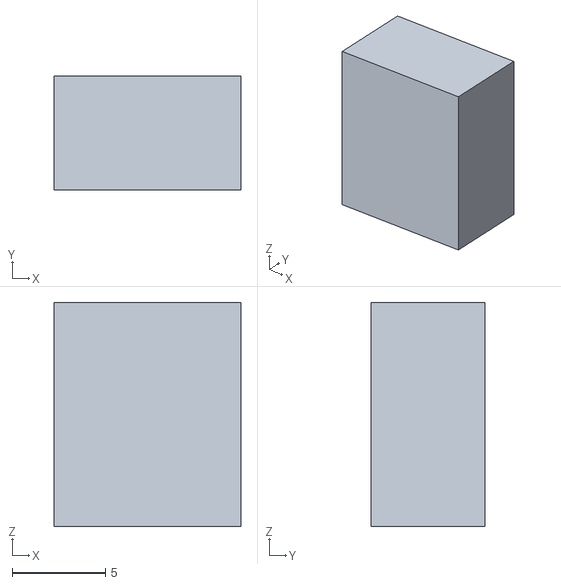
[picture p174: CAD file, 2026-11-10]
print/head_pad.stl
10.0 x 6.10 x 12.0
