aaltaay/Open_Duck_Mini_v2/print/speaker_interface.stl

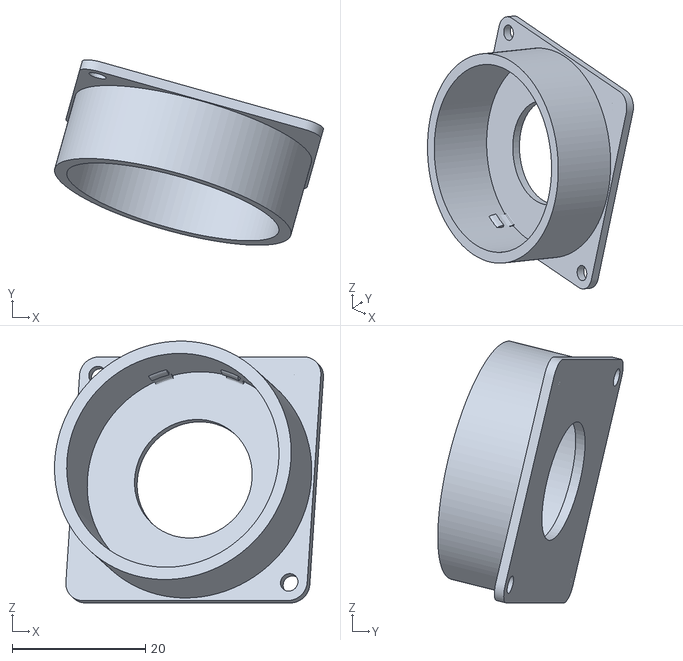
[picture p175: CAD file, 2026-11-06]
print/speaker_interface.stl
40.3 x 27.8 x 39.3
