aaltaay/Open_Duck_Mini_v2/print/body_front.stl

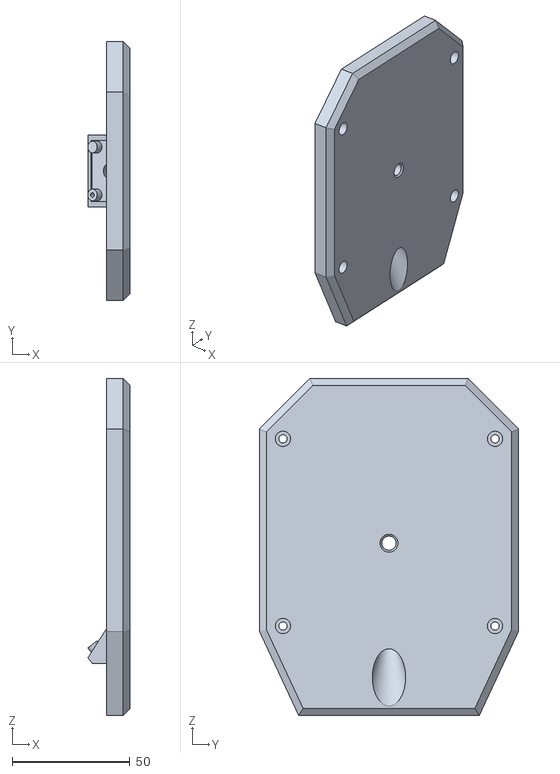
[picture p176: CAD file, 2026-11-06]
print/body_front.stl
18.0 x 110.0 x 143.0
