aaltaay/Open_Duck_Mini_v2/print/bulb.stl

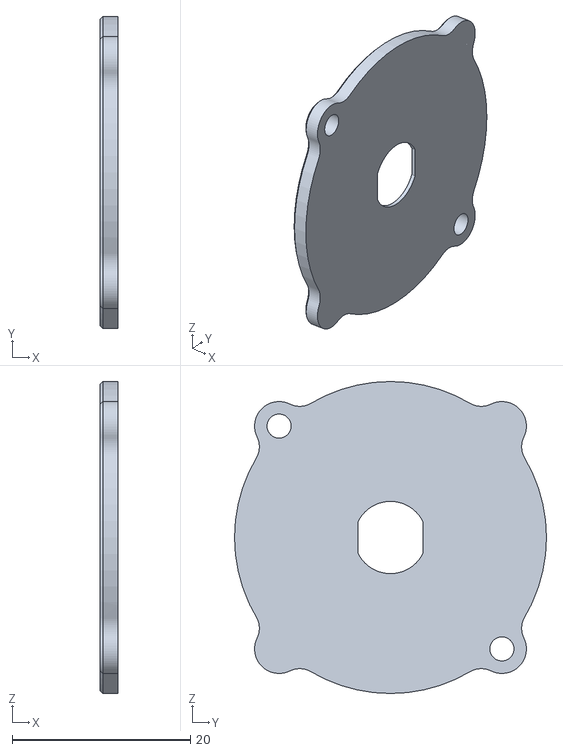
[picture p177: CAD file, 2026-11-05]
print/bulb.stl
2.00 x 35.0 x 35.0
