aaltaay/Open_Duck_Mini_v2/print/leg_spacer.stl

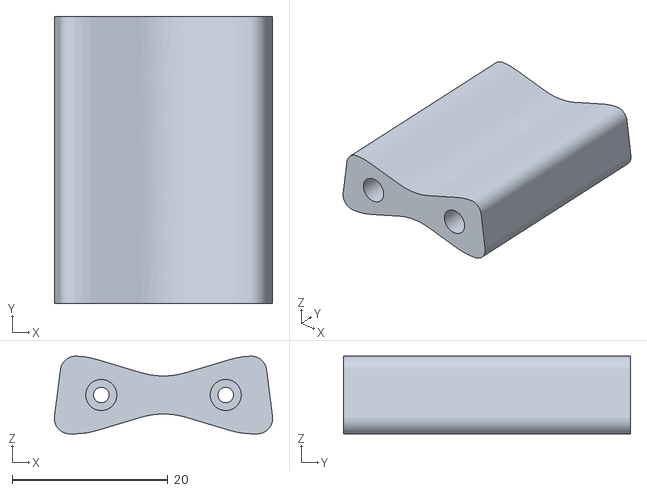
[picture p178: CAD file, 2026-11-05]
print/leg_spacer.stl
28.1 x 36.9 x 10.00
