aaltaay/Open_Duck_Mini_v2/print/left_eye.stl

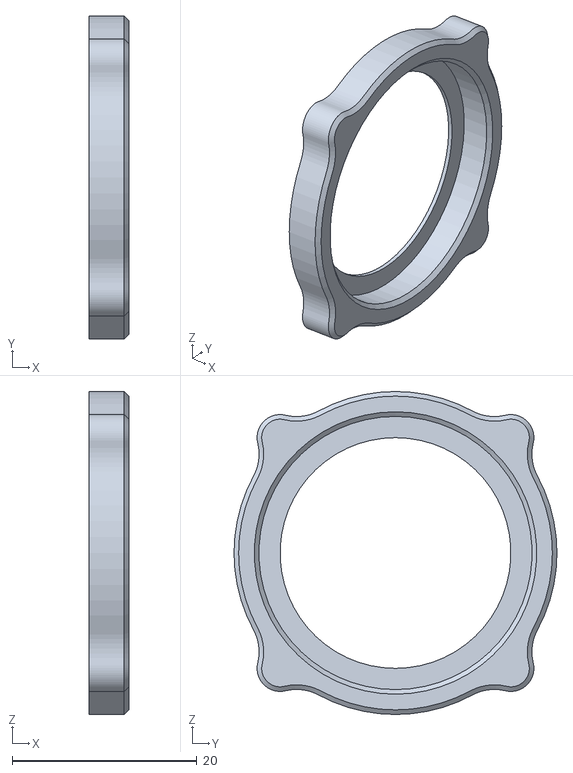
[picture p179: CAD file, 2026-11-05]
print/left_eye.stl
4.30 x 35.0 x 35.0
