aaltaay/Open_Duck_Mini_v2/print/head_bot_sheet.stl

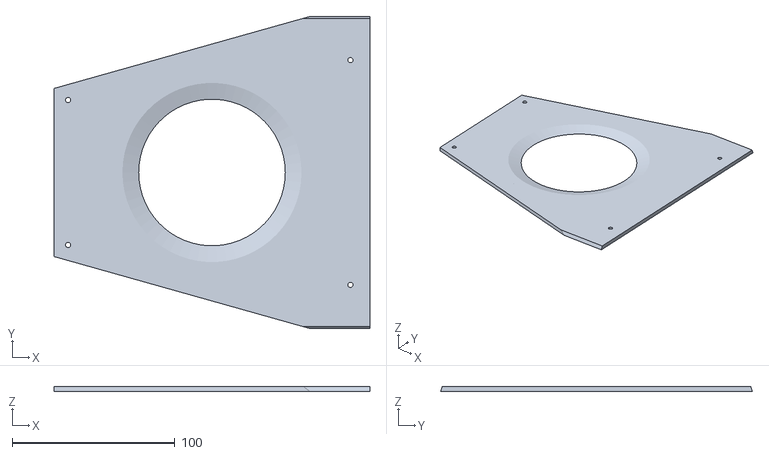
[picture p180: CAD file, 2026-11-05]
print/head_bot_sheet.stl
193.8 x 191.6 x 3.00
