aaltaay/Open_Duck_Mini_v2/print/speaker_stand.stl

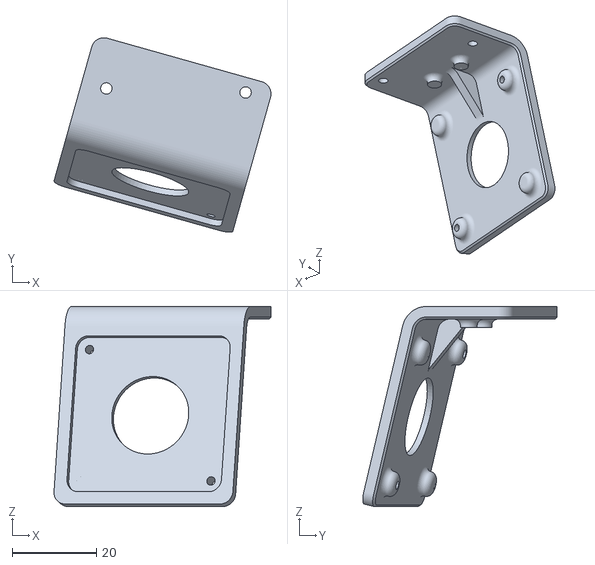
[picture p181: CAD file, 2026-11-05]
print/speaker_stand.stl
51.4 x 46.0 x 47.4
