aaltaay/Open_Duck_Mini_v2/print/flash_light_module.stl

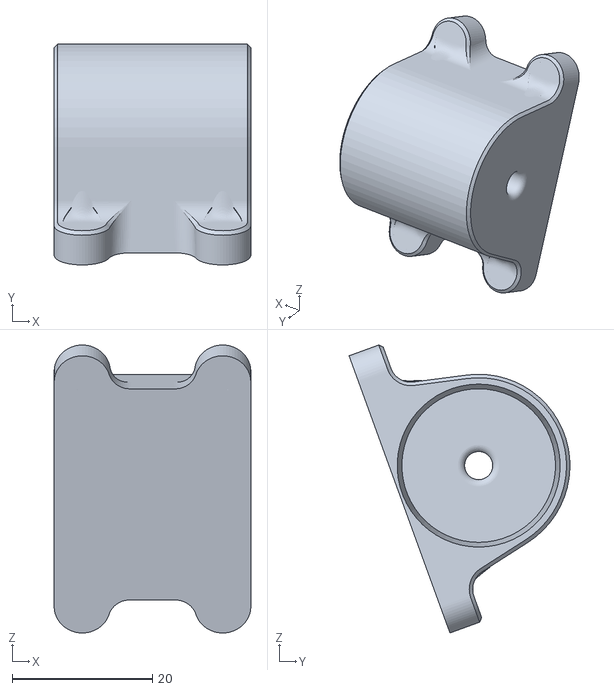
[picture p182: CAD file, 2026-11-05]
print/flash_light_module.stl
28.0 x 31.5 x 41.0
