aaltaay/Open_Duck_Mini_v2/print/body_middle_top.stl

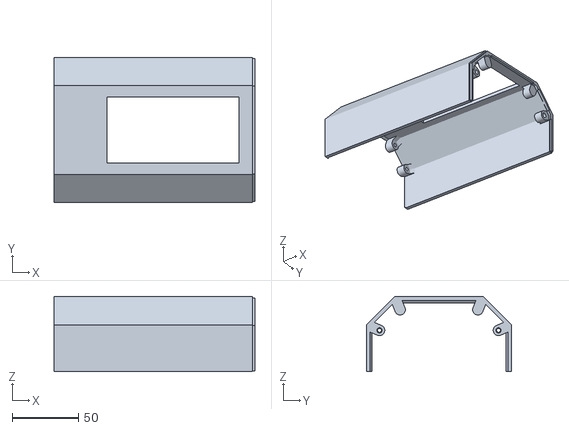
[picture p183: CAD file, 2026-11-05]
print/body_middle_top.stl
152.0 x 110.0 x 56.8
