aaltaay/Open_Duck_Mini_v2/print/trunk_top.stl

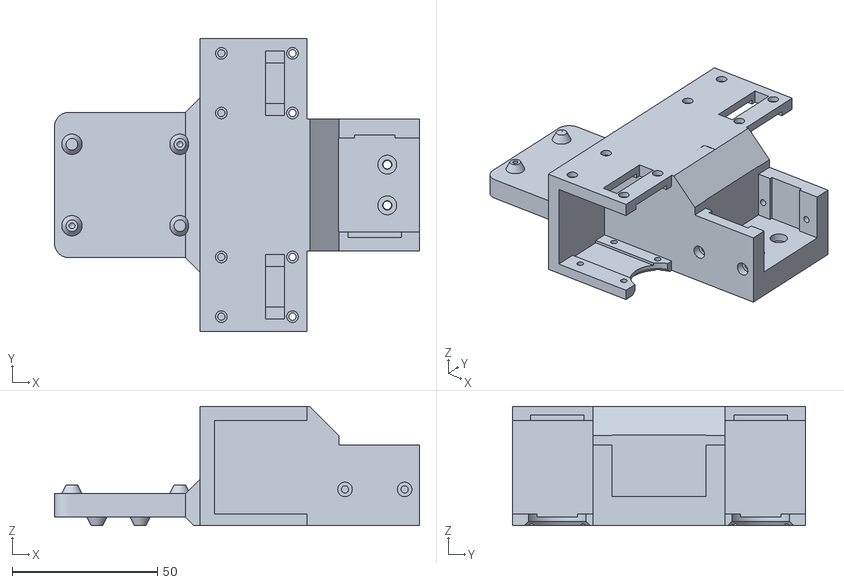
[picture p184: CAD file, 2026-11-05]
print/trunk_top.stl
125.5 x 100.7 x 41.0
