aaltaay/Open_Duck_Mini_v2/print/battery_pack_lid.stl

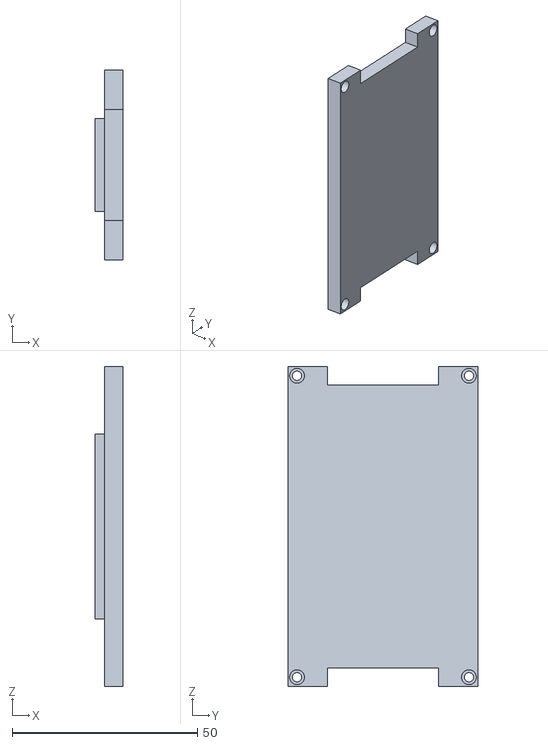
[picture p185: CAD file, 2026-11-05]
print/battery_pack_lid.stl
7.50 x 51.4 x 86.4
