aaltaay/Open_Duck_Mini_v2/print/right_eye.stl

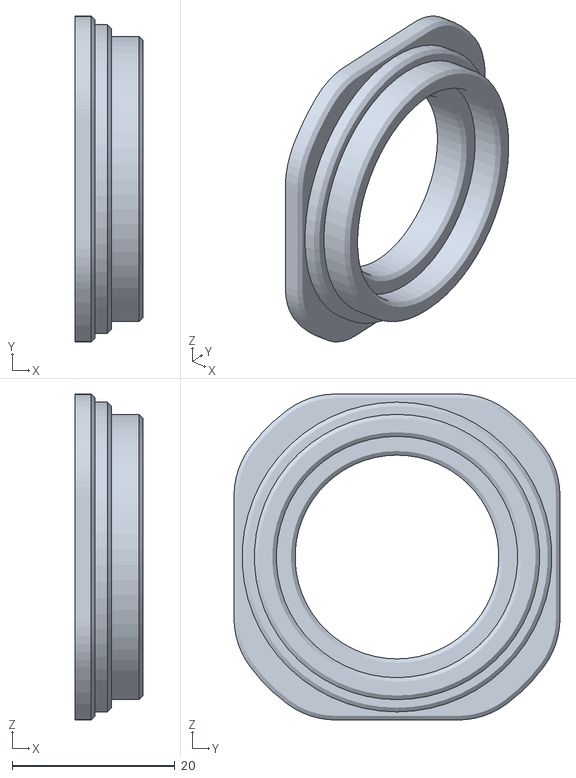
[picture p186: CAD file, 2026-11-05]
print/right_eye.stl
8.40 x 40.0 x 40.0
