aaltaay/Open_Duck_Mini_v2/print/neck_right_sheet.stl

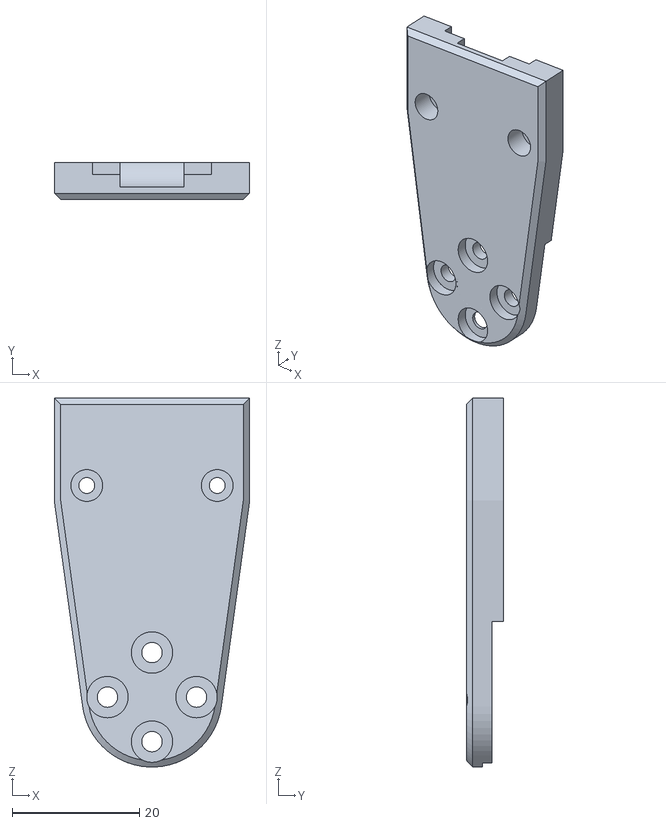
[picture p187: CAD file, 2026-11-05]
print/neck_right_sheet.stl
30.7 x 5.85 x 58.0
