aaltaay/Open_Duck_Mini_v2/(list of files, cad)

Other CAD files:
altaay_lab/cad/nest_v2/step/stripe_minus.step
mini_bdx/robots/open_duck_mini_v2/right_cache.stl
altaay_lab/twin/dock/stl/dock_column_r2.stl
print/roll_pad_right.stl
altaay_lab/twin/dock/stl/dock_column_l3.stl
print/left_roll_to_pitch.stl
print/left_cache.stl
mini_bdx/robots/open_duck_mini_v2/right_roll_to_pitch.stl
mini_bdx/robots/open_duck_mini_v2/roll_pad_right.stl
print/head.stl
print/body_middle_bottom.stl
altaay_lab/cad/nest_v2/stl/cord_cap.stl
altaay_lab/cad/nest_v2/stl/cord_pocket.stl
altaay_lab/cad/nest_v2/stl/felt_base.stl
altaay_lab/cad/nest_v2/stl/felt_top.stl
altaay_lab/cad/nest_v2/stl/seat_wells.stl
altaay_lab/cad/nest_v2/stl/stripe_minus.stl
altaay_lab/cad/nest_v2/stl/stripe_plus.stl
altaay_lab/cad/nest_v2/stl/wall_card.stl
altaay_lab/twin/dock/nest/cad/stl/nest_bolster_left.stl
altaay_lab/twin/dock/nest/cad/stl/nest_bolster_right.stl
altaay_lab/twin/dock/nest/cad/stl/nest_box_lid.stl
altaay_lab/twin/dock/nest/cad/stl/nest_feed.stl
altaay_lab/twin/dock/nest/cad/stl/nest_felt_base.stl
altaay_lab/twin/dock/nest/cad/stl/nest_felt_top.stl
altaay_lab/twin/dock/nest/cad/stl/nest_rim_cover.stl
altaay_lab/twin/dock/nest/cad/stl/nest_ring.stl
altaay_lab/twin/dock/nest/cad/stl/nest_sun.stl
altaay_lab/twin/dock/nest/cad/stl/nest_sun_foil.stl
altaay_lab/twin/dock/nest/cad/stl/pin_carrier_bumper.stl
altaay_lab/twin/dock/nest/cad/stl/pin_carrier_seat.stl
altaay_lab/twin/dock/nest/cad/stl/pin_gauge.stl
altaay_lab/twin/dock/nest/cad/stl/spring_pin_ref.stl
altaay_lab/twin/screws/stl/K1a_body_middle_top.stl
altaay_lab/twin/screws/stl/K1b_body_front.stl
altaay_lab/twin/screws/stl/K2a_body_middle_bottom.stl
altaay_lab/twin/screws/stl/K2b_body_back.stl
altaay_lab/twin/screws/stl/K3_cable_clip.stl
altaay_lab/twin/screws/stl/K4_tie_bridge.stl
altaay_lab/twin/screws/stl/body_front_groove.stl
altaay_lab/twin/screws/stl/body_middle_bottom_lip.stl
