aaltaay/Open_Duck_Mini_v2/altaay_lab/print/SLICE_SUMMARY.md

# SLICE_SUMMARY

Last updated: 2026-11-02 1:42 AM ET. Generated by `python3 slice.py summary --out <dir> --before <dir_heavy> --md SLICE_SUMMARY.md` after the `parts` (light, and `--set heavy` into <dir_heavy>), `coupons`, `plates` (220 and 256) and `optional` runs (see PRINT_PLAN.md). Nothing has been printed.

Runs behind these tables: `parts`, `plates` (220 and 256) and `optional`, light and `--set heavy`, of 2026-11-02 12:00 to 12:19 AM ET (agent PP; parts.csv, the configs and the STLs are unchanged since); `coupons` again at 1:41 AM ET (agent PRT) for the T1 stack: T1b (a whole bulb) and T1w (the head wall behind the left eye) join session S1 (DECISIONS.md D21 note, PRINT_PLAN.md step 1).

All grams and hours are PrusaSlicer 2.7.2 estimates made on the box with the generic printer in config/printer_generic.ini (0.4 mm nozzle, moderate speeds, 1500 mm/s2). They are not printed results. A faster printer will take fewer hours; grams change little between printers. Grams include supports and the skirt.

Settings: the light profile of DECISIONS.md D22 (print/MASS_STUDY.md variant c). Base config/pla_print.ini and config/tpu_print.ini: 2 walls, gyroid infill PLA 15 % and TPU 40 %. Per-part overrides from parts.csv: insert 4 walls; neck 5 walls and 40 %; wall3 3 walls; fit outer wall first at 25 mm/s. Solid rings: 100 % infill cylinders (config/mod_ring.ini) round the insert bores (2.0 mm solid) and screw pilots (1.5 mm) of the parts with a rings entry in parts.csv; those parts are sliced from a 3MF that carries the modifiers. 'Before' columns: the same parts with the settings before D22 (`slice.py parts --set heavy`: config/*_heavy.ini with 3 walls, the parts.csv heavy overrides, no rings). Densities from the Overture data sheets: Easy PLA 1.20, TPU 95A 1.216 g/cm3. Upstream STLs: print/ at 730c14b (unchanged at b23317a).

V1 screws job, 2026-11-04 (D38): body_front, body_middle_top and body_middle_bottom re-sliced with `slice.py parts --only` (D22 light profile) after the tongue, groove, lips and ribs; the coupon session re-sliced with K1a to K4 added (S1 46.8 g, 4.69 h). Plates holding the 3 parts are moved by the part deltas (calc), not re-sliced; the before columns and the S1 gate fallback are from before.

V1 battery job (track 9), 2026-11-05 about 12:40 AM ET (D44): body_back re-sliced alone with `slice.py parts --only body_back.stl` (D22 light profile) after the bay was grown for the 2S1P Molicel P45B pack (twin/battery/BAY.md): 78.48 to 79.21 g with support, support 8.10 to 10.72 g, 6.42 to 6.54 h, model 70.34 to 68.45 g (the run before the change gave 78.48 g against this table's 78.28 g: run to run noise of 0.2 g). The per part row and the per part total are updated; the plate tables below were not re-run (+0.9 g, +0.15 h on one plate).

V1 freeze, 2026-11-06 ET (twin/freeze/FREEZE.md; D47, D52, D54): the 3 changed STLs re-sliced with `slice.py parts --only` (D22 light profile, the head on its heavy insert profile as before), same box: head.stl (mic seats and 36 grille plugs) 262.83 g, 21.91 h, support 29.17 g (was 262.01 g, 21.77 h); speaker_interface.stl (the duct) 5.06 g, 0.38 h, no support (was 2.35 g, 0.22 h); body_front.stl (the cliff ToF seat, now printed front face down, parts.csv up -x) 59.91 g, 4.38 h, support 0.62 g in the window (was 57.56 g, 3.94 h): +5.88 g and +0.74 h for the set. The table rows and the plates below are not recomputed.

V1 symmetry job, 2026-11-04 11:01 PM ET (D42): uniform screw patterns and surface-fitted plug caps (twin/holes/HOLES_TWIN.md addendum); the 15 changed STLs re-sliced with `slice.py parts --only` (D22 light profile), same box: +0.29 g and +0.13 h for the robot set against D39 (x quantity), -6.32 g and -1.17 h against pre-D39 (twin/holes/data/slice_delta_d42.json). battery_pack_lid is its pre-D39 STL again; body_back has 5 pilot rings again (F027 reopened); body_middle_bottom keeps 4 insert rings (F071 back, F069 closed) and the 4 ear seats; head gains one insert bore (F084, F090 back, F088 closed). The 4 STLs whose caps moved in the 11:36 PM ET follow-up (body_back, flash_light_module, head, speaker_stand) were re-sliced again, and every changed STL once more after the 2026-11-05 12:36 AM ET cap rebuild; the numbers above are from that run. The robot set totals above are not recomputed.

V1 holes job, 2026-11-05 (D39): every hole without a screw closed in 16 STLs (twin/holes/HOLES_TWIN.md); the 16 STLs and roll_motor_bottom re-sliced with `slice.py parts --only` (D22 light profile) before and after, same box: -6.38 g and -1.22 h for the robot set (x quantity), -4.2 g on the robot without supports. A closed hole drops its perimeter walls and, at insert and pilot bores, its solid ring (body_back 5 to 4 pilot rings, body_middle_top 8 to 6 and body_middle_bottom 7 to 4 insert rings). body_middle_bottom includes the 4 ear seats. The robot set totals above are not recomputed.

V1 sit job, 2026-11-07 ET (D59; twin/sit/SIT.md): the 23 STLs it changed or added sliced with `slice.py parts --only` (D22 light profile; TPU parts on the sole profile, sit_seat and sit_bumper at 10 % infill, config/ovr_sparse.ini), same box, and their rows replaced or added (the 'before' columns of the new parts are empty: they have no pre-D22 version). Quantities follow print/parts.csv: knee_to_ankle_left_sheet, knee_to_ankle_right_sheet and leg_spacer are the thigh parts only now (2 each); the shins print shin_left_sheet, shin_right_sheet and shin_spacer. The totals table below is now the sum of the per-part rows (49 STLs, 68 parts, 1355.5 g, 119.9 h); before this job its rows added up to 1287.4 g against its 1293.8 g, as the D38 to D50 rows were updated without it. The plate tables and the D22 comparison are not re-run.

## What changed with D22

- Robot set at D22 (36 STLs then; 52 parts): 1280.3 g and 111.1 h, against 1409.0 g and 118.9 h before (-128.8 g, -7.8 h). On the robot: 1190.4 g against 1318.6 g (-128.2 g).
- Lighter: 19 STLs. Unchanged (within 0.01 g and 1 s, the run to run noise): 17 STLs (head, head_pitch_to_yaw, head_roll_mount, head_yaw_to_roll, knee_to_ankle_left_sheet, knee_to_ankle_right_sheet, left_antenna_holder, left_eye, neck_left_sheet, neck_right_sheet, right_antenna_holder, right_eye, roll_motor_bottom, speaker_interface, speaker_stand, trunk_bottom, trunk_top).
- S1 gate fallback (light coupon fails): +62.0 g filament, +61.7 g on the robot, +3.99 h on the 10 insert ring parts.
- Plates, 220 bed: 18 jobs, 1365.4 g, 119.5 h; before 15 jobs, 1492.7 g, 126.5 h.
- Plates, 256 bed: 17 jobs, 1365.8 g, 118.7 h; before 14 jobs, 1492.8 g, 126.6 h.
- Coupon session: S1_PLA_coupons 46.8 g, 4.69 h; S2_TPU_coupons 17.6 g, 2.19 h.
- The old PRINT_CHECK run (audit/slice_best.json, parts.csv quantities): 1339.0 g, 131.5 h.

## Per part (robot set: 49 STLs, 68 parts)

| STL | Qty | Material | Profile | g each | h each | support g each | g total | h total | before g each | before h each |
|---|---|---|---|---|---|---|---|---|---|---|
| ankle_pad.stl | 4 | TPU | light (base) | 0.17 | 0.04 | 0.00 | 0.7 | 0.17 | - | - |
| battery_pack_lid.stl | 1 | PLA | light (base) | 13.61 | 0.99 | 0.05 | 13.6 | 0.99 | 14.05 | 1.04 |
| body_back.stl | 1 | PLA | rings (base + 4 pilot rings) | 79.21 | 6.54 | 10.72 | 79.2 | 6.54 | 88.06 | 6.94 |
| body_front.stl | 1 | PLA | light (base) | 57.56 | 3.94 | 0.00 | 57.6 | 3.94 | 60.33 | 4.22 |
| body_middle_bottom.stl | 1 | PLA | rings (base + 4 insert rings) | 106.51 | 9.35 | 15.54 | 106.5 | 9.35 | 116.52 | 9.53 |
| body_middle_top.stl | 1 | PLA | rings (base + 6 insert rings) | 74.57 | 6.62 | 7.74 | 74.6 | 6.62 | 98.95 | 7.76 |
| bulb.stl | 2 | PLA | light (base) | 2.06 | 0.17 | 0.00 | 4.1 | 0.33 | 2.05 | 0.17 |
| flash_light_module.stl | 1 | PLA | light (base) | 8.56 | 0.80 | 0.19 | 8.6 | 0.80 | 9.13 | 0.87 |
| flash_reflector_interface.stl | 1 | PLA | light (base) | 2.32 | 0.24 | 0.05 | 2.3 | 0.24 | 2.57 | 0.25 |
| foot_bottom_pla.stl | 2 | PLA | rings (base + 2 insert rings) | 9.84 | 0.78 | 0.37 | 19.7 | 1.56 | 10.89 | 0.85 |
| foot_bottom_tpu.stl | 2 | TPU | light (base) | 17.57 | 2.18 | 0.00 | 35.1 | 4.37 | 18.15 | 2.25 |
| foot_side.stl | 2 | PLA | light (base) | 13.47 | 1.14 | 0.93 | 26.9 | 2.29 | 14.87 | 1.23 |
| foot_top.stl | 2 | PLA | rings (base + 2 insert rings) | 23.42 | 2.06 | 1.19 | 46.8 | 4.11 | 31.63 | 2.69 |
| head.stl | 1 | PLA | heavy (insert) | 262.01 | 21.77 | 29.47 | 262.0 | 21.77 | 262.01 | 21.96 |
| head_bot_sheet.stl | 1 | PLA | light (base) | 57.16 | 3.76 | 0.04 | 57.2 | 3.76 | 57.52 | 3.88 |
| head_pad.stl | 1 | TPU | light (base) | 0.93 | 0.18 | 0.00 | 0.9 | 0.18 | - | - |
| head_pitch_to_yaw.stl | 1 | PLA | heavy (neck) | 24.75 | 2.65 | 4.37 | 24.8 | 2.65 | 16.57 | 1.73 |
| head_roll_mount.stl | 1 | PLA | heavy (neck+fit) | 15.74 | 1.42 | 0.40 | 15.7 | 1.42 | 15.74 | 1.42 |
| head_yaw_to_roll.stl | 1 | PLA | heavy (neck+fit) | 29.05 | 2.81 | 1.83 | 29.1 | 2.81 | 29.04 | 2.81 |
| hip_pad.stl | 2 | TPU | light (base) | 0.24 | 0.03 | 0.00 | 0.5 | 0.07 | - | - |
| knee_bumper.stl | 2 | TPU | light (base) | 1.20 | 0.15 | 0.00 | 2.4 | 0.30 | - | - |
| knee_to_ankle_left_sheet.stl | 2 | PLA | heavy (wall3+fit) | 6.72 | 0.63 | 0.20 | 13.4 | 1.27 | 6.98 | 0.64 |
| knee_to_ankle_right_sheet.stl | 2 | PLA | heavy (wall3+fit) | 6.07 | 0.59 | 0.18 | 12.1 | 1.18 | 6.32 | 0.60 |
| left_antenna_holder.stl | 1 | PLA | heavy (wall3) | 3.57 | 0.28 | 0.05 | 3.6 | 0.28 | 3.57 | 0.28 |
| left_cache.stl | 1 | PLA | light (base) | 49.55 | 4.38 | 2.40 | 49.5 | 4.38 | 77.34 | 5.97 |
| left_eye.stl | 1 | PLA | heavy (wall3) | 1.82 | 0.17 | 0.00 | 1.8 | 0.17 | 1.80 | 0.18 |
| left_roll_to_pitch.stl | 1 | PLA | heavy (wall3+fit), D38 | 25.83 | 2.42 | 1.53 | 25.8 | 2.42 | 24.82 | 2.31 |
| leg_spacer.stl | 2 | PLA | rings (base + 4 insert rings) | 6.01 | 0.72 | 0.05 | 12.0 | 1.45 | 8.83 | 1.00 |
| neck_left_sheet.stl | 1 | PLA | heavy (neck) | 7.49 | 0.70 | 0.17 | 7.5 | 0.70 | 7.49 | 0.70 |
| neck_pad.stl | 2 | TPU | light (base) | 0.23 | 0.04 | 0.00 | 0.5 | 0.09 | - | - |
| neck_right_sheet.stl | 1 | PLA | heavy (neck) | 6.68 | 0.62 | 0.18 | 6.7 | 0.62 | 6.55 | 0.61 |
| neck_stop.stl | 1 | PLA | heavy (neck) | 14.70 | 1.38 | 0.17 | 14.7 | 1.38 | - | - |
| right_antenna_holder.stl | 1 | PLA | heavy (wall3) | 3.57 | 0.28 | 0.05 | 3.6 | 0.28 | 3.57 | 0.28 |
| right_cache.stl | 1 | PLA | light (base) | 49.56 | 4.37 | 2.39 | 49.6 | 4.37 | 77.32 | 6.03 |
| right_eye.stl | 1 | PLA | heavy (wall3) | 4.50 | 0.36 | 0.00 | 4.5 | 0.36 | 4.56 | 0.38 |
| right_roll_to_pitch.stl | 1 | PLA | heavy (wall3+fit), D38 | 25.80 | 2.44 | 1.53 | 25.8 | 2.44 | 24.82 | 2.33 |
| roll_motor_bottom.stl | 2 | PLA | heavy (wall3) | 8.75 | 0.72 | 0.60 | 17.5 | 1.43 | 8.75 | 0.72 |
| roll_motor_top.stl | 2 | PLA | light (fit) | 7.14 | 0.73 | 0.41 | 14.3 | 1.46 | 8.00 | 0.80 |
| roll_pad_left.stl | 1 | TPU | light (base) | 0.11 | 0.04 | 0.00 | 0.1 | 0.04 | - | - |
| roll_pad_right.stl | 1 | TPU | light (base) | 0.11 | 0.04 | 0.00 | 0.1 | 0.04 | - | - |
| shin_left_sheet.stl | 2 | PLA | heavy (wall3+fit) | 11.58 | 1.09 | 1.18 | 23.2 | 2.18 | - | - |
| shin_right_sheet.stl | 2 | PLA | heavy (wall3+fit) | 11.09 | 1.07 | 1.18 | 22.2 | 2.15 | - | - |
| shin_spacer.stl | 2 | PLA | rings (base + 4 insert rings) | 7.28 | 0.94 | 0.00 | 14.6 | 1.88 | - | - |
| sit_bumper.stl | 1 | TPU | light (sparse) | 12.18 | 1.46 | 0.00 | 12.2 | 1.46 | - | - |
| sit_seat.stl | 1 | TPU | light (sparse) | 22.61 | 2.67 | 0.00 | 22.6 | 2.67 | - | - |
| speaker_interface.stl | 1 | PLA | light (base) | 2.35 | 0.22 | 0.00 | 2.4 | 0.22 | 2.33 | 0.22 |
| speaker_stand.stl | 1 | PLA | heavy (wall3) | 10.03 | 1.11 | 2.39 | 10.0 | 1.11 | 10.11 | 1.16 |
| trunk_bottom.stl | 1 | PLA | heavy (insert+fit) | 41.99 | 3.54 | 0.28 | 42.0 | 3.54 | 41.99 | 3.54 |
| trunk_top.stl | 1 | PLA | heavy (wall3+fit) | 75.08 | 6.13 | 7.79 | 75.1 | 6.13 | 75.08 | 6.14 |

| Material | Parts | Grams | Hours | of which support g | Before grams | Before hours |
|---|---|---|---|---|---|---|
| PLA | 51 | 1280.4 | 110.6 | 101.9 | 1372.7 | 114.4 |
| TPU | 17 | 75.1 | 9.3 | 0.0 | 36.3 | 4.5 |
| Total | 68 | 1355.5 | 119.9 | 101.9 | 1409.0 | 118.9 |

D38 (2026-11-05): left and right roll_to_pitch re-sliced with wall3+fit (slice.py parts --only). The plate rows below add each part's own change; the plates were not re-planned.

On the robot (grams less support, the way sim/mass_budget.py counts a printed part): 1190.4 g, 1318.6 g before (-128.2 g).

S1 gate fallback: if a light coupon (C2aL, C2bL, C3L) fails, the 10 parts with insert rings (body_middle_bottom x1, body_middle_top x1, foot_bottom_pla x2, foot_top x2, leg_spacer x4) print with their heavy overrides (insert, 4 walls) and no rings: +62.0 g filament, +61.7 g on the robot, +3.99 h (the 'before' columns of these parts).

Spares (G5, G6, one set, printed in the plates below): PLA 10 parts, 104.6 g, 9.8 h

## Plates, 220 bed

| Plate | Parts | g | h | fits |
|---|---|---|---|---|
| L1-1_PLA_base | foot_side x1, left_cache x1 | 71.0 | 6.10 | yes |
| L1-2_PLA_base_rings | foot_bottom_pla x1 (rings), foot_top x1 (rings), leg_spacer x2 (rings) | 48.2 | 4.58 | yes |
| L1-3_PLA_fit | left_roll_to_pitch x1 (wall3+fit, D38), roll_motor_top x1 | 32.0 | 3.05 | yes |
| L1-4_PLA_wall3 | roll_motor_bottom x1 | 8.7 | 0.72 | yes |
| L1-5_PLA_wall3_fit | knee_to_ankle_left_sheet x2, knee_to_ankle_right_sheet x2 | 26.5 | 2.50 | yes |
| P220-01_PLA_base | head_bot_sheet x1 | 56.9 | 3.83 | yes |
| P220-02_PLA_base | battery_pack_lid x1, body_front x1, bulb x2, flash_light_module x1, foot_side x1, right_cache x1, speaker_interface x1 | 157.7 | 12.51 | yes |
| P220-03_PLA_base | body_back x1 (rings), flash_reflector_interface x1 | 80.7 | 6.67 | yes |
| P220-04_PLA_base_rings | body_middle_bottom x1 (rings), foot_bottom_pla x1 (rings), foot_top x1 (rings), leg_spacer x2 (rings) | 155.9 | 14.03 | yes |
| P220-05_PLA_base_rings | body_middle_top x1 (rings) | 75.2 | 6.75 | yes |
| P220-06_PLA_fit | right_roll_to_pitch x1 (wall3+fit, D38), roll_motor_top x1 | 31.9 | 3.07 | yes |
| P220-07_PLA_insert | head x1 | 262.0 | 21.92 | yes |
| P220-08_PLA_insert_fit | trunk_bottom x1 | 42.0 | 3.53 | yes |
| P220-09_PLA_neck | head_pitch_to_yaw x2 (1 spare), neck_left_sheet x2 (1 spare), neck_right_sheet x2 (1 spare) | 61.1 | 6.11 | yes |
| P220-10_PLA_neck_fit | head_roll_mount x2 (1 spare), head_yaw_to_roll x2 (1 spare) | 89.6 | 8.56 | yes |
| P220-11_PLA_wall3 | left_antenna_holder x2 (1 spare), right_antenna_holder x2 (1 spare), right_eye x1, roll_motor_bottom x2 (1 spare), speaker_stand x1 | 46.1 | 4.03 | yes |
| P220-12_PLA_wall3_fit | knee_to_ankle_left_sheet x3 (1 spare), knee_to_ankle_right_sheet x3 (1 spare), trunk_top x1 | 114.8 | 9.87 | yes |
| P220-13_TPU_base | foot_bottom_tpu x1 | 17.6 | 2.19 | yes |
| Total | 18 jobs | 1378.0 | 119.9 | |

S1 gate fallback, 220 bed: if a light coupon fails, print these plates (same parts, same places) with the profile below and no rings:

| Plate | Profile | g | h | fits | change g | change h |
|---|---|---|---|---|---|---|
| L1-2_PLA_base_rings | insert | 60.0 | 5.60 | yes | +11.7 | +1.02 |
| P220-04_PLA_base_rings | insert | 176.7 | 15.19 | yes | +25.2 | +1.93 |
| P220-05_PLA_base_rings | insert | 99.0 | 7.76 | yes | +24.5 | +1.15 |
| Total | 68 | 1355.5 | 119.9 | 101.9 | +61.5 | +4.11 |

With the fallback the full print is 18 jobs, 1426.8 g and 122.7 h.

## Plates, 256 bed

| Plate | Parts | g | h | fits |
|---|---|---|---|---|
| L1-1_PLA_base | foot_side x1, left_cache x1 | 71.0 | 6.10 | yes |
| L1-2_PLA_base_rings | foot_bottom_pla x1 (rings), foot_top x1 (rings), leg_spacer x2 (rings) | 48.4 | 4.58 | yes |
| L1-3_PLA_fit | left_roll_to_pitch x1 (wall3+fit, D38), roll_motor_top x1 | 32.0 | 3.05 | yes |
| L1-4_PLA_wall3 | roll_motor_bottom x1 | 8.7 | 0.72 | yes |
| L1-5_PLA_wall3_fit | knee_to_ankle_left_sheet x2, knee_to_ankle_right_sheet x2 | 26.6 | 2.51 | yes |
| P256-01_PLA_base | bulb x2, flash_light_module x1, flash_reflector_interface x1, head_bot_sheet x1, right_cache x1, speaker_interface x1 | 131.2 | 10.44 | yes |
| P256-02_PLA_base | battery_pack_lid x1, body_back x1 (rings), body_front x1, foot_side x1 | 164.2 | 12.73 | yes |
| P256-03_PLA_base_rings | body_middle_bottom x1 (rings), foot_bottom_pla x1 (rings), foot_top x1 (rings), leg_spacer x2 (rings) | 156.1 | 13.95 | yes |
| P256-04_PLA_base_rings | body_middle_top x1 (rings) | 75.2 | 6.75 | yes |
| P256-05_PLA_fit | right_roll_to_pitch x1 (wall3+fit, D38), roll_motor_top x1 | 31.9 | 3.07 | yes |
| P256-06_PLA_insert | head x1 | 262.0 | 21.92 | yes |
| P256-07_PLA_insert_fit | trunk_bottom x1 | 42.0 | 3.53 | yes |
| P256-08_PLA_neck | head_pitch_to_yaw x2 (1 spare), neck_left_sheet x2 (1 spare), neck_right_sheet x2 (1 spare) | 61.2 | 6.09 | yes |
| P256-09_PLA_neck_fit | head_roll_mount x2 (1 spare), head_yaw_to_roll x2 (1 spare) | 89.6 | 8.53 | yes |
| P256-10_PLA_wall3 | left_antenna_holder x2 (1 spare), right_antenna_holder x2 (1 spare), right_eye x1, roll_motor_bottom x2 (1 spare), speaker_stand x1 | 46.1 | 4.04 | yes |
| P256-11_PLA_wall3_fit | knee_to_ankle_left_sheet x3 (1 spare), knee_to_ankle_right_sheet x3 (1 spare), trunk_top x1 | 114.7 | 9.87 | yes |
| P256-12_TPU_base | foot_bottom_tpu x1 | 17.6 | 2.19 | yes |
| Total | 17 jobs | 1378.4 | 120.0 | |

S1 gate fallback, 256 bed: if a light coupon fails, print these plates (same parts, same places) with the profile below and no rings:

| Plate | Profile | g | h | fits | change g | change h |
|---|---|---|---|---|---|---|
| L1-2_PLA_base_rings | insert | 60.2 | 5.61 | yes | +11.8 | +1.04 |
| P256-03_PLA_base_rings | insert | 176.3 | 15.06 | yes | +24.5 | +1.88 |
| P256-04_PLA_base_rings | insert | 99.0 | 7.76 | yes | +24.5 | +1.15 |
| Total | 68 | 1355.5 | 119.9 | 101.9 | +60.9 | +4.07 |

With the fallback the full print is 17 jobs, 1426.6 g and 122.8 h.

## Coupons

| File | Material | Profile | g | min | support g |
|---|---|---|---|---|---|
| C1_trunk_bottom_bearing_seat.stl | PLA | insert+fit | 5.46 | 28 | 0.00 |
| C2aL_foot_top_insert_boss_and_switch_slot.stl | PLA | base + 1 insert ring | 4.24 | 27 | 0.16 |
| C2a_foot_top_insert_boss_and_switch_slot.stl | PLA | insert | 6.31 | 38 | 0.00 |
| C2bL_foot_top_insert_boss.stl | PLA | base + 1 insert ring | 1.84 | 12 | 0.00 |
| C2b_foot_top_insert_boss.stl | PLA | insert | 2.13 | 14 | 0.00 |
| C3L_foot_bottom_pla_blind_insert_bore.stl | PLA | base + 1 insert ring | 2.33 | 12 | 0.00 |
| C3_foot_bottom_pla_blind_insert_bore.stl | PLA | insert | 2.66 | 13 | 0.00 |
| C4_head_yaw_to_roll_servo_pocket.stl | PLA | neck+fit | 9.45 | 61 | 1.43 |
| T1_left_eye_whole.stl | PLA | wall3 | 1.80 | 11 | 0.00 |
| T1b_bulb_whole.stl | PLA | base | 2.04 | 10 | 0.00 |
| T1w_head_wall_left_eye.stl | PLA | insert | 3.03 | 31 | 0.54 |
| T2_foot_bottom_tpu_whole.stl | TPU | base | 17.57 | 131 | 0.00 |
| job S1_PLA_coupons | PLA | per object | 41.21 | 249 | 2.09 |
| job S2_TPU_coupons | TPU | per object | 17.57 | 131 | 0.00 |

## Optional expression parts (not in the totals above)

| Part | Qty | Material | g each | min each | support g each | g for qty | h for qty |
|---|---|---|---|---|---|---|---|
| antenna.stl | 2 | PLA | 0.89 | 6 | 0.33 | 1.78 | 0.19 |
| antenna.stl | 2 | TPU | 0.54 | 4 | 0.00 | 1.08 | 0.14 |
