aaltaay/Open_Duck_Mini_v2/altaay_lab/history/2026-11-04_1855_v1_assembly.md

# 2026-11-04 6:55 PM ET: V1 track 2, assembly twin

Agent: V1 track 2 (Claude Code), for the lead, branch claude/v1-elec, local commits only. CAD check only and calc only. Nothing printed, bought or sent.

- Asked (V1_PLAN.md track 2): is every part held, can every screw be driven in some order, can the cells, microSD and Pi be serviced, does the mass count every piece, D29 eye lamps, a button for the 2813 swap.
- Mid-task from the lead: D30 approved at 5:58 PM ET (apply the 2813 swap in full); D29 reverted by Ahmed at about 6:45 PM ET (D33): keep the side lamp, keep only the viewer LED labels.
- Done: twin/assembly/asm_geom.py (tool path casts for the 286 driven screws, build order with a subassembly merge model and a check, service casts, side lamp contact, button cutout and plate), asm_calc.py (hold against the mid fall and VHB 4950, mass recount, D30 numbers, BUILD_ORDER.md), ASSEMBLY_TWIN.md.
- Found and fixed: side lamp held by nothing (VHB on 1018 mm2, SF 3.5); BEC tipping SF 1.1 (tie, SF 4.2); no cross-head driver in the BOM (3 Wera tools, need Ahmed's OK); 10 unreachable screws (order, 25 mm bit, short arm, neck turn: 0 violations); battery lid faces into the trunk (body_back pull procedure); D30 applied (BOM 10 and 10b, plate STL, wiring texts, TEST_PLAN, B49).
- Left: microSD needs head_bot_sheet off (RISK); tie and mount masses not published (B59); the NKK button is out of stock at the two stores read.
- Sources: Pololu 2813 page (curl); search index for Bondhus key sizes, Wera drivers and bit, NKK MB2000, VHB 4950 values, Panduit tie weight (crawfordtool.com, findtape.com and multimedia.3m.com are not reachable from this session).
