aaltaay/Open_Duck_Mini_v2/altaay_lab/history/2026-11-02_0022_d22_light_print_profile.md

# D22 light print profile adopted: print package sliced again

- When: 2026-11-02 12:22 AM (America/New_York)
- Source: this commit, branch claude/finish-pass; print package update by the print sub-agent (agent PP) for the lead
- Written: 2026-11-02 by the Claude Code agent

- DECISIONS.md D22 (12:12 AM ET): adopt print/MASS_STUDY.md variant (c). 2 walls unless a rule needs more; a solid ring (100 % infill modifier) round the 40 insert bores of the 10 insert parts and the 5 body_back pilots instead of walls on the whole part; the head (4 walls), neck chain (5 walls, 40 %), knee sheets, roll_motor_bottom, antenna holders, trunk_top, trunk_bottom, eyes, speaker stand and all spares keep their settings. Gate: light coupons C2aL, C2bL and C3L print next to C2a, C2b and C3 in session S1; if one fails, the 10 insert parts keep 4 walls (+61.7 g on the robot).
- print/config/: pla_print.ini and tpu_print.ini are now the light files (2 walls) from config_light/, plus ovr_wall3.ini and mod_ring.ini; the old base files stay as pla_print_heavy.ini and tpu_print_heavy.ini. parts.csv gains the columns profile (light, rings or heavy), rings and heavy (the overrides before D22), and each reason names the profile. slice.py finds the holes in each print-oriented STL and adds the rings as modifiers, writes every plate as a 3MF, keeps the gated parts on plates of their own and also slices their fallback, slices the package before D22 with `--set heavy`, and writes the whole SLICE_SUMMARY.md (`summary --before`). make_coupons.py adds the light copies (same cuts; all 10 coupons re-measured OK); T1 now prints with wall3 because the eyes keep 3 walls. mass_study.py reads the heavy set for variant b and shares the ring code with slice.py; config_light/ is unchanged.
- Checks [L]: the light parts run equals MASS_STUDY.md variant (c) on all 36 STLs (1280.3 g, 1190.4 g on the robot, 111.1 h). The heavy run equals the old SLICE_SUMMARY.md (1409.0 g, 118.9 h) and the old 220 plates (15 jobs, 1474.5 g PLA, every plate within 0.1 g and 0.04 h). mass_study.py reproduces its variants b and c.
- New numbers (PrusaSlicer 2.7.2, generic printer, estimates; nothing printed): S1 9 coupons, 36.2 g, 3.60 h (was 6 coupons, 27.8 g, 2.76 h; now 0.6 h over the 3 h target); S2 sole 17.6 g, 2.19 h (was 18.2 g, 2.25 h). Full print on a 220 bed: 18 jobs (5 left leg plates, then 13), 1347.8 g PLA, 17.6 g TPU, 118.6 h (was 15 jobs, 1474.5 g, 18.1 g, 126.4 h); 256 bed: 17 jobs, 1348.2 g PLA, 17.6 g TPU, 118.7 h (was 14). PLA need 1384 g (was 1502 g). The 3 more jobs come from the extra profiles (wall3, wall3+fit, base with rings), one plate each. Gate fallback: the 3 "base + rings" plates with 4 walls and no rings, +61.5 g and +4.1 h on a 220 bed.
- BOM.md line 27: Need text now 1384 g sliced (1445 g if the gate fails); Buy 2 x 1 kg stands. audit/bom_totals.py (totals unchanged) and audit/bom_md_to_json.py (80 rows) re-run.
- sim/MASS_BUDGET.md: sim/mass_budget.py re-run unchanged on the new SLICE_SUMMARY.md: 2638.6 g, +25 % over the trained 2107.1 g (was 2766.9 g, +31 %); only the printed parts changed (1318.6 g to 1190.4 g); home pose centre of mass (-27.6, 0.4, 49.8) mm, 1.0 mm ahead of the ankle axes. Tables, sim/mass_budget.png and the numbers in the text updated. Sim pass only.
- print/PRINT_PLAN.md "After printing" step 4 (D24, from the coordinator): drill a 4.0 mm hole through the printed head for the D7 projector leads, in the left side wall, 34.8 mm above the bottom face and 36.5 mm behind the front face, 2.5 mm behind flash_light_module and level with its lead channel (measured on head.stl). The BOM has no 4.0 mm bit yet.
- Open: STATE.md line 14 and verify/c9_docs.py (it hardcodes 1474.5 + 27.8 for BOM line 27) still carry the numbers before D22; BOM line 28 says 36 g TPU, the light soles need 35.1 g; START_HERE.md, TEST_PLAN.md (weighing step), SERVO_UPGRADE_OPTIONS.md, VERIFICATION.md, sim/ADDED_MASS_SIM.md, sim/POWER_FIX.md, sim/POWER_PATH_SIM.md, sim/RUNTIME_THERMAL.md, sim/power_fix.py and verify/c8_policy_mass.py still name the 2.77 kg build (now 2.64 kg).
