aaltaay/Open_Duck_Mini_v2/altaay_lab/history/2026-11-01_2300_wiring_sheets.md

# Clean wiring sheets, one subsystem per sheet

- When: 2026-11-01 11:00 PM (America/New_York)
- Source: this commit, branch claude/every-part; drawings by the wiring sheets sub-agent (agent W), after Ahmed said the earlier drawings were not clean
- Written: 2026-11-01 by the Claude Code agent

- wiring/sheets/: 1_power, 2_servo_bus, 3_pi_sensors, 4_head_expression, 5_harness (SVG and 200 dpi PNG each), generated by make_sheets.py with sheetlib.py from wiring/netlist.yaml. Orthogonal wires only, the insulation colour drawn, every wire labelled with cable id, gauge and cut length, title block, legend, cross-sheet references. Sheets 1 to 4 draw all 118 active wires terminal to terminal; sheet 5 shows all 45 cables through the body. The generator stops if any active wire or cable is missing (tested with an altered netlist). Print on A3.
- WIRING_SHEETS.md: index, per-sheet coverage, conventions and how to regenerate. These sheets supersede wiring/odm_v2_wiring_pictorial, odm_v2_schematic and odm_v2_harness (kept for history).
- Netlist questions it raised (for the next netlist pass): component refs D1 to D3 and S1 reuse cable ids; the servo BUS groups need cavity numbers for the made leads (TEST_PLAN says GND, VCC, DATA); several terminal orders are marked unchecked on the parts; P11 BEC leads and kit cables have no gauge or colour in the netlist.
