aaltaay/Open_Duck_Mini_v2/altaay_lab/history/2026-11-01_1932_print_package.md

# Print package: slicer configs, coupons cut from the real parts, slice summary, ready for Ahmed's OK

- When: 2026-11-01 7:32 PM (America/New_York)
- Source: this commit, branch claude/print-ready
- Written: 2026-11-01 by the Claude Code agent (print package by its print sub-agent)

- print/PRINT_PLAN.md (what Ahmed approves at the top), print/SLICE_SUMMARY.md, print/parts.csv, print/config/ (generic 0.4 mm printer, PLA and TPU settings, overrides for insert walls, fit faces and the neck chain), scripts make_coupons.py, slice.py, check_hip_roll_screw.py, joint_risk.py. G-code, 3MF and coupon STLs stay out of git.
- PrusaSlicer 2.7.2 estimates, generic printer, not printed results: coupon session 5.0 h (S1 PLA plate 2.76 h with C1 bearing seat, C2a/C2b insert bosses and switch slot, C3 blind insert bore, C4 tight servo pocket, T1 left eye; S2 TPU sole 2.25 h), 27.8 g PLA and 18.2 g TPU. Full print on a 220 mm bed: 15 jobs, left leg first, 1474.5 g PLA, 18.1 g TPU, 126.4 h, including 10 spares. Robot set alone: 1372.7 g PLA, 114.4 h; 36.3 g TPU, 4.5 h. Fits the 2 kg PLA and 1 kg TPU in the BOM.
- Upstream issues handled: neck chain parts printed stronger (issue 33), spares and a hanging-robot rule for the offset script (Runtime issue 32), the hip roll screw interference confirmed in the CAD (issue 17), decided by D18 (leave the outer screw out, check rigidity on the first leg) and added as blocker B30.
- Doc fixes from the print check: 36 STLs (not 38), the 6.7 mm insert bore did not exist (B15), PrusaSlicer has no hole-only compensation (B14), the antennas are 1.8 mm rods printed in PLA, PLA need 1502 g (BOM line 27).
- Ahmed's OK is still needed before any print (lab rule 4).
