aaltaay/Open_Duck_Mini_v2/altaay_lab/wiring/sheets/WIRING_SHEETS.md

# WIRING_SHEETS: per-subsystem wiring drawings

Generated by `wiring/sheets/make_sheets.py` on 2026-11-13 23:01 EST (TZ=America/New_York date) from `wiring/netlist.yaml` rev 2026-11-06 (sha256 e54df0e2ea0b). Do not edit by hand: change netlist.yaml and run the generator again. Owner: wiring drawings agent (W).

These five sheets redraw the wiring one subsystem per sheet: blocks with their real terminal names, connectors with their pin order, orthogonal wires in the insulation colour, and a label on every wire (cable id, gauge, cut length, colour code). Every wire is looked up in the netlist by its two end pins and drawn from one placed terminal to the other, so a sheet cannot show a connection the netlist does not have.

## Sheets

| Sheet | Files | Shows | Crossings (hops) |
|---|---|---|---|
| 1 Power | [1_power.svg](1_power.svg), [1_power.png](1_power.png) (897 kB) | pack BT1, BMS U5, charger U6, XT30 J1, fuse F1 with the lead splices JFI JFO, Pololu 2815 SW1 and panel switch SW2, splices VSW and G, BEC U1 with JB+ JB-, belly splices SPV SPG, the first-servo power feeds SP1 to SP3 with JG20 JG30 JG10 (SP4 SP5 cross-referenced to sheet 2), and the 5 V branch P13 up the neck to U3 and P12 to Pi pins 2 and 6 | 49 |
| 2 Servo bus | [2_servo_bus.svg](2_servo_bus.svg), [2_servo_bus.png](2_servo_bus.png) (793 kB) | adapter U2 (DATA and GND only, D15), Y splices YD3 YG3, made leads SD1 SD2 and the SP tails, the 3 chains in ID order (neck 30 to 33, left leg 20 to 24, right leg 10 to 14) with every kit cable conductor, power injection at BUS 2 of IDs 30, 20, 10, and the second feeds SP4 SP5 from SPV SPG into BUS 1 of IDs 24 and 14 (D23) | 2 |
| 3 Pi and sensors | [3_pi_sensors.svg](3_pi_sensors.svg), [3_pi_sensors.png](3_pi_sensors.png) (759 kB) | the 40-pin header with every wire that leaves it (sensor wires in full, the rest as flagged stubs), BNO055 U7, foot switches SR1 SR2 SL1 SL2 with jumpers and pull-ups R4 R5, USB cable D1 to the adapter | 1 |
| 4 Head expression | [4_head_expression.svg](4_head_expression.svg), [4_head_expression.png](4_head_expression.png) (677 kB) | eye and projector LEDs LED1 to LED3 with R1 to R3, antenna SG90s M1 M2, MAX98357A U8 and speaker LS1, camera U9, splices J5 and JG fed by P17 | 72 |
| 5 Harness overview | [5_harness.svg](5_harness.svg), [5_harness.png](5_harness.png) (907 kB) | body regions and joints, a lane per cable that leaves its region, local cables per region, and a table of all active cables (run, wire, cut length, joints crossed) | 10 |
| 6 Touch and cliff | [6_touch_cliff.svg](6_touch_cliff.svg), [6_touch_cliff.png](6_touch_cliff.png) (526 kB) | the two MPR121 touch boards TCHH (0x5A) and TCHB (0x5B) with the pads PH1, PH2 and PB1, the BNO055 tap D19 and the cliff ToF with its interrupt to GPIO17 (D51, D54) | 25 |

All sheets are A3 landscape (420 x 297 mm) with a zone grid (columns 1 to 8, rows A to F). A flag or note such as "sheet 4, zone E3" points to where the far end of that wire is drawn. PNGs are 200 dpi; the SVGs carry the text as outlines so they look the same on any phone or browser (the SVG text is therefore not searchable). Print on A3 or tabloid at 100 %: wire labels are 7.4 pt and the smallest notes 6 pt. On Letter (fit to page, 66 %) that becomes about 5 pt and 4 pt: fine for an overview, use A3 or the phone at the bench.

## Coverage

The netlist has 199 active wires (one row per conductor in `wires`) on 65 active cables. A wire counts as drawn on a sheet only when it is drawn in full, terminal to terminal. A stub is the start of a wire that is drawn in full on another sheet; it ends in a flag that carries the wire label and the sheet and zone of the far end. The generator stops with an error if any active wire is not drawn in full on at least one of sheets 1 to 4 and 6, or if any active cable is missing from sheet 5.

| Sheet | Wires drawn in full / wires in the netlist | Share | Stubs (drawn in full elsewhere) | Cables touched |
|---|---|---|---|---|
| 1 Power | 52 / 199 | 26 % | 0 | 23 |
| 2 Servo bus | 48 / 199 | 24 % | 7 | 19 |
| 3 Pi and sensors | 17 / 199 | 9 % | 16 | 13 |
| 4 Head expression | 37 / 199 | 19 % | 0 | 12 |
| 6 Touch and cliff | 19 / 199 | 10 % | 0 | 7 |
| Sheets 1 to 4 together | 170 / 199 | 85 % | | 61 / 65 |
| 5 Harness overview | 199 / 199 as cables | 100 % | | 65 / 65 (lane or local chip, and the table) |

Some wires are drawn in full on two sheets on purpose: the SP1 to SP3 tails (JG to the first servo G) appear on sheets 1 and 2.

### Where each cable is drawn in full

| Cable | Wires | Sheets |
|---|---|---|
| P1 | 1 | 1 |
| P2 | 1 | 1 |
| P3 | 1 | 1 |
| P4 | 1 | 1 |
| P5 | 1 | 1 |
| P6 | 1 | 1 |
| P7 | 4 | 1 |
| P8 | 1 | 1 |
| P9 | 1 | 1 |
| P10 | 2 | 1 |
| P11 | 6 | 1 |
| P12 | 2 | 1 |
| P13 | 2 | 1 |
| P14 | 1 | 1 |
| P15 | 2 | 1 |
| P16 | 1 | 1 |
| P17 | 2 | 4 |
| SP1 | 3 | 1, 2 |
| SP2 | 3 | 1, 2 |
| SP3 | 3 | 1, 2 |
| SP4 | 2 | 2 |
| SP5 | 2 | 2 |
| SD1 | 6 | 2 |
| SD2 | 2 | 2 |
| D1 | 1 | 3 |
| DC1 | 4 | 1 |
| D2 | 4 | 3 |
| DC2 | 2 | 1 |
| D3 | 6 | 3 |
| DC3 | 4 | 1 |
| D4 | 6 | 3 |
| DC4 | 5 | 1 |
| D5 | 3 | 4 |
| D6 | 3 | 4 |
| D7 | 3 | 4 |
| D8 | 3 | 4 |
| D9 | 3 | 4 |
| D10 | 6 | 4 |
| D11 | 2 | 4 |
| D12 | 1 | 4 |
| D13 | 1 | 4 |
| D14 | 5 | 4 |
| D15 | 5 | 4 |
| D16 | 4 | 6 |
| D17 | 2 | 6 |
| D18 | 2 | 6 |
| D19 | 4 | 6 |
| D20 | 2 | 6 |
| D21 | 4 | 6 |
| D22 | 1 | 6 |
| S2 | 3 | 2 |
| S3 | 3 | 2 |
| S4 | 3 | 2 |
| S5 | 3 | 2 |
| S7 | 3 | 2 |
| S8 | 3 | 2 |
| S9 | 3 | 2 |
| S10 | 3 | 2 |
| S11 | 3 | 2 |
| S12 | 3 | 2 |
| S13 | 3 | 2 |
| CE | 4 |  |
| NT | 2 |  |
| NW | 17 |  |
| EF | 6 |  |

## How to regenerate

```
python3 altaay_lab/wiring/sheets/make_sheets.py            # writes the 5 SVG + PNG and this file
python3 altaay_lab/wiring/sheets/make_sheets.py --strict   # also fails on any layout warning
```

Needs Python 3 with matplotlib, PyYAML and Pillow, and the Carlito font (Debian/Ubuntu package fonts-crosextra-carlito). `ODM_NETLIST=path` points the generator at another netlist. Layout lives in `make_sheets.py` (one function per sheet); drawing rules and checks live in `sheetlib.py`: the run stops on an unknown pin pair, a diagonal segment, a wire leaving a terminal the wrong way, a slot used twice, a stub whose wire is not drawn in full elsewhere, or a dash in any drawing text. Layout warnings (labels on other wires, wires through blocks, overlaps) are printed; `--strict` turns them into errors. This run printed 319 layout warning(s).

## Conventions on the sheets

- Seen from behind: robot left is on the left (netlist meta).
- Wire colour = insulation colour from the netlist, with the IEC 60757 code in the label (RD, BK, YE, WH, GN, BU, OG, BN). Grey with white dashes = colour not set by the netlist (kit servo cables, fuse holder leads). Thin grey = bare resistor lead (0 mm wires in the netlist).
- Line weight follows the gauge. Label = cable id (as in CABLE_MAP.md), branch when the netlist has one, gauge, cut length ("as shipped" when the netlist has none), colour code.
- Splices are black dots; a hop is a crossing with no contact; a cross marks a pin that is not connected (nc in the netlist).
- Resistor leads that are soldered straight to a pin carry one tag per resistor instead of a label on each 0 mm lead.
- The servo housings are drawn D V G with V in the middle. The neck row on sheet 2 is drawn G V D only to keep the Y splices from crossing. The netlist numbers the servo pins as the Feetech sheet does (1 GND, 2 Vcc, 3 signal); the Waveshare adapter counts from the other end (1 D, 2 V, 3 G).

## Netlist questions

Open:

1. Component refs D2, D3, D4, D5 are also cable ids (D2, D3, D4, D5 in `cables`): rename them so a label is never ambiguous.
2. Terminal order on the board is marked [I] (not checked) for BNO055, MAX98357A, D30V30F5 and the charger pads, and the panel switch lugs are [I]. The sheets draw these blocks in the order that keeps the wires straight and say so on the sheet; check the order on the parts.

Answered in the netlist pass of 2026-11-02: the LED refs are LED1 to LED3 and the panel switch is SW2; the servo BUS pins carry the Feetech pin numbers (STS3215 sheet item 6-7), and the build sheets say to copy a kit cable housing and check with a meter; SW1 and U1 pins have printable labels (SW, GND, IN+, IN-, 1+, 1-, 2+, 2-); the BEC output lead and kit cable gauges are not published, so they stay as shipped (no AWG in the netlist).

## Relation to the older drawings

These sheets cover what `wiring/odm_v2_wiring_pictorial` (A2), `wiring/odm_v2_schematic` (A3) and `wiring/odm_v2_harness` (A3) show, from the same netlist, and add per-wire labels, pin order, cross-sheet references and a hard coverage check per wire. WIRING.md marks those three and their generators superseded; they are not regenerated and do not show the changes from 2026-11-02 on.
