aaltaay/Open_Duck_Mini_v2/altaay_lab/twin/assembly/BUILD_ORDER.md

# Build order (CAD check only)

Written 2026-11-04 by the V1 track 2 agent from twin/assembly/asm_geom.py (every driven screw: 286 = 342 fitted less the 56 factory case screws inside the servos). Each line is a run of screws in the order they are driven; a part goes on just before its first screw. JOIN marks a screw that joins two subassemblies. Tools: hex2.0 and hex2.5 are the BOM T4 keys (Bondhus long series), PH0 and PH1 the proposed Wera 2050 drivers, the PH0 x 25 mm bit the proposed Wera 851/1 Z (both need Ahmed's OK). The order was checked: no screw's tool path or way in crosses a part that is already joined to it (0 violations, asm_geom.json verify).

2026-11-12 correction, from fasteners.json (cad). F127 and F129 are M2x12, not M2x6. F344 and F347 are M2x5, not M2x4. Steps that drove a left-out screw now drive only the fitted ids. F356 to F359 (mic) and F360, F361 (cliff) are added, with the same PH0 and hex2.0 already used for those sizes. Those six were not in the 286-screw cast, so their tool path is not one of the 0 violations.

1. JOIN 2 x M3x12 DIN 912 A2: trunk_top into trunk_bottom, hex2.5 (F073, F074)
2. JOIN 2 x M2x8 self-tapping pan head: trunk_top into wj-wk00-0124bottomcase_45, PH0 (F049, F050)
3. 2 x M2x6 self-tapping pan head: trunk_top into wj-wk00-0122topcabinetcase_95, PH0 (F138, F139)
4. JOIN 1 x M3x6 machine screw (Feetech rocker screw): drive horn into servo output shaft, PH1 (F322)
5. JOIN 1 x M3x6 machine screw (Feetech rocker screw): drive horn into servo output shaft, PH1 (F334)
6. JOIN 1 x M3x6 machine screw (Feetech rocker screw): drive horn into servo output shaft, PH1 (F330)
7. JOIN 1 x M3x6 machine screw (Feetech rocker screw): drive horn into servo output shaft, PH1 (F342)
8. JOIN 1 x M3x6 machine screw (Feetech rocker screw): drive horn into servo output shaft, PH1 (F324)
9. JOIN 1 x M3x6 machine screw (Feetech rocker screw): drive horn into servo output shaft, PH1 (F336)
10. JOIN 1 x M3x6 machine screw (Feetech rocker screw): drive horn into servo output shaft, PH1 (F326)
11. JOIN 1 x M3x6 machine screw (Feetech rocker screw): drive horn into servo output shaft, PH1 (F338)
12. JOIN 1 x M3x6 machine screw (Feetech rocker screw): drive horn into servo output shaft, PH1 (F328)
13. JOIN 2 x M2x6 self-tapping pan head: trunk_top into wj-wk00-0122topcabinetcase_95, PH0, PH0 x 25 mm bit (F130, F132)
14. JOIN 1 x M3x6 machine screw (Feetech rocker screw): drive horn into servo output shaft, PH1 (F340)
15. JOIN 2 x M2x6 self-tapping pan head: trunk_top into wj-wk00-0122topcabinetcase_95, PH0, PH0 x 25 mm bit (F126, F128)
16. JOIN 1 x PA3.0x5 self-tapping, washer head (Feetech idle screw): idle horn into servo bottom case boss, PH1 (F329)
17. JOIN 1 x PA3.0x5 self-tapping, washer head (Feetech idle screw): idle horn into servo bottom case boss, PH1 (F341)
18. JOIN 1 x M3x6 machine screw (Feetech rocker screw): drive horn into servo output shaft, PH1 (F332)
19. JOIN 1 x M3x6 machine screw (Feetech rocker screw): drive horn into servo output shaft, PH1 (F316)
20. JOIN 1 x M3x6 machine screw (Feetech rocker screw): drive horn into servo output shaft, PH1 (F320)
21. JOIN 1 x M3x6 machine screw (Feetech rocker screw): drive horn into servo output shaft, PH1 (F318)
22. JOIN 1 x PA3.0x5 self-tapping, washer head (Feetech idle screw): idle horn into servo bottom case boss, PH1 (F319)
23. JOIN 2 x M3x10 DIN 912 A2: foot_side into foot_top, hex2.5 (F023, F024)
24. JOIN 2 x M3x8 DIN 912 A2: foot_bottom_tpu into foot_bottom_pla, hex2.5 (F095, F096)
25. JOIN 4 x M3x6 DIN 912 A2: foot_side into passive_palonier, hex2.5 (F164, F166, F168, F251)
26. JOIN 4 x M3x6 DIN 912 A2: foot_top into drive_palonier, hex2.5 (F165, F167, F169, F252)
27. JOIN 2 x M3x10 DIN 912 A2: foot_side into foot_top, hex2.5 (F025, F026)
28. JOIN 2 x M3x8 DIN 912 A2: foot_bottom_tpu into foot_bottom_pla, hex2.5 (F097, F098)
29. JOIN 4 x M3x6 DIN 912 A2: foot_side into passive_palonier, hex2.5 (F170, F172, F174, F257)
30. JOIN 4 x M3x6 DIN 912 A2: foot_top into drive_palonier, hex2.5 (F171, F173, F175, F258)
31. JOIN 2 x M3x6 DIN 912 A2: knee_to_ankle_right_sheet into leg_spacer, hex2.5 (F005, F007)
32. JOIN 2 x M3x6 DIN 912 A2: knee_to_ankle_left_sheet into leg_spacer, hex2.5 (F006, F008)
33. JOIN 2 x M2x6 self-tapping pan head: knee_to_ankle_right_sheet into wj-wk00-0124bottomcase_45, PH0 (F043, F044)
34. 2 x M2x5 self-tapping pan head: knee_to_ankle_left_sheet into wj-wk00-0122topcabinetcase_95, PH0 (F101, F102)
35. JOIN 4 x M3x6 DIN 912 A2: knee_to_ankle_right_sheet into passive_palonier, hex2.5 (F202, F204, F206, F249)
36. JOIN 4 x M3x6 DIN 912 A2: knee_to_ankle_left_sheet into drive_palonier, hex2.5 (F203, F205, F207, F250)
37. JOIN 2 x M3x6 DIN 912 A2: knee_to_ankle_right_sheet into leg_spacer, hex2.5 (F013, F015)
38. JOIN 2 x M3x6 DIN 912 A2: knee_to_ankle_left_sheet into leg_spacer, hex2.5 (F014, F016)
39. JOIN 2 x M2x6 self-tapping pan head: knee_to_ankle_right_sheet into wj-wk00-0124bottomcase_45, PH0 (F047, F048)
40. 2 x M2x5 self-tapping pan head: knee_to_ankle_left_sheet into wj-wk00-0122topcabinetcase_95, PH0 (F105, F106)
41. JOIN 4 x M3x6 DIN 912 A2: knee_to_ankle_right_sheet into passive_palonier, hex2.5 (F214, F216, F218, F255)
42. JOIN 4 x M3x6 DIN 912 A2: knee_to_ankle_left_sheet into drive_palonier, hex2.5 (F215, F217, F219, F256)
43. JOIN 2 x M3x10 DIN 912 A2: left_cache into leg_spacer, hex2.5 (F001, F003)
44. JOIN 1 x M3x6 ISO 7380 A2 button head: knee_to_ankle_right_sheet into leg_spacer, hex2.0 (F002)
45. 1 x M3x6 DIN 912 A2: knee_to_ankle_right_sheet into leg_spacer, hex2.5 (F004)
46. JOIN 2 x M2x5 self-tapping pan head: knee_to_ankle_left_sheet into wj-wk00-0122topcabinetcase_95, PH0 (F099, F100)
47. JOIN 4 x M3x6 ISO 7380 A2 button head: knee_to_ankle_right_sheet into passive_palonier, hex2.0 (F196, F198, F200, F247)
48. JOIN 4 x M3x6 DIN 912 A2: knee_to_ankle_left_sheet into drive_palonier, hex2.5 (F197, F199, F201, F248)
49. JOIN 2 x M3x10 DIN 912 A2: right_cache into leg_spacer, hex2.5 (F009, F011)
50. JOIN 1 x M3x6 ISO 7380 A2 button head: knee_to_ankle_left_sheet into leg_spacer, hex2.0 (F010)
51. 1 x M3x6 DIN 912 A2: knee_to_ankle_left_sheet into leg_spacer, hex2.5 (F012)
52. JOIN 2 x M2x6 self-tapping pan head: knee_to_ankle_right_sheet into wj-wk00-0124bottomcase_45, PH0 (F045, F046)
53. JOIN 4 x M3x6 DIN 912 A2: knee_to_ankle_right_sheet into drive_palonier, hex2.5 (F208, F210, F212, F253)
54. JOIN 4 x M3x6 ISO 7380 A2 button head: knee_to_ankle_left_sheet into passive_palonier, hex2.0 (F209, F211, F213, F254)
55. JOIN 2 x M2x6 self-tapping pan head: left_roll_to_pitch into wj-wk00-0124bottomcase_45, PH0 (F031, F032)
56. 3 x M2x5 self-tapping pan head: left_roll_to_pitch into wj-wk00-0122topcabinetcase_95, PH0 (F134, F144, F145)
57. JOIN 2 x M2x6 self-tapping pan head: knee_to_ankle_right_sheet into wj-wk00-0124bottomcase_45, PH0 (F041, F042)
58. JOIN 4 x M3x6 DIN 912 A2: left_roll_to_pitch into passive_palonier, hex2.5 (F186, F188, F194, F243)
59. JOIN 4 x M3x6 DIN 912 A2: left_roll_to_pitch into drive_palonier, hex2.5 (F187, F189, F195, F244)
60. JOIN 2 x M2x6 self-tapping pan head: right_roll_to_pitch into wj-wk00-0124bottomcase_45, PH0 (F029, F030)
61. 3 x M2x5 self-tapping pan head: right_roll_to_pitch into wj-wk00-0122topcabinetcase_95, PH0 (F137, F146, F147)
62. JOIN 2 x M2x5 self-tapping pan head: knee_to_ankle_left_sheet into wj-wk00-0122topcabinetcase_95, PH0 (F103, F104)
63. JOIN 4 x M3x6 DIN 912 A2: right_roll_to_pitch into passive_palonier, hex2.5 (F184, F190, F192, F245)
64. JOIN 4 x M3x6 DIN 912 A2: right_roll_to_pitch into drive_palonier, hex2.5 (F185, F191, F193, F246)
65. JOIN 4 x M3x6 DIN 912 A2: roll_motor_top into drive_palonier, hex2.5 (F033, F034, F035, F036)
66. JOIN 2 x M2x6 self-tapping pan head: roll_motor_top into wj-wk00-0124bottomcase_45, PH0 (F051, F052)
67. 2 x M2x6 self-tapping pan head: roll_motor_top into wj-wk00-0122topcabinetcase_95, PH0 (F152, F155)
68. JOIN 1 x M2x6 self-tapping pan head: roll_motor_bottom into wj-wk00-0124bottomcase_45, PH0 (F133)
69. JOIN 4 x M3x6 DIN 912 A2: roll_motor_top into drive_palonier, hex2.5 (F037, F038, F039, F040)
70. JOIN 2 x M2x6 self-tapping pan head: roll_motor_top into wj-wk00-0124bottomcase_45, PH0 (F053, F054)
71. 2 x M2x6 self-tapping pan head: roll_motor_top into wj-wk00-0122topcabinetcase_95, PH0 (F153, F154)
72. JOIN 1 x M2x6 self-tapping pan head: roll_motor_bottom into wj-wk00-0124bottomcase_45, PH0 (F135)
73. 4 x M2 self-tapping pan head: trunk_top into wj-wk00-0124bottomcase_45, PH0 (F057, F058, F125 are M2x6; F127 is M2x12 through the neck stop block, D59)
74. 2 x M2x5 self-tapping pan head: trunk_top into wj-wk00-0122topcabinetcase_95, PH0 (F140, F141)
75. 4 x M2 self-tapping pan head: trunk_top into wj-wk00-0124bottomcase_45, PH0 (F059, F060, F131 are M2x6; F129 is M2x12 through the neck stop block, D59)
76. 2 x M2x5 self-tapping pan head: trunk_top into wj-wk00-0122topcabinetcase_95, PH0 (F142, F143)
76b. JOIN 2 x M2.5x6 DIN 912 A2: tof_cliff into body_front, hex2.0, from the back of the board (F360, F361). Drive these while body_front is in the hand.
77. JOIN 2 x M3x8 DIN 912 A2: body_front into body_middle_top, hex2.5 (F067, F068; F065 and F066 out since D38; D42: the 4 corners of body_front)
78. JOIN 2 x M3x8 DIN 912 A2: body_front into body_middle_bottom, hex2.5 (F071, F072; D42: F069 out and its hole closed, F071 back; F070 out since D38)
79. JOIN 4 x M2.5x6 DIN 912 A2: bno055 into trunk_top, hex2.0 (F115, F116, F117, F118)
80. JOIN 2 x M2.5x6 DIN 912 A2: board into trunk_top, hex2.0 (F119, F122; F120 and F121 out)
81. JOIN 1 x M2.5x6 DIN 912 A2: usb_c_charger into body_back, hex2.0 (F123)
82. JOIN 4 x M2.5x10 DIN 912 A2: battery_pack_lid into body_back, hex2.0 (F017, F018, F027, F028; D42: all 4)
83. JOIN 2 x M3x8 DIN 912 A2: body_back into body_middle_bottom, hex2.5 (F077, F078; D38 F075 and D39 F076 out, their holes closed; the shell ears sit on the 4 printed seats)
84. 4 x M3x8 DIN 912 A2: body_back into body_middle_top, hex2.5 (F079, F080, F081, F082)
85. JOIN 2 x M2x6 self-tapping pan head: neck_right_sheet into wj-wk00-0124bottomcase_45, PH0 (F055, F056)
86. JOIN 2 x M2x6 self-tapping pan head: neck_left_sheet into wj-wk00-0122topcabinetcase_95, PH0 (F148, F149)
87. JOIN 4 x M3x5 DIN 912 A2: neck_left_sheet into drive_palonier, hex2.5 (F228, F231, F233, F259)
88. JOIN 4 x M3x5 DIN 912 A2: neck_right_sheet into passive_palonier, hex2.5 (F229, F230, F232, F234)
89. JOIN 4 x M3x10 DIN 912 A2: body_middle_bottom into trunk_bottom, hex2.5 (F019, F020, F021, F022)
90. JOIN 4 x M3x5 DIN 912 A2: head_pitch_to_yaw into passive_palonier, hex2.5 (F220, F222, F224, F226)
91. JOIN 4 x M3x5 DIN 912 A2: head_pitch_to_yaw into drive_palonier, hex2.5 (F221, F223, F225, F227)
92. JOIN 4 x M3x5 DIN 912 A2: head_pitch_to_yaw into passive_palonier, hex2.5 (F235, F237, F239, F241)
93. JOIN 4 x M3x5 DIN 912 A2: head_pitch_to_yaw into drive_palonier, hex2.5 (F236, F238, F240, F242)
94. JOIN 4 x M3x5 DIN 912 A2: head_yaw_to_roll into drive_palonier, hex2.5, 2.5 mm key short arm (F158, F159, F160, F161)
95. JOIN 2 x M2x6 self-tapping pan head: head_yaw_to_roll into wj-wk00-0124bottomcase_45, PH0 (F063, F064)
96. 2 x M2x5 self-tapping pan head: head_yaw_to_roll into wj-wk00-0122topcabinetcase_95, PH0 (F150, F151)
97. JOIN 2 x M2x5 self-tapping pan head: head_roll_mount into wj-wk00-0124bottomcase_45, PH0 (F061, F062)
98. 2 x M2x4 self-tapping pan head: head_roll_mount into wj-wk00-0122topcabinetcase_95, PH0 (F156, F157)
99. JOIN 2 x M2.5x6 DIN 912 A2: raspberrypizerow into head, hex2.0 (F111, F114; F112 and F113 out)
99b. JOIN 4 x M2x6 self-tapping pan head: mic boards into head, PH0 (F356, F357, F358, F359). Drive these before head_bot_sheet.
100. JOIN 2 x M2.5x8 DIN 912 A2 + 2 x 0.3 mm washers: bulb into right_eye, hex2.0 (F176, F181; F177 and F180 out)
101. JOIN 2 x M2.5x8 DIN 912 A2 + 2 x 0.3 mm washers: bulb into left_eye, hex2.0 (F179, F182; D39: F178 and F183 out, their holes closed)
102. JOIN 2 x M2x5 self-tapping pan head: camera PCB into head, PH0 (F344, F347; F345 and F346 out; D34 length is M2x5)
103. JOIN 1 x SG90 bag mounting screw: SG90 tab into head, PH0 (F349)
104. JOIN 1 x SG90 bag mounting screw: SG90 tab into head, PH0 (F351)
105. JOIN 2 x M2.5x5 DIN 912 A2: speaker_interface into speaker_stand, hex2.0 (F353, F354; F352 and F355 out)
106. JOIN 2 x M2.5x6 DIN 912 A2: speaker_stand into head, hex2.0 (F108, F109; F107 and F110 out)
107. JOIN 1 x SG90 bag horn screw: left_antenna_holder into SG90 output shaft, PH0 (F162)
108. JOIN 1 x SG90 bag horn screw: right_antenna_holder into SG90 output shaft, PH0 (F163)
109. JOIN 4 x M3x6 DIN 912 A2: head_roll_mount into head, hex2.5 (F091, F092, F093, F094)
110. JOIN 2 x M3x8 DIN 912 A2: head_bot_sheet into head, hex2.5 (F089, F090; D42: F085 to F088 out, their holes closed)
111. 2 x M3x8 DIN 912 A2: head_bot_sheet into head, hex2.5, turn neck_pitch to -9.4 deg (F083, F084; D42: 4 mirrored corners with F089, F090)
112. 2 x SG90 bag mounting screw: SG90 tab into head, PH0, PH0 x 25 mm bit (F348, F350)

Rules found by the cast (each one is in the order above):
- Trunk core first: trunk_top to trunk_bottom (F073, F074, M3x12) before the centre servo goes in (its case sits 0.0 to 0.1 mm over their heads); the centre servo's side screws F050 and F139 before the hip yaw servos (2.0 mm from their heads); the hip yaw top case screws F126, F128, F130, F132 before the hip roll brackets go on the hip yaw horns (roll_motor_top 1.5 mm from their heads), and with the 25 mm bit (the trunk bearing is 58.5 mm out, inside the 60 mm blade).
- Each horn: the horn centre screw into the servo before the part that covers it; the part to horn screws with the horn on the servo unless the servo body covers them (neck yaw: head_yaw_to_roll to its horn, F158 to F161, own bracket 64.9 mm out: 2.5 mm key with its short arm in the socket, 210 to 250 deg of free swing at 15 to 30 mm).
- Head: camera screws before the head roll servo and head_roll_mount go in; SG90 tab screws F348 and F350 with the 25 mm bit (the head's own wall is 35.6 mm out, inside the 60 mm blade); head_roll_mount to head before head_bot_sheet (sheet 41 mm out); head_bot_sheet F083 and F084 with the neck pitch at -9.4 deg (body_middle_top 74 mm out, inside the 88 mm key).
- Battery bay: the charger screw (F123) before the BMS goes in (BMS 0.7 mm from its head); cells, holder and BMS in before the lid; the fuse holder and the Pololu switch taped on the lid face after the lid screws; antennas into their holders after the holder's horn screw.
