aaltaay/Open_Duck_Mini_v2/altaay_lab/fasteners/fasteners_assembled.png

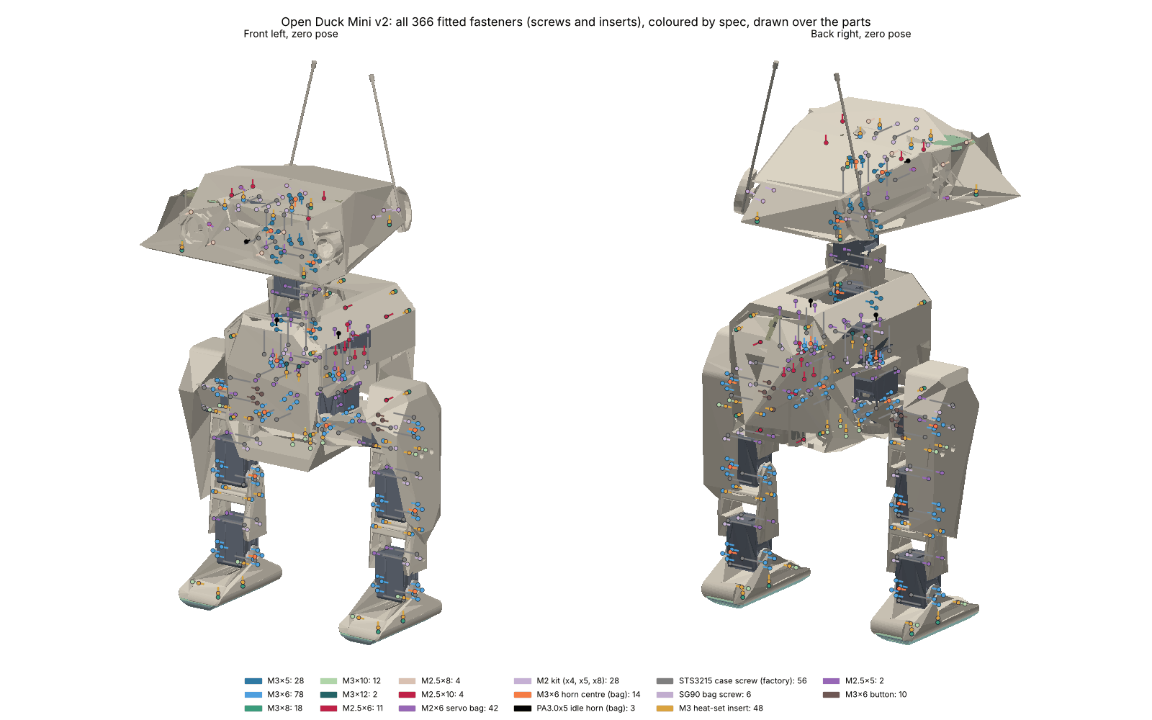
altaay_lab/fasteners/fasteners_assembled.png
