aaltaay/Open_Duck_Mini_v2/altaay_lab/wiring/harness/steps/01_four_plugs.png

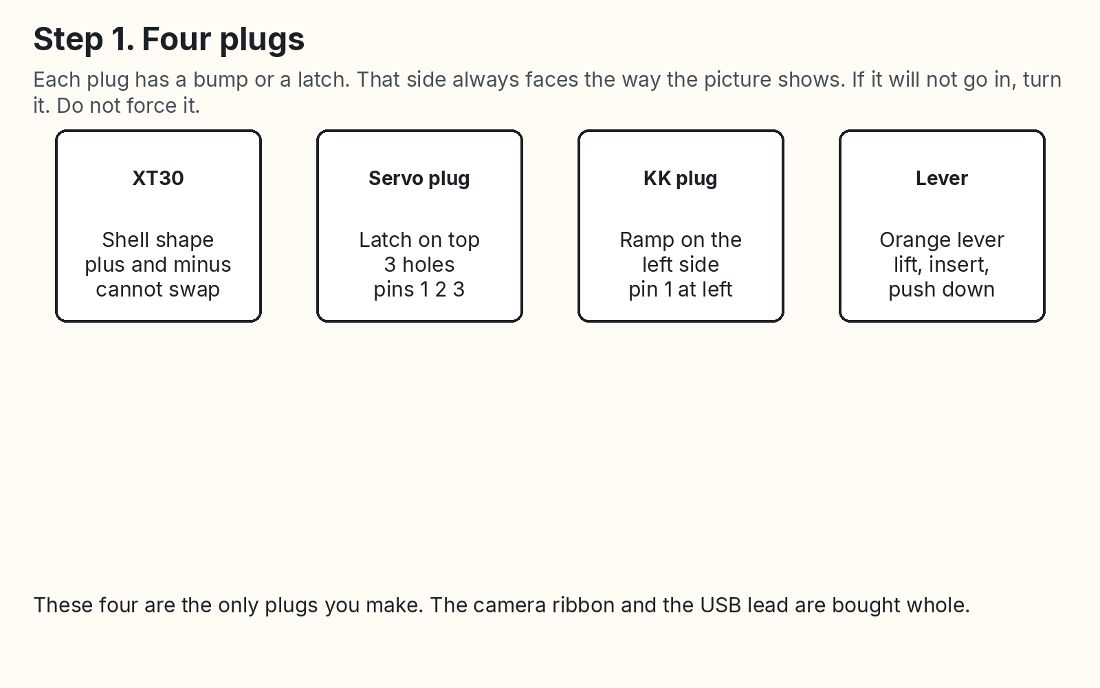
altaay_lab/wiring/harness/steps/01_four_plugs.png
