aaltaay/Open_Duck_Mini_v2/altaay_lab/wiring/harness/steps/02_pack_to_bms.png

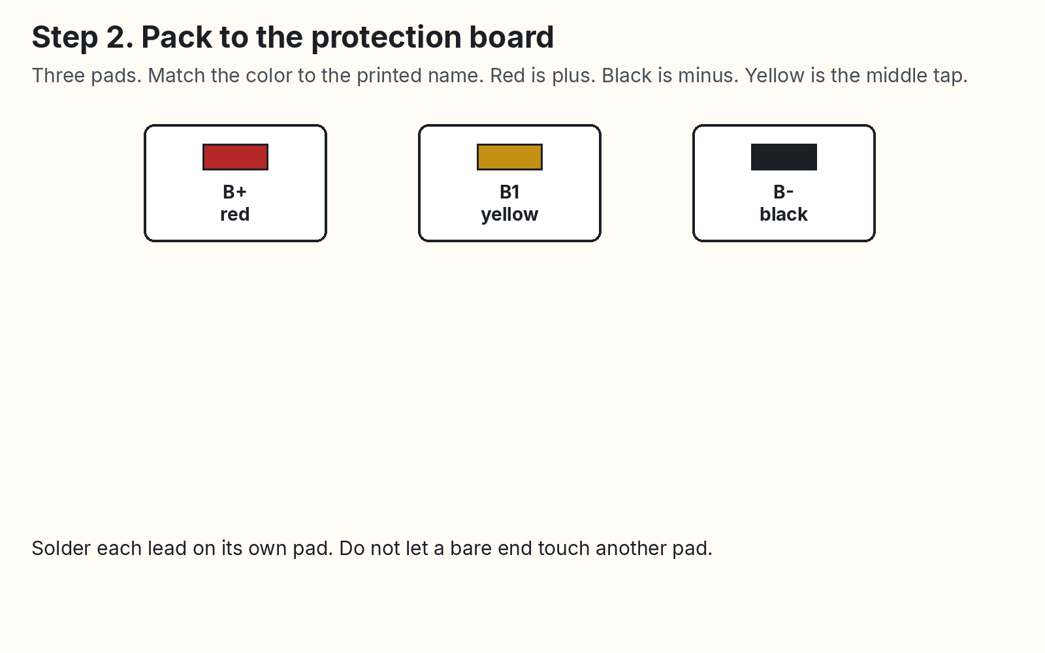
altaay_lab/wiring/harness/steps/02_pack_to_bms.png
