aaltaay/Open_Duck_Mini_v2/altaay_lab/wiring/harness/steps/03_xt30.png

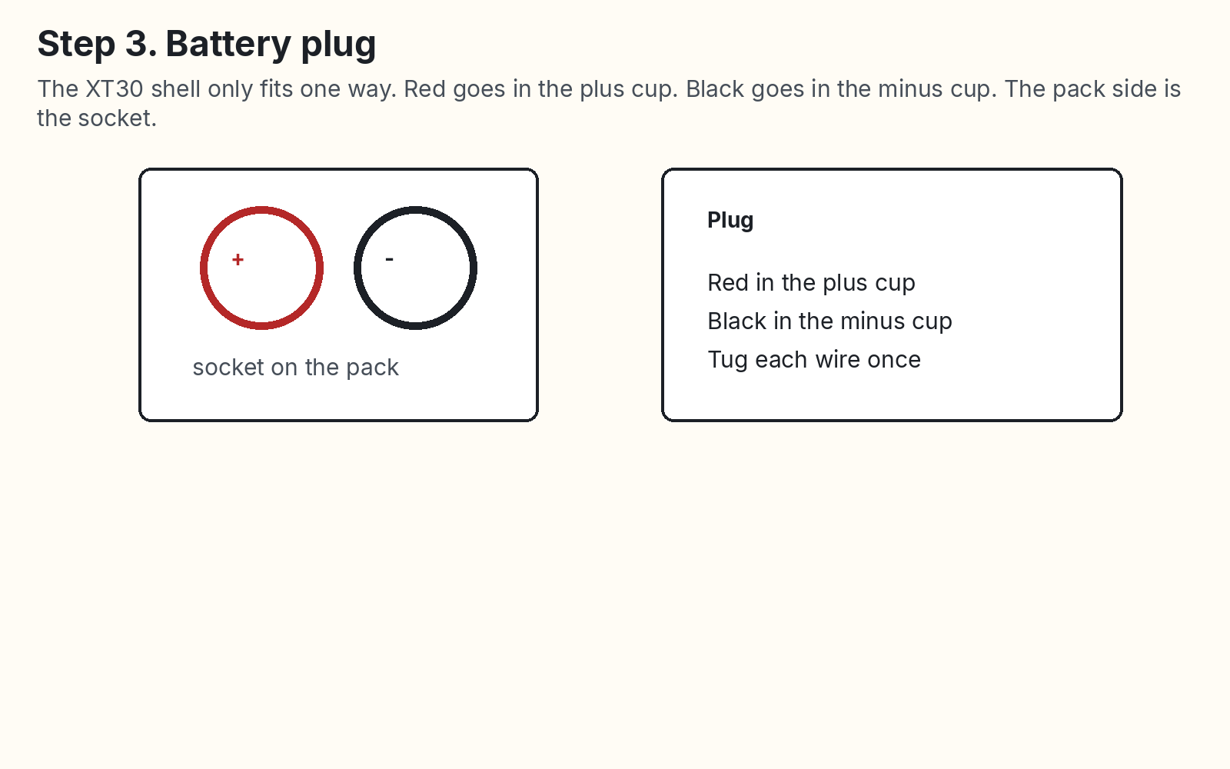
altaay_lab/wiring/harness/steps/03_xt30.png
