aaltaay/Open_Duck_Mini_v2/altaay_lab/wiring/harness/steps/04_fuse.png

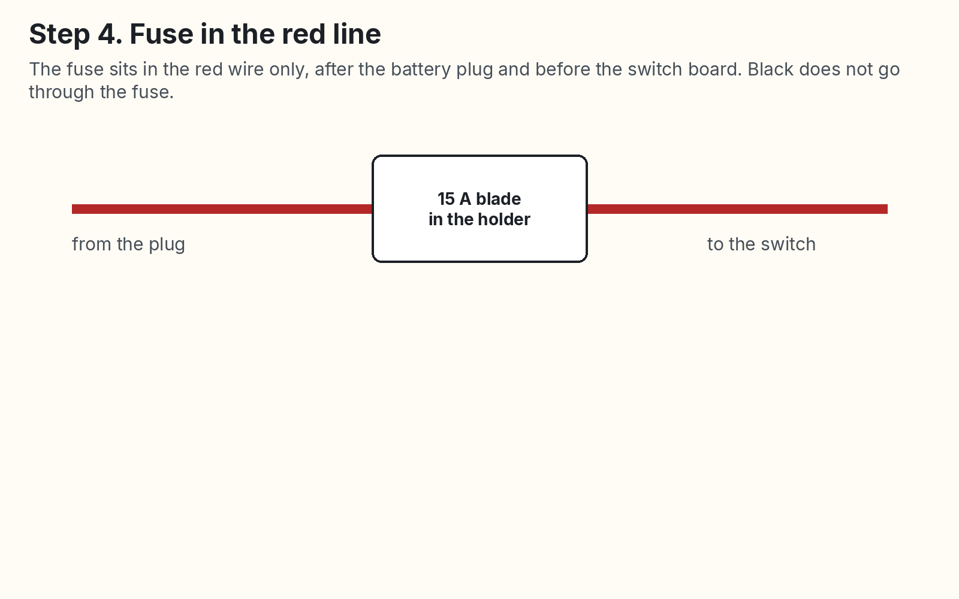
altaay_lab/wiring/harness/steps/04_fuse.png
