aaltaay/Open_Duck_Mini_v2/altaay_lab/wiring/harness/steps/05_button.png

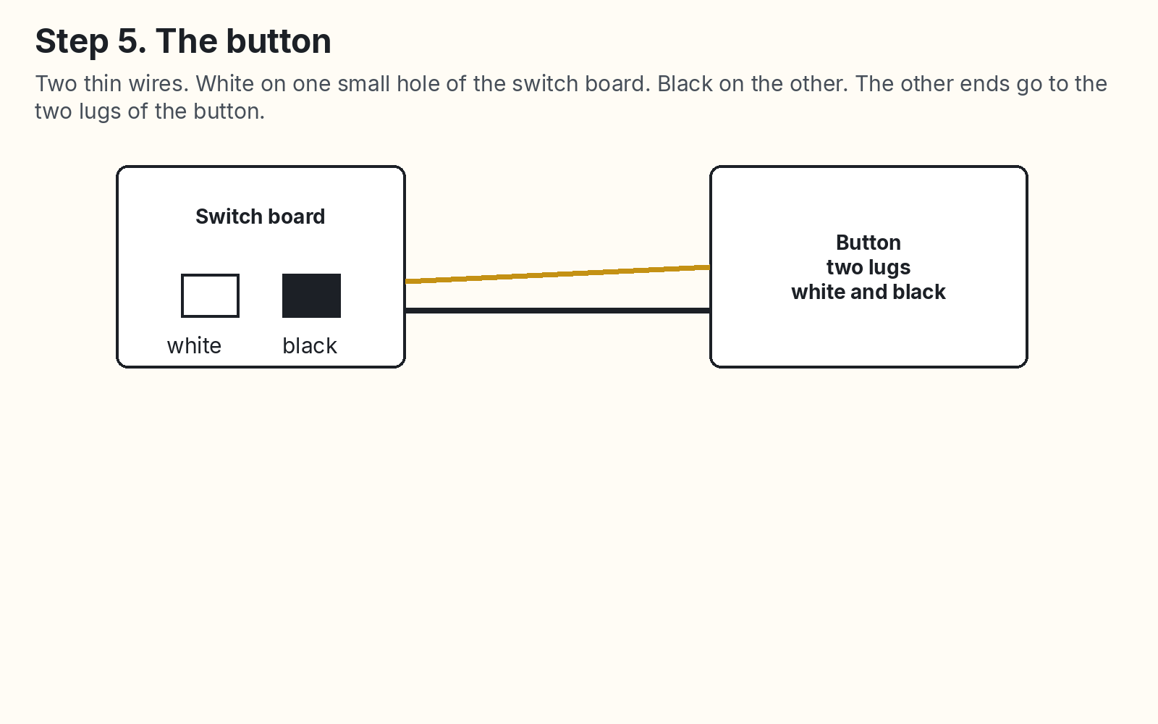
altaay_lab/wiring/harness/steps/05_button.png
