aaltaay/Open_Duck_Mini_v2/altaay_lab/wiring/harness/steps/06_levers.png

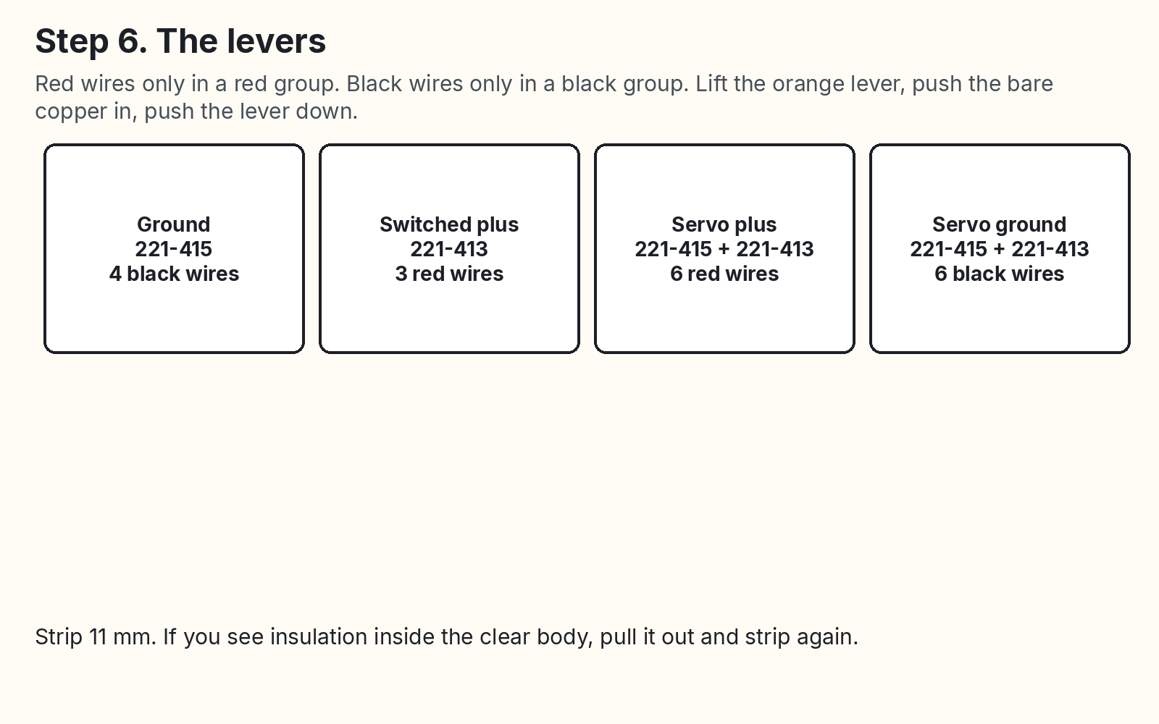
altaay_lab/wiring/harness/steps/06_levers.png
