aaltaay/Open_Duck_Mini_v2/altaay_lab/wiring/harness/steps/07_bec.png

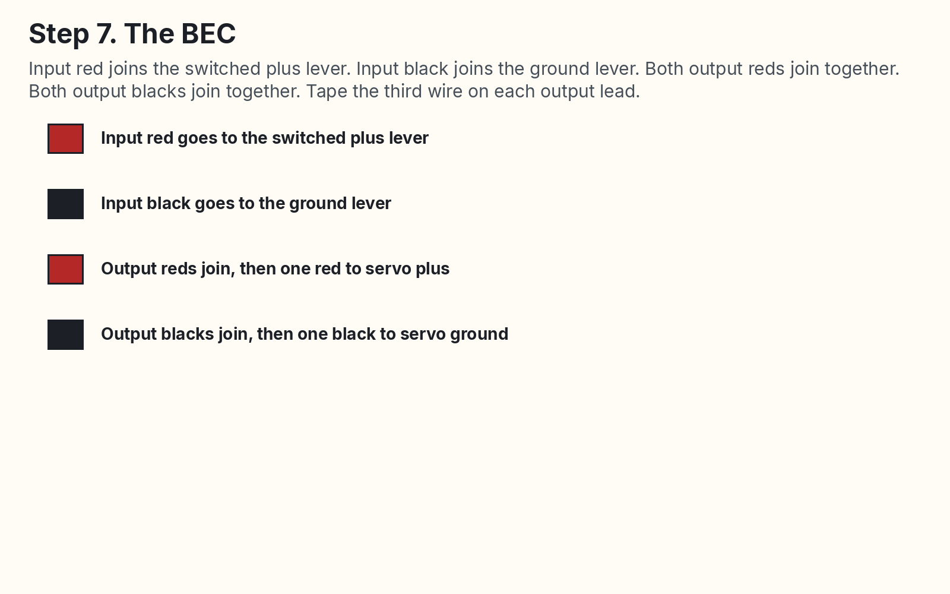
altaay_lab/wiring/harness/steps/07_bec.png
