aaltaay/Open_Duck_Mini_v2/altaay_lab/wiring/harness/steps/08_servo_plugs.png

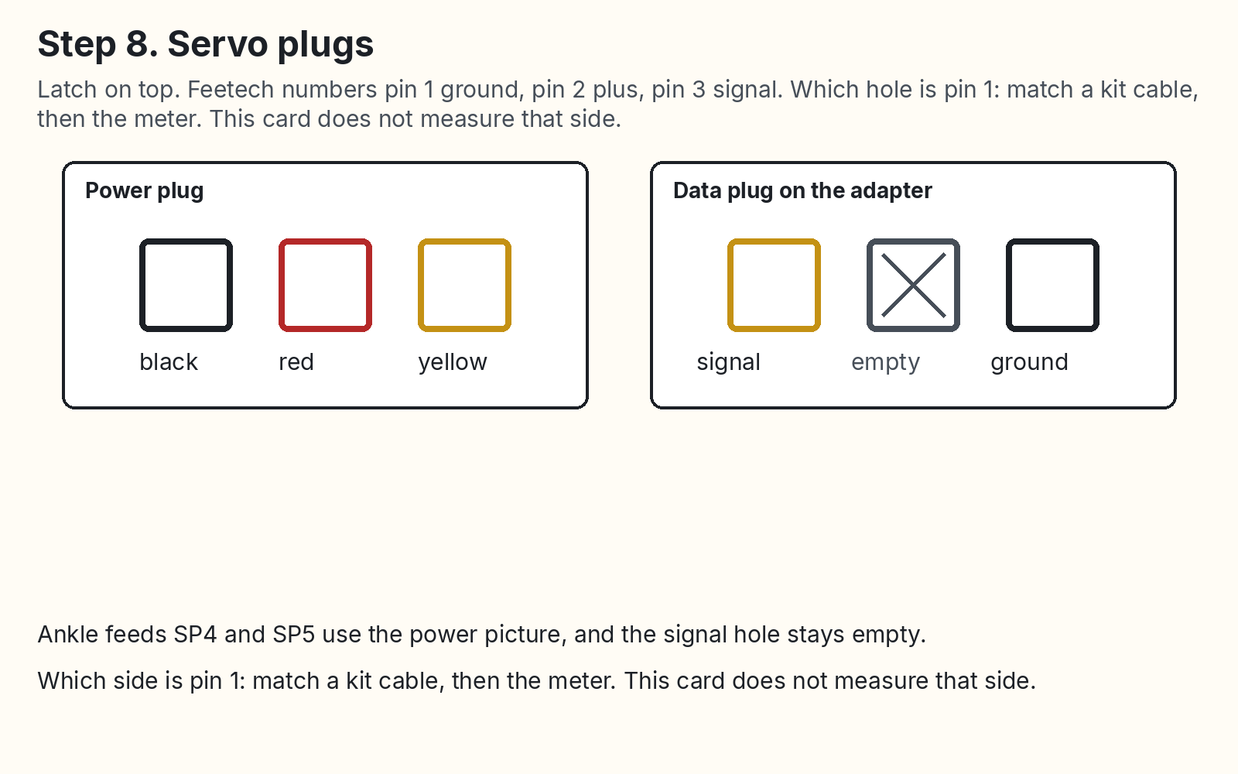
altaay_lab/wiring/harness/steps/08_servo_plugs.png
