aaltaay/Open_Duck_Mini_v2/altaay_lab/wiring/harness/steps/09_kit_hop.png

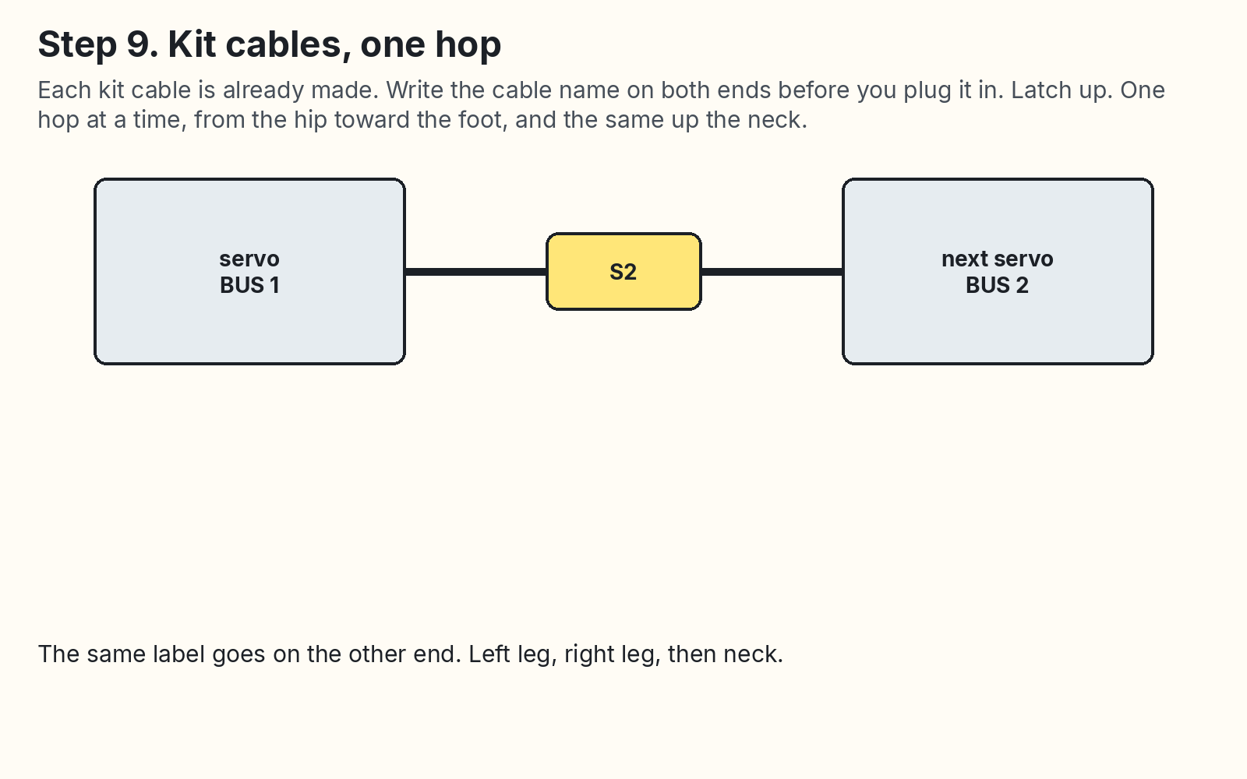
altaay_lab/wiring/harness/steps/09_kit_hop.png
