aaltaay/Open_Duck_Mini_v2/altaay_lab/wiring/harness/steps/11_pi.png

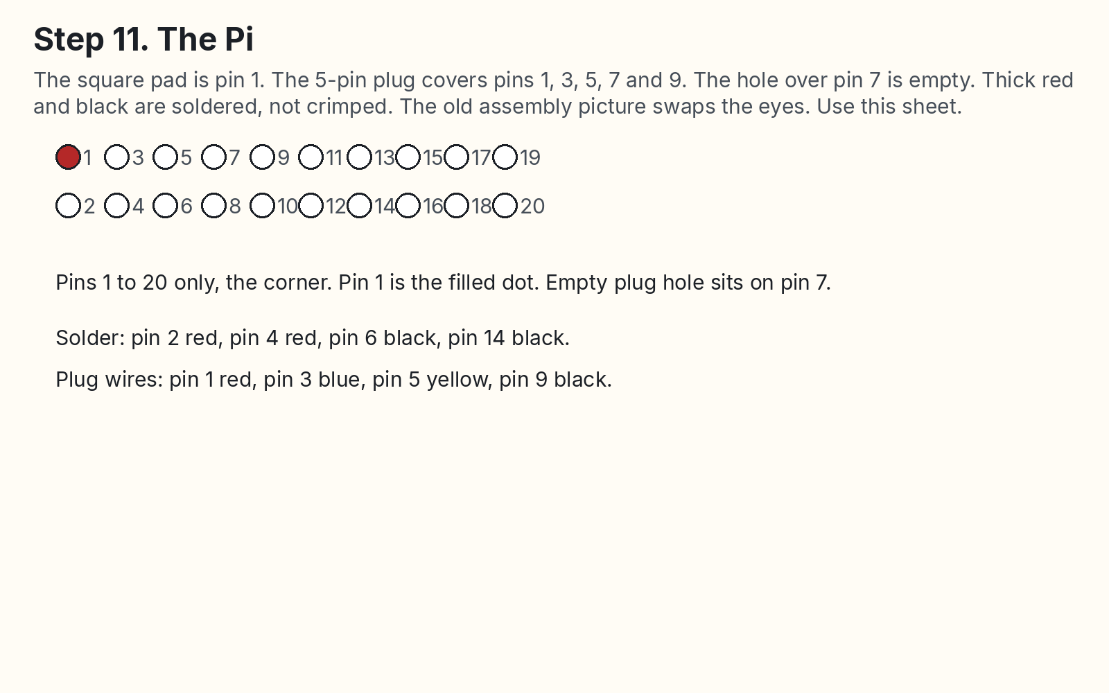
altaay_lab/wiring/harness/steps/11_pi.png
