aaltaay/Open_Duck_Mini_v2/altaay_lab/wiring/harness/steps/12_camera_usb.png

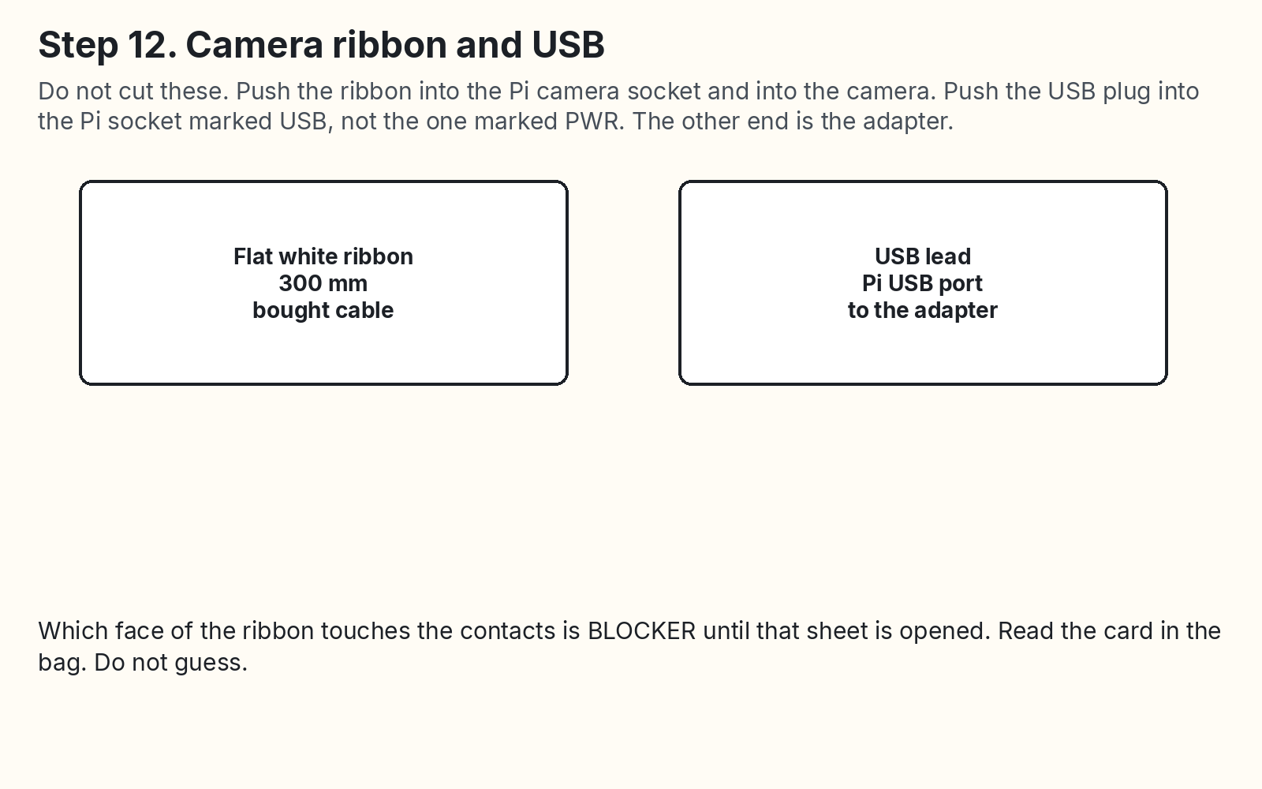
altaay_lab/wiring/harness/steps/12_camera_usb.png
