aaltaay/Open_Duck_Mini_v2/altaay_lab/wiring/harness/steps/13_eyes.png

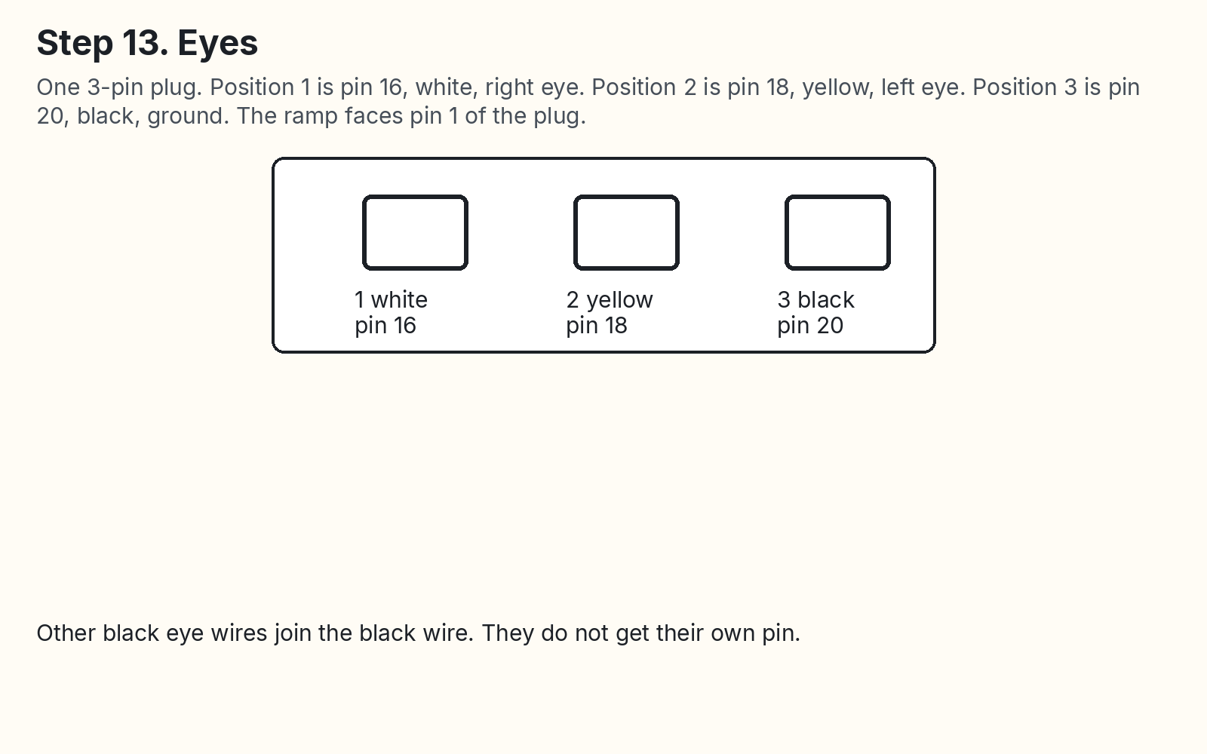
altaay_lab/wiring/harness/steps/13_eyes.png
