aaltaay/Open_Duck_Mini_v2/altaay_lab/wiring/harness/steps/14_feet.png

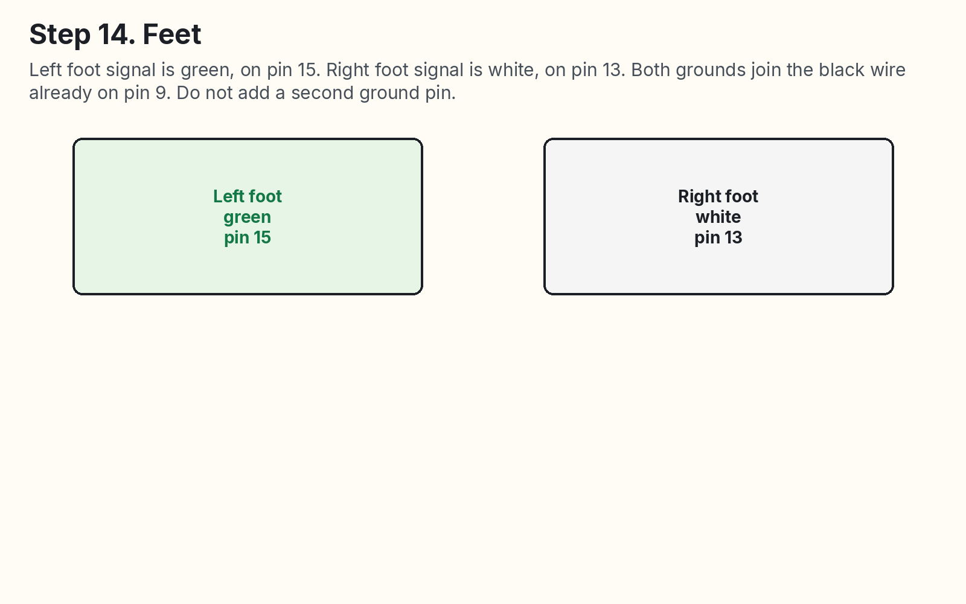
altaay_lab/wiring/harness/steps/14_feet.png
