aaltaay/Open_Duck_Mini_v2/altaay_lab/wiring/harness/steps/15_meter.png

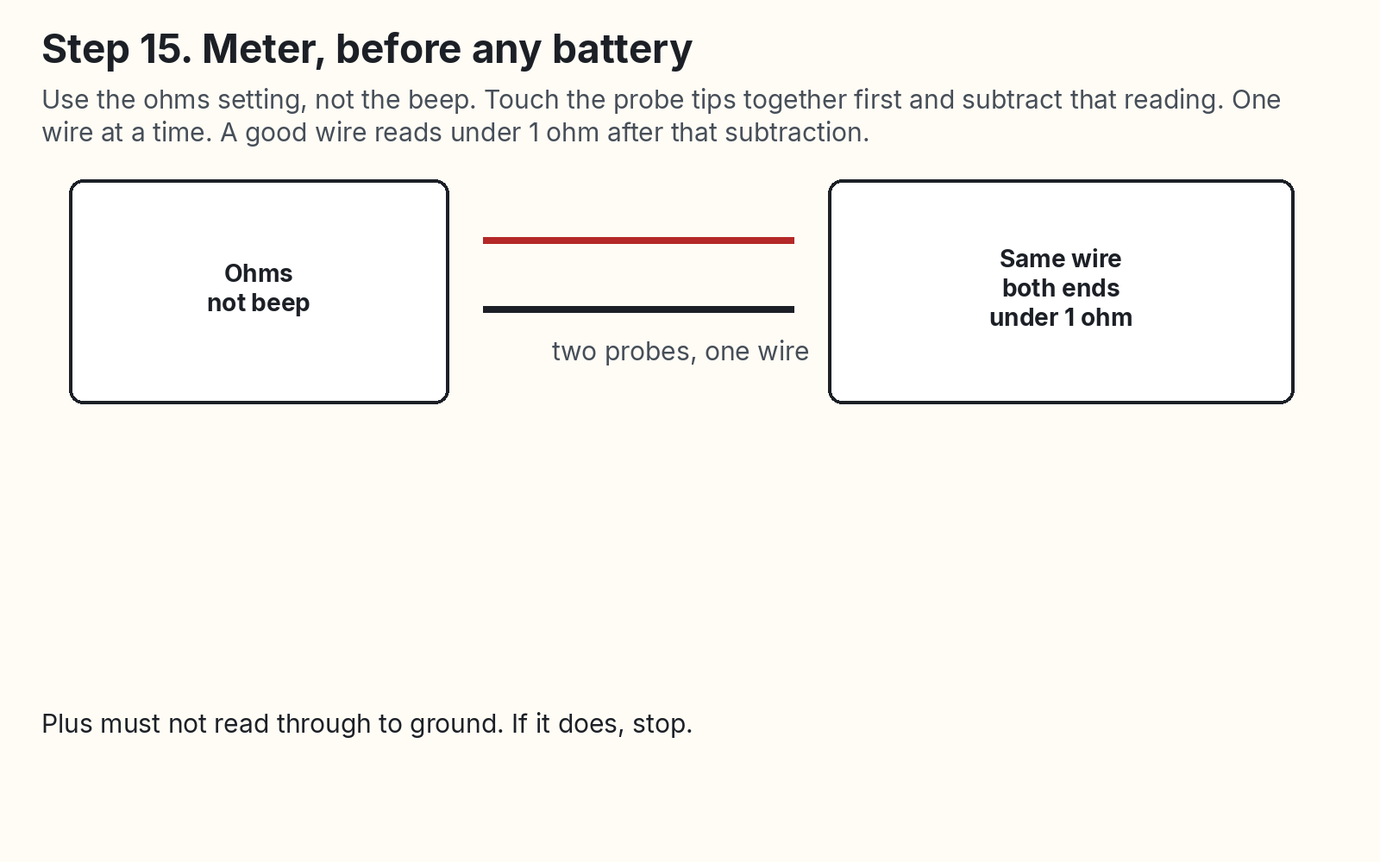
altaay_lab/wiring/harness/steps/15_meter.png
