aaltaay/Open_Duck_Mini_v2/altaay_lab/wiring/harness/steps/16_charger_wells.png

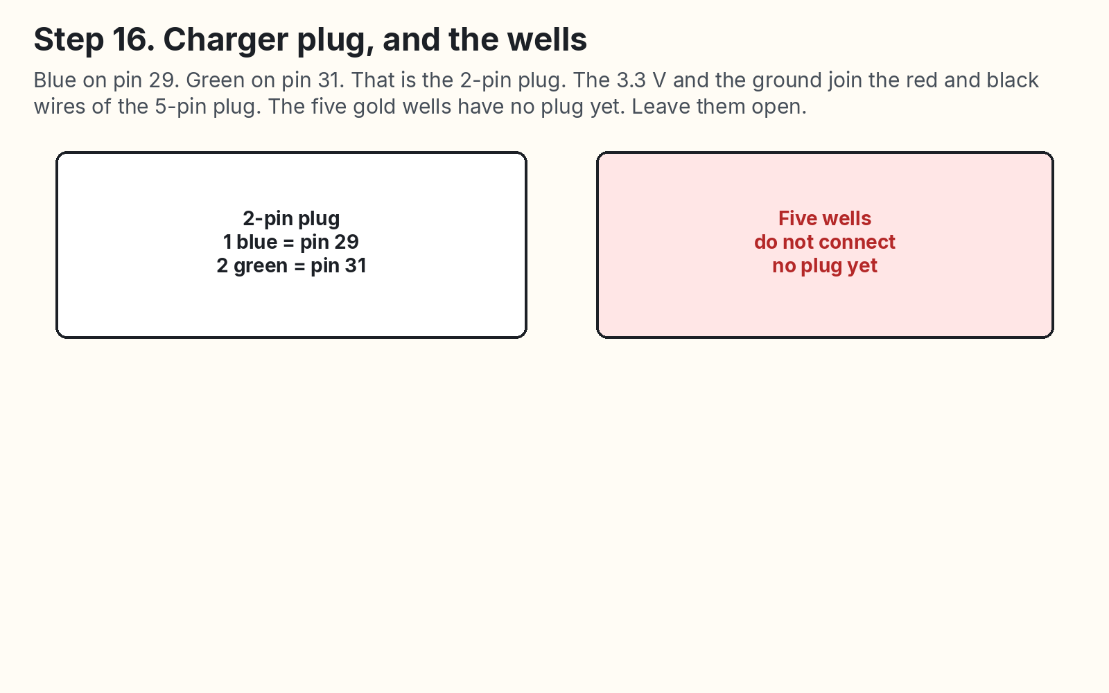
altaay_lab/wiring/harness/steps/16_charger_wells.png
