aaltaay/Open_Duck_Mini_v2/altaay_lab/wiring/harness/wireviz/d2_plug/d2_plug.png

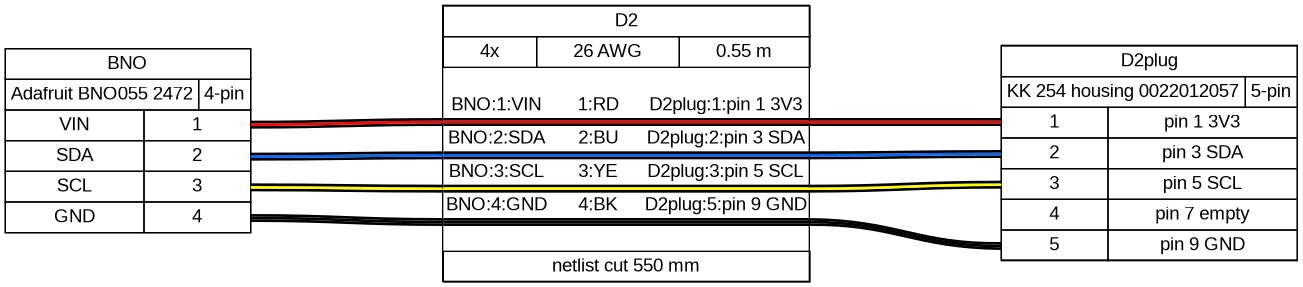
altaay_lab/wiring/harness/wireviz/d2_plug/d2_plug.png
