aaltaay/Open_Duck_Mini_v2/altaay_lab/wiring/harness/wireviz/servo_plus/servo_plus.png

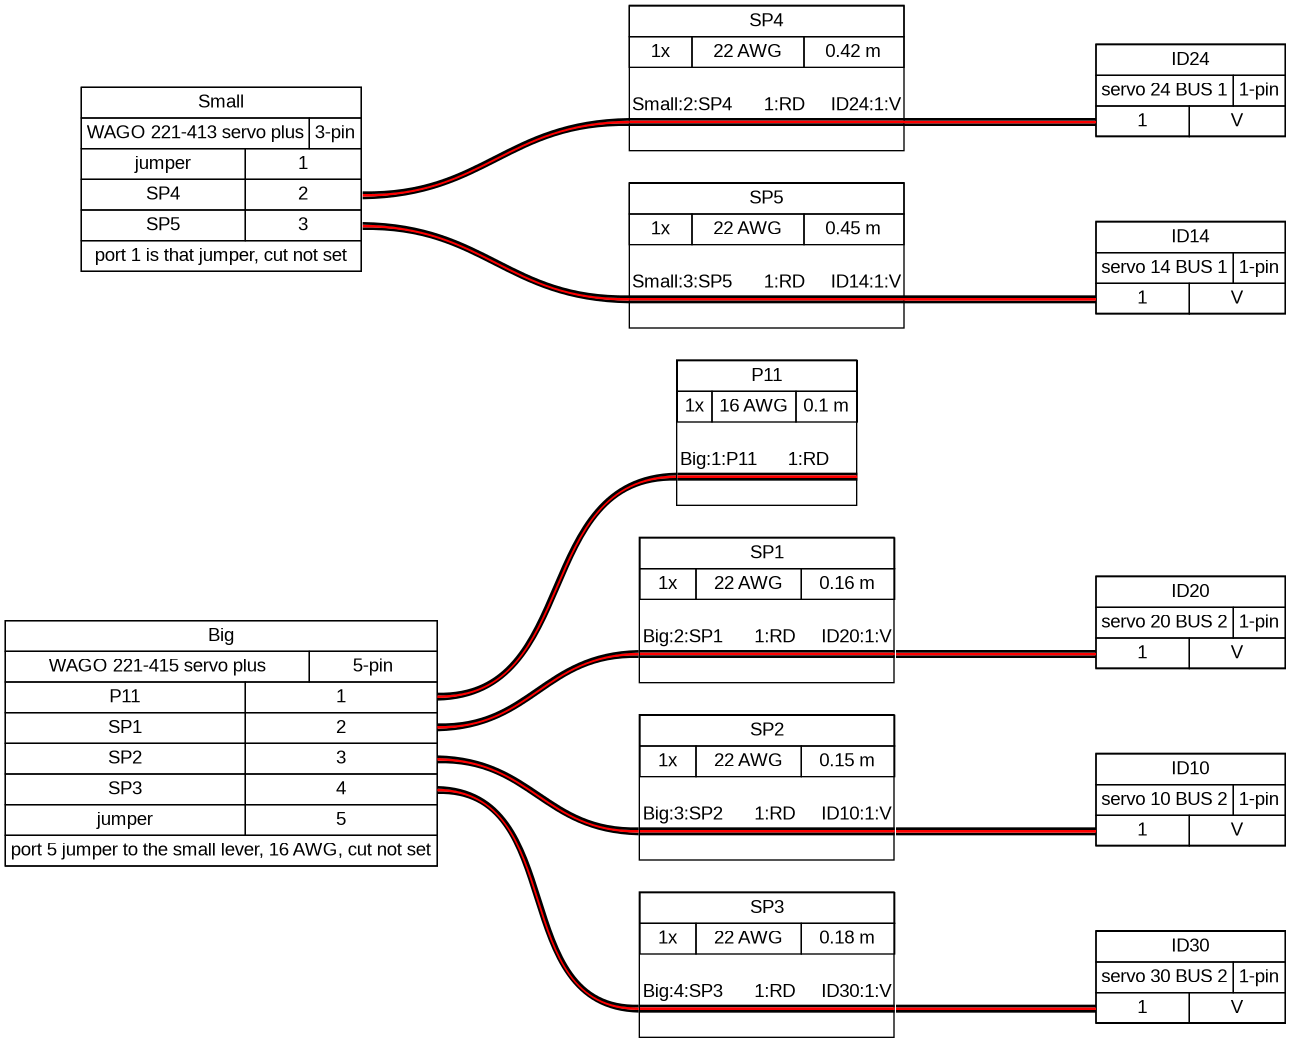
altaay_lab/wiring/harness/wireviz/servo_plus/servo_plus.png
