aaltaay/Open_Duck_Mini_v2/altaay_lab/wiring/odm_v2_wiring_pictorial.png

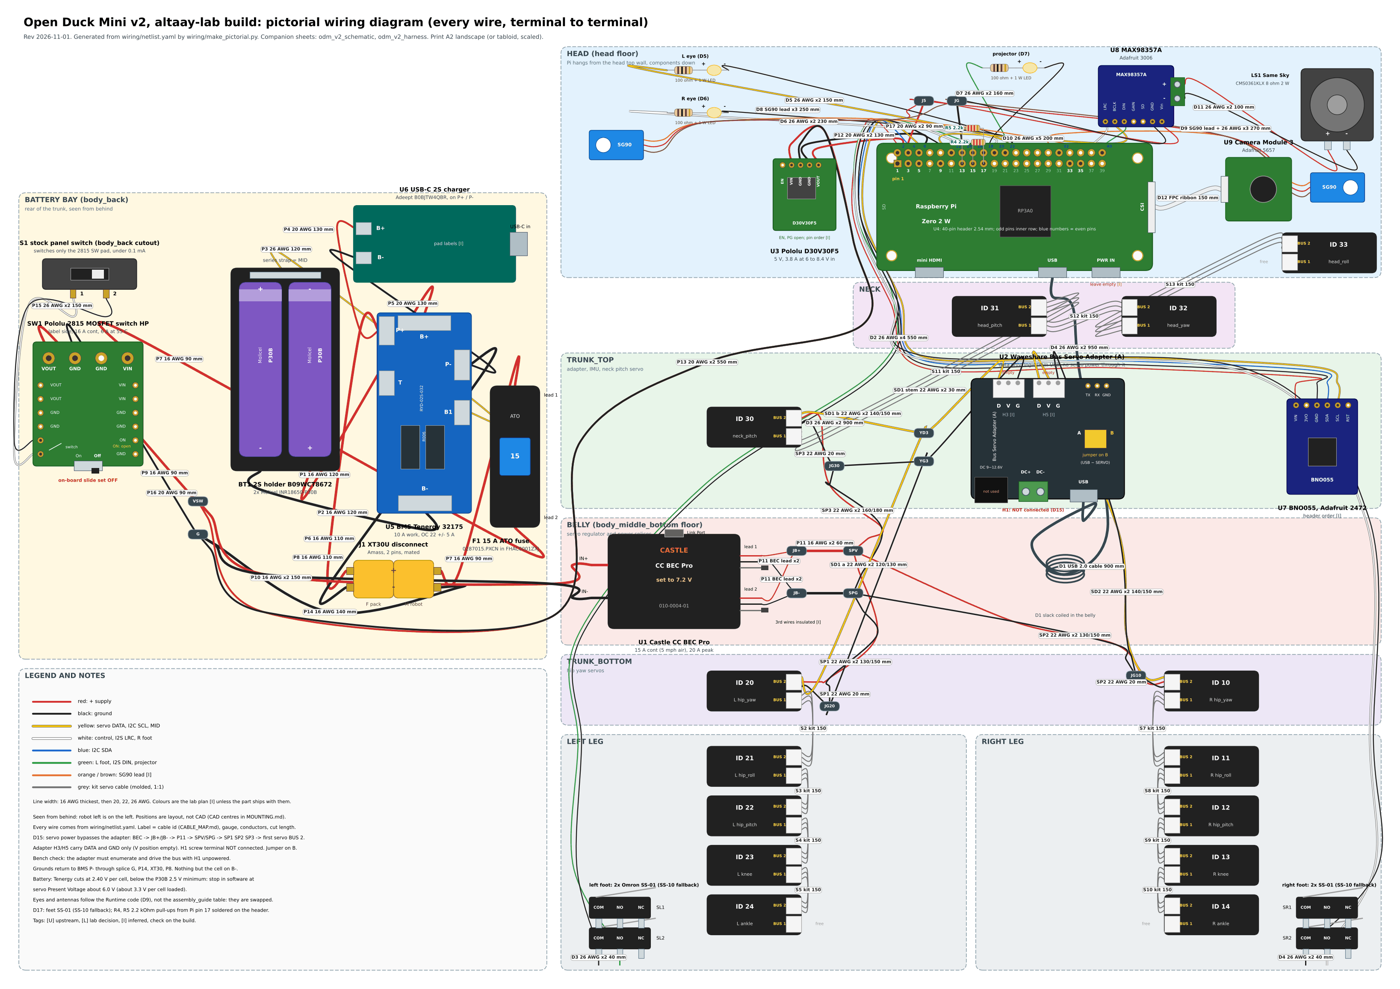
altaay_lab/wiring/odm_v2_wiring_pictorial.png
