aaltaay/Open_Duck_Mini_v2/altaay_lab/wiring/sheets/1_power.png

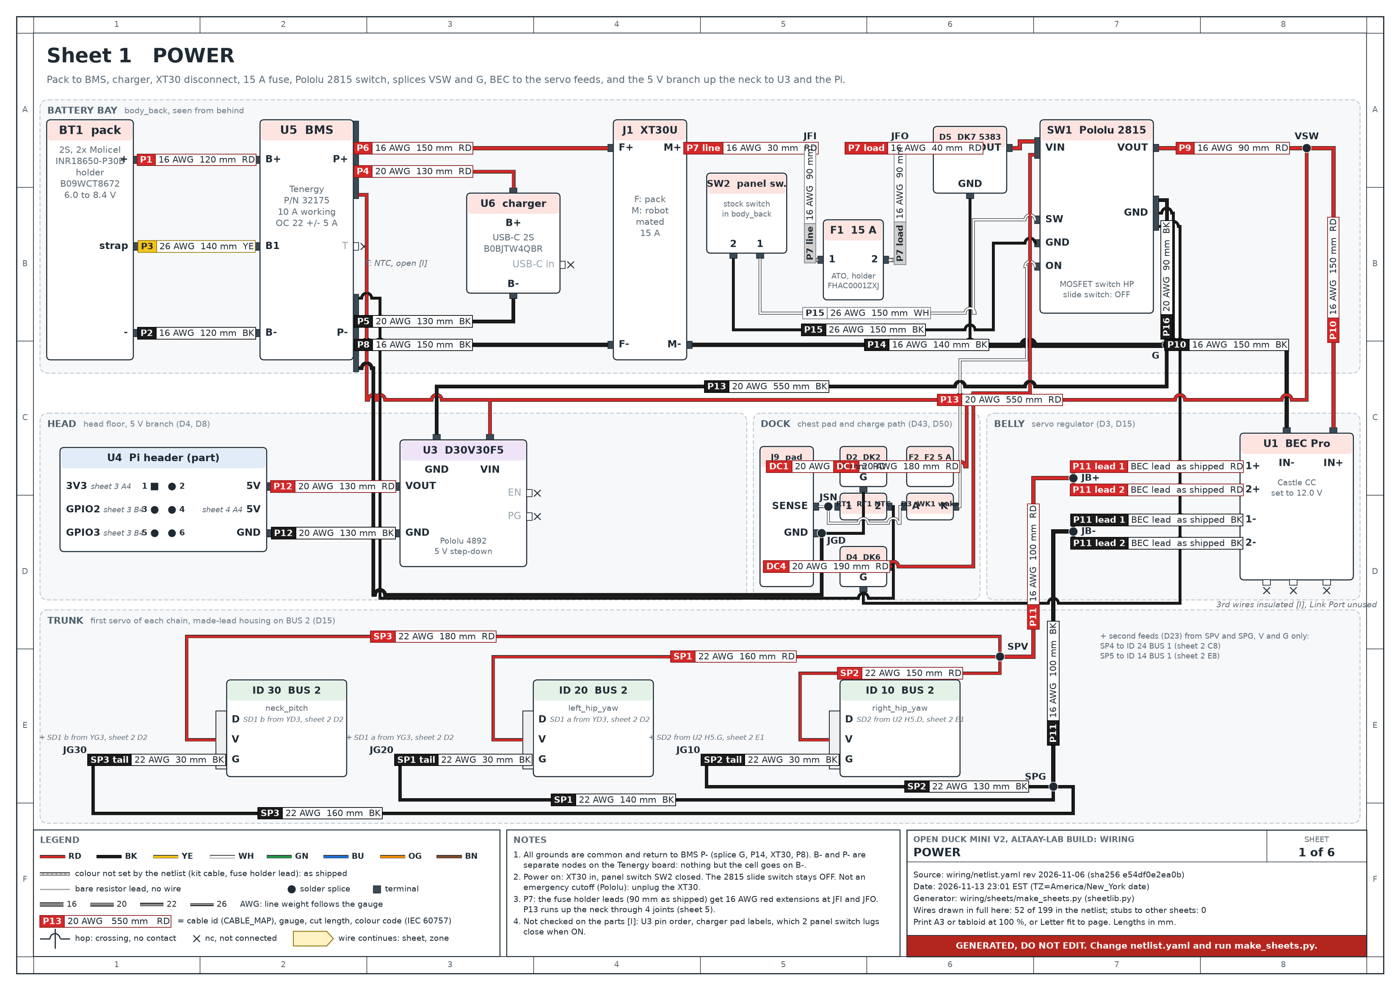
altaay_lab/wiring/sheets/1_power.png
