aaltaay/Open_Duck_Mini_v2/altaay_lab/wiring/sheets/2_servo_bus.png

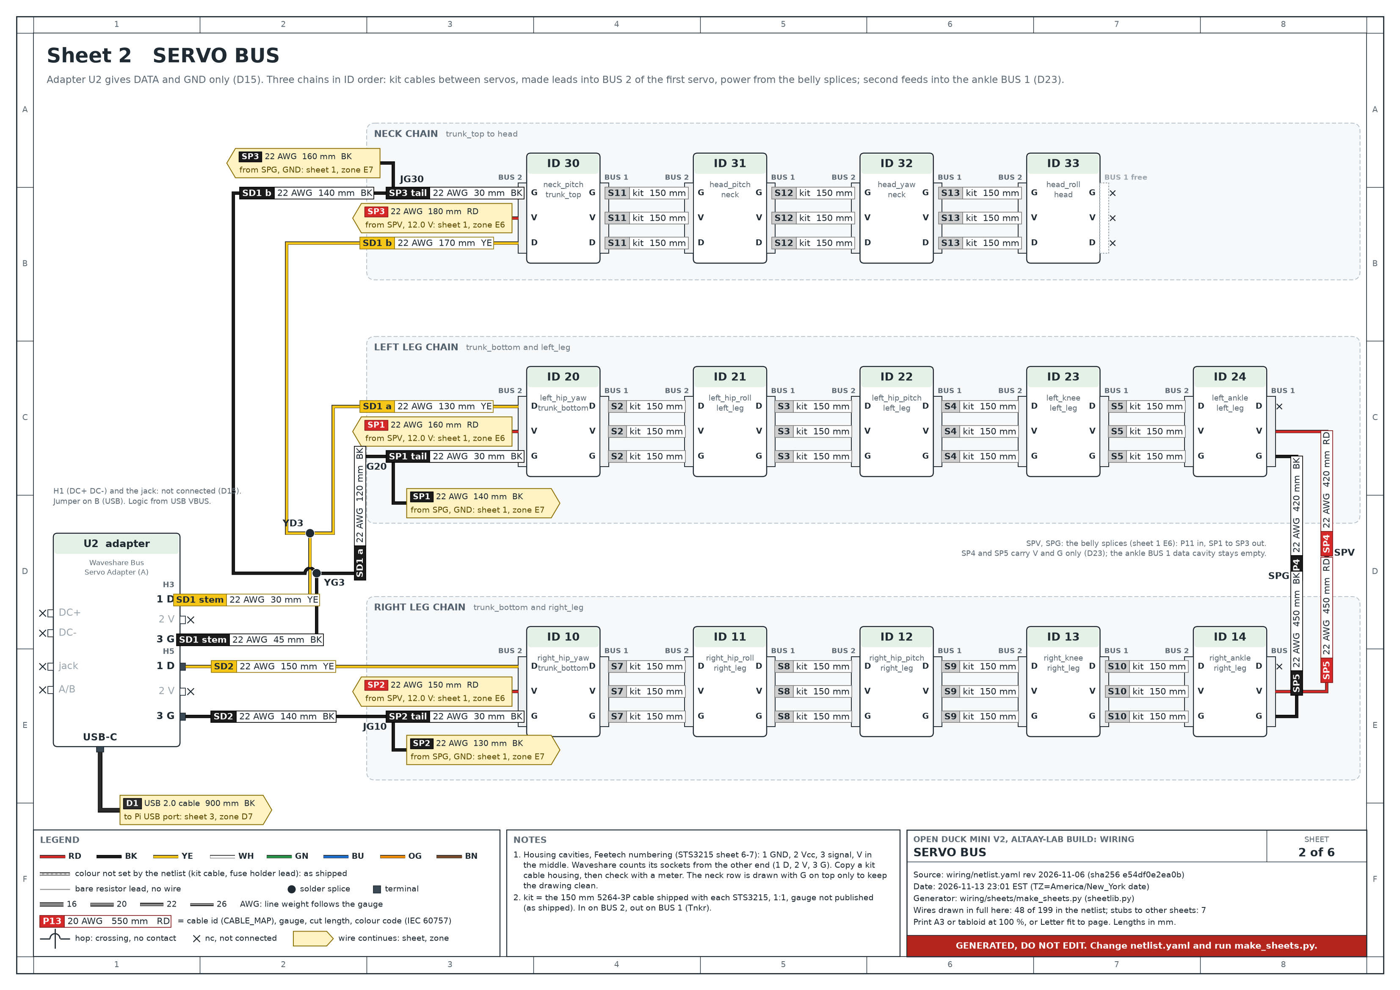
altaay_lab/wiring/sheets/2_servo_bus.png
