aaltaay/Open_Duck_Mini_v2/altaay_lab/wiring/sheets/3_pi_sensors.png

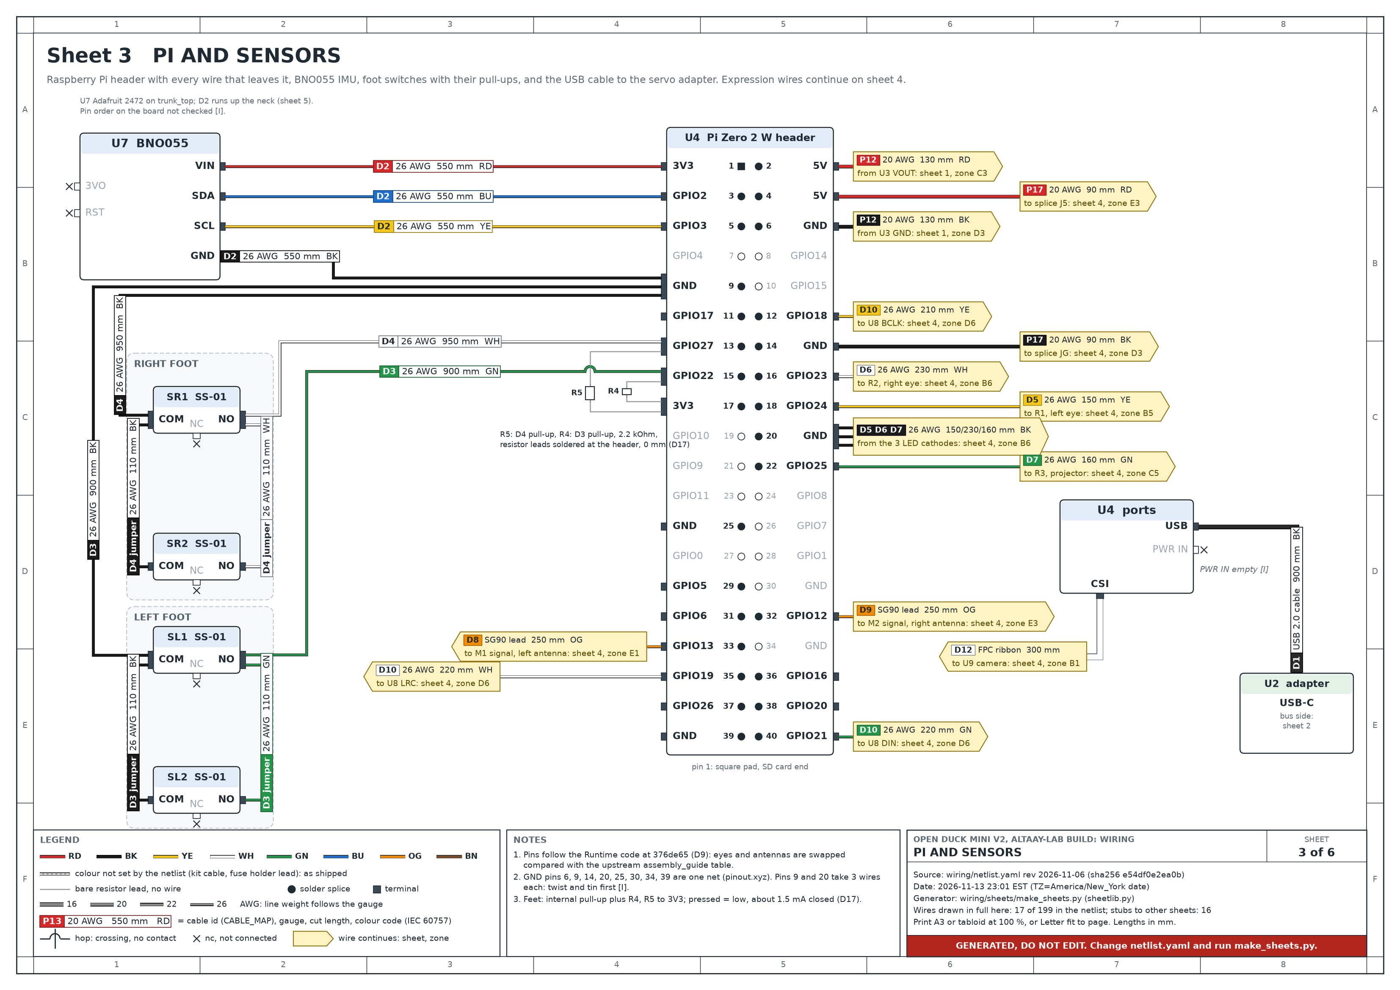
altaay_lab/wiring/sheets/3_pi_sensors.png
