aaltaay/Open_Duck_Mini_v2/altaay_lab/wiring/sheets/4_head_expression.png

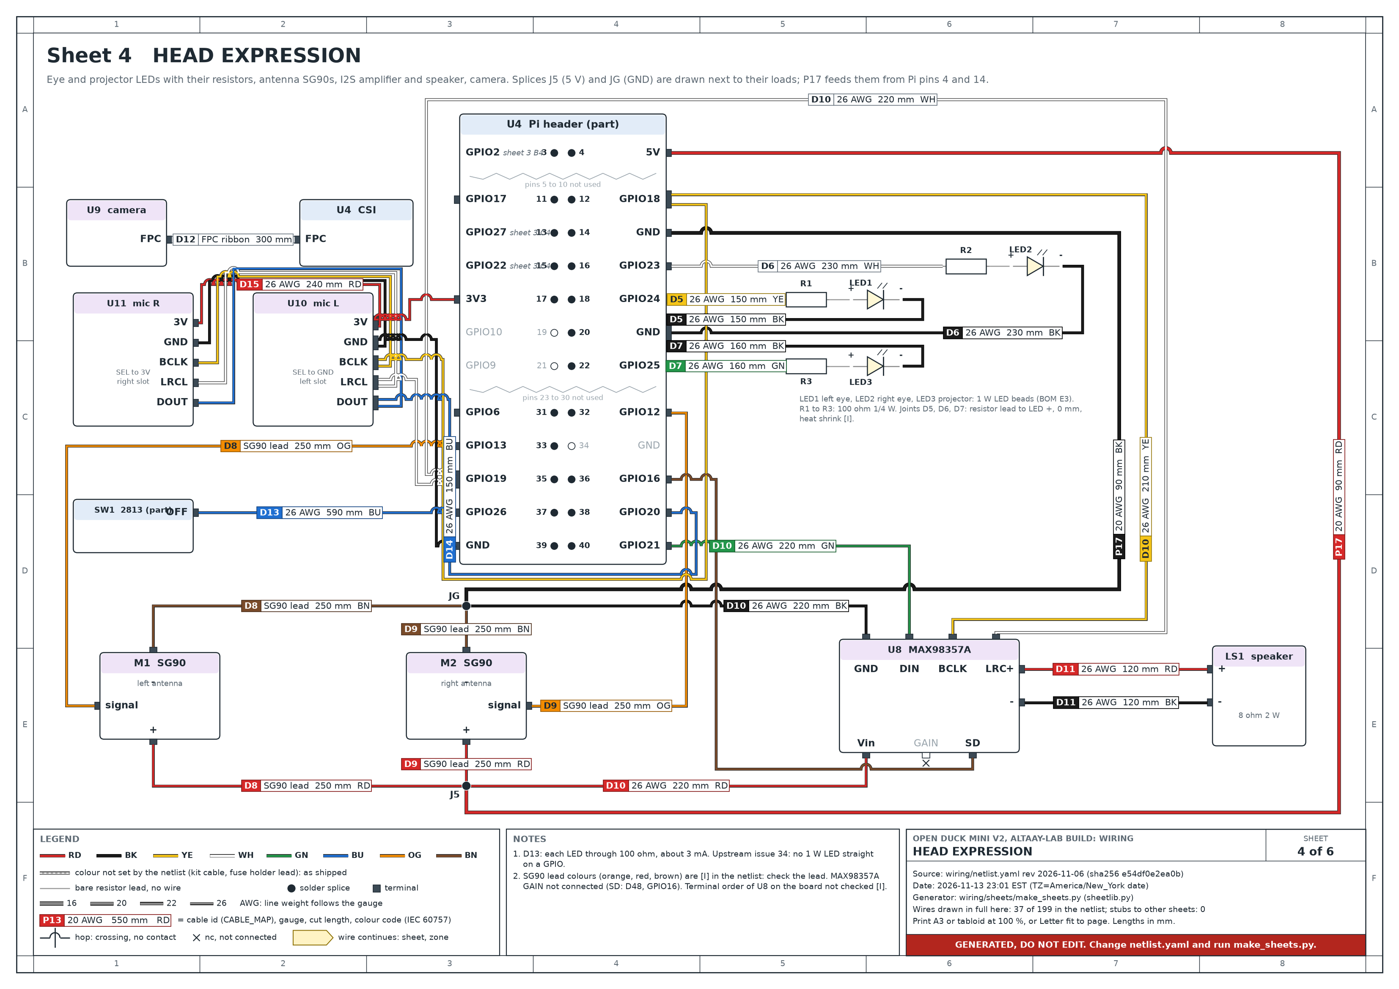
altaay_lab/wiring/sheets/4_head_expression.png
