aaltaay/Open_Duck_Mini_v2/altaay_lab/wiring/sheets/5_harness.png

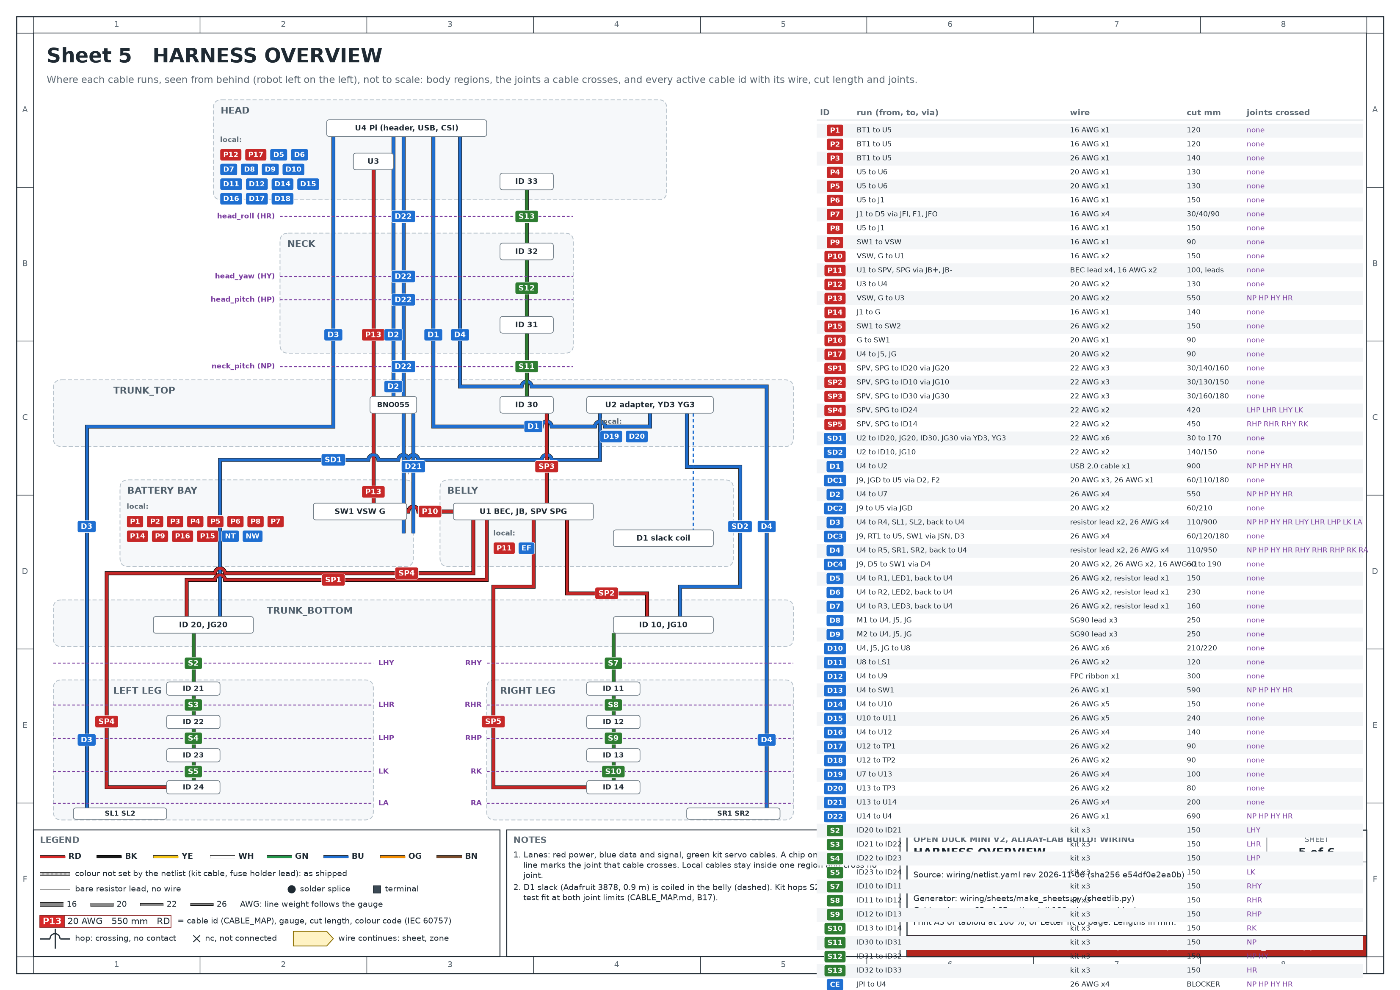
altaay_lab/wiring/sheets/5_harness.png
