aaltaay/Open_Duck_Mini_v2/altaay_lab/wiring/sheets/6_touch_cliff.png

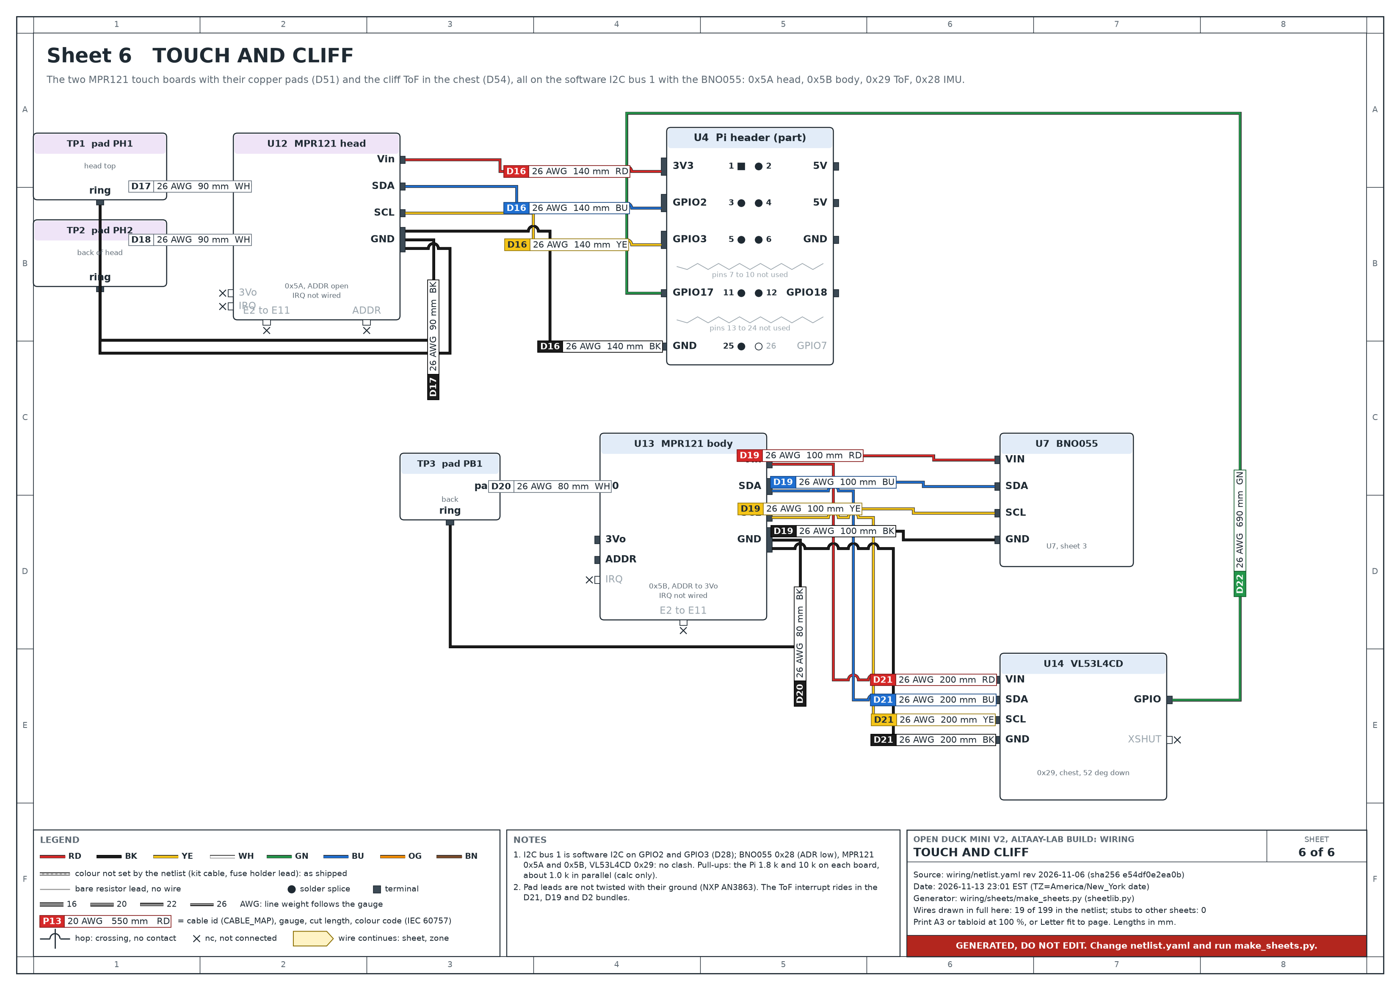
altaay_lab/wiring/sheets/6_touch_cliff.png
