aaltaay/Open_Duck_Mini_v2/altaay_lab/wiring/sheets/7_dock.png

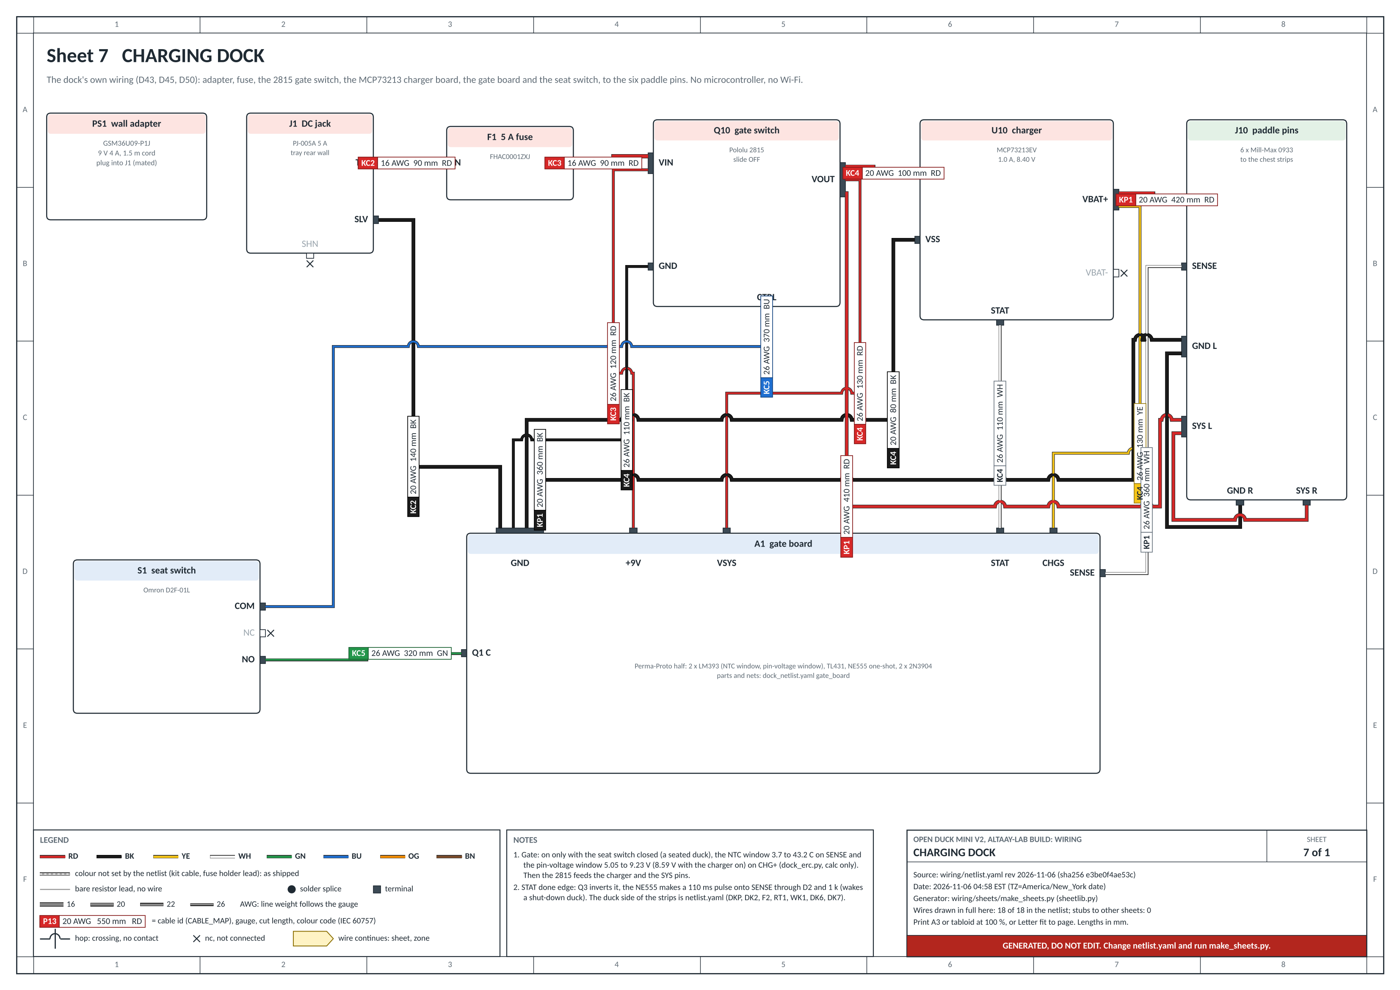
altaay_lab/wiring/sheets/7_dock.png
