aaltaay/Open_Duck_Mini_v2/altaay_lab/TEST_PLAN.md

# TEST_PLAN: electrical and mechanical checks before and at first power-up

Written 2026-11-01 6:55 PM ET by the Claude Code agent (DECISIONS.md D8 to D15). Nothing has been built or bought; this is the plan for when parts arrive. Every step has a pass/fail value. Where a number comes from a simulation, the test is there to replace the simulated value with a measured one (sim/CURRENT_BUDGET.md, sim/POWER_PATH_SIM.md, both sim pass only).

Updates (details in history/): 2026-11-01 about 10:10 PM ET, test equipment TE1 to TE4, 3.2 and 3.3 on the electronic load, 7.3 by current, step 8.0 (sourcing pass); about 10:55 PM ET, bench scripts named per step (software/SOFTWARE.md); 2026-11-02 about 12:05 AM ET, final docs pass: D23 bench gates in 3.2, 4.1, 4.2, 5 and 9 (sim/POWER_FIX.md), foot_side test fit 1.5, hip yaw limit 8.2a, exit code 10 in 11; about 1:00 AM ET, 8.0 weight 2.65 kg after D22 and the netlist final pass (sim/MASS_BUDGET.md); about 5:05 AM ET, integration pass (agent INT) from the PRT, PWR, SW and CAB jobs: 1.3 sleeves (34), splice and twist checks, 1.4 loops and the 75 ties (D25), 4.2 and 5 as wired (D15 plus the D23 feeds), new 8.2b head yaw limit, 9 the walking log on its own timer with every servo timed (lead decision L1); about 6:15 AM ET, agent SFX: section 5 in three bands, pass to 28 mOhm per conductor, warn to 40, fail over 40 (lead decision L3), and the as-built numbers of 4.2 and 9 from the re-run on today's netlist (sim/POWER_PATH_SIM.md); 2026-11-03 about 3:50 PM ET, twin integration (twin/electromech, twin/thermal and the shared lab gym, overlay gym/overlays/duck; sim pass only): heat logs and twin predictions in 4.1 and 4.2, twin lines in 5, 9 and 11, 7.3 replaced (DECISIONS.md D2 note of 2026-11-03), new 7.5 (the servo's response to its bus volts), temperatures in the walking log. The twin numbers are predictions, not gates; the only new pass line is 7.3. 2026-11-03 about 5:00 PM ET, structure twin integration (twin/structure/STRUCTURE_TWIN.md, sim pass only, FEA pass only): a new first bullet in 9, floor and falls (HARDWARE_AUDIT B44 and B45), with no new pass line. 2026-11-03 about 10:40 PM ET, twin wave 2 integration (the live twin in the shared lab gym, overlay gym/overlays/duck, twin_live/TWIN_LIVE.md; sim pass only): the twin prediction in the 9 temperature bullet is now the live twin's, and 7.3 item 3 logs how the servo releases its 70 C cut; no new pass line. 2026-11-04 about 4:50 PM ET, V1 electrical twin (twin/electrical/ELECTRICAL_TWIN.md, sim pass only and calc only): 3.3 gets a 21 A pass line (B47), new 3.5 power-on test (B48), and 11 the operating rule and the drain measurement after the guard's poweroff (B49). 2026-11-04 about 5:40 PM ET, V1 electrical fixes (track 1b, twin/electrical/ELECTRICAL_TWIN.md section Track 1b fixes, sim pass only and calc only): 3.3 pass line with the target guard, 3.5 inrush reading and the ready soft start, 8 restart after a power loss, 9 the guard's cut count and the bus error counters, 10.1 software I2C first, 11 the self-off switch check if the Pololu 2813 is approved; 2026-11-05 about 7:40 PM ET, section 17: companion mics and ego-noise recordings (D47 to D49). 2026-11-11 about 8:20 PM ET: D61 replaces the feet-contact dock, so 19.4 and 19.7 no longer mention feet-dock pads or pad wires. Section 20 is the nest bench for when hardware arrives. Its steps are ordered cheapest and riskiest first. Sections 1 to 19 keep their numbers, because other files cite them. Nothing in section 20 has been run.

Rules: never connect or disconnect a cable with power on (upstream issue 49: bus errors; Bulk Man style warning applies to every robot). First power always from a current-limited bench supply, never the pack. Log every measured value in a new history/ file.

## 0. Equipment
| Item | Why | Status |
|---|---|---|
| Digital multimeter with continuity beep, 10 A range and a 400 mV DC range | every step below; the "under 1 ohm" and "over 1 Mohm" passes are read as numbers on the ohms range (section 2) | BOM TE1 (Klein MM420), if not on hand |
| Bench DC supply, 0 to 15 V, 8 A, current limit | inputs in section 4, the Kelvin tests (4.4, 5), sections 6 to 8 (8.4 runs at an 8 A limit) | BOM TE2 (Siglent SPD1168X, 0 to 16 V, 0 to 8 A), if not on hand |
| Digital calipers | coupon checks (print/PRINT_PLAN.md), connector fit | BOM TE3 (iGaging 100-700-06), if not on hand |
| Windows 10 PC with Castle Link V4 (BOM L2) | set the BEC to 7.2 V; also the Feetech tool for servo firmware | Ahmed's PC |
| DC electronic load, constant current to at least 27 A and 200 W, with program steps | 3.2 and 3.3 from the pack; the load on the outputs in 4.1 to 4.3 | BOM TE4 (Siglent SDL1020X-E: 150 V, 30 A, 200 W), if not on hand |
| Two kitchen scales | mass and centre of mass, step 8.0 | not in the BOM (household) |

Which source runs each test:
- Bench supply (TE2): the inputs in 4.1 to 4.3, the 2.0 A Kelvin tests (4.4, 5) and sections 6, 7 and 8. It stops at 8 A, so it cannot run 3.2.
- Electronic load (TE4): 3.2 and 3.3 from the pack, and the load on the outputs in 4.1 to 4.3.
- Neither: sections 1, 2 and 3.1 need only the meter; 3.4 charges through the USB-C charge board (BOM 11) fed from BOM T7 and T7b; section 9 runs on the pack. Section 20.1 to 20.5 also start on the meter and a coupon, before the whole duck exists.

Without TE4, power resistors on a heat sink can stand in for 3.2 and 4.1 to 4.3 (2 x 1.5 ohm and 1 x 2.0 ohm, 100 W each, SOURCING_2026-11-02.md section 4, price UNVERIFIED). The current then follows V / R at each step and is read on TE1 (10 A range, 10.00 A at most). Nothing on this list replaces TE4 in 3.3.

## 1. Before any power: mechanical checks of every made cable
For each made lead in CABLE_MAP.md (P rows, the servo power leads SP1 to SP5, the data Y, D rows):
1. Crimp pull: each Molex 08-70-1040 terminal holds when pulled by hand along the wire (no slip) and sits latched in the housing (a light push on the wire does not move it back). Fail: redo the crimp.
2. Connector fit: plug every made lead into the real servo port and adapter socket it goes to; it must seat fully and latch. Fail: wrong housing or terminal.
3. Heat shrink covers every solder joint and splice with no copper showing: every splice, every solder joint on a part's flying lead (holder, BEC, resistor and LED leads), each XT30 solder cup and the cut BEC third wires (34 sleeves, BOM_FULL.md heat shrink row); joints on board pads, holes and header pins get none, and switch terminals, lugs and tabs get a sleeve only where copper shows. On each splice the 15 mm adhesive sleeve reaches at least 2 x the wire OD onto the insulation at both ends (NASA-STD-8739.4A 19.2.6), no splice sits in a bend (7.2.36), and YG3 sits about 15 mm past YD3 on the adapter H3 lead (HARNESS_BUILD.md, Splices). Twisted cables (the 'Twist' line of each cable in HARNESS_BUILD.md: SP3, SP4, SP5, P13, D2, D3, D4, D6, D10 and SD1 branch b): count the turns over 100 mm; the lay is inside the listed range, in one direction end to end, with about 20 mm untwisted at each end. Kit cables stay as shipped. Fail: copper showing, a sleeve short of 2 x OD, a splice in a bend, or a lay outside the range.
4. Length, loops and ties (the test fit): route each cable on the printed parts and dress each joint loop with the length HARNESS_BUILD.md gives between its two ties. The neck bundle makes one loop over head pitch and head yaw, with no tie on head_pitch_to_yaw. Turn every joint the cable crosses through both limits by hand (CABLE_MAP length rule). Turn head yaw to +/-45 deg (8.2b), and once, slowly, to the full +/-160 deg; stop at the first pull or kink. In CAD all 43 loops meet 3 x OD (cables3d/CABLES_3D.md). Ties (cables3d.json, 75):
   - Each MB3A (32) and ABM1M-AT-C (23) mount sits flat and holds a hand pull once the adhesive has cured.
   - Each drilled tie-hole pair (3) is deburred, and the strap runs behind the wall.
   - The 9 bundle ties (HARNESS_BUILD.md 'Bundle ties checked at the test fit': T016, T017, T023, T024, T026, T034, T045, T085, T089) keep the bundle clear of moving parts at both limits. Only if one reaches a moving part, report it: that point gets a drilled tie-hole pair or a printed anchor (D25).
   Fail: tension at a limit, a kink or fold in a loop, a cable on a moving edge, or a mount that lifts.
5. Ankle plugs at foot_side (cables3d/CABLES_3D.md; HARDWARE_AUDIT B33): on the first printed foot_side (the left leg prints first) with the TO1 servo, plug a kit cable into BUS 2 and an SP4 housing (V and G only) into BUS 1, then turn the ankle through its range with the foot flat. In CAD the plug back sits 0.5 to 1.7 mm from the foot_side apex and the SP4/SP5 route touches foot_side. Pass: no plug body or wire presses on foot_side. Fail: a 2 mm relief at the foot_side apex (CAD change) before the other plates print.

## 2. Before any power: continuity and polarity, every wire
Use the generated checklist audit/continuity_checklist.csv (one row per wire, from wiring/netlist.yaml by audit/erc.py; the netlist passes the electrical rule check with 0 errors, audit/ERC_REPORT.md): for every wire, measure from its "from" pin to its "to" pin, and check there is no connection to the pins listed in its last column.
- Read every pass as a number in ohms, not by the beep: the TE1 meter (Klein MM420) beeps for anything under 50 ohm, so a beep cannot show "under 1 ohm" and silence cannot show "over 1 Mohm". Use the resistance setting (press SEL once from continuity), touch the probe tips together first and subtract that reading. Its lowest range, 400.0 ohm, reads in 0.1 ohm steps at +/-(1.2 % + 5 digits), about +/-0.5 ohm near zero (Klein MM420 manual, https://data.kleintools.com/sites/all/product_assets/documents/instructions/klein/MM420%20Instructions_web.pdf, read 2026-11-01 9:52 PM ET).
- Pass: under 1 ohm for every wire; over 1 Mohm between any two different nets on the same connector (V+, GND, DATA on every 3-pin servo lead; P+ and P- everywhere).
- Polarity: on every servo lead the pin order matches the STS3215 port (GND, VCC, DATA per the Feetech sheet); SP4 and SP5 carry V and G only, data cavity empty (D23); on the BEC output, red is +; on the XT30, + to +.
- Pack bus to ground with the switch ON and nothing powered: over 1 kohm after the capacitors charge from the meter (no short).
- Adapter H1 screw terminal: not connected to anything (D15).

## 3. Battery, holder and BMS (bench, robot not connected)
1. Cells: both P30B within 0.05 V of each other before they go in (the Tenergy board does not balance).
2. Holder drop: 10.0 A through the holder for 30 s, from the pack (BMS fitted, P+ and P-) into the electronic load (TE4) in constant current: 74 to 84 W at 7.4 to 8.4 V, under its 200 W. The bench supply cannot run this step (TE2 stops at 8 A). 10 A is the Tenergy board's rated operational current ("10A or less"), well under its trip. Measure across the holder contacts. Pass: under 0.10 V total (10 mOhm) and no contact gets warm in 30 s. The section 9 gate needs the typical pack side (sim/POWER_FIX.md: with a 30 mOhm holder the ankle is under 6.0 V 17.7 % of the walk at nominal even with the second feed). Also read the voltage at the Pololu 2815 output at 10 A: pack open circuit minus that reading under 0.95 V (95 mOhm cells to switch). This replaces the 10 to 30 mOhm holder value in the power sim.
3. BMS: P+ to P- equals the pack voltage. Then the over-current trip, on the electronic load (TE4) only, after step 2 passes. Tenergy spec table (BOM line 8 link, read 2026-11-01 9:57 PM ET): over-current detection 22 +/- 5 A, so 17 to 27 A; detection delay 8 +/- 4 ms; release condition "Cut load"; main loop 25 mOhm max.
   - Pack at 7.40 V or less, open circuit, so 27 A stays inside the load's 200 W input rating (200 W / 27 A = 7.41 V). Above that the load's over-power protection (OPP, 210 W) can cut the current, which would look like a BMS trip. If the pack reads higher, discharge it on TE4 at 2 A and read it again after 5 minutes off the load.
   - Circuit: P+ through the fuse holder with a 15 A fuse (L3 with L4) to TE4 +, P- to TE4 -.
   - TE4 in Program (auto test) mode, CC, 30 A range, Stop On Fail on, 7 steps: 15, 17, 19, 21, 23, 25 and 27 A. Each step: Ton 0.05 s (load on), Tdly 0.03 s (when the load reads the voltage, after the longest 12 ms detect delay), Toff 2 s (load off), pass band 1.0 to 8.5 V. The sense is inverted: a failed step means the voltage collapsed, so the BMS opened at that current.
   - Pass: the 15 A step passes and the run stops on a step from 17 to 27 A; write down that current. Fail: it trips at 15 A, or all 7 steps pass (no trip at 27 A).
   - V1 pass line (2026-11-04, B47; twin/electrical/ELECTRICAL_TWIN.md, sim pass only): the board must trip at 21 A or more. In the twin a 60 N shove to the left of the standing duck draws 19.5 to 20.6 A from the pack, over 17 A for 4 to 13 ms (6 of 6 seeds); a board that trips at 20 A or more trips in 0 of 41 simulated falls and get-ups, a board at 17 A in 7. If this board trips under 21 A: a second board (BOM line 8; buying needs Ahmed's OK), or accept that a hard shove can switch the robot off (release "Cut load": cycle the panel switch).
   - With the target guard in the walk loop (2026-11-04 track 1b, B47; twin/electrical/fix/bus_budget.py, sim pass only): the twin's worst 4 ms is 15.9 A, so any board that trips inside its band (17 A or more) passes. The 21 A line applies only to a walk without the guard.
   - Heat: each step lasts 50 ms. Even if the BMS never trips, the 27 A step puts about 0.9 J into its 25 mOhm loop (27 A x 27 A x 0.025 ohm x 0.05 s) and at most 10 J into the load (7.4 V x 27 A x 0.05 s), so nothing gets hot.
   - After the run: disconnect the load (the release condition) and check P+ to P- is back at the pack voltage. Read the fuse in ohms (under 1 ohm, as in section 2); if it opened, the run does not count: fit a new fuse and repeat.
   - Load specs used here, read 2026-11-01 9:53 PM ET: 30 A range, 200 W input power, OPP 210 W, 0.9 V minimum operating voltage at 30 A (SDL1000X datasheet DS0801X-E01F, https://siglentna.com/wp-content/uploads/dlm_uploads/2024/05/SDL1000X_DataSheet_DS0801X-E01F.pdf); Program steps with Ton and Toff 0.01 to 100 s, Tdly 0.01 s to Ton, the pass band in volts in CC mode, and Stop On Fail (SDL1000X user manual E02A, https://siglentna.com/wp-content/uploads/dlm_uploads/2024/06/SDL1000X_UserManual_E02A.pdf). Both are listed on https://siglentna.com/resources/documents/dc-electronic-load/; the product page in BOM TE4 is https://siglentna.com/product/sdl1020x-e/.
   - Without TE4, skip the trip test and rely on the fuse. Do not short the pack through a resistor: the current would depend on cell and contact resistances nobody has measured, so no resistor value is sure to pass 27 A, and if the BMS failed only the fuse would end the short.
4. Charge once with the USB-C charger and the robot off: both cells end within 0.05 V of each other and at no more than 4.20 V each.
5. Power-on (B48; twin/electrical/ELECTRICAL_TWIN.md, calc only): the real pack, BMS, fuse, Pololu 2815, CC BEC Pro and 5 V regulator wired as built, no servos yet. Mate the XT30 only with the panel switch off. Switch on with the panel switch 20 times, 10 s on and 10 s off. Pass: the BMS never opens (P+ to P- stays at the pack voltage) and the BEC and the regulator come up every time. Repeat once more at TEST_PLAN 8 with all 14 servos fitted, on the pack. Reason: Tenergy publishes no short-circuit threshold or delay and Castle no input capacitance; the over-current function cannot trip at power-on (it would need about 25 mF on the bus), the short-circuit function is not known.
   - Track 1b (B48, calc only): also read the pack current on the scope through the 20 power-ons (a 10 mOhm shunt in the P- lead, or a clamp probe). Pass: never over 17 A for 1 ms or more, and never over 19 A at all (the worst cited short-circuit point of this class, TI BQ2970 family, 125 us). If it fails, fit the ready soft start (4.7 kOhm in the P15 lead, 2.2 uF from the 2815 SW pad to VOUT; parts, needs Ahmed's OK) and repeat.

## 4. Power parts one at a time (bench supply in, electronic load out)
The bench supply (TE2) feeds each part's input with its current limit on (8 A at most); the electronic load (TE4) in constant current is the load on the output.
1. Castle CC BEC Pro: program 7.2 V with Castle Link. No load: 7.20 V +/- 0.10 V. Input sweep 8.4, 7.6, 7.2, 7.0, 6.5 V at 2 A on TE4: write down the output each time. This measures the dropout the power sim assumed (0.3 V). Dropout pass: output at least input minus 0.30 V at 7.0 V in and 6 A out (sim/POWER_FIX.md: 0.6 V of dropout takes the ankle from 5.8 to 20.9 % under 6.0 V with the second feed). 10 minutes at 5 A on TE4, no airflow: case under 60 C.
   - Heat check log: the case temperature every 30 s, and the input and output volts and amps at 5 A; compute the efficiency (output W / input W). Twin prediction (twin/thermal/to1_predict.json, 22 C room, sim pass only): the 60 C gate passes at 92 % efficiency (54 C after 10 minutes) and fails at the 85 % the power sim assumes (about 94 C) and at 80 % (146 C). The measured efficiency replaces the 85 % in sim/power_path_sim.py and twin/thermal. This bench case is not the robot: in the closed body, walking to the battery stop, the twin puts the case at 98 to 122 C at 85 % (HARDWARE_AUDIT B37).
   - Twin (twin/electromech/ELECTROMECH_TWIN.md, closed loop, sim pass only): at a nominal pack the walk speed follows the dropout: 0.752 of the command at 0.10 V, 0.706 at 0.30 V, 0.663 at 0.60 V (typical corner; 0.710, 0.684 and 0.595 high-side). After the servo's response to its bus volts (7.5), the dropout is the bench number that moves the walk most: write it down to 0.05 V or better.
2. Pololu 2815: on-board slide OFF, control switch wired. Switch on: VOUT within 0.1 V of VIN at 5 A on TE4. Switch off: VOUT 0 V. Then 10 minutes at 6.0 A (TE4), switch on its seat with the foam tape: board under 50 C. Reason: as wired (D15 plus the D23 feeds, netlist lengths) the sim pack RMS current while walking is 5.61 to 5.93 A for our 2.65 kg build at full and nominal charge, up to 99 % of the 6.0 A the 2815 carries with its MOSFETs at 55 C (Pololu: 12 V, 22 C ambient, still air), and 6.04 A at the low pack (sim/POWER_PATH_SIM.md 'As built', VERIFICATION.md C7). Over 50 C: add a second 2815 in parallel below the first (40.8 mm free below the seat in CAD).
   - Heat check log: the board temperature every 30 s. Twin prediction (twin/thermal/to1_predict.json, 22 C room, sim pass only): 50 to 59 C after 10 minutes at 6.0 A with a 7.4 V input (central 55 C), steady about 63 C (Pololu's own point is 55 C at 12 V; a lower gate voltage raises the on resistance). So the twin expects the 50 C gate to fail and the second 2815 to be needed.
3. 5 V regulator: input 6.0 and 8.4 V; output 5.00 +/- 0.15 V at no load and at 2.4 A on TE4 for 1 minute.
4. Fuse holder: fuse fitted, under 10 mOhm across the holder (Kelvin method below: TE2 at 2.0 A, no load).

## 5. Kelvin resistance of one servo hop (decides D15 follow-up)
Pass 2.0 A from the bench supply through the V+ conductor of one kit cable hop, servo board to servo board (cable plus both contacts plus one servo board pass-through), and measure the voltage across it with the meter leads on the servo pins, not on the supply leads. R = V / 2.0 A. Repeat for GND.
- Power sim corners: typical 27.6 mOhm per conductor per hop, high-side 65.1 mOhm (sim/POWER_FIX.md).
- Bands per conductor, 2S pack with the second feeds SP4/SP5 (lead decision L3, DECISIONS.md D23 note):
  - Pass: at most 28 mOhm per conductor. Gate: 28 mOhm per conductor. In sim every servo then meets the section 9 gates (our build, nominal pack: right knee 9.9 % under 6.0 V at 28 mOhm, VERIFICATION.md E6b; 10.2 % at 29 mOhm, sim/POWER_PATH_SIM.md 'As built').
  - Warn: over 28 up to 40 mOhm per conductor. The build goes on. The sim predicts a knee over 10 % under 6.0 V in section 9 at a nominal pack (at 40 mOhm the right knee 13.4 %, the ankles 8.0 %; our build), so the section 9 walking log decides, and the 3S plan (sim/POWER_FIX.md option 6) is made ready for Ahmed.
  - Fail: over 40 mOhm per conductor. A contact or crimp is worse than any corner we modelled as typical: find it and fix it before the full assembly.
- With a 3S bus (held by D23) a hop passes up to 100 mOhm. Without the second feeds no hop value passes section 9 (15.4 % at 17.6 mOhm). The ankles alone (sim: the ankle gate holds to about 60 mOhm) are no longer the limit; the knees and the head roll are.
- 22 AWG made leads (BOM contingency X1/X2) cut the ankle time under 6 V by only 2 to 5 points: use them if the kit cables fail the B17 length test fit, not for voltage.
- Twin (twin/electromech/ELECTROMECH_TWIN.md, closed loop, our 2.65 kg build, sim pass only; a prediction, not a gate): from 28 to 40 mOhm per conductor the walk speed at a nominal pack moves by under 1 % (0.702 to 0.700 of the command) and the knee time under 6.0 V goes from 4.5 / 4.8 to 7.2 / 7.8 % (left / right). The open-loop numbers above are the conservative ones and stay the gate.

## 6. Servo bus adapter (USB only, D15)
Waveshare adapter on the Pi USB, H1 not powered, jumper on B, one servo powered from the bench supply through its own power lead. Pass: /dev/ttyACM0 appears (USB 1a86:55d3) and bench/first_servo_check.py --steps 6 finds exactly one servo (check_motors.py only addresses the 14 joint IDs; a new servo is ID 1). This confirms the adapter logic runs from USB VBUS (schematic) with the servo power bypassing it.

## 7. First servo (test order TO1)
Bench supply at 7.4 V, limit 3 A, servo alone.
1. configure_motor.py with the ID it will have; then read back registers 41, 44, 46, 84, 85, 86 and the firmware version. Pass: 85 = 0 (UPSTREAM_ISSUES.md G1), firmware written down. Use bench/first_servo_check.py --configure ID --fix-config; power-cycle and re-read register 85 (the stock configure script can lose writes, software/SOFTWARE.md section 3).
2. No-load speed: a 2 rad step and a 1.5 Hz 0.4 rad sine (SERVO_DEEP_DIVE.md section 6). Pass: about 5 rad/s or more at 7.4 V.
3. Thermal (D2 and its 2026-11-03 note; twin/thermal/THERMAL_TWIN.md, every twin number here sim pass only). Horn fixed against a rigid stop, 7.2 V, room temperature written down. Read registers 13 (Max Temperature Limit) and 19 (Unload Condition) once. Log Present Temperature (63), Present Current (69), Present Load (60) and Present Voltage (62) every 2 s; if a thermocouple is at hand, tape it to the largest free face of the case and log it too. Step A: command past the stop so that Present Current reads 0.9 A and hold until the reading rises less than 0.5 C in 5 minutes (twin, central: about 57 C after 30 minutes, time constant about 6 minutes, about 12 K/W; twin/thermal/to1_predict.json). Step B: 1.2 A until the reading is 60 C or 15 minutes have passed (twin: held on, the 70 C cut comes at about 9 minutes). Do not hold 1.5 A: the twin puts the 70 C cut at about 4 minutes (1 to 5 over its corners). From step A: the stall loop resistance R = duty x Present Voltage / Present Current, with the duty from Present Load (about 2.8 ohm cold; 2.6 to 2.9 ohm in the twin), whose rise gives the winding temperature (copper +0.393 % per C); thermal resistance = (reading at the end - room) / (current^2 x R + 0.15 W of electronics); time constant = time to 63 % of the rise; the winding estimate, the reading and the thermocouple together give where the sensor sits. Put the three values into twin/thermal/twin_thermal.py and re-run it. Pass: the re-run twin keeps every knee at least 10 C under the 70 C cut (and under the register 13 limit, if that reads lower) through a full charge of the session the lab runs first (proposed: stand and walk 50/50 at a 32 C room). If it does not pass: first the thermal guard with rests or a duty limit (THERMAL_TWIN.md section 6); SERVO_UPGRADE_OPTIONS.md only if those are not enough (a contingency; buying needs Ahmed's OK). If the servo cuts its torque during a hold, write down when and at what reading. bench/first_servo_check.py --thermal still runs the earlier 1.5 Nm hold with its own gate (limit minus 10 C): use its log, not its gate, until it is updated. How the servo releases its 70 C cut is not published (BLOCKER), and the live twin in the shared lab gym (overlay gym/overlays/duck) needs it: if the hold of step B reaches the cut, keep the same goal position at 50 Hz and log registers 40, 63, 65 and 69 every 0.2 s for 2 minutes: at what reading the torque comes back, and whether a goal write brings it back. The twin assumes it comes back at 70 C with no hysteresis; then a walking duck's knee drops out every 2 to 8 s and the duck falls 0.8 to 115 s after the first cut (sim pass only). Risk: one servo was reported damaged over 70 C (twin/thermal/THERMAL_TWIN.md source R3); do it on a spare unit or skip it.
4. Note: the servo cuts its torque after more than 2 A for 2 s by default (Feetech spec via the parts check). Do not mistake this for a fault.
5. Bus volts response (twin/electromech/ELECTROMECH_TWIN.md, its largest open input, HARDWARE_AUDIT B39; sim pass only for the twin numbers). Servo at P 32, horn on the 7.3 rig, goal 0.05 rad past the stop. Read Present Load (register 60, output duty) and Present Current (69) for 10 s with the bench supply at 7.4 V, then at 6.0 V. Same duty and the current lower by about 6.0 / 7.4: the firmware does not compensate (the BAM model the twin uses). Duty up by about 1.23 x and the same current: it compensates (the twin's 'comp' case: at a nominal pack the walk keeps 0.859 of the command, 95 % of the trained speed, against 0.706, and the knees spend 3 to 4 x longer under 6.0 V). Then repeat 7.2 at 6.0 V: expected no-load speed 4.4 to 4.6 rad/s (C001 data sheet 42 RPM, model 4.56 rad/s). Write both readings into history/; they set the twin's servo mode (twin/electromech/servo_sts3215.py, bam or comp).

## 8. Staged power-up of the assembled robot (bench supply in place of the pack, at the XT30)
0. Mass and centre of mass, before the first walk (sim/ADDED_MASS_SIM.md finding 2). Before any power, weigh the assembled robot: expected 2.65 +/- 0.05 kg with the D22 print profile and the D23 feeds (2.71 kg if the D22 coupon gate fails; sim/MASS_BUDGET.md). The centre of mass needs the robot holding its home pose, so find it once steps 1 to 3 pass and before step 4: powered at the step 2 settings (7.4 V, limit 3 A, torque on), supply leads slack, both toes on one kitchen scale and both heels on a second one (centre of mass x from the load split and the contact spacing), or the trunk balanced on an edge. Expected: about 1 mm ahead of the ankle servo axes (3 mm in the trained model; sim/MASS_BUDGET.md). If it is more than 4 mm behind the ankle axes, move rear parts forward before any walk (the BEC Pro and the USB slack coil are the heaviest movable ones; sim/ADDED_MASS_SIM.md table 7).
1. 7.4 V, limit 1 A, torque off: idle current under 0.6 A (Pi plus 14 x 6 mA servo idle). All 14 servos answer check_motors.py with the right IDs.
2. Limit 3 A, torque on, robot hanging, holding the zero pose: under 1.5 A.
2a. Hip yaw limit, before step 3 and for every manual move: keep both hip yaws within +/-20 deg. Screws F198 and F211 touch body_middle_bottom past 21.7 deg (D19); the walk uses at most 10.5 deg (VERIFICATION.md C11). Nothing in the Runtime clamps hip yaw: find_soft_offsets.py (376de65) sends every joint to zero plus its offset, and the offset is wherever the hand left the joint. So in step 3 the robot hangs and one hand holds the hip yaw, a hip yaw is turned by hand no more than 20 deg from zero, and any hip yaw offset over 0.35 rad gets the answer n.
2b. Head yaw limit, before step 3 and for every manual move: keep head yaw within +/-45 deg [L]. In CAD only (cables3d, sim pass only), the neck bundle loops meet 3 x OD over +/-160 deg, and the taut routes touch head_pitch_to_yaw (cables3d/CABLES_3D.md rub notes). The Runtime commands at most about +/-42 deg: the gamepad's +/-0.5 rad (mini_bdx_runtime/xbox_controller.py line 16, Runtime 376de65) plus the policy's own head yaw (-13.1 to +8.2 deg in the sim walk, VERIFICATION.md E9), which scripts/v2_rl_walk_mujoco.py line 310 adds. Nothing clamps head yaw in find_soft_offsets.py. So in step 3 a hand holds the head and turns it no more than 45 deg from zero, and any head yaw offset over 0.35 rad gets the answer n.
3. find_soft_offsets.py with the robot hanging (Runtime issue 32: it moves every joint at once), with the 2a limit.
4. Limit 8 A: a short walk with the robot hanging.
- Restart after a power loss (B51, track 1b): with "start_paused": true in ~/duck_config.json, pull the XT30 while standing (hold the duck), reconnect, switch on: the duck must hold its start pose and wait for the A button, and the Pi must boot from the read-only root with no file system repair message in the journal.

## 9. Walking log on the floor (validates the power sim; decides the 3S pack held by D23)
Pack at full charge (8.3 V or more) and again at nominal (about 7.4 V open circuit), with the second feeds SP4 and SP5 fitted (D23). Log Present Voltage and Present Current of all 14 servos for 60 s of walking, plus any bus checksum errors: in altaay_lab/bench with the venv active, `python power_log.py --walk --pack nominal --pack-ocv <meter V> --onnx_model_path ~/BEST_WALK_ONNX_2.onnx`, then the same with `--pack full` (with SP4 and SP5 unplugged add `--feeds none`). It reads every servo at a random time in each 27 ms slot, only while the walk loop sleeps, so no read delays a control write, and counts time under 6.0 V by phase of the 20 ms control cycle (software/SOFTWARE.md section 6).
- Floor and falls (twin/structure/STRUCTURE_TWIN.md, sim pass only, FEA pass only; HARDWARE_AUDIT B44 and B45). Proposed, for Ahmed to decide (B45, STRUCTURE_TWIN.md P6): the first walks on a soft floor (foam mat or carpet), with a tether or a hand behind the robot. After any fall, before walking again, look at both roll_to_pitch side walls between the hip roll horn ears, the eight knee sheet eyes round the horns, the neck sheets, head_roll_mount and the shell where it hit; a crack or whitening means a spare part. Until the fatigue life is known (B44: under 1 hour on the cited design curve, no failure on the best-case data), look at the knee sheet eyes and roll_to_pitch after every walking session, and at the knee and ankle case screw holes in the sheets (oval holes, STRUCTURE_TWIN.md P4).
- Pass, nominal pack: no servo under 4.5 V at any time, in any reading (report item 9.v4.5); no servo under 6.0 V for more than 10 % of the walking time, counted in time (9.time6 PASS; the lowest as built are the ankles 24 and 14, the knees 23 and 13 and the head roll 33, sim/POWER_PATH_SIM.md 'As built'); no checksum errors (9.checksum). 9.time6 INCOMPLETE is not a pass: too few readings (log again with `--seconds 120`) or the voltage not recovering at the end of the sampled part of the cycle (9.recovery). Write down 9.coverage (share of the walk read) and 9.delay (reads that ran into the next control cycle; WARN only).
- Record, and make it a pass line once the 3S pack is decided: median servo voltage (5 s mean) while walking at nominal, at least 7.0 V (9.median_v; a 2S build cannot meet it: the sim reads 6.3 to 6.6 V with the second feeds). Log the forward speed (distance in 20 s) at full and at nominal charge (9.speed): a drop of more than 15 % means the servo voltage limits the walk (older sim, sim/POWER_FIX.md option 7 on the 2.77 kg build before D22: 2S with the BEC in dropout walks at 65 to 79 % of the 7.4 V speed, a regulated 7.2 V bus at 83 to 93 %; the twin's numbers for our 2.65 kg build, in the twin bullet below, are the current prediction).
- Compare with sim/POWER_PATH_SIM.md 'As built' (D15 plus SP4/SP5), nominal pack, worse of the trained-mass and 2.65 kg traces (9.sim, 9.wiring): typical corner ankles under 6.0 V 6.4 % of the time, knees 9.8 %, head roll 6.8 %, lowest servo 5.58 V; high-side ankles 21.4 %, knees 31.1 %, head roll 33.5 %, lowest 4.88 V. If the real numbers are worse than the high-side corner (9.wiring FAIL), stop and fix the wiring before more walking. If 9.time6 fails at nominal, the 3S plan (sim/POWER_FIX.md option 6) goes to Ahmed (D23).
- Twin prediction (twin/electromech/ELECTROMECH_TWIN.md, closed loop, our 2.65 kg build, sim pass only; a prediction, not a gate): the open-loop numbers above overstate the dips, and the walk slows instead. Nominal pack, typical corner: knees under 6.0 V for about 2 to 5 % of the walk (high-side 24 to 30 %), and the robot walks at 0.84 of its full-charge speed in the backlash-model walk and 0.76 in the plain model (high-side 0.83 and 0.75). Share of the trained speed at full / nominal / near the D16 stop: backlash walk 93 / 79 / 76 % (typical) and 91 / 76 / 68 % (high-side), plain walk 96 / 73 / 67 % and 93 / 70 / 58 %. So 9.time6 can pass while 9.speed shows the sag: on 2S the twin expects a 9.speed drop of 16 to 25 % from full to nominal (the BEC in dropout), not a wiring fault. In a session from a full charge the walk falls under 85 % of its full-charge speed at minute 14 to 17 (SOC 48 to 66 %), 3 to 16 minutes before the walk stop of section 11. No fall in 85 closed-loop runs, pushes included, but only in the duck's training physics (2 ms Euler, Newton with 1 iteration, pyramidal cone, floor friction 0.6). In the shared lab gym (overlay gym/overlays/duck: 1 ms, implicitfast, elliptic cone with impratio 5, floor friction 1.0) our build falls in the 15 N push series in 6 of 6 seeds with no supply sag (five at 13.7 s, after a push to the right, one at 19.7 s), and any one change alone (the time step, the integrator, the solver iterations, the cone or the floor friction) makes it fall: the push result is marginal, not a margin (history/2026-11-03_1524_duck_gym_overlay.md; the real floor friction is HARDWARE_AUDIT B41). Do not count on the robot riding out pushes.
- Temperatures (D2; twin/thermal/THERMAL_TWIN.md): log Present Temperature of all 14 servos (register 63, read with register 62), the BNO055 temperature (trunk air near trunk_top) and the Pi chip (vcgencmd measure_temp) through the walking log, and write down the room temperature. power_log.py reads register 63; the BNO055 and Pi readings are not in the bench scripts yet, so log them by hand or add them. Walk inside bench/walk_with_guard.py: it stops the walk at the Max Temperature Limit minus 15 C (55 C at the 70 C default) and cuts torque at minus 8 C (bench/odm_bench/thermal.py). Live twin in the shared lab gym (overlay gym/overlays/duck, twin_live/TWIN_LIVE.md): walk, servos, power path, pack and heat in one loop, our 2.65 kg build, full charge, central heat set (sim pass only; a prediction, not a gate). The hotter knee reads 55 C (the guard's warn) after about 5.6 minutes of continuous plain-model walking at a 25 C room (3.6 at 32 C; backlash model 3.5 and 2.4) and passes the 70 C cut after about 16 minutes (10 at 32 C; backlash 8 and 5.5); the duck then falls. Stand and walk 50/50 (60 s each) peaks at 59 C (plain) and 63 C (backlash) at 25 C with no cut, and at 66 C (plain) at 32 C; the backlash model falls at 32 C (weak knees, no cut). In the first thermal session as proposed (50/50 at a 32 C room, inside walk_with_guard.py with the heat twin's rest rule: rest standing at 55 C, walk again at 45 C) the twin predicts the first 55 C warn after 3.8 walking minutes (plain; backlash 2.5), then a rest that lasts until the pack is empty, because the standing knee settles at 48 to 50 C: no fall, and 3.8 / 2.5 walking minutes per charge. walk_with_guard.py itself ends the walk at its stop: the rest and the walk again at 45 C are the heat twin's rule, added in the twin. In a guarded charge (continuous walking at 25 C) the walk slows from bout to bout and the last bouts crawl at a quarter to two fifths of the first bout's speed: log 9.speed through the whole charge. The Pi chip's rise over the head air is not published (HARDWARE_AUDIT B40): this log measures it.
- Why counted in time: the servo current, and so the dip, peaks just after each 50 Hz goal write, so a read locked to the control loop reads one point of the cycle: 0 to 18 % for the 4.8 to 6.4 % of the as-built sim, 10 to 34 % for the 21 to 24 % of the star replay (sim/POWER_FIX.md). A fixed 27 ms timer is no fix: the step cycle is 27 control cycles (0.54 s), so it reads the same 20 points of every step. The old per-cycle log is kept as `--sampler cycle` for comparison only; it cannot score this test.
- Target guard and bus (track 1b, B47 and item 5b of ELECTRICAL_TWIN.md Track 1b fixes): log the guard's cut count per minute and the bus read and write errors per servo. Twin: no cut in walking (sim pass only). Pass: no cut in a plain walk and no bus error in 10 minutes; a cut in walking means the guard's 10 A budget is too low for the real servos (send the log to the lead).

## 10. IMU
1. 1000 reads with the robot still: no single read jumps (UPSTREAM_ISSUES.md G2; if it does, move the BNO055 to software I2C, dtoverlay=i2c-gpio).
   - Track 1b (B52): run the 1000 reads on software I2C first (PI_SETUP.md 4b lines, dtoverlay=i2c-gpio on bus 1), then once on the hardware bus for the record; keep software I2C unless it shows a problem. Also run bench/timing_budget.py on software I2C: the 50 Hz loop must keep its budget.
2. Tilt test: run scripts/calibrate_imu.py from scripts/, then bench/imu_check.py --tilt. Pass: pitch nose down gives the sign the policy expects (B20). calibrate_imu.py only calibrates and saves the offsets (software/SOFTWARE.md section 2).

## 11. Battery cut-off (software, needed because the BMS cuts only at 2.40 V per cell)
- Stop walking and go to the dock (later lab step) at about 3.5 V per cell under load, about 7.0 V at the pack. In this range the BEC is in dropout, so servo Present Voltage reads about the pack voltage minus the path drop.
- Hard stop (torque off, shut down the Pi) at servo Present Voltage 6.0 V while standing, about 3.3 V per cell at light load, or 5.4 V while walking. The Molicel P30B minimum is 2.5 V; the Tenergy board would only cut at 2.40 V.
- Implemented in bench/battery_guard.py, run inside the walk by bench/walk_with_guard.py. Walk stop rule (DECISIONS.md D16 note): the 5 s mean of the 14-servo median Present Voltage at or under 6.0 V while walking (about 3.57 V per cell, sim pass only); hard stop on the 3 s mean at or under 6.0 V standing or the 2 s mean at or under 5.4 V walking. Check it with battery_guard.py --monitor and a bench supply sweep (software/SOFTWARE.md section 9).
- Twin (twin/electromech/ELECTROMECH_TWIN.md, closed loop, guard in shadow mode, sim pass only; a prediction, not a gate): walking continuously from a full charge, the guard's walk stop comes at minute 20.2 (backlash-model walk, typical corner; SOC 37 %, cell OCV 3.58 V), 18.3 (high-side; SOC 43 %, 3.65 V) and 30.0 (plain walk; SOC 27 %, 3.47 V). Of these three sessions only the high-side one reached the 5.4 V walking hard stop, at minute 25.7 (SOC 20 %). No session fell, before or after the guard, in the duck's training physics (flat floor, no pushes); in the shared lab gym our build falls in the 15 N push series in 6 of 6 seeds (section 9). The walk is under 85 % of its full-charge speed from minute 16.7, 15.6 and 14.1: the guard protects the cells, not the walk.
- Exit code 10 from bench/walk_with_guard.py (also power_log.py): after a stop, Torque Enable (register 40) did not read 0 on every servo, so torque could not be confirmed off (bench/odm_bench/walkhooks.py hard_stop). Treat the servos as live: hold the robot, switch off at the panel switch (D8: it cuts the switched pack bus) and find the cause before the next walk. The JSON report (item 11.torque_off) gives the register 40 read-back of every servo.
- After a battery hard stop (B49; twin/electrical/ELECTRICAL_TWIN.md, calc only): the guard powers off the Pi, but the panel switch keeps the servos, the BEC and the regulator on, about 0.11 to 0.41 A, which takes the cells from the hard-stop point to the P30B 2.5 V minimum in about 1.2 to 4.4 hours (the BMS cuts only at 2.40 V). Rule: switch off at the panel switch at once after a hard stop, and never leave the duck switched on unattended. Measure once: the pack current after the guard's poweroff with the panel switch still on (TE1 10 A range in series at the XT30), written into history/; it replaces the bound.
- Self-off switch (B49 track 1b, only if Ahmed approves the Pololu 2813 in place of the 2815): GPIO26 (pin 37) to OFF, dtoverlay=gpio-poweroff,gpiopin=26. Meter on pin 37 through 20 boots, 20 reboots and a 10 minute walk: never above 0.3 V. Then a guard hard stop on the bench supply at 6.0 V: torque off, then the switch opens by itself; the pack current afterwards reads under 15 uA (twin: under 10.2 uA, calc only).
- D30 (approved 2026-11-04, Pololu 2813 fitted): after `sudo poweroff` the 2813 opens by itself (its LED off, VOUT 0 V within 3 s of the pulse); then the pack current reads under 10.2 uA (twin: 2813 under 0.2 uA plus the BMS 10 uA, calc only). A push of the NKK button turns it back on; a second push turns it off.
- For the docking step, add a pack voltage and current monitor on the pack line (later, not in the stock build).

## 12. Foot switches (D17)
- Before power: each foot circuit (2 switches in parallel) reads under 1 ohm closed and open over 1 Mohm, at the Pi header (read in ohms, as in section 2).
- Powered, robot hanging: bench/feet_check.py --presses 200 (never fc_test.py: it starts the walk and the OpenAI client) shows each foot change state on every press; 200 presses per foot with no missed or stuck reading.
- On the floor, standing still: both feet read "contact" for 60 s without a flicker. A flicker here goes straight into the policy observation.

## 13. Assembly checks (V1 track 2, twin/assembly/ASSEMBLY_TWIN.md; the twin is CAD check only)
- Dry fit (with 1.4) in twin/assembly/BUILD_ORDER.md order; note any part that cannot move into place (anticipated item 1).
- PH0 x 25 mm bit by hand: drive one M2 screw into the TO1 servo case and one into coupon C4; pass if it seats.
- D30 plate: plug into the body_back cutout, NKK bushing through, nut on with at least one full thread past it.
- Side lamp: tape the module (VHB on its back face) and pull by hand along each axis: it stays.
- BEC: two BOM 34 mounts beside it on the belly floor, one tie over the top.
- Weigh 10 trimmed ties and 10 mounts of each type (B59).

13.1 Camera ribbon loop fit (D34, B61): seat the 300 mm Standard-Mini cable in the Pi Zero 22-pin and the Camera Module 3 15-pin connectors, lay it on the strip route of twin/complete3d/d12_ribbon.json (bends 3 mm or more, folds flat and not creased) with the 72.7 mm spare in one gentle loop of about 6 mm radius, then close the head. Caliper the strip width and thickness at both ends and write them into COMPLETE3D.md. Pass: nothing taut or pinched, and the camera gives an image after 20 head pitch, yaw and roll sweeps.
13.2 OFF wire (D30, cable D13, B62): with dtoverlay=gpio-poweroff,gpiopin=26 in config.txt, run sudo poweroff on the Pi. Pass: after the Pi halts the 2813 switches the robot off (Pi and servo bus dark, pack current under 1 mA on the meter), and the button turns it on again. Check the D13 run on the P13 route at both neck joint limits first (TEST_PLAN 1.4).

## 14. Screw cut and fast cable checks (V1 screws job, D36 and D38; twin/screws/SCREWS_TWIN.md)

The twin numbers are calc only and CAD check only; these checks close them. Coupons are in altaay_lab/twin/screws/stl/.
1. Lip and tongue fit (coupons K1a with K1b, K2a with K2b): push fit by hand, no rock, 10 on and off cycles without whitening; K2a rib undersides printed without sag. If tight or loose, rerun twin/screws/mesh_designs.py with a new clearance C (now 0.25 mm).
2. Snap clip (coupon K3): snaps over a 6 mm dowel 10 times without whitening; after 24 h on the dowel at 50 C the opening has not grown (creep).
3. Tie bridge (coupon K4): a 2.5 mm tie passes the slot and holds a 20 N hand pull.
4. Tug test of the plugs after the section 9 walk: each KK 254 housing on the Pi header (X1), the P13 XT30U pair (X3a) and each wire in the WAGO splices G and VSW (X4), by hand; nothing moves or backs out. If one does, re-seat it and add a tie as strain relief.
5. Rattle and buzz: tap the boards held on 2 screws (Pi, servo adapter, camera) and both shells; compare the IMU accelerometer spectrum of the section 9 walk with the bench log; speaker at full volume without buzz. A rattle gets its screw back (every hole is kept).
6. Lid pilots: thread an M2.5x10 into a body_back pilot coupon 10 times, then pull by hand; if it strips, the lid gets M2.5 inserts (new part, Ahmed's OK).
7. Button 10b (MB2011LS1W01-BB) at the first fit: the snap-on cap clears the body_back opening and the plate holds it (D30).
8. Drop check of the closed trunk (shells, lid, battery): BLOCKER: height from the standing trunk centre in the URDF, to be set before the test; after it nothing separates, cracks are logged.

## 15. STS3250 knee servo, one unit first (D32; twin/knee/KNEE_TWIN.md, its numbers sim pass only)
Buy one STS3250-C002 (BOM 1b) before the second. Bench supply at 7.2 V (the BEC output), limit 3 A, the servo alone.
1. Before any write, read back the model number, the firmware version and registers 13, 14, 15, 16, 19, 20, 21, 22, 23, 28, 34, 35, 36, 38 and 48 (FTServo STS memory table). PASS: 13 is 70; 15 is 40 or less (4.0 V; the FTServo wiki lists 9 to 12.6 V for this model, and a unit set near 90 would cut the knee on our 7.2 V bus: write 40). Record the rest in the history file; the twin uses 3.8 A for 28 (the sheet; the table default 511 is 3.3 A, Robo9 reports 4.85 A). If the model number is not 777, add it to pypot's table before configure_motor.py (its "go to 0" would send raw 512).
2. 7.2 V operation (the sheet says 6 to 12 V): hold a 1 kg mass on a 0.2 m lever (2.0 Nm, under the 2.9 Nm sheet stall at 7.2 V) for 30 s. PASS: no torque drop, no error bit in register 65. FAIL: stop; D32 then needs SERVO_UPGRADE_OPTIONS.md option B.
3. Bench BAM identification at 7.2 V (bam/feetech/record.py pendulum; arm mass and length recorded): fit kt, R, friction and damping, and set register 21 for the C001's stiffness (twin band 11 to 19). It settles B70 and B73 and gives the run2_sts3250 retrain its values.
4. Heat hold at 1.1 A (the C001's 1.5 A torque by the Kt ratio 8 / 11) from a 25 C room until the reading settles or reaches 62 C, register 63 every 10 s: the thermal resistance and time constant (the twin's high end assumes Robo9's rise, 40 to 70 C in 8 minutes at 20 kg.cm). A thermocouple on the printed thigh sheet next to the case shows how much heat the aluminium case puts into the PLA.
5. Fit in a printed thigh with 2 M2x6 machine screws (BOM_FULL F07b): thread depth, screw length, no rattle.
PASS of all five: order the second unit.

## 16. Closed holes and ear seats (D39; twin/holes/HOLES_TWIN.md, CAD check only)

- 16.1 Coupon K2 (S1): add one ear seat (body_middle_bottom) and its back shell ear: the ear slides over the seat by hand with no rock, gap 0.25 mm by feeler.
- 16.2 First trunk fit: back shell on its 6 screws; tap test round the rim for buzz (largest rim gap between screws 90 mm).
- 16.3 Charger: with the M2.5 in, the board must not turn by hand more than about 0.5 deg (the USB-C slot holds it); plug in and pull 10 times.
- 16.4 Every closed hole: look for a missing plug or a sunk cap on the first prints (D42: caps fitted to the part surface, flush within 0.05 mm in CAD; the back shell ears must show no dimple).
- 16.5 D42 patterns: body_front on its 4 corners, the battery lid on 4, head_bot_sheet on 4 mirrored corners; every screw goes in by hand first, then a tap test round each plate for buzz.

## 17. Companion mics and ego-noise recordings (D47 to D49; twin/companion/COMPANION.md sections 10 and 12)

Needs the two mic boards (BOM E8, not bought), the head built to the V1 seats with the foam rings, and a quiet bench room. Every recording follows the data plan of COMPANION.md 12.6 (2 ch, 48 kHz, S32_LE; joint log at 50 Hz on CLOCK_MONOTONIC_RAW; sidecar JSON). Files go to the lab's big-file archive (GrokBox_Archive on Ahmed's PC, START_HERE.md), never into git; only the index goes into git. People recorded agree first.
- 17.1 Slot check: one clap at 1 m at 0, +60 and -60 deg (head still). PASS: the left channel (0) leads for +60 and the right for -60; at 0 the lag is within 1 sample.
- 17.2 Sync check: at the start and end of a 10 min session, a 50 ms chirp on the duck's own speaker and one sharp ear command. PASS: the chirp is found in the capture within 5 ms of its playback time, and the ear click within 5 ms of the time its command was stamped plus a fixed delay that is the same at the start and the end (within 2 ms). FAIL: no ego-noise session is kept until the timestamps are fixed.
- 17.3 Capture health in every session: 0 ALSA overruns; every sidecar label present; the Pi SoC temperature logged once a minute (an upper bound on the head air; the mics' specifications hold from 0 to 45 C); the sha256 of each file checked again in the archive. Gait phase: every joint-log row carries the policy's two observation phase values and the counter imitation_i (COMPANION.md 12.6), and the sidecar lists the phase origin and every reset, freeze and rate change. PASS: from one row to the next, imitation_i moves by the logged rate f + o modulo 27, or stays put on a logged freeze, or goes to 0 on a logged reset; each row's phase values equal cos and sin of 2 pi times the previous row's imitation_i over 27, except the first row after the origin or a reset, where they are [0, 0]. Any other jump fails the session.
- 17.4 Levels: in S0 to S6, the peak of each channel stays under 99 % of full scale. A clipped session is kept but marked. The SPH0645LM4H overload point is 120 dB SPL at 10 % THD at 1 kHz (datasheet), so a clipped walk or ear session means about that level at a port, and it decides whether the foam or the seat needs a change.
- 17.5 Sessions S0 to S8 of COMPANION.md 12.6 (380 min, about 9.1 GB raw, calc only), in that order. The head is not changed between them; a change to a seat, the foam, an ear horn or a nearby screw means S0 to S4 and S6 again.
- 17.6 First numbers from the data, for D49: the ego-noise level and spectrum per actuator and per walk speed (S1 to S4); the direction error at the 8 bearings standing (S7 still) and while stepping in place, with and without the ego-noise mask (bench script, not written yet); the wake word false-reject rate in each motion state and false-accept rate per hour in S0 and S4. These replace the BLOCKERs of COMPANION.md 12.9 items 2 and 3.

## 18. V1 freeze parts (D51 to D56; twin/freeze/FREEZE.md; when the parts come, nothing bought)
1. `i2cdetect -y 1` with everything wired: 28, 29, 5a, 5b and nothing else; then bench/timing_budget.py with the BNO055, both MPR121 (20 Hz each) and the ToF (50 Hz) read in the loop: the 50 Hz loop keeps its budget.
2. Touch: copper foil on a printed 3.0 mm coupon and on the real shell: a palm and two fingertips change the MPR121 filtered data clearly over its baseline; no touch reads from neck or ear motion, the speaker playing, or the duck sitting on the nest mat (D61; expression study 4.1). The feet are not charge contacts.
3. Speaker duct: the expression study A/B sweep (phone at 0.5 m) with and without the duct; the foam ring seals without lifting the stand.
4. Cliff ToF: flat floor 200 to 215 mm (calc 209 mm), a 40 mm step trips (over 250 mm), black and glossy floors, carpet, sunlight through a window; the robot walking on flat ground never trips (cliff_walk.json, sim: 190 to 216 mm).
5. Being picked up (D55): 20 lifts from standing, walking and docked: the 2-of-3 vote trips within 200 ms; 10 min of walking: no trip; set-down on the floor: legs back only after the floor check; on a table: stays limp.
6. Ears on hardware PWM (D53): no jitter at hold with the scope on GPIO12 and 13; I2S audio still plays and records with the overlay in.

## 19. Alert sit (D59; twin/sit/SIT.md; the CAD is CAD check only, the sit is sim pass only)
1. Angle limits at bring-up: `bench/first_servo_check.py --configure <ID> --fix-config --angle-limits` writes them after its other steps (7.2 and 7.3 need the full range) and gates the read-back (item 7.1.limits); on its own: `python3 bench/set_angle_limits.py --port /dev/ttyACM0 --write --ids <ID> --zero-offsets` (torque off, unlock, registers 9 and 11, lock, read back). Pass: the read-back raw values equal software/servo_limits.json `raw_soft` for that joint (zero offset), for example knee 1758 and 3721 (-25.5 and +147 deg). The knee's -90 to +150 deg span does not cross the 0/4095 wrap (raw 1024 to 3755 at a zero offset, 340 steps of margin); the script refuses a range that would.
2. First leg, by hand, servos unpowered, before the right leg prints (PRINT_PLAN left-leg checks): the M2 screws of the ankle servo go in through the clamp block's counterbores with the driver; the heel screw (F024, moved 20 mm, D59) goes into its insert; the knee folds onto the TPU bumper at 150 deg with no rub on the thigh sheets or the cache; the ankle reaches the TPU pads at -95 deg with the case clear of the foot plates; the hip roll lug's conformal TPU face (roll_pad_left, roll_pad_right) meets the roll_motor_bottom case corner at -8 deg with the printed lug clear of the case; the thigh cover lands on the hip pad at -75 deg; the stock neck sheets' back edges land on the neck block's two pads at +25 deg (low on the edge, r 28 mm) and the left sheet's front edge on the head hook's 10 mm pad at head -25 deg. Every cable passes the loops at the knee and ankle stops (cables3d/CABLES_3D.md, D59 run).
3. Joint zeros: software/CALIBRATION.md (stop references, 5 presses per joint; pass 0.5 deg per joint and between legs). Write the limits again with the calibrated offsets.
4. Sit and stand on a table, the robot on a tether, bench supply 7.4 V: sit with the A1b path (sitlib.PATH_A1B: the trunk leans forward in the middle; on the way up hip roll goes back to 0 while seated) (software 3 deg inside every stop), torque off at the bottom, wait 60 s; then torque on and stand. Pass: the duck settles onto the knee bumpers, ankle pads, seat and belly bumper with all four foot pads on the table, the knee current stays under the 1.57 N m peak of the study converted at the STS3250 Kt (KNEE_TWIN.md section 2), and 10 of 10 stands succeed. The feet are not charge contacts. D61 superseded the feet-contact dock (D58). Charging is section 20, through the four spring pins under the body.
5. **BLOCKER (unpowered servo friction):** the torque-off sit and the push results lean on the servos' back-drive friction, which no datasheet gives. Hang a known weight on a lever (kitchen scale, 50 mm arm) from each leg joint, torque off, and find the least torque that starts it moving, 3 times per joint. Pass: within a factor of 2 of the sim value in twin/sit/SIT.md section 5; else rerun `twin/sit/sit_sim.py push` with the measured friction.
6. **BLOCKER (joggled sheet strength):** print the spare shin_right_sheet (parts.csv spare) as a coupon and load the plate against the horn zone with weights at the 2 x fall load of twin/sit/sit_stress.json (calc), 10 s. Pass: no crack or whitening at the web of the joggle or round the clamp block.
7. Knee loop flex test (the D59 knee goes to 150 deg): cycle the knee loop bundle (the D3 bundle only) through the knee from 0 to 150 deg on a printed shin and thigh pair at 2 to 3 Hz to 1 million cycles, with 4-wire resistance logging. Pass: no rise over 10 % and no broken strand at the cut-open check. D61 puts the charge pins under the body, so there are no feet-dock pad wires in this loop. (An earlier dock study cycled a knee loop to 90 deg and included those wires. That version is superseded.)
8. Check (neck stop block seat; round 2, 2026-11-10): the block hangs on the two hip yaw servo screws F127 and F129 (M2x6 to M2x12 through its 4 mm flange, the same thread engagement in the STS3215 case) and rests on a 4 mm foot behind its pillars. The pads sit low on the neck sheets' back edges, so the stop load's line passes in front of the foot's back edge: no design case pulls the screws (0.0 N in every row of twin/sit/sit_stress.json, calc only; the first round's block put 482 N on one screw at the fall load). The check stays because that 0 N rests on the block seating as drawn: at the first assembly the foot sits flat on trunk_top (no rock under a finger press at the pillar tops; a 0.1 mm feeler does not enter under the foot's back edge), both screws seat without stripping the servo case, and the sheets land on the pad faces, not on the pocket rims. Optional, on a spare servo bottom case only: one M2x12 through a 4 mm printed flange pulled with a spring scale through a hook, the value recorded (no pass line: the design load is 0 N; the 500 N estimate of sit_stress.py is checked by it).
9. **BLOCKER (get-up servo margin, sim pass only):** the get-up through the sit (D60, twin/sit/getup/GETUP_VIA_SIT.md) holds the hip pitch servos at their torque limit through its sit-up (3.14 N m at 7.2 V, 2.62 N m at 6.0 V) and the rise holds the neck at its limit; the thermal and stall margins of those holds are not checked. On the merged model (2026-11-10, twin/sit/getup/VIA_SIT_EVAL.md, sim pass only; current and duty calc only) the margins are unchanged: hip pitch at its limit for up to 1.08 s at 6.0 V (0.32 s at 7.2 V), over 2.0 A for up to 0.77 s and over 80 % duty for up to 1.14 s, under the 2 s the Feetech protections need; the bench log checks that the real servo does not trip or overheat there. Log the servo temperatures and currents through five get-ups in a row on the bench supply at 6.0 V before the sequence goes into the Runtime.

## 20. Nest dock bench (D61; when the parts arrive; nothing here has been run)

D61 replaces the feet-contact dock. The duck walks onto a felt mat, turns 180 deg, and sits facing the room with the torque off. Four spring pins under the body (two in the seat, two in the belly bumper) land on conductive cloth. The charger moves into the duck. The mat stays off until a two-wire check says the thing on the cloth is the duck. The duck finds the mat with the camera only. The nest CAD is drawn and not installed (twin/dock/nest/cad/NEST_CAD.md, CAD check only). The sequence sims are sim pass only and are not a pass for any step below.

Do these in order. The first five use a coupon, a meter, and a current-limited bench supply. They are the cheap tests that can kill the cloth idea or the open contacts before anyone prints a whole duck. The last four need a walking duck.

1. **Contact resistance, pin on cloth (cheapest, and the one that can drop the cloth).** One probe of the chosen tip (section 3 of the nest CAD; the catalog round tips are 0.91 mm and 1.40 mm across, QA Technology 100-40 catalog, opened 2026-11-11; the 2.3 mm head in that CAD is not on the catalog page) pressed into the gold cloth over felt, at the catalog standard-spring force (0.42 N at first touch, 1.58 N at 8.05 mm stroke, same catalog). Four-wire ohms, 10 presses. Also the loop the duck will use: one plus pin, the cloth and foil, one minus pin, at 1.0 A from the bench supply. The 1.0 A is the charge current D61 assumes. The MCP73213 datasheet was not opened, so that current is not a datasheet number. Pass: write the ohms down; the two-pin loop stays under 0.15 ohm (0.15 V at 1.0 A, calc only) and does not jump by more than 20 % across the 10 presses; the tip does not cut the cloth. Fail: open, a hole, or a loop over 0.15 ohm. The cloth sheet resistance in the nest note (about 0.10 ohm on the ring path, calc only) is not this measurement.

2. **Snag.** Drag that same round tip across the cloth for 20 passes at the spring force. Pass: no lifted thread and no puncture. Fail: a snag. Do not use a crown, razor, or spear tip. Those shapes are on the same catalog page and would catch cloth.

3. **Hair and dirt.** Loose hair, household dust, and a damp fingerprint on the same coupon. Repeat the step 1 reading. Pass: it still connects, and a dry wipe brings the reading back within 20 % of step 1. Fail: open, or a hair that bridges the felt gap between plus and minus (the concept gap is 32 mm, D61, calc only; the drawn mat is CAD check only). A coin smaller than that gap must not be able to touch both cloths. Check with a US quarter laid flat on the gap.

4. **Short wear, before any life claim.** 500 sit-downs of the tip on the cloth, by hand or a lever, at the same force. Pass: no hole, and the step 1 reading is still within 20 %. The catalog's 500,000 cycles are at 8.05 mm stroke in a socket, not on cloth (same catalog). Cloth life stays unknown until this runs, and 500 is only a first look, not a life test. The long wear is DEFINITION_OF_DONE.md gate 4.

5. **Two-wire "is it really the duck" gate, on the bench, before the mat is ever left powered.** The gate board is not designed yet (twin/dock/nest/HANDOVER.md). Build the probe on a breadboard from the intent in the stripe study: the cloth stays at a small probe until a signature is seen, and a leak check refuses a resistor (water), a short (coin or foil), and a wet cloth. Current limit on the supply the whole time. Pass, each one tried 5 times: nothing, a coin, foil, a wet cloth, and a bare finger-stand-in (a 1 kilohm to 100 kilohm resistor) leave the power switch open; a stand-in of the duck signature closes it; lifting the stand-in opens it on the next check. Fail: any stand-in turns the supply on, or the supply stays on after the duck stand-in is lifted. Do not put this on the floor until it passes.

6. **Mat edge on real felt.** A tethered duck walks straight across a real felt edge about 2 mm high, and again across the drawn edge of two 1 mm steps (CAD check only; that edge is not in the sim). Ten crossings at about 6.0 V and ten at about 7.2 V, no yaw command while the foot is on the edge. Pass: 10 of 10, no fall, at each voltage and each edge. The sims are not a pass: 29 falls in 540 with steering, and 13 falls in 540 when the crossing was forced straight (sim pass only, twin/dock/nest/sim/NEST_SIM.md and sim/v2/NEST_SIM_V2.md).

7. **Turn 180 deg and sit on the mat.** From a start about 0.5 m in front of the mat, against a real wall. Pass, 10 of 10: the duck sits facing the room, torque off, all four pins touch (continuity on each pin), no part touches the wall or the rim, and the head stays at least 20 mm off the wall (a tape measure). Then it stands and walks straight off, 10 of 10, no fall. The sim's closest clear head distance was 23.5 mm (sim pass only, the steering runs). That number is not this pass line. A touch is a fail even if the sim stayed clear.

8. **Charger heat inside the duck.** With the charger in the trunk (the board is not seated yet; this step waits on that seat), charge the real pack from a low state to the end. Write down the room temperature. Log cell temperature, the charger case, the trunk air, and the nearest PLA every minute. Pass: cells stay between 0 C and 45 C (inside the cell sheet's 0 C to 60 C charge window, Molicel P45B data sheet version 1.2, opened 2026-11-11), the charger case stays under 70 C, and the nearest PLA stays under 45 C. The thermal twin's PLA heat-deflection band is 49 C to 57 C (twin/thermal/THERMAL_TWIN.md; that band was not re-measured here). The 1.9 W to 3.2 W figure is calc only (D61) and is not a pass. Fail: any of those temperatures, or the charger stops early because it got hot. Do not run this until step 5 has passed. The thermal twin has not been re-run with this charger (BLOCKER, D61).

9. **Camera-only nest finding.** No tags, and no start pose taken from the sim. From about 1 m and from about 2 m, room lights on and room lights dim, 10 tries each, once with a low pack and once with a full pack. Pass: it reaches the sit and the charge path connects, 10 of 10 in each set, no fall, no wall touch. Fail: it needs a tag, a measured start pose, or a person to place it. The sim uses a pose stand-in (true pose plus noise). That stand-in does not count (D61, BLOCKER).
