aaltaay/Open_Duck_Mini_v2/altaay_lab/history/2026-11-13_0940_test_playbook.md

# Test playbook

2026-11-13 about 9:40 AM ET. A testing playbook was added under altaay_lab/test/. It does not close a Definition of Done gate. Sim numbers in bec12_heat.json and fault_inject.json are sim pass only or calc only.

The 12.0 V BEC setpoint does not regulate on the STS12 walk (input minimum 11.335 V typical, regulation needs 12.3 V). Dropout loss 1.441 W, case 60.22 C at 40 min, central, 25 C room (sim pass only). The continuous-walk knee reading still leaves 60 C: 3.33 min on the existing session (body 94.67 C, the published run), and 4.83 min on the Kt-scaled shape (sim pass only, not run C).

No hardware was used. D61 was not edited. verify/part_limits.yaml, verify/check_power_limits.py, and that change's workflow were not added here.
