aaltaay/Open_Duck_Mini_v2/altaay_lab/test/records/templates/tp_09_walk.csv

record_id | test_plan | pack | servo | min_V | pct_under_6V | pct_under_4V | temp_C | note
EXAMPLE | 9 | 3S | right_knee |  |  |  |  | not_run do not treat this row as data
