aaltaay/Open_Duck_Mini_v2/altaay_lab/bench/tests/data/sim_star_discharge.csv

# sim pass only. Same model | typical corner | star topology; 6 s walk window per cell OCV step [4.0 | 3.9 | 3.8 | 3.7 | 3.6 | 3.55 | 3.5 | 3.45 | 3.4 | 3.35 | 3.3 | 3.25 | 3.2]; time between steps is artificial
t_s | cell_ocv_v | v_10 | v_11 | v_12 | v_13 | v_14 | v_20 | v_21 | v_22 | v_23 | v_24 | v_30 | v_31 | v_32 | v_33
0.000 | 4.000 | 6.470 | 6.326 | 6.188 | 6.055 | 6.048 | 6.419 | 6.131 | 5.886 | 5.696 | 5.655 | 6.503 | 6.453 | 6.430 | 6.411
0.020 | 4.000 | 6.771 | 6.643 | 6.518 | 6.401 | 6.398 | 6.754 | 6.572 | 6.412 | 6.260 | 6.214 | 6.805 | 6.769 | 6.740 | 6.714
0.040 | 4.000 | 6.951 | 6.835 | 6.724 | 6.618 | 6.616 | 6.955 | 6.843 | 6.739 | 6.638 | 6.613 | 6.977 | 6.933 | 6.894 | 6.865
0.060 | 4.000 | 7.036 | 6.920 | 6.814 | 6.711 | 6.702 | 7.057 | 6.996 | 6.940 | 6.892 | 6.887 | 7.056 | 6.999 | 6.968 | 6.950
0.080 | 4.000 | 6.890 | 6.760 | 6.654 | 6.551 | 6.528 | 6.923 | 6.885 | 6.854 | 6.849 | 6.846 | 6.889 | 6.765 | 6.705 | 6.684
0.100 | 4.000 | 7.144 | 7.093 | 7.044 | 7.003 | 6.973 | 7.140 | 7.078 | 7.025 | 7.006 | 7.003 | 7.138 | 7.077 | 7.053 | 7.050
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
