aaltaay/Open_Duck_Mini_v2/altaay_lab/bench/tests/data/sim_star_full_typical.csv

# sim pass only. sim/power_path_sim.py build() | topology star (D15) | walk backlash 10.0-16.0 s | cell OCV 4.2 V | corner typical; servo terminal voltage in V at 50 Hz
t_s | bus_v | v_10 | v_11 | v_12 | v_13 | v_14 | v_20 | v_21 | v_22 | v_23 | v_24 | v_30 | v_31 | v_32 | v_33
0.000 | 7.361 | 6.874 | 6.737 | 6.607 | 6.481 | 6.475 | 6.816 | 6.517 | 6.259 | 6.064 | 6.025 | 6.905 | 6.857 | 6.836 | 6.818
0.020 | 7.616 | 7.077 | 6.943 | 6.812 | 6.689 | 6.687 | 7.061 | 6.876 | 6.712 | 6.556 | 6.511 | 7.114 | 7.079 | 7.051 | 7.026
0.040 | 7.787 | 7.099 | 6.980 | 6.867 | 6.758 | 6.755 | 7.103 | 6.989 | 6.882 | 6.778 | 6.754 | 7.126 | 7.083 | 7.044 | 7.016
0.060 | 7.872 | 7.108 | 6.991 | 6.884 | 6.779 | 6.770 | 7.130 | 7.070 | 7.014 | 6.966 | 6.961 | 7.129 | 7.072 | 7.041 | 7.024
0.080 | 7.748 | 7.091 | 6.958 | 6.849 | 6.742 | 6.719 | 7.125 | 7.088 | 7.058 | 7.052 | 7.049 | 7.092 | 6.971 | 6.913 | 6.892
0.100 | 7.989 | 7.144 | 7.093 | 7.044 | 7.003 | 6.973 | 7.140 | 7.078 | 7.025 | 7.006 | 7.003 | 7.138 | 7.077 | 7.053 | 7.050
0.120 | 8.063 | 7.151 | 7.097 | 7.046 | 7.009 | 6.974 | 7.149 | 7.090 | 7.037 | 7.006 | 7.003 | 7.160 | 7.139 | 7.132 | 7.127
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
