aaltaay/Open_Duck_Mini_v2/altaay_lab/bench/tests/data/sim_star_low_typical.csv

# sim pass only. sim/power_path_sim.py build() | topology star (D15) | walk backlash 10.0-16.0 s | cell OCV 3.3 V | corner typical; servo terminal voltage in V at 50 Hz
t_s | bus_v | v_10 | v_11 | v_12 | v_13 | v_14 | v_20 | v_21 | v_22 | v_23 | v_24 | v_30 | v_31 | v_32 | v_33
0.000 | 5.630 | 5.160 | 5.039 | 4.925 | 4.817 | 4.810 | 5.112 | 4.854 | 4.650 | 4.475 | 4.424 | 5.180 | 5.119 | 5.092 | 5.068
0.020 | 5.857 | 5.424 | 5.321 | 5.222 | 5.131 | 5.129 | 5.402 | 5.230 | 5.084 | 4.948 | 4.889 | 5.446 | 5.404 | 5.369 | 5.337
0.040 | 6.029 | 5.626 | 5.534 | 5.450 | 5.370 | 5.367 | 5.628 | 5.537 | 5.454 | 5.374 | 5.344 | 5.639 | 5.586 | 5.539 | 5.504
0.060 | 6.077 | 5.680 | 5.588 | 5.507 | 5.429 | 5.419 | 5.696 | 5.647 | 5.603 | 5.567 | 5.562 | 5.687 | 5.617 | 5.580 | 5.558
0.080 | 5.861 | 5.426 | 5.314 | 5.232 | 5.152 | 5.123 | 5.450 | 5.405 | 5.368 | 5.362 | 5.359 | 5.406 | 5.247 | 5.171 | 5.145
0.100 | 6.073 | 5.688 | 5.625 | 5.565 | 5.515 | 5.478 | 5.682 | 5.606 | 5.542 | 5.519 | 5.517 | 5.680 | 5.604 | 5.576 | 5.573
0.120 | 6.173 | 5.801 | 5.737 | 5.675 | 5.630 | 5.587 | 5.799 | 5.728 | 5.664 | 5.627 | 5.624 | 5.813 | 5.789 | 5.781 | 5.776
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
