aaltaay/Open_Duck_Mini_v2/altaay_lab/bench/tests/data/sim_star_nominal_highside.csv

# sim pass only. sim/power_path_sim.py build() | topology star (D15) | walk backlash 10.0-16.0 s | cell OCV 3.7 V | corner high-side; servo terminal voltage in V at 50 Hz
t_s | bus_v | v_10 | v_11 | v_12 | v_13 | v_14 | v_20 | v_21 | v_22 | v_23 | v_24 | v_30 | v_31 | v_32 | v_33
0.000 | 6.159 | 5.623 | 5.340 | 5.072 | 4.818 | 4.800 | 5.509 | 4.919 | 4.455 | 4.049 | 3.913 | 5.681 | 5.545 | 5.486 | 5.433
0.020 | 6.437 | 5.941 | 5.695 | 5.456 | 5.238 | 5.231 | 5.889 | 5.486 | 5.143 | 4.822 | 4.679 | 6.004 | 5.910 | 5.832 | 5.761
0.040 | 6.650 | 6.189 | 5.965 | 5.757 | 5.560 | 5.554 | 6.194 | 5.973 | 5.770 | 5.573 | 5.504 | 6.232 | 6.115 | 6.010 | 5.934
0.060 | 6.707 | 6.252 | 6.027 | 5.828 | 5.635 | 5.611 | 6.290 | 6.158 | 6.038 | 5.935 | 5.922 | 6.281 | 6.128 | 6.046 | 5.999
0.080 | 6.462 | 5.965 | 5.698 | 5.498 | 5.305 | 5.237 | 6.027 | 5.927 | 5.845 | 5.832 | 5.826 | 5.929 | 5.574 | 5.402 | 5.341
0.100 | 6.755 | 6.341 | 6.201 | 6.069 | 5.958 | 5.876 | 6.329 | 6.162 | 6.021 | 5.970 | 5.964 | 6.328 | 6.164 | 6.101 | 6.095
0.120 | 6.876 | 6.474 | 6.331 | 6.195 | 6.095 | 6.001 | 6.469 | 6.312 | 6.173 | 6.091 | 6.085 | 6.503 | 6.451 | 6.433 | 6.421
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
