aaltaay/Open_Duck_Mini_v2/altaay_lab/bench/tests/data/sim_star_nominal_typical.csv

# sim pass only. sim/power_path_sim.py build() | topology star (D15) | walk backlash 10.0-16.0 s | cell OCV 3.7 V | corner typical; servo terminal voltage in V at 50 Hz
t_s | bus_v | v_10 | v_11 | v_12 | v_13 | v_14 | v_20 | v_21 | v_22 | v_23 | v_24 | v_30 | v_31 | v_32 | v_33
0.000 | 6.394 | 5.913 | 5.779 | 5.651 | 5.529 | 5.522 | 5.864 | 5.590 | 5.363 | 5.180 | 5.135 | 5.941 | 5.887 | 5.863 | 5.842
0.020 | 6.639 | 6.198 | 6.081 | 5.966 | 5.861 | 5.858 | 6.179 | 6.002 | 5.849 | 5.704 | 5.653 | 6.227 | 6.189 | 6.157 | 6.129
0.040 | 6.799 | 6.386 | 6.280 | 6.181 | 6.086 | 6.083 | 6.389 | 6.287 | 6.192 | 6.099 | 6.073 | 6.406 | 6.359 | 6.317 | 6.286
0.060 | 6.848 | 6.442 | 6.336 | 6.241 | 6.149 | 6.140 | 6.458 | 6.395 | 6.337 | 6.286 | 6.281 | 6.456 | 6.394 | 6.360 | 6.341
0.080 | 6.704 | 6.271 | 6.149 | 6.054 | 5.961 | 5.935 | 6.300 | 6.260 | 6.227 | 6.221 | 6.218 | 6.263 | 6.126 | 6.061 | 6.037
0.100 | 6.932 | 6.556 | 6.500 | 6.447 | 6.404 | 6.371 | 6.551 | 6.484 | 6.428 | 6.407 | 6.404 | 6.549 | 6.483 | 6.457 | 6.455
0.120 | 7.017 | 6.653 | 6.595 | 6.541 | 6.501 | 6.464 | 6.651 | 6.587 | 6.531 | 6.498 | 6.495 | 6.663 | 6.641 | 6.633 | 6.628
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
