aaltaay/Open_Duck_Mini_v2/altaay_lab/history/2026-11-14_runD_walk.md

# 2026-11-14: run D is the walk, and the merged twin report was the stock policy

The merged twin/out/REPORT.md before this change said 30.07 walking minutes and 17.48 A pack peak. Those figures are the stock BEST_WALK_ONNX_2 policy (sim pass only). `make twin` set ODM_ONNX inside walk(), after parts_truth had imported added_mass_sim. That import setdefaulted the stock file, and current_budget froze the path.

Run D is now the default walk (DECISIONS.md D66, problems/retrain_sts12/RUN_D.md). Run C is kept. The rerun is 41.48 walking minutes, 0 rests, knee peak 38.4 C, pack peak 13.81 A (sim pass only). Fold-to-sit and sit-to-stand are not trained. Camera docking is still BLOCKER. D61 was not edited.
