aaltaay/Open_Duck_Mini_v2/altaay_lab/history/2026-11-14_one_twin_before.md

# Checklist wording before the one-command twin

2026-11-14. The summary and the gate-0 list below are the wording that was in TWIN_CHECKLIST.md before the one-command row. The dollar totals in that summary were already the D65 figures. This note does not add a new price.

There was no row named One command. Gate 0 item 1 said there is no single model. The thermal, electromechanical, nest, and training rows were not changed by a single end-to-end run.

Gate 0 item 1, as it stood: there is no single model. The print set, the netlist, and the viewer are the walking duck. Nest v2 is the approved nest and is not in that model. D61 was not edited. The BQ24133 board has no seat.
