aaltaay/Open_Duck_Mini_v2/altaay_lab/problems/HOLD12_WALK.md

# Held 12.0 V walk

Sim pass only. CPU only. Run C policy, backlash, typical corner, 10 s, command 0.15 m/s.
The servo rail is held at 12.0 V (D65). This is not a hardware pass.

| Item | Value |
|---|---|
| Fall | none |
| Duration | 10.0 s |
| Forward speed vx | 0.122 m/s (sim pass only) |
| Tracking ratio | 0.815 (sim pass only) |
| Knee min L / R | 11.681 / 11.720 V (sim pass only) |
| Pack peak | 9.261 A (sim pass only) |
| Rail minimum | 12.0 V (sim pass only). The set point is held. |
