aaltaay/Open_Duck_Mini_v2/altaay_lab/history/2026-11-13_0955_rms_heat.md

# RMS pack heat, and bench gate exit codes

2026-11-13 about 9:55 AM ET. Supersedes the 60.22 C BEC case in history/2026-11-13_0940_test_playbook.md. The walk heat now squares the session RMS pack current, scaled to the STS12 RMS. Converter loss still uses the mean current. Sim pass only, central, 25 C, 40 min: BEC case 60.7 C, cells 43.18 C, wall 29.0 C. Knee reading still reaches 60 C at 4.83 min. The bench checker now exits nonzero when a measured hop or walk gate fails, and when a filled record id is not in the prediction.
