aaltaay/Open_Duck_Mini_v2/altaay_lab/history/2026-11-13_0900_bec_12v_limits.md

# BEC set to 12.0 V, and a power-limit check

2026-11-13, morning ET. Supersedes the 7.2 V BEC set point for the 3S rail, and the 16 V pass-through used in the first 3S walks. Those numbers stay in the files, marked superseded. D61 was not edited.

The live set point is 12.0 V (DECISIONS.md D63, POWER.md section 11, wiring/netlist.yaml). The pack domain is 9.0 V to 12.6 V. U3 VIN uses that domain.

BLOCKER: Castle does not publish the minimum input or the behavior below the set point. A pack under 12 V cannot hold 12.0 V. With the 0.3 V dropout assumption the sim regulates only from 12.3 V up.

The check is altaay_lab/verify/check_power_limits.py. A power-design change has to pass it before a sim uses the change. The 60 s run C sheet walk at 12.0 V is problems/retrain_sts12/eval_table_bec12.md. The 16 V table stays in eval_table.md. No retrain.
