aaltaay/Open_Duck_Mini_v2/altaay_lab/history/2026-11-12_2200_rail_2815_note.md

# Harness rail points at the 2815

2026-11-12 10:00 PM ET. wiring/netlist.yaml still holds the Pololu 2813 pins and wires so the earlier harness checks stay. That identity is marked superseded. The rail to build is the Pololu 2815 with the BQ24133 interlock in circuitry/bq24133_board.yaml and circuitry/SERVO_RAIL.md. No wire was removed. D61 was not edited.
