aaltaay/Open_Duck_Mini_v2/altaay_lab/problems/PROBLEMS.md

# Gate 0 problems

2026-11-12 ET. One row per problem. The first five are the red team order (altaay_lab/redteam/REDTEAM.md, PR 48). Row 1 was reproduced on the existing electromechanical twin. Source is the merged file named in the row. A sim, a calc, a CAD check, or an FEA pass is evidence. It is not a PASS of TWIN_CHECKLIST.md.

The checklist as of PR 44, then updated the same day for the shin eye, is 22 rows: 13 FAIL, 7 GAP, 2 NOT RUN. Studies since that pass: PR 45 blind walk, PR 46 shin eye, PR 47 wall card, PR 48 red team. This folder does not edit those files. Money items (the pin coupon, a training GPU run, parts that are out of stock) stay BLOCKER until Ahmed says yes. Nothing was bought.

## Ranked first

Current walk, 2026-11-12 ET. The 3.4 s to 3.6 s fall is the superseded 2S sheet-stall baseline (sim pass only). ~~On three P45B cells and the 12 V STS3215, a 0.15 m/s command on the old policy walks about 0.088 m/s typical and 0.084 m/s high-side, with no fall in 60 s (sim pass only, problems/FIT3.md).~~ Superseded 2026-11-12 9:55 PM ET by run C (problems/retrain_sts12/SUMMARY.md, sim pass only): 60 s, no fall on both corners, up to 0.252 m/s typical at a 0.40 m/s command, no flight phase, still at a 0.10 m/s command. Pack peak 15.6 A is a watch item. Knee minimum 9.31 V (sim pass only). The old numbers stay in FIT3.

| Problem | Source | Severity | What fixes it | Owner | Status |
|---|---|---|---|---|---|
| 1. With the sheet-stall servo the walk falls at 3.4 s to 3.6 s. The no-fall walk used the trained 3.23 Nm actuator. | twin/electromech/ELECTROMECH_TWIN.md, problems/STALL.md | critical | Not a new servo. The 7.4 V stall already matches the sheet (1.912 Nm, calc only against the cited line). Flat 7.4 V does not fall in 20 s (sim pass only). The as-built bus pulls the knees to 5.79 V (typical) and 5.24 V (high-side). A slower command, a trained gain, and the free bus changes in problems/BUS_SAG.md were sim-tested. None of them walk 20 s on both corners. The 1.6 V dip below 7.4 V is the 17.9 A pack peak, not the 5 A chain (problems/VOLTAGE_BUDGET.md). A 12 V ST-3215-C018 on three P45B cells holds 20 s on both corners (problems/STS12.md, sim pass only). The two-cell pocket does not fit a third cell. A 12.4 mm rear blister does, with no screw moved, and the 70 g cell still holds 60 s (problems/FIT3.md). The 3S contact window is 13.6 V to 16.0 V on the same mat (problems/NEST3.md). The 9.5 A sample is a few milliseconds under the 13 A trip. Ahmed asked to start the retrain. The config is problems/TRAIN_STS12.md. A CPU smoke is not a gait. A full run does not fit this machine, and nothing was bought. Bench stall is TEST_PLAN.md 7.5 and 15. | twin/electromech and twin/knee | OPEN. Reproduced. Number one. |
| 2. The flush-box dock count is not a pin hit, and a moved nest does not move that count. | altaay_lab/redteam/REDTEAM.md finding 2, twin/dock/blind/BLIND_WALK.md, twin/dock/closeup/CLOSEUP.md | critical | Stop quoting 380, 531, or 533 as a charge rate. The old pin rule is already the nest's own test (35 of 540 blind, sim pass only). Do not adopt the wall card. D61 already refused marks. The finder is TEST_PLAN.md 20.9, NOT RUN. | twin/dock/closeup, twin/dock/nest/sim, twin/camera | OPEN |
| 3. A 7 mm edge, a soft mat, and a stair are not the two 1 mm steps. | REDTEAM.md finding 3, twin/dock/nest/superseded_feet_dock_d58/feet/deep/DEEP_ANALYSIS.md, twin/sit/getup/VIA_SIT_EVAL.md | high | Do not quote the 1 mm run as a home floor. The feet study already has 0 of 6 crossed on a 7 mm edge and 20 of 20 fell on a 2 mm mat over a 5 mm sink (sim pass only). The cliff check is already in TEST_PLAN.md. Get-up still misses 48 front rests (sim pass only). Retrain stays NOT RUN. | twin/dock/nest/sim, twin/freeze, twin/sit | OPEN |
| 4. The print that will be made misses the margin, and the design-curve life is under an hour. | REDTEAM.md finding 4, twin/structure/shin_eye/SHIN_EYE.md, twin/structure/STRUCTURE_TWIN.md | high | Do not copy the web STL into print/. The dry coupon at about 60 C is already named. Fatigue on the cited design curve is 0.02 to 0.5 h at the knee eye (FEA pass only). The best-case bound still exists. Which bound this filament is on is BLOCKER. The rig is proposal P7 in the structure twin. | twin/structure | OPEN |
| 5. A walk leaves 60 C. The cell temperature stop is not in the netlist. The 2S linear charger crosses 150 C if 1 A is forced. | REDTEAM.md finding 5, twin/thermal/KNEE_HEAT_STUDY.md, twin/thermal/BQ24133_HEAT.md, twin/thermal/CHARGE_WATTS.md, circuitry/CHARGER_BOARD.md, wiring/netlist.yaml, circuitry/SERVO_RAIL.md | high | Do not quote 94.7 C. Continuous walking still leaves 60 C inside about 8 minutes (calc only and sim pass only, the heat study). The unfixed dock still feeds the servo bus at about 14.7 V, outside the 4 V to 14 V C018 page. The pick holds the Pololu 2815 off while docked and end-charge is low, so that rail is 0 V (circuitry/SERVO_RAIL.md, BQ24133_HEAT.md). The ON pin input current is BLOCKER. A sheet backdrive torque is not printed, so the limp seat staying down is BLOCKER (twin/sit/RAIL_OFF_SIT.md). The Pi typical, if it stays on the pack, is 0.143 A and blocks the 0.10 A termination (calc only, circuitry/AWAKE_LOAD.md). Die figures that put the whole converter loss on 35.7 C/W are upper bounds. The 2.50 A crossing of 120 C is not confirmed. Switching loss inside the die is BLOCKER. The 2.30 W and 3.50 W sit in CHARGE_WATTS.md is the MCP73213 2S record (sim pass only): hottest cell 42.99 C, hottest wall 37.91 C. For a 2S pack, a current limit that stays under 150 C misses the 6 hour timer, and the sheet does not cite a pour down to 33.7 C/W. The same BQ24133 with CELL floating is the 2S fix that still charges at 1.00 A. GPIO5 and GPIO6 are not in the netlist. The MCP73213 has no THERM pin (cited). In-trunk theta stays BLOCKER. The seat still does not exist. | twin/thermal, circuitry, wiring | OPEN |

The checklist rows below are the same gate. Row 1 above is the electromechanical row, ranked first. The fold-back calc and the baseline note stay in this folder. They are not ahead of the stall fall.

Severity is the checklist word where the row is a checklist row. "note" is a document mismatch. "calc" is arithmetic on files that already exist.

| Problem | Source | Severity | What fixes it | Owner | Status |
|---|---|---|---|---|---|
| Printed parts miss the lab margin. The recessed web in PA6-CF is walk 2.85 and soft worst 1.61 at 0.75 mm (FEA pass only) and is not in print/. Hot and wet tensile, and the printer chamber, are BLOCKER. | twin/structure/shin_eye/SHIN_EYE.md, TWIN_CHECKLIST.md structure | FAIL | The dry coupon at about 60 C already named in that shin note, after Ahmed says yes. Do not copy the web STL into print/ before that. | twin/structure | OPEN. No new shape was drawn here. |
| A continuous walk still leaves the 60 C servo line. The 55 C guard is a software stop in unit tests. | twin/thermal/KNEE_HEAT_STUDY.md | FAIL | Torque-off rests, already the no-spend limit in that study. The STS3250 one-unit heat test is TEST_PLAN.md 7.3. | twin/thermal | OPEN |
| Sheet-stall walk falls at about 3.5 s on the P45B pack (sim pass only). This pass reproduced it: 3.56 s, 3.42 s, 3.56 s (sim pass only, problems/STALL.md). | twin/electromech/ELECTROMECH_TWIN.md, problems/STALL.md | FAIL | Same as ranked row 1. Bench stall is TEST_PLAN.md 7.5 and 15. The retrain needs Ahmed's OK. | twin/electromech, twin/knee | OPEN. Ranked first. |
| Walk current is the P45B loop. Fall traces are not in this repo. The charger sheet is not in the netlist. | twin/electrical/ELECTRICAL_TWIN.md, wiring/netlist.yaml | FAIL | Put the existing charger yaml into the netlist after the seat exists, then re-run the electrical twin. The trace replay waits on traces that are not here: BLOCKER. | twin/electrical, wiring | OPEN |
| The opened cell fits the bay. The weld has no part number. The P45B pages that were opened were out of stock. | twin/battery/BAY.md, PARTS_AUDIT.md | FAIL | Source the weld, line 7, already named NOT ORDERABLE. A live in-stock page for the cell. | twin/battery | BLOCKER until a page can sell the cell and the weld has a part number |
| The installed print set meets D39 and D42 as a CAD check. The nest, the flush wells, and the topology pads are not in that set. | twin/holes/HOLES_TWIN.md, twin/assembly/BUILD_ORDER.md | GAP | Re-run the existing hole audit when the nest is installed. No new screw. | twin/screws, twin/assembly, twin/holes | OPEN. fasteners/ was not touched. |
| Get-up misses 48 of 296 down-ramp front rests (sim pass only). Unpowered friction is not on the sheet. | twin/sit/getup/VIA_SIT_EVAL.md | FAIL | Keep the misses on the retrain list. Measure friction at TEST_PLAN.md 19.5 and put that number back into the existing sim. | twin/sit | OPEN. The retrain is the training row, and it needs Ahmed's OK before any GPU. |
| The STS3250 sheet is open. The 1.2 ohm line and the stall current disagree (calc only, 2.86 ohm). The stock policy falls in sim. | twin/knee/KNEE_TWIN.md, twin/thermal/KNEE_HEAT_STUDY.md | FAIL | Resolve the two ohm lines from the opened sheet or from the bench BAM test already in TEST_PLAN.md 15. Do not walk the stock policy as the shipping gait. | twin/knee | OPEN |
| Seats are in the CAD. There is no behavior twin of touch, cliff, or hearing. | twin/freeze/FREEZE.md | GAP | A perception twin that includes the cliff and the mics, which the checklist already asks for. The VL53L4CD sheet was not opened (PARTS_AUDIT.md). | twin/freeze | OPEN |
| The head camera field is on the measured seat. The nest, the flush wells, and the charger board are not in the viewer or the print set. | twin/complete3d/COMPLETE3D.md | GAP | Install the existing nest CAD only after a page can sell the pin and the owner has approved the look. Already the next step in that row. | twin/complete3d | OPEN |
| Nest sequence sims exist. The CAD is not installed. Those runs are a rigid mat and a pose stand-in. | twin/dock/nest/sim/v3/NEST_SIM_V3.md, twin/dock/nest/cad/NEST_CAD.md | FAIL | The blind walk and the wall card are now separate studies (rows below). They do not install the CAD and they do not pass this row. | twin/dock/nest | OPEN |
| No model finds the nest. The field is drawn. Room light is BLOCKER. | twin/camera/CAMERA_TWIN.md | GAP | A perception twin on frames, scored the way TEST_PLAN.md 20.9 is already written. | twin/camera | OPEN |
| No felt grade. The nest sim mat in the older runs is rigid. Sole friction on felt is BLOCKER. | twin/contact/CONTACT_TWIN.md | GAP | The coupon already in TEST_PLAN.md 20.6, after Ahmed says yes. The combined run below reuses an existing soft contact. It does not name a grade. | twin/contact | OPEN. Grade stays BLOCKER. |
| Contact resistance on cloth was not measured. The proposed probe has no in-stock page that was opened. | twin/contact/CONTACT_TWIN.md, PARTS_AUDIT.md | NOT RUN | TEST_PLAN.md 20.1 to 20.4, a few pins and scraps, after Ahmed says yes. | twin/contact | BLOCKER awaiting Ahmed's OK. Nothing was bought. |
| Sit stops are in the limit file. Older sim ranges still ask for angles the printed parts cannot reach. | software/servo_limits.json, twin/sit/getup/GETUP_SIT.md | FAIL | One limits table, generated from the CAD contacts, already the next step in the checklist. Bench check is TEST_PLAN.md 19.1. | software, twin/sit | OPEN |
| A one-click of today's bill buys the wrong duck. The probe, the felt, the cloth pair, the weld, and the charger part are not a matched bill. | PARTS_AUDIT.md, BOM.md | FAIL | Do not place the order. Add lines only when a page can sell them. BOM.md was not edited. | the bill files. bom/order/ was not touched. | OPEN |
| Two beads were opened and do not close line E3. There is no light model. | software/SOFTWARE.md section 12 | GAP | Give line E3 a real catalog part that fits the existing eye, or keep the lamp as the named gap. Do not add colour eyes. | software | OPEN |
| The cone is on the seat. The recorded sit sees none of the cloth. A person is not in the file. TEST_PLAN.md 20.9 is not run. | twin/camera/CAMERA_TWIN.md | FAIL | Put a person into the existing cone file, then score frames the way TEST_PLAN.md 20.9 is written. The blind walk now exists and does not pass this row. | twin/camera | OPEN |
| The link table exists. Several latencies are unpublished. Nothing in the table was measured on a Pi. | software/SOFTWARE.md section 11 | FAIL | Leave unpublished times as BLOCKER. Measure them on the Pi, or derive them from byte timing, which that section already allows for the servo bus. | software | OPEN. The servo-bus 3.18 ms is calc only and is not a Pi measurement. |
| The MCP73213 board is drawn beside the netlist. It is not in the netlist, and it has no seat. | circuitry/CHARGER_BOARD.md | FAIL | Merge the existing charger yaml into the netlist only after the seat exists and the unopened parts are read. Already the next step in that file. | circuitry | OPEN. The fold-back question is a separate row and is answered as a calc. |
| Nest vision, charge control, and updates have no file. The 55 C guard exists as unit tests. | software/SOFTWARE.md section 10 | GAP | Write nest vision only after the camera row has frames. Write the charge program only after the charger is in the netlist. Keep the Runtime unmodified. | software | OPEN |
| No GPU policy run. The nest v3 file is a stock-policy sim, not a trained policy. | TWIN_CHECKLIST.md training, COMPLETE_DUCK_AUDIT.md | NOT RUN | Do not start a paid run. The scope is already in COMPLETE_DUCK_AUDIT.md and needs Ahmed's OK. | the training note in COMPLETE_DUCK_AUDIT.md | BLOCKER awaiting Ahmed's OK |
| Blind walk, flush window: first sit 380 of 540, within 3 sits 383 of 540, 0 falls, at 190 mm (sim pass only). Old pins are 35 and 43. | twin/dock/blind/BLIND_WALK.md | FAIL | Not a new controller. The wall-card study already run is the change that study recommends. This row does not pass the nest row. | twin/dock/blind | OPEN. Measured. |
| Wall card: first sit 533 of 540, 1 fall (sim pass only). It is a mark. D61 was not edited. | twin/dock/closeup/CLOSEUP.md | FAIL | Ahmed has not accepted the mark. Do not install it from this folder. The combined run below only scores the card that study already drew. | twin/dock/closeup | OPEN |
| PR 47's first baseline row said 1 fall and 386 within 3 sits. The merged blind file is 0 falls and 383. | history/2026-11-12_1643_closeup_sight.md, twin/dock/blind/BLIND_WALK.md | note | problems/BASELINE_NOTE.md. The merged run file was scored again. The two counts are two files of one study. | problems | CLOSED as a note. No walk was re-run for this row. |
| Whether a folded-back charge of 4.5 Ah finishes inside the 6 hour timer. | circuitry/CHARGER_BOARD.md | calc | problems/FOLDBACK.md, on the existing chip and the existing cell figure. No new board. | problems for the calc. circuitry owns the board. | The 13 h line is not the trajectory. On the sheet's 62 C/W board the walk-stop long estimate is 5.88 h, inside 6.6 h and past 5.4 h (calc only). The 5.4 h minimum is not shown. In-trunk theta stays BLOCKER. |
| The charger note still assumes four spring pins, a disc, and a ring. | circuitry/CHARGER_BOARD.md, circuitry/charger_board.yaml | note | problems/FLUSH_NOTE.md points at the flush study that already exists. The charger file was not edited and no new contact was drawn. | circuitry owns the charger file. twin/dock/flush owns the flush study. | OPEN as a file edit for that owner. The pointer is written. |
| Wall card, nest CAD, and a soft contact have not been in one blind dock. | twin/dock/closeup/close_run.py, twin/dock/nest/cad/nestcad_lib.py, the feet harness soft contact | FAIL | problems/dock_sim.py stacks those three existing pieces and scores the flush window. It does not pass the nest row. | problems | See DOCK_SIM.md. |
