aaltaay/Open_Duck_Mini_v2/altaay_lab/history/2026-11-12_2141_merge_batch.md

# Merge batch into altaay-lab

2026-11-12 9:41 PM ET. Ahmed said at 9:25 PM ET to review and merge the open lab PRs, and at 9:27 PM ET to cross through conflicting information after the merges.

Merged with merge commits, oldest first: 49, 59, 60, 64, 65, 66, 67, 69, 70, 71, 72, 73, 74, 75. PR 52 was already merged. PR 76 was already contained in the PR 75 merge and GitHub closed it as merged. PR 77 merged after the stack. Branches were not deleted and history was not rewritten.

Conflicts resolved by merging altaay-lab into the branch: PR 64 (ORDER.csv, kept the priced rows and the netlist refs), PR 69 (TWIN_CHECKLIST.md, D62 stays recorded), PR 73, PR 74, and PR 75 (PROBLEMS.md). PR 76 was merged into the PR 75 branch before PR 75 merged. PR 77 conflicted on ORDER.csv; the in-stock solder and the priced PLA stayed, and the charger board kept the netlist ref.

c9_docs.py stayed PASS (0 FAIL, the existing WARNs) after each of those merges.
