aaltaay/Open_Duck_Mini_v2/altaay_lab/history/2026-11-12_2145_consistency.md

# Consistency pass after the merge batch

2026-11-12 9:45 PM ET. One current duck, with superseded lines left in place. DECISIONS.md D61 was not edited.

- Pack is three P45B cells. The MCP73213 file is the 2S record. The charger to build is the BQ24133. Nest supply is 15.0 V. The docked servo rail is circuitry/SERVO_RAIL.md.
- Nest v2 is D62. Spring pins stay as the superseded drawing.
- Fitted screws 310, builder-turned 254 (CAD check only). Not installed.
- The 2S fall at 3.46 to 3.56 seconds and the BEC case at 109 C and 117 C in twin/life/LIFE.md are the superseded 2S gait. On 3S the old policy walks about 0.088 m/s typical with no fall in 60 s (sim pass only, problems/FIT3.md). No 3S BEC case temperature was run (BLOCKER).
- Buy-today total is $1195.44 (calc only, bom/order/ORDER.md) after the third cell. The earlier $839.60 and $1186.45 are superseded. BOM.md totals are a different rollup. The servo line is still the 7.4 V part.
- Domestic share on the updated order is 5.28 percent (calc only, compliance/domestic_share.py). The 6.07 percent is superseded. Not legal advice.
- The bead pin RT1.1 is on NTC_MID only. The old SENSE tap JSN.S to RT1.1 is status superseded in the netlist, WIRES.md, and cables3d.json. The points were not deleted. ERC is 0 ERROR.
