aaltaay/Open_Duck_Mini_v2/altaay_lab/history/2026-11-12_1913_sts12_train.md

# 2026-11-12 7:13 PM ET: 12 V training config, CPU smoke only

Labels: calc only for the actuator, the bus voltage, and the hour estimate. Sim pass only for the smoke. Cited for the sheet, the 4090 hour note, and the GPU prices. Nothing was bought.

- Config in problems/TRAIN_STS12.md. Playground runner at b9be205, backlash scene, 150,000,000 steps, 8,192 envs. Not run at that size.
- Bus at the sheet no-load current, 0.180 A, charge 0: lowest port 11.692 V. Torque limit 2.8665 Nm. Trunk 1.0654 kg to 1.1354 kg with the 70 g cell.
- Smoke: 8 envs, 480 steps, 618.2 s wall, 1.147 steps/s after the first eval. Rewards 16.03, 16.99, 15.33, 13.17. Not a gait.
- 150,000,000 steps at that rate is 36,327 hours (calc only). No GPU on this machine. A 4090 run of that length is cited at 1.5 to 3 hours, about $0.20 to $2.67 at the three prices in the config note. Not started.
