aaltaay/Open_Duck_Mini_v2/altaay_lab/history/2026-11-12_1851_nest3.md

# 2026-11-12 6:51 PM ET: 3S nest window on the same mat

Cited or calc only for the window and the spacing. Sim pass only for the 9 A count. Nothing was bought. No retrain.

- The mat stays. Supply 15.0 V, SMAJ16A, window above 13.6 V and at or under 16.0 V. The 5 mm gap is 50 times the 0.10 mm board spacing at 16 to 30 V. 15 V is under the 60 V DC ES1 figure.
- The 9.534 A peak is 32 samples, longest run 6 ms, and it stays under the 13 A trip. The 9 A line is the continuous rating. The minute sits at 3.6 A to 5.1 A.
- Fourteen Waveshare 12 V servos, SKU 22414, at $20.63 are $22.82 more than fourteen at the bill's $19.00.
- A retrain was not run. The slow sheet costs this policy 0.034 m/s against the trained no-load speed. That is the gap, not a retrained result.
