aaltaay/Open_Duck_Mini_v2/altaay_lab/history/2026-11-12_1845_fit3.md

# 2026-11-12 6:45 PM ET: third cell mass, 60 s, and a rear blister

Labels: sim pass only for the walks. CAD check only for the blister. Calc only for the speed ratio and the sleeve pitch. Cited for the sheet, the cell, the BQ24133, and the Tenergy 32007. Nothing was bought. The nest stays the striped felt mat.

- The voltage budget is already in problems/VOLTAGE_BUDGET.md. Peak bus current 15.147 A. Holder, fuse, XT30, dropout, and the efficiency are the volts with no measured part. Zeroing them still falls.
- With 70 g at the rear cell, a 0.15 m/s command holds 60 s on both corners. Body speed 0.088 m/s and 0.084 m/s. Commanding that 0.088 m/s makes 0.016 m/s and 0.017 m/s.
- The same mass with the trained no-load speed walks at 0.122 m/s. The 12 V sheet is 0.835 of that speed. The damping is why the body is near 0.09 m/s.
- A 2.5 mm blister 12.36 mm behind the shell fits the third sleeve. No screw within 30 mm. The print file was not changed.
- The nest window stays 8.70 V to 10.0 V. A 12.6 V charge does not sit in it. The BQ24133 regulates 12.6 V and wants about 13.6 V to 17 V in.
