aaltaay/Open_Duck_Mini_v2/altaay_lab/history/2026-11-12_1850_blister_caps.md

# 2026-11-12 6:50 PM ET: blister caps

CAD check only. The rear blister's outer cylinder now extends 2.5 mm past the cut at both ends. Rays through the part that sticks out past the old shell read 2.5 mm of plastic above and below. The back still moves 12.36 mm. Volume after the cut is 83502.9 mm3. No screw moved. The print file was not changed.
