aaltaay/Open_Duck_Mini_v2/altaay_lab/history/2026-11-12_1835_domestic_content.md

# 2026-11-12 6:35 PM ET: domestic component share

The content prong in the FCC FAQ for DA 26-786 is manufacture in the United States and domestic components above 65 percent through 2028. The FAQ says the off-the-shelf waiver does not apply. On the priced lines the domestic share is 6.07 percent (calc only). The smallest set of current lines that clears that gap is seven, led by the 14 Chinese servos. A US motor price for a matching actuator was not printed. Nothing was bought. No one was contacted. This is not legal advice.
