aaltaay/Open_Duck_Mini_v2/altaay_lab/history/2026-11-12_1848_duck_wells.md

# 2026-11-12 6:48 PM ET: seat wells stay on the duck worksheet

The Codex review on the domestic-share note said the five gold seat wells and the duck-side ideal-diode paths are parts of the duck, not nest exclusions. Both rows are components again. Neither has a price, so both stay BLOCKER and the 6.07 percent share is unchanged. Nothing was bought. No one was contacted.
