aaltaay/Open_Duck_Mini_v2/altaay_lab/history/2026-11-12_1920_twin_checklist_before_prs_45_66.md

# Checklist wording before the PR 45 to 66 refresh

This is TWIN_CHECKLIST.md as it stood after the shin-eye update and before the 2026-11-12 refresh for PRs 45 to 66. The pass lines in the live file were not changed. The live file is TWIN_CHECKLIST.md.

# TWIN CHECKLIST: gate 0

Written 2026-11-11 ET. Updated 2026-11-12 ET after PRs 34 to 43 merged, and again the same day for the structure row (history/2026-11-12_0906_shin_eye_margin.md). The pass line of each row is unchanged. A row below is the reading of the merged files on that date. The 2026-11-11 wording is in the history file for this update.

Gate 0 passes only when every row below is PASS and the rows describe one duck. A sim pass only, a calc only,
or a CAD check only result is evidence. It is not a PASS of the row. An FEA pass only result is the same kind of evidence.

The duck is not printed, the pack is not welded, and the full order is not placed before this checklist is all PASS. Today it is not.

Characterization coupons are allowed, and only after Ahmed says yes. A row that needs a measurement names the coupon. For the pins that is TEST_PLAN.md 20.1 to 20.4: a few pins, a scrap of cloth, and a scrap of felt. No whole duck. The coupon is not the product and it is not the one-click bill. It exists so a guess in this list can be replaced by a measurement.

How to update a row: change the status word, the labeled result, the guess, and the next action together.
Leave the old wording in a new history file. Do not edit this file's history by silent overwrite of a result
that was wrong; write the new result in the row and say what changed.

Status words, only these:

- PASS: the pass criterion is met for the duck that will be built.
- FAIL: a run or a check exists, and it does not meet the criterion.
- NOT RUN: the check is defined and has not been executed.
- GAP: the model, the part, or the file that would hold the check does not exist yet.

## Summary

| Twin | Status | In one line |
|---|---|---|
| Structure | FAIL | At the 0.75 mm voxel pitch the stock eye walk is 0.80, and the recessed web in PA6-CF is 2.85 and soft 1.61 (FEA pass only). Not in print/. Hot, wet, and the printer are BLOCKER. |
| Thermal | FAIL | A docked charge stays inside the cell, servo, and PLA windows. A continuous walk still leaves 60 C. |
| Electromechanical | FAIL | The P45B pack is in the loop. The sheet-stall servo falls. Later merges did not re-run this loop. |
| Electrical and wiring | FAIL | Walk current is the P45B loop. Fall traces are not in this repo. The charger sheet is open and is not in the netlist. |
| Battery | FAIL | The opened cell is in the electromechanical loop. The weld still has no part number. The P45B pages that were opened were out of stock. |
| Screws and assembly | GAP | The installed print set meets D39 and D42 as a CAD check. The nest, the flush wells, and the topology pads are not in that set. |
| Sit and get-up | FAIL | The sit is in the CAD. Get-up still misses the down-ramp front rests. Friction is not a datasheet value. |
| Knee | FAIL | The STS3250 sheet is open. The stock policy still falls in sim. A 32 C case in that model is over 60 C. |
| Freeze | GAP | Seats are in the CAD. There is no behavior twin of touch, cliff, or hearing. |
| Complete 3D and CAD | GAP | The head camera field is on the measured seat. The nest is not in the viewer or the print set. |
| Nest dock | FAIL | A stepped-mat sim exists. The CAD is not installed. The camera, the felt, and the blind sit are not in that run. |
| Camera and perception | GAP | The field is drawn. No model finds the nest. |
| Felt and cloth | GAP | No felt grade. The nest sim mat is still rigid. |
| Pin contact | NOT RUN | A calc loop exists. Contact resistance on cloth was not measured. |
| Servo angle limits vs CAD | FAIL | Sit stops are in the limit file. The old sim ranges still do not match the printed contacts. |
| One-click bill vs the twin | FAIL | The probe has a catalog number and no in-stock US page. A one-click of today's bill is still the wrong duck. |
| Lights | GAP | Two beads were opened and do not close line E3. There is no light model. |
| Field of view | FAIL | The cone is on the seat. The recorded sit sees none of the cloth. A person is not in the file. TEST_PLAN.md 20.9 is not run. |
| Communications | FAIL | The link table exists. Several latencies are unpublished. Nothing in that table was measured on a Pi. |
| Circuitry | FAIL | The MCP73213 board is drawn beside the netlist. It is not in the netlist, and it has no seat. |
| Software | GAP | The program list and the 55 C guard exist. Nest vision, charge control, and updates do not. |
| Training | NOT RUN | No GPU policy run. The nest v3 file is a stock-policy sim, not a trained policy. |

## Structure (twin/structure)

- Pass: every printed part that carries a walking, push, or fall load holds the lab margin (2 walking, 1.2 in a fall), with the nest's extra mass and the sit stops included, and the material numbers come from a datasheet or a coupon.
- Status: FAIL.
- Result: what changed is twin/structure/shin_eye/SHIN_EYE.md. It does not replace the topology pass and it does not install anything into print/. The 0.58 walk was the stock eye at a 0.8 mm voxel pitch. Re-run at 0.75 mm, the fine end of the topology pitch band, on the same scripts and the same shin supports: stock walk 0.80 and soft worst 0.47 (the topology file's 0.79 and 0.46), and the collar walk 1.30 (FEA pass only). Walk knee peaks match under MuJoCo 3.17.0 and 4.0.1. The 2026-11-03 figure is TetGen on the older shin plate, walk 1.56 to 1.63, not 0.79. PETG, PLA-CF, and ASA miss on every shape (cited allowables, FEA pass only). PA6-CF on the stock eye is 1.26 and 0.92 at 0.8 mm. A head-side web with a 5.8 mm head recess, so the existing M3x6 still fits, in PA6-CF with the drive sheet at 4430 MPa, at 0.75 mm: walk 2.85, push 2.48, soft worst 1.61, 0 of 9 under 1.2 (FEA pass only). The lab printer is not known, so a hardened nozzle and a 45 to 60 C chamber are BLOCKER. The idle sheet in PLA is 1.70 and 0.80, so it has to be PA6-CF too (3.69 and 1.73 on the stock idle geometry, FEA pass only). The spacer does not govern. Bunting FFM003006010 does not fit the eye (CAD check only). A heat-set insert cannot take the horn screw. No new screw (D39, D42 unchanged). Slicer: the recessed web is 15.43 g and 1.74 h per part against 10.38 g and 1.09 h. Hot PLA tensile at 55 to 63 C is BLOCKER (Grasso 2018 did not report 50 C or 60 C tensile). PA6-CF tensile at that band, and wet tensile, are BLOCKER. The topology margins for the other parts are unchanged: roll_to_pitch walk 2.41, neck 11.85, head 52.49, foot 3.86, hip roll stage 16.74, thigh 1.71, and the soft falls under 1.2 on roll, shin, thigh, neck, and head in that file. Nest mass is not in this model. D26 is still open.
- Guess: contact stiffness is a range, not a measurement. Hot tensile and wet tensile of PA6-CF are BLOCKER. Whether the lab printer has a hardened nozzle and a chamber is BLOCKER. The web STL is a proposal. It is not the duck in print/.
- Next: do not copy the web STL into print/ while hot and wet tensile are BLOCKER. A dry coupon of this sheet at about 60 C has to replace those two. Do not leave the idle sheet in PLA. Do not treat the foot carve as a mass saving. Re-run after the nest mass is in the same model, and only after D26 is decided.

## Thermal (twin/thermal)

- Pass: the heat model is the duck that will be built, including the charger inside the body (D61), the P45B cells, and the STS3250 knees, and the temperatures stay inside the datasheets (servo operating range, cell charge window, PLA).
- Status: FAIL.
- Result: sim pass only for the model run, calc only for the hand check in twin/thermal/KNEE_HEAT_STUDY.md. The sit numbers are unchanged: cells, servo readings, and the trunk wall stay inside their windows during a docked charge. The walk is still the trained actuator, not the sheet-stall servo. The right knee reading crosses 60 C at 3.22 minutes in a 25 C room on that log (the published 3.3 minutes is the next 10 second sample). With the sheet's torque-off left on, the case peaks near 64 C. The 94.7 C body is the same run with the torque-off switched off and with copper resistance rising at a frozen current. That 94.7 C is OVERSTATED as a temperature the knee would reach. The 3.3 minutes is the short end: cold resistance gives 4.6 minutes, and the plain walk's published copper gives about 6 to 8 minutes. Continuous walking in this model still leaves 60 C inside about 8 minutes. The case at the torque-off is still in the PLA softening band. PR 37 did not change those temperatures. software/knee_heat.py stops a walk on two readings at or above 55 C and turns torque off while idle or sitting. Those checks are unit tests with no hardware (software/SOFTWARE.md section 5). The heat study's own rest arithmetic, calc only, holds the reading at 55 C by resting, and it does not make a continuous walk legal. twin/thermal/EFFICIENCY.md records BEC efficiency 0.85 as an assumption. Castle publishes none. That 0.85 is BLOCKER until a bench log replaces it.
- Guess: cell specific heat is the old 18650 range, not on the P45B sheet. Half the can faces the bay air. The charger is not a seated part. Walk friction heat is not in the session bins (that omission cools the knee by about 0.2 minutes). The sensor share and the winding heat capacity are still a GUESS. STS3250 knees are not in this thermal run. The fixed-current resistance rise overstates the late temperature. The operating range is -20 C to 60 C, and item 7-11 still turns torque off above 70 C.
- Next: do not quote 94.7 C as the knee the duck will build. Do not treat a continuous walk as inside the 60 C range. The 55 C guard is a software stop on a simulated reading, not a pass of this row. Torque-off rests are the no-spend limit. The STS3250 sheet is opened in KNEE_HEAT_STUDY.md. The swap still needs a one-unit heat test and a retrain. TEST_PLAN.md 7.3 still measures the servo.

## Electromechanical (twin/electromech)

- Pass: one closed loop of the walk, the 14 servos, and the as-built power path, using the servo torque and speed from the datasheet and the P45B pack, matches the duck that will be built across the battery range.
- Status: FAIL.
- Result: sim pass only, ELECTROMECH_TWIN.md update, out/p45b_sheet/. PRs 34 to 43 did not re-run this loop. The pack is the P45B figure (version 1.2). With the sheet stall (19.5 kg.cm at 7.4 V) on the as-built bus, the backlash walk falls at 3.52 s (typical) and 3.46 s (high-side), and the plain walk at 3.56 s. From 4 s to 20 s the speed is about 0.04 of the command. The same sheet model held at a flat 7.4 V does not fall in 20 s and walks at 0.64 of the command. With the trained actuator and the P45B pack, no fall in the state runs or in two sessions. Full charge, typical: pack 8.17 V at 5.30 A mean (5.61 A RMS, 10.5 A peak), sag 0.18 V from an 8.35 V open circuit. Nominal: 7.21 V at 5.33 A, speed 0.69 of the command. The typical session reaches an open circuit of 3.30 V per cell at 42.9 minutes, the walk drops under 85 percent of its full-charge speed at 25.7 minutes, and the guard walk stop is at 34.5 minutes (29.5 minutes high-side). Those trained-actuator numbers are not the sheet-stall duck. The 2026-11-03 no-fall line is the P30B run.
- Guess: sheet damping and friction are the training values scaled with the stall (no-load speed 5.65 against 5.45 rad/s at 7.4 V, inside the sheet's +/-10 percent). Armature is the training 0.027 kg m2. The position gain is the trained gain scaled with the stall; the sheet does not publish it. Whether the firmware holds stiffness as the bus falls is unknown (TEST_PLAN.md 7.5). The 0 mAh end of the discharge figure is extended back to the axis. The figure slope is 13 mOhm at an open circuit of 3.70 V; the sheet's DC pulse is 15 mOhm at 50 percent SOC.
- Next: do not quote the trained-actuator walk as the servo that will be bought. The sheet stall on the as-built bus falls. A bench stall and a gain measurement come before another closed-loop claim.

## Electrical and wiring (twin/electrical, wiring/netlist.yaml)

- Pass: the netlist is the duck that will be built. D50's four dock nets are two. The charger is in the duck. The safety gate is a real circuit. The electrical twin has been re-run on that netlist, and it does not show a BMS trip or an over-voltage the design cannot live with.
- Status: FAIL.
- Result: the walk pack current, sag, and run time are the electromechanical P45B loop (sim pass only): 5.30 A mean and 8.17 V at a full charge, sag 0.18 V, 42.9 minutes to an open circuit of 3.30 V per cell with the trained actuator and no fall. The sheet-stall servo on that network falls at 3.5 s. bus_events.py now points at the P45B figure and the sheet stall line. The fall and get-up traces are not in this repo, so that replay was not re-run: BLOCKER. Do not quote the 2026-11-04 shove current as the P45B duck. The nest two-net change is not in wiring/netlist.yaml. PR 40 opened the MCP73213 sheet (circuitry/CHARGER_BOARD.md, cited, DS20002190C). Dropout in that table is the 0.3 V headroom: specs apply from 8.70 V for the 8.40 V option. The 6 hour timer on the A6S option is 5.4 to 6.6 h (cited). That board file does not edit wiring/netlist.yaml, and the electrical twin was not re-run on it.
- Guess: Tenergy short-circuit delay is unpublished. BEC input capacitance is unpublished. The two-wire gate has no parts yet. In-trunk thermal resistance of the charger die is BLOCKER (CHARGER_BOARD.md).
- Next: the event replay waits on the traces. Put the charger board and the two nest nets into wiring/netlist.yaml, then re-run the electrical twin, before calling this row the nest.

## Battery (twin/battery)

- Pass: the cell, the bay, the weld, and the charge path in the twin are the parts that will be ordered, at the size on the opened cell sheet, and the other twins use that same pack.
- Status: FAIL.
- Result: the DeWalt pack was rejected (sim pass only, calc only, CAD check only, twin/battery/BATTERY_STUDY.md). The bay was redrawn for two Molicel P45B cells (twin/battery/BAY.md, CAD check only). The viewer draws the cells at the nominal 21.4 by 70 mm. The sheet opened for PARTS_AUDIT.md (version 1.2) gives 21.55 mm and 70.15 mm as maximums. That is the top of the 21.40 plus or minus 0.15 mm by 70.00 plus or minus 0.15 mm band this bay already used. The sleeved pack is 22.2 by 43.7 by 71.0 mm (CAD check only, twin/battery/bay_edit.py), so the cell maximum fits. Typical capacity 4500 mAh and DC resistance 15 mOhm at 50 percent SOC match the sheet. The electromechanical twin now runs that figure (see that row). The sheet-stall walk falls. The trained-actuator session uses this pack and is not the sheet-stall duck. The parts session on 2026-11-11 ET reopened two P45B pages and both were out of stock (PARTS_AUDIT.md, cited from those pages). Line 7, the weld, still has no part number (NOT ORDERABLE, BLOCKER).
- Guess: weld, sleeve, and fish-paper resistance are not modeled. The discharge figure was read to about 15 mV. The 0 mAh end of that figure is extended back to the axis.
- Next: do not resize the bay for this sheet. Source the weld (line 7) before calling the pack a part. Do not treat the trained-actuator session as the servo that will be bought. A one-click cannot buy the cell until a live page shows it in stock.

## Screws and assembly (twin/screws, twin/assembly, D39, D42)

- Pass: one fastener schedule and one assembly order cover the duck that will be built, including the nest. Every hole has a screw or is closed (D39). Every screw group is a uniform pattern (D42). A second person can build from the order.
- Status: GAP.
- Result: the installed print set was audited, CAD check only. After D42, 88 parts and 133 part pairs are uniform (twin/holes/HOLES_TWIN.md). Two plug ends stay off a perfect flush and are explained there. Assembly reach of the driven screws is in twin/assembly/BUILD_ORDER.md (CAD check only). The nest CAD is not in that schedule. The flush wells (twin/dock/flush/FLUSH_CONTACTS.md) and the topology pads (twin/structure/TOPOLOGY.md) are not in that schedule either. Insert pull-out time and strength are still a BLOCKER in the screws twin. The topology pass ray-checked the horn screw holes on its own STLs and did not add a screw (TOPOLOGY.md, CAD check only). That check is not an install.
- Guess: self-tapping screw strength in printed pilots has no coupon. The nest lid screws are named in the nest CAD and are not in the robot build order.
- Next: when the nest is installed, re-run the hole audit and add the nest steps to the build order. Until that install, do not mark D39 or D42 closed for the whole duck.

## Sit and get-up (twin/sit)

- Pass: the sit and the get-up through the sit use the printed joint stops, the torque-off rest is stable without a friction number the datasheet does not give, and the cables reach with the slack rule.
- Status: FAIL.
- Result: the sit parts are in the CAD (CAD check only, twin/sit/SIT.md). Stress rows in the sit study pass as calc. Stand-up in sim is reported in SIT.md (sim pass only). Get-up through the sit raises 248 of 296 cases on the merged sit model; the 48 front rests on a down ramp still fail (sim pass only, twin/sit/getup/VIA_SIT_EVAL.md). Knee and ankle leads are short of the slack rule (SIT.md). Charging is the nest pins, not the feet (D61, SIT.md section 1). PRs 34 to 43 did not re-run this get-up. The blind dock sit, the last part of the approach with no camera update, has not been run (twin/dock/flush/FLUSH_CONTACTS.md).
- Guess: unpowered servo friction is not on the Feetech sheet. The sit and the get-up both use it. Cable slack is a CAD length, not a built harness.
- Next: keep the get-up misses on the retrain list. Do not call get-up done. Measure friction on the bench (TEST_PLAN.md 19.5) and put that number back into the sim before treating the torque-off sit as settled. The blind dock sit stays NOT RUN until that sim exists.

## Knee (twin/knee)

- Pass: both knees are the STS3250 that will be bought, the twin uses that datasheet, and the walk and the get-up that ship with the duck have been run on that model without a fall the policy cannot explain.
- Status: FAIL.
- Result: sim pass only and calc only, twin/knee/KNEE_TWIN.md. Heat in that model does not hit the 70 C cut (47 to 63 C, sim pass only). Calc only: 63 C is 3 C over the 60 C operating line at 32 C (KNEE_HEAT_STUDY.md). The stock policy with the published damping walks much slower and falls in 4 of 5 backlash sessions (sim pass only). Roll-to-pitch stays under the margin of 2 in the knee file. What changed: the STS3250 sheet A/0, 2024-01-16, is opened in KNEE_HEAT_STUDY.md (cited). Rated input 6 to 12 V. Stall 50 kg.cm at 4.2 A and 12 V, Kt 11 kg.cm/A, terminal resistance 1.2 ohm. Calc only: 12 V / 4.2 A is 2.86 ohm, not 1.2 ohm. Operating range -20 C to 60 C, torque off above 70 C. At 7.2 V the heat study scales the stall line to 30 kg.cm and 2.5 A (calc only). PARTS_AUDIT.md line 1b still says the buy page's datasheet was not opened. The sheet in the heat study is not a retrain, and it is not a walk of the policy that will ship.
- Guess: damping 1.00 Nm s/rad is taken from a published torque-speed line, not from a bench BAM test. The 1.2 ohm line and the stall current disagree (calc only, above). This disagreement is BLOCKER until the bench or a corrected sheet picks one.
- Next: put the opened sheet's torque, speed, and temperature into the knee model, and resolve the 1.2 ohm against 2.86 ohm before another closed-loop claim. Do not walk the stock policy on these knees even in sim as if it were the shipping gait. The retrain stays blocked on a bench BAM test (TEST_PLAN.md 15).

## Freeze (twin/freeze)

- Pass: touch, cliff, mics, speaker, and the pickup behavior are in the twin with datasheet behavior, and the CAD seats match the boards that will be bought.
- Status: GAP.
- Result: seats and wiring notes are in, CAD check only and calc only (twin/freeze/FREEZE.md). Mic seats are in print/head.stl. Cliff, touch pads, and the speaker duct have geometry checks. There is no closed-loop twin of a person, a cliff, or a sound. The ear PWM change is still an open software question (D53). The head camera field (twin/camera/CAMERA_TWIN.md) is not a cliff model and not a hearing model. The parts session found the cliff board listing in stock and did not open the VL53L4CD datasheet (PARTS_AUDIT.md line 5b).
- Guess: touch capacitance and the speaker's Helmholtz corner are calc, not a measurement. Cliff distance in sim is not a VL53L4CD model.
- Next: a perception twin (the camera row below) has to include the cliff and the mics, or this row stays GAP. Do not count the seat checks as behavior.

## Complete 3D and CAD (twin/complete3d)

- Pass: one 3D model contains every solid, cable, and bought part of the duck that will be built, including the nest, and the print files are that model.
- Status: GAP.
- Result: the walking-duck camera seat, the 300 mm camera cable route, and a set of cable and fastener patches were checked, CAD check only (twin/complete3d/COMPLETE3D.md). PR 38 added the module field on that same seat (twin/complete3d/camera_cone.json, twin/camera/CAMERA_TWIN.md, CAD check only). The nest CAD is archived under twin/dock/nest/cad and is not in print/, the URDF, the netlist, or the viewer (nest handover). The flush wells and the charger board have no seat in that model (FLUSH_CONTACTS.md, CHARGER_BOARD.md). Some knee and ankle leads are test-fit, short of the slack rule (SIT.md).
- Guess: camera cable width and thickness are still unmeasured (BOM line E7). Several small-part envelopes were taken from listings, not from datasheets opened in the parts audit.
- Next: install the nest only after the pin part number is a part a page can sell and the owner has approved the look. Then rebuild the viewer from that model. Do not keep two ducks (the print set and the nest archive) and call them one twin.

## Nest dock (twin/dock/nest)

- Pass: the installed model walks onto the real felt shape, turns 180 deg, sits, connects four pins, charges, and leaves, with the camera in the loop, and the CAD, the netlist, and the bill are that same nest.
- Status: FAIL.
- Result: sequence sims, sim pass only. Steering walk-on: first sit charges in 93.1 percent of 540 runs (503), 29 falls, all at 7.2 V, all on the mat edge (twin/dock/nest/sim/NEST_SIM.md). Straight crossing: first sit 84.3 percent (455 of 540), 13 falls (twin/dock/nest/sim/v2/NEST_SIM_V2.md). What changed is twin/dock/nest/sim/v3/NEST_SIM_V3.md. Mixed controller on the archived one 2 mm step: first sit 503 of 540, within 3 sits 526 of 540, falls 10, all at 7.2 V (sim pass only). Two 1 mm steps: first sit 524 of 540, within 3 sits 536 of 540, falls 0 of 540, worst head gap 33.4 mm, worst foot-to-rim gap 24.8 mm, 0 runs inside the wall or the rim (sim pass only). The same steps with a 20 mm aim at 7.2 V, counted with the 6.0 V stepped runs: first sit 531 of 540, within 3 sits 540 of 540, falls 0, worst head gap 9.6 mm (sim pass only). The approved sun-to-wall distance in that file is still 190 mm. A 215 mm wall is a study only (that file, not a new measurement). The mat in every one of these runs is rigid. The pose is a stand-in, not a camera. CAD of the pins, mat, and rim is drawn, checks A to H pass, and it is not installed (twin/dock/nest/cad/NEST_CAD.md, CAD check only). Added mass 14.4 g is calc only and does not include the charger board. The blind sit, head down and then no pose updates through the turn and the sit, has not been run (twin/dock/flush/FLUSH_CONTACTS.md).
- Guess: the pose is a stand-in, not a camera. Pin tip diameter in the CAD (about 2.3 mm) is not the catalog tip now proposed. PARTS_AUDIT.md names 100-PRP4030S, tip 30, 1.40 mm (cited, catalog pages 32 and 33). That tip is not drawn into the installed model, because the nest is not installed. No in-stock US page for that probe was opened (NOT TODAY).
- Next: do not install the CAD on a tip no page can sell. The edge falls on the one 2 mm step are not the two-step result. The two-step result is still a rigid mat and a pose stand-in. Run the blind sit before calling the window a dock rate. The camera, the felt, and the bill have to be this same nest before this row can pass.

## Camera and perception (missing)

- Pass: a camera model, with the lens and the light from the Camera Module 3 brief, finds the nest with no tags, and the same model is what the dock program will run.
- Status: GAP.
- Result: no finder. twin/camera/CAMERA_TWIN.md is the field geometry only (CAD check only, and the brief is cited). It does not find the nest, and it does not drive the duck. TEST_PLAN.md 20.9 is NOT RUN in that file. D61 records camera-only finding as untested. The nest sims add noise to the true pose (sim pass only). The camera brief was opened (PARTS_AUDIT.md): Sony IMX708, operating 0 C to 50 C (cited, the camera brief). That brief is not a mat finder. Room light and exposure are BLOCKER (CAMERA_TWIN.md).
- Guess: everything between the lens and a dock pose. Exposure, home lighting, and the look of the gold cloth are not in any file as a measurement.
- Next: a perception twin on recorded or rendered frames, scored the way TEST_PLAN.md 20.9 will score the real duck. Until it exists this row stays GAP, and gate 0 stays open.

## Felt and cloth material model (missing)

- Pass: the mat in the sim is felt and cloth, with thickness, friction, and stiffness from a datasheet or a coupon, including the two-step edge.
- Status: GAP.
- Result: no material model in the sim. NEST_SIM_V3.md limit 2: the mat is rigid (sim pass only). twin/contact/CONTACT_TWIN.md reads a felt pressure table (cited, US Felt SAE) and does not name the nest grade. Ten percent of the 2.0 mm stack is 0.2 mm (calc only). The dent depth between those two is BLOCKER. Sole friction on felt is BLOCKER. The cloth page that was opened is not the gold pair (PARTS_AUDIT.md, Shieldex Nora Dell, cited, silver copper nickel, not gold). One grey cloth cannot be both poles.
- Guess: friction, pile, and how far a pin sinks. The gold cloth and the pale gold cloth have no part number that is both colors (PARTS_AUDIT.md).
- Next: do not tune the walk against the rigid mat and call it the felt. A coupon measurement (TEST_PLAN.md 20.6) has to land in the model first, or the model stays a stand-in.

## Pin contact model (missing)

- Pass: each pin is the catalog part, with its spring curve, and the contact resistance on the cloth is a measured number the electrical twin uses.
- Status: NOT RUN.
- Result: the QA Technology catalog was opened (PARTS_AUDIT.md session 2026-11-11 ET, cited). The proposed probe is 100-PRP4030S, tip 30 round, 1.40 mm, spring S, full stroke 10.16 mm, 0.42 N then 1.58 N at 8.05 mm. No in-stock US page was opened (NOT TODAY). The 2.3 mm tip drawn in the nest CAD is not on that catalog page. twin/contact/CONTACT_TWIN.md builds a working loop, calc only: 0.050 ohm with four pins, 0.100 ohm with one pin of each pole still touching, at the currents already in the dock studies. TEST_PLAN.md 20.1's pass line is 0.15 ohm for the two-pin loop at 1.0 A. The calc sits under that line and is not the measurement. The electrical twin does not use these ohms. Cloth life, tab crowding, and the sun through-path are BLOCKER in that file.
- Guess: contact ohms on the real cloth, dirt, hair, and snag. The calc loop leaves those out on purpose.
- Next: ask Ahmed before buying the coupon (a few pins, cloth, felt). Then run TEST_PLAN.md 20.1 to 20.4. Put the measured ohms into the electrical twin. Until that measurement this row stays NOT RUN. The coupon is allowed before gate 0. The duck is not.

## Servo angle limits matched to CAD contacts

- Pass: every software limit and every sim joint range is inside the CAD contact, with the same zero, and a command cannot ask for an angle the printed part cannot reach.
- Status: FAIL.
- Result: the sit stops are written 3 deg inside the CAD contacts (software/servo_limits.json, twin/sit/SIT.md, CAD check only). The get-up retest showed the older sim ranges (knee and ankle near 90 deg, neck and head past the new stops) are angles the printed parts cannot reach (twin/sit/getup/GETUP_SIT.md, sim pass only). The sit-model get-up stays inside the new stops within 0.30 deg (sim pass only, twin/sit/getup/VIA_SIT_EVAL.md). The base model used by older get-up results does not. PRs 34 to 43 did not replace the limits file.
- Guess: the real servo's end stop, with torque off, is not the CAD contact. Friction and backlash (the opened STS3215 sheet allows up to 0.5 deg, cited) move the pose.
- Next: one limits table, used by the sim and by the Pi, generated from the CAD contacts. Retire sim results that still use the wider ranges. Bench check is TEST_PLAN.md 19.1.

## One-click bill matched to the twin, line by line

- Pass: every part in the twin is one line on the bill, with an exact manufacturer part number, a quantity, and a distributor that can sell it today, and the bill has no line the twin does not use.
- Status: FAIL.
- Result: PARTS_AUDIT.md, including the session dated 2026-11-11 ET, and PROPOSED_BOM_CHANGES.md. BOM.md was not changed. A one-click of today's bill still buys DK1 and skips the nest. The probe is now named 100-PRP4030S (cited, catalog). No in-stock US page was opened for it (NOT TODAY). The socket 100-SDN250S is not a confirmed US cart. Felt, the gold and pale gold pair, the 90 mm foil disc (CAD check only, the nest drawing), rim foam, and the gate board have no orderable part (BLOCKER). Line 7, the weld, has no part number (NOT ORDERABLE). The bare Pi (line 3) and the P45B (line 6) were out of stock on the pages that session opened (NOT TODAY). Line E3 has a listing that does not close the eye fit (BLOCKER, and software/SOFTWARE.md section 12). The MCP73213 sheet is opened in circuitry/CHARGER_BOARD.md and the part named there, MCP73213-A6SI/MF, is not a line on BOM.md. The board has no seat. Many other lines showed a page that could sell them. That is not a one-click of the duck this checklist describes.
- Guess: any row in PARTS_AUDIT.md that the later session still marks NOT TODAY, NOT ORDERABLE, STOCK NOT REOPENED, or BLOCKER. The first-write sentence "nothing is orderable" is replaced by that session's own list. The nest and the weld are still off the order.
- Next: do not place the order. Keep DK1 off the nest order when a decision says so. Add the nest lines only when a page can sell the tip, the cloth, the felt, and a seated charger. Then diff the bill against the twin until every line matches.

## Lights (missing as a model)

- Pass: every lamp that will be built has a manufacturer part, a driver, a power wire, and a colour, and the same parts are on the bill and in the netlist.
- Status: GAP.
- Result: the eyes and the projector are in the netlist and on the GPIO map (D9, D13, wiring/netlist.yaml, software/SOFTWARE.md section 2). D13 keeps the upstream path: each eye GPIO through 100 ohm, about 3 mA, and the projector LED gets a 100 ohm resistor too (DECISIONS.md D13). D57 keeps the eyes as one dim warm white bead each. The optional RGBW eye is not added. software/SOFTWARE.md section 12 records that decision and opens two sheets. Kingbright WP7113QWC/D is cool white, and its typical forward voltage at 20 mA is 3.3 V (cited). Lite-On LTW-420C5 does not light from 3.3 V and is not warm (cited). Neither closes line E3. The parts session names uxcell a18032300ux0174 on a listing whose bulb shape fights the bead title. Fit in the eye is BLOCKER. No file gives candela, beam angle, or a driver other than the resistor.
- Guess: how bright a warm white bead would be in a room, and whether a person can see which eye is on. No warm-white sheet that also fits the 8.0 mm hole (MOUNTING.md) and the 3.3 V GPIO has been opened.
- Next: do not add colour eyes. Give line E3 a real part or keep the lamp as a named gap. A light check belongs on the bench with the existing eye GPIO, not in a new lamp design.

## Field of view (missing for the head camera)

- Pass: the head camera cone, from the lens brief of the module on the bill, is placed on the camera seat, and a file says what that cone includes of the nest mat, the floor, and a person at the distances the dock and the home use need.
- Status: FAIL.
- Result: the cone is now on the seat. twin/camera/CAMERA_TWIN.md and twin/complete3d/camera_cone.json. The brief's standard module is 75 degrees diagonal, 66 degrees horizontal, and 41 degrees vertical (cited). On this board the 66 degree axis is up and down (CAD check only). The shell does not clip that field (calc only). A level head on the tall zero pose sees the gold disc and the ring at about 1 m and about 2 m, and does not see them at 0.3 m or 0.5 m (CAD check only). At the forward stop the first visible floor is 316 mm ahead of the toe (CAD check only). The recorded sit sees 0 of 13 disc samples and 0 of 27 ring samples (CAD check only, on a pose that is sim pass only). The file does not say what the cone includes of a person. TEST_PLAN.md 20.9 is NOT RUN. Light is BLOCKER. This geometry is not a PASS of the row.
- Guess: where the head is pointed during a real dock, and whether a person at the home distances falls inside the same field. The stock schedule commands pitch 0. That pitch was not re-run on the walking crouch (BLOCKER in CAMERA_TWIN.md).
- Next: put a person into the same cone file, then score frames the way TEST_PLAN.md 20.9 is already written. Until those frames exist this row stays short of its pass. The sit that sees none of the cloth is a real limit of this head, and the blind approach that follows it has not been run.

## Communications (missing as one model)

- Pass: every bus on the duck has its wires, its rate, its protocol, and a latency number from a measurement or from the byte timing, and Wi-Fi and Bluetooth are either used with a stated latency or recorded as unused.
- Status: FAIL.
- Result: the table is software/SOFTWARE.md section 11. Servo bus: 1 Mbaud, 8N1, half duplex. One 14-servo control cycle is 318 bytes, 3.18 ms on the wire (calc only). The USB round trip is BLOCKER. The servo answer delay is BLOCKER (twin/electrical/ELECTRICAL_TWIN.md). I2C stays at 100 kHz. One bit is 10 us (calc only). A full transaction on this duck is BLOCKER. I2S sample period 20.8 us is cited from the companion note. The time from the mic to a sample in software is BLOCKER. CSI frame rate and frame delay are BLOCKER. Wi-Fi is 2.4 GHz on the Pi (cited, the product brief) and D46 says it is not used for docking. Its latency is BLOCKER. Bluetooth 4.2 is used by the pad (software/PI_SETUP.md) and its latency is BLOCKER, so it is not recorded as unused and it has no stated latency. Nothing in the table was measured on a Pi.
- Guess: USB round trip, Pi CPU time, and any home-server round trip.
- Next: leave unpublished times as BLOCKER. Measure them on the Pi or derive them from byte timing before this row can pass. Do not start a second protocol stack.

## Circuitry (missing for the charger)

- Pass: one schematic, generated from the netlist, shows the power tree, every regulator, the charger, protection, fusing, and decoupling for the duck that will be built, including the charger inside the body.
- Status: FAIL.
- Result: the walking power tree is the netlist (rev 2026-11-06) and the sheets generated from it (wiring/sheets/). Fuse, BMS, switch, BEC, and the 5 V regulator are in that tree. The electrical twin's completeness pass found a source, a fuse, and a connector on every powered net of that duck, and it did not add a bulk capacitor (twin/electrical/ELECTRICAL_TWIN.md, sim pass only, calc only). What changed is circuitry/CHARGER_BOARD.md, circuitry/charger_board.yaml, and the KiCad drawing of the same nets. The chip is MCP73213-A6SI/MF (cited, DS20002190C). Regulation 8.40 V. Specs apply from 8.70 V. Elapsed timer 6 hours, 5.4 to 6.6 h (cited). There is no THERM pin (cited). Decoupling in that note is 4.7 uF, 25 V, cited from the eval guide. The live page for the named TDK capacitor was not opened (BLOCKER). The file does not edit wiring/netlist.yaml. GPIO5 and GPIO6, the status and enable wires, are not in the netlist. The seat and the board mass are BLOCKER. The electrical twin was not re-run on this board. Several parts on the sheet (TL431, MMBF170, the 4.7 V zener) were not opened (BLOCKER).
- Guess: in-trunk theta JA. The 62 C/W figure is the sheet's JEDEC board, not the closed trunk (cited versus BLOCKER).
- Next: merge charger_board.yaml into wiring/netlist.yaml only after the seat exists and the unopened parts are read, then re-run the existing electrical rule check. Do not draw a second schematic by hand. Do not call this board the duck until that netlist is the one the sheets generate.

## Software (missing programs)

- Pass: every program that will run on the duck is in this repo or named at its pinned upstream commit, and the same code has been run against the twin, including nest finding, charging, the joint limits, and the safety stops.
- Status: GAP.
- Result: software/SOFTWARE.md section 10 is the program list. The walk loop, the ONNX policy, the IMU reader, and the eye blink are the pinned Runtime (section 1). The knee heat guard is software/knee_heat.py: warn and stop at 55 C on two readings, torque off while idle or sitting, resume below 45 C. Those temperatures are set points in that file, not a measured knee. Unit tests with no hardware passed that sequence (section 5). The boot service passes --knee-heat. It has not been run on a servo. The sit rest is a separate torque-off on the printed stops (DECISIONS.md D59). Joint limits for that sit are software/servo_limits.json. The old dock behaviour port is software/dock/ and targets the earlier dock. Nest vision has no file (BLOCKER). A charge program has no file (BLOCKER). The charger schematic is not that program. Updates after the install apt commands are not written. V1 track 3, the Runtime against the twin, is not started (V1_PLAN.md).
- Guess: there is no draft of the nest-vision program, the charge program, or an update program to measure.
- Next: write nest vision only after the camera row has frames. Write the charge program only after the charger is in the netlist. Keep the Runtime unmodified (D6). Do not treat the simulated-bus tests as a run on the duck.

## Training (not run)

- Pass: the policies the duck will ship have been trained for the mass, the knees, the gains, and the nest edge the twin uses, and an eval in the shared lab gym (overlay gym/overlays/duck) records the result.
- Status: NOT RUN.
- Result: no GPU training run has been executed. A CPU smoke of the STS3250 preset ran 480 env steps in 612 s on 8 envs (twin/knee/KNEE_TWIN.md, sim pass only). That smoke is not a policy. Stage 0 of a walk at the build mass is described as ready on CPU and not run. The stock policy falls on the STS3250 model in sim (knee row). Get-up still misses the down-ramp front rests (sit row). Nest sim v3 ran the stock policy already in the repo: two 1 mm steps, 0 falls in 540 runs (sim pass only, twin/dock/nest/sim/v3/NEST_SIM_V3.md). That run is not a trained policy, and it is not an eval of a new policy in the shared lab gym (overlay gym/overlays/duck).
- Guess: how many GPU hours a real retrain takes. A published note for the upstream 150 to 300 million step command says 1.5 to 3 hours on an RTX 4090 (cited). That note is not a lab log. See COMPLETE_DUCK_AUDIT.md.
- Next: do not start a paid run from this row. The scope is in COMPLETE_DUCK_AUDIT.md and needs an OK before any GPU is rented. Do not count the nest v3 stock-policy sim as that training.

## What blocks gate 0, in order

1. There is no single model. The print set, the netlist, and the viewer are the walking duck. The nest, the flush wells, and the charger board are files beside them. Until those are one duck, gate 0 cannot pass.
2. The bill does not match that duck. PARTS_AUDIT.md names the probe and reopens stock, and a one-click of BOM.md still buys DK1 and misses the nest. The probe has no in-stock US page. Felt, the gold pair, the weld, and the gate have no orderable part. The bare Pi and the P45B were out of stock on the pages that session opened.
3. The camera finder, the felt, and the measured pin contact are not models. The nest sims, including v3, are a pose stand-in on a rigid mat. The blind sit has not been run (FLUSH_CONTACTS.md). That cannot stand in for gate 0.
4. A continuous walk still leaves the 60 C operating range (KNEE_HEAT_STUDY.md, calc only and sim pass only). The 3.3 minute figure is the short end. With the sheet's torque-off on, the knee case peaks near 64 C, which is still in the PLA softening band. The 94.7 C body is the run with that torque-off switched off. The 55 C guard is a software stop in unit tests. It is not a pass of the heat model. The STS3215 sheet has both: operating range -20 C to 60 C, and torque off above 70 C.
5. The electromechanical loop runs the P45B figure. With the sheet stall the walk falls (sim pass only). The trained-actuator session (42.9 minutes, no fall) is not that servo. The electrical fall and get-up replay was not re-run: those traces are not in this repo (BLOCKER).
6. The welded pack has no part number. The opened cell maximum fits the sleeved bay (22.2 by 43.7 by 71.0 mm, CAD check only, twin/battery/bay_edit.py). The charger schematic exists (CHARGER_BOARD.md) and is not in the netlist, and it has no seat.
7. Structure stays under the lab margin. On the uninstalled geometry the shin drive eye walk safety factor is 1.30 against 2, and the thigh sheets are 1.71 (FEA pass only, TOPOLOGY.md). Soft falls stay under 1.2 on roll_to_pitch, the shin, the thigh, the neck, and the head. The current print STLs are lower (shin eye 0.79, roll_to_pitch 1.43, FEA pass only). The topology carve did not save print mass. D26 is open. Hot PLA is a guess: calc only, roll walking 2.41 times 0.62 is 1.49, under 2.
8. Get-up misses 48 down-ramp front rests (sim pass only). The stock policy falls on the STS3250 knee model in sim. The STS3250 sheet is open, and the 1.2 ohm line disagrees with the stall current (calc only, 2.86 ohm). Neither is a shipping behavior. The blind sit has not been run.
9. Nest sim v3, on two 1 mm steps and a 20 mm aim at 7.2 V, charges at the first sit in 531 of 540 runs with 0 falls (sim pass only). The mat is rigid, the pose is not a camera, and the CAD is not installed. The approved wall in that file stays 190 mm. That sim is not a substitute for items 1 to 3.
10. Line E3 is still open. The head-camera cone is on the seat and the recorded sit sees none of the cloth (CAD check only). Communications has a table and several BLOCKER latencies. The charger is not generated from the robot netlist. Nest vision, the charge program, and updates are unwritten. Training is NOT RUN.
