aaltaay/Open_Duck_Mini_v2/altaay_lab/history/2026-11-12_1832_sts3215_12v.md

# 2026-11-12 6:32 PM ET: 12 V STS3215 on three P45B cells

Labels: sim pass only for the walks. Calc only for the stall conversion and the bay span. Cited for the Feetech page, the cell, and the listings. Nothing was bought. No retrain.

- problems/STS12.md. ST-3215-C018: 30 kg.cm and 2.7 A at 12 V, 0.222 s/60 deg.
- Both corners hold 20 s. Knee mins 10.886 V and 10.728 V typical, 10.515 V and 10.417 V high-side. Peak pack current 9.527 A and 9.019 A.
- The drawn bay holds two 22.2 mm circles. A third cell does not fit. The MCP73213 is 8.40 V and the Tenergy 32175 is a 2S board.
- Added mass that is known: 70 g for the cell. Servo weight is 55 g on both sheets, so 0 g at the nominal. Servo price against the $19 line runs from $42.14 less to $153.86 more at the one-unit listings. A 3S charger and a 3S board are not priced.
