aaltaay/Open_Duck_Mini_v2/altaay_lab/history/2026-11-12_1824_bus_sag.md

# 2026-11-12 6:24 PM ET: free electrical changes on the sheet-stall fall

Labels: sim pass only for the walks. Calc only for the copper and the figure sag. Cited for the 15 milliohm, the 7 milliohm, and the 22 to 28 AWG terminal. Nothing was bought.

- problems/BUS_SAG.md. Same em_twin sheet walk, both corners, 20 s budget.
- As built falls at 3.56 s and 3.42 s. Knee dips 5.785 V and 5.889 V typical, 5.269 V and 5.244 V high-side.
- Thicker hops, shorter feeds, a 16 AWG feed with a 22 AWG tail, a knee star, a 470 uF cap, and the cited 7 milliohm AC line all still fall between 3.40 s and 3.58 s.
- The stack of the wire changes falls at 3.56 s and 3.50 s. No change in the set walks 20 s.
- At an open circuit of 3.30 V per cell the 2S sag on the figure is 0.168 V at 5 A (calc only). That walk falls at 2.98 s and 2.96 s. Worn cell resistance is BLOCKER.
