aaltaay/Open_Duck_Mini_v2/altaay_lab/history/2026-11-12_1830_voltage_budget.md

# 2026-11-12 6:30 PM ET: where the knee dip goes

Labels: sim pass only for the walks. Calc only for the ohm times ampere products. Cited for the sheet stall current and the BMS and switch ceilings. Nothing was bought.

- problems/VOLTAGE_BUDGET.md. The typical left-knee sample is 5.785 V at 3.182 s.
- Peak pack current is 17.899 A. Peak bus current is 15.147 A. High-side peaks are 17.676 A and 14.944 A.
- From the 8.347 V open circuit: 0.495 V in the cells, 1.257 V on the pack path, 0.067 V of copper into the BEC, 0.300 V of dropout, 0.443 V of harness. The 7.4 V rating is 1.615 V above that knee.
- Holder, fuse, and XT30 are 0.322 V with no measured part. Dropout is unpublished. Efficiency 0.85 adds about 0.19 V of pack current (calc only).
- Zeroing those still falls at 3.60 s and 3.54 s. The fall is not only those assumptions.
