aaltaay/Open_Duck_Mini_v2/altaay_lab/history/2026-11-12_1836_cap_companion.md

# 2026-11-12 6:36 PM ET: capacitor row was a delay, now a companion

Labels: sim pass only. Nothing was bought.

- The 470 uF case in problems/bus_sag.py held the previous knee current for one step. That is a delay, and any positive capacitance did the same thing.
- It is now a backward-Euler shunt: i = (C/dt) times (v - v previous), ESR 0. The first step only stores the port voltage.
- Regenerated: typical falls at 3.56 s, knees 5.745 V and 5.843 V. High-side falls at 3.42 s, knees 5.142 V and 5.297 V.
- Still no 20 s walk. The other rows were regenerated with the same script and match the earlier table.
