aaltaay/Open_Duck_Mini_v2/altaay_lab/history/2026-11-12_1829_sheet_sense_wire.md

# 2026-11-12 6:29 PM ET: the power sheet no longer draws the old sense wire

The bead is not on the SENSE splice anymore. The power sheet still asked for that wire, and the sheet tool stops when the pair is missing. That call is gone. A short note on the sheet says pin 1 is cable NT to the divider plug. Regenerating the sheets on a copy finished, 0 errors.
