aaltaay/Open_Duck_Mini_v2/altaay_lab/history/2026-11-12_1824_nest_d62.md

# 2026-11-12 6:24 PM ET: D62, the striped nest is official

Ahmed approved the flat felt mat at 6:19 PM ET. D61 was not edited. D62 supersedes the spring pins.

The official nest is altaay_lab/cad/nest_v2/: flush foil stripes and five gold wells in the seat. The spring-pin CAD and the probe stay in the repo and are not the nest to build. The order note, the checklist, and the charger note point at the new mat.

Still open, and not a hardware pass: dirt on the gold, the gate board and a coin short, charger heat at 2.30 W and 3.50 W, and a real camera detector. Nothing was bought.
