aaltaay/Open_Duck_Mini_v2/altaay_lab/history/2026-11-12_1821_lid_posts_standins.md

# 2026-11-12 6:21 PM ET: lid posts checked against every nest box

The y ±62 posts cleared the jack and entered the fuse holder and the gate board (cad). Those boxes are already in `nest_parts.py`. The proposal now puts the four posts at (158, ±2) and (174.9, ±2). Mirror error 0.0 mm (calc). The smallest gap to a stand-in is 2.0 mm, at the gate board (cad). The end-wall tie is not part of the proposal. The nest STL is still not edited. Nothing bought.

Topology STLs and the chest hole stay open.
