aaltaay/Open_Duck_Mini_v2/altaay_lab/history/2026-11-12_1802_life_heat_stress.md

# 2026-11-12 6:02 PM ET: when the duck breaks, and what gets hot

Life note in twin/life/. It reuses the thermal model, the current-print FEA, the shin eye study, the charger watts, and the 55 C guard. No new part. No measurement.

The 25 C check matches the published thermal file (3.33 minutes, 94.67 C body). At 22 C the right knee reading crosses 60 C at 3.7 minutes. At 32 C it is 2.5 minutes, the same as the published run. With the guard, walking time in 90 minutes is 29.2 at 22 C and 17.0 at 32 C. The BEC case is the hottest resolved case, about 109 C and 117 C. The Pi chip and the charger die in the trunk stay BLOCKER. Cells while charging stay under 41 C at 2.30 W and 3.50 W.

The bought STS3215 falls at about 3.5 seconds on the trained gait. That is the first failure. The shin drive eye is the first printed part past its failure index if those sim loads are reached (walk safety factor 0.79). Hard-floor digits for the current mesh are still only "under 1.2". Gear life at the sheet's test torque is at least 15 hours of walking. Gear life at the sim torque, bearing life, felt, battery cycles, and cable flex stay BLOCKER.

c9_docs.py passed (existing warnings only).
