aaltaay/Open_Duck_Mini_v2/altaay_lab/history/2026-11-12_1819_dfa_screw_cuts.md

# Screw-cut package

2026-11-12 6:19 PM ET. Follows the merged DFA check. The fastener schedule in cad/fasteners/ counts the same 324 fitted screws.

The 56-screw gap is one line: 4 factory case screws on each of 14 servos. The builder turns the other 268. CAD check only.

A K3-section clip, barb width set by the mid-fall load, clears 14 screws (mics 4, Pi 2, adapter 2, cliff 2, speaker interface 2, speaker stand 2). Fitted screws would be 310. Builder-turned screws would be 254. Washers stay 8. Inserts stay 48. print/ is not edited.

Under 200 is not met. Eyes miss the 0.3 mm margin (CAD check only). The battery lid and the head sheet are too thin for the barb. Horns, case clamps, and shells fail the strength check or are BLOCKER. Detail: altaay_lab/cad/dfa/CUTS.md.
