aaltaay/Open_Duck_Mini_v2/altaay_lab/history/2026-11-12_1825_dfa_pulloff.md

# Clip pull-off, not barb shear

2026-11-12 6:25 PM ET. The review on the screw-cut note is right. The K3 return is 45 degrees, so a pull spreads the arms. A stock 5.7 mm Pi clip pulls off at 1.27 N (calc only) against 29.1 N. Shear area is not the check.

The package still removes 14 screws, but the arms are longer and thicker where the stock arm is too soft. Pull-off is at or over the mid-fall load, and strain stays at or under 0.535 percent (calc only). The mic clip stays the stock K3. Eyes still miss. Fitted screws would be 310. print/ is not edited. Detail: altaay_lab/cad/dfa/CUTS.md.
