aaltaay/Open_Duck_Mini_v2/altaay_lab/history/2026-11-12_1815_nest_v2.md

# 2026-11-12 6:15 PM ET: nest mat version 2

Labels: sim pass only on the stored 540-seed seats, CAD check only on the new meshes, calc only on the arithmetic, cited where a page was opened. Nothing ran on hardware. Nothing was bought. DECISIONS.md was not edited.

- The pick is a flat felt mat with a flush striped field, and five gold wells in the seat. No springs on the duck. The cute sit stays. Camera only.
- On the same 540 seeds, no new physics run: the blind walk puts the first seat in the stripe window in 380 of 540 (0 falls). The 40 mm wall card does it in 533 of 540 (1 fall). The true-pose walk does it in 540 of 540. A 16.5 mm magnetic face holds 5 of 540 blind. A 10 mm coil offset holds 3 of 540 blind.
- Magnetic pads, Qi2, a cradle, and a field of springs in the mat lose on that spread, on power, or on part count. The write-up is altaay_lab/cad/nest_v2/NEST_V2.md. The proposed decision, for Ahmed to approve, is altaay_lab/cad/nest_v2/DECISION.md.
- CAD, STEP, and STL are in that folder. Renders: the sit from the front, the side, and three-quarter, the mat from above, and the five wells under the seat.
