aaltaay/Open_Duck_Mini_v2/altaay_lab/history/2026-11-12_1818_volume_prices.md

# 2026-11-12 6:18 PM ET: volume prices and the Waveshare stall check

Labels: prices cited from pages opened this pass, or from ORDER.csv when this pass did not reopen the page. Sums are calc only. The stall comparison is calc only. No walk was rerun. ORDER.csv, BOM.md, and REDTEAM.md were not edited.

- VOLUME.csv has every order line at 1, 100, and 1,000. A blank cell is BLOCKER. Seeed printed 20.00 and no 100 or 1,000 row. Waveshare printed 16.99, then 16.59, 16.39, and 16.31 at 4 or more, with no ceiling.
- One in-stock duck is 781.29 with the tool set, or 730.36 of repeat parts (calc only). The Pi kit reopen is 87.95, which is 2.00 under the order file's same-day figure.
- At 100 and at 1,000 the order total is BLOCKER. The only 1,000-covering servo tier is the Waveshare 4-or-more price, 228.34 for 14 (calc only). That is not a whole duck. The 380 pass line is not shown.
- The C001 sheet backlash is at most 0.5 degree. The Waveshare pages and the user-manual extract do not state backlash. The 7.4 V stall matches 19.5 kg.cm, so that servo does not avoid the sheet-stall fall at 3.46 s to 3.56 s.

verify/c9_docs.py: PASS, 0 FAIL. The warnings are older files.
