aaltaay/Open_Duck_Mini_v2/altaay_lab/history/2026-11-12_1822_volume_review.md

# 2026-11-12 6:22 PM ET: review fixes on the volume prices

Labels: calc only for the sums. The fall wording is the electromechanical twin's own sentence, sim pass only. No walk was rerun.

- volume_prices.py now prints an in-stock repeat sum and an all-priced sum. In stock at one duck is 730.36. All priced is 750.51. The 20.15 gap is the amplifier, the polyimide tape, and the solder, which the order marks out of stock.
- WAVESHARE_CHECK.md no longer says a matching 7.4 V stall means the Waveshare unit falls. The twin says the fall is the sag on the first steps, and the same sheet model at a flat 7.4 V does not fall in 20 s. Whether this servo avoids that fall is BLOCKER. The page does not print a 6 V stall.

verify/c9_docs.py: PASS, 0 FAIL. The warnings are older files.
