aaltaay/Open_Duck_Mini_v2/altaay_lab/history/2026-11-12_1811_stall_fall.md

# 2026-11-12 6:11 PM ET: the sheet-stall fall, ranked first

Labels: sim pass only for the walks. Calc only for the model against the cited STS3215 lines. Nothing was bought. The electromechanical twin was called, not rewritten.

- Red team finding 1 (PR 48) is the number one open problem. problems/STALL.md. The existing sheet mode falls at 3.56 s (backlash, typical), 3.42 s (high-side), and 3.56 s (plain). The stored file had 3.52 s, 3.46 s, and 3.56 s.
- At 7.4 V the model stall is 1.912 Nm, the same as the sheet. No-load is 5.646 rad/s against the sheet 5.454 rad/s (calc only). Holding every servo at 7.4 V does not fall in 12 s (track 0.645, sim pass only). On the bus the knees dip to 6.21 V (typical) and 5.51 V (high-side).
- An unscaled trained gain still falls (7.6 s). A 0.07 m/s command stays up 20 s on the typical corner (0.035 m/s) and falls at 5.24 s on the high-side corner. Not a fix. The retrain stays BLOCKER until Ahmed says yes.
- Red team items 2 to 5 are listed open in problems/PROBLEMS.md, with the owners already in REDTEAM.md. Those files were not edited.
