aaltaay/Open_Duck_Mini_v2/altaay_lab/history/2026-11-12_1817_stall_review.md

# 2026-11-12 6:17 PM ET: the stall review, three number fixes

Labels: sim pass only for the walks. Calc only for the cap at the new dip. The electromechanical twin was not edited.

- Knee minimums now use the twin's V_min bins, not the lowest 100 ms average. Command 0.15 m/s, typical: dips 5.79 V and 5.89 V. High-side: 5.27 V and 5.24 V. The 0.10 m/s left knee is 5.596 V.
- Every speed in problems/STALL.md is now a 20 s row inside stall_walk.py, including 0.08 m/s (falls at 18.16 s) and 0.07 m/s on the high-side corner (falls at 5.24 s).
- The trained-gain case now puts that higher torque into the bus current. It falls at 4.0 s. Knee dips 5.33 V and 5.31 V. It still does not stay up.
