aaltaay/Open_Duck_Mini_v2/altaay_lab/problems/BASELINE_NOTE.md

# The blind baseline: 1 fall and 386, or 0 falls and 383

Checked against the merged run file, not against a second walk. The box is the flush window already in twin/dock/closeup/score.py: 254 mm along the wall and 161 mm deep. Calc only for the box. The counts below are sim pass only.

The merged file twin/dock/blind/blind_runs_b190.json, scored with that box: 540 runs, 0 falls, 528 reached a sit, first sit 380, within 3 sits 383.

That is the merged twin/dock/blind/BLIND_WALK.md, and it is the blind row in the corrected twin/dock/closeup/CLOSEUP.md.

The first close-up history entry, 2026-11-12 4:43 PM ET, wrote 1 fall and 386 within 3 sits. CLOSEUP.md says that count was an earlier copy of the blind file, from before the re-sit heading correction. The 1:25 PM history entry is that correction: first sit stayed 380, within 3 sits became 383, and falls at 190 mm are 0. The backwards heading had given 98 on the old pin test. It is not the 386. The 386 is the flush within-3 count on the pre-correction file, which CLOSEUP.md already names.

So the two rows are two files of one study, not two results that disagree. PR 47's first published row used the earlier file. The same study's 4:50 PM entry rescored the table to the merged file. The merged report and the merged run file agree: 0 falls, first sit 380 of 540, within 3 sits 383 of 540.
