aaltaay/Open_Duck_Mini_v2/altaay_lab/history/2026-11-12_1813_harness_xt30_return.md

# 2026-11-12 6:13 PM ET: XT30 return check uses P-

The harness meter row for the pack socket minus cup said B-. Cable P8 lands on BMS P-, and B- is the cell pad. The protection switch between them is open when the board is off. The pass line is now P- for the minus cup and P+ for the plus cup (cable P6). A reading to B- is not the pass.
