aaltaay/Open_Duck_Mini_v2/altaay_lab/history/2026-11-12_1807_costdown.md

# 2026-11-12 6:07 PM ET: cost-down, servos and the pack

Folder altaay_lab/costdown/. Nothing bought. D61 not edited. The order folder was not in the tree.

The heat rerun calls the existing thermal model on the existing P45B backlash log. At 25 C it again reaches a 60 C reading at 3.33 minutes with torque-off left off, and the body peaks at 94.67 C. That is the same published run, not a measured knee. With the cut on, an STS3250 holding the sim knee RMS still crosses 60 C in a few minutes. The cooler knee-twin currents are the stock policy, which walks badly.

Catalog pages opened tonight do not show a cheaper servo that fits a light joint and the STS bus. XL330 and XL430 miss the peaks or the case. The Hiwonder unit is rated from 9 V. No quasi-direct-drive in the 45 mm case was opened. The only supplier cut on the table is a Waveshare 7.4 V unit in the C001 class, and its backlash was not on the page. Prices at 100 and at 1000 were not printed.

The battery score keeps the two P45B cells. The P50B leads by under one point and was the one in stock. Samsung 50S ties the cell price and has less headroom. The LG M50 sheet is 7.275 A. LiPo and LiFePO4 were not opened as fitting parts. Sodium-ion on the page that was opened is a grid system with deliveries in June 2027, not this can.

No cheaper computer that runs this runtime was opened. No merged board was quoted. The mold starting price does not beat two spools at one duck or at 100. Print mass was already not cut by the topology pass.

verify/c9_docs.py: PASS, 0 FAIL. The warnings are older files.
