aaltaay/Open_Duck_Mini_v2/altaay_lab/history/2026-11-12_1812_heat_peaks.md

# 2026-11-12 6:12 PM ET: heat peaks from the integrator

Codex review on PR 55. The 10 s sample missed the step that crosses 70 C and then falls after torque-off. The cut-on cases now use max_Ts, max_Tb, and max_Tw, and t_cut for the 70 C time. The 60 C time is taken at the 0.5 s step. SERVO.md matches the new run. The log reproduction is unchanged (3.33 minutes, 94.67 C body, cut left off).

verify/c9_docs.py: PASS, 0 FAIL. The warnings are older files.
