aaltaay/Open_Duck_Mini_v2/altaay_lab/history/2026-11-12_1801_redteam.md

# 2026-11-12 6:01 PM ET: red team of the duck and the twin

Labels: the new counts are calc only on seats from sim pass only runs. Nothing ran on hardware. No other folder was edited. D61 was not edited.

- New folder altaay_lab/redteam/. REDTEAM.md is the ranked list. rescore_runs.py reuses nestlib.score_nest and the flush box on the merged blind file and the wall-card file. It matched 35 of 540 and 380 of 540 with 0 mismatches.
- A 100 mm slide of the cloth leaves the card's flush box at 533 of 540 and the seat centre inside 47 mm at 6 of 540 (calc only). The blind flush box stays between 350 and 416 of 540 under the shifts that were tried. The old pin count on those same seats is 2 to 74 of 540.
- Stored minimum wall clearance is negative on 131 of 540. 119 of the 380 flush-box first sits are in that set. 0 of the 35 pin hits are.
- The odds section says what still has to be true. The sheet-stall walk, the camera-field dock, the 7 mm edge, the design-curve hour, and the unwired cell sensor are the existing results this pass ranked. It did not start a new physics run.
