aaltaay/Open_Duck_Mini_v2/altaay_lab/history/2026-11-12_1805_redteam_centre_proxy.md

# 2026-11-12 6:05 PM ET: the card 47 mm count is a seat-centre proxy

Labels: calc only on the stored card seats. The 6:01 PM entry is kept as written.

- A review of the red team note was right. `seat_xy` is the midpoint of the two seat pins, and the pin rule needs only one of them on the sun. A centre outside 47 mm is not a miss.
- Unmoved, 7 of the 501 stored pin hits have centres from 47.36 mm to 53.82 mm (calc only, `altaay_lab/redteam/rescore.json`).
- REDTEAM.md and rescore_runs.py no longer call that column a bound. The shifted card numbers stay centre-distance proxies. The pin-rule shifts stay on the blind file, which stores the four tips.
