aaltaay/Open_Duck_Mini_v2/altaay_lab/history/2026-11-12_1643_closeup_sight.md

# 2026-11-12 4:43 PM ET: keep the nest in view up close

Labels: sim pass only for the run counts. The flush box is calc only. The wide-lens angles are cited from the Camera Module 3 brief. Nothing ran on hardware. Nothing was bought. The cute sit is unchanged. D61, the nest CAD, the camera twin, and the flush study were not edited.

- New folder twin/dock/closeup/. Same 540 seeds and the same walk law as the blind walk-in (PR 45) and the nest sim (PR 42). Report: twin/dock/closeup/CLOSEUP.md.
- Blind camera, published (sim pass only): 1 fall, flush window first sit 380 of 540, within 3 sits 386 of 540. True pose, same walk, flush window 540 of 540 (calc only on the archived seats). The 531 of 540 is the old pin test, not the flush box.
- Head held at -8 deg after the sun is inside 0.75 m (sim pass only): 9 falls, first sit 237 of 540. Worse than the blind walk. The worst measured head pitch is -12.0 deg, inside the -22 deg software stop.
- A 40 mm card on the wall (sim pass only): 1 fall, first sit 533 of 540, within 3 sits 533 of 540. Last fix median 0.146 m. This is the one to use. No electronics. Not on the BOM, so no price. The duck is unchanged.
- Camera Module 3 Wide, not bought (sim pass only): 5 falls, first sit 491 of 540. Last fix median 0.308 m. Lens fit in the head opening is BLOCKER.
- A look down at the start of the turn (sim pass only): 66 falls, first sit 381 of 540. The sun was re-seen in 70 of 540. Worst neck during the look -17.2 deg, 0.2 deg past the software stop, on 6 of 540.
