aaltaay/Open_Duck_Mini_v2/altaay_lab/history/2026-11-12_1650_closeup_baseline_rescore.md

# 2026-11-12 4:50 PM ET: the close-up baseline row matched the merged blind file

Labels: sim pass only. The 4:43 PM entry used the pre-correction blind file (1 fall, 386 within 3 sits). That file was corrected before it merged. This entry does not re-run the 540.

- Re-scored the merged 190 mm run file. Flush window: 0 falls, first sit 380 of 540, within 3 sits 383 of 540. Old pins within 3 sits 43 of 540, not 98. First sit was already 380. twin/dock/closeup/CLOSEUP.md now uses these counts.
- The wall card's 1 fall is new. Seed 211019 (7.2 V, high pose noise, mat friction 0.8) does not fall on the merged baseline. It sits outside the window (first seat 108 mm toward the wall and 481 mm to the side). The card run falls at 27.7 s while standing at the start of the fine moves, before the turn. At 0.72 s the sun is below the field and the card is in it, so that run takes one pose fix the baseline does not. The seed was a miss, not one of the 380. The card turns that miss into a fall.
