aaltaay/Open_Duck_Mini_v2/altaay_lab/history/2026-11-12_0645_blind_walkin.md

# 2026-11-12 6:45 AM ET: blind nest walk-in, camera field then dead reckoning

Labels: sim pass only (MuJoCo 3.17.0, the repo sit model, the stock walk policy). The flush window is
calc only. Nothing ran on hardware. The approved sun distance stays 190 mm. The nest CAD and DECISIONS.md
were not edited.

- New folder twin/dock/blind/. The duck gets a pose only while the sun centre is inside the 66 by 41
  degree camera field. The last fix is at a median 0.58 m (sim pass only). After that it walks at the
  speed measured on those fixes. Report: twin/dock/blind/BLIND_WALK.md.
- At 190 mm, same 540 seeds (sim pass only): 1 fall, first sit charges in 35 of 540, within 3 sits 98 of
  540, first seat inside the flush window 380 of 540. The same walk law with the pose stand-in charged
  at the first sit in 531 of 540 (nest sim v3).
- At 215 mm, study only (sim pass only): 2 falls, first sit 26 of 540, within 3 sits 92 of 540, window
  370 of 540. Not an improvement.
- Integrating the raw command instead of the measured speed stops the duck about 280 mm short: 0 of 540
  charge, 1 of 528 first seats in the window (sim pass only). That file is kept as blind_runs_command.json.
