aaltaay/Open_Duck_Mini_v2/altaay_lab/history/2026-11-12_0648_blind_two_scores.md

# 2026-11-12 6:48 AM ET: the blind walk-in has two scores, and they are not the same test

Labels: sim pass only for the counts. The flush box is calc only. Nothing was re-simulated. The 6:45 AM
entry is kept as written.

- The 35 of 540 is the old nest pin rule: at least one seat pin on the 50 mm sun, at least one bumper pin
  on the ring, no pin on the wrong zone. The 380 of 540 is the seat centre inside the flush box, +/-254 mm
  along the wall and +/-161 mm deep. A seat can pass the box and fail the pins. twin/dock/blind/BLIND_WALK.md
  now says that in the first paragraphs.
- Headline, flush box, 190 mm (sim pass only): first sit 380 of 540, within 3 sits 386 of 540. Old pin
  rule, secondary: 35 and 98. At 215 mm, study only: flush box 370 and 374, old pins 26 and 92.
