aaltaay/Open_Duck_Mini_v2/altaay_lab/history/2026-11-12_0924_shin_eye_pitch.md

# Shin eye safety factors, same mesh

2026-11-12 9:24 AM ET. Follows 2026-11-12_0906_shin_eye_margin.md.

The 0.58 walking safety factor in that entry was the stock eye at a 0.8 mm voxel pitch. It is not the topology number. Re-run at 0.75 mm, the fine end of the pitch band in TOPOLOGY.md, same shin_segment study and the same load scripts: stock walk 0.80 and soft worst 0.47, collar walk 1.30 (FEA pass only). The topology file has 0.79, 0.46, and 1.30. Walk knee peaks are the same under MuJoCo 3.17.0 and 4.0.1. The 2026-11-03 shin number is TetGen on the older plate, 1.56 to 1.63, on a 2.653 kg build. The recessed web in PA6-CF at 0.75 mm, drive sheet modulus 4430 MPa, is walk 2.85, push 2.48, soft worst 1.61 (FEA pass only). The lab printer is not known, so a hardened nozzle and a chamber are BLOCKER.
