aaltaay/Open_Duck_Mini_v2/altaay_lab/history/2026-11-12_0627_twin_checklist_prs_34_43.md

# 2026-11-12 6:27 AM ET: checklist rows after PRs 34 to 43

TWIN_CHECKLIST.md was still the 2026-11-11 wording. PRs 34 to 43 had merged. This pass read those files and rewrote every row's status, result, guess, and next action. The pass line of each row is unchanged. A sim pass only, a calc only, a CAD check only, or an FEA pass only result is evidence. It is not a PASS of the row.

COMPLETE_DUCK_AUDIT.md gained a note at the end. The 2026-11-11 sections and the 4:23 AM note stay as written. The new note lists which of the audit's gaps PRs 36 to 43 cover.

twin/dock/flush/FLUSH_CONTACTS.md already says PR 39 is merged and PR 40 is merged (the study's opening paragraph and section 8). That correction landed with PR 41. This pass did not rewrite it.

No row moved to PASS.

| Row | Before | After |
|---|---|---|
| Structure | FAIL | FAIL |
| Thermal | FAIL | FAIL |
| Electromechanical | FAIL | FAIL |
| Electrical and wiring | FAIL | FAIL |
| Battery | FAIL | FAIL |
| Screws and assembly | GAP | GAP |
| Sit and get-up | FAIL | FAIL |
| Knee | FAIL | FAIL |
| Freeze | GAP | GAP |
| Complete 3D and CAD | GAP | GAP |
| Nest dock | FAIL | FAIL |
| Camera and perception | GAP | GAP |
| Felt and cloth | GAP | GAP |
| Pin contact | NOT RUN | NOT RUN |
| Servo angle limits vs CAD | FAIL | FAIL |
| One-click bill vs the twin | FAIL | FAIL |
| Lights | GAP | GAP |
| Field of view | GAP | FAIL |
| Communications | GAP | FAIL |
| Circuitry | GAP | FAIL |
| Software | GAP | GAP |
| Training | NOT RUN | NOT RUN |

Field of view, communications, and circuitry moved from GAP to FAIL because the files now exist and do not meet the pass line. The cone is on the seat (CAD check only, twin/camera/CAMERA_TWIN.md) and the recorded sit sees none of the cloth. The link table is software/SOFTWARE.md section 11, with several latencies BLOCKER. The MCP73213 board is circuitry/CHARGER_BOARD.md and is not in wiring/netlist.yaml.

Numbers kept as FAILs, with their labels and files:

- Shin drive eye walk safety factor 1.30 against 2, thigh sheets 1.71 (FEA pass only, twin/structure/TOPOLOGY.md). Soft falls under 1.2: roll_to_pitch worst 0.78 (3 of 11), shin 0.87 (3 of 11), thigh 0.94 (2 of 11), neck 0.99 (6 of 11), head 1.03 (2 of 11). The current print STLs are lower: shin eye 0.79, roll_to_pitch 1.43 (FEA pass only). The geometry is not in print/.
- Continuous walk still leaves 60 C inside about 8 minutes (calc only, twin/thermal/KNEE_HEAT_STUDY.md). The 94.7 C body is the published run with torque-off switched off (the hand check matches it, calc only). The 55 C guard is unit tests with no hardware.
- Blind sit has not been run (twin/dock/flush/FLUSH_CONTACTS.md). Nest sim v3 on two 1 mm steps with a 20 mm aim at 7.2 V is 531 of 540 first sit and 0 falls (sim pass only, twin/dock/nest/sim/v3/NEST_SIM_V3.md). The mat is rigid and the pose is a stand-in.
- Sheet-stall walk still falls at 3.46 s to 3.56 s (sim pass only, twin/electromech/ELECTROMECH_TWIN.md). Stock policy still falls in 4 of 5 backlash sessions on the STS3250 model (sim pass only, twin/knee/KNEE_TWIN.md). Get-up still misses 48 of 296 down-ramp front rests (sim pass only, twin/sit/getup/VIA_SIT_EVAL.md).

Gate 0 stays open. The first blockers are still one installed model, a bill that matches it, and a camera, a felt, and a measured pin contact. Training is NOT RUN.
