aaltaay/Open_Duck_Mini_v2/altaay_lab/history/2026-11-11_2226_complete_duck_audit.md

# 2026-11-11 10:26 PM ET: complete duck audit and the nest landing plan

Audit only. No nest files were edited. STATE.md and DECISIONS.md were not edited. No GPU was started.

The walking duck already has one installed model: the print set, the cable map, the fastener schedule, the netlist, and the viewer, checked by verify/. The nest is drawn in twin/dock/nest/ and is not in that model. That is the missing piece of the one model. Gate 0 stays open on other rows the checklist already had (structure, heat, the sheet-stall walk, the bill, the camera, get-up, the knee policy) and on six new rows: lights, field of view, communications, circuitry, software, and training.

New files: COMPLETE_DUCK_AUDIT.md (what exists, the true gaps, the ordered plan, the training range). TWIN_CHECKLIST.md gained those six rows. Lights, field of view, communications, circuitry, and software are GAP. Training is NOT RUN.

The plan's first step is to land the nest (mat, gold disc and ring, spring pins, and the charger wiring that is already dimensioned) into the existing complete3d path, the print set, the netlist, and the bill, after the agent writing twin/dock/nest/ has finished. That step was not started. It is not a docs-only edit, and the nest folder is still being written.

Training scope is in the audit. Runs A to C, and run D if get-up will not fit in run C. Cited hour note 1.5 to 3 hours per 150 to 300 million step command on an RTX 4090, so about 4.5 to 12 GPU hours if three or four such commands are needed. Cited RunPod RTX 4090 rates $0.34 to $0.89 per hour give a rough range of about $2 to $11. That spend needs an OK. The CPU smoke in the knee twin is not a policy.
