aaltaay/Open_Duck_Mini_v2/altaay_lab/history/2026-11-12_0423_flush_pr39_merged.md

# 2026-11-12 4:23 AM ET: the flush study now records that the contact twin is merged

The flush-contact note said the contact twin (PR 39) was open and not merged. That was true when the note was written and is not true now. PR 39 is merged. Its numbers stay the proud nest pins on cloth, and they are still not inputs to the flush grades. The in-body charger board (PR 40) is merged as well, and it is the pack charger, not the per-pin mat switch. altaay-lab was merged into this branch before the docs check. Nothing else in the study changed.
