aaltaay/Open_Duck_Mini_v2/altaay_lab/history/2026-11-11_2327_nest_sim_v3.md

# 2026-11-11 11:27 PM ET: nest sim v3, mixed walk-in, stepped mat edge, wall study

Labels: sim pass only (MuJoCo 3.17.0, the repo sit model, the stock walk policy). One calc-only note on how the
522 guess was added up. Nothing ran on hardware, nothing built, nothing bought. The CAD was not installed.
The approved sun distance stays 190 mm. DECISIONS.md was not edited.

- New folder twin/dock/nest/sim/v3/. Report: sim/v3/NEST_SIM_V3.md. Same 540 seeds as the earlier nest matrices.
- Mixed controller (old steering at 6.0 V, straight crossing at 7.2 V), archived 2 mm step (sim pass only): first
  sit 503 of 540, within 3 sits 526 of 540, 10 falls. The calc-only guess was about 503 and about 522. The re-run
  matched the archived steering runs at 6.0 V and the archived straight-crossing runs at 7.2 V, seed by seed. The
  522 figure added 263 + 259. The within-3 count at 6.0 V is 267, and 267 + 259 = 526 (calc only on those tables).
- Two 1 mm steps, 20 mm apart, with that controller (sim pass only): first sit 524 of 540, within 3 sits 536 of 540,
  0 falls. Worst head-to-wall 33.4 mm, worst foot-to-rim 24.8 mm, 0 runs inside either.
- A 20 mm ramp (sim pass only): 0 falls, first sit 519 of 540, within 3 sits 539 of 540. A little worse than the
  steps on the first sit.
- Aim 20 mm right at 7.2 V on the two steps (sim pass only): 7.2 V first sit 263 of 270, within 3 sits 270 of 270,
  0 falls. With the 6.0 V stepped runs (not re-run, the aim is not used at 6.0 V) that is 531 of 540 and 540 of 540.
  Worst head gap 9.6 mm. A 10 mm aim, on 45 runs, did not change the charge count.
- Study only, sun 215 mm from the wall, two steps, aim 20 mm at 7.2 V, both voltages re-run (sim pass only): first
  sit 531 of 540, within 3 sits 538 of 540, 0 falls, worst head gap 47.4 mm, worst rim gap 34.9 mm, 0 runs inside.
  190 mm is unchanged in cad/nestcad_lib.py and in every design record.
- HANDOVER.md gains a dated section 9. The older sections were not rewritten. twin/dock/nest/README.md indexes the
  new folder.
