aaltaay/Open_Duck_Mini_v2/altaay_lab/history/2026-11-11_2312_camera_cone.md

# 2026-11-11 11:12 PM ET: camera field on the installed head

The standard Camera Module 3 brief was opened (RP-008151-DS-1, June 2024). On the measured head seat the 66 degree axis is up and down and the 41 degree axis is left and right (CAD check only). A level head on the URDF zero pose sees the gold disc and the ring from 1 m and from 2 m, and does not see them at 0.3 m or 0.5 m. The forward stop brings the disc in at 0.3 m and still misses most of the ring. The recorded sit looks away from the cloth. TEST_PLAN.md 20.9 stays NOT RUN: no frames, no light, no pack. Report: twin/camera/CAMERA_TWIN.md.
