aaltaay/Open_Duck_Mini_v2/altaay_lab/history/2026-11-11_2315_e5_stays.md

# 2026-11-11 11:15 PM ET: keep the E5 reflector

D33 reverts D29. The side projector lamp, its reflector, and its lead stay. The earlier proposal to set line E5 to quantity 0 was wrong. PARTS_AUDIT.md and PROPOSED_BOM_CHANGES.md now keep Need 1 and Buy 1. The opened listing is Aurorad S5, in stock, page sizes 20 mm, 15 mm, and a 7 mm hole. The manufacturer part number field on that page is only the word Aurorad.
