aaltaay/Open_Duck_Mini_v2/altaay_lab/history/2026-11-11_2126_p45b_sheet_thermal.md

# 2026-11-11 9:26 PM ET: P45B pack, STS3215 sheet, charger heat

Labels: datasheet numbers are from the P45B sheet version 1.2 and the STS3215 sheet A/1 (2023-06-23), the files PARTS_AUDIT.md already cites. Closed-loop numbers are sim pass only. Charger watts are calc only (D61). The discharge figure was read from the sheet, about 15 mV per point. Nothing was bought. STATE.md was not edited. No decision record was edited. Nothing under twin/dock/nest/ was edited.

What changed from the 2026-11-03 twins:

- The electromechanical and electrical code now use a P45B cell (twin/electromech/p45b.py) instead of only the P30B. Nameplate typical capacity 4500 mAh, discharge cut-off 2.5 V, charge window 0 C to 60 C, DC 15 mOhm at 50 percent SOC. The 1C curve was tracked to 4600 mAh at 2.53 V, and that is the state-of-charge base. Open circuit at full is 4.175 V per cell.
- A servo mode uses the sheet stall, 19.5 kg.cm (1.91 Nm) at 7.4 V, stall current 2.5 A, no-load 0.192 s/60 deg, Kt 7.8 kg.cm/A, idle 21 mA, operating range -20 C to 60 C. Item 7-11 also turns torque off above 70 C. The earlier checklist line that said the 70 C torque-off is not on the sheet was wrong. Damping, friction, armature, and the position gain are not on the sheet and stay marked GUESS.
- On the as-built bus the sheet-stall walk falls at 3.52 s (backlash, typical), 3.46 s (high-side), and 3.56 s (plain). It does not resume a walk. Held at a flat 7.4 V, the same model walks 20 s at 0.64 of the command with no fall (sim pass only).
- The trained actuator on the P45B pack does walk. Full charge, typical: 8.17 V at 5.30 A mean (5.61 A RMS, 10.5 A peak), sag 0.18 V from 8.35 V open circuit. A session reaches an open circuit of 3.30 V per cell at 42.9 minutes with no fall. The walk drops under 85 percent of its full-charge speed at 25.7 minutes. The guard walk stop is at 34.5 minutes typical and 29.5 minutes high-side (sim pass only). That session is not the sheet-stall duck.
- The fall and get-up traces for the electrical replay are not in this repo. That replay was not re-run: BLOCKER. The walk current above is the same network.
- Thermal, docked sit, charger 1.9 to 3.2 W in the trunk for 6 h (sim pass only). Worst cell 42.0 C, inside 0 C to 60 C. Servo readings 26.7 C to 34.7 C, inside -20 C to 60 C. Trunk wall 28.2 C to 37.1 C, under the 49 C to 57 C heat-deflection band. On this model the charger can stay in the duck during a sit. The walk still leaves 60 C at 3.3 minutes (25 C room, central), and the knee body reaches 94.7 C if the torque stays on.

TWIN_CHECKLIST.md rows for thermal, electromechanical, electrical, and battery were updated. None of them is PASS.
