aaltaay/Open_Duck_Mini_v2/altaay_lab/history/2026-11-10_1126_getup_via_sit.md

# 2026-11-10 11:26 AM ET: get-up through the sit (D60) ported to the gym and re-run on the merged sit model

Labels: sim pass only (MuJoCo in the shared lab gym (overlay gym/overlays/duck)), calc only (servo current and duty).
Nothing ran on hardware, nothing bought.

- The search's program (twin/sit/getup/GETUP_VIA_SIT.md, now in the repo with its programs in getup/programs/: chain_v3r,
  hand_I, roll_back3) is a get-up family of the shared lab gym (overlay gym/overlays/duck). The gym builds this repo's
  sit model with twin/sit/sit_model.py and pins it by the model file hashes; the stand-up waypoints come from sitlib.py.
- Re-run of the 296 cases on the merged model (aad3a9a, round-2 stops): 248 of 296, back 156 of 156, side 68 of 68,
  front 24 of 72 (the 48 down-ramp front rests fail at the tuck). The same as the search, case by case (getup/VIA_SIT_EVAL.md,
  getup/via_sit_runs.jsonl).
- Review fix (same day): success is now judged only after the program ends (the 2 s upright and still window
  starts at the home key, any break resets it); the search's evaluator let the window start earlier. No case changes:
  248 of 296 under both rules, on the merged and the search's model.
- Margins unchanged: hip pitch at its torque limit for up to 1.08 s in the sit-up at 6.0 V, no servo over a Feetech
  protection line for 2 s (longest 1.14 s over 80 % duty). Every pose inside the stops (0.30 deg of compliant give at
  most) and the SIT.md section 3 head rule (head at most +16.9 deg while the neck is above +15). TEST_PLAN.md 19.9 has the
  numbers; the bench test stays.
- Gym side fixed on the way: a stored get-up program's family was taken from its file name, so front_final.json (the
  front_roll program) raised ValueError in the knee runs' get-up job.
