aaltaay/Open_Duck_Mini_v2/altaay_lab/history/2026-11-06_2102_v1_sit.md

# 2026-11-06 9:02 PM ET: the alert sit in the CAD (D59) and the feet-contact dock decision (D58)

Job: make the approved alert sit (option A1b) in the real CAD and every record. Ahmed: "Yes it's great!", then "go ahead
and make the changes for the sitting and new angles then"; and on the dock: "Yeah, I think I would like to go with the
feet... It looks natural, and it really makes much, much sense." Labels: CAD check only, calc, sim pass only. Nothing
was bought, printed or built.

What changed (details in twin/sit/SIT.md):
- CAD: joggled shin sheets (9 mm) with a clamp block, a 54.8 mm shin spacer at the back edge, TPU knee bumpers, ankle
  pads, hip pads, seat and belly bumper; thigh sheet and cache reliefs; foot notches with the heel screw moved 20 mm;
  printed stop lugs on roll_to_pitch, the neck sheets and head_pitch_to_yaw. Every hole of every changed part kept.
- Ranges: knee to 150, ankle to -95, hip roll outward -8, hip pitch back -75, neck +25, head -25 deg (hard stops in the
  URDF and MJCF); software 3 deg inside (software/servo_limits.json, bench/set_angle_limits.py); joint zeros
  (software/CALIBRATION.md).
- Records: robot.urdf carries the sit parts on fixed links after the upstream ones (instance indices kept); audit
  assembly and sites, fasteners (20 rows moved, sweep on the new ranges), cables (routes, loops, mounts), print records,
  mass budget (+39.1 g, 2788.1 g), BOM, MOUNTING, viewer data, TEST_PLAN 19, DECISIONS D58 and D59.
- Checks: all six stops touch only at their angle; the sit and stand path and the walk envelope have no new overlap;
  strength passes in service and falls (the neck lug not at a servo stall); sim: 0 falls in 17 pushes, stand-up 20, 18
  and 14 of 20 at 0, 0.5 and 1.0 deg zero error (study 20, 20, 19), walk -3 %.
