aaltaay/Open_Duck_Mini_v2/altaay_lab/history/2026-11-07_0128_v1_sit_review.md

# 2026-11-07 1:28 AM ET: the sit review pass (D59), the get-up decision (D60)

Labels: sim pass only, calc only, CAD check only. Nothing bought, printed or built.

- Codex fixes: stop torque maxima from the moment the torque goes off; the sim case cache keyed on the model files,
  every mesh, the sim code and the run parameters (and the CAD build cache on its code); the reruns before were not
  cache hits (the from-scratch rerun gave the same 20 / 18 / 14).
- Stand-up: every failure was a tip back (CoM 14 to 27 mm from the heel edge on the study path). The path now leans the
  trunk forward in the middle and brings hip roll back to 0 before rising: 20 / 20 / 20 of 20 at 0 / 0.5 / 1.0 deg on
  the tuning seeds, 20 / 20 / 19 on 20 held-out seeds (twin/sit/SIT.md section 5).
- Sit pose: the 14 deg nose-up renders came from a scratch placement at the commanded angles; renders and records now
  take the sim's settled pose (+2.75 deg) and a check fails past 2 deg (sit_pose.py).
- Balance gate (sit_balance.py): PASS, CoM 74.9 mm inside the footprint in the worst case; with the torque off about
  4.3 N forward at the head tips the sit (the neck folds).
- Stops: compliant stops from the stack stiffness in the sim; the stop load runs are not converged in step size, and the
  head and neck stops are below SF 1.5 for a 12 N head shove and a neck stall: BLOCKERs, no CAD change in this pass.
- Fall get-up retest (twin/sit/getup): the stored programs need joint ranges the printed parts cannot reach, on the base
  too; STATE and GAPS notes added. D60 recorded: get-up goes through the sit.
