aaltaay/Open_Duck_Mini_v2/altaay_lab/history/2026-11-10_1014_v1_sit_round2.md

# 2026-11-10 10:14 AM ET: alert sit stop redesign round 2 built and checked (D59)

Labels: CAD check only (parts, sweep, cables, fasteners), calc only (stress), sim pass only (stand-up, push, walk,
balance, pose). Nothing bought or printed.

- Built: the neck block's pads low on the stock sheets' back edges (r 28) with a 4 mm foot behind the pillars, the head
  hook's doubler over the whole arm face with a 10 mm TPU face, the hip roll lug 14 mm wide with a conformal TPU face
  (roll_pad_left, roll_pad_right). Mass 2807.8 g; robot set 49 STLs, 68 parts.
- Stress (twin/sit/sit_stress.json): all 112 rows pass. The three stress BLOCKERs of 2026-11-07 are closed: 0.0 N on the
  block's screws in every case (TEST_PLAN.md 19.8 is a check now), head hook 2.02 and 1.84 against 1.5 at the free 12 N
  forward shove, roll pad 3.83 and lug root 4.90 at service.
- Sims on the round-2 model: stand-up 20/20/20, held-out 20/20/19; push 0 falls; walk 0.1004 against 0.1029 m/s; balance
  PASS (75.6 mm); pose 2.79 deg. Sweep clean.
- Found and fixed on the way: the block's foot sat on the trunk-side neck loops' path (they now go round it, checked on
  the block's mesh); mounts next to a new part were never re-checked (T012, T021 under the block, T037 and T051 under
  foot_top since the first pass: placed again); stored cable run lengths were stale after route edits and range changes
  (check_cables.py takes them from the points now); sit_print.py ran without a date (now required); a fastener whose
  supply note says "not in" a kit showed as in kit in BOM_FULL.
- New BLOCKER from the fresh lengths: the knee kit leads S5 and S10 and the ankle feeds SP4 and SP5 are 17 to 25 mm short
  of the 40 mm slack rule (they fit taut): test fit, or SP4 and SP5 cut 20 mm longer (not changed here).
