aaltaay/Open_Duck_Mini_v2/altaay_lab/history/2026-11-06_0223_v1_dock_full.md

# 2026-11-06 2:23 AM ET: the full charging dock

Job: build the charging dock for Duckie to the robot's standard. Ahmed: "we need to model every component of it including
wires and cables and screws and 3d shape.. etc", and "take your time". Labels: CAD check only, calc only, sim pass only.
Nothing was bought, printed or built.

What changed (details in twin/dock/DOCK_TWIN.md section 12):
- Paddle force: Mill-Max 0933 press-fit pins (2.65 N for six at mid stroke) on two Century CF37CS constant-force springs
  (3.29 N at any travel, 12 to 37 % over mid stroke for a +/- 10 % spring); no PTFE tape. Sim pass only (the shared lab
  gym, overlay gym/overlays/duck, on a scratch copy): hard 17/20, train 16/20, soft 10/20, the same as acc10 within noise.
  The parameter note for the gym is in section 12.1; the gym repo was not edited.
- Holes and grips: spine flange to the base, inserts in the column bottoms and the spine, staggered column splits with 9
  rib bolts, 76 mm rods, the ballast pocket for the 7.9 mm bar; 41 screws, 18 nuts, 20 inserts all OK (dock_fasteners.json).
- Seat: CC-28CS springs, the loaded seat at the sim's 112 mm, a slotted D2F-01L with a flexing finger (the old seat had
  no actuator).
- Every component in 3D (dock_assembly.py, 96 with each spring as a fixed coil and a strip rebuilt per push), every wire routed (18, self-check PASS in seven paddle states, stamped with an input fingerprint C12 recomputes), sheet 7, the gate down to its
  parts with an ERC, the bay with real board mounts and a 5 A PJ-005A jack.
- Charge current 1.0 A (the EV board's PROG via): 4.7 h from empty, 2.6 h from go-home (calc).
- BOM: dock $186.46 need only, $200.40 with spares (K5 price BLOCKER), duck side $83.76 and $88.35; BOM.md DK1, DK5, DK7.
- Checks: E6 has DC1 in its model; C8's mass budget knows the dock, companion and freeze parts (2.749 kg); new C12 for
  the dock; the bench IMU tests skip when the Runtime's adafruit_bno055 is missing (E8).
- Viewer: Duck, Dock and Docked scenes (make_viewer_data.py --scene, viewer/dock_scene.py).
- DECISIONS.md D51 to D56 now quote Ahmed's own words.
