aaltaay/Open_Duck_Mini_v2/altaay_lab/history/2026-11-06_0028_v1_freeze.md

# 2026-11-06 12:28 AM ET V1 freeze pass: drift fixed, touch, speaker duct, ear PWM, cliff ToF, pick-up and the arbiter (D51 to D57)

Labels: CAD check only, calc only, sim pass only. Nothing bought, printed or posted besides the PR. Full write-up:
twin/freeze/FREEZE.md.

- Drift fixed at the cause: the mic seats are in print/head.stl (the viewer and slicer file), the ear mount unchanged;
  C1 (17 FAILs: knee servos, the button, the stale check map, the inline XT30U), C3 (D13 had lost its spans when it was
  copied from P13), E4 (a bounds test that read the D38 tongue and lips as a frame error; washers drawn under left-out
  screws) all PASS; the test order total is $228.49 (STATE.md and START_HERE.md were stale since D34; C9 now reads that
  form); the speaker stand pilots are coaxial, the 20.7 deg was the feat3d fit (as the ear pilots in PR 25).
- Added (Ahmed's approval relayed in the freeze brief, D51 to D56): two MPR121 touch boards and three copper pads,
  the speaker duct with the outer grille ring closed, ears on hardware PWM (the Runtime change waits for Ahmed, D6),
  the VL53L4CD cliff ToF in body_front (165 mm up, 52 deg down, 0x29), the pick-up rule (2 of 3 cues) and one arbiter
  with fixed priority and a 300 ms time-to-live on server commands. D57: no colour eyes for now (Ahmed: "no colour eyes
  for now, keep them simple"); GPIO10 stays free.
- Wires D16 to D22, wiring sheet 6, BOM lines 5b, E9, E10 (build $1,191.50), BOM_FULL, MOUNTING, POWER section 10,
  the mass note (+18.6 g, calc only), re-slice of head, speaker_interface and body_front (body_front now front face down).
- RISK found: D19 runs against the P11 BEC output in the trunk (I2C beside 16 AWG servo power); keep them apart at the
  test fit. BLOCKERs: MPR121 mass and LED current, the Pi 3.3 V pin limit, header pin orders, Ahmed's own words for
  D51 to D55.
