aaltaay/Open_Duck_Mini_v2/altaay_lab/history/2026-11-05_2000_v1_dock_awake.md

# 2026-11-05 8:00 PM ET V1 track 8 phase 3: awake while docked (D50; calc only, sim pass only where said)

Ahmed, 7:32 PM ET: "How long to charge? Can the Ducky stay running for like 8 hours?" 7:33 PM ET: "Since it's a home buddy,
it doesn't need to be small. And since it can charge for like 6 hours at night, that's awesome."
- Pick: a fourth chest contact (SYS) carries the dock's gated 9 V; two ideal diodes (Pololu 5382 for SYS, 5383 on the pack
  side) OR it with the pack at the 2813 input. The dock runs the docked duck; the pack only charges, so the MCP73213's
  termination and timer work. The 2813 OFF is still a full shutdown, the wake pulse stays for it.
- Charge (calc): MCP73213 4.3 h from empty, 2.4 h from 48 %; BQ24610 2.5 h and 1.4 h. With the load on the pack instead, the
  1.1 A charger stops on its 6 h timer at 64 % and the 2 A one floats the cells: rejected. The MCP73213 stays (D45).
- Heat (thermal twin): cells at or under 45 C through every charge at 25 and 32 C with the duck awake; head air at most 44 C
  (central) and 48 C (high corner, 32 C room).
- Changes: BOM DK1 (four strips), DK6, DK7 (+$8.74, build total $1,176.55); MOUNTING rows; twin/dock/duck_side_netlist.yaml
  and dock_netlist.yaml; DOCK_INTERFACE.md v5 now in the repo; DOCK_TWIN.md section 11; D50.
- Open: the merge into wiring/netlist.yaml waits on 3D routes and the sheets (DOCK_TWIN.md BLOCKER 11); a limp hold on the seat
  for hours (BLOCKER 10); the adapter's price.
