aaltaay/Open_Duck_Mini_v2/altaay_lab/history/2026-11-05_1936_v1_companion_d49.md

# V1 track 11: D49, the duck listens all the time (design and plan)

2026-11-05 about 7:40 PM ET (America/New_York). Adds to the D47 and D48 entries of track 11; they are not edited.

Ahmed, 2026-11-05 5:40 PM ET, quoting the D48 line "Walking: it doesn't listen while walking or turning its neck. How
loud the servo noise really is needs a bench test.": "... but thats really not cool, maybe a machine learning that can
figure this out 😕 ??" At 7:22 PM ET: "yes, add it to the design".

Done (design, plan and data protocol only; no software module, nothing bought):
- twin/companion/COMPANION.md section 12: the ego-noise layers (motor-informed estimate after Ito et al. 2005 and Ince
  et al. 2009; RNNoise retrained with the duck's noise; an openWakeWord model of the duck's name; DeepFilterNet on the
  home PC), direction finding with an ego-noise mask before GCC-PHAT, the one-clock sync plan, the data plan
  (380 min, about 9.0 GB raw), the hardware implications (no new parts), a CPU budget (calc only) and the BLOCKERs.
- Live lines that said listening is gated on motion now say: listen always with the ego-noise model; gating is the
  fallback (COMPANION.md sections 6, 10, 11.1, 11.4, 11.6).
- TEST_PLAN.md section 17 (slot check, sync check, capture health, levels, sessions S0 to S8, first numbers).
- DECISIONS.md D49; V1_PLAN.md track 11 line and one anticipated-problems line.
- Sources read in this session: the RNNoise paper (arXiv 1709.08243) and repo files; the openWakeWord README, licence,
  training config and example; Grondin and Michaud 2018 (arXiv 1812.00115); Lagace, Ferland and Grondin 2023 (arXiv
  2303.00829); the kernel doc on ALSA PCM timestamping; the Raspberry Pi Zero 2 W product brief; the HARK licence
  agreement 2.0; the ODAS, DeepFilterNet and SpeexDSP licence files; the LibriSpeech page. Abstracts only (OpenAlex
  records) for the other papers cited.
