aaltaay/Open_Duck_Mini_v2/altaay_lab/history/2026-11-05_1658_v1_companion_hw.md

# V1 track 11: companion hardware (D47)

2026-11-05 about 4:58 PM ET (America/New_York). Branch v1-companion-local, local commit only (not pushed).

Ahmed asked for a companion duck (a Hermes agent off-board, a homebody), a mic, the ear twist, and a duck that looks at
the human when called, eyes unchanged, safety tests skipped. Mid-job the scope became hardware only ("Yeah, maybe we
don't need the software stuff yet. I'm just trying to really cover the hardware."): the software module and the gym sim
written in the first hour were removed before any commit; nothing was committed in the shared lab gym.

Done (twin/companion/COMPANION.md):
- Pick: 2 x Adafruit 3421 (SPH0645LM4H) I2S mics, BOM E8, $13.90; GPIO20 (pin 38) new, clocks shared with the amp;
  googlevoicehat-soundcard overlay (read on GitHub). 2 against 3 and 4 mics, 4 boards compared, non-mic aids compared.
- CAD check only: mic seats in print/head.stl (twin/companion/mic_seat.py, mic_seats.json, stl/head.stl 2.45 MB): PASS.
- Netlist MICL, MICR, cables D14, D15, PI pins 38 and 39; BOM E8 and 17h 28 to 32; fasteners F356 to F359; MOUNTING row;
  viewer placeholders; BOM_FULL and bom.json rebuilt; c1 check made line-aware for a screw spec bought on two lines.
- Checks: c9 PASS, c4a PASS, c4b PASS (no new WARN), c6 PASS, e2 PASS, e4 2 FAIL (both pre-existing), viewer load test
  STATE loaded, ERRORS none; c1 17 FAIL (18 before, all pre-existing). New FAILs: c3 (D14, D15 have no 3D route),
  c10 (sheets not regenerated; the generator already stops at D13).
- BLOCKERs: COMPANION.md section 9.
