aaltaay/Open_Duck_Mini_v2/altaay_lab/history/2026-11-05_0340_v1_dock_phase2.md

# 2026-11-05 3:40 AM ET V1 track 8: the self-charging dock, phase 2 (D43 to D45), sim pass only, calc only, CAD check only

Ahmed, 2026-11-04 11:06 to 11:13 PM ET, via the lead: "go with contacts, use the winner", "go with the P45B cells", "the simplest
solution, the cheapest and the most reliable one, all at once", "assume the heat as well". About 1:30 AM ET on 2026-11-05: "I'm also
all about precision ... what about perception? Why don't we rely on perception as well?"
- Port (software/dock/): osrf/autodock fd9c2a9 (Apache-2.0) with no ROS, the four upstream bugs fixed, a duck layer for the stock
  policy (measured pulse tables, stop-and-look, a right move as turn, walk, turn back), 11 unit tests passing, a replay of tag looks
  recorded in the shared lab gym (overlay gym/overlays/duck). The tables live in duck_autodock.yaml, so track 10's walk can be
  swapped in without a code change.
- Dock (twin/dock/): contacts moved from the belly to the chest (three strips on body_front, the belly is not cut); a sprung,
  swivelling chest paddle (40 mm, 75 N/m, +/- 10 deg) with three spring pins; a 40 mm seat on a spine; a three-tag mast. 15 STLs,
  16 prints, 916 g, 67.0 h; the paddle passes a CAD clearance check over its travel and swivel. Hardware gate with no
  microcontroller (seat microswitch in series, NTC and pin-voltage windows, 555 wake); charger MCP73213 (1.1 A, timer). Read prices
  $66.44 before the BLOCKER lines. Heat: the cells stay at or under 45 C through every charge at 25 and 32 C.
- Acceptance in the gym (20 seeds per floor, bar 19/20 within 3 tries and no fall): **not met.** Best run (acc8) hard 18/20,
  train 16/20, soft 10/20, falls 0, 1, 10. Precision on every docked run is inside the pin window (lateral worst 21 mm, yaw mean
  3.5 deg). The soft floor falls come from the stock policy, which falls on its first back pulse on the soft floor (probe away from
  the dock), and backing is the only way off the dock. Options in DOCK_TWIN.md section 4.6: track 10's walk first; a rigid dock mat
  (needs a ramped edge: a flush one tripped 18 of 20); no retry on soft floors.
- The gym dock course and sim stay uncommitted in the dock job's own gym branch (the lead decides).
- Open: BLOCKERs 1 to 9 in DOCK_TWIN.md section 9 (the real sit stops, camera close focus, Pi frame time, paddle friction and pin
  force, prices, the pack monitor, the soft floor model).
