aaltaay/Open_Duck_Mini_v2/altaay_lab/history/2026-11-05_0350_v1_dock_followup.md

# 2026-11-05 3:50 AM ET V1 track 8 follow-up: D46, the plan rows, the duck-side dock parts in the BOM (calc only, CAD check only)

The lead, after the phase 2 report: merge both sides, labelled "acceptance not met yet (18/16/10 of 20)".
- DECISIONS.md D46 (Ahmed, 2026-11-05 1:29 AM ET, precision, the walk retrain and perception).
- V1_PLAN.md: the track 8 status (phase 2 done, acceptance not met yet, the acc8 numbers and the options) and a new track 10
  row (the walk retrain: recipe merged in the shared lab gym, the run waits on Ahmed's RunPod OK and the key).
- The chest contact strips need no STL change for V1 (an adhesive pad on the flat chest face of body_front, one 4 mm hole
  drilled after printing); they need BOM and MOUNTING rows, now added: BOM.md DK1 to DK5 in Robot (the pad, the Pololu 5382 ideal
  diode, a second FHAC0001ZXJ holder, two 5 A ATO fuses, the cell NTC and wake branch parts), line 29 Need 0.8 m; build total
  $1,155.40 to $1,167.81 (+$12.41; the pad and the small parts are priced BLOCKER); bom.json rebuilt; MOUNTING.md "V1 track 8".
  Open for the 3D track: the seats of the ideal diode and the fuse holder in the trunk, and what is behind the drill spot.
- Correction to the 3:40 AM ET entry: the Pololu 5382 is $3.79 (Pololu listing and blog), not $1.75, so the dock's read prices
  are $68.48 (not $66.44) and $122.58 with the BQ24610EVM (not $120.54); twin/dock/DOCK_TWIN.md section 7 is corrected.
- The gym side is committed on the dock job's gym branch with DOCK.md (the course and the one-command acceptance run, also for
  track 10's policy: dock_sim.py --onnx, --mass v1, --knee, --mode; pulse_tables.py for the new tables).
