aaltaay/Open_Duck_Mini_v2/altaay_lab/history/2026-11-05_0100_v1_battery.md

# 2026-11-05 1:00 AM ET V1 track 9: battery option study and the P45B pack (D44, D45), sim pass only, calc only, CAD check only

Ahmed, 2026-11-04 9:37 PM ET: "I'm really trying to maybe replace the batteries with DCB200. It's a Dewalt. I think for 5 A, we're talking about 500 g, around that. You could do your research and spec", "assume the heat as well". Then 11:09 PM ET (D44): "go with the P45B cells then .. Or are there better batteries out there? .. Okay, cool. Are our batteries swappable?" and 11:13 PM ET (D45): "I think we're good on the swappable battery, but we definitely need to secure the self-charge. ... just go ahead and implement the changes, please. I do really expect the simplest solution, the cheapest and the most reliable one, all at once".
- Study (twin/battery/BATTERY_STUDY.md): the DeWalt 20V MAX family from DeWalt's pages, a DCB200 teardown and retailers (the DCB200 is 3.0 Ah, 624 to 644 g; packs have no cut of their own); seats checked in CAD (top: inside the head; back: centre of mass 32 mm back; belly: the shins hit it at hip yaw and roll ends); live twin sessions, push sets and get-ups in the shared lab gym (overlay gym/overlays/duck) for today's pack, the P45B, a regulated bus, the DCBP034 and the DCB200. The DCB200 duck is 3.24 kg and walks at 0.030 m/s against 0.086; the regulated bus gains 20 % of speed, which a bigger 2S pack also gets in its first 30 minutes.
- Cells: no cell clearly beats the P45B by the D45 rule; the P50B is the in-stock drop-in (same bay). Swap: not pursued (D45); today's swap is about 3 to 4.5 min of screws (calc).
- Dock: CHARGE_INTERFACE.md (written first) for the dock job: 2S, 8.40 V CV, 2.0 A, 3 contacts, 5 to 45 C.
- Implemented (twin/battery/BAY.md): body_back bay grown for the spot-welded 2S1P P45B pack (chamfered, prints without support on the chamfers, 0 overlap, every screw pilot clear); BOM 6 and 7, BOM_FULL E01 and E02, bom.json; mass budget 2.72 kg, centre of mass 1.1 mm back; netlist PACK; MOUNTING; viewer pack geometry. Checks: viewer test STATE loaded, ERRORS none, 0 mismatches; c1, c2, c4 as the base; c9 PASS.
- BOM totals were stale before (line items $1,163.39, docs $1,146.28); re-run: $1,155.40 after D44.
- Open: the pack's strip, sleeve and welding (BLOCKER), cables3d's pack lead start (track 4), the dock NTC seat (dock job), the first print's +y wall.
