aaltaay/Open_Duck_Mini_v2/altaay_lab/history/2026-11-04_2301_v1_sym.md

# 2026-11-04 11:01 PM ET V1 track 2f: uniform screw patterns (D42), CAD check only, calc only

Ahmed's comments of about 10:35 PM ET and 10:45 PM ET (DECISIONS.md D42).
- body_front on its 4 corners (F071 back with its insert, F069 out and its hole closed), the battery lid on all 4 screws (F027 back, its body_back pilot reopened), head_bot_sheet on 4 mirrored corners (F084 and F090 back with their head insert bores, F088 out). Parts rebuilt from the pre-D39 STLs (git 0b1cab5) with the new closed-hole set; the 4 ear seats stay.
- Audit of every screw group (88 parts, 133 part pairs, twin/holes/sym_checks.py): all uniform. Diagonal pairs (Pi, servo adapter, camera, both eyes, speaker stand, speaker interface), the back shell at 6 and the roll motor inner pair checked; each roll_motor_bottom keeps 1 of its 2 (D18 collision, left and right mirror each other).
- Plug caps: the F075 and F076 ear caps left a 6 mm dimple up to 5.4 mm deep on the slanted face. Every cap is now fitted to the part surface (rays, plane to cubic or two faces) and checked: 19 plug ends were off at D39, 6 now (neck_right_sheet 130, a hole at a step, flush in the close-up; flash_light_module 522 to 525, a conical recess stays at one end, OPEN); the ear seat faces on body_middle_bottom are by design, 4 inner ends lie inside the head.
- The dark hole by the F076 ear is the screwdriver access hole of the charger screw F123 (fitted); the viewer draws its head, visible down the hole.
- F1, F2 and rattle: F1 per screw unchanged; body_front F2 unchanged (4 screws); rattle span body_front 98.4 to 90.0 mm, lid 93.7 to 81.4 mm, head_bot_sheet 196.3 to 175.1 mm; back shell F2 down 1.52 at mid.
- Screws 316 to 318, inserts 47 to 48, washers 8. Print set +0.47 g, +0.11 h against D39. Nothing printed or bought.
