aaltaay/Open_Duck_Mini_v2/altaay_lab/history/2026-11-04_2336_v1_sym_followup.md

# 2026-11-04 11:36 PM ET V1 track 2f follow-up: flash_light_module caps, D43 to D45 (CAD check only, calc only)

- flash_light_module: the 4 boss bottoms (holes 435, 436, 527, 528) had a conical cap: the boss bottom sits at the foot of a fillet, so the ring round the hole was not one face and the per-direction fallback made a spike. The cap now follows the face at the hole plus the rise of the fillet just outside it; a plane on the inner rings comes first on small bosses. Flush in the before and after close-ups. body_back, head and speaker_stand caps moved by under 0.05 mm with the same rules; the 4 STLs re-sliced (+0.30 g, +0.14 h for the robot set against D39 in total for D42).
- Flush check, every plug: D39 20 ends off, D42 2 (neck_right_sheet 130, a hole across a step where the servo case sits, flush with the lower face). Viewer test: STATE loaded, ERRORS none, 0 mismatches.
- DECISIONS.md D43 (contacts, the osrf/autodock port from the dock survey, track 8), D44 (DCB200 rejected, 2S1P Molicel P45B 21700 unless the study finds better, track 9), D45 (no tool-free swap, self-charge a must, implement without a further go: simplest, cheapest, most reliable). V1_PLAN.md tracks 8 and 9 rows dated.
