aaltaay/Open_Duck_Mini_v2/altaay_lab/history/2026-11-05_0036_v1_sym_caps.md

# 2026-11-05 12:36 AM ET V1 track 2f follow-up: smooth plug caps (CAD check only, calc only)

- The lead saw a tent on the flash_light_module boss-bottom caps (a peak with creases and an arc at the rim). Measured: the cap rose up to 2.98 mm over the face round the hole, up to 1.06 mm over a smooth fit of the surface round it, with steps of up to 19 deg between its triangles (196 of 998 neighbour pairs over 5 deg): real geometry from the per-direction cap, made worse by a coarse fan.
- Fix (twin/holes/close_holes.py): face plus a thin plate spline of the wall with a C1 blend (1.5 mm) on a fine rim-weighted grid; a spline through the 3 inner rings for other curved rings; caps 0.005 to 0.02 mm under the surface; no bulge past the ring; overlap test as before.
- Checks: every output watertight, same bounds, no overlap with any part; flush D39 20 ends off, D42 2 (neck_right_sheet 130, explained in HOLES_TWIN.md). Seam and triangle step test on 102 visible ends: all within 5 deg except the 4 flash_light_module boss bottoms (12.3 to 13.1 deg, where the part's own fillet steps 45 deg). Close-ups: no peak and no creases; a faint outline of the cap is still visible on close inspection.
- Viewer test: STATE loaded, ERRORS none, 0 mismatches. Every changed STL re-sliced: +0.29 g, +0.13 h for the robot set against D39.
