aaltaay/Open_Duck_Mini_v2/altaay_lab/history/2026-11-04_2212_v1_holes.md

# 2026-11-04 10:12 PM ET V1 track 2e: corners and holes (D39), CAD check only, calc only

Ahmed's comments of 2026-11-04 9:03 PM ET and 9:16 PM ET (DECISIONS.md D39). Corner rule dropped at 9:16 PM ET: the stress checks decide.
- Every round hole of the 36 printed STLs inventoried (531 sites; fasteners.json, empty_holes, sites.json and a mesh scan along off-frame axes). 72 hole stacks with no user closed in 16 STLs (plugs flush, never proud, watertight). Kept holes each have a reason.
- Back shell: the F2 downward case failed at 7 screws (1.06 at the mid fall level). Fixed with 4 printed seats under the lower ears on body_middle_bottom: 1.67 at 7; one more screw (F076) out: 1.52 at 6.
- Left eye keeps the other diagonal (F179, F182) so both bulbs, one mirrored STL, leave the same 2 holes empty.
- Charger stays on 1 screw: the USB-C end is held line to line in the body_back slot (20 N plug, 0.144 N m, 4 N on the slot edge).
- Screws 317 to 316, inserts 48 to 47, washers 8. Print set -6.4 g, -1.22 h. Nothing printed or bought.
