aaltaay/Open_Duck_Mini_v2/altaay_lab/history/2026-11-04_2144_v1_dock_battery_start.md

# V1: Qmini dropped, the self-charging dock and a DeWalt pack study start, closed holes recorded

- Source: the lead, from Ahmed's messages and artifact comments of 2026-11-04 (ET). Nothing was bought, posted or printed.
- D39 (9:03 and 9:16 PM ET, artifact comments): every hole in a printed part that has no screw gets filled, and the stress test decides where a screw goes, with one more pass for screws that can go (track 2e, running).
- D40 (9:37 PM ET): V1 stays on Open Duck Mini v2; Qmini is dropped.
- D41 (9:37 PM ET): the self-charging dock is designed now, with heat checked at every step and full research. At 9:43 PM ET Ahmed asked for wireless (inductive) charging to be studied next to contacts. Track 8, phase 1 (research and design spec) is running.
- Track 9 (9:37 PM ET): a study of a DeWalt 20V MAX pack (DCB200 and its family) against today's 2S P30B pack: specs, mount, power path, protection, charging on the dock, runtime, walk, falls, heat and cost. Phase 1 is running.
- V1_PLAN.md: tracks 8 and 9 added; tracks 3 to 7 still wait for Ahmed's go.
