aaltaay/Open_Duck_Mini_v2/altaay_lab/history/2026-11-04_2113_v1_knee.md

# V1 knee swap: STS3250 knees (D32), phase 1 and phase 2

- Source: worktree branch v1-knee-local (from altaay-lab 5bd28f9, rebased by the lead onto 0b1cab5); work by the V1 knee agent for the lead. Ahmed 2026-11-04 6:18 PM ET: "yes, put STS3250s on both knees" (D32). Nothing was bought, posted or printed.
- Phase 1 (twin/knee/, sim pass only, FEA pass only, calc only): the STS3250 as the twin's BAM C001 scaled by the two Feetech sheets, a low and a high band (the high end calibrated to Robo9's measured heat rise); the live twin, the track 1b push and pack set, the get-ups and the structure twin's load cases re-run with STS3250 knees. Heat fixed (no knee cut, 47 to 63 C, against a cut after 5.5 to 16.4 walking minutes); knee saturation gone; 1b guard 0 trips at 17 A with knee_budget.py; RISK: the stock policy walks a third to two fifths as fast and falls in 4 of 5 backlash sessions with the published torque-speed damping (1.00 against 0.56), so the retrain waits on a bench BAM test of one unit. twin/knee/KNEE_TWIN.md. Gym side: the shared lab gym (overlay gym/overlays/duck), v1_knee/, twin_live option knee, train preset run2_sts3250 (CPU test PASS, every eval finite).
- Phase 2 (this commit): BOM line 1 to 12 C001 and new line 1b, 2 x STS3250-C002 (OpenELAB, $73.99, ships from China, single source; design, not bought): build total $1,146.28 (was $1,036.30). BOM_FULL F07 38 self-tapping plus F07b, 4 M2x6 machine screws for the knee cases (price and thread depth BLOCKER). HARDWARE_AUDIT B70 to B73 (walk on the stock policy, roll_to_pitch, the guard with knee_budget.py, register 21 for the knees only): 30 of 73 cleared or decided. TEST_PLAN 15, the one-unit bench test (7.2 V, register 15, factory registers, bench BAM fit, heat hold, M2 fit). SERVO_UPGRADE_OPTIONS option A taken. STATE, START_HERE and README counts and mass.
- D38 (lead call, D26 option P1): left and right roll_to_pitch at 3 walls (parts.csv wall3+fit), re-sliced with slice.py parts: 24.82 g, 2.31 and 2.33 h each (+3.6 g, +0.22 h). Totals: robot set PLA 1257.7 g and 108.0 h; full print on a 220 bed 1360.4 g PLA and 119.9 h; with the coupons 1407.2 g PLA, 35.1 g TPU, 126.9 h; BOM 27 need 1407 g. The plates were not re-planned (run slice.py plates before slicing for print).
- Mass: 2.70 kg (2699.0 g: 2652.8 g plus 39.0 g for the STS3250 knees and 7.2 g for roll_to_pitch; sim/MASS_BUDGET.md tables not recomputed).
- Viewer data (viewer/make_viewer_data.py, data only; index.html not touched): each servo case node has model (STS3250 on IDs 13 and 23, STS3215 on the other 12), mass_g (74.5 or 55.0, whole servo) and BOM line (1b or 1); labels from the model; the BOM check counts line 1 against the STS3215 nodes and line 1b against the STS3250 nodes. Regenerated into /home/user/v1_out/knee/viewer/ (duck.glb.txt, manifest.json): printed parts 52 / 52, servos 14 / 14, inserts 48 / 48, BOM mismatches none. Headless test with the lead's page: STATE loaded after 4 s, chips 52/52 printed, 14/14 servos, 48/48 inserts, 0 mismatches, 317 screws, 68 cables, 2 test fit; ERRORS none.
- Checks: verify/c9_docs.py PASS (0 FAIL, 10 WARN, all of them older "D1 to Dn" mentions and the screw mass from the older count).
- Not run: slice.py plates and summary (plates not re-planned), sim/mass_budget.py (tables and centre of mass not recomputed), the twins at the new 2.70 kg mass (they ran at 2.65 kg plus the 39 g knee mass).
