aaltaay/Open_Duck_Mini_v2/altaay_lab/history/2026-11-04_2046_v1_screws.md

# V1 screws job: fewer screws, faster build (phase 1 and phase 2)

- Source: worktree branch v1-screws-local (from altaay-lab 5bd28f9, phase 2 on 52d2637); work by the V1 screws agent for the lead; Ahmed's asks of 2026-11-04 6:36 PM ET (screws, magnets, 90 %) and 6:40 PM ET (cable management, a fast human build); D36 (Ahmed) and D38 (lead).
- Phase 1 (twin/screws/, calc only, CAD check only): classes a 75, b 259, c 8 of 342 fitted screws; safe minimum per joint against STRUCTURE_TWIN.md loads; 90 % not reachable (the servo chain is already under the margin); tongue, groove, lips and ribs for the shells; cable operations counted and timed with cited per operation times.
- Phase 2 (2026-11-04 about 8:46 PM ET): fasteners.json 317 fitted, 48 inserts, 8 washers (25 screws LEAVE OUT (D38 screw cut), applied by fasteners/report_fasteners.py; render_fasteners.py and report_fasteners.py now treat any LEAVE OUT status as not fitted); print/ body_front, body_middle_top, body_middle_bottom replaced by the twin/screws/stl versions; BOM.md need counts, lines 22b, 22c, 26b, T16 to T19, 12 Need 2, 10b MB2011LS1W01-BB, totals (robot +$2.21, cables +$15.80, tools +$21.60); MOUNTING.md; sim/MASS_BUDGET.md delta row; wiring/netlist.yaml and wiring/make_harness_build.py (X1, X3a, X4), HARNESS_BUILD.md regenerated; CABLE_MAP.md; viewer/make_viewer_data.py skips the inserts of cut screws (48/48); viewer data regenerated into /home/user/v1_out/screws/viewer (duck.glb.txt, manifest.json); HARDWARE_AUDIT B65 to B69; TEST_PLAN 14; STATE.md, START_HERE.md counts.
- Not run: check_cables.py (no route or cut length changed), render_fasteners.py (PNGs show the earlier set), slice.py (the 3 changed parts and the coupons need a re-slice).
- Time: fastening 0.81 to 0.73 h, cables 5.79 to 5.51 h (cited per operation times; insert, routing and test times BLOCKER).
