aaltaay/Open_Duck_Mini_v2/altaay_lab/history/2026-11-04_1940_v1_complete3d.md

# 2026-11-04 7:40 PM ET: V1 track "everything in 3D" (phases 1 and 2)

Agent of the V1 3D track, for the lead. CAD check only; lengths calc only. Details: altaay_lab/twin/complete3d/COMPLETE3D.md (sections 1 to 9) and TABLES.md.

- Phase 1: inventory of every part, cable and screw against the viewer; camera seat measured on head.stl; D12 as a flat strip needs 227.4 mm, so Ahmed chose the 300 mm cable (D34).
Phase 2 of the V1 3D track, after D34 (300 mm camera cable, the spare in a gentle loop; camera screws M2x5 in pilots drilled
to 4.5 mm) and D33 (head as upstream). CAD check only; lengths calc only. Scripts: phase2_data.py (data and code),
phase2_docs.py (docs), phase2_notes.py (this section and the history file); ribbon_d12.py now designs the 300 mm loop.

- Camera: drawn as its PCB (25 x 24 x 1.0 mm) on the measured boss faces, board centre 3.75 mm toward the lens row (the box
  that poked through the front wall is gone). F344 to F347 are M2x5 "camera to head", 4.0 mm engaged; the pilot drill step is
  print/PRINT_PLAN.md After printing (1/16 in bit, needs Ahmed's OK, $1.98 Walmart or $1.95 Zoro, read via search index).
- D12: the 300 mm flat strip, route 227.3 mm (centre line, no twist), 72.7 mm spare in 1 gentle loop(s): radius 6 mm, legs 29.4 mm, 1.74 mm clear. Check: pass with notes.
  Drawn as a flat band in the viewer. 150 mm and 200 mm stay short (77.4 and 27.4 mm).
- D13 (new, D30): the OFF wire, Pi GPIO26 (pin 37) to the 2813 OFF input, 26 AWG on the P13 route plus the P12 hop and the
  header: zero pose 467.7 mm, worst 542.5 mm, cut 590 mm, check pass with notes. The 2813 OFF pad position is a stand-in (BLOCKER).
- P15 stays the button lead entry (the netlist names it 2813 A and B to the button, D30); its wires still name the 2815 SW
  and GND_SW pads: the 2813 pad names need the Pololu 2813 pinout (BLOCKER, pololu.com not read here). Check: pass with notes.
- D10: fan-out runs fan_PI.35, fan_PI.12, fan_PI.40, fan_J5, fan_JG; check pass with notes. SP1, SP2, SP4, SP5: lead-ins from the SPV and SPG splice bodies (power_splice box) SP1 16.0 mm, SP2 16.0 mm, SP4 16.0 mm, SP5 16.0 mm;
  checks SP1 pass with notes, SP2 pass with notes, SP4 pass with notes, SP5 pass with notes.
- roll_to_pitch: the CAD has 2 pilots per part (F029 to F032): the viewer mount text now says 2 x M2x6 (B63).
- Viewer: head_board ghost not drawn; x-ray switch (printed shells see-through); part and cable labels (labels.json, the page
  hides a label that faces away or would overlap one already shown, so none hides another; LED names kept); camera screw
  labels from the record. Republish from /home/user/v1_out/3d/viewer: index.html, manifest.json, duck.glb.txt.
- Counts after: 48 cables in 68 runs, all drawn; 86 of 118 parts rows seated; both ends at the right part 48 of 48 cables.

Needs Ahmed's OK: the 1/16 in drill bit for the camera pilots (not in the tool lines). Nothing bought.

## 10. Clearance check of the changed cables (2026-11-05)

cables3d/check_cables.py ran on all 48 cables under the RAM wrapper at 7000 MB (peak 4.9 GB; its grid cache needs the
scratch folder to exist). CAD check only. Per changed cable (static tube clearance, rub gap over the joint ranges):
- D10: pass. Its rub against neck_yaw_assembly (0.9 mm, in the committed route) is fixed: fix_rubs.py moved its points,
  gap now +1.0 mm, static 1.02 mm; the 5 fan-out runs clear by 11 to 22 mm.
- P15: pass (0.71 mm, no rub). SP1: pass (0.93 mm, rub gap 8.9 mm). SP2: pass (0.92 mm, rub gap 6.1 mm); their
  16 mm lead-ins to the splice bodies clear by 1.21 mm.
- D12: fail on rub. Static 1.84 mm, but the strip route rubs neck_yaw_assembly by 0.6 mm at head roll 0.35 rad. With the
  neck parts swept over the head ranges, ribbon_d12.py finds no strip route without a twist (d12_ribbon_swept.json, best
  -0.71 mm). Fix: allow one twist (the tube corridor clears the moving parts by 10.9 mm) or another path; TO9 decides.
- D13: fail on rub. Static 1.6 mm; it rubs head_pitch_to_yaw by 1.2 mm at head yaw 0.93 rad, inherited from the P13 neck
  route (P13 rubs 2.3 mm there, already in the committed routing). Pushing points does not clear it: the neck passage of
  P13 and D13 needs a re-route in cables3d/route_cables.py with the rub as a constraint.
- SP4 and SP5: fail, as in the committed routing before this job: the tube enters foot_side by 0.49 mm near the ankle end
  and rubs the knee and ankle parts by 2.1 and 2.2 mm at hip pitch. Not caused by phase 2 (the lead-in is in the trunk);
  local pushes made them worse, so their points are kept as committed. They need the same leg re-route.
