aaltaay/Open_Duck_Mini_v2/altaay_lab/history/2026-11-04_1740_v1_elec_fixes.md

# 2026-11-04 5:40 PM ET: V1 electrical fixes, track 1b (sim pass only, calc only)

By the V1 track 1b agent, a Claude Code agent for the lead (branch claude/v1-elec, local commits; the lead pushes and merges). Ahmed, 2026-11-04 about 5:05 PM ET: "if you see bad signals or bad spikes, we got to fix that, not just detect them. Anticipate any possible problems, please, please, please." This track fixes what track 1 found (twin/electrical/ELECTRICAL_TWIN.md), in the twin, with numbers before and after.

## What was done
- Robot-side code: twin/electrical/fix/bus_budget.py (TargetGuard: the training's target speed clip, then a 10 A servo bus budget; optional FallHold) with test_bus_budget.py (5 tests, 0.33 ms per step). Track 3 runs it inside the real runtime code.
- Gym side (the shared lab gym, overlay gym/overlays/duck, v1_elec/fix_runs.py): track 1's events with each candidate fix, plus a 24-push ladder and a 20 s walk, falls counted. 9 candidates screened, 5 run in full; the pack current through track 1's bus_events.py (408 replays).
- twin/electrical/fix/gnd_fix.py: the data ground with a ground return lead to the head.
- Sources read with curl: the Pololu 2815 page and schematic (0J1071), the Pololu 2813 page, the Tenergy 32175 page (releases, 10 uA consumption), TI BQ2970 data sheet SLUSBU9I, the elinux BCM2835 errata, raspi-config (bookworm aabbd96), plus files already on the box (FTServo STS memory table, the Waveshare adapter schematic, BAM actuator.py, the Pi overlays README).

## Results (details in twin/electrical/ELECTRICAL_TWIN.md, section Track 1b fixes)
- Two twin corrections: the robot runs P 30 on the legs and P 8 on the head (the gym had P 32 everywhere); and track 1's policy-on-the-floor runs let the fall hold back in between policy steps. Corrected, the floor case is the worst: 18.60 A for 4 ms before the fix.
- B47 FIXED (sim pass only): with the target guard, every event stays under 17 A for 4 ms (worst 15.89 A; 13.61 A with the fall hold), 0 trips of a 17 A board in 252 replays; falls and the walk unchanged. A low-pass filter breaks the walk; register 48 at 800 costs 9 % of the walk.
- If the BMS trips anyway: cycle the panel switch ("Cut load"), no charger. $0 fixes for the lead: start_paused true, read-only root, logs on their own partition (B51).
- B49: no $0 fix; the Pololu 2813 with GPIO26 on its OFF input (needs Ahmed's OK, $8.95 plus a button) gives under 10.2 uA off, more than 5 years to 2.5 V.
- B48: bounded at the worst cited class values (TI BQ2970); a ready soft start if TEST_PLAN 3.5 fails.
- Signals: the head roll data ground is 0.075 V at the 40 mOhm limit with the real gains in the same shoves (track 1: 0.527 V), 0.125 V with the floor runs; a ground return lead would take it to 0.018 to 0.028 V, offered as a decision. Bus edges: U3 drives every rising edge. The BNO055: software I2C by default (B52).
- Also found: the stock policy at our mass topples from 15 N, 0.1 s pushes forward or back while standing (for the lead).

## Changed
twin/electrical/ELECTRICAL_TWIN.md (new section), twin/electrical/fix/ (new), twin/electrical/out/fix_summary.json (new), HARDWARE_AUDIT.md (B47 to B49 dated lines, B50 to B52, totals), TEST_PLAN.md (3.3, 3.5, 8, 9, 10.1, 11), STATE.md (own lines), START_HERE.md and BOM.md (the blocker count only).
