aaltaay/Open_Duck_Mini_v2/altaay_lab/history/2026-11-04_1647_v1_electrical.md

# 2026-11-04 4:47 PM ET: V1 electrical twin (sim pass only, calc only)

By the V1 electrical track, a Claude Code agent for the lead (branch claude/v1-elec, local commits; the lead pushes and merges). Ahmed's request of 2026-11-04 about 4:08 PM ET: a true digital twin of the V1 duck (stock, walking, indoors, our 2652.8 g build), so nothing surprises us when printing starts. Ahmed's guidance mid-task: only this track runs; go deep only on the BMS against power-on and the summed peaks, regeneration and over-voltage, and the servo bus ground; one line for the rest; lean output.

## What was done
- New twin folder twin/electrical: bus_events.py replays 1 ms torque and speed traces of falls, get-ups and the walk through the as-built power network (twin/electromech/power_net.py, the P30B pack, both corners, the TEST_PLAN 5 hop bands). It reports the pack current against the Tenergy 32175 band, the signed servo bus power, and the data ground offset of every servo against the adapter ground. bus_tables.py writes out/summary.json; ELECTRICAL_TWIN.md is the result.
- Fall traces came from a new runner in the shared lab gym (overlay gym/overlays/duck, v1_elec/fall_traces.py): the get-up library's falls on the collision duck at 7.2 V, with the fall stop, with the policy running on after the fall (the stock Runtime), and with 5 more seeds of the side cases. 38 falls, plus the get-up twin's 1 ms logs of its 3 programs and the walk: 180 network runs.
- Sources read again 2026-11-04 with curl: the Tenergy 32175 page (over-current 22 +/- 5 A after 8 +/- 4 ms, release "Cut load", short-circuit protection with no numbers), the Pololu 2815 page and schematic (100 kOhm gate resistor, 40 V absolute max, 90 A max), the Waveshare adapter schematic (U3 SN74LVC1G126 drives low, enabled while TX is low; R5 10 kOhm pull-up; U4 SN74LVC1G125 receives) and the TI SN74LVC1G125 data sheet (VIH 2.0 V, VIL 0.8 V at 3.0 to 3.6 V).

## Results (details in twin/electrical/ELECTRICAL_TWIN.md)
- RISK, BMS: a 60 N shove to the left of the standing duck draws 19.5 to 20.6 A from the pack, over 17 A for 4 to 13 ms (6 of 6 seeds), during the policy's own recovery, before the fall is detected. A board that trips at 20 A or more trips in 0 of 41 events. TEST_PLAN 3.3 gets a 21 A pass line (B47).
- RISK, shutdown: after the guard's battery poweroff the duck still draws 0.11 to 0.41 A with the panel switch on, about 1.2 to 4.4 hours to the P30B 2.5 V minimum (calc only). TEST_PLAN 11 gets the switch-off rule and a measurement (B49).
- BLOCKER: the BMS short-circuit function at power-on (B48, TEST_PLAN 3.5).
- OK: no net regeneration in walking or falls; the data ground offset stays under the adapter's 0.8 V VIL wherever the TEST_PLAN 5 hop gate holds; the 5 V rail and the protection chain hold the worst events.

## Docs changed
STATE.md (last updated, Done, Numbers now, Blockers), HARDWARE_AUDIT.md section 6 (B47 to B49, totals), START_HERE.md (counts), TEST_PLAN.md (updates line, 3.3 pass line, new 3.5, 11), BOM.md (blocker section). No decision is open for Ahmed from this track; a second BMS board would need his OK only if the bench board trips under 21 A.
