aaltaay/Open_Duck_Mini_v2/altaay_lab/history/2026-11-04_1621_v1_plan.md

# 2026-11-04 4:21 PM ET: V1 plan

Ahmed asked for V1: the walking duck on legs, no wheels, no human pace, with a true digital twin of electronics, cables, joint motion, power, heat and vibration, and every part accounted for, before anything is printed. He then asked to save tokens, to demand serious outcomes from each job, to run the jobs one by one, and to have a plan in case the work does not finish today.

Done: V1_PLAN.md lists six tracks in order, the question each must answer and the rule that each finished track is merged the same day. Track 1 (electrical) runs as the pilot; the other five wait for Ahmed to see its result. Nothing printed, nothing bought.
