aaltaay/Open_Duck_Mini_v2/altaay_lab/history/2026-11-03_2257_twin_wave2_integration.md

# Twin integration, wave 2 (live twin, get-up, walking speed, human pace and wheels, GPU retrain stage 0): the wave 2 results in the living docs, every number checked against its source file, full verification 22 of 22 PASS (sim pass only)

- When: 2026-11-03 10:57 PM (America/New_York); work from about 10:28 PM
- Source: working tree of the local branch claude/twin-wave2, made from altaay-lab at b37047f (the lead commits); work by the twin wave 2 integration sub-agent for the lead
- Written: 2026-11-03 by the Claude Code agent

- Sources: the shared lab gym (overlay gym/overlays/duck): twin_live/TWIN_LIVE.md, getup/GETUP.md, speed/SPEED.md, human_pace/HARDWARE_OPTIONS.md, wheels/WHEELS.md and train/TRAIN.md, read only; the lead's proposed texts; in this repo twin/thermal/THERMAL_TWIN.md (source R3) and SERVO_UPGRADE_OPTIONS.md (the C001 data sheet line, 19.5 kg.cm = 1.91 Nm at 7.4 V). Every number was checked against those files before use. The B7 heights were also checked with MuJoCo 3.17.0 on the Playground MJCF at b9be205 (every joint at 0: hip pitch and hip roll 196.1 mm, hip yaw 242.2 mm above the lowest sole point; home key: hip pitch 161.9 mm; model geometry, sim pass only).
- STATE.md: the update line; Done: get-up after falls (scripted, sim pass only) and the GPU retrain stage 0 (ready and tested on CPU, not run); Numbers now: the live twin (after the twin line), walking speed, human pace on legs (model bounds) and human pace on wheels; Blockers: the sim servo may be stronger than the real one (BAM 3.23 Nm against the 1.91 Nm data sheet stall, upstream issue 48 in UPSTREAM_ISSUES.md G1), and one line with the BLOCKERs of wave 2 that HARDWARE_AUDIT.md does not number yet, so the counts stay 22 of 46; the verification line of this run; open questions: 1 (the GPU time approved, capped at $20, waiting for the RunPod key) and a new 6 (keep developing the heel-wheel version in sim?).
- TEST_PLAN.md: section 9, the temperature bullet: the sentence "Twin, central, full pack ..." (the wording was as the proposal said) is now the live twin's prediction, with the note that walk_with_guard.py itself ends the walk at its stop (the rest and the walk again at 45 C are the heat twin's rule, added in the twin); 7.3 item 3: a log of how the servo releases its 70 C cut (registers 40, 63, 65 and 69 every 0.2 s for 2 minutes, on a spare unit or skipped); a dated entry in the update list. No gate or pass line changed.
- GAPS.md: a dated note under B6 (get-up scripted in sim, 174 of 174 back and side runs, 16 of 18 flat-floor front runs, 6 of 36 on down ramps; the real joint stops a BLOCKER) and under B7 (196.1 mm, not about 220 mm; 157 to 160 mm in the crouch with the soles laid flat, not about 150 mm; so the rise is about 100 % of the straight leg and 123 to 125 % of the walking hip height, and the exemption reason stands). The old text is unchanged.
- START_HERE.md: the update line, and the open decisions 1 (approved, waiting for the key) and 6 (the heel-wheel question), the same status as STATE.md.
- Mismatches, settled with the file's value: the human pace text said 1.3 m/s is "Froude above 1 on the 196 mm leg": it is Froude 1.08 on the 160 mm crouch hip height and 0.88 on the 196 mm straight leg (HARDWARE_OPTIONS.md section 3.2; written so). 7.3 said the duck falls "1 to 115 s" after the first cut: TWIN_LIVE.md says 0.8 to 115 s. The live twin line said walk, servos, power path, pack and heat are "solved together every 1 ms": the heat runs in 0.5 s steps (written so); its guarded rests stand with torque on (TWIN_LIVE.md section 2; said so, next to the torque-off lever), and rounded figures are written as the file gives them (held cold 9.1 and 4.7 minutes, the backlash 50/50 fall at 11.9 walking minutes, the torque-off lever 19.1 and 15.4 minutes). Walking speed: "about 0.10 m/s" today is 0.097 m/s with the servo model at 7.4 V and 0.091 m/s at 7.2 V; the knee cut at 0.36 m/s is 3.7 minutes, not "about 4"; the 0.36 m/s (7.2 V) and 0.34 m/s (6.0 V) walks are two gaits, each searched at its voltage, not one gait; "one leg's servos" at the limit is written "the most loaded servos" (at 7.2 V the left hip pitch and the right knee lead); the exact-plan bound of 0.12 and 0.10 m/s holds on a 0.12 m stance only (on the upstream 0.16 m stance nothing fits), now said. Get-up: "gets up by itself" is "from most falls, not yet from falls that end head down on a down ramp" (GETUP.md answer); "at most 44 %" is at 7.2 V (53 % at 6.0 V); "real gym falls" is written falls in gym runs; the front totals (22 of 54 for our build, 25 of 54 at the trained mass) are added. B6 note: the "16 of 18 flat-floor front falls" are runs; "(6 of 36)" is written 6 of 36 runs get up; the proposal tied the joint stop BLOCKER to a check on printed parts; it is written "BLOCKER until the real joint stops are known" (nothing is printed until the twin is done); "expect it to be sensitive to the floor and the mass" is replaced by the file's finding (in sim the throw is what fails on slopes, on slippery floors and at the lighter trained mass). Wheels: "roots, rocks and logs fail" is, in the WHEELS.md table, roots, rocks, 51 mm steps and 51 mm water bars; "thresholds at 0.6 m/s" is 13 to 25 mm at 0.6 m/s and not at 1.3 m/s on the 12 V boost; "park gravel" is written 10 mm gravel and loose pebbles; the 58 to 94 minutes are at 1.3 m/s on pavement; "0 falls" is 0 in 3 runs (0.086 against 0.096 m/s); the motor BLOCKER also has no official data sheet read and a backordered US listing. Human pace on legs: "same-size bus servos reach about 0.2 to 0.45 m/s" is the best two (C044 at 7.2 V, STS3250 at 12 V) with a retrain, a model bound with an 80 % torque margin (said, so it does not read against the 0.36 m/s closed-loop gait, which runs at the limit). GPU line: "gym-like physics" is the gym's contact physics at 2 ms (it matches 1 ms in the CPU check); "heat is the next limit" is written in the file's words (above 0.2 m/s every gait shown runs at the servos' limit and cuts the knee within 4 to 7 minutes). Dates: SPEED.md is dated 2026-11-04 in UTC, and WHEELS.md and TRAIN.md say "2026-11-04 (US Eastern)", but the work ran on 2026-11-03 Eastern (their own UTC times; it was still 2026-11-03 ET at this integration): dated 2026-11-03. B7: the proposal said B7 gives "220 mm"; B7 says "about 220 mm"; its "about 150 mm", "90 %", "130 %" and "104 mm foot" are corrected in the same note. The GPU approval (2026-11-03, capped at $20) is in no file read except the lead's texts: written as the lead's record, and DECISIONS.md does not carry Ahmed's words yet.
- Left out: HARDWARE_AUDIT.md section 6 is outside this job's files, so the BLOCKERs of wave 2 have no B number yet (the counts stay 22 of 46, and C9 does not see them); STATE.md names them in one line. DECISIONS.md: Ahmed's words for the GPU approval. STATE.md Next 6 and START_HERE.md next step 7 still say get-up and dock come later, in sim first (outside the sections this job edits). The 7.3 pass line is unchanged; in the live twin its proposed first session (50/50 at a 32 C room) fails the 10 C margin without the guard (plain peak 66 C, the backlash model falls) and peaks at 55 C with it (sim pass only): for the 7.3 owner. The live twin ran the central heat set only. Its proposed changes to the overlay's own files, and the FOLDERS.md and LESSONS.md lines of the wave 2 files, belong to the lab repo, not this one.
- Verification: run_all.sh, full run 10:42 to 10:53 PM ET (VERIFY_OUT in the agent's scratch folder, ODM_TEST_PYTHON as before), alone on the box: 22 checks, 22 PASS, 0 FAIL, 0 NOT RUN; 0 FAIL and 21 WARN findings (C3 4, C4b 5, C7 3, C9 4, C11 1, E6 1, E6b 1, E7 2), the same as the 5:01 PM run, with the same WARN texts except that C9's WARN on the dated decision range in GAPS.md now points at line 67 (the two new notes sit above it; it was line 65); E8 63 tests pass; C9 sees 46 blockers (22 cleared or decided, 5 test print, 13 assembly or bench, 5 waiting on parts; B45 in none) and 0 disagreements, and again at 10:57 PM ET on the final docs (a first wording of the STATE.md verification line quoted that decision range and drew a fifth C9 WARN; reworded, back to 4). run_all.sh rewrote VERIFICATION.md; the result did not change, so the committed page was put back as it was (the 2026-11-02 page plus the C8 note); it still names GAPS.md line 65 for that WARN and 35 blocker rows in its C9 summary, and report.py now writes the C8 note into the run notes itself.
- Nothing bought, sent, printed, committed or deleted.
