aaltaay/Open_Duck_Mini_v2/altaay_lab/history/2026-11-03_1601_twin_integration.md

# Twin integration, wave 1 (power and heat) plus the gym port: twin results in the living docs, every number checked against the twin files, full verification 22 of 22 PASS (sim pass only)

- When: 2026-11-03 4:01 PM (America/New_York); work from about 3:10 PM
- Source: working tree of branch claude/digital-twin after commit d724026 (the lead commits); work by the twin integration sub-agent for the lead
- Written: 2026-11-03 by the Claude Code agent

- Sources: twin/electromech (ELECTROMECH_TWIN.md, out/*.json, out/session_*.csv), twin/thermal (THERMAL_TWIN.md section 7, tables.md, results_summary.json, to1_predict.json), the two twin agents' proposed texts, and history/2026-11-03_1524_duck_gym_overlay.md for the shared lab gym (overlay gym/overlays/duck). Every number was checked against those files before use; the gym numbers also against the gym run's own results.
- TEST_PLAN.md: 4.1 heat log and efficiency, twin predictions for the 60 C gate (passes at 92 %, fails at 85 and 80 %) and for the dropout (0.752 / 0.706 / 0.663 of the command at 0.10 / 0.30 / 0.60 V); 4.2 heat log and the twin prediction (50 to 59 C, so the 50 C gate is expected to fail); 5 the closed-loop hop line (under 1 % of speed from 28 to 40 mOhm; the open-loop numbers stay the gate); 7.3 replaced (0.9 A to settle, 1.2 A to 60 C, no 1.5 A hold; pass: the re-run twin keeps every knee 10 C under the cut through a full charge of the first session); new 7.5 (does the firmware compensate for its bus volts); 9 the 9.speed sentence reconciled (the sim/POWER_FIX.md option 7 numbers are labelled as the older 2.77 kg run, the twin's are the current prediction), a twin prediction bullet and a temperature bullet; 11 the twin's session times. The existing gates are unchanged; the twin numbers are predictions; the one new pass line is 7.3.
- No fall claims now say "in the duck's training physics" (2 ms Euler, Newton with 1 iteration, pyramidal cone, floor friction 0.6), with the gym result next to them: in the gym's frozen floor profile (1 ms, implicitfast, elliptic cone with impratio 5, floor friction 1.0) our build falls in the 15 N push series in 6 of 6 seeds with no supply sag (five at 13.7 s, one at 19.7 s), and each single physics change alone makes it fall (13.7 to 13.9 s). The push result is marginal, not a margin. The real floor friction is a new BLOCKER (B41).
- STATE.md: Done (the two twins and the gym port), Numbers now (twin speeds and knee dips, knee time to the cut, terrain), Blockers (counts and the twin and gym BLOCKERs). Terrain in the gym (sim pass only): flat ground only; every up ramp fails (0 of 40), the down ramps from 10 deg (0 of 30), the 13 mm threshold and the 50 mm bump (0 of 10 each); our build trips on a 3 mm edge (0 of 5; median swing peak 9.7 to 10.0 mm against 12.7 to 13.8 mm at the trained mass); low friction and the friction patches pass (one fall of our build at a 3 mm patch edge), ice 3 of 5, a walk to the dock target 10 of 10 (no docking scored). Terrain needs a policy trained on terrain: a training job.
- HARDWARE_AUDIT.md section 6: B36 to B41 (all six numbers were free): B36 to B38 are the thermal twin's rows, B37 now also holds the BEC dropout and minimum input; B39 the servo firmware response to its bus volts; B40 the Pi chip rise; B41 the real floor friction. Totals: 22 of 41 cleared or decided, 3 waiting on the parts check (B38 joins B8 and B33), 5 coupon, 11 assembly or bench. GAPS.md is a gap list, not the BLOCKER list, so it is unchanged. START_HERE.md and BOM.md carry the same blocker counts (BOM.md "all 41", the line VERIFICATION.md C9 compares).
- New dated notes, old text unchanged: DECISIONS.md D2 note (the TO1 hold and pass rule); SERVO_UPGRADE_OPTIONS.md option A caution on the STS3250 (a caution, not a decision; buying needs Ahmed's OK); POWER.md section 8 pointer (its dips are open loop); sim/ADDED_MASS_SIM.md gym note (side step 0.24 to 0.48 at 1 ms, the push result marginal, the soles 12.4 to 16.9 mm inside the floor at the home key, not 10.7 mm: checked again with MuJoCo 3.17.0 on the Playground scene at b9be205); VERIFICATION.md C8 note (by hand: report.py does not write it, so the next full run drops it).
- Issue #48 tracking (ELECTROMECH_TWIN.md BLOCKER 4): upstream issue #48, UPSTREAM_ISSUES.md G1, real leg servos under-track the walk (hip pitch, knee and ankle 31 to 49 % in the partly read thread); our question is posted there with no maintainer reply seen (DECISIONS.md D1). Cited in STATE.md.
- Mismatches, settled with the file's value: the firmware compensation line said 79 to 95 % of the trained speed (79 % is the two-seed state mean; the sweep pair is 0.706 to 0.859 of the command, written so); "about half charge" for the drop under 85 % (the plain walk drops at SOC 66 %: written SOC 48 to 66 %); "the hard stop comes only in the high-side corner" (only three sessions ran: written "of these three sessions"); "passes only at about 92 % or better" (to1_predict.json has 92, 85 and 80 % only); "the BMS above 50 C" (49 to 60 C); the electronics temperatures are at the battery stop (said so); "about 2.8 ohm" (the twin spans 2.63 to 2.93 ohm); 4.2 "50 to 59 C" (central 55 C, low corner 49.7 C); the gym push falls (five at 13.68 to 13.72 s, the sixth at 19.74 s) and the friction patches (our build 4 of 5).
- Left out: the thermal twin's section 9 pass line (no servo over 60 C, BNO055 under 45 C: a new gate; the central 50/50 at 25 C peaks at 61 C) and its times to the 55 C warn (5, 3 and 11 minutes: in no committed twin file, so not citable; they match the twin's own scratch traces). bench/first_servo_check.py still runs the old 7.3 hold and gate, and the bench scripts do not log the BNO055 or Pi temperatures (both said in TEST_PLAN; their owner's job).
- Verification: run_all.sh, full run 3:47 to 3:59 PM ET (VERIFY_OUT in the agent's scratch folder, ODM_TEST_PYTHON as before): 22 checks, 22 PASS, 0 FAIL, 0 NOT RUN; 0 FAIL and 21 WARN findings (C3 4, C4b 5, C7 3, C9 4, C11 1, E6 1, E6b 1, E7 2), the same as 2026-11-02, with the same WARN texts; E8 63 tests pass; C9 sees 41 blockers and 0 disagreements, and again at 4:00 PM ET on the final docs. The result did not change, so VERIFICATION.md stays the 2026-11-02 page plus the C8 note.
- Nothing bought, sent, printed, committed or deleted.
