aaltaay/Open_Duck_Mini_v2/altaay_lab/history/2026-11-03_1716_twin_structure_integration.md

# Structure twin integration, wave 1: the structure twin's results in the living docs, every number checked against its files, full verification 22 of 22 PASS (sim pass only, FEA pass only)

- When: 2026-11-03 5:16 PM (America/New_York); work from about 4:45 PM
- Source: working tree of branch claude/digital-twin from commit d5b4b9f; the lead's snapshot commit ff939e7 (about 5:04 PM ET) holds the doc edits below (the lead commits); work by the structure twin integration sub-agent for the lead
- Written: 2026-11-03 by the Claude Code agent

- Sources: twin/structure/STRUCTURE_TWIN.md and tables.md, history/2026-11-03_1640_twin_structure.md, the structure twin agent's proposed texts, fasteners/fasteners.json and print/parts.csv (the proof load set-up and the spares), print/config and print/slice.py (the heavy set is 3 walls 15 % plus the parts.csv heavy override) and history/2026-11-03_1524_duck_gym_overlay.md (the training numerics). Every number was checked against those files before use.
- HARDWARE_AUDIT.md section 6: B42 to B46 (all five numbers were free): B42 roll_to_pitch and B43 the knee sheet eye, under the walking margin of 2 (FEA pass only); B44 fatigue life (a bench rig, not in the lab); B45 falls on a hard floor, status DECIDE (for Ahmed, later: the floor of the first walks; a proposal, not decided); B46 fastener data not published. A dated structure twin note on B38 (PLA at 50 C, creep, PETG). Totals: 22 of 46 cleared or decided, 5 waiting on the parts check (B42 and B43 join B8, B33 and B38), 5 settled by the coupon test prints, 13 assembly or bench checks (B44 and B46 join), 1 for Ahmed to decide later (B45; C9 counts it in none of its groups). START_HERE.md, STATE.md and BOM.md ("all 46", the line C9 compares) carry the same counts.
- print/PRINT_PLAN.md: step 2 check 7, the proof loads: (a) the spare knee_to_ankle_left_sheet at 8.6 N m (4.4 kg at 200 mm), (b) a spare roll_to_pitch at 130 N (13.3 kg), only if one is printed (P6); the step 1 C2aL row gets a record-only 20 kg hang (196 N, against 189 N, the largest fall pull on a leg_spacer insert). A dated line in its header.
- TEST_PLAN.md section 9: a new first bullet, floor and falls: a soft floor with a tether, proposed for Ahmed (B45); a look at the weak parts after any fall, and after every walking session until the fatigue life is known (B44). No new pass line; a dated line in its update list.
- sim/ADDED_MASS_SIM.md: a new dated note under Pushes (with converged contact forces our 2.65 kg build falls in 4 of 4 runs of the 15 N push case, with 1 iteration in none). The gym note of earlier today is unchanged.
- DECISIONS.md: D26, an open question for Ahmed in the form of D1 to D7 (options (a) to (e), before the right leg prints), and a new dated status line; not decided. C9 counts decisions by the "- Dnn" lines, so it still reads D25 as the last and the "D1 to D25" lines stay right.
- STATE.md: a Done line and a structure line (Numbers now), the blocker counts and the update line. START_HERE.md: the blocker counts and the update line.
- Mismatches, settled with the file's value: B43 said the same eye on the thigh "holds 2.70 / 1.74" (1.74 in push is under 2, W4: written "holds 2.70 walking but 1.74 in push"). B45 gave the contact levels as "0.3" and "3 MN/m" (the file's levels are ranges, 0.14 to 0.34 and 1.35 to 3.2 MN/m), roll_to_pitch in "7 of 10" falls (7 to 8 over mesh levels 1 to 3), and the shells at "31 to 115 MPa ... under the 1.2 fall margin" (31 to 115 MPa is the body shell, the head is 25 to 90 MPa, against 47.1 MPa: written as the two ranges). B46 and the STATE line said "the ankle case screws 1.6" (the left ankle; the right is 3.1), and B46 "no published data" (none was found). Check 7 (a) said "the 4 case screws" (fasteners.json: the knee_to_ankle_left_sheet carries 2 M2x5 of the ankle case's 4; the other 2 pass the right sheet), and the spare sheet is on step 3 plate P220-12 (P256-11) with the right leg's sheets, which check 7 now says. The ADDED_MASS_SIM note: the single-push counts per direction (2, 4, 1 and 3 of 8) are in no committed twin file (written 1 to 4 of 8, the file's range); "2.6 x the converged peak" is only in a code comment of st_loads.py (left out); "Training used MJX with 1 iteration" (MJX is in no twin file; history/2026-11-03_1524_duck_gym_overlay.md says the policy was trained with the 2 ms, 1 iteration numerics: cited so); the gym is named as the shared lab gym (overlay gym/overlays/duck). TEST_PLAN 9 said "for the first 3 hours ... every 30 minutes" (in no twin file: written "after every walking session, until B44 is closed"), and the soft floor is written as a proposal (B45 is DECIDE). D26 said "keep as printed" (nothing is printed: "keep the D22 profile") and "PETG for the parts at the servo cases" (P5 is the knee sheets and roll_to_pitch). The STATE line said "SF 1.5 to 1.6", "1.6", "about 1.1 in push" and "falls on a hard floor break printed parts" (written 1.48 to 1.63, 1.63, 1.08 to 1.21 and 1.07, and under the 1.2 fall margin). The mesh level 1 baselines (1.60 / 1.11 and 1.56 / 1.04) now stand next to the level 1 values of P1 and P3.
- Status words: B44 and B46 name a bench test ("bench fatigue test", the file's words, and "coupon and bench tests"), so C9 counts them as bench checks; the proposed "needs a fatigue rig" and "coupon tests" would have put them under waiting on the parts check.
- Left out: D26 is not in the open-question lists of STATE.md and START_HERE.md, and STATE.md's verification lines still name the 3:47 PM run (outside this job's edit list). B45 has no D number (a question for Ahmed later). Proof load (a) needs a spare knee sheet before plate P220-12; no plate was changed. GAPS.md is a gap list, so it is unchanged. The twin files have no typo to report.
- Verification: run_all.sh, full run 5:01 to 5:14 PM ET (VERIFY_OUT in the agent's scratch folder, ODM_TEST_PYTHON as before): 22 checks, 22 PASS, 0 FAIL, 0 NOT RUN; 0 FAIL and 21 WARN findings (C3 4, C4b 5, C7 3, C9 4, C11 1, E6 1, E6b 1, E7 2), the same as the 3:47 PM run, with the same WARN texts; E8 63 tests pass; C9 sees 46 blockers (22 cleared or decided, 5 test print, 13 assembly or bench, 5 waiting on parts; B45 in none) and 0 disagreements, and again at 5:17 PM ET on the final docs. run_all.sh rewrote VERIFICATION.md; the result did not change, so the committed page was put back as it was (the 2026-11-02 page plus the C8 note).
- Nothing bought, sent, printed, committed or deleted.
