aaltaay/Open_Duck_Mini_v2/altaay_lab/history/2026-11-02_0213_eye_stack_coupon_sleeves_kit_counts.md

# Eye screw stack coupon, two eye washers in 3D, every heat shrink sleeve counted and drawn, kit counts in C4

- When: 2026-11-02 2:13 AM (America/New_York)
- Source: working tree of branch claude/preprint-fixes (the lead commits); work by the print and viewer sub-agent (agent PRT) for the lead, in parallel with CAB (cables), PWR (power sim) and SW (software)
- Written: 2026-11-02 by the Claude Code agent

- Coupon T1 (print/make_coupons.py): T1 now clamps the real robot stack, 5.6 mm, not 5.5 mm. Two new pieces cut from the upstream STLs print next to it: T1b, a whole bulb (2.0 mm, 4 holes of 2.70 mm), and T1w, the head front wall behind the left eye (head.stl cut to the eye's 35 x 35 mm outline: 3.0 mm, the 24.98 mm eye opening, 4 holes of 2.70 mm, printed on its edge in the head's insert profile so the holes print horizontal as in the head). With two 0.3 mm washers (BOM 17l) under each M2.5x8 head: 0.6 + 2.0 + 3.0 = 5.6 mm, 2.4 mm of thread, 0.6 mm to the pilot floor. The washer, screw and stack numbers are read from fasteners/fasteners.json and checked (manifest t1_stack: OK). The other 10 coupon STLs are byte for byte the same as the 12:00 AM run.
- Session S1 sliced again (slice.py coupons, PrusaSlicer 2.7.2, D22 profiles): 11 pieces, 41.21 g PLA, 4.14 h (248.5 min), 2.09 g support; before 9 pieces, 36.20 g, 3.60 h. T1b 2.04 g, 10 min; T1w 3.03 g, 31 min (a flat T1w would slice to 2.40 g, 14 min, scratch run only, not used: it would not print the holes as the head does). S2 unchanged 17.6 g, 2.19 h. Coupon session 6.3 h; total on a 220 bed 1389.0 g PLA, 35.1 g TPU, 125.0 h (was 1384.0 g, 124.4 h); 611 g of the 2 kg left; 1450 g if the D22 gate fails.
- print/SLICE_SUMMARY.md rebuilt by slice.py summary from the parts and plates runs of 12:00 to 12:19 AM ET (that rebuild reproduces the old file exactly) plus the new coupons run; print/PRINT_PLAN.md S1 rows, totals, T1 tests and tools updated.
- 3D eye washers (viewer/scene_extras.json, hand edit of the generated file): 16 discs, two 0.3 mm per eye screw on the fasteners.json screw axis (0.0 to 0.3 and 0.3 to 0.6 mm out of the seat), in place of 8 discs of 0.5 mm. make_viewer_data.py draws each eye screw washer.t (0.6 mm) out, its head on the stack, as fasteners/VIEWER_NOTE.md says. BOM_FULL gets a washer row (F20, 16 pcs, line 17l) linked to the 16 discs.
- Heat shrink: viewer/bom_full.py now counts one sleeve per joint by a stated rule (sleeve_joints): 15 splices, 10 wire to lead joints, 3 lead to lead joints, 4 XT30 solder cups, 2 caps on the cut BEC third wires: 34 (was 27 drawn). None on pads, holes, header pins, plugs, sockets and screw terminals; switch terminals, lugs and tabs only if bare (HARNESS_BUILD), not counted. The 3 D9 lead extension sleeves are gone (netlist D9 reaches without an extension). The 2 cell holder lead joints of P1 and P2 go away if the holder leads reach the BMS.
- make_viewer_data.py step 10f places the 10 sleeves scene_extras.json lacks (splices JFI and JFO, the P1 and P2 holder lead joints, and at each eye and the projector the wire to resistor lead and wire to LED cathode joints) from cables3d.json and the netlist at every run, at the first spot clear of every CAD part and of each other; the 7 scene_extras splices that sit on a cables3d seat follow that seat (JG30 moved 1.0 mm). CAB changed the netlist at 1:59 AM ET (P7 XT30 piece 20 to 30 mm, JG tails 20 to 30 mm) and JFI moved with it. The projector cathode joint does not fit beside the anode joint in the 4 mm lead channel of flash_light_module: it is drawn staggered behind the resistor.
- Wirefy kit (BOM 26), count per size from the amazon.fr listing of the same ASIN B084GDLSCK via the search index (read about 1:30 AM ET; amazon.com is outside this session's network): 70 x 3/32, 50 x 1/8, 25 x 3/16, 16 x 1/4, 9 x 3/8, 5 x 1/2 in, and 5 x 3/4 in by difference from 180; 3.5 in pieces. The 34 sleeves need (smallest size that passes over the joint, one whole piece each): 2 x 3/32, 10 x 1/8, 7 x 3/16, 9 x 1/4, 3 x 3/8 in, 3 lead to lead joints of open size (lead diameters not published). Not short in any size, even with every joint of unknown diameter one size up.
- verify/: c4 reads a kit's count per size from its BOM line ("50 each of", "50 pcs of each size") and checks the schedule size by size; the WARN stays only when no count is stated. c1 counts the sleeve rule on its own and checks BOM_FULL, the 3D sleeves and BOM 26 against it, plus the washer row; its key line counts splices instead of a fixed 13. e4 checks washers and sleeves drawn against their counts.
- Viewer run 07:12 UTC (make_viewer_data.py --write-bom into the scratch folder): BOM_FULL 195 rows, 837 pieces, needs action 0; 749 GLB nodes, 3.80 MB; 0 viewer warnings. Single checks with VERIFY_OUT in the scratch folder: E4 PASS (washers 16/16, sleeves 34/34), C1 PASS with no WARN (was 1 WARN), C4a PASS with no WARN (was 1 WARN), C4b unchanged. blueprint/check_scene_extras.py: 1 of 171 items embedded (the P3 joint, as before); the 10 placed sleeves lie in no part.
- Open for other owners: BOM.md lines 26, 27 and TO11, STATE.md, HARDWARE_AUDIT.md B14 and TEST_PLAN.md 1.3 text (in the report to the lead); blueprint/make_scene_extras.py still writes one 0.5 mm washer per eye screw and the D9 sleeves, and lacks the SP4 and SP5 housings (2) and crimps (4); the test order has no BOM 17l washers for the T1 test; XT30U cup diameter and the resistor and LED lead diameters are not published.
