aaltaay/Open_Duck_Mini_v2/altaay_lab/history/2026-11-02_0220_power_path_as_built.md

# Power path as built: E6 and C7 check D15 plus the D23 ankle feeds with the netlist lengths

- When: 2026-11-02 2:20 AM (America/New_York)
- Source: branch claude/preprint-fixes; work by the power path sub-agent (agent PWR) for the lead; files in the lead's 2:18 AM ET snapshot commit 22c2770, this entry after it
- Written: 2026-11-02 by the Claude Code agent

- sim/power_path_sim.py: new topology `as_built` (now the default), the robot as wired: D15 star plus the D23 second feeds SP4 and SP5. netlist_lengths() reads every power-path length and gauge from wiring/netlist.yaml at run time, by end pins, and stops with the reason if a cable it expects is gone. The network is sim/power_fix.py option 3b (new option `ab` = 3b with the netlist values and the D15 data-lead grounds), so the D23 wiring has one model; given the study's lengths, option ab gives the 3b numbers to the third decimal. The tnkr, y_at_adapter and star topologies still run (star: 5.036 V and 3.44 V, as D15; Y-lead 4.78 V and 2.92 V).
- What the netlist changes against the earlier models: SP leads 22 AWG (was 20 AWG in the star model), SP4 390 mm and SP5 420 mm (not the 545 mm rule estimate), P11 100 mm, P6 150 mm, P7 250 mm, P8 150 mm, and P9 90 mm and P14 140 mm, which no earlier model had. The pack side adds about 4.5 mOhm and costs about 1.4 points of ankle time under 6 V; the shorter feeds win back about 0.6 points.
- Netlist changed during the run (agent CAB, 1:59 and 2:05 AM ET): P7 line piece 20 to 30 mm, SP1 to SP3 ground tails 20 to 30 mm, SD1 ground stem 30 to 45 mm, SD1 branch b data 160 to 170 mm. The final runs read sha256 44c0e8ea30 (2:05 AM ET), unchanged before and after them.
- Results (sim pass only; nominal pack, worse of the trained mass and our 2.65 kg build): typical corner, ankle under 6.0 V 6.2 % of the walk counted in time (was 21 % with the star), lowest servo the left knee 5.58 V; high-side corner, ankle 21.4 % (was 63 %), lowest servo the head roll 4.88 V (was the right ankle at 3.44 V). No servo under 4.5 V at full or nominal pack in either corner. With SP4/SP5 the knee, not the ankle, is the low point of each leg (right knee 9.6 % under 6 V, typical), and the neck chain, with no second feed, gets slightly worse (head roll 6.9 %, typical).
- Currents: pack RMS while walking 5.60 to 5.92 A for our build, 99 % of the Pololu 2815's 6.0 A continuous point at 55 C (Pololu page read 1:32 AM ET; 16 A at 150 C); 6.02 A at the low pack. Kit hops now under the 26 AWG limit in the worst 100 ms (worst S7 2.10 A against 2.2 A; six hops were over before) and no 5264 contact over 3 A (four were over). Adapter ground return 0.15 A worst 100 ms (ngspice).
- sim/POWER_PATH_SIM.md: new "As built" section first (generated table, per-chain before and after, part currents, the step-by-step difference from POWER_FIX.md 3b, new figure); the old content kept below as history. sim/odm_v2_power_path_voltages.png regenerated for the as-built case (sim/plot_power_path.py takes a file prefix). sim/POWER_FIX.md update note; sim/CURRENT_BUDGET.md pack side and switch lines.
- verify/: e6 checks the as-built case on both traces against the TEST_PLAN 9 gates read from the plan (4.5 V at any time, ankle time under 6 V counted in time; FAIL if the typical corner misses, WARN if only the high-side does), checks that every active power cable is in the model, and reproduces the doc table; it warns that the gate times only the ankles. e6b sweeps the hop on the as-built network with both gates and reads either "no ankle" or "no servo" wording. c7 splits the servo currents over the as-built loop (both corners), checks P11, SP1 to SP5, the 11 kit hops, their contacts, the ground network with the data-lead grounds, every power part and the P cables, and warns on the 2815 with the TEST_PLAN 4.2 heat check.
- Checks run (VERIFY_OUT in the scratch folder, 1:58 to 2:19 AM ET): E5 PASS; C8 PASS (our build's traces for E6 and E6b); E6 PASS, 2 WARN; C7 PASS, 4 WARN; E6b PASS, 1 WARN. C9 (read only, extra) shows a FAIL from print/PRINT_PLAN.md (coupons 41.2 g against BOM 27), not from these files.
- Open for other owners: TEST_PLAN 9 times only the ankles; timing every servo would pass the typical corner (9.6 %) but needs a section 5 hop gate of at most 29 mOhm per conductor, against 27.6 in the typical corner (a decision, text in the report to the lead); TEST_PLAN 4.2 and 9 compare lines; the netlist current fields on the power path (C7 WARN); run c8 before e6 in run_all.sh; report.py run notes; software/SOFTWARE.md section 8 and the bench reference numbers (SW).
