aaltaay/Open_Duck_Mini_v2/altaay_lab/history/2026-11-02_0234_cable_tails_loops_ties.md

# Cable pass: splice tails by chain, joint loops pushed out, every tie point checked, Molex terminal data

- When: 2026-11-02 2:34 AM (America/New_York)
- Source: branch claude/preprint-fixes; work by the cable sub-agent (agent CAB) for the lead, to clear the C3 FAIL and the cable WARNs so the harness can be built from HARNESS_BUILD.md without surprises
- Written: 2026-11-02 by the Claude Code agent

- C3 FAIL (the 20 mm SP2 and SP3 ground tails route 21 mm): JG20, JG10, JG30, YD3 and YG3 are solder splices that no part holds, so they slide along the bundle at build time and the wires joined there are judged together, fixed end to fixed end, as cables3d/check_cables.py does. verify/c3_cables3d.py now judges lengths by chain (floating: every netlist splice except SPV and SPG, seated on the belly, and JBP and JBN, where the BEC leads end) and says so. A tail into a crimp needs about 15 mm: 3.5 mm in the terminal (Molex 5263 catalog page B-101: crimp section 3.50 of the 7.00 mm terminal), a lap of 3 to 6 wire diameters and a 15 mm adhesive sleeve reaching 2 x OD onto the insulation (NASA-STD-8739.4A Change 4, 19.4.1 c and 19.2.6), cut from a 3.5 in Wirefy kit piece (BOM 26 listing, read 1:31 AM ET). 20 mm was long enough but put the stiff sleeve in the bend at the plug exit (7.2.36), so the three ground tails are now 30 mm. YG3 sits 15 mm past YD3 (SD1 stem G 45 mm, 7.2.35 staggered splices); SD1 branch b data 160 to 170 mm (the JG30 splice moved 3 mm back); the P7 JFI extension 20 to 30 mm (a 20 mm piece of 16 AWG left no room for two sleeves); D10 Vin and GND 200 to 220 mm (worst 173 mm + 2 x 20 mm). SP1, SP2, SP3, SD1 and SD2 re-routed with route_cables.py --only (splice centre at the cut minus 6.5 mm) and merged.
- Joint loops: the 3 x OD rule is NASA-STD-8739.4A Change 4, 7.2.19 and Table 7-1 (overall harness of AWG 10 or smaller without coax: minimum 3 x OD, optimum 10 x OD), read 2026-11-02 1:27 AM ET; the BNTECHGO 22 and 26 AWG listings give no bend radius (read 1:45 AM ET) and the standard has no separate flexing value. seats_ties.py now pushes the two ties of each crossing out (60 mm per side at most) until the loop meets 3 x OD in two models: bend over the largest joint angle, and the cable the loop needs at the farthest pose stored as one arc over the closest tie-to-tie chord (the model C3 used, now between the real ties). 47 of 50 loops meet both over the full URDF range (was 0 of 50 in C3's model); free length 5 to 34 mm. Three cannot inside the route room, all at head yaw (+/-160 deg in the URDF): P13 storage R 10.2 mm (needs 10.8), D2 10.0 mm (needs 10.4), S12 bend R 1.7 mm and storage R 5.5 mm (needs 7.8; the plug of ID 32 sits 1 mm past the crossing). The build dresses each loop with the length HARNESS_BUILD.md gives and turns the joint by hand at the TEST_PLAN 1.4 fit. C3 recomputes every loop from the route and robot.urdf.
- Tie points: an exact-ray check now looks for a flat patch with the mount height free at every stick-on mount spot (centre at most 20 mm from the cable line). Of 92 tie points (was 93): 5 existing printed features; 82 stick-on mount spots, where the BOM 34 MB3A (19 x 19 x 4.8 mm) fits at 39, only a 13 x 13 x 4.1 mm HellermannTyton MB2APT (catalogue 2016/2017 p. 1.7 via docs.rs-online.com, read 1:53 AM ET; not in the BOM) at 21, none at 22; 2 tied to a neighbour cable that its own mount holds; 3 in free air. Open: 25, mostly the neck brackets and the leg sheets (HARDWARE_AUDIT B35, proposed D25). The 12 old free-air ties: 4 now take an MB3A, 3 only the MB2APT, 1 is tied to D12, 4 are still open (T015 and T085 from the old T016, T027, T038, T052).
- Retention rule text corrected: NASA Table 9-1 is the spacing of the ties that bind a harness (19.1 mm for 6.4 mm or less), not a support spacing; the 76.2 mm support spacing is a lab rule.
- Molex 08-70-1040 (C2 WARN): 22 to 28 AWG, insulation 1.90 mm max, 3.0 A on 22 AWG (2.5, 2.0, 1.5 A on 24, 26, 28), 20 mOhm, 250 V, -40 to +105 C, from the Molex catalog page MX01 B-101 and the Molex 0008701039 part sheet (distributor copies, read 1:29 AM ET; molex.com, mouser.com, digikey.com and newark.com were not reachable). Written into CABLE_MAP.md 'Connector parts'; verify/c2_connectors.py reads and checks them (OD 1.7 +/- 0.1 mm fits, 10 crimped wires with a current all under 3.0 A).
- D12 camera FPC: kept as the 150 mm test fit; proposal (BOM E7 not changed): Adafruit 5818, Raspberry Pi Standard-Mini camera cable, 200 mm, 22-pin 0.5 mm to 15-pin 1 mm, $2.70, in stock (read 1:46 AM ET), 73 mm spare. S2 and S7 stay the B17 test fit.
- Netlist currents from the power sim (lead's ask): P1, P2, P6, P8, P14, P9 and the four P7 pieces 5.66 / 7.04 A, P10 4.77 / 6.23 A, P11 4.25 / 5.56 A and the BEC leads 2.13 / 2.78 A, SP1 to SP5 per wire; the sim ran on the netlist at sha256 44c0e8ea30, which already held every cut change above.
- Regenerated: cables3d.json (seats_ties.py, check_cables.py), CABLES_3D.md (make_report.py), cables_all.png and cables_detail.png, audit/erc.py (0 ERROR, 0 WARN, 8 INFO; ERC_REPORT.md and continuity_checklist.csv), wiring sheets (strict, 124 of 124 wires), HARNESS_BUILD.md (tie ids, loop lengths, splice steps), CABLE_MAP.md and WIRING.md section 4, BOM wire lines L5, 24, 25 and Need of lines 32 (92 ties) and 34 (39 MB3A).
- Checks (VERIFY_OUT in the scratch folder): C2 PASS (0 FAIL, 0 WARN), C3 PASS (0 FAIL, 6 WARN; was 2 FAIL, 8 WARN), C10 PASS, E1 PASS (10 of 10 faults caught). Sim and CAD pass only.
- Open for other owners: bom.json and BOM_FULL.md rebuilds; TEST_PLAN 1.3 and 1.4, HARDWARE_AUDIT B35, BOM line 35 and C7's contact rating source text; proposed D25 for the 25 open tie points, the MB2APT line and the head yaw loops.
