aaltaay/Open_Duck_Mini_v2/altaay_lab/history/2026-11-02_0437_d25_cable_retention_twist.md

# D25 cable pass: one anchor per tie spot, drilled tie holes, the small mount, head yaw loops, twisted cables

- When: 2026-11-02 4:37 AM (America/New_York)
- Source: branch claude/preprint-fixes; work by the cable sub-agent (agent CAB) for the lead, carrying out D25 (decided by the lead under Ahmed's delegation)
- Written: 2026-11-02 by the Claude Code agent

- Small mount (BOM line 34b, new): Panduit ABM1M-AT-C, 0.50 x 0.50 in (12.7 x 12.7 mm), nylon 6.6, acrylic tape, packs of 100, at Hisco (Houston, TX), $72.41 per pack, "Availability: 2 In Stock", maker lead time 38 days, country of origin US, not discontinued in the page data, read 2:43 AM ET with plain curl. Single source found (Heilind and Connecticc answer plain curl with a bot check, not tried around; Elliott Electric has no page; Steiner Electric is outside this session's network). Height and largest tie width are not on a US page read: the search index gives 12.7 x 12.7 x 4 mm and 0.1 in (2.5 mm) to 3.0 mm ties, so they are UNVERIFIED; the CAD check leaves 4.1 mm free height. No test order: the fit is checked at the dry fit.
- One anchor per spot: the mount check looked at each tie point alone, so two mounts (or two tie-hole pairs) could sit on the same patch. In the committed file (05be03d) 15 mount pairs on the same face of the same link overlap for certain (centres 2.4 mm and more apart, closer than half their two widths added), and in this job's first run the T014 and T039 hole pairs came out 4.4 mm apart centre to centre. seats_ties.py now refuses a mount or a hole pair that overlaps one already placed on the same face (separating axis test in the plane, 1.6 mm round every hole), and a tie point whose own spot is taken joins the nearest anchor of its link within the dressing distance (20 mm at a loop end, 25 mm elsewhere): both bundles on one anchor, one tie round both. 15 points joined that way (listed as `also_holds`), so the file has 75 tie points instead of 90 (ids have gaps).
- Result (cables3d.json, 4:31 AM ET): 32 MB3A mounts (BOM 34), 23 ABM1M-AT-C mounts (BOM 34b), 6 stock holes or slots, 3 drilled tie-hole pairs, 2 ties to an anchored neighbour cable, 9 open. Each open point has a named plan in `plan`: T026 (D2, D3, D4 on the head) and T089 (SP5 on the trunk) are route changes to an MB3A patch 29 and 34 mm away; T016, T017, T023, T024 and T085 (neck yaw bracket and neck sheet) and T034 and T045 (the D3 + SP4 and D4 + SP5 knee loop ends) need a printed tie anchor, a design change for the print side. None of the 9 is print-blocking; until then a tie round the bundle only, checked at the dry fit.
- D25 order as run: (i) neighbour tie, (ii) two 4.0 mm tie holes (BOM T14 bit) through a printed wall after printing, checked with exact rays: at least 1.6 mm of plastic round each hole and between them (the lab insert-wall minimum, PRINT_CHECK.md flag 1), wall 1.6 to 12 mm, every screw, insert and empty hole of fasteners/fasteners.json at least 1.6 mm off, 1.5 mm free behind the wall, the strap at least 1 mm from moving parts over the joint sweep; hole centres 4 mm wider than the bundle; (iii) a loop tie moved further out along the route while the loop still meets 3 x OD; (iv) a mount on the STS3215 case of the same link (8 mm off the plug axis, 1 mm from moving parts): none fits after the other steps. The 3 hole pairs: T014 (D1, D2, D3, D4, P13) and T084 (S12) through neck_right_sheet, T072 (S5) through the left leg's knee_to_ankle_right_sheet; positions in the part STL frame in HARNESS_BUILD.md "Drilled tie holes" and the text proposed for print/PRINT_PLAN.md.
- Joint loops: two crossings under 8 mm apart along the route with no room for a tie between them are one loop (head_pitch and head_yaw for P13, D1, D2, D3, D4 and S12; SP5 right hip yaw and roll). All 43 loops (50 crossings) meet 3 x OD in both models over the full URDF range and within the Runtime head ranges, recomputed by C3 from robot.urdf. The loop choice now leaves a little over the rule where the room allows, so the recompute from rounded tie positions passes. Head yaw: the URDF allows +/-160 deg (robot.urdf line 2250); the Runtime gamepad commands +/-0.5 rad (Open_Duck_Mini_Runtime 376de65, mini_bdx_runtime/mini_bdx_runtime/xbox_controller.py lines 16 and 101 to 104), the walk adds the policy's own head action to it (scripts/v2_rl_walk_mujoco.py lines 310 and 311; the stock policy uses -13.1 to +8.2 deg of head yaw in the sim walk, VERIFICATION.md E9, sim pass only) and head_puppet.py maps the same command to +/-30 deg (lines 42 and 58 to 60). P13, D2 and S12 meet the rule over the full range (bend R 11.0, 10.5 and 11.3 mm against 10.8, 10.4 and 7.8 mm), so the full loops stay and no software limit is needed for the cables; a head yaw manual-move limit for the test plan is proposed to the lead.
- Twist (NASA-STD-8739.4A Change 4, 7.2.16 to 7.2.18, lay 8 to 16 x the harness OD): every made cable with two or more made wires on one run long enough for one lay after 20 mm untwisted ends is twisted: SP3, SP4, SP5 (40 mm lay), P13 (45 mm), D2, D3, D4 (40 mm), D6 (35 mm), D10 (45 mm) and SD1 branch b (40 mm). The other 12 have the reason in the netlist (too short for one lay, or P7's two pieces are in series through the fuse holder). Kit cables stay as shipped. The length checks (check_cables.py and C3) multiply the routed length of a twisted wire by its take-up at the shortest lay (1.019 to 1.028), which put four wires under the slack: SP4 V and G 390 to 400 mm, SP5 V and G 420 to 430 mm, D10 LRC 210 to 220 mm (netlist, CABLE_MAP.md). These SP4 and SP5 power cuts changed after the power sim's netlist (sha256 44c0e8ea30): +10 mm of 22 AWG is +0.53 mOhm per wire (erc.py table).
- D12 camera cable: kept at 150 mm on test order TO9; the BOM E7 note names Adafruit 5818 (200 mm, 22-pin 0.5 mm to 15-pin 1 mm, $2.70, in stock, read 1:46 AM ET) as the fallback, no buy line.
- BOM: line 34b added ($72.41); line 32 Need 75 along the cables (94 with spares), Buy back to 1 pack; line 34 Need 32; line 35 Need 55 mount spots; line 24 22 AWG 3.6 m; E7 note. audit/bom_totals.py and audit/bom_md_to_json.py re-run: cables section $267.04, build total $1018.29.
- Checks (VERIFY_OUT in the agent's scratch folder; sim and CAD pass only): C3 PASS (0 FAIL, 4 WARN: D12, S2 and S7 fixed-length test fits, and the 9 open tie points with plans), C2 PASS, C10 PASS (124 of 124 wires; sheets regenerated after the netlist edit), E1 PASS (0 ERROR, 0 WARN), E2 and E3 PASS.
- Files: cables3d/seats_ties.py, check_cables.py, make_report.py, cables3d.json, CABLES_3D.md, both PNGs, VIEWER_NOTE.md; wiring/netlist.yaml (twist on every made multi-wire cable, three cuts), make_harness_build.py, sheets; HARNESS_BUILD.md, CABLE_MAP.md, WIRING.md; audit/ERC_REPORT.md; verify/c3_cables3d.py; BOM.md lines 24, 32, 34, 34b, 35 and E7, bom.json.
