aaltaay/Open_Duck_Mini_v2/altaay_lab/history/2026-11-02_0446_walking_log_timer.md

# Walking voltage log on its own timer: time under 6 V counted by phase for every servo, bench suite stable under load

- When: 2026-11-02 4:46 AM (America/New_York)
- Source: this commit, branch claude/preprint-fixes; work by the software sub-agent (agent SW) for the lead, 1:24 to 4:46 AM ET
- Written: 2026-11-02 by the Claude Code agent

- bench/power_log.py --walk: the old log read registers 62 to 70 of all 14 servos inside every 20 ms cycle, before the Runtime's reads. Every goal write came one read later (3.0 ms on the simulated bus) and its count was a phase sample: 0.3 to 0.8 % for a dip that fills 19.7 % of the time. Now one read at a random time in each 27 ms slot runs only inside the Runtime's own end-of-cycle sleep (new bench/odm_bench/vsampler.py; walkhooks swaps the name `time` inside v2_rl_walk_mujoco only, no Runtime file edited). A read starts only if its expected time plus 2 ms ends before the next cycle; once started it runs to its end. The old log stays as `--sampler cycle`, for comparison only; it cannot score the gate.
- Why random in each slot and not every 27 ms: the step cycle is 27 control cycles (polynomial_coefficients.pkl, 0.54 s), so a fixed 27 ms timer reads the same 20 points of every step. Sim traces, 60 s: off by up to 10.9 points (sim pass only); test: 0.0 to 10.0 % for an exact 6.68 %, the random timer 5.9 to 7.0 %.
- Counting in time: per servo, per 1 ms bin of the time since the goal write, each bin weighted by its real share of the time between goal writes; bins the timer cannot read take the share of the last bins read (high, not low, while 9.recovery holds); each reading binned at its modelled latch time (latch instant UNVERIFIED; if earlier, the count errs high). Lead's decision applied: every servo is timed, gate 9.time6 = no servo over 10 % at nominal (ankles, knees, head roll named); 9.wiring compares ankles, knees, head roll and the lowest servo with the as-built high-side corner (new tests/data/sim_power_fix_reference.json from sim/POWER_PATH_SIM.md, sim pass only); `--feeds none` for a log with SP4/SP5 unplugged.
- Checked: virtual clock, dip of 19.80 % locked to the goal writes: 19.69, 19.66, 19.76 % at 55, 41, 26 % of the walk read (share of readings 33.6 to 77.4 %). Real walk loop, wire-timed simulated bus, idle: 19.0 to 22.5 % against 19.6 to 19.7 %, 44 to 48 % read.
- Found and fixed in the new code while testing: a read-time estimate that never came down after one slow read (one reading in a 12 s walk under load); reads cut short at the end of the sleep left late replies that made rustypot panic (G10) with every core loaded; the read phase taken before pypot's send read the count 2 to 3 points low on a slow host.
- Bus budget at 1 ms USB per read (UNVERIFIED): control part of a cycle 8.50 ms with the old log, 5.18 ms now (the same as no log); each log read takes 3.32 ms of the idle part. Measured (x86, simulated bus): goal write 4.2 to 4.3 ms into the cycle with no log, 7.0 to 7.3 ms with the old log, 4.2 to 4.3 ms with the timer log; 1 of 682 timer reads ended late (2.1 ms). timing_budget.py shows both.
- Tests: 63 (was 56); test_power_log.py has 12, incl. the phase-locked case, the gait lock, the exact-share checks, --analyze on a CSV, and exit 10 when a servo keeps torque after a guard hard stop. fake_sts3215.py: a dip after each goal write, goal write times, writes timestamped after their wire time.
- Stability: the whole suite 10 times, every second run with a busy loop on each of the 4 cores, 4:02 to 4:39 AM ET: 10 of 10 runs passed, 63 of 63 tests each, none skipped. Before that, set 1 (one loaded run failed: the estimate fault above) and set 2 (7 of 8 passed; one idle run failed on a test limit for the old log, 2.3 % against 2.0 %, too tight for its own 5 % late-cycle allowance; now "under half the true share").
- software/SOFTWARE.md sections 1 and 6 to 9 (the lead's as-built line on the ankle-gate prediction in section 8) and PI_SETUP.md section 10 step 8 updated. Sim pass only: the period study and every sim comparison; simulated bus only: everything else here.
- Open: TEST_PLAN 9 text and the verify/report.py row (lead); bench/sim_profiles.py not switched to as_built (the battery guard replays and SOFTWARE.md section 5's D16 table rest on the star profiles: its own job); walk_with_guard.py's guard tick still reads inside its cycle; on the Pi the share of the walk read depends on the Runtime's CPU time and the USB round trip (9.coverage measures it).
