aaltaay/Open_Duck_Mini_v2/altaay_lab/history/2026-11-02_0455_d25_bundle_ties_route_tries.md

# D25 last cable job: two route changes tried and not kept, nine bundle ties checked at the test fit, 34b sources

- When: 2026-11-02 4:55 AM (America/New_York)
- Source: branch claude/preprint-fixes; work by the cable sub-agent (agent CAB) for the lead, after commit 2b70048
- Written: 2026-11-02 by the Claude Code agent

- Route changes to the MB3A patches named for T026 and T089 (route_cables.py --only D2,D3,D4,SP5 with a via over each patch, in the scratch folder): not kept, so route_cables.py is unchanged. T026: the patch is on the underside of head_bot_sheet, 28.6 mm below the bundle, so the bundle has to drop under the head floor and come back. The worst routes grow by 83 to 84 mm (D2 434 to 517, D3 770 to 854, D4 767 to 851 mm). With the twist take-up and the 40 mm slack, D2 (cut 550 mm) and D3 (cut 900 mm) would come out 18 to 25 mm short; D4 would keep 36 mm. T089: the patch is on the outer -y face of body_middle_bottom, 33.9 mm away. The SP5 worst route grows from 377 to 440 mm (448 mm with the take-up), past the 430 mm cut before any slack. Both are recorded in seats_ties.py ROUTE_TRIED and in each point's plan.
- The 7 points that needed a printed anchor, plus T026 and T089, are now "bundle tie, test fit" (D25: no new printed parts, no STL change, Ahmed: keep it simple). Each is a tie round the bundle only, checked at both joint limits at the TEST_PLAN 1.4 test fit; a drilled tie-hole pair or a printed anchor only if the bundle reaches a moving part. cables3d.json: kind "cable tie", hold "bundle tie, test fit", test_fit true, plan; 0 open. The counts are otherwise unchanged: 75 tie points, 32 MB3A, 23 ABM1M-AT-C, 6 stock holes, 3 drilled tie-hole pairs, 2 neighbour ties.
- BOM 34b: the lead's search-index reads replace UNVERIFIED (about 4:50 AM ET): largest tie width 0.1 in (Steiner Electric listing title); height 0.16 in (myMectronic); ABM1M-AT-M .50 x .50 in, height 0.15 in (North Coast). The 2.5 mm line 32 tie is at the 0.1 in (2.54 mm) maximum. Not single source: Steiner Electric, Stanion, Heilind and Connecticc also list it (prices not read).
- Updated: seats_ties.py (open_plans), C3 (counts "bundle tie, test fit"), make_report.py, make_harness_build.py (section 'Bundle ties checked at the test fit'), CABLES_3D.md, HARNESS_BUILD.md, VIEWER_NOTE.md, BOM.md lines 32 and 34b, bom.json. Texts for files CAB does not own are in the agent's scratch file texts_for_lead.md.
- Checks (sim and CAD pass only): C3 PASS (0 FAIL, 4 WARN: D12, S2 and S7 fixed-length test fits, and the 9 bundle ties checked at the test fit), E1 PASS, E2 and E3 PASS.
