aaltaay/Open_Duck_Mini_v2/altaay_lab/history/2026-11-02_0542_integration_pass_pr6.md

# Integration pass: the PRT, PWR, SW and CAB results in the docs, test order with the eye washers, scene extras and BOM_FULL regenerated, full verification

- When: 2026-11-02 5:42 AM (America/New_York)
- Source: working tree of branch claude/preprint-fixes (the lead commits, PR 6); work by the integration sub-agent (agent INT) for the lead, after the PRT, PWR, SW and CAB jobs (history entries 0213 to 0455) and the lead decisions L1 and L2
- Written: 2026-11-02 by the Claude Code agent

- Texts applied from the lead's two scratch files. DECISIONS.md: D25 as carried out (CAB's final text), the D21 note (PRT, with lead decision L2), the D23 note (PWR) and a dated note for lead decision L1 (TEST_PLAN 9 times every servo, 10 % each; the section 5 gate stays 40 mOhm), status D1 to D25. TEST_PLAN.md: 1.3 merged from PRT (which joints get sleeves, 34) and CAB (2 x OD, no splice in a bend, YG3 15 mm past YD3, twist count), 1.4 loops and the 75 ties, 4.2 and the section 5 note as wired (PWR), new 8.2b head yaw limit, section 9 replaced by SW's text (precedence as the lead set it). HARDWARE_AUDIT.md: B14 (T1 with the 5.6 mm stack), B35 decided by D25; section 6 22 of 35 cleared or decided, 2 waiting on parts, 5 coupon, 6 assembly or bench; section 7 17 test order lines. print/PRINT_PLAN.md: After printing step 5 (the 3 drilled tie-hole pairs), T14 and T15 named in steps 3 and 4, the T1 washers come with TO17. BOM.md: lines 26 (sleeves per size), 27 (1389 g), 30, TO11, T14, Last updated, and change notes for CAB's D25 pass ($955.29 to $1,018.29) and this pass.
- Where the texts were not applied word for word: SW's pass line "no servo under 4.5 V in any reading" reads "at any time, in any reading", because E6 and E6b find the gate by "no servo under N V at any time" (without it they fall back to the ankle-only gate). The plus-minus sign is written +/- as in the rest of TEST_PLAN.md and DECISIONS.md. D25 names history/2026-11-02_0455_d25_bundle_ties_route_tries.md for "the last-job entry". The section 5 note (PWR: about 29 mOhm, 13.1 % at 40 mOhm) carries this run's E6b numbers, about 28 mOhm and 13.4 %, since it cites VERIFICATION.md E6b; TEST_PLAN 8.2a now says 10.5 deg (C11 of this run; was 10.4).
- BOM line 30: the netlist has 15 splices (was written 13). Recounted with the viewer/bom_full.py end rule behind BOM_FULL K01: 145 soldered wire ends, 24 of them 16 AWG, 52 of them in the 15 splices; ends marked 'holder lead' or 'BEC lead' are not counted (the sourcing pass rule, which counts them, gives 153 and 28 today; on the sourcing-pass netlist it gave its 145, 24 and 13).
- Lead decision L2: BOM.md lines 50 to 52 read 17j 12 x $0.09 = $1.08, 17k 5 x $0.12 = $0.60, 17l 48 x $0.07 = $3.36, so new test order line TO17 is $5.04 (the BelMetric $5 minimum checkout). audit/bom_totals.py: test order $226.46 to $231.50; build total unchanged at $1,018.29 (with expression $1,100.69, with tools $1,350.75). audit/bom_md_to_json.py: 83 rows. Nothing bought.
- blueprint/make_scene_extras.py: PRT's edits a to d (two 0.3 mm washers per eye screw from fasteners.json n and t_each, the BOM_FULL key "M2.5 flat washer", the D9 sleeves only while the netlist extends the D9 lead), docstring 13 of the 15 splices. Run twice (the second time on the new bom_full.csv row ids). viewer/scene_extras.json: 177 items (was 171, PRT's hand edit kept): 16 washer discs of 0.3 mm on row F20 and line 17l, no D9 sleeves, the SP4 and SP5 housings (2) and crimps (4) added; JG10, JG20 and JG30 moved 3.2 to 4.0 mm and YD3 and YG3 about 2 mm to their cables3d seats. YD3 and YG3 are still drawn side by side at the one cables3d seat Y.SD1 (the build staggers them 15 mm). check_scene_extras.py: 1 of 177 items embedded (the P3 joint, as before).
- viewer/: make_viewer_data.py 10d and bom_full.py 6b (CAB's code): one tie per retention item, the mounts on a row per type. The manifest showed the print grams before D22 (1409.0 g from PRINT_CHECK.md); it now reads print/SLICE_SUMMARY.md when that table is clean (it is: the same 36 STLs and 52 parts as PRINT_CHECK.md, parts add up to its 1280.3 g total): robot set 1280.3 g, 111.1 h, and the D22 grams and profile per part in BOM_FULL. PRINT_CHECK.md stays the fallback and the source of orientation and bed fit. viewer/MISSING_3D.md rows updated.
- Viewer run (make_viewer_data.py --write-bom, last at 10:20 UTC, data in the agent's scratch folder final_viewer): BOM_FULL 196 rows, 798 pieces, needs action 0 (cable ties 75 on line 32, MB3A 32 on line 34, ABM1M-AT-C 23 on line 34b; before 93 ties and 76 mounts on one row). Manifest: 355 screws (342 fitted, 11 not fitted, 2 left out by D18), 187 small parts (54 connector bodies, 15 splices, 19 sleeves), 75 ties, 62 cable runs of 47 cables (59 pass; D12, S2 and S7 marked fail as the fixed-length test fits), 16 washers; printed parts 52/52, servos 14/14, inserts 58/58, bearings 3/3; GLB 3.80 MB.
- verify/: run_all.sh runs c8 right after e5 (E6, C7 and E6b read its traces); c7 Molex note (3.0 A at 22 AWG, catalog page MX01 B-101); report.py run notes and the hardware rows (sections 1, 4, 5 and 9 and a new 8.2b row).
- STATE.md rewritten; START_HERE.md status, D1 to D25, the walking log line, the open questions in order (1 coupon print, S1 11 coupons, 41.2 g, 4.14 h; 2 test order $231.50; 3 the printer, bed at least 220 x 220 mm); README.md mass note (a C9 WARN before).
- Verification (VERIFY_OUT in the agent's scratch folder; full run 5:22 to 5:35 AM ET, then C4, C6, C7, C8, C9, E6 and E6b again 5:37 to 5:41 AM ET after the last doc edits and C9 once more at 5:44 AM ET after the STATE.md date line, same results): 22 checks, 20 PASS, 2 FAIL, 0 NOT RUN; 2 FAIL and 20 WARN findings. E8 63 tests pass; C3 PASS (4 WARN); C9 0 disagreements (4 WARN, all from before); E4 washers 16/16, sleeves 34/34.
- The 2 FAILs, both understood and not doc errors. E6b: at the 40 mOhm section 5 gate the right knee is under 6.0 V for 13.4 % of the walk (our build, as built, nominal pack); about 28 mOhm passes. That is lead decision L1 as written (every servo timed, section 5 kept at 40 mOhm); closing it is a decision: a 28 mOhm gate on 2S, or the 3S plan. C8: sim/mass_budget.py on today's netlist gives 2652.8 g (wires 121.8 g; MASS_BUDGET.md says 2651.9 g, before CAB's cut changes), and the single 15 N pushes run of that model tracks 0.618 of the command against 0.63 in print/MASS_STUDY.md variant (c), 0.0118 apart against the check's 0.011 (0.628 at 2.6519 kg in the runs of 1:08 and 2:01 AM ET); 0 falls in 36 runs; the 6 seeded pushes runs 0.621 mean, as before. Sim pass only.
- Side effect fixed: the scratch run of sim/mass_budget.py (ODM_OUT in the scratch folder, to read today's total) also writes sim/mass_budget.png into the repo; that file was put back byte for byte from the branch head, so sim/ is unchanged.
- Open for other owners: a mass budget re-run and the walk doc C8 compares with (sim owner); sim/POWER_PATH_SIM.md 'As built' ran on the netlist of 2:05 AM ET, and with the D25 cuts our build moves a little (ankles 6.4 % against 6.2 %, right knee 9.8 % against 9.6 % under 6 V, typical corner; Pololu RMS 5.93 A against 5.92 A); the mass budget counts 1 g of cable ties, not the 75 ties and 55 stick-on mounts; UPSTREAM_ISSUES.md is triaged against the decisions up to D12 only; bench/sim_profiles.py still on the star profiles (SW).
