aaltaay/Open_Duck_Mini_v2/altaay_lab/history/2026-11-02_0640_pr6_last_fixes_no_fail.md

# Last fixes for PR 6: C8 and E6b closed without loosening a check, TEST_PLAN 5 hop bands (L3), cable "test fit" label, full verification 22 PASS 0 FAIL

- When: 2026-11-02 6:40 AM (America/New_York)
- Source: working tree of branch claude/preprint-fixes after commit a07505f (the lead commits, PR 6); work by sub-agent SFX for the lead, lead decision L3 under Ahmed's delegation
- Written: 2026-11-02 by the Claude Code agent

- Mass budget (C8 part 1): sim/mass_budget.py run unchanged at 5:55 AM ET (ODM_OUT in the agent's scratch folder): 2651.9 to 2652.8 g, wires 121.0 to 121.8 g. The +0.9 g are agent CAB's cut changes since the 1:00 AM ET run (netlist diff against commit ab40b19: P7 line piece 20 to 30 mm, SP1 to SP3 ground tails 20 to 30 mm, SD1 ground stem 30 to 45 mm and data branch 160 to 170 mm, and the D25 twist take-up: SP4 and SP5 V and G to 400 and 430 mm, D10 to 220 mm). sim/MASS_BUDGET.md: every table from that run (29 table lines changed), a dated update line, the Answer (+546 g, head +141 g, wires 122 g) and finding 1; sim/mass_budget.png from the same run.
- (c) walk (C8 part 2): print/mass_study.py walk on today's model, model light_c: forward, turn, side, backlash and 15 N pushes with 6 seeds, rough terrain with 18 seeds, and the backward margin runs (both starts), 5:59 to 6:02 AM ET. The study's own slice table (its results_c.json) differs from print/SLICE_SUMMARY.md by 0.01 g (left_roll_to_pitch support 1.29 against 1.30 g; a fresh `mass_study.py slice --only left_roll_to_pitch.stl` gives 1.29 again), so the walk ran on the SLICE_SUMMARY.md table, the D22 print as adopted; that model is the one C8 runs (pushes 0.6182 in both). Nominal tracking, study (2638.7 g) to now (2652.8 g): forward 0.702 to 0.698, turn 0.812 to 0.808, side 0.246 to 0.245, backlash 0.903 to 0.900, pushes 0.631 to 0.618. Run-to-run noise: with the study's slice table (0.01 g heavier) the same script gives pushes 0.626 and side 0.237, and the 6 seeded pushes runs span 0.614 to 0.629 (0.617 to 0.638 in the study). No real change: 0 falls on flat ground in 35 runs; rough terrain 16 of 18 seeds fall (18 of 18 before), mean first fall 11.6 s (11.3 s), nominal fall 6.86 s (25.78 s), chaotic as the study says; the backward margin runs fall at the same steps, times within 0.08 s. The stock nominal runs reproduce the study's trained column exactly. print/MASS_STUDY.md: the (c) column and rows of the walk tables, the mean first fall line, What this means 1 and 3, the Answer bullet, and a dated line saying why.
- Power path: sim/power_path_sim.py as_built on this morning's E5 and C8 traces, 6:01 to 6:02 AM ET (netlist sha256 0f4af5bff3). Our build, nominal, typical: ankles 6.2 to 6.4 %, right knee 9.6 to 9.8 %, head roll 6.9 to 6.8 %; high-side: knees 30.9 / 30.4 to 31.1 / 30.6 %, head roll 33.4 to 33.5 %, lowest head roll 4.88 to 4.91 V; pack RMS at full and nominal 5.60 to 5.92 A became 5.61 to 5.93 A (Pololu 2815 still 99 % of 6 A), low pack 6.02 to 6.04 A, mean up to 5.68 A, worst 100 ms 7.03 A, BEC RMS up to 4.53 A. Trained mass, nominal, typical: ankle 4.7 to 4.8 %, right knee 7.8 to 7.9 %; high-side knees 27.8 / 27.9 %, right knee lowest 5.02 V. sim/POWER_PATH_SIM.md 'As built' updated (table, gate lines with a new every-servo line, per-chain table, meaning, currents, netlist line, a note under the step table); sim/odm_v2_power_path_voltages.png regenerated with sim/plot_power_path.py (trained-mass trace, as before).
- Undated lines that quote those numbers, updated: TEST_PLAN.md 4.2 and 9, sim/CURRENT_BUDGET.md switch line, software/SOFTWARE.md section 8, bench/tests/data/sim_power_fix_reference.json (the d23 values bench/power_log.py compares with in 9.sim and 9.wiring, with a dated source note), a comment in bench/tests/test_power_log.py, verify/report.py section 4 row, STATE.md, START_HERE.md. sim/POWER_FIX.md got a new dated update note. Left as they are (dated): DECISIONS.md D23 PWR note, the POWER_FIX.md 2:10 AM ET update, WIRING.md section 4 and the netlist currents (copied from the 44c0e8ea30 run; C9 and C7 pass with them), the ADDED_MASS_SIM.md and RUNTIME_THERMAL.md mass notes.
- E6b and lead decision L3: whole-mOhm sweep in E6b's model (scratch tools/hop_sweep_N.py), nominal pack, typical pack side, our build, right knee time under 6 V: 25 mOhm 9.0 %, 26 9.2 %, 27 9.6 %, 28 9.9 % (9.92), 29 10.2 %, 30 10.4 %, 31 10.8 %, 32 11.0 %; no servo under 4.5 V; the trained-mass trace stays under 10 % to 32. N = 28. TEST_PLAN.md section 5: Pass at most 28 mOhm per conductor ("Gate: 28 mOhm per conductor"), Warn over 28 up to 40 (the walking log decides, the 3S plan made ready for Ahmed), Fail over 40 (find and fix before the full assembly). DECISIONS.md D23: dated lead note L3. verify/e6b_hop_sweep.py runs the pass gate (FAIL if any section 9 gate fails there) and the warn limit read from "Fail: over 40 mOhm per conductor" (WARN with the knee, head roll and ankle numbers; FAIL if a servo goes under 4.5 V). Results: at 28 mOhm worst servo right knee 9.9 %, ankle 6.4 %, lowest 5.58 V (PASS); at 40 mOhm knees 9.5 / 13.4 %, head roll 9.8 %, ankles 8.0 %, lowest 5.46 V (WARN).
- Cable label (the lead's extra item): cables3d/check_cables.py now writes "test fit" for a cable that reaches but has less than the 2 x 20 mm slack and "fail" only for one that cannot reach (a made cable short of slack would also read "test fit"; its finding gives the shortfall). Run on a copy first: unchanged code reproduces the committed cables3d.json exactly (only the time stamp differs); the new code changes only the check of D12, S2 and S7. cables3d.json, CABLES_3D.md (make_report.py counts "test fit"), VIEWER_NOTE.md, HARNESS_BUILD.md (regenerated), viewer/make_viewer_data.py ("test fit" kept, summary test_fit count), viewer/MISSING_3D.md row Cables. The render pictures do not show the check. C3 judges lengths itself and is unchanged (PASS, 4 WARN as before).
- Viewer data (make_viewer_data.py --out <scratch>/final_viewer --write-bom, 11:08 UTC): cable runs 62: 59 pass, 3 test fit, 0 fail (was 59 pass, 3 fail); printed parts 52/52, servos 14/14, inserts 58/58, bearings 3/3; 355 screws; BOM_FULL 196 rows, 798 pieces, 0 needing action (only the check text of rows C34, C37 and C41 changed); GLB 3.80 MB, 755 nodes. Page: a changed copy of the published index.html is in the agent's scratch folder for the lead to publish (cable pill "Test fit", counts "59 pass, 3 test fit", amber tile bar and chip when there are test fits, red only on a fail); a local headless check with the new data showed those and no console errors.
- Verification (run_all.sh, VERIFY_OUT in the agent's scratch folder, ODM_TEST_PYTHON as the integration run; full run 6:19 to 6:32 AM ET; C9 again at 6:33 AM ET after STATE.md and START_HERE.md; C4 and C6 at 6:35 and C8, E6, C7 and E6b in full at 6:36 to 6:40 AM ET after the dated lines got their real times; report.py at 6:40 AM ET): 22 checks, 22 PASS, 0 FAIL, 0 NOT RUN; 0 FAIL and 21 WARN findings (C3 4, C4b 5, C7 3, C9 4, C11 1, E6 1, E6b 1, E7 2). E8 63 tests pass. C9 0 disagreements; its 4 WARN are from before (MASS_BUDGET.md models 274 screws against 342 fitted; GAPS.md dated D1 to D12; UPSTREAM_ISSUES.md lines 7 and 364 triaged against D1 to D12 only): fixing them needs a mass model change or a new triage, not a doc correction. Sim and test pass only.
- Open: the mass budget screw count and cable ties (sim owner); UPSTREAM_ISSUES.md against D13 to D25; bench/sim_profiles.py on the star profiles; the published page needs the lead's publish with the new data.
