aaltaay/Open_Duck_Mini_v2/altaay_lab/history/2026-11-01_2329_cables_3d_routed.md

# Every cable routed in 3D: seats on the brackets, ties, reach and bend checks

- When: 2026-11-01 11:29 PM (America/New_York)
- Source: this commit, branch claude/finish-pass; routing by the 3D cable sub-agent (agent C), on Ahmed's ask to see every cable end to end and how it seats on the brackets
- Written: 2026-11-01 by the Claude Code agent

- cables3d/: cables3d.json (45 active cables in 58 runs, each from its real connector or pad to its real far end, bound to the URDF links; 0 of 11,266 path samples inside any part against the exact meshes; seats, ties and terminal seats), CABLES_3D.md (per-cable table, findings, exact netlist edits, service loops, seats and ties per cable, gap list), VIEWER_NOTE.md, the scripts and 2 PNGs. Sim and CAD pass only.
- Checks: 31 cables pass the slack rule (20 mm per fixed end), 14 fail, 11 of those still reach taut; 39 of 42 joint loops meet the 3 x OD bend radius over the full range (the 3 head yaw loops only within the gamepad range); 93 ties (2.5 x 100 mm): 8 at stock holes or slots, 77 need stick-on mounts, 8 in free air need a guide.
- Build-blocking findings: D3 and D4 foot jumpers too short (route 54 mm, cut 40); D7 projector leads leave the module outside the head shell with no hole there; the ankle servo plugs sit 0.5 mm from the foot_side tip (test fit); the battery bay leads need new lengths with the corrected seats; the stick-on mounts were not in the BOM (being added).
- Exact cut_mm edits for the netlist are in CABLES_3D.md and are applied in the next netlist pass together with the power path fix.
