aaltaay/Open_Duck_Mini_v2/altaay_lab/history/2026-11-01_2329_tie_mounts.md

# Adhesive tie mounts, the cable tie count and isopropyl alcohol in the BOM

- When: 2026-11-01 11:29 PM (America/New_York)
- Source: this commit, branch claude/finish-pass; work by the BOM sub-agent (agent T) for the lead, after Ahmed asked for the adhesive tie mounts and the cable ties in the BOM "so I don't think about it"
- Written: 2026-11-01 by the Claude Code agent

- Count from altaay_lab/cables3d/cables3d.json, file of 2026-11-01 11:26 PM ET (04:26:18 UTC), which the cable agent is still reworking: 93 retention points, each with a 2.5 x 100 mm nylon tie: 77 adhesive tie mounts (all at gaps where the CAD has no tie anchor), 8 ties through 5 mm holes in knee_to_ankle_right_sheet (6) and neck_right_sheet (2), 8 ties around the bundle in free air (the cable agent notes a printed guide is needed to fix the cable there). No printed guides and no "gap: ..." kinds. Earlier copies read during this pass held 111 points with 98 mounts (04:07 UTC) and 90 points with 75 mounts (04:22 and 04:23 UTC).
- BOM.md line 34 (new, "Cables, connectors, wire", after line 32): adhesive tie mount, HellermannTyton 151-01629 (MB3A): 19 x 19 x 4.8 mm, 3M VHB acrylic foam, two predrilled 3.0 mm screw holes at 13.2 mm centres, ties up to 3.6 mm wide, PA66 heat and UV stabilized, -40 to +80 C (HellermannTyton spec sheet, read 11:17 PM ET). Need 77, 93 with 20 % spares; Buy 1 pack of 100 from Standard Electric Supply, $58.00, read via search index (the site gives plain curl a Cloudflare challenge, HTTP 403; an older index copy shows $56.00). Read live with plain curl: Hisco $112.00 per 100, 0 on hand, 14 day maker lead time (11:18 PM ET); Panduit ABMM-AV-C VHB, no screw hole stated, Elliott Electric $131.00 per 100 (11:21 PM ET). The Spec column says: wipe the spot with isopropyl alcohol first; press 30 s; let the adhesive cure before loading.
- Line 35 (new, after line 34): isopropyl alcohol, Techspray 1610-P, 99.8 %, 1 pint, TestEquity, $14.33, in stock (11:25 PM ET), for the line 34 mount spots and the line 29 VHB tape spots. 3M's VHB surface preparation bulletin (a 50:50 alcohol and water wipe) was read via search index only; 3m.com refuses plain curl. Same-cart option at Home Depot: Max Pro ISO-3467, 10 oz, $16.99.
- Line 32: Need "1 to 3" becomes 93 along the cables plus 1 to 3 at the servo power splices and the USB slack coil (MOUNTING.md), 116 with 20 % spares, so Buy goes from 1 to 2 packs of 100 (+$9.41). Re-read with plain curl at 11:23 PM ET: still $9.41 a pack of 100, 0.1 in wide.
- Totals (audit/bom_totals.py): Cables, connectors, wire $204.04 (was $122.30); build $971.93 (was $890.19); build + expression $1,054.33; build + expression + tools $1,302.50 (was $1,220.76); test order unchanged at $226.46. bom.json rebuilt by audit/bom_md_to_json.py: 80 rows (was 78). Neither script needed a change. BOM.md "Last updated", the Change note under Totals and the order minimums paragraph also updated.
- Viewer: the pattern r"tie mount|adhesive (tie|cable) mount" in viewer/make_viewer_data.py now finds line 34 (checked read-only with viewer/bom_full.py bom_lines(): capacity 100 for the 77 mounts), and line 32 stays the only "cable tie" match (capacity 200). bom_full.py was not edited. BOM_FULL.md still shows "Adhesive tie mount, 95, MISSING" until the viewer owner reruns viewer/make_viewer_data.py --write-bom.
- Open: the count moved while the cable agent worked (98, 75, then 77 mounts). One pack of mounts covers up to 83 mounts with 20 % spares; the 2 packs of ties cover up to 163 retention ties plus the 3 MOUNTING.md ties. CABLES_3D.md still says the stick-on mounts are not in the BOM (for the cable agent). The viewer counts only the free-air ties against line 32, not the ties through mounts and holes; line 32 covers them all anyway. The 8 free-air spots need printed guides to fix the cable; no guide is in the BOM yet.
