aaltaay/Open_Duck_Mini_v2/altaay_lab/history/2026-11-02_0044_netlist_final_pass.md

# Netlist final pass: cables3d lengths, D23 ankle feeds, refs and labels, BOM and viewer rebuilt

- When: 2026-11-02 12:44 AM (America/New_York)
- Source: this commit; work by the netlist sub-agent (agent NL1) for the lead, from cables3d/CABLES_3D.md, sim/POWER_FIX.md (D23) and the questions in wiring/sheets/WIRING_SHEETS.md
- Written: 2026-11-02 by the Claude Code agent

- wiring/netlist.yaml (rev 2026-11-02): every CABLES_3D cut edit applied verbatim (D3 and D4 jumpers 110, D10 210/210/220, D11 120, P3 140, P6 and P8 150, P11 100, SD1 b 160); D7 stays 160 (D24 hole). P7: each 90 mm fuse holder lead gets a 16 AWG red extension at new splices JFI (20 mm, chain 110, needs 92; 20 mm is the shortest practical piece, so not the proposed 100) and JFO (40 mm, chain 130). D9: the 250 mm SG90 lead alone, no 26 AWG extension. SP4 and SP5 cables and wires exactly as CABLES_3D gives them (390 and 420 mm, V and G only); SV24 and SV14 BUS 1 V and G wired, data nc. Refs LED1 to LED3 and SW2; printable labels on SW1 (SW, GND) and U1 (IN+, IN-, 1+, 1-, 2+, 2-); servo pins numbered as the Feetech STS3215 sheet item 6-7 (1 GND, 2 Vcc, 3 signal; Waveshare counts the other way). No published gauge for the BEC output leads or the kit cables (Castle, Horizon, retailers, Feetech searched): kept as shipped, gauge strings unchanged because a dozen scripts key on them.
- audit/erc.py: 0 ERROR, 0 WARN, 8 INFO (the SG90 lead, USB and FPC gauges); 58 components, 51 cables (4 removed), 124 wires.
- Drawings: wiring/sheets/make_sheets.py draws all 124 wires (strict, 0 layout warnings): sheet 1 has JFI and JFO, sheet 2 has SP4 and SP5 at the ankle BUS 1 (one hop), sheet 5 their lanes. Checked that it stops on an undrawn wire. WIRING.md marks the three older drawings and their generators superseded. wiring/make_harness_build.py: SP4 and SP5 join the SP group, and a DATA-empty housing no longer says "V position left empty". CABLE_MAP.md and WIRING.md follow.
- BOM.md: lines 21 and 22 Need 7 and 17; wire Need L5 1.3, 24 3.5, 25 9.1 m; 17l the stocked BelMetric WFHV2.5X5SSA4 (0.3 mm, 16 needed, Buy 48 for the $5 minimum checkout, read 12:20 AM ET); 32 and 34 from cables3d.json of 11:50 PM ET; 28 Need 35.1 g; new T14 4.0 mm bit (D24) and T15 4.5 mm bit (C4 contingency), Drills and Cutters, read 12:36 AM ET; blocker text matched to HARDWARE_AUDIT. Build $955.29, with tools $1,287.75.
- fasteners.json: line 17k on F352 to F355, 17j on the 10 ISO 7380 sites. viewer/bom_full.py: the cable tie row counts every retention item with a tie (93). make_viewer_data.py --write-bom: 0 warnings, 355 screws, 47 cables in 62 runs, BOM_FULL 195 rows, none needs action.
- Open: cables3d.json still holds the old cuts (SP4 and SP5 at 545 mm), so verify C3 fails until cables3d is rerun on this netlist; D21, MOUNTING.md and the fasteners.json spec still say one 0.5 mm washer; verify C1 warns that BOM_FULL counts screws that are not fitted.
