aaltaay/Open_Duck_Mini_v2/altaay_lab/history/2026-11-02_0117_final_docs_pass.md

# Final docs pass: D23 and D24, bench gates, blockers B33 to B35, mass 2.65 kg, verification re-run

- When: 2026-11-02 1:17 AM (America/New_York)
- Source: this commit, branch claude/finish-pass; work by the docs sub-agent (agent NL2) for the lead, after the D22 print profile (agent PP, 12:22 AM ET) and the netlist final pass (agent NL1, 12:44 AM ET)
- Written: 2026-11-02 by the Claude Code agent

- DECISIONS.md: D23 ankle power feeds SP4 and SP5 (sim/POWER_FIX.md option 3b: ankle time under 6 V at a nominal pack 23.9 to 5.8 %, typical corner; no new purchases, +11.7 g; the 3S pack held until the TEST_PLAN 9 walking log) and D24 drill a 4.0 mm hole in the printed head for the D7 projector leads instead of editing head.stl (D7 stays 160 mm), both 12:12 AM ET after PP's D22. D21 note (12:47 AM ET, from NL1's BOM): two stocked 0.3 mm washers per eye screw, 2.4 mm engaged, 0.6 mm to the pilot floor, 16 needed, 48 on the buy list.
- TEST_PLAN.md: 3.2 holder under 0.10 V and the 2815 output read; 4.1 BEC dropout pass (input minus 0.30 V at 7.0 V and 6 A); 4.2 a 10 minute 6.0 A heat check of the Pololu 2815 (sim RMS 99 to 101 % of its rating with D23; a second 2815 fits below it); 5 the 40 mOhm gate with SP4/SP5 and the corrected sim corners (27.6 and 65.1 mOhm); 9 counted in time, not in 50 Hz samples, with the D23 numbers; new 1.5 foot_side test fit; new 8.2a hip yaw limit (find_soft_offsets.py at 376de65 clamps nothing); 8.0 weight 2.65 +/- 0.05 kg; 11 exit code 10.
- sim/POWER_PATH_SIM.md: the 7 star rows and the D23 rows (1, 3b, 6+3b) as sim/POWER_FIX.md writes them; item 4 superseded.
- HARDWARE_AUDIT.md section 6: B33 ankle plugs and SP4/SP5 at the foot_side apex, B34 the D24 hole (decided), B35 the 12 free-air tie points; B18 cleared on paper (0.9 m cable, 523 mm worst route); B1 221 screws by size (C9 fix). 21 of 35 cleared or decided, 2 waiting on the parts check, 5 coupon, 7 assembly or bench. Print-blocking: none. Washers and the T14 bit follow NL1's BOM.
- MOUNTING.md: BNO055 wires from the underside, adapter USB-C side exit, the fuse holder lead 4 mm from the wall and its JFI and JFO extensions, XT30 and amp seats, seat centres from audit/placements.json, two 0.3 mm eye washers, B13 status corrected.
- viewer/MISSING_3D.md: seat-fit table from placements.json and blueprint/coverage.json (all 6 taped parts on their tape within 0.04 mm; check_scene_extras.py still finds the P3 joint inside the holder); screws, washers, cables and ties rows from the 1:05 AM viewer run.
- STATE.md rewritten short; START_HERE.md status, D1 to D24, 11 new repo map rows, next steps.
- Mass (lead's ask): sim/mass_budget.py places the new splices JFI and JFO at the fuse holder seat (audit/placements.json); re-run gives 2651.9 g, +26 % (was 2638.6 g; wires 107.7 to 121.0 g). MASS_BUDGET.md tables and text updated. The walk results stay at their earlier masses (13 g, about 0.5 %, lighter); one pointer line each in sim/ADDED_MASS_SIM.md and RUNTIME_THERMAL.md.
- Fasteners (lead's ask): fasteners.json eye washers two 0.3 mm (e 2.4, tip gap 0.6); make_fasteners.py reads BOM lines 17a to 17z and writes the same washer; report_fasteners.py counts washers on line 17l and was re-run: 342 screws to fit, 221 to buy, 16 washers, every BOM line matches.
- Cables (lead's ask): cables3d.json cut lengths synced from the netlist without re-routing (24 values; P7's holder leads and extensions summed, 110 and 130 mm), then check_cables.py and make_report.py; CABLES_3D.md marks the 5 applied findings. 44 of 47 cables meet the slack rule; D12, S2 and S7 are fixed-length parts that fit taut.
- verify/ (lead's ask, stale expectations): c9 reads BOM 27's PLA need from print/PRINT_PLAN.md and the mass from MASS_BUDGET.md; c8 compares with the walk run within 1 % of the mass; e6b models the netlist wiring (D23) through sim/power_fix.py on both traces and runs after c8; c3 sums pieces joined at an unrouted splice; e1 counts from the netlist; report.py run notes and hardware rows current. Viewer rebuilt: BOM_FULL 195 rows, 814 pieces, needs_action 0.
- VERIFICATION.md, full run 1:05 to 1:16 AM ET: 22 checks, 21 PASS, 1 FAIL, 0 NOT RUN (first run 12:46 AM: 19 PASS, 2 FAIL, 1 NOT RUN). E1 catches 10 of 10 injected faults; E8 56 tests pass; C1 no FAIL; C4a pass; C8 0 falls in 36 flat runs at 2.65 kg; C9 0 disagreements; E6b 6.7 % at the 40 mOhm gate. Still FAIL: C3, the 20 mm ground tails of SP2 and SP3 (JG10, JG30) route 21 mm.
- Open for other owners: SP2 and SP3 tail cut (netlist), or C3 judging floating splices by chain as check_cables.py does; bench/power_log.py needs a read on its own timer for TEST_PLAN 9; make_report.py findings text is hard-coded and P7 has no JFI and JFO splits in the routes; blueprint/scene_extras.json still draws one 0.5 mm washer per eye screw; coupon T1 clamps 5.5 mm, the robot stack is now 5.6 mm (print/); the viewer manifest shows the print set before D22 (1409.0 g); E6 and C7 still model the star wiring without the D23 feeds; README.md mass note, GAPS.md and UPSTREAM_ISSUES.md decision ranges (C9 WARN).
