aaltaay/Open_Duck_Mini_v2/altaay_lab/history/2026-11-01_2233_software_bench_scripts.md

# Software path and bench scripts, tested on a simulated servo bus

- When: 2026-11-01 10:33 PM (America/New_York)
- Source: this commit, branch claude/every-part; work by the software sub-agent (agent S)
- Written: 2026-11-01 by the Claude Code agent

- software/: PI_SETUP.md (13 cited steps from a blank SD card to walking), SOFTWARE.md (what runs where, a cross-check of the Runtime config and code against our build), constraints-bookworm.txt, a udev rule, odm-walk-guard.service, a poweroff-only sudoers line, check_pi_setup.sh (read-only), duck_config.altaay.json.
- bench/: first_servo_check.py (TEST_PLAN 6, 7), power_log.py (8.1, 9), battery_guard.py and walk_with_guard.py (11, with a servo temperature guard: warn at the servo's own limit minus 15 C, stop at minus 8 C), imu_check.py (10), feet_check.py (12), crosscheck.py, timing_budget.py, the shared odm_bench library and 53 pytest tests. The tests use the real Runtime 376de65 code, rustypot 0.1.0, pypot, onnxruntime with BEST_WALK_ONNX_2 and adafruit_bno055; only the hardware is simulated (a Feetech bus on a pty, fake Pi pins, a byte-level BNO055). Sim and test pass only: nothing has run on a real Pi.
- Build-blocking findings: (1) today's Raspberry Pi OS (Trixie, Python 3.13) cannot install the Runtime's pinned packages: use Bookworm 2026-10-06; Blinka must be pinned to 9.2.0 with RPi.GPIO 0.7.1; (2) pypot flushes before every send, which on the cdc-acm driver can cancel writes in flight; on the simulated bus the stock configure script left register 85 at 50 (the G1 symptom); our scripts drain, read every register back and fix it (real-adapter rate UNVERIFIED); (3) D16 cannot be applied literally while walking (servo voltage reads 6.0 V near 3.57 V per cell): walk stop on a 5 s mean at or under 6.0 V while walking, hard stop at 6.0 V standing or 5.4 V walking.
- Notes: the upstream 0.2.3 image starts an unguarded walk at boot (use the manual install); the Runtime's rustypot panic (G10) is reproduced and the guard turns torque off through pypot instead; the star-wiring sim predicts the TEST_PLAN 9 ankle gate fails at nominal charge (30 to 34 % of the walk under 6 V), so a power path follow-up is running.
