aaltaay/Open_Duck_Mini_v2/altaay_lab/history/2026-11-01_2257_fastener_decisions.md

# Fastener decisions D19 to D21 applied to the BOM and docs, plus the software agent's doc edits

- When: 2026-11-01 10:57 PM (America/New_York)
- Source: this commit, branch claude/every-part; work by the docs sub-agent (agent I3) from fasteners/FASTENERS.md, with the software agent's proposed edits (software/SOFTWARE.md) passed on by the coordinator
- Written: 2026-11-01 by the Claude Code agent

- DECISIONS.md (10:50 PM ET): D19 M3x6 ISO 7380 A2 button heads at the 10 hip pitch sites (8 idle horn, F002, F010), CAD clearance +0.16 and +1.16 mm, checked on the first leg as for D18; F198 and F211 still meet body_middle_bottom past 21.7 deg of hip yaw (joint range note). D20 drill the 24 neck chain recesses from 5.5 to 6.0 mm after printing and the 4 battery lid holes from 2.5 to 2.7 mm; coupon C4 already holds 4 of these recesses and 4 of the 4.0 mm M2 recesses, so it carries the fit test. D21 eye screws M2.5x8 with one 0.5 mm washer: 2.5 mm engaged, 0.5 mm to the blind pilot floor. D16 note from the software agent: walk stop on the 5 s mean of the 14-servo median at or under 6.0 V while walking (about 3.57 V per cell, sim), 6.0 V hard stop standing, 5.4 V hard stop walking; the 6 V fixed regulator fallback needs a pack voltage sense.
- BOM.md: Need 17a 44 to 28 (Buy 33), 17d 88 to 78, 17e 12 to 28 (Buy 33), 17h 6 to 30 by size. The METALLIXITY kit holds 50 of each size and has a 3.7 x 1.4 mm M2 head (its Amazon page by plain curl, 10:30 PM ET, and its listing images, 10:31 PM ET), so it needs no extra line. Bolt Depot refused plain curl (HTTP 403, Cloudflare challenge, 10:30 PM ET), so the new lines are from BelMetric (US): 17j M3x6 ISO 7380-1 A2 SB3X6SS, $0.09 each, 12 for $1.08 (10:34 PM ET); 17k M2.5x5 DIN 912 A2 BSH2.5X5SS, $0.12 each, 5 for $0.60 (10:36 PM ET); 17l M2.5 ISO 7092 A2 washer 2.7 x 5.0 x 0.5 mm, $0.01 each but only in a special order box of 2000, $20.00 (10:36 PM ET). Tools from Drills and Cutters (Doral, FL, 10:42 PM ET): T11 6.0 mm HSS bit $1.41, T12 2.7 mm HSS bit $0.74, T13 T-handle holder $7.99. Test order TO16 ($9.65) brings the C4 recess test parts.
- Totals (audit/bom_totals.py): fasteners and mechanical $90.39 (was $68.90), build $890.19 (was $868.70), build + expression $972.59, build + expression + tools $1,220.76 (was $1,189.13), test order $226.46 (was $216.81). bom.json rebuilt by audit/bom_md_to_json.py: 78 rows (was 72). Neither script needed a change.
- MOUNTING.md: Eyes, Second board.stl copy and Speaker rows with the FASTENERS.md section 9 text (the left eye skin measures 1.3 mm, the right 1.5 mm); IMU line now raw_imu.py lines 27 to 48 with the calibrate_imu.py then imu_check.py --tilt test; screw count adds M2.5x5 and the washers.
- HARDWARE_AUDIT.md: intro and section 1 from fasteners/ (342 to fit: 221 bought, 59 from the servo bags, 56 factory, 6 SG90; 13 left out; 8 washers). B2, B7 (basis corrected, finding 22), B8 (speaker_interface screws), B14, B20 (tilt test wording), B21 and B30 updated; new B31 (hip pitch heads, D19) and B32 (neck recesses, D20). Count: 19 of 32 cleared or decided, 2 parts check, 5 coupon, 6 bench. Print-blocking: none.
- print/PRINT_PLAN.md and print/make_coupons.py: C4 test adds the recess fit (the script now measures 4 recesses of 5.50 mm and 4 of 4.00 mm); T1 measures the blind pilots (3.0 mm deep, 1.3 mm skin) and clamps 5.5 mm under the head as in the robot; new first-leg check 5 (D19); new "After printing" drill steps (D20). make_coupons.py ran into a scratch folder: all 7 coupons OK; cut boxes unchanged, so the coupon STLs and slice numbers stand.
- TEST_PLAN.md (software agent's edits): 6 passes on bench/first_servo_check.py --steps 6 finding exactly one servo (USB 1a86:55d3); 7.1 adds --configure ID --fix-config and a power-cycle re-read of register 85; 7.3 repeats at a lower current if the servo unloads; 9 logs with bench/power_log.py --walk and records that the star-wiring replay puts the ankles at 30% and 34% under 6 V at nominal, so that gate is expected to fail as wired; 10.2 runs calibrate_imu.py from scripts/, then bench/imu_check.py --tilt; 11 points to bench/battery_guard.py and walk_with_guard.py with the D16 note rule; 12 uses bench/feet_check.py --presses 200, never fc_test.py.
- START_HERE.md repo map: rows for BOM_FULL.md, fasteners/, cables3d/, software/ and bench/; HARDWARE_AUDIT now lists 32 BLOCKERS.
- Open: line 17l costs $20.00 for 8 washers (box of 2000, 1 to 2 weeks); the stocked BelMetric WFHV2.5X5SSA4 is $0.07 each but its page lists 0.3 mm thick. T13 grip on round bit shanks is not stated by the seller. BOM_FULL.md still needs a rebuild by the viewer owner (viewer/make_viewer_data.py --write-bom was not run here).
