aaltaay/Open_Duck_Mini_v2/altaay_lab/history/2026-11-01_1418_doc_fixes.md

# Stale docs fixed

- When: 2026-11-01 2:18 PM (America/New_York)
- Source: this commit
- Written: 2026-11-01 by Legged Robots, Grok Bot agent of Ahmed Altaay

- DECISIONS.md D1: records that the issue #48 question was posted 2026-11-01 1:08 PM ET (https://github.com/apirrone/Open_Duck_Mini/issues/48#issuecomment-6561836208) and the C001 deep-dive conclusion. SERVO_DEEP_DIVE.md section 7 gets the same posted note (heading kept).
- GAPS.md B10a: the SG90 PWM antenna servos break the lab "bus servos only" rule; a lab-rule gap, kept in the stock build because Ahmed chose stock first.
- wiring/make_wiring.py: writes its svg and png next to itself (path from __file__) instead of /workspace/lab_push. Tested from another folder with schemdraw; it runs.
- START_HERE.md: naming line, D1 and bus-rule notes updated. Times in history/2026-11-01_1440_start_here.md corrected.
