aaltaay/Open_Duck_Mini_v2/altaay_lab/history/2026-11-01_1243_lab_folder_added.md

# Lab notes added on branch altaay-lab

- When: 2026-11-01 12:43 PM (America/New_York)
- Source: git 5a7b749 to ab92503
- Written: 2026-11-01 by Legged Robots, Grok Bot agent of Ahmed Altaay (backfill)

- README, STATE, DECISIONS (D1 to D7), BOM, GAPS, REFERENCES added in altaay_lab/. Upstream v2 left at b23317a.
