aaltaay/Open_Duck_Mini_v2/altaay_lab/history/2026-11-01_1251_stair_exempt.md

# Duck exempt from the stair rule

- When: 2026-11-01 12:51 PM (America/New_York)
- Source: git 4a61d37, DECISIONS.md
- Written: 2026-11-01 by Legged Robots, Grok Bot agent of Ahmed Altaay (backfill)

- Ahmed: the duck is exempt from the 15-step stair rule (legs too short, GAPS.md B7). Dock and get-up are not exempt.
