aaltaay/Open_Duck_Mini_v2/altaay_lab/history/2026-11-01_1302_servo_deep_dive.md

# Servo deep dive: C001 at about 85 %

- When: 2026-11-01 1:02 PM (America/New_York)
- Source: git e451452, SERVO_DEEP_DIVE.md
- Written: 2026-11-01 by Legged Robots, Grok Bot agent of Ahmed Altaay (backfill)

- STS3215 7.4 V 1:345 (C001) matches upstream BAM identification (about 5.43 rad/s no load). Issue #48 tracking looks like a setup, firmware or supply problem.
