aaltaay/Open_Duck_Mini_v2/altaay_lab/history/2026-11-01_1309_bec_decided.md

# Servo regulator decided (D3)

- When: 2026-11-01 1:09 PM (America/New_York)
- Source: DECISIONS.md, git ab46062
- Written: 2026-11-01 by Legged Robots, Grok Bot agent of Ahmed Altaay (backfill)

- Ahmed: servos never above 7.4 V. Lab pick: Castle CC BEC Pro at 7.2 V plus a Littelfuse 15 A ATO fuse. Nothing bought.
- Same commit (1:21 PM): POWER.md, WIRING.md and schematic, stock walk sim check (no falls, 0.097 m/s, sim pass only).
