aaltaay/Open_Duck_Mini_v2/altaay_lab/history/README.md

# history/

One file per entry: `YYYY-MM-DD_HHMM_<topic>.md`, time in America/New_York. Add a new file for each milestone or decision. Never edit an old entry; if it was wrong, write a new entry that says so. This avoids merge conflicts between agents.
