aaltaay/Open_Duck_Mini_v2/altaay_lab/history/2026-11-12_2155_sts12_runc.md

# Run C retrain filed

2026-11-12 9:55 PM ET. The policy, the eval table, the reward note, the curve, the eval script, and the patched joystick file are in problems/retrain_sts12/. Sim pass only.

Run C walks 60 s with no fall on both corners, up to 0.252 m/s typical at a 0.40 m/s command. No flight phase. A 0.10 m/s command stands still. Pack peak 15.6 A at 0.40 m/s is a watch item inside the 13 A to 21 A trip band. Knee minimum 9.31 V. The 0.088 m/s old-policy result in problems/FIT3.md is superseded and kept.
