aaltaay/Open_Duck_Mini_v2/altaay_lab/history/2026-11-12_1813_fcc_covered_robot.md

# 2026-11-12 6:13 PM ET: the Covered List robot notice, quoted

Labels: quotes are from DA 26-786, opened this session. The body and Appendix A come from the PDF text layer. Appendix B and Appendix C are page images in that PDF. The weight conversion stays calc only. Nothing was bought. No one was contacted.

- compliance/FCC_COVERED_ROBOT.md quotes DA 26-786 (released 2026-07-28) and applies the robot definition to a duck made of foreign parts. It is not legal advice.
- The notice bars covered equipment from receiving an equipment authorization. It does not, in the pages read, cancel an existing grant. A later limitation on existing grants has its own rule and was not found as part of this notice.
- COMPLIANCE.md now points at that file. The bill was not edited. DECISIONS.md was not edited.
