aaltaay/Open_Duck_Mini_v2/altaay_lab/history/2026-11-12_1817_fcc_review_fix.md

# 2026-11-12 6:17 PM ET: Covered List note, authorization triggers

The Codex review on the Covered List note said 47 CFR 2.903(b) uses "one or more", so the two component bans are alternatives. The note had said both were required. That sentence is replaced. A host with either a covered modular transmitter or listed-producer logic hardware is barred from a new authorization. The Pi board, on the pages read, meets neither trigger. Nothing was bought. No one was contacted.
