aaltaay/Open_Duck_Mini_v2/altaay_lab/history/2026-11-12_1807_us_sale_compliance.md

# 2026-11-12 6:07 PM ET: US sale rules and the restricted-party check

Labels: list files were downloaded and counted this session. Rule text was opened where COMPLIANCE.md says opened. Sim mass and watt-hours stay labeled in that file. Nothing was bought. No agency filing was made.

- altaay_lab/compliance/COMPLIANCE.md is the sale note. It is not legal advice. It builds on COMPLIANCE_FIRST_PASS.md.
- The party lists (SDN, Entity List, Military End User, UFLPA, the named FCC companies, NDAA section 889) have no hit on a maker that was screened. Marketplace brands were screened as the brand string. Legal names for several of them were not opened.
- The FCC Covered List notice of 2026-07-28 adds foreign-produced advanced robotic devices. On the definition that was read, the duck can fall in that category if it is not a domestic end product. That is the sale blocker. It is not a supplier record.
- PARTS_CHECK.csv is one row per bill line plus the nest parts that are not on the bill.
- DECISIONS.md was not edited. The bill was not edited.

STATE.md was not edited.
