aaltaay/Open_Duck_Mini_v2/altaay_lab/history/2026-11-05_1730_v1_companion_d48.md

# V1 track 11: D48 accuracy, self-noise, hybrid; c1, c3 and c10 follow-up

2026-11-05 about 5:30 PM ET (America/New_York). Supersedes nothing; adds to 2026-11-05_1658_v1_companion_hw.md.

- c1 on origin/altaay-lab (c202be5) with a fresh viewer build: 18 FAIL lines (CTL, line 1 count, line 12 count, the
  stale BOM_FULL line, S01 to S14). This branch: 17, the same lines without the stale BOM_FULL one. No new FAIL.
- D14 and D15 routed in 3D (twin/companion/route_mics.py, mic_routes.json); c3 shows only the D13 FAIL of the base.
- Sheet 4 draws D13, D14, D15 and the new GPIO16 to amp SD wire; the generator runs again: c10 PASS (was FAIL on the
  base). ERC outputs refreshed: e1 PASS (was FAIL on the base).
- D48 (Ahmed about 2:45 PM ET): research and hardware changes in twin/companion/COMPANION.md section 11; section and
  close-up pictures of the seats (mic_section.png, mic_seat_left.png, mic_seat_right.png), looked at.
- Checks: c1 17 (base 18), c2 1 and c3 1 (both the base D13 FAIL), c4 PASS, c6 PASS, c9 PASS, c10 PASS, e1 PASS,
  e2 PASS, e3 PASS, e4 2 (base), viewer load test STATE loaded, ERRORS none.
