aaltaay/Open_Duck_Mini_v2/altaay_lab/history/2026-11-01_2325_rule_merge_after_every_job.md

# Rule: merge after every job and delete the branch

- When: 2026-11-01 11:25 PM (America/New_York)
- Source: Ahmed in chat: "Make it a standard rule after every job done you need to merge. I do not want to leave any ... branches that is just like left behind dangling."
- Written: 2026-11-01 by the Claude Code agent

- START_HERE.md "How to contribute without conflicts" gains the rule: when a job is done, open its PR into altaay-lab, merge it, then delete the branch on GitHub and locally. Long-lived branches are only altaay-lab and the upstream v1 and v2.
- Applied now: PR 4 merged, claude/every-part and the already merged claude/print-ready deleted. The Spark session was told the same rule.
