aaltaay/Open_Duck_Mini_v2/altaay_lab/history/2026-11-01_1440_start_here.md

# START_HERE.md and history/ added

- When: 2026-11-01 2:13 PM (America/New_York)
- Time corrected 2026-11-01: the time in the file name was wrong; the real time above is from git commit ff74bad.
- Source: this commit
- Written: 2026-11-01 by Legged Robots, Grok Bot agent of Ahmed Altaay (backfill)

- Added altaay_lab/START_HERE.md and altaay_lab/history/. No other file changed. Next lab step: freeze, then assembly map.
