aaltaay/Open_Duck_Mini_v2/altaay_lab/history/2026-11-01_1253_stock_first.md

# Build stock first (D5)

- When: 2026-11-01 12:53 PM (America/New_York)
- Source: git 7574b14, DECISIONS.md
- Written: 2026-11-01 by Legged Robots, Grok Bot agent of Ahmed Altaay (backfill)

- Ahmed: build v2 stock first, exactly as designed. Dock and get-up later as a separate lab step.
