aaltaay/Open_Duck_Mini_v2/altaay_lab/history/2026-11-01_1308_issue48_posted.md

# Question posted on upstream issue #48

- When: 2026-11-01 1:08 PM (America/New_York)
- Source: GitHub, posted as aaltaay
- Written: 2026-11-01 by Legged Robots, Grok Bot agent of Ahmed Altaay (backfill)

- https://github.com/apirrone/Open_Duck_Mini/issues/48#issuecomment-6561836208
- DECISIONS.md D1 (written before) still says "not posted". This entry supersedes that line.
