aaltaay/Open_Duck_Mini_v2/altaay_lab/problems/retrain_sts12/eval_table.md

Superseded 2026-11-13: the BEC set point in this table is 16 V. The live set point is 12.0 V. The new run is eval_table_bec12.md. This table is kept.

Sim pass only. 60 s sheet walk, 12 V STS3215, 3S P45B, BEC set point 16 V, 70 g cell, both corners, run C policy. Every number in the table is sim pass only.

| Cmd m/s | Corner | Fall | Body speed m/s | Flight phase (frac) | Double support frac | Action rate | Joint jerk RMS rad/s3 | Pitch RMS deg | Roll RMS deg | Knee min V L / R | Pack peak A | Pack 100 ms peak A |
|---|---|---|---|---|---|---|---|---|---|---|---|---|
| 0.1 | typical | none in 60 s | -0.0 | no (0.0) | 1.0 | 0.00238 | 48.7 | 0.331 | 0.477 | 10.936 / 10.955 | 8.955 | 5.96 |
| 0.1 | high-side | none in 60 s | -0.0 | no (0.0) | 1.0 | 0.0024 | 48.5 | 0.324 | 0.474 | 10.631 / 10.673 | 8.903 | 5.91 |
| 0.15 | typical | none in 60 s | 0.108 | no (0.0) | 0.4617 | 0.1482 | 613.4 | 0.563 | 3.502 | 10.829 / 10.925 | 8.955 | 6.523 |
| 0.15 | high-side | none in 60 s | 0.1042 | no (0.0) | 0.4767 | 0.15277 | 604.3 | 0.566 | 3.467 | 10.45 / 10.602 | 8.903 | 6.42 |
| 0.2 | typical | none in 60 s | 0.1478 | no (0.0) | 0.4346 | 0.22099 | 700.7 | 0.559 | 3.566 | 10.435 / 10.597 | 10.782 | 8.637 |
| 0.2 | high-side | none in 60 s | 0.1413 | no (0.0) | 0.4515 | 0.22229 | 687.2 | 0.563 | 3.482 | 10.008 / 10.15 | 10.664 | 8.591 |
| 0.25 | typical | none in 60 s | 0.1731 | no (0.0) | 0.418 | 0.26665 | 742.9 | 0.692 | 3.542 | 10.128 / 10.241 | 12.898 | 10.102 |
| 0.25 | high-side | none in 60 s | 0.1658 | no (0.0) | 0.4377 | 0.26989 | 726.1 | 0.725 | 3.493 | 9.662 / 9.886 | 12.506 | 9.966 |
| 0.3 | typical | none in 60 s | 0.1951 | no (0.0) | 0.4028 | 0.29083 | 779.2 | 0.883 | 3.64 | 9.938 / 10.06 | 14.189 | 11.388 |
| 0.3 | high-side | none in 60 s | 0.1895 | no (0.0) | 0.4218 | 0.30464 | 759.3 | 0.93 | 3.568 | 9.362 / 9.473 | 14.411 | 11.43 |
| 0.4 | typical | none in 60 s | 0.2516 | no (0.0) | 0.3309 | 0.34465 | 819.3 | 1.317 | 3.939 | 9.809 / 9.814 | 15.57 | 13.011 |
| 0.4 | high-side | none in 60 s | 0.2399 | no (0.0) | 0.3491 | 0.34213 | 789.8 | 1.308 | 3.905 | 9.307 / 9.323 | 15.069 | 12.668 |
| seq 0.1/0.2/0.4/0.2/0.1 | typical | none in 60 s | 0.1186 | no (0.0) | 0.609 | 0.17106 | 599.4 | 1.44 | 3.044 | 9.908 / 9.936 | 15.764 | 13.231 |
|  | segments | 0.1: 0.0003, 0.2: 0.1491, 0.4: 0.2564, 0.2: 0.1467, 0.1: 0.0003 m/s | | | | | | | | | | |
| seq 0.1/0.2/0.4/0.2/0.1 | high-side | none in 60 s | 0.1134 | no (0.0) | 0.621 | 0.17132 | 582.8 | 1.427 | 2.983 | 9.426 / 9.41 | 15.643 | 12.821 |
|  | segments | 0.1: 0.0003, 0.2: 0.1413, 0.4: 0.2445, 0.2: 0.1401, 0.1: 0.0003 m/s | | | | | | | | | | |
