aaltaay/Open_Duck_Mini_v2/altaay_lab/problems/retrain_sts12/eval/twin_C/walk.png

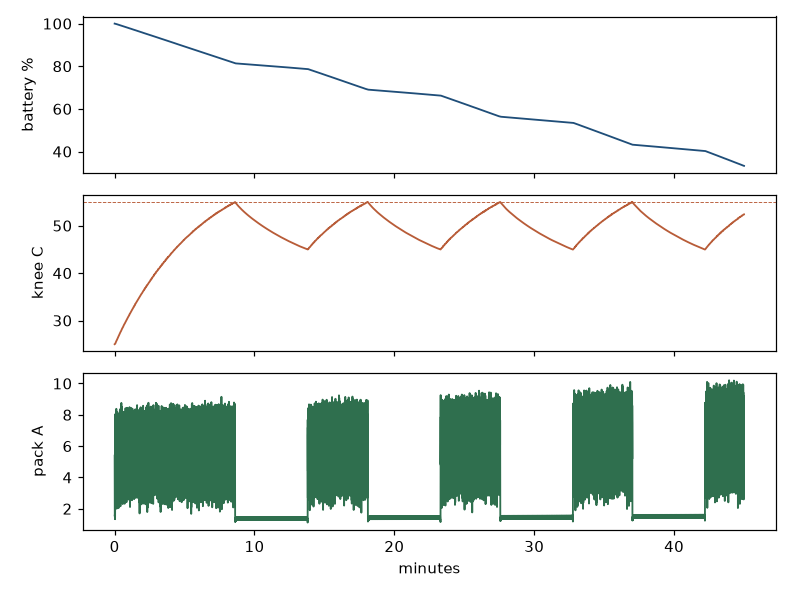
altaay_lab/problems/retrain_sts12/eval/twin_C/walk.png
