aaltaay/Open_Duck_Mini_v2/altaay_lab/problems/retrain_sts12/reward_curve.png

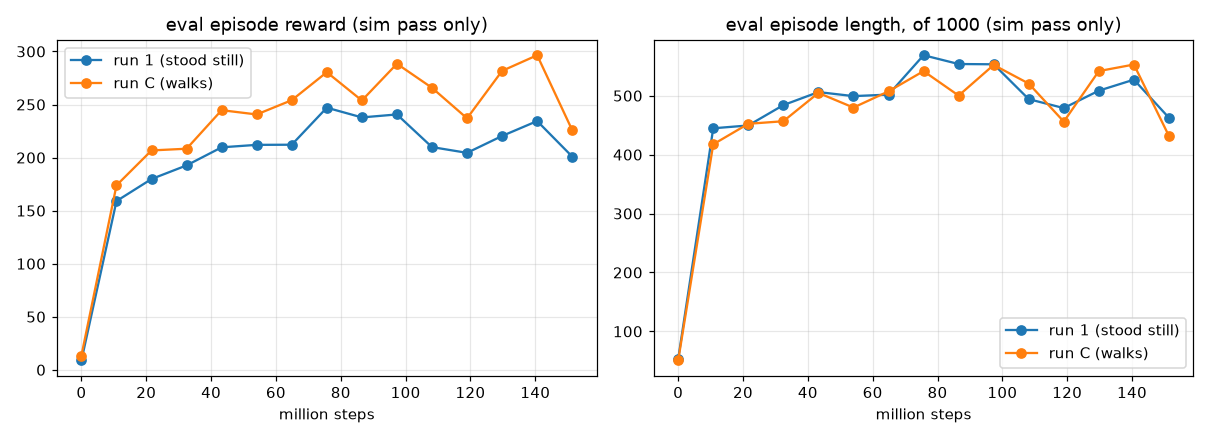
altaay_lab/problems/retrain_sts12/reward_curve.png
