aaltaay/Open_Duck_Mini_v2/altaay_lab/sim/power_fix_ankle_trace.png

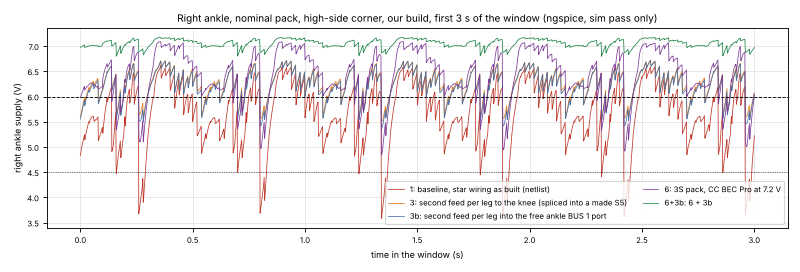
altaay_lab/sim/power_fix_ankle_trace.png
