aaltaay/Open_Duck_Mini_v2/altaay_lab/circuitry/bq24133_board.kicad_sch

## KiCad design altaay_lab/circuitry/bq24133_board.kicad_sch (2026-11-14)

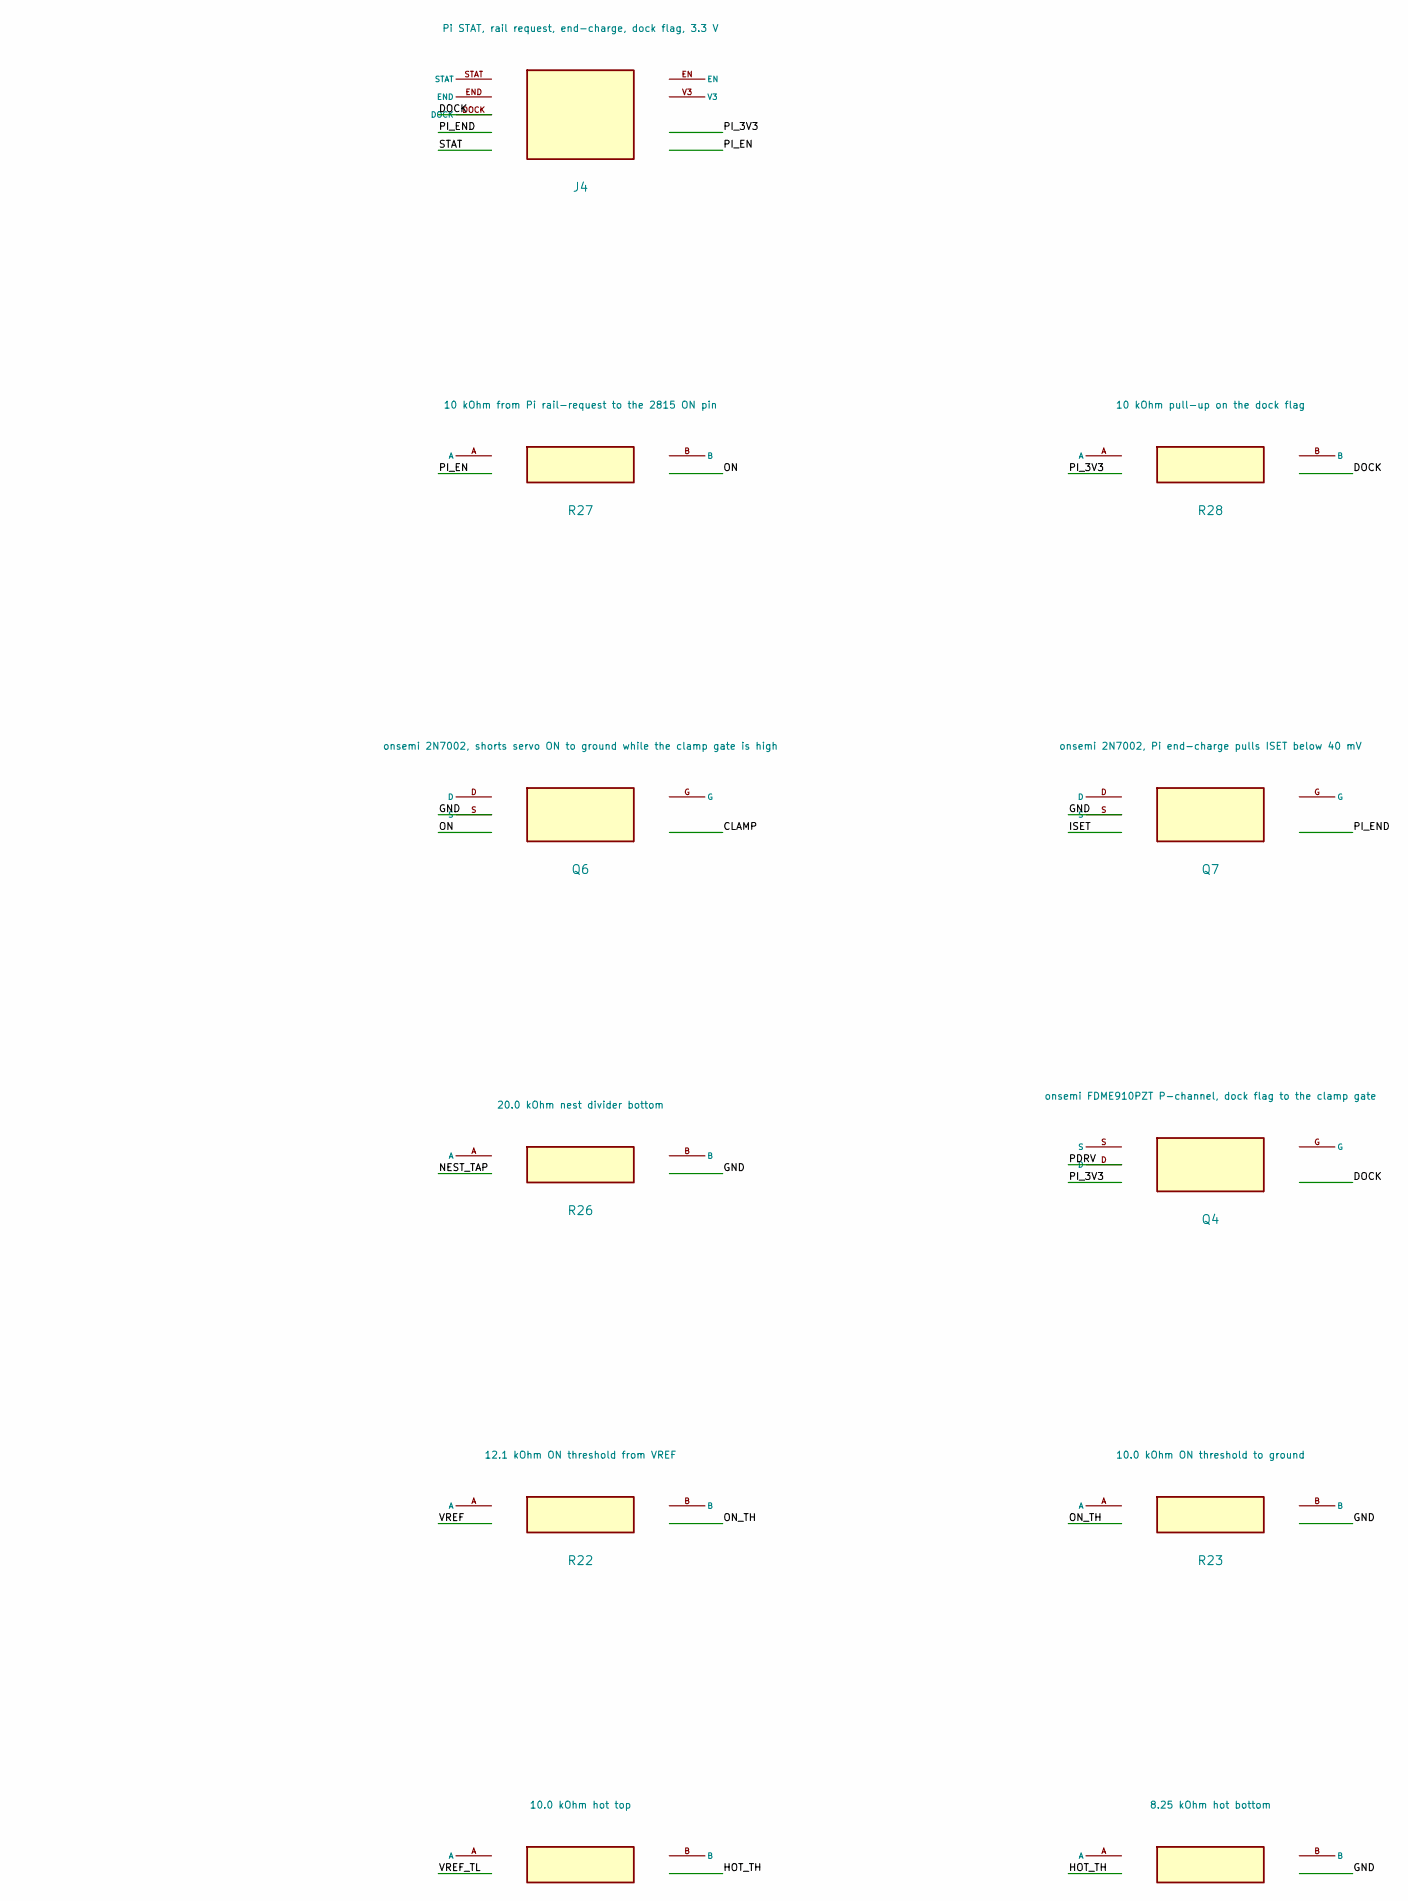
[picture p222: schematic bq24133_board.kicad_sch, part in row 1, column 1]

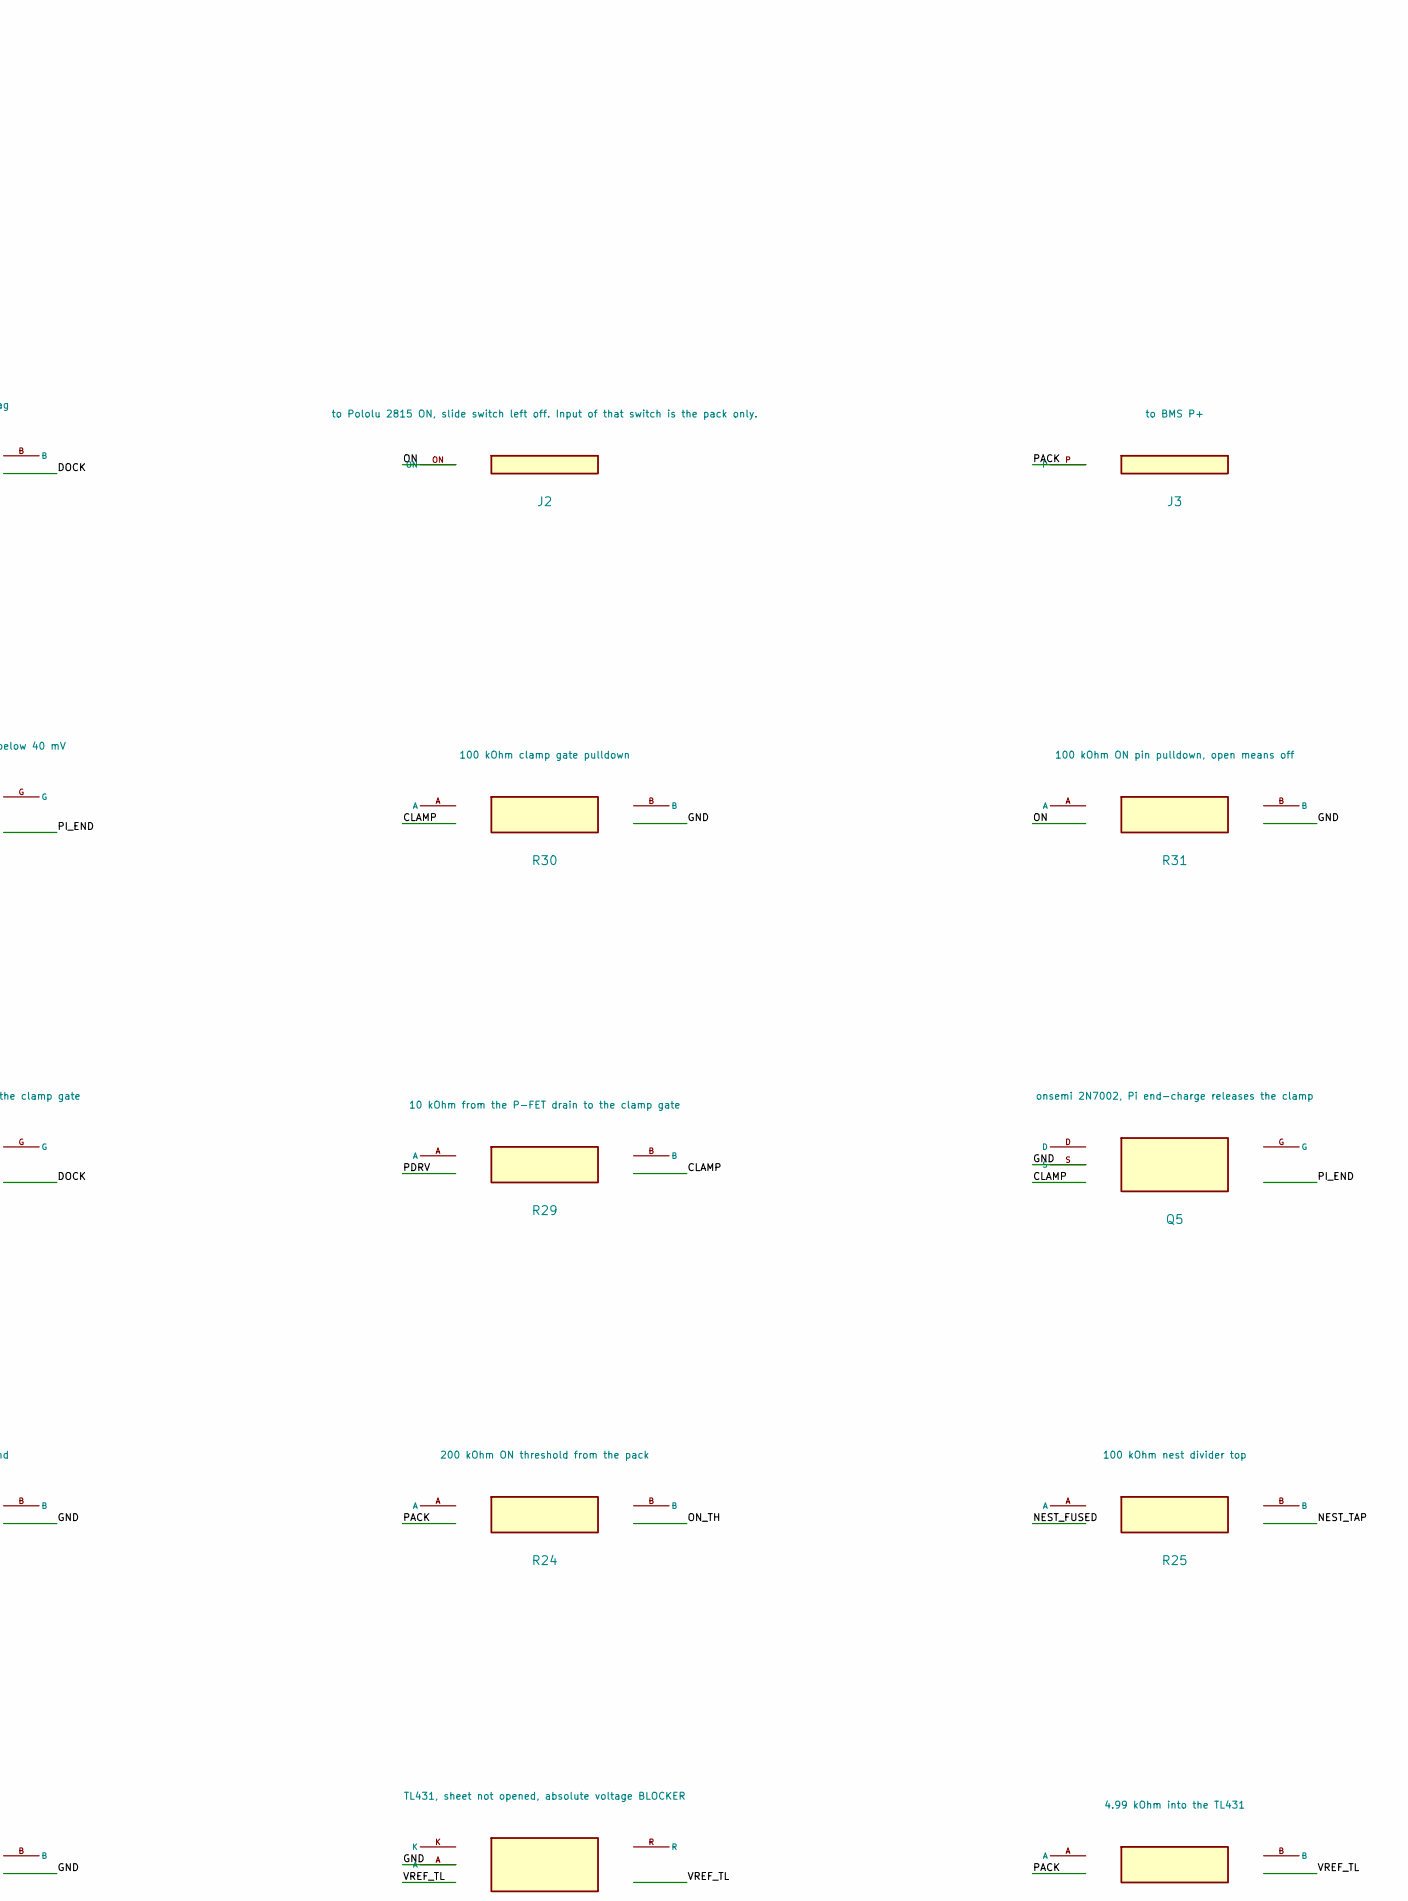
[picture p223: schematic bq24133_board.kicad_sch, part in row 1, column 2]

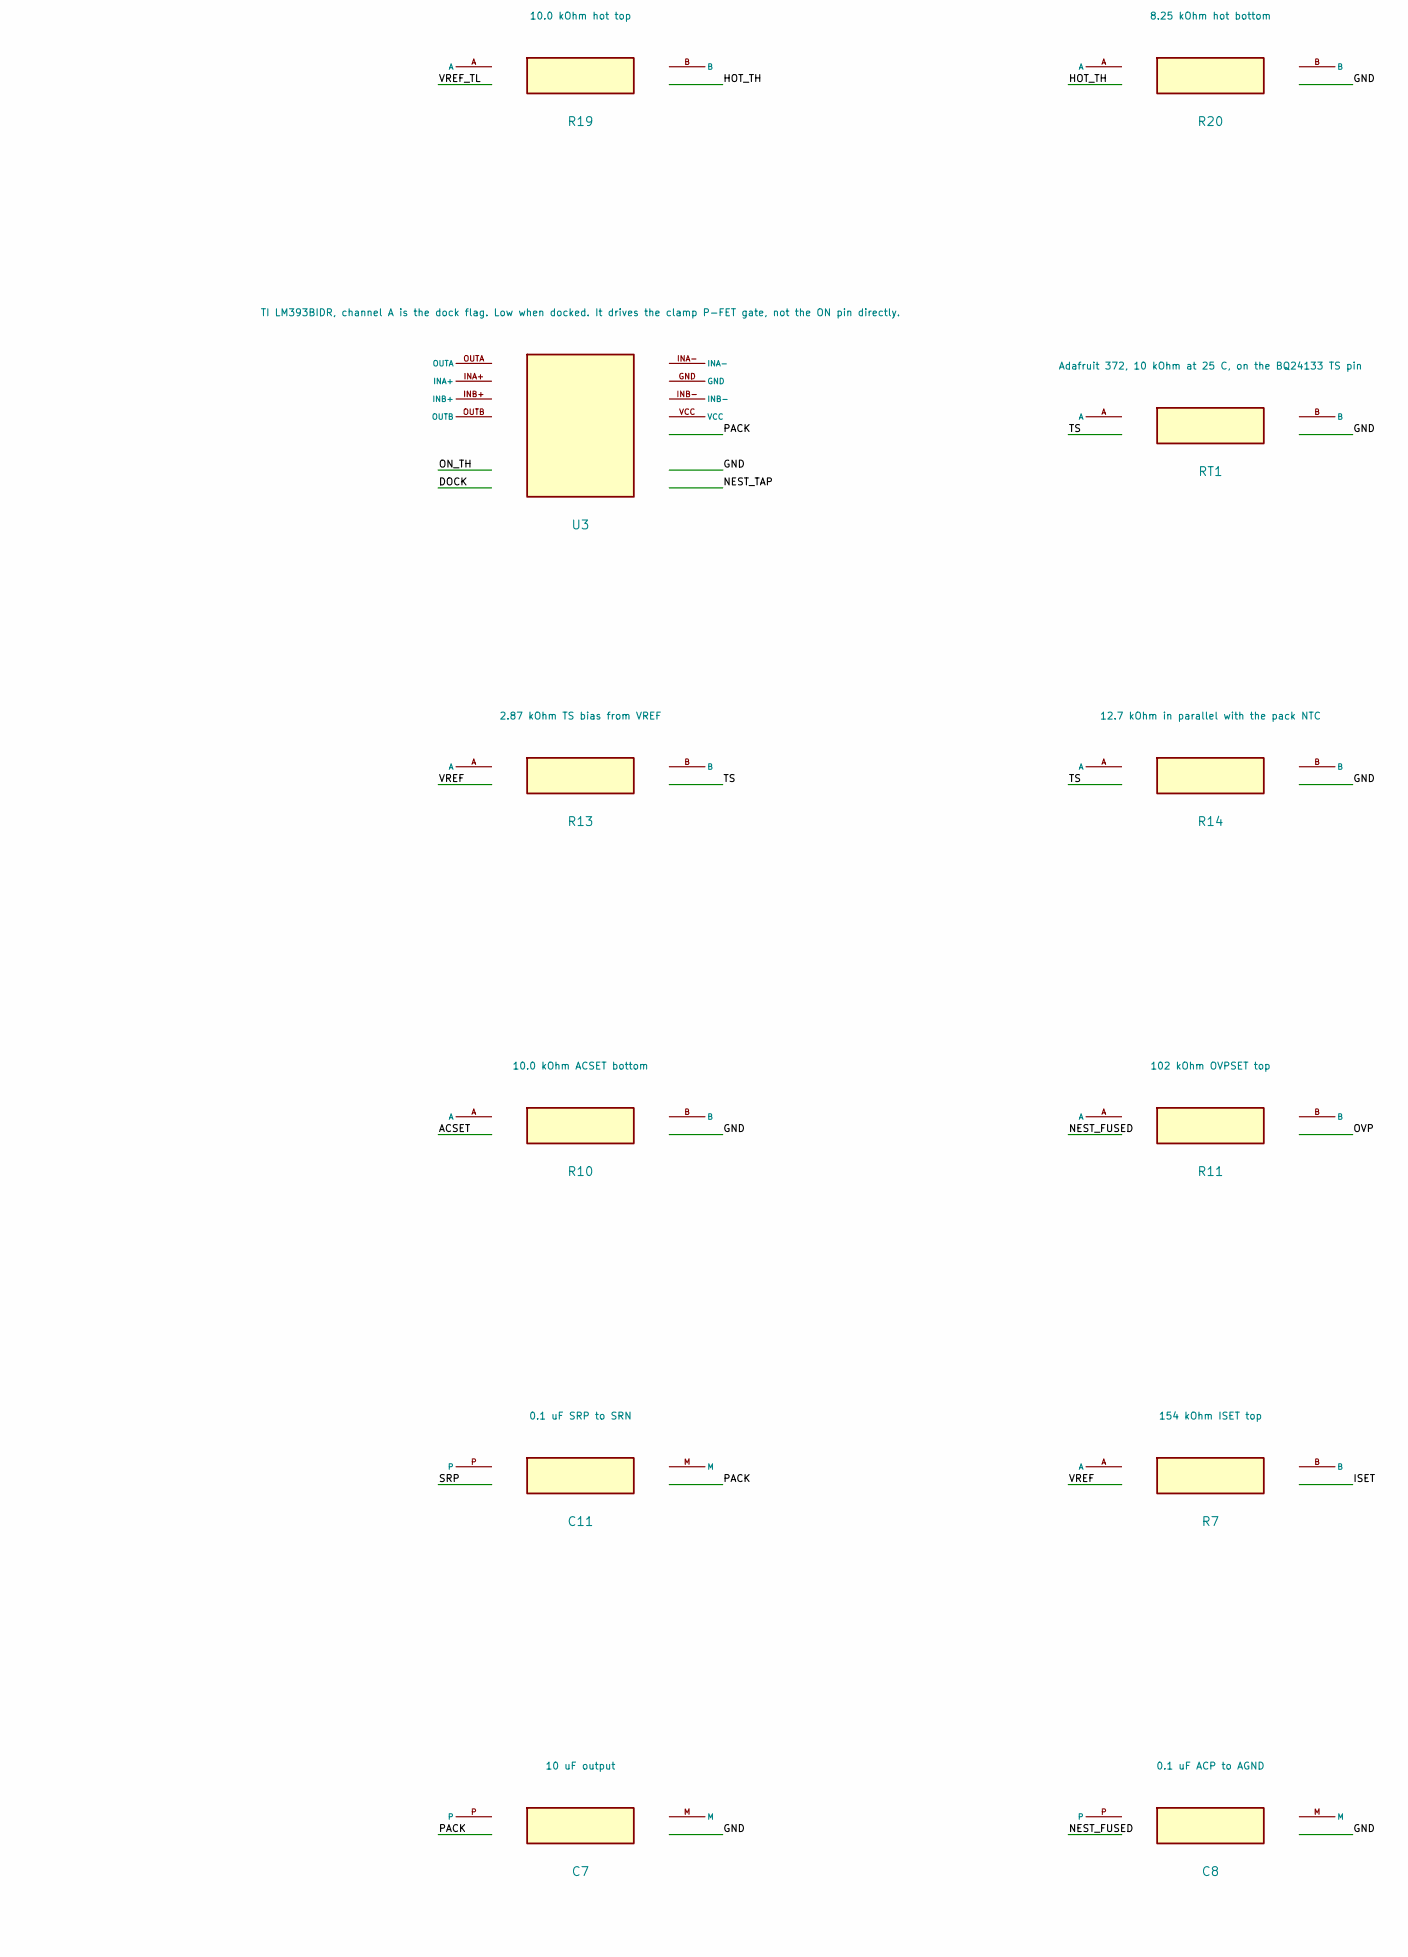
[picture p224: schematic bq24133_board.kicad_sch, part in row 2, column 1]

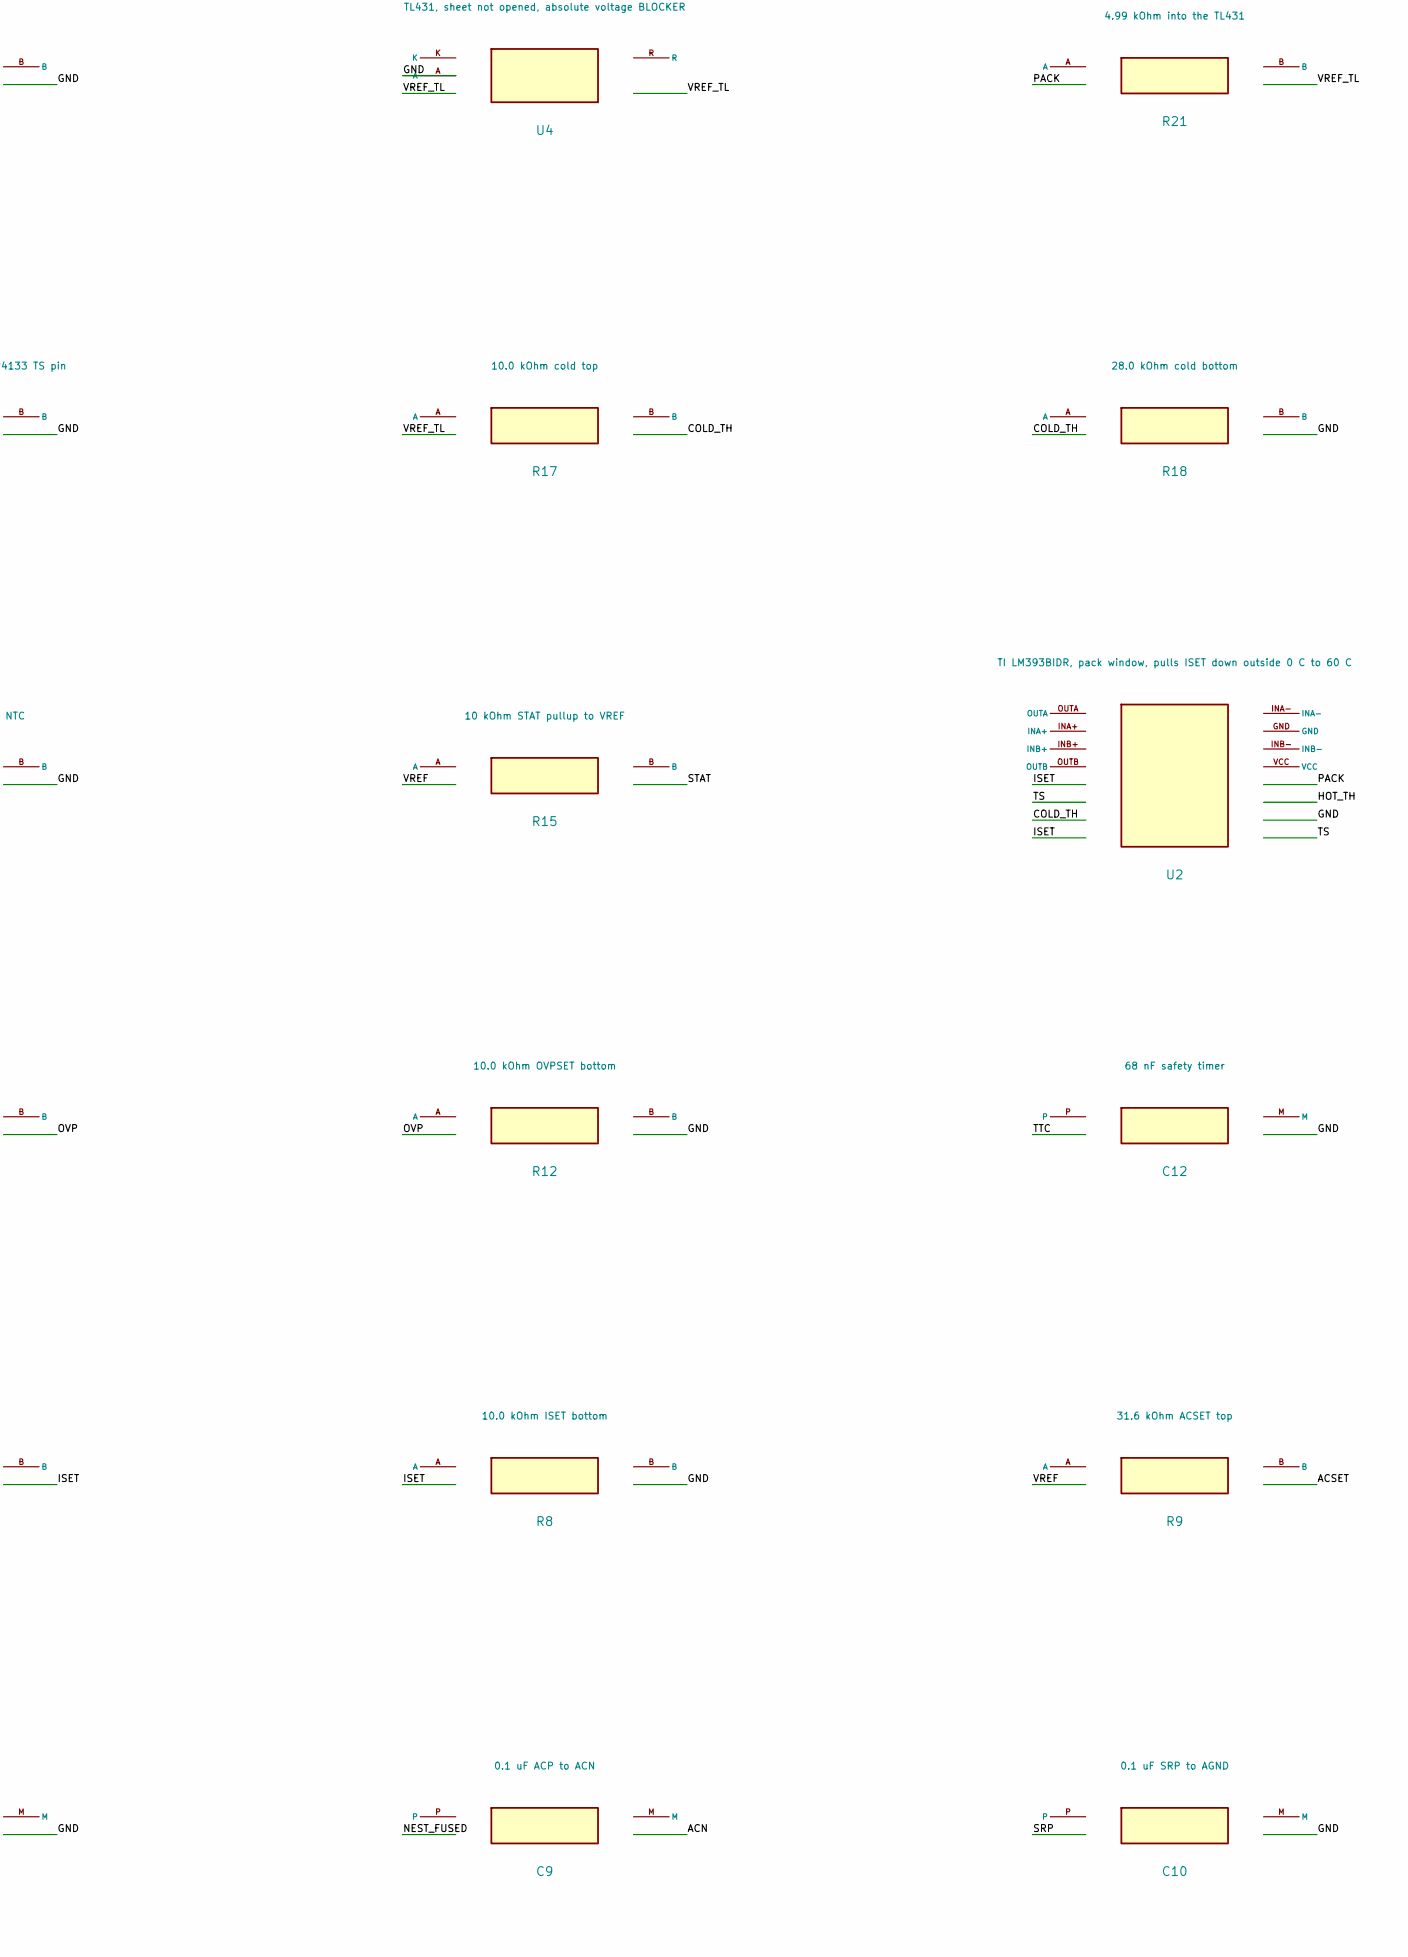
[picture p225: schematic bq24133_board.kicad_sch, part in row 2, column 2]

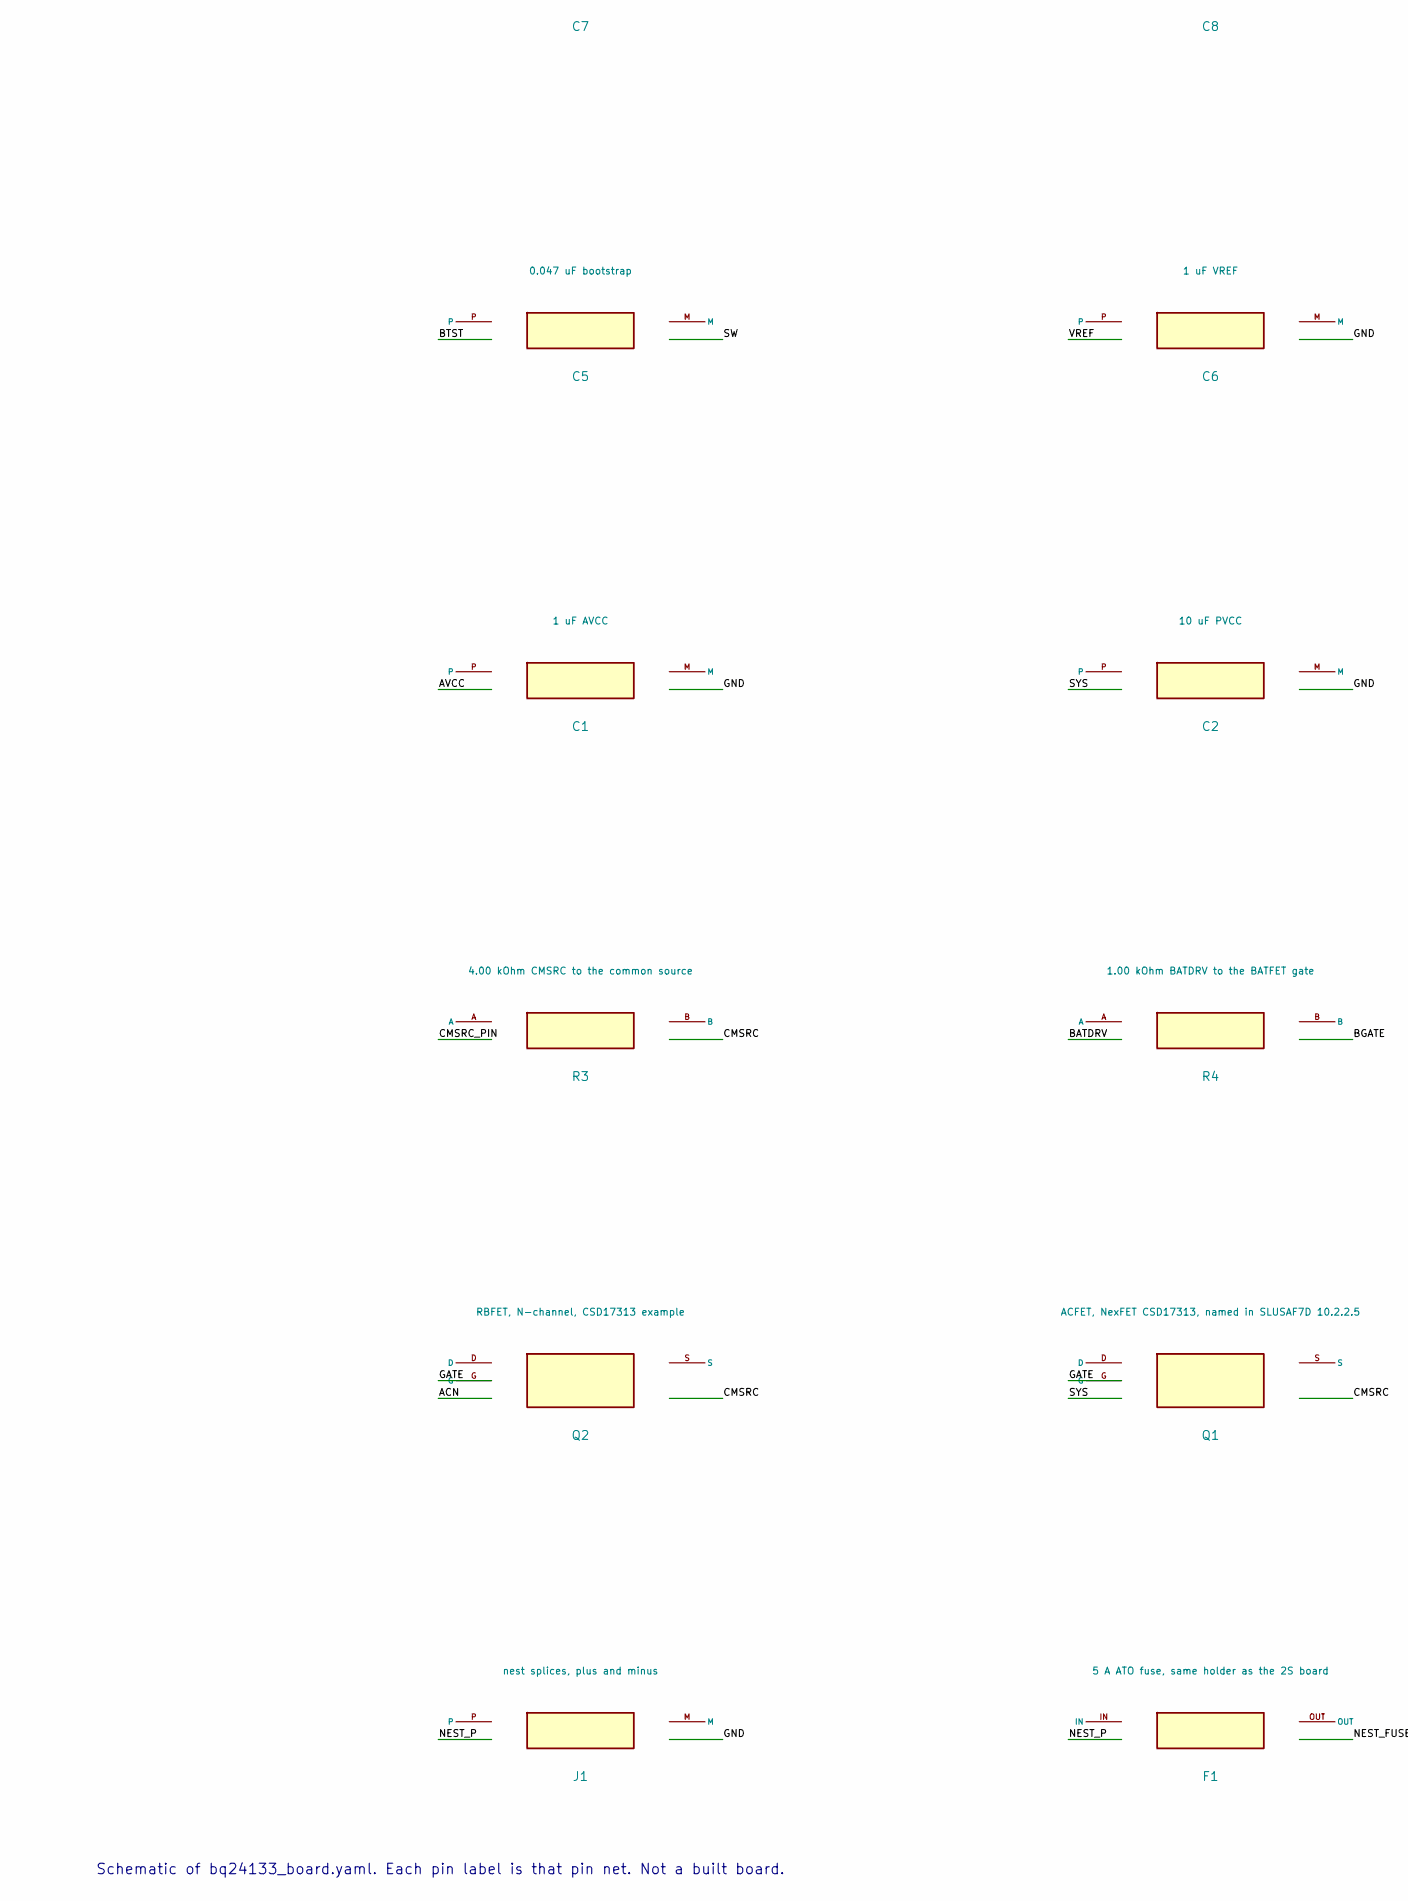
[picture p226: schematic bq24133_board.kicad_sch, part in row 3, column 1]

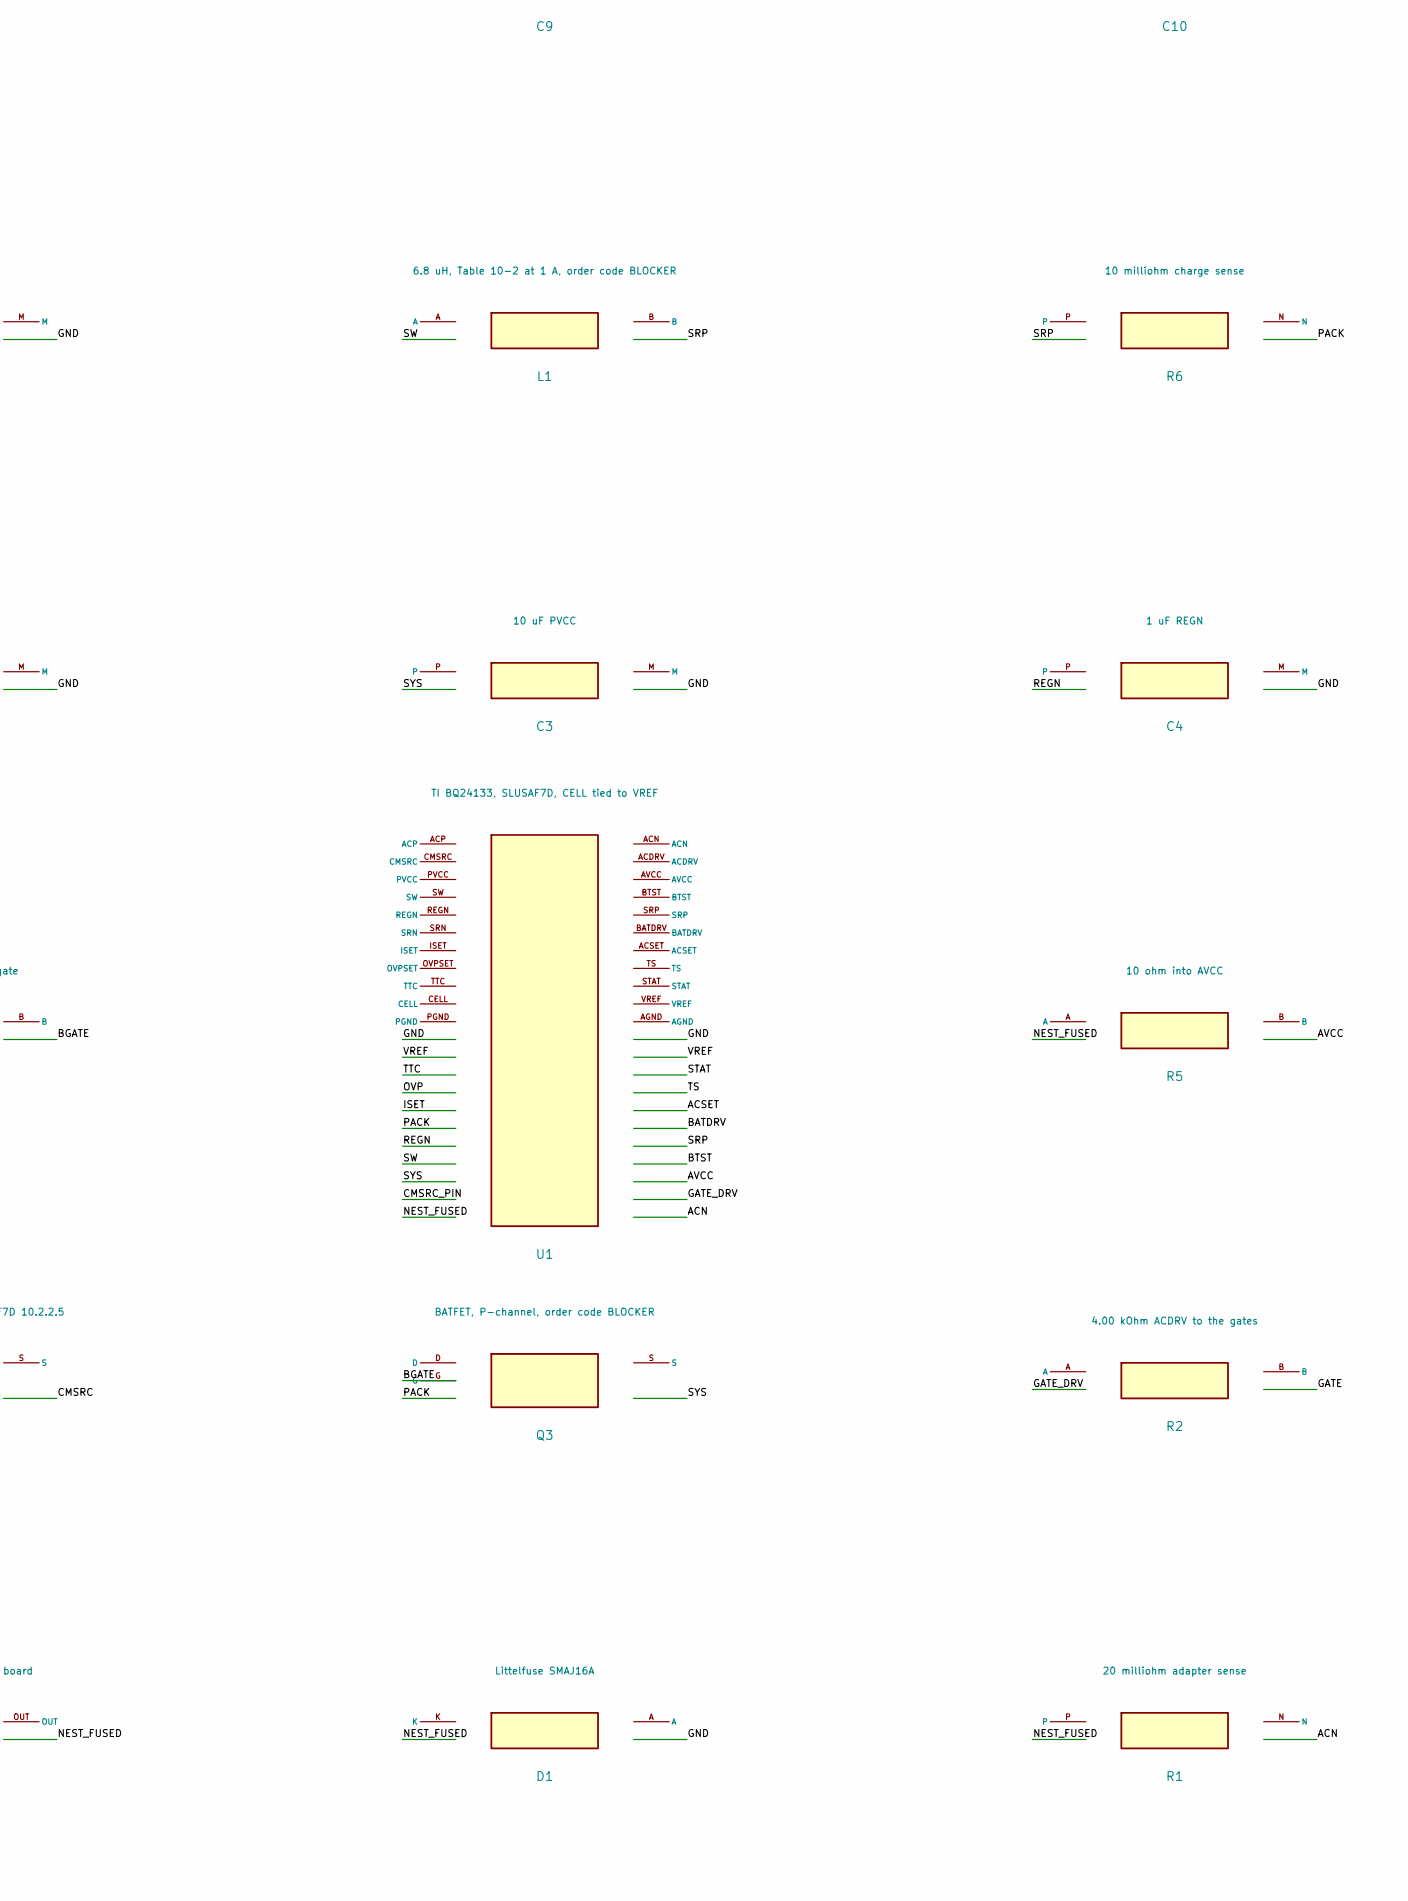
[picture p227: schematic bq24133_board.kicad_sch, part in row 3, column 2]

Parts:
C1: 1 uF AVCC
C2, C3: 10 uF PVCC
C4: 1 uF REGN
C5: 0.047 uF bootstrap
C6: 1 uF VREF
C7: 10 uF output
C8: 0.1 uF ACP to AGND
C9: 0.1 uF ACP to ACN
C10: 0.1 uF SRP to AGND
C11: 0.1 uF SRP to SRN
C12: 68 nF safety timer
D1: Littelfuse SMAJ16A
F1: 5 A ATO fuse, same holder as the 2S board
J1: nest splices, plus and minus
J2: to Pololu 2815 ON, slide switch left off. Input o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
J3: to BMS P+
J4: Pi STAT, rail request, end-charge, dock flag, 3.3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
L1: 6.8 uH, Table 10-2 at 1 A, order code BLOCKER
Q1: ACFET, NexFET CSD17313, named in SLUSAF7D 10.2.2.5
Q2: RBFET, N-channel, CSD17313 example
Q3: BATFET, P-channel, order code BLOCKER
Q4: onsemi FDME910PZT P-channel, dock flag to the cla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
Q5: onsemi 2N7002, Pi end-charge releases the clamp
Q6: onsemi 2N7002, shorts servo ON to ground while th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
Q7: onsemi 2N7002, Pi end-charge pulls ISET below 40 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
R1: 20 milliohm adapter sense
R2: 4.00 kOhm ACDRV to the gates
R3: 4.00 kOhm CMSRC to the common source
R4: 1.00 kOhm BATDRV to the BATFET gate
R5: 10 ohm into AVCC
R6: 10 milliohm charge sense
R7: 154 kOhm ISET top
R8: 10.0 kOhm ISET bottom
R9: 31.6 kOhm ACSET top
R10: 10.0 kOhm ACSET bottom
R11: 102 kOhm OVPSET top
R12: 10.0 kOhm OVPSET bottom
R13: 2.87 kOhm TS bias from VREF
R14: 12.7 kOhm in parallel with the pack NTC
R15: 10 kOhm STAT pullup to VREF
R17: 10.0 kOhm cold top
R18: 28.0 kOhm cold bottom
R19: 10.0 kOhm hot top
R20: 8.25 kOhm hot bottom
R21: 4.99 kOhm into the TL431
R22: 12.1 kOhm ON threshold from VREF
R23: 10.0 kOhm ON threshold to ground
R24: 200 kOhm ON threshold from the pack
R25: 100 kOhm nest divider top
R26: 20.0 kOhm nest divider bottom
R27: 10 kOhm from Pi rail-request to the 2815 ON pin
R28: 10 kOhm pull-up on the dock flag
R29: 10 kOhm from the P-FET drain to the clamp gate
R30: 100 kOhm clamp gate pulldown
R31: 100 kOhm ON pin pulldown, open means off
RT1: Adafruit 372, 10 kOhm at 25 C, on the BQ24133 TS 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
U1: TI BQ24133, SLUSAF7D, CELL tied to VREF
U2: TI LM393BIDR, pack window, pulls ISET down outsid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
U3: TI LM393BIDR, channel A is the dock flag. Low whe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
U4: TL431, sheet not opened, absolute voltage BLOCKER

Connections:
BGATE: Q3.G
DOCK: J4.DOCK
GATE: Q1.G, Q2.G
GND: Q5.S, Q6.S, Q7.S, U4.A
ON: J2.ON
PACK: J3.P
PDRV: Q4.D

Notes on the sheet:
Schematic of bq24133_board.yaml. Each pin label is that pin net. Not a built board.
