aaltaay/Open_Duck_Mini_v2/altaay_lab/circuitry/charger_board.kicad_sch

## KiCad design altaay_lab/circuitry/charger_board.kicad_sch (2026-11-12)

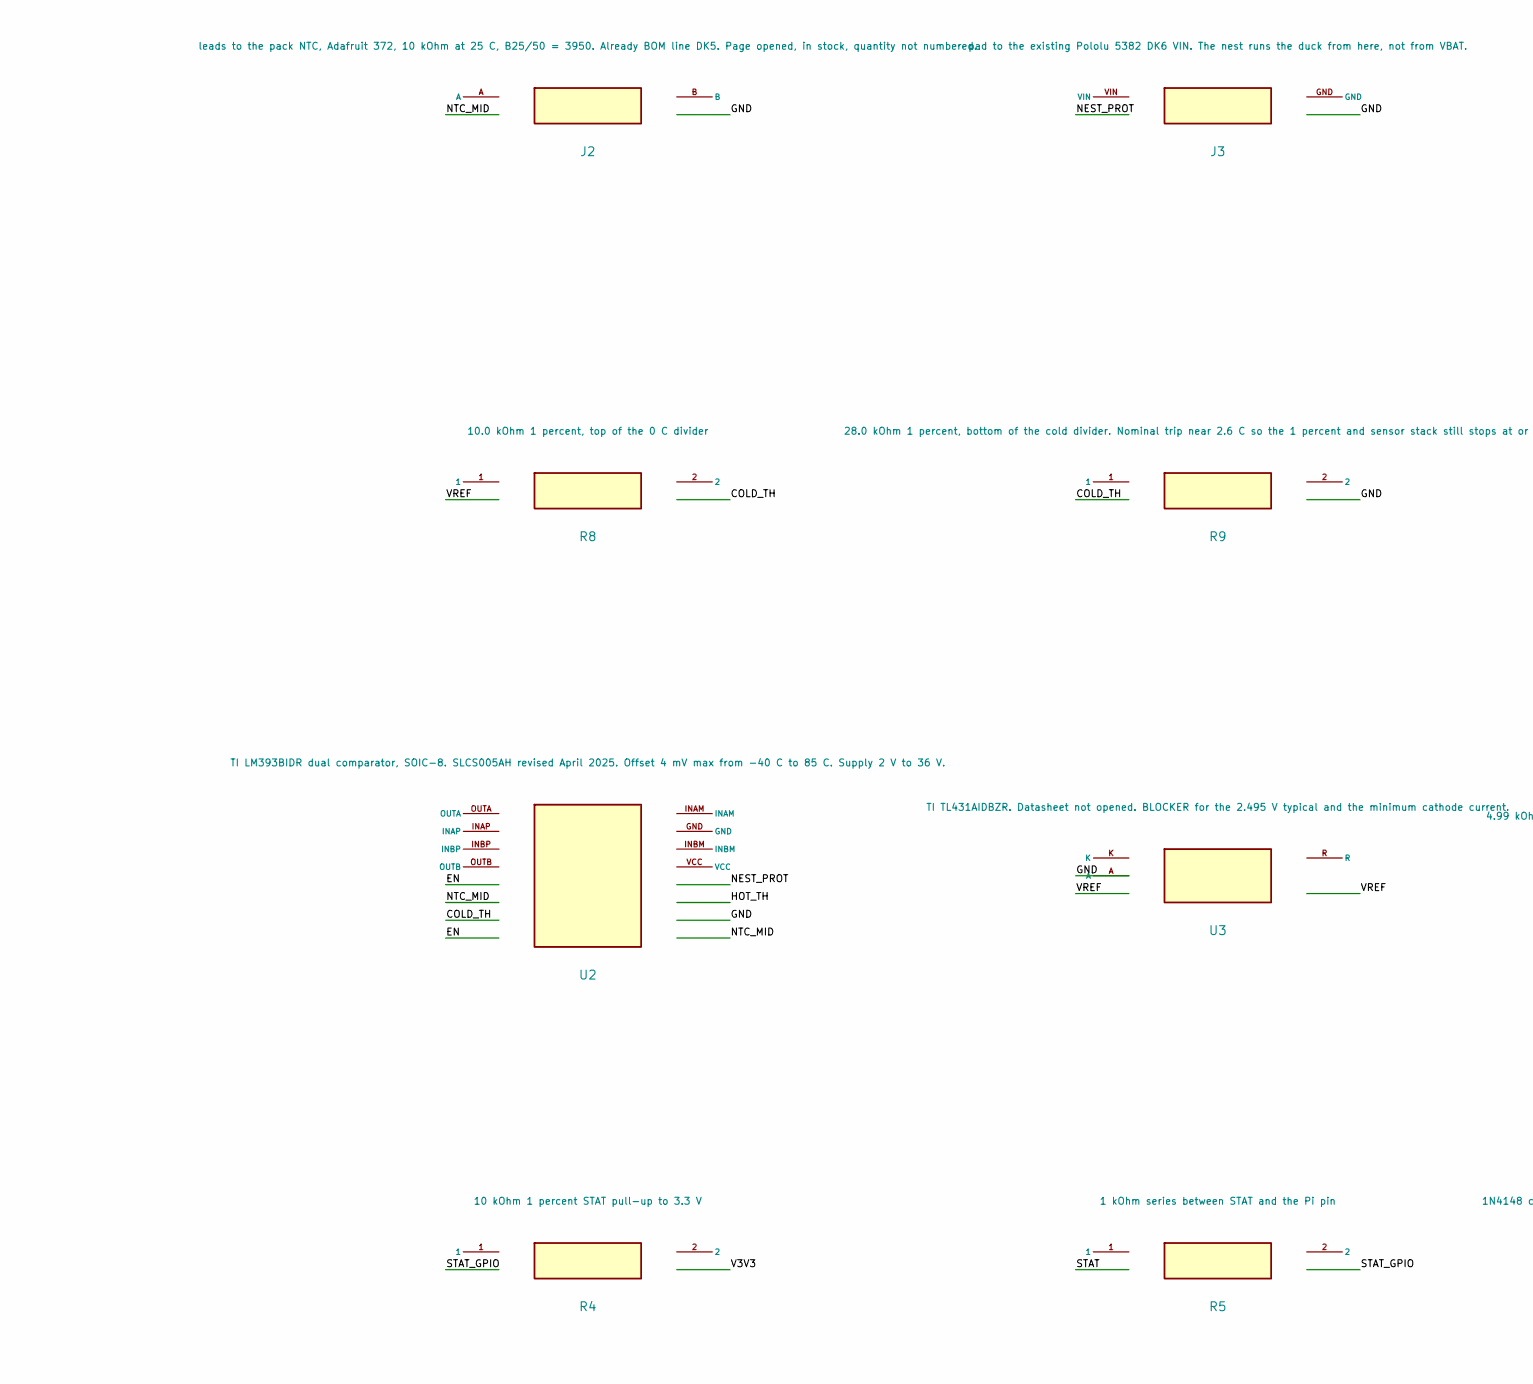
[picture p228: schematic charger_board.kicad_sch, part in row 1, column 1]

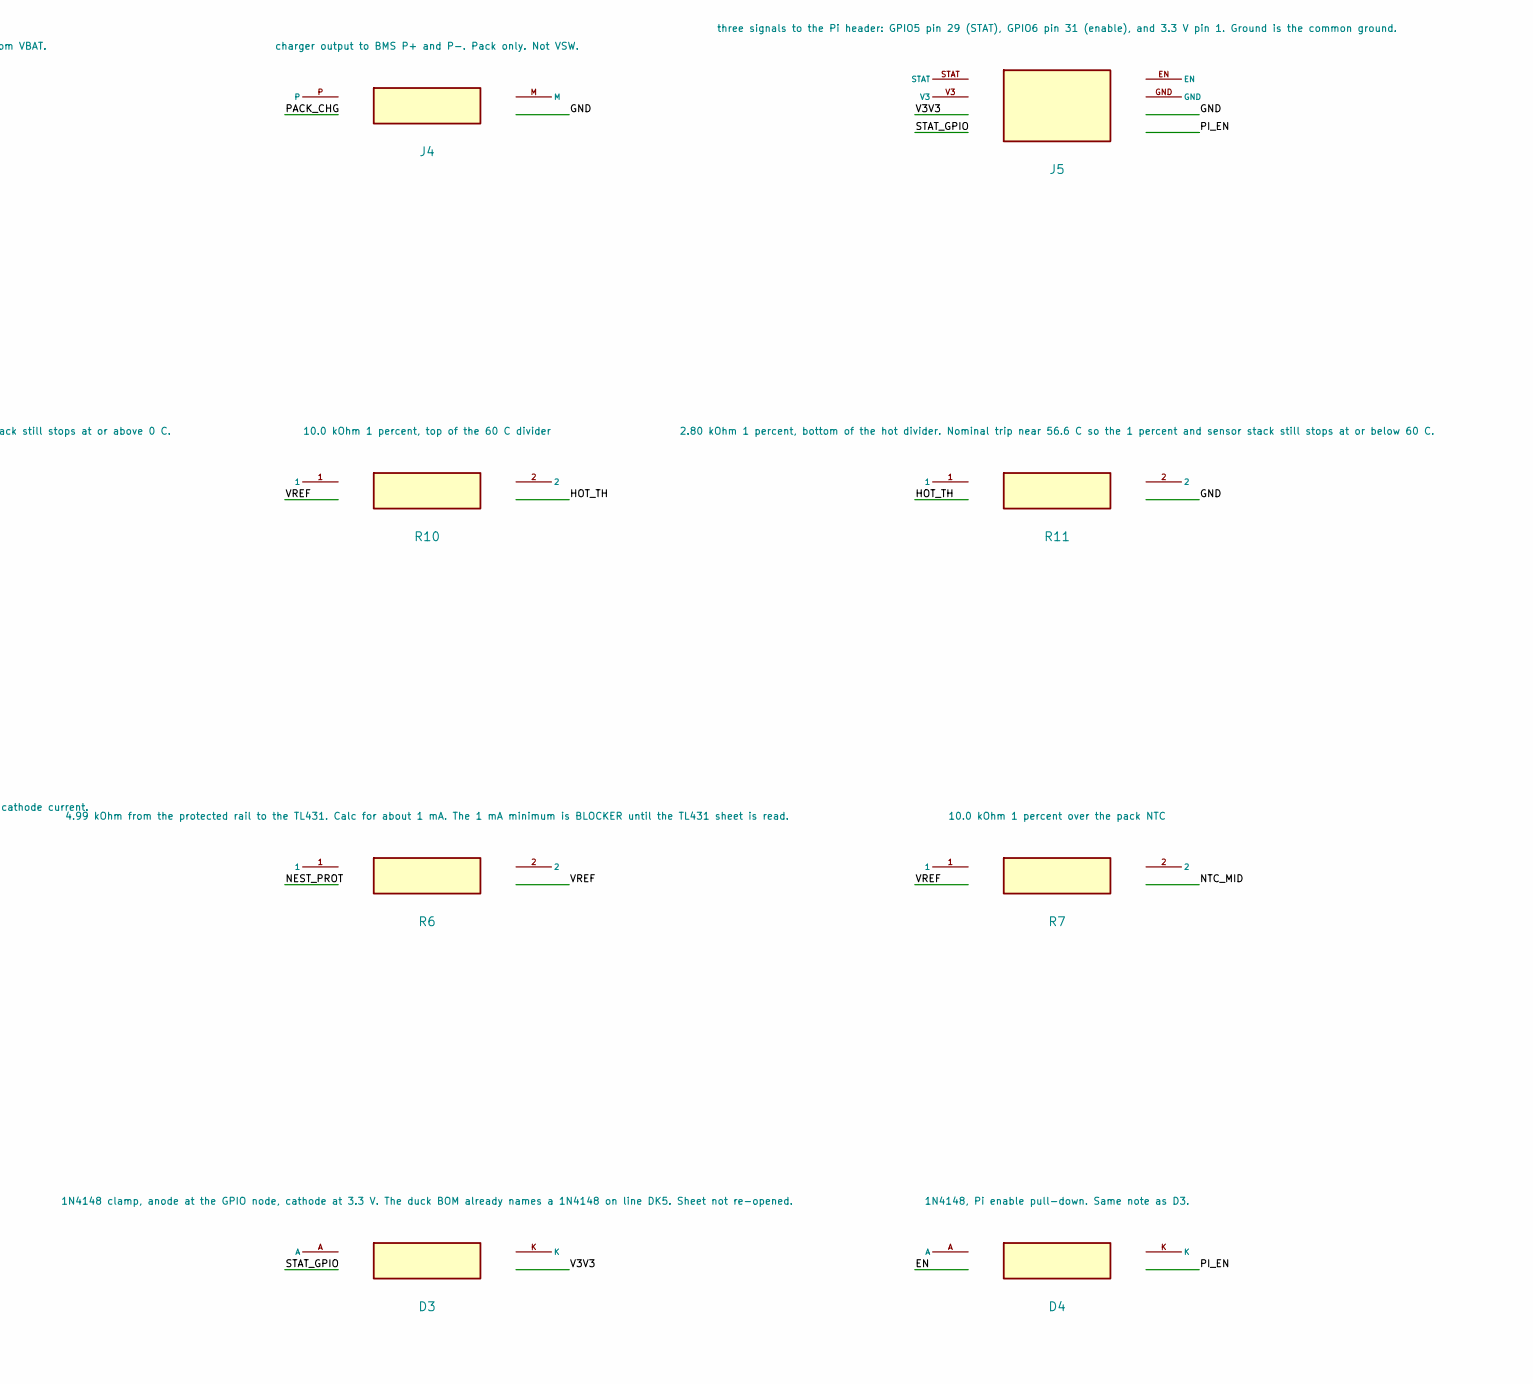
[picture p229: schematic charger_board.kicad_sch, part in row 1, column 2]

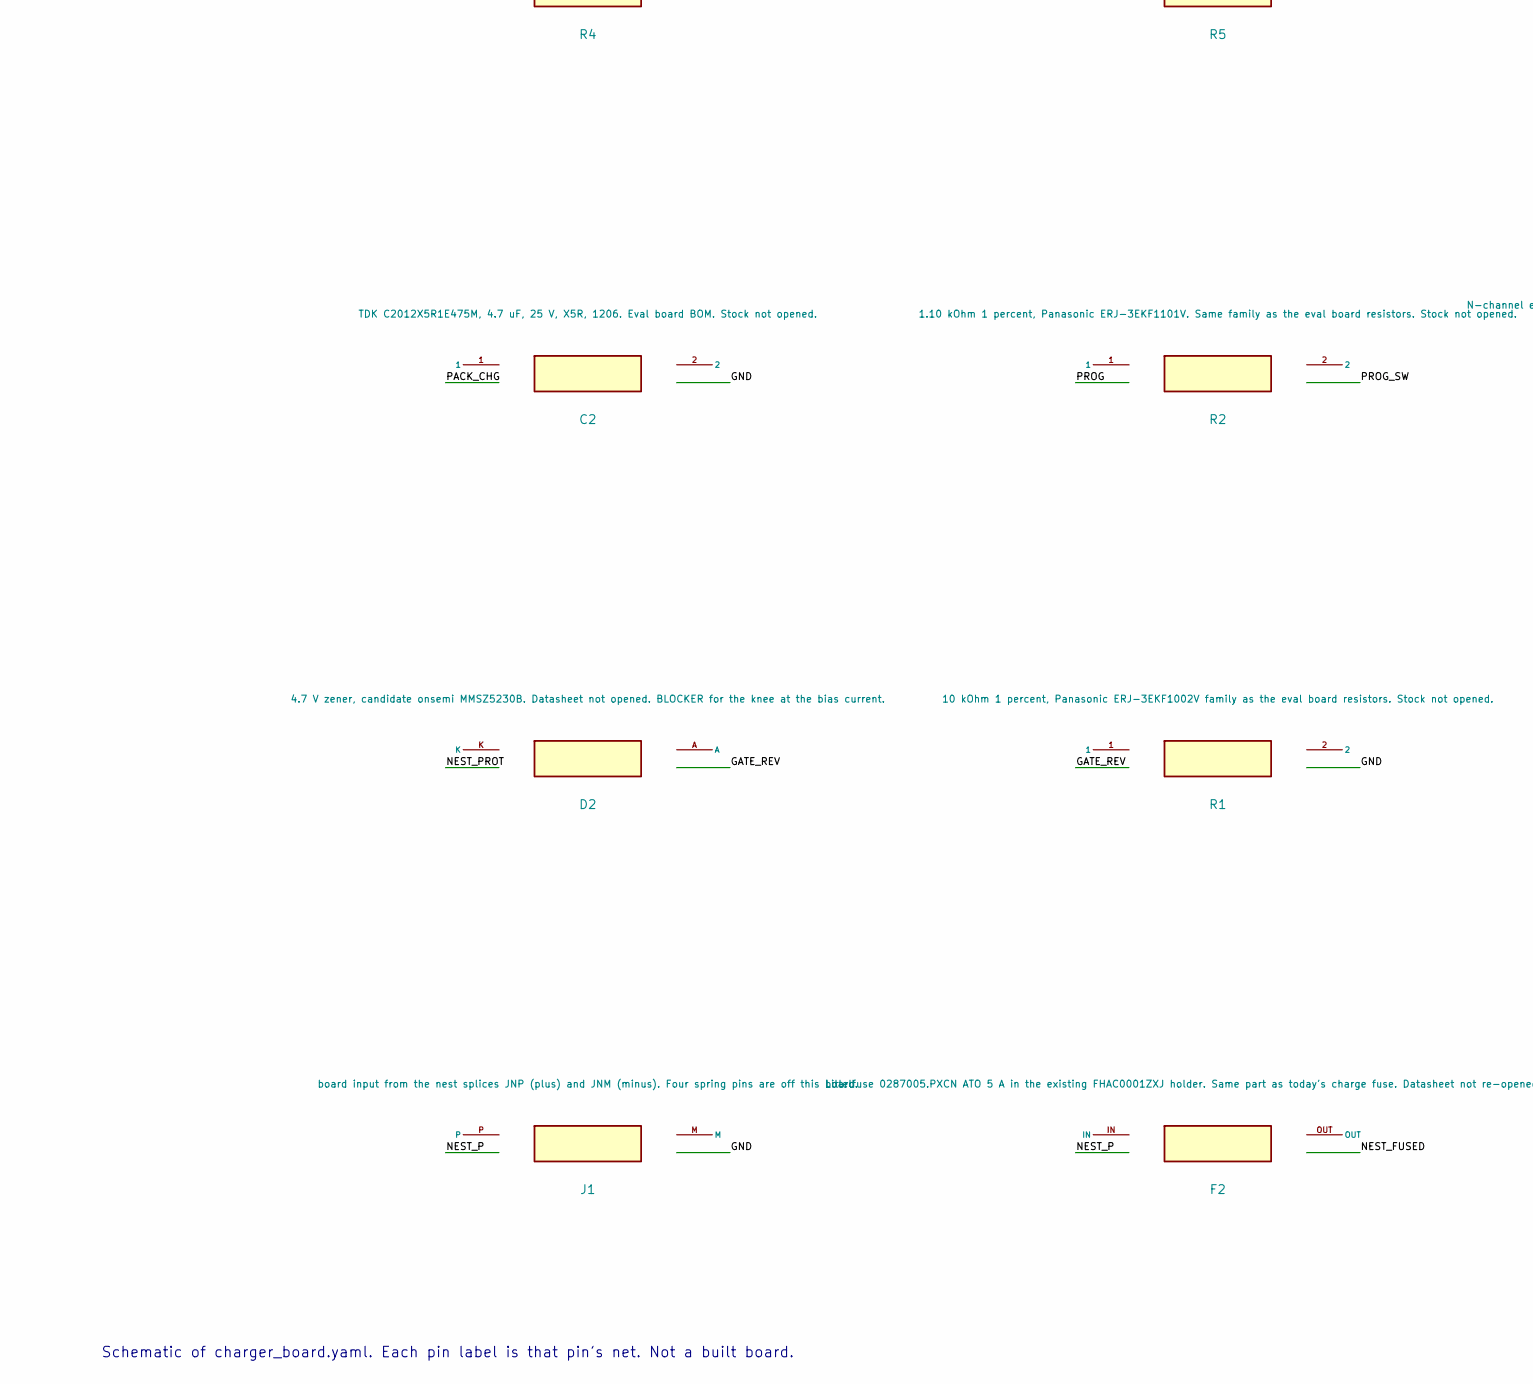
[picture p230: schematic charger_board.kicad_sch, part in row 2, column 1]

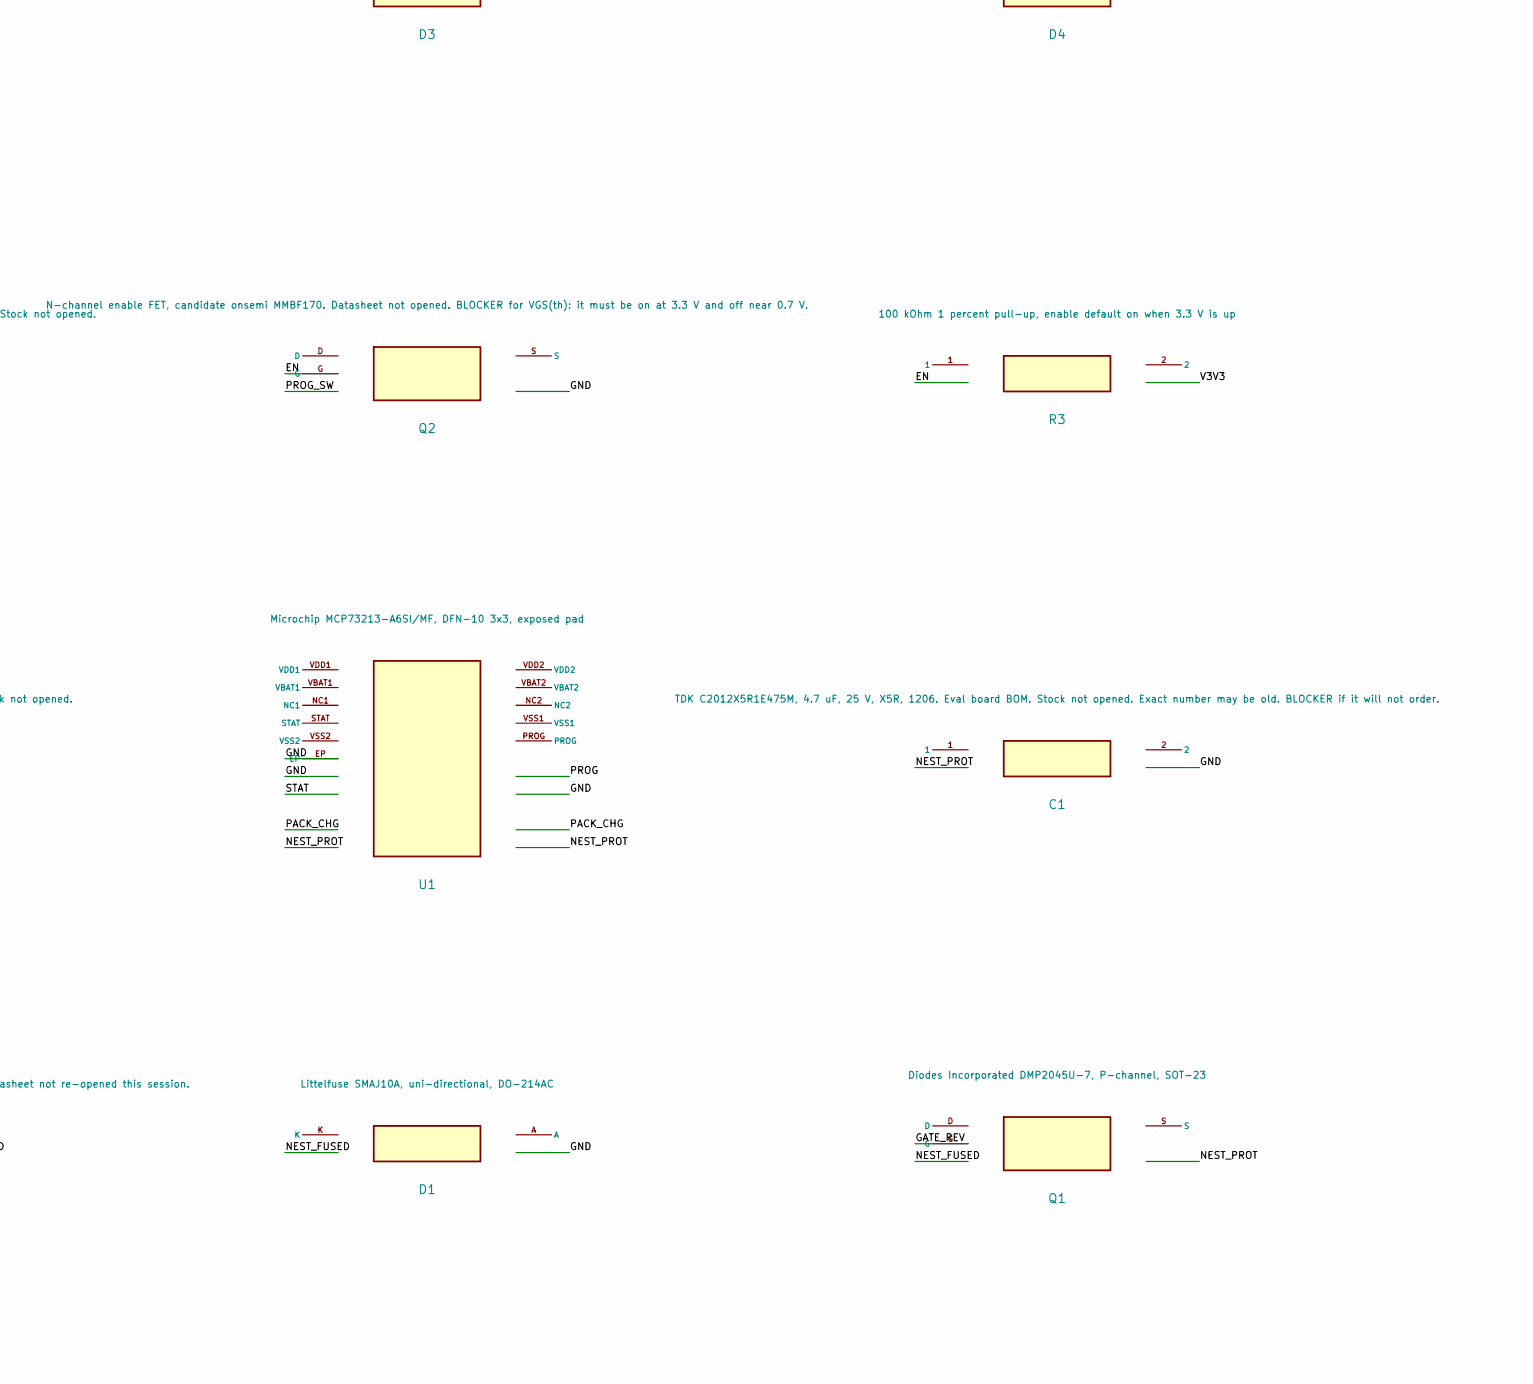
[picture p231: schematic charger_board.kicad_sch, part in row 2, column 2]

Parts:
C1, C2: TDK C2012X5R1E475M, 4.7 uF, 25 V, X5R, 1206. Eval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
D1: Littelfuse SMAJ10A, uni-directional, DO-214AC
D2: 4.7 V zener, candidate onsemi MMSZ5230B. Datashee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
D3: 1N4148 clamp, anode at the GPIO node, cathode at 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
D4: 1N4148, Pi enable pull-down. Same note as D3.
F2: Littelfuse 0287005.PXCN ATO 5 A in the existing F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
J1: board input from the nest splices JNP (plus) and 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
J2: leads to the pack NTC, Adafruit 372, 10 kOhm at 2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
J3: pad to the existing Pololu 5382 DK6 VIN. The nest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
J4: charger output to BMS P+ and P-. Pack only. Not V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
J5: three signals to the Pi header: GPIO5 pin 29 (STA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
Q1: Diodes Incorporated DMP2045U-7, P-channel, SOT-23
Q2: N-channel enable FET, candidate onsemi MMBF170. D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
R1: 10 kOhm 1 percent, Panasonic ERJ-3EKF1002V family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
R2: 1.10 kOhm 1 percent, Panasonic ERJ-3EKF1101V. Sam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
R3: 100 kOhm 1 percent pull-up, enable default on whe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
R4: 10 kOhm 1 percent STAT pull-up to 3.3 V
R5: 1 kOhm series between STAT and the Pi pin
R6: 4.99 kOhm from the protected rail to the TL431. C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
R7: 10.0 kOhm 1 percent over the pack NTC
R8: 10.0 kOhm 1 percent, top of the 0 C divider
R9: 28.0 kOhm 1 percent, bottom of the cold divider. 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
R10: 10.0 kOhm 1 percent, top of the 60 C divider
R11: 2.80 kOhm 1 percent, bottom of the hot divider. N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
U1: Microchip MCP73213-A6SI/MF, DFN-10 3x3, exposed p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
U2: TI LM393BIDR dual comparator, SOIC-8. SLCS005AH r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
U3: TI TL431AIDBZR. Datasheet not opened. BLOCKER for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

Connections:
EN: Q2.G
GATE_REV: Q1.G
GND: U1.EP, U3.A

Notes on the sheet:
Schematic of charger_board.yaml. Each pin label is that pin's net. Not a built board.
