aaltaay/Open_Duck_Mini_v2/altaay_lab/twin/electromech/em_twin.py

"""Electromechanical twin of the Open Duck Mini v2: the walking robot, its 14 STS3215 servos and its power path as one
closed loop (sim pass only).

Every 2 ms physics step:
  1. each servo's duty (position error x gain, clipped) comes from the robot state and the policy's target, as the
     trained MuJoCo actuator computes it (servo_sts3215.py);
  2. the power network as built (power_net.py: the ngspice circuit of sim/power_fix.py option ab, D15 star plus the D23
     feeds SP4/SP5, netlist lengths) is solved with each servo drawing its supply current for its own volts; the 2S
     Molicel P30B pack (p30b.py) gives the terminal volts for its charge and current; the Castle CC BEC Pro regulates
     7.2 V on this 2S default, or the caller's BEC_V (the 3S studies pass 12.0 V; 16.0 V is superseded); the 5 V branch draws its constant power;
  3. each servo's gain and torque limit are set from its volts (BAM: both scale with V / 7.4) and MuJoCo steps;
  4. the pack charge counter advances by the pack current (times the time compression factor, 1 = none).
The 50 Hz policy loop is the lab's copy of the upstream MjInfer loop (sim/current_budget.py run(), accelerometer
bias removed). The D16 battery guard (bench/battery_guard.py, unchanged) reads each servo's volts at a random time in
every 0.5 s, quantized down to 0.1 V as register 62, and runs its rules; "shadow" records its events and walks on.

Open loop (for comparison): the trained robot walks with the actuators unchanged, its torques and speeds are logged,
and the same network replays them with the ngspice servo law of sim/power_path_sim.py (commanded volts capped at the
local bus, constant power), as sim/POWER_PATH_SIM.md 'As built' does.

Usage (from altaay_lab/twin/electromech; TWIN_EM_SCRATCH = folder for heavy outputs):
  python3 em_twin.py check | states | session | sweep | png | all   (see the step functions at the end)
"""
import json
import os
import sys
import time

for _v in ("OPENBLAS_NUM_THREADS", "OMP_NUM_THREADS", "MKL_NUM_THREADS"):   # tiny matrices: one BLAS thread is fastest
    os.environ.setdefault(_v, "1")
import numpy as np                              # noqa: E402

HERE = os.path.dirname(os.path.abspath(__file__))
LAB = os.path.abspath(os.path.join(HERE, "..", ".."))
SIM = os.path.join(LAB, "sim")
BENCH = os.path.join(LAB, "bench")
SCR = os.environ.get("TWIN_EM_SCRATCH", "/tmp/twin_em")
os.makedirs(SCR, exist_ok=True)
os.environ.setdefault("ODM_SCRATCH", os.path.join(SCR, "models"))
os.environ.setdefault("ODM_OUT", os.path.join(SCR, "cb_out"))
for p_ in (HERE, SIM, BENCH):
    if p_ not in sys.path:
        sys.path.insert(0, p_)
import mujoco                                   # noqa: E402
import current_budget as CB                     # noqa: E402  lab file: upstream MjInfer with the two training stubs
import added_mass_sim as AM                     # noqa: E402  lab file: model copies at our build's mass, gait statistics
import mass_budget as MB                        # noqa: E402
import battery_guard as BG                      # noqa: E402  bench/battery_guard.py (D16 rules)
import power_net as PN                          # noqa: E402
import servo_sts3215 as SV                      # noqa: E402
import p30b                                     # noqa: E402
import p45b                                     # noqa: E402

MI = CB.MI
OUT_GIT = os.path.join(HERE, "out")
NAMES = PN.NAMES
SID = [PN.SERVO_ID[n] for n in NAMES]
SCENES = {"backlash": "scene_flat_terrain_backlash.xml", "plain": "scene_flat_terrain.xml"}
CMD = {"forward": (0.15, 0.0, 0.0)}
CELL = p30b.P30B()
CELLS = {"p30b": p30b.P30B, "p45b": p45b.P45B}


def pack_states(cell):
    """mAh delivered at the open-circuit voltages the twin already uses as full, nominal, D16 and low"""
    return {"full": 0.0, "nominal": cell.q_at_ocv(3.70), "d16": cell.q_at_ocv(3.57), "low": cell.q_at_ocv(3.30)}


STATES = pack_states(CELL)
STATE_TEXT = {"full": "full (q 0 mAh, OCV 4.20 V/cell)", "nominal": "nominal (OCV 3.70 V/cell)",
              "d16": "near the D16 cut (OCV 3.57 V/cell)", "low": "low (OCV 3.30 V/cell, past the guard)"}
LAB_VCELL = {"full": 4.2, "nominal": 3.7, "low": 3.3}            # sim/power_path_sim.py PACK_CELL_V
T_WALK = 2.0                                    # s, the command starts (sim/current_budget.py sched_const)


# ---------------------------------------------------------------------------------------------------------------
def model_folder(mass):
    """trained: the upstream Playground xmls (b9be205) themselves; ours: sim/added_mass_sim.py copy at the
    sim/mass_budget.py inertials (2.6528 kg, the C8 model)"""
    if mass == "trained":
        return AM.SRC_XML
    d = os.path.join(AM.SCR, "models", "ours")
    if not os.path.exists(os.path.join(d, "open_duck_mini_v2_backlash.xml")):
        B = MB.build_budget()
        pl = {p["id"]: p for p in json.load(open(os.path.join(LAB, "audit", "placements.json")))}
        boxes = [("trunk_assembly", np.array(p["center_mm"]) / 1000, np.array(p["dims_xyz_mm"]) / 1000, "0.85 0.1 0.1 1") for p in pl.values()]
        AM.write_variant("ours", B["links"], boxes)
    return d


class Guard:
    """bench/battery_guard.py fed as on the robot: one read of the 14 servos at a random time in each 0.5 s"""

    def __init__(self, rng, t0, mode="shadow"):
        self.g = BG.BatteryGuard(BG.GuardConfig(), state=BG.WALKING)
        self.rng, self.mode = rng, mode
        self.period = self.g.cfg.period_s
        self.k = 0
        self.t0 = t0
        self.next_t = t0 + rng.uniform(0, self.period)
        self.events, self.medians = [], []

    def due(self, t):
        return t >= self.next_t

    def feed(self, t, V, pack_v=None):
        volts = {sid: BG.quantize(float(v)) for sid, v in zip(SID, V)}
        # pack_v is the pack terminal. battery_guard stops the walk under its pack floor.
        ev = self.g.update(t, volts, pack_v=pack_v)
        self.medians.append((round(t, 3), self.g.last_median))
        for e in ev:
            self.events.append(e)
            if e["event"] == "walk_stop" and self.mode == "shadow":
                self.g.set_state(BG.WALKING)     # shadow: keep judging as walking (the walk goes on)
                self.g.state = BG.WALKING
                self.g.w_walk.clear()
        self.k += 1
        self.next_t = self.t0 + self.k * self.period + self.rng.uniform(0, self.period)
        return ev


def sampled_frac(v, dt, period=0.02, thr=6.0):
    """fraction of 50 Hz samples under thr for every 2 ms phase of the 20 ms cycle (as sim/power_fix.py)"""
    n = int(round(period / dt))
    return [float((v[ph::n] < thr).mean()) for ph in range(n)]


# ---------------------------------------------------------------------------------------------------------------
def _overcurrent(pk, sane, dt):
    """Time the pack current spends above the 15 A rating, the 110 percent hold, and the 135 percent open row.

    ATOF 15 A, cited in problems/KNEE_HEAT_CHAFE.md: 110 percent holds for at least 360000 s.
    135 percent opens between 0.75 s and 600 s. Samples outside 8 V to 13.2 V are not counted.
    """
    out = {}
    for key, level in (("a15", 15.0), ("a110", 16.5), ("a135", 20.25)):
        mask = sane & (pk >= level)
        if not np.any(mask):
            out["t_%s_s" % key] = 0.0
            out["longest_%s_s" % key] = 0.0
            continue
        padded = np.concatenate([[False], mask, [False]])
        edges = np.diff(padded.astype(np.int8))
        starts = np.flatnonzero(edges == 1)
        ends = np.flatnonzero(edges == -1)
        lengths = (ends - starts).astype(float) * float(dt)
        out["t_%s_s" % key] = round(float(lengths.sum()), 4)
        out["longest_%s_s" % key] = round(float(lengths.max()), 4)
    return out


def run(mass="ours", walk="backlash", cmd=CMD["forward"], dur=30.0, supply="net", corner="typical", extra=None,
        cell="p30b", q0=0.0, vcell=3.7, compress=1.0, servo_mode="bam", seed=None, guard="shadow", t_stats=4.0,
        keep_full=True, bin_s=0.1, stop_q=None, stop_on_fall=False, fixed_v=7.4, cell_mode="steady", label="",
        full_windows=None, progress=0.0, pushes=None, command_fn=None, on_bin=None, sit_ctrl=None, sit_deg=None,
        sit_path_deg=None, pack_floor=False, knee_hi_deg=None):
    """one walk. supply: "stock" (trained actuators, no supply effect), "fixed" (every servo at fixed_v volts),
    "net" (the power network). cell: "p30b" (charge q0 mAh, advanced by the pack current x compress) or "lab"
    (OCV vcell per cell with the corner's Rc, as sim/power_path_sim.py). Returns a result dict; full traces in it."""
    folder = model_folder(mass)
    AM._ASSET_DIR[0] = folder
    m = MI.MjInfer(os.path.join(folder, SCENES[walk]), CB.REF, CB.ONNX, standing=False)
    if seed is not None:                         # joint start jitter U(-0.03, 0.03) rad, as sim/added_mass_sim.py seeds
        rng0 = np.random.default_rng(seed)
        qa = np.array(m.actuator_joint_qpos_addr).ravel()
        m.data.qpos[qa] += rng0.uniform(-0.03, 0.03, len(qa))
    mujoco.mj_forward(m.model, m.data)
    _ga = m.get_accelerometer

    def _ga_fixed(d, _ga=_ga):
        a = np.array(_ga(d), dtype=float); a[0] -= 1.3; return a
    m.get_accelerometer = _ga_fixed              # as sim/current_budget.py (bias not in training or on the robot)
    model, data = m.model, m.data
    trunk = model.body("trunk_assembly").id
    names = list(m.actuator_names)
    perm = np.array([names.index(n) for n in NAMES])       # model actuator index of each NAMES entry
    bank = SV.ServoBank(model, mode=servo_mode)
    if knee_hi_deg is not None:
        # CAD hard stop is 150 deg. The register soft stop is 147 deg (software/servo_limits.json).
        # The walk model was compiled at 90 deg, so a sit command never arrived.
        hi = np.deg2rad(float(knee_hi_deg))
        for name in ("left_knee", "right_knee"):
            jid = mujoco.mj_name2id(model, mujoco.mjtObj.mjOBJ_JOINT, name)
            aid = mujoco.mj_name2id(model, mujoco.mjtObj.mjOBJ_ACTUATOR, name)
            if jid < 0 or aid < 0:
                raise RuntimeError("knee joint missing from the walk model")
            model.jnt_range[jid, 1] = max(float(model.jnt_range[jid, 1]), hi)
            model.actuator_ctrlrange[aid, 1] = max(float(model.actuator_ctrlrange[aid, 1]), hi)
            bank.ctrlrange[aid, 1] = float(model.actuator_ctrlrange[aid, 1])
    def _pose(deg):
        ctrl = np.array(m.default_actuator, float).copy()
        for i, n in enumerate(m.actuator_names):
            if n in deg:
                ctrl[i] = np.deg2rad(float(deg[n]))
        return np.clip(ctrl, bank.ctrlrange[:, 0], bank.ctrlrange[:, 1])

    sit_path = []
    if sit_path_deg:
        sit_path = [(float(dur), _pose(deg)) for dur, deg in sit_path_deg]
        sit_ctrl = sit_path[-1][1]
    elif sit_deg:
        sit_ctrl = _pose(sit_deg)
        sit_path = [(2.5, sit_ctrl)]
    fb = m._floating_base_qpos_addr
    qv = m.actuator_qvel_addr
    dt = m.sim_dt
    nsteps = int(round(dur / dt))
    cellm = CELLS[cell](mode=cell_mode) if cell in CELLS else None
    net = PN.Net(corner, extra, cell_model=cellm) if supply == "net" else None
    q = float(q0)
    sched = CB.sched_const(list(cmd) + [0, 0, 0, 0])
    rng = np.random.default_rng(1000 + (seed or 0))
    gd = Guard(rng, T_WALK, guard) if (guard and supply == "net") else None
    nb = max(1, int(round(bin_s / dt)))
    nbins = nsteps // nb
    k0 = int(round(t_stats / dt))
    # accumulators (NAMES order)
    acc = dict(n=0, lt6=np.zeros(14), lt45=np.zeros(14), lt40=np.zeros(14), vmin=np.full(14, 99.0), vsum=np.zeros(14),
               sat=np.zeros(14), im2=np.zeros(14), isup=np.zeros(14), pin=np.zeros(14), err2=np.zeros(14), limsum=np.zeros(14),
               pk_i=[], pk_v=[], bus=[], vout=[], vbin=[])
    BIN = {k: np.zeros((nbins, 14), np.float32) for k in ("V_mean", "V_min", "Isup_mean", "Im_rms", "Pcu_mean", "Pel_mean", "absF_mean", "sat_frac", "w_rms")}
    BINP = {k: np.zeros(nbins, np.float32) for k in ("t_end", "q_mAh", "v_pack_mean", "v_pack_min", "i_pack_mean", "i_pack_max", "i_pack_rms", "v_bus_mean",
                                                    "v_bec_out_mean", "v_bec_out_min", "i_bec_out_mean", "i_bec_out_rms", "x", "y", "z", "yaw", "fallen")}
    if keep_full:
        FULL = {k: np.zeros((nsteps, 14), np.float32) for k in ("V", "Isup", "Im", "F", "w")}
        FULLP = {k: np.zeros(nsteps, np.float32) for k in ("v_pack", "i_pack", "v_bus", "v_bin", "v_out", "i_bout", "q")}
    win = []                                     # optional full-rate windows for long runs: list of (t0, t1)
    WIN = {}
    if full_windows:
        for (a, b) in full_windows:
            WIN[(a, b)] = dict(t=[], V=[], Isup=[], Im=[], F=[], w=[], pack=[])
    blk = {k: [] for k in ("V", "Vmin", "Isup", "Im2", "Pel", "absF", "sat", "w2", "vp", "ip", "vb", "vo", "io")}
    log, falls, fallen, counter = [], [], False, 0
    # walk, sit (ramp into the sit pose), off (torque off), rise (hand the joints back to the policy)
    phase, phase_t0, sit_from, n_rests = "walk", 0.0, None, 0
    phases = []
    upright_walk_s = 0.0
    last_upz = 1.0
    # stock replay pairs (as sim/current_budget.py: F after the step, W after the step)
    Ftr = np.zeros((nsteps, 14), np.float32) if supply == "stock" else None
    Wtr = np.zeros((nsteps, 14), np.float32) if supply == "stock" else None
    V = np.full(14, 7.4)
    y = None
    t_start = time.time()
    stopped = None
    for k in range(nsteps):
        t = (k + 1) * dt
        w_m = data.qvel[bank.dadr].copy()
        err_n = (np.clip(data.ctrl, bank.ctrlrange[:, 0], bank.ctrlrange[:, 1]) - data.qpos[bank.qadr])[perm]
        if supply == "stock":
            V = np.full(14, SV.V_TRAIN)
        elif supply == "fixed":
            V = np.full(14, float(fixed_v))
            bank.apply(np.full(model.nu, float(fixed_v)))
        else:
            wn = w_m[perm]
            if phase == "off":
                duty = np.zeros(len(NAMES))
                dc = None
            else:
                duty = bank.duty_of(data)[perm]
                if servo_mode == "comp":
                    ctrl = np.where(bank.ctrllimited, np.clip(data.ctrl, bank.ctrlrange[:, 0], bank.ctrlrange[:, 1]), data.ctrl)
                    dc = (bank.kp0 * (ctrl - data.qpos[bank.qadr]) / bank.fr0[:, 1])[perm]
                else:
                    dc = None

            def isup_fn(vn, duty=duty, wn=wn, dc=dc):
                return SV.supply_current_bam(duty, wn, vn, servo_mode, d_comp=dc)
            isup_fn.slope = lambda vn, duty=duty, wn=wn, dc=dc: SV.supply_current_bam(duty, wn, vn, servo_mode, d_comp=dc, slope=True)
            y = net.solve(isup_fn, vcell=vcell, qm=q)
            V = net.servo_volts(y)
            Vm = np.empty(model.nu); Vm[perm] = V
            bank.apply(Vm)
        if phase == "off":
            model.actuator_gainprm[:, 0] = 0.0
            model.actuator_biasprm[:, 1] = 0.0
        elif supply == "stock":
            model.actuator_gainprm[:, 0] = bank.kp0
            model.actuator_biasprm[:, 1] = bank.b1
        if pushes:                                   # as sim/current_budget.py: force on the trunk
            data.xfrc_applied[:] = 0
            for (pa, pb, fvec) in pushes:
                if pa <= t < pb:
                    data.xfrc_applied[trunk, :3] = fvec
        mujoco.mj_step(model, data)
        counter += 1
        F_m = data.actuator_force.copy()
        Fn = F_m[perm]; wn = w_m[perm]
        u, im, isup = SV.ServoBank.electrical(Fn, wn, V, mode=servo_mode)
        if supply == "stock":
            Ftr[k] = F_m; Wtr[k] = data.qvel[qv]
        if y is not None:
            ipk = float(y[net.o["i_pack"]])
            if cellm is not None:
                q += ipk * dt / 3.6 * compress
                cellm.advance(ipk, dt)
            vp, vb, vo, io, vbin = (float(y[net.o[x]]) for x in ("v_pack", "v_bus", "v_out", "i_bout", "v_bin"))
        else:
            ipk = vp = vb = vo = io = vbin = np.nan
        lim = np.abs(model.actuator_forcerange[perm, 1])          # the limit this step ran with
        sat = np.abs(Fn) >= 0.999 * lim - 1e-9
        if keep_full:
            FULL["V"][k] = V; FULL["Isup"][k] = isup; FULL["Im"][k] = im; FULL["F"][k] = Fn; FULL["w"][k] = wn
            for kk, val in (("v_pack", vp), ("i_pack", ipk), ("v_bus", vb), ("v_bin", vbin), ("v_out", vo), ("i_bout", io), ("q", q)):
                FULLP[kk][k] = val
        for (a, b), Wd in WIN.items():
            if a <= t < b:
                Wd["t"].append(t); Wd["V"].append(V.astype(np.float32)); Wd["Isup"].append(isup.astype(np.float32)); Wd["Im"].append(im.astype(np.float32))
                Wd["F"].append(Fn.astype(np.float32)); Wd["w"].append(wn.astype(np.float32)); Wd["pack"].append((vp, ipk, vb, vo, io, q))
        # bins
        blk["V"].append(V); blk["Isup"].append(isup); blk["Im2"].append(im * im); blk["Pel"].append(u * im); blk["absF"].append(np.abs(Fn))
        blk["sat"].append(sat); blk["w2"].append(wn * wn); blk["vp"].append(vp); blk["ip"].append(ipk); blk["vb"].append(vb); blk["vo"].append(vo); blk["io"].append(io)
        if (k + 1) % nb == 0 and (k + 1) // nb - 1 < nbins:
            j = (k + 1) // nb - 1
            Vb = np.array(blk["V"])
            BIN["V_mean"][j] = Vb.mean(0); BIN["V_min"][j] = Vb.min(0); BIN["Isup_mean"][j] = np.mean(blk["Isup"], 0)
            BIN["Im_rms"][j] = np.sqrt(np.mean(blk["Im2"], 0)); BIN["Pcu_mean"][j] = np.mean(blk["Im2"], 0) * SV.R_M
            BIN["Pel_mean"][j] = np.mean(blk["Pel"], 0); BIN["absF_mean"][j] = np.mean(blk["absF"], 0); BIN["sat_frac"][j] = np.mean(blk["sat"], 0)
            BIN["w_rms"][j] = np.sqrt(np.mean(blk["w2"], 0))
            BINP["t_end"][j] = t; BINP["q_mAh"][j] = q; BINP["v_pack_mean"][j] = np.mean(blk["vp"]); BINP["v_pack_min"][j] = np.min(blk["vp"])
            ip = np.asarray(blk["ip"], float); ioa = np.asarray(blk["io"], float)
            BINP["i_pack_mean"][j] = np.mean(ip); BINP["i_pack_max"][j] = np.max(ip); BINP["i_pack_rms"][j] = np.sqrt(np.mean(ip * ip))
            BINP["v_bus_mean"][j] = np.mean(blk["vb"])
            BINP["v_bec_out_mean"][j] = np.mean(blk["vo"]); BINP["v_bec_out_min"][j] = np.min(blk["vo"])
            BINP["i_bec_out_mean"][j] = np.mean(ioa); BINP["i_bec_out_rms"][j] = np.sqrt(np.mean(ioa * ioa))
            pos = data.qpos[fb:fb + 3]; quat = data.qpos[fb + 3:fb + 7]
            Rm = np.zeros(9); mujoco.mju_quat2Mat(Rm, quat)
            BINP["x"][j], BINP["y"][j], BINP["z"][j] = pos
            BINP["yaw"][j] = np.arctan2(Rm[3], Rm[0]); BINP["fallen"][j] = float(fallen)
            phases.append(phase)
            if on_bin is not None:
                q_deg = np.rad2deg(data.qpos[bank.qadr][perm])
                decision = on_bin(dict(
                    t=float(t), phase=phase,
                    im=BIN["Im_rms"][j].copy(), v=BIN["V_mean"][j].copy(),
                    q_deg=q_deg.copy(),
                    i_pack=float(BINP["i_pack_mean"][j]), v_pack=float(BINP["v_pack_mean"][j]),
                    i_bec=float(BINP["i_bec_out_mean"][j]), v_bec=float(BINP["v_bec_out_mean"][j]),
                ))
                if decision == "rest" and phase == "walk":
                    # Stand still before the fold. A sit that starts mid-stride tips this model.
                    phase, phase_t0, n_rests = ("pre_sit" if sit_path else "stand"), t, n_rests + 1
                    sit_from = data.ctrl.copy()
                elif decision == "walk" and phase in ("hold", "off", "stand"):
                    phase, phase_t0 = "rise", t
                    sit_from = data.ctrl.copy()
            for kk in blk:
                blk[kk].clear()
        if k >= k0:
            acc["n"] += 1; acc["lt6"] += V < 6.0; acc["lt45"] += V < 4.5; acc["lt40"] += V < 4.0
            acc["vmin"] = np.minimum(acc["vmin"], V); acc["vsum"] += V; acc["sat"] += sat; acc["im2"] += im * im
            acc["isup"] += isup; acc["pin"] += u * im; acc["err2"] += err_n * err_n; acc["limsum"] += lim
            if y is not None:
                acc["pk_i"].append(ipk); acc["bus"].append(vb); acc["vout"].append(vo); acc["vbin"].append(vbin); acc["pk_v"].append(vp)
        if gd is not None and gd.due(t):
            pack_v = vp if (y is not None and pack_floor and 8.0 <= vp <= 13.2) else None
            ev = gd.feed(t, V, pack_v=pack_v)
            if guard == "act" and gd.g.state == BG.HARD_STOPPED and stopped is None:
                stopped = ("guard hard stop", round(t, 2))
            if pack_floor and guard == "act" and stopped is None:
                for e in ev or []:
                    if e.get("event") == "walk_stop" and str(e.get("reason", "")).startswith("pack under"):
                        stopped = ("pack walk cutoff", round(t, 2))
        if counter % m.decimation == 0:
            if phase in ("walk", "stand", "pre_sit"):
                if phase in ("stand", "pre_sit"):
                    m.commands = [0.0] * 7
                else:
                    m.commands = command_fn(t, data, m) if command_fn is not None else sched(t)
                if guard == "act" and gd is not None and gd.g.state in (BG.STOPPING, BG.STANDING):
                    m.commands = [0.0] * 7
                m.imitation_i += 1.0 * m.phase_frequency_factor
                m.imitation_i = m.imitation_i % m.PRM.nb_steps_in_period
                ph = m.imitation_i / m.PRM.nb_steps_in_period * 2 * np.pi
                m.imitation_phase = np.array([np.cos(ph), np.sin(ph)])
                obs = m.get_obs(data, m.commands)
                action = m.policy.infer(obs)
                m.last_last_last_action = m.last_last_action.copy()
                m.last_last_action = m.last_action.copy()
                m.last_action = action.copy()
                m.motor_targets = m.default_actuator + action * m.action_scale
                if MI.USE_MOTOR_SPEED_LIMITS:
                    m.motor_targets = np.clip(m.motor_targets, m.prev_motor_targets - m.max_motor_velocity * (m.sim_dt * m.decimation),
                                              m.prev_motor_targets + m.max_motor_velocity * (m.sim_dt * m.decimation))
                    m.prev_motor_targets = m.motor_targets.copy()
                data.ctrl = m.motor_targets.copy()
                if phase == "pre_sit" and (t - phase_t0) >= 3.0 and last_upz > 0.9:
                    phase, phase_t0 = "sit", t
                    sit_from = data.ctrl.copy()
            elif phase == "sit" and sit_path and sit_from is not None:
                elapsed = t - phase_t0
                prev = sit_from
                tally = 0.0
                placed = False
                for dur, ctrl in sit_path:
                    if elapsed <= tally + dur:
                        alpha = 0.0 if dur <= 0 else min(1.0, (elapsed - tally) / dur)
                        data.ctrl = (1.0 - alpha) * prev + alpha * ctrl
                        placed = True
                        break
                    prev = ctrl
                    tally += dur
                if not placed:
                    data.ctrl = sit_path[-1][1]
                    phase = "off"
            elif phase == "hold" and sit_path:
                data.ctrl = sit_path[-1][1]
            elif phase == "rise" and sit_from is not None:
                alpha = min(1.0, (t - phase_t0) / 2.0)
                data.ctrl = (1.0 - alpha) * sit_from + alpha * m.default_actuator
                if alpha >= 1.0:
                    phase = "walk"
            pos = data.qpos[fb:fb + 3].copy(); quat = data.qpos[fb + 3:fb + 7].copy()
            Rm = np.zeros(9); mujoco.mju_quat2Mat(Rm, quat); Rm = Rm.reshape(3, 3); upz = Rm[2, 2]
            # A seated trunk is lower than 0.10 m. That height is the seat, not a fall.
            # A tip still counts: the trunk up-axis drops below 0.5.
            tipped = upz < 0.5
            low = pos[2] < 0.10 and phase not in ("sit", "off", "hold", "rise")
            last_upz = float(upz)
            if (tipped or low) and not fallen:
                fallen = True; falls.append(round(t, 2))
            if phase == "walk" and not fallen:
                upright_walk_s += m.sim_dt * m.decimation
            if fallen and pos[2] > 0.13 and upz > 0.8:
                fallen = False
            yaw = np.arctan2(Rm[1, 0], Rm[0, 0]); pitch = np.arcsin(-np.clip(Rm[2, 0], -1, 1)); roll = np.arctan2(Rm[2, 1], Rm[2, 2])
            log.append((t, pos[0], pos[1], pos[2], yaw, pitch, roll, 0, 0, 0, float(fallen)))
            if progress and (k + 1) % int(round(progress / dt)) == 0:
                print("  %s t %.0f s q %.0f mAh pack %.2f V bus %.2f V falls %s (%.0f s wall)" % (label, t, q, vp, vb, falls, time.time() - t_start), flush=True)
        if stop_on_fall and falls:
            stopped = stopped or ("fall", falls[0])
        if stop_q is not None and q >= stop_q:
            stopped = stopped or ("charge limit", round(t, 2))
        if stopped:
            nsteps = k + 1
            break
    bank.restore()
    wall = time.time() - t_start
    L = np.array(log)
    res = dict(label=label, mass=mass, walk=walk, cmd=list(cmd), dur_s=round(nsteps * dt, 3), supply=supply, corner=corner, extra=extra or {},
               cell=cell, cell_mode=cell_mode, q0_mAh=round(q0, 1), q_end_mAh=round(q, 1), vcell=vcell, compress=compress, servo_mode=servo_mode,
               seed=seed, falls=[f for f in falls if f > 1.0], stopped=stopped, wall_s=round(wall, 1), dt=dt, names=NAMES, servo_ids=SID,
               rests=n_rests, phase_end=phase, phases=phases, upright_walk_s=round(upright_walk_s, 2))
    if net is not None:
        it = np.array(net.iters)
        res["solver_iterations"] = dict(mean=round(float(it.mean()), 2), max=int(it.max()), p99=float(np.percentile(it, 99)))
    g = AM.gait_stats(dict(log=L, F=np.zeros((max(nsteps, 1), model.nu)), dt=dt, names=names), list(cmd)) if len(L) else {}
    res["gait"] = {k_: g.get(k_) for k_ in ("vx", "vy", "wz", "track_lin", "track_yaw", "pitch_mean_deg", "pitch_rms_deg", "roll_rms_deg", "z_mean")}
    n = max(acc["n"], 1)
    pct = lambda a: [round(100.0 * float(x) / n, 2) for x in a]          # noqa: E731
    res["servo"] = dict(V_min=[round(float(x), 3) for x in acc["vmin"]], V_mean=[round(float(x) / n, 3) for x in acc["vsum"]],
                        pct_below_6V=pct(acc["lt6"]), pct_below_4V5=pct(acc["lt45"]), ms_below_4V5=[round(float(x) * dt * 1000, 1) for x in acc["lt45"]],
                        ms_below_4V0=[round(float(x) * dt * 1000, 1) for x in acc["lt40"]], sat_pct=pct(acc["sat"]),
                        Im_rms=[round(float(np.sqrt(x / n)), 4) for x in acc["im2"]], Isup_mean=[round(float(x) / n, 4) for x in acc["isup"]],
                        Pcu_W=[round(float(x / n) * SV.R_M, 4) for x in acc["im2"]], Pel_W=[round(float(x) / n, 4) for x in acc["pin"]],
                        err_rms_deg=[round(float(np.degrees(np.sqrt(x / n))), 3) for x in acc["err2"]],
                        tau_limit_mean_Nm=[round(float(x) / n, 4) for x in acc["limsum"]])
    if acc["pk_i"]:
        pk = np.array(acc["pk_i"])
        vk = np.array(acc["pk_v"])
        sane = (vk >= 8.0) & (vk <= 13.2) & (pk >= 0.0) & (pk <= 40.0)
        c100 = np.convolve(pk[sane] if sane.any() else pk, np.ones(50) / 50, "valid") if int(sane.sum()) > 50 else pk
        res["pack"] = dict(i_mean=round(float(pk[sane].mean()) if sane.any() else float(pk.mean()), 3),
                           i_rms=round(float(np.sqrt((pk[sane] ** 2).mean())) if sane.any() else float(np.sqrt((pk ** 2).mean())), 3),
                           i_max=round(float(pk[sane].max()) if sane.any() else float(pk.max()), 3),
                           i_max_raw=round(float(pk.max()), 3),
                           v_min_raw=round(float(vk.min()), 3),
                           n_solver_spike=int((~sane).sum()),
                           **_overcurrent(pk, sane, dt),
                           i_max_100ms=round(float(c100.max()), 3),
                           v_term_mean=round(float(vk[sane].mean()) if sane.any() else float(vk.mean()), 3),
                           v_term_min=round(float(vk[sane].min()) if sane.any() else float(vk.min()), 3),
                           bus_mean=round(float(np.mean(acc["bus"])), 3), bus_min=round(float(np.min(acc["bus"])), 3),
                           bec_out_mean=round(float(np.mean(acc["vout"])), 3), bec_out_min=round(float(np.min(acc["vout"])), 3),
                           bec_in_min=round(float(np.min(acc["vbin"])), 3), bec_out_pct_below_6V=round(100 * float((np.array(acc["vout"]) < 6.0).mean()), 2))
    if gd is not None:
        res["guard"] = dict(mode=guard, events=gd.events, n_reads=gd.k)
        res["_guard_medians"] = gd.medians
    if keep_full:
        res["_full"] = {k_: v[:nsteps] for k_, v in FULL.items()}
        res["_fullp"] = {k_: v[:nsteps] for k_, v in FULLP.items()}
        Vf = res["_full"]["V"][k0:]
        if len(Vf):
            res["servo"]["pct_below_6V_50Hz_best_worst"] = [[round(100 * min(sampled_frac(Vf[:, i], dt)), 1), round(100 * max(sampled_frac(Vf[:, i], dt)), 1)] for i in range(14)]
    nbu = min(nbins, nsteps // nb)
    res["_bins"] = {k_: v[:nbu] for k_, v in BIN.items()}
    res["_binsp"] = {k_: v[:nbu] for k_, v in BINP.items()}
    res["_log"] = L
    if WIN:
        res["_windows"] = {"%g-%g" % kk: {k_: np.array(v, np.float32) for k_, v in Wd.items()} for kk, Wd in WIN.items()}
    if supply == "stock":
        res["_trace"] = dict(F=Ftr[:nsteps], W=Wtr[:nsteps], names=np.array(names), dt=dt)
    return res


# ---------------------------------------------------------------------------------------------------------------
def replay(trace, t0=10.0, t1=16.0, corner="typical", extra=None, cell="lab", vcell=3.7, q0=0.0, cell_mode="steady", servo_mode="bam"):
    """open loop: a stock walk's torques and speeds (sim/current_budget.py trace format) through the as-built network,
    with the servo law of sim/power_path_sim.py (commanded volts capped at the local volts, constant power)"""
    F, W, dt = np.asarray(trace["F"], float), np.asarray(trace["W"], float), float(trace["dt"])
    names = [str(x) for x in trace["names"]]
    perm = np.array([names.index(n) for n in NAMES])
    kt, Rm, iq_motor = SV._motor(servo_mode)
    u_cmd = np.clip(F * Rm / kt, -SV.V_TRAIN, SV.V_TRAIN)[:, perm]
    Wn = W[:, perm]
    k0, k1 = int(t0 / dt), int(t1 / dt)
    cellm = CELLS[cell](mode=cell_mode) if cell in CELLS else None
    net = PN.Net(corner, extra, cell_model=cellm)
    iq = iq_motor if servo_mode == "sheet" else net.iq
    n = k1 - k0
    Vs = np.zeros((n, 14)); P = np.zeros((n, 6))
    for j, k in enumerate(range(k0, k1)):
        uc, ww = u_cmd[k], Wn[k]

        def law(v, uc=uc, ww=ww):
            vl = np.maximum(v, 0.5); ue = np.clip(uc, -vl, vl)
            return np.maximum(ue * (ue - kt * ww) / Rm, 0.0) / vl + iq
        y = net.solve(law, vcell=vcell, qm=q0)
        if cellm is not None:
            cellm.advance(float(y[net.o["i_pack"]]), dt)
        Vs[j] = net.servo_volts(y)
        P[j] = [y[net.o["v_pack"]], y[net.o["i_pack"]], y[net.o["v_bus"]], y[net.o["v_out"]], y[net.o["i_bout"]], y[net.o["v_bin"]]]
    return dict(t=np.arange(k0, k1) * dt, V=Vs, pack=P, names=NAMES, dt=dt, iters=np.array(net.iters))


def replay_summary(r):
    V, P, dt = r["V"], r["pack"], r["dt"]
    i = P[:, 1]
    out = dict(bus_mean=round(float(P[:, 2].mean()), 3), bec_out_mean=round(float(P[:, 3].mean()), 3), pack_i_mean=round(float(i.mean()), 3),
               pack_i_max=round(float(i.max()), 3), pack_i_rms=round(float(np.sqrt((i ** 2).mean())), 3),
               V_min=[round(float(x), 3) for x in V.min(0)], V_mean=[round(float(x), 3) for x in V.mean(0)],
               pct_below_6V=[round(100 * float(x), 2) for x in (V < 6.0).mean(0)], ms_below_4V5=[round(float(x) * dt * 1000, 1) for x in (V < 4.5).sum(0)],
               pct_below_6V_50Hz_best_worst=[[round(100 * min(sampled_frac(V[:, k], dt)), 1), round(100 * max(sampled_frac(V[:, k], dt)), 1)] for k in range(14)])
    w = int(np.argmin(V.min(0)))
    out["worst"] = NAMES[w]
    return out


def save_npz(path, res):
    """heavy outputs (scratch): full traces, bins, the base log"""
    d = {}
    for key in ("_full", "_fullp", "_bins", "_binsp"):
        for k, v in (res.get(key) or {}).items():
            d["%s_%s" % (key.strip("_"), k)] = v
    if "_log" in res:
        d["log"] = np.asarray(res["_log"], np.float32)
    for wk, W in (res.get("_windows") or {}).items():
        for k, v in W.items():
            d["win_%s_%s" % (wk, k)] = v
    if "_guard_medians" in res:
        d["guard_medians"] = np.array([(a, np.nan if b is None else b) for a, b in res["_guard_medians"]], np.float32)
    d["names"] = np.array(NAMES); d["servo_ids"] = np.array(SID)
    np.savez_compressed(path, **d)


def public(res):
    return {k: v for k, v in res.items() if not k.startswith("_")}


# ---------------------------------------------------------------------------------------------------------------
# steps
# ---------------------------------------------------------------------------------------------------------------
def _write(name, obj, git=True):
    os.makedirs(os.path.join(SCR, "json"), exist_ok=True)
    json.dump(obj, open(os.path.join(SCR, "json", name), "w"), indent=1, default=float)
    if git:
        os.makedirs(OUT_GIT, exist_ok=True)
        json.dump(obj, open(os.path.join(OUT_GIT, name), "w"), indent=1, default=float)


def stock_trace(mass, walk, dur=30.0, seed=None):
    """the trained-actuator walk (open-loop input), saved in the sim/current_budget.py trace format"""
    path = os.path.join(SCR, "traces", "trace_%s_%s_s%s_%gs.npz" % (mass, walk, seed, dur))
    if os.path.exists(path):
        d = dict(np.load(path, allow_pickle=True))
        return d, path, json.loads(str(d["meta"]))
    r = run(mass, walk, dur=dur, supply="stock", seed=seed, keep_full=False, guard=None)
    tr = r["_trace"]
    os.makedirs(os.path.dirname(path), exist_ok=True)
    meta = dict(gait=r["gait"], falls=r["falls"], servo=r["servo"])
    np.savez_compressed(path, F=tr["F"], W=tr["W"], names=tr["names"], dt=tr["dt"], meta=json.dumps(meta))
    return dict(np.load(path, allow_pickle=True)), path, meta


def _short(r):
    """the numbers the tables use, NAMES order -> dict by joint"""
    s = r["servo"]
    d = dict(falls=r["falls"], gait={k: (None if v is None else round(v, 4)) for k, v in r["gait"].items()}, pack=r.get("pack"),
             guard=[(e["t"], e["event"], e["value"]) for e in (r.get("guard") or {}).get("events", [])],
             wall_s=r["wall_s"], solver=r.get("solver_iterations"))
    for key in ("V_min", "V_mean", "pct_below_6V", "ms_below_4V5", "ms_below_4V0", "sat_pct", "Im_rms", "Pcu_W", "err_rms_deg", "tau_limit_mean_Nm",
                "pct_below_6V_50Hz_best_worst"):
        if key in s:
            d[key] = dict(zip(NAMES, s[key]))
    return d


def check():
    """validation: servo model against the data sheet and the trained actuator, network against ngspice"""
    out = dict(servo_datasheet=SV.datasheet_check())
    dd = json.load(open(p30b.DATA))
    out["p30b"] = dict(check_vs_runtime_thermal_max_abs_mV=dd["check_vs_runtime_thermal_max_abs_mV"], cell=p30b.summary(CELL))
    # 1. the twin at 7.4 V is the trained robot; the stock run is the lab loop
    ident = {}
    for mass in ("trained", "ours"):
        a = run(mass, "backlash", dur=16.0, supply="stock", keep_full=True, guard=None)
        b = run(mass, "backlash", dur=16.0, supply="fixed", fixed_v=7.4, keep_full=True, guard=None)
        folder = model_folder(mass)
        lab = AM.run(folder, SCENES["backlash"], CB.sched_const([0.15, 0, 0, 0, 0, 0, 0]), 16.0)
        names = list(lab["names"]); perm = [names.index(n) for n in NAMES]
        ident[mass] = dict(fixed_7V4_vs_stock_max_abs_dF_Nm=float(np.abs(a["_full"]["F"] - b["_full"]["F"]).max()),
                           fixed_7V4_vs_stock_max_abs_dlog=float(np.abs(a["_log"] - b["_log"]).max()),
                           stock_vs_lab_loop_max_abs_dF_Nm=float(np.abs(a["_trace"]["F"] - lab["F"].astype(np.float32)).max()),
                           stock_vs_lab_loop_max_abs_dW=float(np.abs(a["_trace"]["W"] - lab["W"].astype(np.float32)).max()),
                           stock_gait=a["gait"])
        print("identity", mass, ident[mass], flush=True)
    out["identity"] = ident
    # 2. open-loop replay through the Python network against the lab's ngspice as-built run on the same traces
    rep = []
    _mk(os.path.join(SCR, "ngspice"))
    for mass in ("trained", "ours"):
        tr, path, meta = stock_trace(mass, "backlash", dur=16.0)
        for pk in ("full", "nominal", "low"):
            for corner in ("typical", "high-side"):
                ex = dict(PN.CORNERS[corner])
                tag = "ng_%s_%s_%s" % (mass, pk, corner)
                ng = PN.PF.run("check " + tag, path, 10.0, 16.0, LAB_VCELL[pk], PN.PF.OPTIONS["ab"], "high-side", extra=ex, save=tag,
                               save_dir=os.path.join(SCR, "ngspice"))
                nv = np.load(os.path.join(SCR, "ngspice", tag + ".npz"))
                py = replay(tr, 10.0, 16.0, corner=corner, cell="lab", vcell=LAB_VCELL[pk])
                ps = replay_summary(py)
                nn = [str(x) for x in nv["names"]]
                dv = max(float(np.abs(np.interp(py["t"], nv["t"] + 10.0, nv["V"][nn.index(n)]) - py["V"][:, i]).max()) for i, n in enumerate(NAMES))
                row = dict(mass=mass, pack=pk, corner=corner, max_abs_dV_2ms_points=round(dv, 5),
                           ngspice=dict(bus_mean=ng["bus_V_mean"], bec_out_mean=ng["bec_out_V_mean"], pack_mean=ng["pack_A_mean"], pack_max=ng["pack_A_max"],
                                        pack_rms=ng["pack_A_rms"], worst=ng["worst_servo"], worst_min=ng["worst_servo_V_min"],
                                        knees_pct6=[ng["servo_pct_below_6V"]["left_knee"], ng["servo_pct_below_6V"]["right_knee"]],
                                        ankle_pct6=ng["ankle_pct_below_6V"], head_roll_pct6=ng["servo_pct_below_6V"]["head_roll"]),
                           python=dict(bus_mean=ps["bus_mean"], bec_out_mean=ps["bec_out_mean"], pack_mean=ps["pack_i_mean"], pack_max=ps["pack_i_max"],
                                       pack_rms=ps["pack_i_rms"], worst=ps["worst"], worst_min=min(ps["V_min"]),
                                       knees_pct6=[ps["pct_below_6V"][NAMES.index("left_knee")], ps["pct_below_6V"][NAMES.index("right_knee")]],
                                       ankle_pct6=max(ps["pct_below_6V"][NAMES.index("left_ankle")], ps["pct_below_6V"][NAMES.index("right_ankle")]),
                                       head_roll_pct6=ps["pct_below_6V"][NAMES.index("head_roll")]))
                rep.append(row)
                print("replay", mass, pk, corner, "max dV %.4f V" % dv, row["ngspice"]["worst"], row["ngspice"]["worst_min"], row["python"]["worst_min"],
                      "knees", row["ngspice"]["knees_pct6"], row["python"]["knees_pct6"], flush=True)
    out["replay_vs_ngspice"] = rep
    # 3. the closed loop's own currents through ngspice (lab cells, nominal, both corners)
    same = []
    for corner in ("typical", "high-side"):
        r = run("ours", "backlash", dur=16.0, supply="net", corner=corner, cell="lab", vcell=3.7, keep_full=True, guard=None)
        dt = r["dt"]; k0, k1 = int(10.0 / dt), int(16.0 / dt)
        I = r["_full"]["Isup"][k0:k1].astype(float); t = np.arange(k0, k1) * dt
        tt, Vng, vout, vbus = PN.ngspice_same_currents(t, I, corner=corner, vcell=3.7)
        Vpy = r["_full"]["V"][k0:k1].astype(float)
        dv = max(float(np.abs(np.interp(t - t[0], tt, Vng[i]) - Vpy[:, i]).max()) for i in range(14))
        dvo = float(np.abs(np.interp(t - t[0], tt, vout) - r["_fullp"]["v_out"][k0:k1]).max())
        same.append(dict(corner=corner, max_abs_dV_servo=round(dv, 5), max_abs_dV_bec_out=round(dvo, 5), n_points=int(len(t))))
        print("same currents", corner, same[-1], flush=True)
    out["same_currents_vs_ngspice"] = same
    _write("check.json", out)
    return out


def states(walks=("backlash", "plain"), seeds=(None, 1), corners=("typical", "high-side"), sts=("full", "nominal", "d16", "low"), mass="ours", dur=30.0,
           cell="p30b", servo_mode="bam", out_name=None):
    """the walk at fixed pack states (charge frozen): closed loop against open loop, both corners"""
    cellm0 = CELLS[cell]()
    stq = pack_states(cellm0)
    rows = []
    for walk in walks:
        for seed in seeds:
            tr, path, meta = stock_trace(mass, walk, dur=dur, seed=seed)
            fx = run(mass, walk, dur=dur, supply="fixed", fixed_v=7.2, seed=seed, keep_full=False, guard=None)
            rows.append(dict(kind="reference", walk=walk, seed=seed, case="stock (trained actuators)", **{"gait": meta["gait"], "falls": meta["falls"]}))
            rows.append(dict(kind="reference", walk=walk, seed=seed, case="every servo at 7.2 V", **_short(fx)))
            print("ref", walk, seed, "stock", round(meta["gait"]["track_lin"], 3), "7.2 V", round(fx["gait"]["track_lin"], 3), flush=True)
            for st in sts:
                for corner in corners:
                    r = run(mass, walk, dur=dur, supply="net", corner=corner, cell=cell, q0=stq[st], compress=0.0, seed=seed, keep_full=True,
                            guard="shadow", servo_mode=servo_mode, label="%s %s %s" % (walk, st, corner))
                    save_npz(os.path.join(SCR, "states", "closed_%s_%s_%s_s%s.npz" % (walk, st, corner, seed)), r) if _mk(os.path.join(SCR, "states")) else None
                    op = replay(tr, 4.0, dur, corner=corner, cell=cell, q0=stq[st], servo_mode=servo_mode)
                    os_ = replay_summary(op)
                    row = dict(kind="pack state", walk=walk, seed=seed, state=st, corner=corner, cell=cell, servo_mode=servo_mode,
                               q_mAh=round(stq[st], 1), soc=round(cellm0.soc(stq[st]), 3),
                               ocv_cell=round(cellm0.ocv(stq[st]), 3), closed=_short(r),
                               open=dict(V_min=dict(zip(NAMES, os_["V_min"])), V_mean=dict(zip(NAMES, os_["V_mean"])), pct_below_6V=dict(zip(NAMES, os_["pct_below_6V"])),
                                         ms_below_4V5=dict(zip(NAMES, os_["ms_below_4V5"])), bus_mean=os_["bus_mean"], bec_out_mean=os_["bec_out_mean"],
                                         pack_i_mean=os_["pack_i_mean"], pack_i_max=os_["pack_i_max"], pack_i_rms=os_["pack_i_rms"], worst=os_["worst"],
                                         pct_below_6V_50Hz_best_worst=dict(zip(NAMES, os_["pct_below_6V_50Hz_best_worst"]))))
                    rows.append(row)
                    c = row["closed"]
                    print("%-8s s%-4s %-7s %-9s closed: falls %s track %.3f knees min %.2f/%.2f <6V %.1f/%.1f %% | open: knees min %.2f/%.2f <6V %.1f/%.1f %% (%.0f s)" % (
                        walk, seed, st, corner, c["falls"], c["gait"]["track_lin"] or 0, c["V_min"]["left_knee"], c["V_min"]["right_knee"],
                        c["pct_below_6V"]["left_knee"], c["pct_below_6V"]["right_knee"], row["open"]["V_min"]["left_knee"], row["open"]["V_min"]["right_knee"],
                        row["open"]["pct_below_6V"]["left_knee"], row["open"]["pct_below_6V"]["right_knee"], r["wall_s"]), flush=True)
    _write(out_name or ("states_%s.json" % "_".join(walks)), rows)
    return rows


def _mk(d):
    os.makedirs(d, exist_ok=True)
    return True


def session(walk="backlash", corner="typical", extra=None, tag=None, dur=4000.0, cell_mode="steady", servo_mode="bam", cell="p30b"):
    """a session that runs the pack down from a full charge, no time compression; the D16 guard in shadow mode.
    Stops at a fall or when the cells reach OCV 3.30 V (past the guard's hard stop)."""
    tag = tag or "%s_%s" % (walk, corner)
    cellm0 = CELLS[cell]()
    stop_q = pack_states(cellm0)["low"]
    wins = [(60.0, 80.0)] + [(float(a), float(a) + 20.0) for a in range(300, int(dur), 300)]
    r = run("ours", walk, dur=dur, supply="net", corner=corner, extra=extra, cell=cell, q0=0.0, compress=1.0, guard="shadow", keep_full=False,
            bin_s=0.1, stop_q=stop_q, stop_on_fall=True, label="session " + tag, full_windows=wins, progress=60.0, cell_mode=cell_mode,
            servo_mode=servo_mode)
    _mk(os.path.join(SCR, "session"))
    save_npz(os.path.join(SCR, "session", "session_%s.npz" % tag), r)
    summ = session_summary(r, tag, cellm0)
    _write("session_%s.json" % tag, summ)
    session_csv(r, tag, cell=cellm0)
    return summ


def _moving_speed(B, win_s=20.0):
    """forward speed (heading frame) over a moving window, from the 0.1 s bins: distance along the mean heading / time"""
    t, x, y, yaw = B["t_end"].astype(float), B["x"].astype(float), B["y"].astype(float), np.unwrap(B["yaw"].astype(float))
    n = max(1, int(round(win_s / float(t[1] - t[0]))))
    v = np.full(len(t), np.nan)
    for i in range(n, len(t)):
        dx, dy = x[i] - x[i - n], y[i] - y[i - n]
        h = 0.5 * (yaw[i] + yaw[i - n])
        v[i] = (np.cos(h) * dx + np.sin(h) * dy) / (t[i] - t[i - n])
    return t, v


def session_summary(r, tag, cell=None):
    cell = cell or CELL
    B, BP = r["_bins"], r["_binsp"]
    t, v20 = _moving_speed(BP, 20.0)
    ref_sel = (t >= 30.0) & (t <= 70.0)                     # 20 s windows ending 30 to 70 s: walking 10 to 70 s, full pack
    v_ref = float(np.nanmean(v20[ref_sel])) if ref_sel.any() else float("nan")
    cmd = 0.15
    below = np.where((t > 70.0) & (v20 < 0.85 * v_ref))[0]
    # first time the 20 s speed stays under 85 % of the full-charge speed for 60 s
    first_bad = None
    for i in below:
        j = np.where((t >= t[i]) & (t <= t[i] + 60.0))[0]
        if len(j) and np.all(v20[j] < 0.85 * v_ref):
            first_bad = float(t[i]); break
    ev = (r.get("guard") or {}).get("events", [])
    def first(name):
        x = [e for e in ev if e["event"] == name]
        return (x[0]["t"], x[0]["value"]) if x else (None, None)
    ws, hs = first("walk_stop"), first("hard_stop")
    def at(tq):
        if tq is None: return None
        i = int(np.clip(np.searchsorted(t, tq), 0, len(t) - 1))
        return dict(t_s=round(float(t[i]), 1), minute=round(float(t[i]) / 60, 2), q_mAh=round(float(BP["q_mAh"][i]), 1), soc=round(cell.soc(float(BP["q_mAh"][i])), 3),
                    ocv_cell=round(cell.ocv(float(BP["q_mAh"][i])), 3), v_pack=round(float(BP["v_pack_mean"][i]), 3),
                    speed_20s=None if np.isnan(v20[i]) else round(float(v20[i]), 4), speed_rel_full=None if np.isnan(v20[i]) else round(float(v20[i] / v_ref), 3))
    # minute table: per minute mean speed, pack, bus, the lowest servo per joint group
    rows = []
    for mnt in range(int(t[-1] // 60) + 1):
        sel = (t > mnt * 60) & (t <= (mnt + 1) * 60)
        if sel.sum() < 10: continue
        Vm, Vn = B["V_mean"][sel], B["V_min"][sel]
        rows.append(dict(minute=mnt + 1, q_mAh=round(float(BP["q_mAh"][sel][-1]), 1), soc=round(cell.soc(float(BP["q_mAh"][sel][-1])), 3),
                         speed=None if np.all(np.isnan(v20[sel])) else round(float(np.nanmean(v20[sel])), 4),
                         v_pack=round(float(BP["v_pack_mean"][sel].mean()), 3), i_pack=round(float(BP["i_pack_mean"][sel].mean()), 3),
                         v_bus=round(float(BP["v_bus_mean"][sel].mean()), 3), v_bec_out=round(float(BP["v_bec_out_mean"][sel].mean()), 3),
                         median_servo_v=round(float(np.median(Vm.mean(0))), 3),
                         knee_min=round(float(Vn[:, [NAMES.index("left_knee"), NAMES.index("right_knee")]].min()), 3),
                         ankle_min=round(float(Vn[:, [NAMES.index("left_ankle"), NAMES.index("right_ankle")]].min()), 3),
                         head_roll_min=round(float(Vn[:, NAMES.index("head_roll")].min()), 3),
                         knee_sat_pct=round(100 * float(B["sat_frac"][sel][:, [NAMES.index("left_knee"), NAMES.index("right_knee")]].mean()), 1),
                         fallen=bool(BP["fallen"][sel].max() > 0)))
    return dict(tag=tag, walk=r["walk"], corner=r["corner"], extra=r["extra"], cell_mode=r["cell_mode"], servo_mode=r["servo_mode"], compress=r["compress"],
                dur_s=r["dur_s"], wall_s=r["wall_s"], stopped=r["stopped"], falls=r["falls"], q_end_mAh=r["q_end_mAh"],
                full_charge_speed=round(v_ref, 4), full_charge_track=round(v_ref / cmd, 3),
                walk_degraded=at(first_bad), guard_walk_stop=at(ws[0]), guard_walk_stop_value=ws[1], guard_hard_stop=at(hs[0]), guard_hard_stop_value=hs[1],
                guard_events=ev, solver=r.get("solver_iterations"), minutes=rows)


def session_csv(r, tag, bin_out_s=5.0, cell=None):
    """5 s bins for the twin/thermal job and the plots (format: ELECTROMECH_TWIN.md 'Trace format')"""
    cell = cell or CELL
    B, BP = r["_bins"], r["_binsp"]
    t = BP["t_end"].astype(float)
    nb = int(round(bin_out_s / float(t[1] - t[0])))
    nbin = len(t) // nb
    _, v20 = _moving_speed(BP, 20.0)
    cols = ["t_s", "q_mAh", "soc", "v_pack", "i_pack", "i_pack_rms", "v_bus", "v_bec_out", "i_bec_out", "i_bec_rms", "speed_20s", "fallen"]
    per = [("V_mean", "v"), ("V_min", "vmin"), ("Isup_mean", "isup"), ("Im_rms", "im_rms"), ("Pcu_mean", "pcu"), ("sat_frac", "sat")]
    hdr = cols + ["%s_%d" % (p, sid) for _, p in per for sid in SID]
    lines = ["# twin/electromech/em_twin.py session %s (sim pass only); 5 s bins; columns in ELECTROMECH_TWIN.md 'Trace format'; servo columns end in the servo ID" % tag,
             ",".join(hdr)]
    for j in range(nbin):
        s = slice(j * nb, (j + 1) * nb)
        # RMS over the 5 s group is the root of the mean of the 0.1 s mean-squares, not the mean of the RMS values
        i_pack_rms = float(np.sqrt(np.mean(np.square(BP["i_pack_rms"][s]))))
        i_bec_rms = float(np.sqrt(np.mean(np.square(BP["i_bec_out_rms"][s]))))
        row = [t[s][-1], BP["q_mAh"][s][-1], cell.soc(float(BP["q_mAh"][s][-1])), BP["v_pack_mean"][s].mean(), BP["i_pack_mean"][s].mean(), i_pack_rms, BP["v_bus_mean"][s].mean(),
               BP["v_bec_out_mean"][s].mean(), BP["i_bec_out_mean"][s].mean(), i_bec_rms, np.nanmean(v20[s]) if not np.all(np.isnan(v20[s])) else np.nan, BP["fallen"][s].max()]
        for key, _ in per:
            X = B[key][s]
            if key == "V_min":
                v = X.min(0)
            elif key == "Im_rms":
                v = np.sqrt((X.astype(float) ** 2).mean(0))
            else:
                v = X.mean(0)
            row += list(v)
        lines.append(",".join("%.4g" % x if np.isfinite(x) else "" for x in row))
    open(os.path.join(OUT_GIT, "session_%s.csv" % tag), "w").write("\n".join(lines) + "\n")
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
