aaltaay/Open_Duck_Mini_v2/altaay_lab/twin/parts_truth.py

#!/usr/bin/env python3
"""One parts file for the duck that will be built.

Derived from wiring/netlist.yaml, verify/part_limits.yaml, and bom/order/
(ORDER.md plus the part identities in ORDER.csv). Prices are not copied.
The charger TS resistors come from circuitry/bq24133_board.yaml because the
netlist charger part names that board.

  python3 altaay_lab/twin/parts_truth.py --write
  python3 altaay_lab/twin/parts_truth.py --check

The twin loads altaay_lab/twin/parts.yaml and nothing else for these numbers.
"""
import csv
import json
import os
import re
import sys
import tempfile

import yaml

HERE = os.path.dirname(os.path.abspath(__file__))
LAB = os.path.abspath(os.path.join(HERE, ".."))
ROOT = os.path.abspath(os.path.join(LAB, ".."))
PARTS_PATH = os.path.join(HERE, "parts.yaml")
NETLIST = os.path.join(LAB, "wiring", "netlist.yaml")
LIMITS = os.path.join(LAB, "verify", "part_limits.yaml")
ORDER_MD = os.path.join(LAB, "bom", "order", "ORDER.md")
ORDER_CSV = os.path.join(LAB, "bom", "order", "ORDER.csv")
BOARD = os.path.join(LAB, "circuitry", "bq24133_board.yaml")
GUARD = os.path.join(LAB, "bench", "battery_guard.py")
POWER_NET = os.path.join(LAB, "twin", "electromech", "power_net.py")
LIMITS_JSON = os.path.join(LAB, "software", "servo_limits.json")


def rel(path):
    return os.path.relpath(path, ROOT).replace("\\", "/")


def load_yaml(path):
    with open(path, encoding="utf-8") as f:
        return yaml.safe_load(f)


def component(net, cid):
    for c in net["components"]:
        if c["id"] == cid:
            return c
    raise KeyError(cid)


def near(a, b, tol=1e-6):
    if isinstance(a, bool) or isinstance(b, bool):
        return a is b
    if isinstance(a, (int, float)) and isinstance(b, (int, float)):
        return abs(float(a) - float(b)) <= tol
    return a == b


def same(a, b):
    if isinstance(a, dict) and isinstance(b, dict):
        if set(a) != set(b):
            return False
        return all(same(a[k], b[k]) for k in a)
    if isinstance(a, list) and isinstance(b, list):
        return len(a) == len(b) and all(same(x, y) for x, y in zip(a, b))
    return near(a, b)
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
