aaltaay/Open_Duck_Mini_v2/(commit log)

2026-11-01 altaay_lab: add BOM.md
2026-11-01 Servo deep dive: STS3215 7.4V 1:345 (C001), issue #48 analysis; update D1, A1, B9
2026-11-01 altaay_lab: D3 decided, servo regulator (Castle CC BEC Pro 7.2 V) + 15 A fuse, POWER.md, WIRING.md + schematic, sim walk check of BEST_WALK_ONNX_2
2026-11-01 Hardware audit: HARDWARE_AUDIT, PRINT_CHECK, CABLE_MAP, MOUNTING, final BOM with tools, audit scripts
2026-11-01 altaay_lab: D1 records the posted #48 question and C001 conclusion, GAPS B10a SG90 bus rule gap, make_wiring.py relative paths, time fixes
    [make_wiring.py]
2026-11-01 altaay_lab: blocker pass, 10 of 29 cleared from CAD and cited sources, test order list
2026-11-02 altaay_lab: print-readiness pass, decisions D1 to D16, power path sim, placements, test plan, upstream triage
    Made under Ahmed's delegation to reach the 3D printing phase (DECISIONS.md D1 to D16).
    - Power path: Tenergy 32175 BMS, 15 A fuse kept, Pololu 2815 main switch with the
    stock panel switch as its control, Pololu D30V30F5 on the head floor, servo power
    bypasses the Waveshare adapter (belly splices, one 22 AWG lead per chain).
    - Sim pass only: servo current budget from the stock walk, ngspice model of the power
    path down to every servo; removed the +1.3 accelerometer bias of the upstream sim loop.
    - Placement: free-space search over the swept trunk volume seats every part that is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
2026-11-02 altaay_lab: wiring netlist, pictorial, schematic and harness drawings, ERC clean, D17 foot switch pull-ups
    - wiring/netlist.yaml is the single source for every pin and wire (56 components,
    224 pins, 118 conductors); the three drawings are generated from it.
    - Pictorial wiring diagram (every part with its real terminals, every wire terminal
    to terminal with cable id, gauge and cut length), schematic with the Pi header
    table, harness drawing with joints crossed and the cut list.
    - Electrical rule check: 0 errors, 0 warnings; continuity checklist for the cable test.
    - D17: Omron SS-01 gold-contact foot switches (SS-10 fallback) and a 2.2 kOhm pull-up
    per foot, because the feet go into t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
    [continuity_checklist.csv]
2026-11-02 altaay_lab: print package (configs, coupons from the real STLs, slice summary), D18 hip roll screw, doc fixes
    - print/PRINT_PLAN.md with what Ahmed approves on top: coupon session 5.0 h
    (27.8 g PLA, 18.2 g TPU), full print 126.4 h in 15 jobs on a 220 mm bed
    (1474.5 g PLA, 18.1 g TPU, 10 spares). PrusaSlicer 2.7.2 estimates, generic printer.
    - Slicer configs with overrides for insert walls, fit faces and the neck chain;
    coupon generator and slice script write outputs outside the repo.
    - Upstream issue 17 confirmed in the CAD: the outer hip roll screw head overlaps
    roll_to_pitch by 1.3 mm. D18: leave it out, check rigidity on the first leg (B30).
    - Doc fixes: 36 STLs, B14 and B15 corre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
    [parts.csv]
2026-11-02 altaay_lab: every-part BOM, harness build sheet, viewer pipeline for screws, cables and ties
    - BOM_FULL.md / bom_full.csv: one row per distinct item in the robot with where it
    goes, the viewer nodes that show it and the BOM.md line that supplies it; 8 needs
    without a purchase line flagged (solder, cable ties, supplies, test gear).
    - BOM.md Need values corrected from the netlist (housings 5, terminals 13, wire
    lengths); totals unchanged.
    - HARNESS_BUILD.md: build sheet for all 45 cables and 118 wires (cut, ends, splices,
    continuity test per cable).
    - make_viewer_data.py reads fasteners.json and cables3d.json (screws, cables, ties,
    terminal seats), adds purchase links, fixes stale la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
    [bom_full.csv]
2026-11-02 altaay_lab: viewer draws connectors, splices and small parts from scene_extras.json, linked to BOM_FULL rows
    Claude-Session: https://claude.ai/code/session_01Jzg4ArZQC1FvaW8PbwWFoJ
2026-11-02 altaay_lab: viewer reads the fastener schedule fields (seat, head, colour, checks), draws cable branches and keeps bracket seats
    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
2026-11-02 altaay_lab: mass budget (2.77 kg, +31 % on the trained model), walk sim with the real mass, runtime and servo heat (sim pass only)
    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
2026-11-02 altaay_lab: sourcing pass, every build need has a US purchase line; BOM_FULL regenerated
    - New lines: 30 solder (Adafruit 1886), 31 flux pen, 32 cable ties, 33 polyimide
    tape for the BMS wrap; tools T6/T6b PD supply and 5 A cable for the Pinecil,
    T7/T7b 5 V charge adapter and cable, T8 microSD reader (optional), T9 12 to 20
    AWG stripper, T10 heat gun. New "Test equipment (if not on hand)" section kept
    outside all totals.
    - Rechecks today: bare Pi Zero 2 W still out at 6 US sellers (kits in stock),
    Motoforti bearing stock unverified (VXB alternative), SS-01 stock conflicting.
    - Build total $868.70 (was $837.14); build + expression + tools $1,189.13.
    - BOM_FULL: the 8 missing build n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
    [bom_full.csv]
2026-11-02 altaay_lab: TEST_PLAN fixes from the sourcing and sim passes
    - Section 0 names the test gear (BOM TE1 to TE4) and which tests use the supply
    and which the electronic load; ohm passes are read as numbers, not by the beep.
    - 3.2 holder drop and 3.3 BMS over-current trip run on the electronic load with
    short program steps that reach 27 A (the old 0.5 ohm load could not reach the
    17 to 27 A trip range).
    - 7.3 thermal test holds by current (1.5 A) and predicts the knee temperature
    after 31 min of walking (sim/RUNTIME_THERMAL.md).
    - New 8.0: weigh the robot and find its centre of mass before the first walk
    (sim/ADDED_MASS_SIM.md).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
2026-11-02 altaay_lab: BOM wording, sources point to SOURCING_2026-11-02.md
    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
2026-11-02 altaay_lab: sourcing pass history, D2 thermal hold by current, stale wording fixes
    - history/2026-11-01_2211_sourcing_pass.md (sourcing integration).
    - DECISIONS D2: the TO1 thermal run holds by current (1.5 A) per sim/RUNTIME_THERMAL.md;
    the first 1.5 Nm version is kept in the text with the reason it changed.
    - BOM T1 points to the PD supply lines T6/T6b; continuity checklist passes are read
    in ohms, not by the beep (erc.py re-run, still 0 errors); TEST_PLAN timestamp.
    - Viewer maps new tool, test gear and consumable lines without warnings.
    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
    [continuity_checklist.csv]
2026-11-02 altaay_lab: 3D completeness, 166 connectors, splices, joints and small parts for the exploded view, seat-fit findings
    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
2026-11-02 altaay_lab: fastener schedule, every screw, insert and washer found in the CAD, checked over the joint ranges and posed for the 3D view
    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
    [fasteners.csv]
2026-11-02 altaay_lab: software path (Pi setup from a blank card) and bench scripts with battery and temperature guards, 53 tests on a simulated servo bus
    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
    [sim_star_discharge.csv, sim_star_full_typical.csv, sim_star_low_typical.csv, sim_star_nominal_highside.csv, sim_star_nominal_typical.csv]
2026-11-02 altaay_lab: 3D view draws all 355 screws and 166 small parts with exact orientation; seat fixes for the tape; harness sheet end fixes
    - make_viewer_data.py: screws without a chosen length are drawn from draw_length_mm
    (marked "length from the drawing, not yet chosen"); small parts use rotation_3x3,
    cylinders, translucent render and link to BOM_FULL rows by name; the xt30 and
    power_splice placeholder boxes are replaced by the real XT30 halves and splices;
    5 V regulator seat raised by the tape thickness.
    - placements.json: seats corrected for the 1.1 mm foam tape: BEC Pro to
    (-64.5, -0.5, -9.8) (2.8 mm lower and 7 mm forward because the belly floor slopes
    up behind x -81), fuse hol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
    [bom_full.csv]
2026-11-02 altaay_lab: servo upgrade options (STS3250 in the same body, decision threshold from the TO1 heat test)
    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
2026-11-02 altaay_lab: D19 to D21 from the fastener schedule, BOM screw counts and new lines, doc fixes from the fastener and software passes
    - D19: ISO 7380 button heads at the 10 hip pitch idle horn sites where a DIN 912
    head hits roll_to_pitch; D20: drill the 24 neck chain recesses to 6.0 mm and the
    battery lid holes to 2.7 mm (coupon C4 carries the recess fit test); D21: eye screws
    M2.5x8 with a washer (blind pilots); D16 note: how the battery guard applies the
    6.0 V rule while walking.
    - BOM: 17a 28, 17d 78, 17e 28 needs; new 17j M3x6 ISO 7380, 17k M2.5x5 (speaker
    interface holes), 17l M2.5 washers, T11 to T13 drill bits and handle, TO16 recess
    test parts. Build total $890.19; test ord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
2026-11-02 altaay_lab: clean wiring sheets, one subsystem per sheet, all 118 wires drawn terminal to terminal
    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
2026-11-02 altaay_lab: verification matrix, 22 no-hardware checks (17 pass, 5 fail with fixes under way)
    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
    [c10_sheets.py, c11_hip_yaw_envelope.py, c1_bom_coverage.py, c2_connectors.py, c3_cables3d.py, c4_fasteners.py, c5_servo_ids.py, c6_gpio.py]
2026-11-02 altaay_lab: viewer reads cable checks, gap ties and wire lists cleanly; seats regenerated after the tape fix
    - make_viewer_data.py: "pass with notes" counts as pass with its text kept in the
    note; retention items at gaps are flagged as gaps; cables carry a wire count and
    readable wire lines; view mappings for BOM lines 17j to 17l.
    - placements.json: BEC Pro seat_fix note gives the floor slope reason, clearances
    and the 57.7 mm IMU distance.
    - make_scene_extras.py: 5 V regulator z 182.6 (tape); scene_extras.json and
    coverage.json regenerated; every taped part sits on its tape within 0.04 mm.
    - BOM_FULL.md, bom_full.csv, HARNESS_BUILD.md regenerated (193 rows).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
    [bom_full.csv]
2026-11-02 altaay_lab: every cable routed in 3D with bracket seats, ties, reach and bend checks
    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
2026-11-02 altaay_lab: BOM gets the adhesive tie mounts, enough cable ties and isopropyl alcohol
    - Line 34: HellermannTyton 151-01629 adhesive tie mount, 19 mm square, 3M VHB acrylic
    foam, two screw holes as backup; 77 needed by the 3D cable routing, one 100-pack.
    - Line 35: Techspray isopropyl alcohol, for the mount spots and the VHB tape.
    - Line 32: 93 ties counted (8 free, 77 through mounts, 8 through printed holes),
    Buy 2 packs.
    - Build total $971.93 (was $890.19).
    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
2026-11-02 altaay_lab: print mass study, lighter settings save 128 g while keeping the strength rules
    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
    [parts_light.csv]
2026-11-02 altaay_lab: power path fix study, second feed into each ankle (D23), 3S held until the walking log
    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
    [power_fix.py]
2026-11-02 altaay_lab: emergency stop reads torque back and retries; ERC checks over-voltage on powered inputs
    - bench/odm_bench/walkhooks.py hard_stop(): reads register 40 on all 14 servos and
    rewrites torque off until each reads 0 (30 reads, 0.3 s apart); a servo still on or
    silent is named in a loud banner and the run exits 10, never claiming a safe state.
    - walk_with_guard.py and power_log.py report the torque-off gate; tests assert the
    read-back, a lost write, stuck and silent servos (VERIFICATION E8 root cause: the fake
    bus deadlocked on a full pty).
    - crosscheck.py: TEST_PLAN 6, 10.2 and 12 now point to the bench scripts, so those rows
    pass; test_crosscheck has no known mismatches left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
    [crosscheck.py, power_log.py, walk_with_guard.py]
2026-11-02 altaay_lab: cable routes reworked after review, ankle feeds SP4 and SP5 routed (D23)
    - 47 cables (45 active plus SP4 and SP5) in 62 runs; no tube enters a part except
    SP4/SP5 by 0.5 mm into foot_side at the ankle socket (same test fit as the ankle
    plugs); routing clearance is now the cable radius plus 1.0 mm.
    - D7 projector leads run inside the head through a 4 mm hole at (64.5, 84.8, 209.3)
    (to be drilled after printing, D24); D3/D4 no longer climb at the hip; head cables
    follow the floor and walls so they can be tied; longest free run 76.5 mm.
    - SP4 and SP5: worst routed 348 and 377 mm, cut 390 and 420 mm, a service loop at
    each of the 4 leg joints, 20 ties (4 of their own).
    - 47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
2026-11-02 altaay_lab: D22 light print profile applied, plates re-sliced; D24 head hole in the post-processing list
    - print/config: the light profile is the default (2 walls unless a rule needs more,
    solid rings around insert bores and pilots); the old base kept as *_heavy.ini and
    slice.py --set heavy reproduces the old package exactly; parts.csv names each part's
    profile, rings and reason.
    - Coupon session S1 now carries light copies C2aL, C2bL, C3L next to the current ones:
    36.2 g, 3.60 h; S2 17.6 g, 2.19 h.
    - Full print on a 220 bed: 18 jobs, 1347.8 g PLA, 17.6 g TPU, 118.6 h (was 15 jobs,
    1474.5 g, 18.1 g, 126.4 h); if the ring gate fails, 3 plates reprint heavy (+61.5 g).
    - sim/MASS_BUDG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
    [parts.csv]
2026-11-02 altaay_lab: final netlist pass, every cut length from the 3D routes, ankle feeds SP4 and SP5 (D23), sheets and harness regenerated
    - netlist.yaml: 58 parts, 47 active cables, 124 wires; cut_mm from cables3d (D3 and
    D4 jumpers 110, D10, D11, P3, P6, P8, P7 holder leads extended at splices JFI and
    JFO, P11, SD1; D9 250 mm SG90 lead only); SP4 and SP5 to BUS 1 of SV24 and SV14;
    refs LED1 to LED3 and SW2 so refs never clash with cable ids; printable SW1 and U1
    labels; servo socket pins numbered from the Feetech sheet (1 GND, 2 Vcc, 3 signal),
    verify with a meter.
    - ERC: 0 errors, 0 warnings, 8 info. Sheets: all 124 wires drawn, strict mode.
    - HARNESS_BUILD.md, continuity checklist, CAB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
    [continuity_checklist.csv]
2026-11-02 altaay_lab: every-part BOM counts only screws that get fitted; 195 rows, 814 pieces, nothing left without a purchase line
    - make_viewer_data.py: the 2 D18 screws (left out) and the 11 idle screws that stay in the
    servo bag are still drawn, labelled, but not counted as parts to fit.
    - BOM_FULL.md, bom_full.csv regenerated: needs action 0.
    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
    [bom_full.csv]
2026-11-02 altaay_lab: final docs pass, snapshot while the docs agent finishes (D23, D24, test plan, state, verify)
    Work in progress on this branch; the closing commit finishes it before the merge.
    - DECISIONS.md D23, D24; TEST_PLAN, HARDWARE_AUDIT, MOUNTING, START_HERE, STATE updates.
    - POWER_PATH_SIM star and D23 rows; mass_budget.py JFI and JFO positions.
    - verify checks updated for the new netlist (C2, C3, C8, C9, E1, E6b, report).
    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
2026-11-02 altaay_lab: final docs pass, third snapshot (washers 17j to 17l in the fastener summary, cables3d cut lengths, BOM_FULL rebuild)
    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
    [bom_full.csv, fasteners.csv]
2026-11-02 altaay_lab: final docs pass done, verification 21 PASS 1 FAIL (C3), history entry
    - VERIFICATION.md: second full run 1:05 to 1:16 AM ET, 22 checks. E1 caught 10 of 10
    injected faults, C8 0 falls in 36 flat-ground runs at 2.65 kg, C9 0 disagreements.
    C3 fails on the 20 mm ground tails of SP2 and SP3 (21 mm routed); fixed in the next job.
    - STATE.md: final counts (342 screws to fit, 221 to buy, 58 inserts, 16 washers).
    - history/2026-11-02_0117_final_docs_pass.md.
    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
    [report.py]
2026-11-02 altaay_lab: coupon T1 tests the 5.6 mm eye screw stack, two 0.3 mm washers per eye screw in 3D, every heat shrink sleeve counted and drawn, C4 reads kit counts
    - print/make_coupons.py: T1 adds T1b (a whole bulb, 2.0 mm) and T1w (the head wall
    behind the left eye, 3.0 mm, printed on edge like the head); stack read from
    fasteners.json: 0.6 + 2.00 + 3.00 = 5.60 mm, 2.40 mm engaged, 0.60 mm to the pilot
    floor. S1 is now 11 coupons, 41.21 g PLA, 4.14 h; full print with coupons 1389.0 g PLA.
    - viewer: 16 washer discs of 0.3 mm (BOM 17l); eye screws drawn 0.6 mm out; splices
    on a cables3d seat follow it; step 10f places every sleeve scene_extras lacks.
    - bom_full.py: stated sleeve rule (34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
    [bom_full.csv]
2026-11-02 altaay_lab: pre-print fixes, snapshot while the cables, power sim and software agents finish
    Work in progress on this branch; their closing commits finish it before the merge.
    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
    [c3_cables3d.py, c7_current_ratings.py, e6_power_path.py, e6b_hop_sweep.py, plot_power_path.py]
2026-11-02 altaay_lab: power path checked as wired (D15 plus the D23 feeds, netlist lengths), E5 E6 E6b C7 pass
    - sim/power_path_sim.py topology as_built (default) reads every length and gauge
    from wiring/netlist.yaml and runs sim/power_fix.py option ab (the 3b network with
    the netlist values and the data-lead grounds). Old topologies still run.
    - Nominal pack, our 2.65 kg build, typical corner: ankles under 6.0 V 6.2 % of the
    walk (gate 10 %), high-side 21.4 % (E6 WARN); the knees and the head roll are now
    the lowest servos (right knee 9.6 %); no servo under 4.5 V. Sim pass only.
    - C7: Pololu 2815 at 99 % of its 6 A point (5.92 A RMS, WARN tied to TEST_PLAN 4.2);
    no kit cable hop over the 26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
2026-11-02 altaay_lab: pre-print fixes, second snapshot while the cables and software agents finish
    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
    [continuity_checklist.csv]
2026-11-02 altaay_lab: C3 passes, splice tails buildable, 47 of 50 joint loops at 3 x OD, every tie point checked for a mount, Molex terminal data
    - C3 judges lengths by chain through the floating splices JG20, JG10, JG30, YD3 and
    YG3 (as check_cables.py); SPV, SPG, JBP and JBN stay fixed ends.
    - Cuts: SP1 to SP3 ground tails 30 mm, SD1 stem G 45 mm (YG3 15 mm past YD3), SD1
    branch b 170 mm, P7 JFI extension 30 mm, D10 220 mm. Minimum buildable tail about
    15 mm (Molex 5263 crimp 3.5 mm, NASA-STD-8739.4A 19.2.6 and 19.4.1 c); no splice in
    a bend (7.2.36).
    - Joint loops: ties pushed out per crossing until the loop meets 3 x OD (NASA-STD-
    8739.4A 7.2.19, Table 7-1): 47 of 50 (was 0); the 3 at he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
    [make_harness_build.py]
2026-11-02 altaay_lab: pre-print fixes, third snapshot while the software and cable retention jobs finish
    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
    [power_log.py]
2026-11-02 altaay_lab: D25 cable retention, one anchor per spot, small stick-on mount line 34b, drilled tie-hole pairs, twisted made cables
    - cables3d: one anchor per spot (15 points share a nearby anchor), 75 tie points:
    32 MB3A (BOM 34), 23 Panduit ABM1M-AT-C 12.7 x 12.7 mm (new BOM 34b), 6 stock
    holes or slots, 3 drilled 4.0 mm tie-hole pairs after printing, 2 ties to an
    anchored neighbour, 9 open with a named plan.
    - All 43 joint loops meet 3 x OD over the full URDF range (C3 recomputes them from
    robot.urdf); the head pitch and yaw bundle runs as one loop; head yaw manual moves
    within 45 deg (TEST_PLAN 8.2b text pending).
    - Twist with lay per NASA-STD-8739.4A 7.2.16 to 7.2.18 on SP3, SP4,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
    [continuity_checklist.csv]
2026-11-02 altaay_lab: pre-print fixes, fourth snapshot while the software job and the last cable job finish
    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
    [power_log.py, timing_budget.py]
2026-11-02 altaay_lab: walking voltage log on its own timer, time under 6 V counted in time for every servo, bench suite stable under load
    - bench/power_log.py --walk: one read at a random time in each 27 ms slot, only in
    the walk loop's idle time, so no read delays a control write (goal write ends
    4.2 to 4.3 ms into the cycle, as with no log; old per-cycle log 7.0 to 7.3 ms).
    A fixed 27 ms timer reads the same 20 points of every 0.54 s step; the random read
    was off by at most 2.2 points on the sim traces.
    - Count per 1 ms bin of time since the goal write, weighted by time; 9.recovery
    checks the fill assumption, else the gate reads INCOMPLETE, not pass.
    - Gate 9.time6: no servo under 6.0 V fo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
2026-11-02 altaay_lab: D25 last pass, the 9 unanchored ties become bundle ties checked at the test fit; route moves tried and not kept
    - T026 and T089 route moves to MB3A patches were tried in scratch: D2 and D3 would
    come out 18 to 25 mm short with slack, SP5 past its 430 mm cut, so neither is kept.
    - 9 bundle ties (T016, T017, T023, T024, T085 neck; T034, T045 knee loop ends; T026,
    T089): a tie round the bundle, checked at both joint limits at TEST_PLAN 1.4; a
    drilled pair or printed anchor only if the bundle reaches a moving part.
    - BOM 34b: ABM1M-AT-C specs cited (0.1 in max tie width, 0.16 in height); other US
    distributors listed. Build total $1018.29. C3, E1, E2, E3 pass.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
    [c3_cables3d.py, make_harness_build.py]
2026-11-02 altaay_lab: integration pass for PR 6, every agent text applied, BOM_FULL and 3D data rebuilt, full verification 20 PASS 2 FAIL
    - DECISIONS: D25 cable retention as carried out; D21 note (T1 stack); D23 notes
    (power path as built; lead L1: every servo timed at 10 % in TEST_PLAN 9).
    - TEST_PLAN: 1.3 sleeves and twist, 1.4 loops and ties, 4.2, 5, 8.2b head yaw limit,
    section 9 rewritten for the time-based log. HARDWARE_AUDIT B14, B35.
    - BOM: lines 26, 27, 30, TO11, T14; BelMetric 17j, 17k, 17l join the test order as
    TO17 ($5.04, the store's $5 minimum), test order $231.50; build total $1,018.29.
    - blueprint/make_scene_extras.py makes the 16 washers and drops the D9 sleeves; adds
    the SP4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
    [bom_full.csv]
2026-11-02 altaay_lab: last fixes for PR 6, full verification 22 of 22 PASS; hop gate in three bands; sims refreshed; fixed-length cables read "test fit"
    - C8: mass budget 2652.8 g (cut changes and twist take-up, +0.9 g); variant (c) walk
    re-run on the current model, MASS_STUDY.md table updated with a dated line (largest
    move 0.013 on pushes, inside the seeded spread 0.614 to 0.629). 0 falls in 35 runs.
    - Power path 'As built' refreshed: ankles 6.4 %, right knee 9.8 %, head roll 6.8 %
    (typical, our build, nominal pack); Pololu 2815 5.93 A RMS, 99 %. Sim pass only.
    - TEST_PLAN 5 hop gate (lead L3, D23 dated note): pass up to 28 mOhm per conductor
    (E6b: right knee 9.9 %), warn 28 to 40 mOhm (walk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
    [bom_full.csv]
2026-11-03 Twin wave 1: electromechanical closed loop and thermal twin (sim pass only)
    Electromech: walk, 14 STS3215 servos (gain and torque limit from each
    servo's supply volts) and the as-built power path solved every 2 ms with
    a 2S P30B pack and the D16 guard. Sag slows the walk, no falls in 85 runs.
    Thermal: two-node servo model fitted to the published Robo9 curves,
    trunk and head air nodes, electronics hot spots and PLA contact
    temperatures. Knees reach the 70 C cut in continuous walking (sim).
    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
    [session_backlash_high-side.csv, session_backlash_typical.csv, session_plain_typical.csv]
2026-11-03 Twin wave 1: integrate power, heat and gym results into the lab docs
    TEST_PLAN 4.1, 4.2, 5, 7.3 (new thermal hold), 7.5 (bus volts response),
    9 and 11 carry the twin predictions; the gates stay as they were except
    the new 7.3 pass line. STATE, START_HERE, HARDWARE_AUDIT B36 to B41, new
    dated notes on D2, SERVO_UPGRADE_OPTIONS, POWER and ADDED_MASS_SIM. Every
    no-fall result now says it holds in the duck's training physics only: in
    the shared lab gym our build falls in the 15 N push series. The C8 note
    is kept in verify/report.py run notes. Verify: 22/22 PASS, 21 WARN, same
    as before. Sim pass only.
    Claude-Session: https://claude.ai/code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
2026-11-03 Twin wave 1: structure twin, loads, FEA, fasteners and fatigue (sim and FEA pass only)
    Loads from MuJoCo on our 2.65 kg build (walk, push recovery, falls as a
    stiffness range), FEA of the printed parts with the D22 walls, skins and
    gyroid infill, fastener and insert checks, fatigue on published curves,
    and a 50 C hot case. roll_to_pitch and the knee sheet eye are under the
    margin of 2 walking. Proposals P1 to P8, nothing decided.
    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
2026-11-03 Twin wave 1: structure integration history, phase and open questions
    STATE and START_HERE now say the twin comes first: Ahmed, 2026-11-03,
    nothing is printed until the full digital twin is done. The open questions
    list the GPU time ask, the coupon print on hold, and D26 with B45 for
    before the right leg prints. Verify re-run line for 5:01 to 5:14 PM ET:
    22 PASS, 0 FAIL, 21 WARN. C9 re-run on the final docs: PASS, same 4 WARN.
    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
2026-11-04 Twin wave 2: get-up, walking speed, human pace, live twin and GPU prep in the lab docs
    STATE, START_HERE, TEST_PLAN 9 and 7.3, and new dated notes on GAPS B6
    (get-up works in sim, scripted) and B7 (hip heights from the MJCF). The
    live twin in the shared lab gym: continuous walking reaches the 70 C knee
    cut and falls; the guard prevents every fall at a cost in walking minutes.
    Walking tops out near 0.36 m/s on these servos; human pace needs wheels
    (heel-wheel hybrid in sim) or a much bigger duck. Ahmed approved RunPod,
    capped at 20 USD; stage 0 is ready, waiting for the key. Verify: 22 PASS,
    0 FAIL, 21 WARN, unchanged; C9 re-run on the final docs: PASS. Sim pass only.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
2026-11-04 V1 plan: six twin tracks run one at a time, electrical first as the pilot
    Ahmed asked for a V1 twin of the whole build (electronics, cables, joint
    motion, power, heat, vibration, every part accounted for), lean on tokens,
    one job at a time, with a plan in case the work does not finish today.
    V1_PLAN.md lists the tracks, the question each must answer, and the rule
    that each finished track is merged the same day.
    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
2026-11-04 V1 electrical twin: BMS against falls and get-ups, regeneration, servo bus ground (sim pass only)
    twin/electrical: bus_events.py replays 38 falls, 3 get-ups and the walk from the shared lab gym
    (overlay gym/overlays/duck) through the as-built power network with the P30B pack. A 60 N left shove
    of the standing duck draws 19.5 to 20.6 A, over 17 A for 4 to 13 ms, inside the Tenergy 32175 band:
    TEST_PLAN 3.3 gets a 21 A pass line (0 of 41 events trip a 20 A board). The drain after the guard's
    poweroff (0.11 to 0.41 A, calc only) gets a TEST_PLAN 11 rule. No net regeneration in walking or
    falls; data ground offset under the adapter's 0.8 V VIL within the TEST_PLAN 5 hop gate. New
    BLOCKERs B47 to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
2026-11-04 V1 plan: track 1 (electrical) done, track 2 (assembly) waits for Ahmed
    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
2026-11-04 V1 plan: fix-not-detect rule, track 1b, tracks back to back; D27 V1 scope
    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
2026-11-04 V1 track 1b: electrical fixes in the twin (sim pass only, calc only)
    B47 fixed in the twin: a target guard for the walk loop (twin/electrical/fix/bus_budget.py:
    the training's own target clip, commented out in the runtime, plus a 10 A servo bus
    budget; optional fall hold; no register change). With the runtime's real gains (P 30 legs,
    P 8 head) and the policy left on the floor, the pack held 18.60 A for 4 ms before; after,
    15.89 A at worst and 0 trips of a 17 A board in 252 replays, with the same falls and walk.
    B49: no $0 self-off with the Pololu 2815; the Pololu 2813 option for Ahmed's OK. B48
    bounded at the worst cited class values with a ready soft start. Head roll data ground
    0.075 V at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
2026-11-04 V1 plan: track 1b done, track 2 starts; D28 electrical fixes, D29 eye lamps
    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
2026-11-04 V1 track 2: assembly twin (CAD check and calc only), D30 switch swap applied, D29 reverted (D33)
    Every part held (side lamp VHB fix, BEC tie fix), all 286 driven screws reachable in
    twin/assembly/BUILD_ORDER.md (0 violations; Wera drivers need Ahmed's OK), battery and
    microSD service steps, mass recount (2654.7 to 2686.2 g), Pololu 2813 with the NKK button
    in a printed plate and GPIO26 on OFF. Viewer: every LED named. HARDWARE_AUDIT B53 to B59.
    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
    [button_plate_d30.stl]
2026-11-04 V1 plan: track 2 done, tracks 2b to 2d; D30 to D35
    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
2026-11-05 V1 screws twin, phase 1 in progress: classification, joint minimums, shell lips (CAD check only, calc only)
    Work saved after the container restart: geom_joints.py (world-frame joint geometry),
    screws_twin.py (fastener classes a/b/c, safe minimum per joint, kept screws, fastening time),
    mesh_designs.py (tongue and groove for body_front, lips and ribs for body_back on
    body_middle_bottom, coupons K1 to K3), data/ and stl/ outputs. Cable work (item 7) follows.
    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
    [K1a_body_middle_top.stl, K1b_body_front.stl, K2a_body_middle_bottom.stl, K2b_body_back.stl, K3_cable_clip.stl, assembly_steps.csv, body_front_groove.stl, body_middle_bottom_lip.stl]
2026-11-05 V1 screws twin phase 1: cable work, twin doc, phase 2 lists (calc only, CAD check only)
    cables_twin.py: 153 solder ends, 17 crimps, 84 plugs, 34 sleeves, 75 ties (55 on
    stick-on mounts) counted from HARNESS_BUILD.md and cables3d.json and timed with cited
    per operation times; changes X1 to X7 (Pi header plugs, printed tie bridges, service
    splits, lever splices, bench pieces, labels, build order); coupon K4 tie bridge.
    SCREWS_TWIN.md: counts a 75 / b 259 / c 8 fitted, safe cut 342 to 313 screws, 58 to 44
    inserts, 16 to 8 washers; why the 90 % target is out of reach; shell tongue, lips and
    ribs with fit, thickness, overhang and strength checks; build and cable hours; magnets
    not proposed; antic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
    [K4_tie_bridge.stl, cable_ops.csv, cable_steps.csv]
2026-11-05 V1 everything in 3D, phase 1: inventory and designs (CAD check only)
    New folder altaay_lab/twin/complete3d only; no shared file changed.
    - inventory.py: every part, cable and named screw against the base and
    published viewer runs (TABLES.md, inventory.json); all 47 cables are
    drawn in all 62 runs, 18 are at least 90 % enclosed at explode 0.
    - camera_seat.py: Camera Module 3 seat measured on head.stl; the viewer
    box is 3.75 mm off and drawn through the front wall; F344 to F347 kept.
    - ribbon_d12.py: D12 as a flat strip with no twist; shortest clear route
    227.4 mm, so 150 mm and 200 mm both fail in that model (TO9 decides).
    - Phase 2 data: fasteners_patch, cables_patch, part_seats, lab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
    [camera_seat.py, common.py, inventory.py, ribbon_d12.py, viewer_patch.py]
2026-11-05 V1 everything in 3D, phase 2: camera seated, D12 300 mm strip, OFF wire D13, x-ray and labels (CAD check only)
    D34 and D33 applied; no part bought.
    - Camera drawn as its PCB on the measured head.stl pilots (board centre 3.75 mm
    toward the lens row); F344 to F347 are M2x5 "camera to head" with the pilots
    drilled to 4.5 mm (PRINT_PLAN After printing step; 1/16 in bit needs Ahmed's OK).
    - D12 is the 300 mm flat strip: route 227.3 mm with no twist, 72.7 mm spare in one
    loop of radius 6 mm (1.74 mm clear); CAM.CSI moved 5.0 mm; drawn as a band.
    - New cable D13, the OFF wire (Pi GPIO26 to the 2813 OFF input, D30) on the P13
    route: worst 542.5 mm, cut 590 mm, pass. P15 stays the button lead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
    [bom_full.csv, fasteners.csv]
2026-11-05 V1 3D track: clearance check of the changed cables (check_cables.py at 7000 MB)
    cables3d/check_cables.py ran on all 48 cables under the RAM wrapper (peak 4.9 GB).
    - Pass: D10 (its committed 0.9 mm rub fixed by twin/complete3d/fix_rubs.py, now
    +1.0 mm), P15, SP1, SP2.
    - Fail on rub, recorded in HARDWARE_AUDIT B61, B62 and COMPLETE3D.md section 10:
    D12 (0.6 mm on neck_yaw_assembly at head roll; no twist-free strip route clears
    the swept neck parts, d12_ribbon_swept.json), D13 (1.2 mm, inherited from the
    committed P13 neck route), SP4 and SP5 (as committed: 0.49 mm into foot_side and
    a 2.1 to 2.2 mm rub at hip pitch). Local pushes do not clear these; they need a
    re-route.
    - Viewer o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
    [bom_full.csv]
2026-11-05 V1 3D track: drop the head_board ghost from the viewer scene (B7)
    The board.stl copy in the head marks the Pi footprint and is not a part (B7):
    make_viewer_data.py no longer draws, meshes or labels it (no node, no GLB
    geometry, no checklist row, no mount, blocker, match or decimation entry; one
    comment line says why). Viewer outputs regenerated in /home/user/v1_out/3d/viewer:
    manifest.json has no head_board, duck.glb 78 geometries. HARDWARE_AUDIT B64
    wording follows. c9_docs: 0 FAIL.
    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
    [make_viewer_data.py]
2026-11-05 V1 screws phase 2: D36 and D38 applied (calc only, CAD check only)
    Screw cut: 342 to 317 fitted screws, 58 to 48 inserts, 16 to 8 washers; the back shell
    keeps 7 (D38). fasteners.json marks the 25 cut screws and their 10 inserts LEAVE OUT
    (D38 screw cut) through report_fasteners.py; report and render scripts take any LEAVE
    OUT status as not fitted; FASTENERS.md and fasteners.csv regenerated.
    print/: body_front (3.5 mm groove), body_middle_top (3.0 mm tongue), body_middle_bottom
    (back side lips and 6 ribs, now clipped to the part height): fit 0.25 to 0.41 mm.
    BOM: need counts; 22b and 22c KK 254 (X1, housing price BLOCKER), 26b WAGO 221 (X4),
    12 Need 2 (XT30U in P13, X3a), T16 to T18 Wera too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
    [K2a_body_middle_bottom.stl, assembly_steps.csv, body_front.stl, body_middle_bottom.stl, body_middle_bottom_lip.stl, body_middle_top.stl, classification.csv, fasteners.csv]
2026-11-05 V1 screws: re-slice of the D38 parts and coupons; viewer draws only fitted screws; 2 XT30 pairs
    Re-slice with print/slice.py (D22 light profile): body_front 58.05 g 4.06 h,
    body_middle_top 75.24 g 6.75 h, body_middle_bottom 107.45 g 9.38 h; coupon session S1 with
    K1a to K4 added 46.8 g 4.69 h. Robot set PLA 1245.1 to 1250.5 g, 106.7 to 107.6 h; full
    print on a 220 bed 1347.8 to 1353.2 g, 118.6 to 119.5 h; with the coupons 1389.0 to
    1400.0 g, 125.0 to 126.5 h. Plates holding the 3 parts moved by the part deltas (calc).
    PRINT_PLAN.md, SLICE_SUMMARY.md, STATE.md, BOM line 27 and the MASS_BUDGET D38 row
    updated. The unused F075 bore is clear (CAD check) but gets no ring now.
    Viewer: make_viewer_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
2026-11-05 Viewer page and its headless load test in the repo; V1 plan: track 2d done
    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
2026-11-05 V1 knee swap (D32): STS3250 knee model, knee-aware guard, structure re-run (sim pass only, calc only)
    twin/knee/servo_sts3250.py: the STS3250 as the twin's BAM C001 scaled by the two Feetech sheets, a low and a high band,
    Robo9 heat calibration; knee_budget.py: the track 1b guard with the knees' own law; knee_structure.py: the structure
    twin's load cases with STS3250 knees and the scaled FEA factors. Work in progress, docs follow.
    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
2026-11-05 V1 knee swap (D32): KNEE_TWIN.md with the twin results (sim pass only, FEA pass only, calc only)
    Heat fixed across the band (no knee cut, 47 to 63 C), knee saturation gone, 1b guard 0 trips at 17 A; the stock policy
    walks badly with the published torque-speed damping (retrain needed); roll_to_pitch fix D26 P1 checked.
    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
2026-11-05 V1 knee swap phase 2 (D32, D38): BOM 1b, F07b, B70 to B73, TEST_PLAN 15, roll_to_pitch 3 walls, mass 2.70 kg, viewer servo model
    BOM: 12 C001 and 2 STS3250-C002 (design, not bought), build total $1,146.28. HARDWARE_AUDIT 30 of 73. D38 (D26 P1): roll_to_pitch
    wall3+fit, re-sliced, PLA 1407.2 g and 126.9 h with the coupons. Viewer data: model, mass and BOM line per servo node, counted by
    model (14/14 servos, 0 mismatches). c9 PASS (0 FAIL).
    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
    [bom_full.csv, parts.csv]
2026-11-05 V1 plan: track 2c done, track 2e (corner screws, closed holes) started; viewer shows each servo's model
    - V1_PLAN.md: 2c status with the knee twin results (D32, D38); new track 2e from Ahmed's two artifact comments of 2026-11-04 9:03 PM ET; a dated line under the pause.
    - viewer/index.html: servo titles, tooltips and the servo tile read the model field of the data (STS3215 when the data has none), so the knees show as STS3250. Headless test on the knee data: STATE loaded, ERRORS none, 14/14 servos, 0 mismatches.
    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
2026-11-05 V1 plan: track 2e follows Ahmed's 9:16 PM ET comment (the stress test decides the screws, fewer screws), not a corner rule
    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
2026-11-05 V1 decisions D39 to D41: closed holes set by the stress test, Open Duck Mini v2 kept (no Qmini), self-charging dock starts with heat; tracks 8 (dock) and 9 (DeWalt pack study) in the plan
    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
2026-11-05 V1 twin track 2e: close every hole without a screw, back shell on 6 (D39; CAD check only, calc only)
    - 72 unused hole stacks closed in 16 print/ STLs (flush plugs, never proud, watertight), same files in twin/screws/stl
    - back shell: 4 printed seats under the lower ears on body_middle_bottom; F2 down at mid 1.06 to 1.67 at 7 screws, F076 out (1.52 at 6)
    - left eye keeps F179 and F182 (one mirrored bulb STL); charger stays on 1 screw (USB-C slot holds it)
    - screws 317 to 316, inserts 48 to 47, washers 8; print -6.38 g, -1.22 h; robot 2.69 kg
    - fasteners.json ids kept (report_fasteners.py applies D39), sweep rerun on the closed STLs, c4 counts fitted inserts
    - twin/holes/: scripts, data, HOLES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
    [battery_pack_lid.stl, body_back.stl, body_front.stl, body_front_groove.stl, body_middle_bottom.stl, body_middle_bottom_lip.stl, body_middle_top.stl, body_middle_top_lip.stl]
2026-11-05 V1 track 2e follow-up: BOM_FULL fastener rows to the current counts; twin/holes paths repo-relative
    - BOM_FULL.md and bom_full.csv: fastener section from bom_full.py (316 screws, 47 inserts, 8 washers; D38 and D39), the knee job's F07 and F07b rows kept (the generator does not know the STS3250 split yet); other sections unchanged
    - twin/holes: repo root from the script location (ODM_REPO overrides), outputs under ODM_HOLES_OUT; slice_runs.sh takes WT, ODM_HOLES_OUT and RAMCAP from the environment and stops with a clear error if RAMCAP is unset; no machine paths in committed files
    Claude-Session: https://claude.ai/code/session_01Jzg4ArZ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
    [bom_full.csv]
2026-11-05 V1 twin track 2f: uniform screw patterns and flush plug caps (D42; CAD check only, calc only)
    - body_front on its 4 corners (F071 back, F069 out), battery lid on 4 (F027 back), head_bot_sheet on 4 mirrored corners (F084, F090 back, F088 out); parts rebuilt from the pre-D39 STLs, the 4 ear seats kept
    - audit of every screw group (twin/holes/sym_checks.py): 88 parts, 133 part pairs, all uniform; F1 per screw unchanged, rattle spans shorter, back shell F2 down 1.52 at mid
    - plug caps fitted to the part surface: the back shell ear dimples (5.4 mm) are gone; 19 plug ends off at D39, 6 now (flash_light_module 522 to 525 OPEN)
    - the dark hole by the F076 ear is the F123 screwdriver access hole; F12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
    [battery_pack_lid.stl, body_back.stl, body_front.stl, body_front_groove.stl, body_middle_bottom.stl, body_middle_bottom_lip.stl, body_middle_top.stl, body_middle_top_lip.stl]
2026-11-05 V1 track 2f follow-up: F084 and F090 sweep from the pre-D39 geometry, HARDWARE_AUDIT B1 at 197
    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
    [fasteners.csv]
2026-11-05 V1 track 2f follow-up: sweep hits of the 4 refitted screws from the pre-D39 run (their holes are the pre-D39 geometry again)
    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
    [fasteners.csv]
2026-11-05 V1 track 2f follow-up: flush flash_light_module caps, every plug rechecked; DECISIONS D43 to D45
    - flash_light_module boss bottoms (435, 436, 527, 528): the conical caps are gone; caps follow the face at the hole and the fillet rise beside it, inner-ring plane first on small bosses, every ray start height tried, no bulge past the ring
    - flush check, every plug: D39 20 ends off, D42 2 (neck_right_sheet 130, a hole across a step at the servo case, explained); coaxial inner ends no longer checked as outer faces
    - body_back, flash_light_module, head, speaker_stand rebuilt and re-sliced; viewer test 0 mismatches
    - DECISIONS D43 (dock contacts, osrf/autodock port), D44 (2S1P Molicel P45B, DCB200 r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
    [body_back.stl, flash_light_module.stl, head.stl, speaker_stand.stl]
2026-11-05 V1 track 2f follow-up: smooth plug caps (no tent on the flash boss bottoms), seam check on every cap
    - flash_light_module boss bottoms: the per-direction cap rose 2.98 mm over the face (1.06 mm over a smooth fit, 19 deg triangle steps); now face plus a thin plate spline wall with a C1 blend on a fine rim-weighted grid
    - thin plate spline caps for other curved rings; caps 0.005 to 0.02 mm under the surface; no bulge, no overlap
    - seam and triangle step check on 102 visible ends: all within 5 deg except the 4 flash boss bottoms (12.3 to 13.1 deg; the part's own fillet steps 45 deg)
    - every STL rebuilt and re-sliced; viewer test 0 mismatches; flush D39 20 off, D42 2 (neck_right_sheet 130, expla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
    [body_back.stl, body_front.stl, body_front_groove.stl, body_middle_bottom.stl, body_middle_bottom_lip.stl, body_middle_top.stl, body_middle_top_lip.stl, bulb.stl]
2026-11-05 V1 track 9: battery study, DeWalt DCB200 not a fit; 2S1P Molicel P45B pack in a grown bay (D44, D45; sim pass only, calc only, CAD check only)
    - twin/battery/BATTERY_STUDY.md: DeWalt 20V MAX family (DCB200 is 3.0 Ah, 624 to 644 g; no cut in the pack), seats, centre of mass, the 5S power path, twin numbers, heat, the cell comparison (P45B kept, P50B the in-stock drop-in), swap not pursued (D45)
    - twin/battery/CHARGE_INTERFACE.md for the dock job (2S, 8.40 V, 2.0 A, 3 contacts, 5 to 45 C)
    - print/body_back.stl: bay grown to the pack outline with 45 deg chamfers (0 overlap, walls 2.25 to 9.65 mm, every pilot clear); lid, BMS and XT30 seats unchanged; re-sliced 79.21 g, 6.54 h
    - BOM 6 and 7 (P45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
    [body_back.stl, bom_full.csv]
2026-11-05 V1 track 9 fix: viewer mounting card for the P45B pack (CAD check only)
    - make_viewer_data.py: MOUNTING_MATCH now matches the renamed MOUNTING.md row "2S1P Molicel P45B pack" and maps it to holder and cell (the old pattern matched nothing, so the holder card fell back to the 18650 holder text)
    - the holder and cell fallback mount texts describe the pack: strip and sleeve, the 1 mm foam pad on the lid's centre pad, 0.5 mm to the pad, 0.25 mm per side, 0 overlap (twin/battery/BAY.md)
    - checked: viewer data rebuilt, test STATE loaded, ERRORS none, 0 mismatches; the holder and cell cards opened headless show the MOUNTING.md pack text; c9 PASS, c4 as the base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
    [make_viewer_data.py]
2026-11-05 V1 track 8: self-charging dock phase 2, chest contacts, autodock port (sim pass only)
    Port osrf/autodock fd9c2a9 (Apache-2.0) without ROS to altaay_lab/software/dock with the four
    upstream fixes, a duck layer driven by measured pulse tables (duck_autodock.yaml, swappable for
    the retrained walk), 11 unit tests and a replay of gym tag looks. Dock twin in altaay_lab/twin/dock:
    chest strips and a sprung, swivelling chest paddle, seat, spine, three-tag mast, 15 STLs (916 g,
    67.0 h), the no-MCU hardware gate, MCP73213 charger, heat, BOM, bench tests.
    Gym acceptance (20 seeds per floor, bar 19/20 within 3 tries, no fall) is not met: best run hard
    18/20, train 16/20, soft 10/20. The soft floor fall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
    [dock_base_l.stl, dock_base_r.stl, dock_column_l1.stl, dock_column_l2.stl, dock_column_l3.stl, dock_column_r1.stl, dock_column_r2.stl, dock_column_r3.stl]
2026-11-05 V1 track 8 follow-up: D46, plan rows for tracks 8 and 10, duck-side dock BOM and mounting rows
    DECISIONS.md D46 (Ahmed, 2026-11-05 1:29 AM ET: precision, the walk retrain, perception).
    V1_PLAN.md: track 8 phase 2 done, acceptance not met yet (18/16/10 of 20) with the options;
    new track 10 row (walk retrain, recipe merged in the gym, run waits on the RunPod OK).
    The chest contacts need no STL change for V1; BOM.md lines DK1 to DK5 (pad, Pololu 5382,
    fuse holder, 5 A fuses, NTC and wake parts), build total $1,167.81, bom.json rebuilt;
    MOUNTING.md V1 track 8 rows. DOCK_TWIN.md: the 5382 is $3.79, read prices $68.48.
    Checks: C9 PASS, C4a PASS, C4b PASS, E2 and E3 PASS.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
2026-11-05 Dock behaviour: PR 20 review fixes, undock budget and detections, no waived gates (sim pass only)
    1. do_undock() gets its own timeout budget (undock_timeout 90 s from the undock start); before,
    a charge longer than dock_timeout failed the first guard and the duck stayed on the seat.
    AutoDockBase.check_cancel counts against timeout_s, set by start() and do_undock().
    2. do_undock() turns the tag detections on for the retreat (start() turned them off once docked)
    and off again at the end; back_off() reads its distance and drift from looks.
    3. STEER_DOCK's ENTER gate fails the state (retry) once the sidesteps run out with the lateral
    error over enter_max_lateral, instead of waiving i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
2026-11-05 V1 track 8: acceptance re-run acc10 with the review fixes, undock results (sim pass only)
    DOCK_TWIN.md: sections 3 (gates never waived, the undock), 4.4 (acc10 row), 4.5 (precision and the
    undock per floor, acc10), 4.6 (best runs). V1_PLAN.md track 8 line; history entry.
    acc10: hard 18/20, train 16/20, soft 10/20 within 3 tries (as acc8); undock 19/19, 16/16, 0/10.
    C9 PASS.
    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
2026-11-05 V1 track 11: companion hardware, two I2S mics in the head, ears, D47 (calc only, CAD check only)
    Two Adafruit 3421 SPH0645LM4H mics on the head side walls, 120.5 mm apart, sharing the
    MAX98357A I2S clocks, data on GPIO20; seats in head.stl; netlist, BOM E8, fasteners,
    MOUNTING, viewer placeholders; COMPANION.md compares 2, 3 and 4 mics, four mic boards
    and non-mic aids. Hardware only (Ahmed); nothing bought.
    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
    [bom_full.csv, head.stl]
2026-11-05 V1 track 11: 3D routes for the mic cables D14 and D15, sheets regenerated with D13 to D15, ERC outputs refreshed (CAD check only)
    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
    [continuity_checklist.csv]
2026-11-05 V1 track 11: D48 accuracy, self-noise and hybrid study; GPIO16 to amp SD; seat pictures (calc only, CAD check only)
    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
    [bom_full.csv, continuity_checklist.csv]
2026-11-05 V1 track 11: COMPANION.md GPIO16 now wired to the amp SD pin (D48)
    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
2026-11-06 V1 track 11: D49, the duck listens all the time; ego-noise layers, sync and the bench data plan (design and plan, calc only)
    COMPANION.md section 12 (motor-informed ego-noise estimate, RNNoise and a wake word trained
    on the duck's own noise, an off-board enhancer, masked GCC-PHAT, one-clock sync, data plan,
    CPU budget, BLOCKERs); live gating lines now say gating is the fallback; TEST_PLAN 17;
    D49; V1_PLAN line; history. No new parts, no software module.
    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
2026-11-06 V1 track 11: D49 data plan logs the walk policy's gait phase, its origin and every reset (calc only)
    Joint-log rows carry the policy's two observation phase values and imitation_i (Runtime
    376de65 v2_rl_walk_mujoco.py lines 95, 104 to 109, 156 to 170, 213 to 228, 249 to 254,
    257 to 269); the sidecar lists the phase origin, resets, freezes and rate changes;
    TEST_PLAN 17.3 checks them; set size about 9.1 GB.
    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
2026-11-06 V1 track 11: mic seats redrawn on the 3421 board's real port; datasheet and product page read (CAD check only)
    The 3421 board files, fab print, product page and SPH0645LM4H-B datasheet were read with curl.
    The sound port sits 0.71 mm from the mic centre, so the port tube and wall port moved onto it;
    bosses 3.5 mm with 5.6 mm pilots so the M2x6 fits a 0.8 to 1.6 mm PCB (D42 and D39 kept).
    Seat at x -37.5: SG90 clearance 6.05 mm, spacing 121.6 mm. D14 and D15 rerouted, F356 to F359
    and the viewer boxes updated, sheets and BOM_FULL rebuilt. D47 BLOCKERs 1 and 2 and the D49 AOP
    BLOCKER cleared or updated; BOM E8 verified on the page. Nothing bought.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
    [bom_full.csv, head.stl]
2026-11-06 V1 track 8 phase 3: awake while docked, a fourth contact for the dock supply (D50; calc only, sim pass only)
    The dock's gated 9 V comes in on a fourth chest strip (SYS) and is ORed with the fused pack at the
    2813 input through two ideal diodes (BOM DK6 Pololu 5382, DK7 Pololu 5383), so the dock runs the
    docked duck and the pack only charges: the MCP73213 keeps its termination and 6 h timer (4.3 h from
    empty, 2.4 h from 48 %, calc). Cells at or under 45 C while charging with the duck awake at 25 and
    32 C (thermal twin). The 2813 OFF stays a full shutdown, the wake pulse stays for it. BOM DK1, DK6,
    DK7 (+$8.74), MOUNTING rows, twin/dock/duck_side_netlist.yaml and dock_netlist.yaml (merge into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
2026-11-06 V1 track 8 phase 3: dock wiring in the netlist, 3D routes, sheets, seats, BOM_FULL (D50; CAD check only)
    wiring/netlist.yaml gets the duck side of the dock (DKP, DK2, F2, RT1, WK1, DK6, DK7; cables DC1
    to DC4; P7 ends at DK7, SW1 VIN is the OR node). DC1 to DC4 routed in cables3d.json
    (twin/dock/seats/, dock_cables3d.py); sheet 1 draws them, all sheets regenerated; BOM_FULL rows,
    viewer placeholders and C1 map entries for DK1 to DK7. Seats on VHB, no screw or hole added (D42,
    D39), close-ups in twin/dock/dock_seats.png. U3 (D30V30F5, 5 to 45 V) passes at 9.2 V. Checks
    C1, C3, C4, C6, C9, C10 and E4: no new FAIL against origin/altaay-lab; viewer test passes.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
    [bom_full.csv]
2026-11-06 Dock routes: lead-exit terminals, every segment checked, lengths on every DC wire (PR 24 review)
    route2.py opens only the 2 mm lead exit at each terminal (nearest point with 2 mm clearance) and
    rejects any final segment that comes closer to a part than the wire radius; DC1 to DC4 rerouted,
    the DK6 input pad moved to the board's open side. dock_cables3d.py writes the measured length of
    every run and wire (no joint crossed: zero, min and max are the routed length), and the inline
    WK1.K to SW1.ON joint has its own zero-length run. C3 now checks every DC wire. Cuts synced in the
    netlist, sheets and BOM_FULL rebuilt. No new FAIL against altaay-lab; viewer test passes.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
    [bom_full.csv]
2026-11-06 Dock routes: one route per wire, every placed body an obstacle, self-check (PR 24 review 2)
    route2.py now routes each wire between its own two terminals (separate pads per strip and for the
    board GND pads), puts every placed body into the obstacle grid (printed parts, bought-part boxes and
    the seated dock parts; only each pad's lead exit is open), and fails its self-check if a wire has no
    route of its own or a route point lies inside a body (passes). dock_cables3d.py builds one run per
    wire from those routes and refuses any wire that reuses another's run; the GND wires of DK6 and DK7
    have their own routes to SW1 GND. Cuts synced in the netlist; sheets and BOM_FULL rebuilt. No new
    FAIL agains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
    [bom_full.csv]
2026-11-06 D50 audit: P7 re-routed to DK7, four-strip six-pin paddle, docs synced (PR 24 review 3)
    P7's load run is re-routed from the fuse to DK7 VIN (route2.py, 81.9 mm, length and clearance
    recomputed); route_cables.py knows the DK7 VIN terminal and routes P7 there. dock_parts.py makes the
    paddle with four rows and six pins (CHG+ and SENSE at y 0, GND and SYS at y +/- 3 mm, z from the
    seated trunk origin plus each strip centre), 10 mm taller; STLs regenerated, clearance over travel
    and swivel clean, all six pins 8.75 mm inside their strip edges with the duck seated (CAD check);
    paddle and carrier re-sliced (921 g, 67.4 h). DOCK_TWIN sections 1, 2 and 11, DOCK_INTERFACE pin
    table, MOUNTING and BOM te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
    [dock_paddle.stl, dock_paddle_carrier.stl]
2026-11-06 V1 track 11: ear SG90 mount checked again; the viewer showed it loose (CAD check only)
    The CAD mount is real and the same in print/head.stl, twin/companion/stl/head.stl and the
    decimated viewer mesh, in the viewer's own SG90 pose: each tab flat on 7.25 mm of plastic
    (58.5 mm2 per tab), 2 blind 1.5 mm pilots per servo 27.5 mm apart, coaxial with the tab holes
    (0.4 deg, 0.001 mm), body ends in the plate pocket (117.7 mm2, gap 0 to 0.1 mm). Over -90 to
    90 deg the ear clears the shell by 2.02 mm and the mic boards by 10.07 mm. No STL, screw or BOM
    change; mic seats untouched.
    What was wrong is the viewer: the 4 tab screws were hosted on the head shell ("head shell into
    head shell") and the SG90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
    [bom_full.csv, fasteners.csv]
2026-11-06 D50 chest lead hole: 6 mm printed feedthrough, inside splices, artifacts synced (PR 24 review 4)
    - Only the four pad conductors pass the chest wall: GND and SENSE branch at
    splices JGD and JSN inside the trunk, 60 mm from the pad (netlist, routes,
    cables3d, sheet 1, HARNESS_BUILD section 7).
    - print/body_front.stl: one 6.0 mm hole behind the pad centre, a 45 deg bell
    mouth 2 mm deep inside and a 0.8 mm chamfer at the pad (twin/dock/
    chest_hole.py, section image). Re-sliced 57.63 g, no support. A grommet
    ring standing proud inside was tried and dropped: it needed support.
    - Grid and routes rebuilt on the new STL (self-check pass; router graph in
    int32/float32 so it fits the 3 GB c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
    [body_front.stl, bom_full.csv, continuity_checklist.csv]
2026-11-06 V1 freeze pass: drift fixed, touch, speaker duct, ear PWM, cliff ToF, pick-up, arbiter (D51 to D57)
    CAD check only, calc only, sim pass only; nothing bought.
    - Mic seats into print/head.stl, ear mount unchanged (twin/freeze/head_freeze.py)
    - C1 (17), C3 (D13 spans), E4 (frame test, washers) fixed at their causes; C9 reads the
    short test order form; test order total $228.49 confirmed (TO9 change in D34)
    - Speaker stand pilots measured coaxial (the 20.7 deg was a feat3d fit artefact)
    - D51 touch: 2 x MPR121 (0x5A, 0x5B), pads PH1, PH2, PB1; D52 speaker duct, 36 outer
    grille holes closed; D53 ears on hardware PWM; D54 VL53L4CD cliff ToF seat in body_front
    (0x29, GPIO17 interrupt); D55 pic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
    [body_front.stl, bom_full.csv, continuity_checklist.csv, fasteners.csv, head.stl, parts.csv, speaker_interface.stl]
2026-11-06 Freeze checkers: leave out the part being placed and its own lead exits (Codex round 1)
    cliff_seat.py skipped neither its own tof_cliff box nor nothing else once --write had added it; touch_pads.py counted
    each pad's and board's own leads as obstacles. Both now leave out the item itself; an own lead is checked past its
    termination (from each end until it first stands the rule off the item), boards keep 0.5 mm to their own dressed
    leads. Rerun from the committed data reproduces the committed seats and PASS. CAD check only.
    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
    [cliff_seat.py, touch_pads.py]
2026-11-06 touch_pads: one board_frame() orients the MPR121 footprint (Codex round 2)
    For rot 1 the footprint was swapped twice. board_frame() now gives the long and short axes once; the support rays,
    the clearance grid, the exported box and routes_freeze.board_rows() use it, and a self-check compares the exported
    box with the support footprint. Rerun: both seats, the placements and the lead ends are unchanged, PASS. CAD check only.
    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
    [routes_freeze.py, touch_pads.py]
2026-11-06 V1 full dock: every part, screw and wire of the charging dock, the paddle force and hole fixes, BOM, viewer scenes
    - Paddle: Mill-Max 0933 press-fit pins and two Century CF37CS constant-force springs (3.29 N at any travel); no PTFE.
    - Holes and grips: spine flange, column and spine inserts, staggered column splits, 76 mm rods, ballast pocket; 41 screws OK.
    - Seat: CC-28CS springs, loaded seat at 112 mm, slotted D2F-01L with a flexing finger.
    - Every component in 3D, 18 wires routed with the self-check, wiring sheet 7, gate ERC, bay with board mounts.
    - Charge current 1.0 A (EV board): 4.7 h from empty, 2.6 h from go-home (calc).
    - BOM rebuilt (DOCK_TWIN section 7, DOCK_BOM_FULL.md, BOM.md DK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
    [dock_base_l.stl, dock_base_r.stl, dock_bay_lid.stl, dock_bay_tray.stl, dock_column_l1.stl, dock_column_l2.stl, dock_column_l3.stl, dock_column_r1.stl]
2026-11-06 Viewer scenes follow the hash in the repo page; dock fasteners ride their link in every state, with a seating check
    - viewer/index.html (the source) now carries the Duck, Dock and Docked switch; the loaded manifest must name the scene
    asked, and test_viewer.js checks it.
    - dock_assembly.link_transform gives each dock link's pose per state; dock_scene.py places every fastener by it (the
    carrier screws move with the 12.43 mm push); fastener_seating() and C12 check every screw head sits on its host part
    in the dock and docked states.
    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
2026-11-06 Dock harnesses routed as bundles with conductor slots; wire-to-wire clearance check
    - dock_routes.py: KP1 (4 conductors, 5.15 mm envelope) and KC5 (2.9 mm) route as one bundle each; conductors sit in fixed
    slots (parallel-transport frame), at least one OD apart, and fan out at the ends; every other wire is routed after them,
    clear of placed wires and of pads it does not end on. New pairwise check: no two centre lines closer than the sum of the
    radii outside shared terminal zones; C12 fails on any overlap. Self-check PASS; lengths and cuts recomputed.
    - Face cable hole 9 mm and a taller tray notch for the bundle; sheet 7, DOCK_BOM_FULL, DOCK_TWIN 12.4, renders updated.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
    [dock_bay_tray.stl, dock_column_l2.stl]
2026-11-06 Dock tipping: the check picks its pivot from the feet hull per load; rear feet moved back to reach 3x
    - dock_design.tipping(): CG measured on the model (sliced grams at part centroids, ballast, bought parts); the support hull
    of the 12 feet; for each load the pivot is the hull's farthest point along it. Cases: walk-in push, a seated duck off
    centre (sim worst lateral, and the seat corner), a child's 5 N at the mast top in 4 directions. Target 3x.
    - The walk-in push tips about the rear feet: 2.5x at x 188. Base halves now run to x 220, rear feet at x 214: 3.42x.
    Seat feet moved to the seat corners. A child's push at the mast top tips it at 5 to 10 N: Ahmed's call (strap or lower
    mast)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
    [dock_base_l.stl, dock_base_r.stl, dock_seat_base.stl]
2026-11-06 Dock viewer ids through one function; manifest reference check
    - dock_scene.nid() builds every dock node id and every reference to one: fastener joins and hosts (screws: part and into;
    inserts: part and screw; nuts: screw), cable nodes; BOM, printed and Every part node lists come from the same keys.
    - check_refs(): every reference to a dock node in a scene manifest must resolve to a node of that scene; the build stops on
    a dangling one and C12 fails on it for the dock and docked manifests.
    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
    [c12_dock.py, dock_scene.py]
2026-11-06 Dock checks fail closed: a check that cannot run is UNCHECKED and fails C12
    - dock_assembly: a failed boolean in interferences() and motion_check() records the pair as UNCHECKED (was 0 volume, clear);
    fastener_seating() records a host missing from the model as UNCHECKED (was skipped).
    - dock_fasteners: no wall met round the bore gives engagement UNCHECKED (was 0 mm of approach, which overstated it).
    - dock_routes: the grid and the inside test refuse an open (non-watertight) obstacle (contains() read it as empty), the
    surface band has no size limit or exception fallback, and screw obstacles are one watertight solid (a concatenation was
    open, so screws were not obstacles). Routes rebuilt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
    [c12_dock.py]
2026-11-06 Dock: paddle cable routed through a service loop and checked in every moving state
    Each wire point is attached to a link (paddle, carrier, free span, fixed), the pin-to-bundle legs blend from the
    paddle to the carrier by length, and the full route check (bodies, wire to wire, bend radius, stretch) runs in
    seven states (rest, docked, full travel, the 10 deg yaw limits). The bundle rides the carrier behind the paddle's
    yaw sweep, hangs in a fixed-length loop and runs in a base groove; no face hole. The viewer and C12 use each
    state's own points and labels; C12 fails if any state fails. CAD check only.
    Claude-Session: https://claude.ai/co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
    [dock_base_l.stl, dock_bay_tray.stl, dock_column_l2.stl]
2026-11-06 Dock: one per-state geometry path; route results stamped with an input fingerprint
    dock_assembly.components(state) takes any paddle pose (pose_of) and is the only geometry: each constant-force
    spring is a fixed coil plus a strip rebuilt for the push; motion_check, the route obstacles (with fasteners placed
    by link_transform via fastener_meshes), the renders and the viewer all build from it. The router's T_state is the
    assembly's link_transform. dock_cables3d.json carries a sha256 of its inputs (part STLs, fastener schedule, netlist
    wires and gauges, terminals, docked pose, design sources); C12 recomputes it on the rebuilt parts, reads diameters
    from the live netlist, and checks the viewer ma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
    [dock_fasteners.csv]
2026-11-07 WIP V1 sit (D59): CAD builder, URDF editor, sweep, sim model and servo limit scripts
    Work in progress, not reviewed: twin/sit scripts and the bench angle limit writer.
    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
2026-11-07 WIP V1 sit (D59): STLs, URDF and MJCF from sit_cad.py and sit_urdf.py
    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
    [ankle_pad.stl, foot_side.stl, foot_top.stl, head_pitch_to_yaw.stl, hip_pad.stl, knee_bumper.stl, knee_to_ankle_left_sheet.stl, knee_to_ankle_right_sheet.stl]
2026-11-07 WIP V1 sit (D59): rebuilt caches, foot, thigh trims, lugs; parts.csv rows; cable and stress scripts
    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
    [foot_side.stl, foot_top.stl, head_pitch_to_yaw.stl, knee_to_ankle_left_sheet.stl, knee_to_ankle_right_sheet.stl, left_cache.stl, left_knee_to_ankle_left_sheet.stl, left_knee_to_ankle_right_sheet.stl]
2026-11-07 WIP V1 sit (D59): sit parts on new fixed URDF links, records script, sweep results
    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
    [robot.urdf]
2026-11-07 WIP V1 sit (D59): keep every hole (lug keep-outs, foot notch without the ankle case, heel screw moved), records follow the URDF
    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
    [foot_side.stl, foot_top.stl, head_pitch_to_yaw.stl, left_cache.stl, neck_left_sheet.stl, neck_right_sheet.stl, right_cache.stl]
2026-11-07 WIP V1 sit (D59): prism clamp block and web, case relief band in the feet, calibration, test plan, decisions D58 D59, print records script
    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
    [foot_side.stl, foot_top.stl, knee_to_ankle_left_sheet.stl, knee_to_ankle_right_sheet.stl, left_cache.stl, left_knee_to_ankle_left_sheet.stl, left_knee_to_ankle_right_sheet.stl, parts.csv]
2026-11-07 WIP V1 sit (D59): sweeps, fastener sweep and report, slicing, print records, cables, servo limits
    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
    [fasteners.csv, servo_limits.json]
2026-11-07 WIP V1 sit (D59): cables (loops grown, mounts re-placed), check_cables fixes, sim model collisions, BOM, mounting, mass budget
    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
2026-11-07 WIP V1 sit (D59): sims, stress, viewer and BOM_FULL, sim summary
    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
    [bom_full.csv]
2026-11-07 WIP V1 sit (D59): SIT.md, STATE, history, print plan
    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
2026-11-07 WIP V1 sit (D59): angle limits at bring-up, fail closed in stress and walk
    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
    [first_servo_check.py, set_angle_limits.py]
2026-11-07 V1 sit (D59): verification 21 PASS 2 FAIL as before; doc counts, bom.json, mass statement; no local paths in outputs
    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
2026-11-07 V1 sit (D59): Codex fixes: gain kept through entry and stand-up, stop torque peaks on every step, angle limits after the speed tests; zero error moves the clamp; seat floor-only; stress fails closed,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
    [first_servo_check.py]
2026-11-07 V1 sit (D59): sims keep one result file per case and resume after a restart
    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
2026-11-07 V1 sit (D59): Codex fixes: stop torque maxima from the moment the torque goes off; sim case cache keyed on the model files, every mesh, the sim code and the run parameters; CAD build cache keyed on i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
2026-11-07 WIP V1 sit (D59): compliant stops from the stack stiffness in the sim model, limit torques per stop end, head shove and stop load sims at 0.5 ms, held-out seeds, balance gate script; stress loads fro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
2026-11-07 WIP V1 sit (D59): balance footprint from the touching meshes, sim push in every case; render caption legible
    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
2026-11-07 V1 sit (D59): the stand-up brings hip roll and yaw back to 0 while seated (the splay slid the feet off the pads); get-up retest report (twin/sit/getup) and dated notes in STATE and GAPS: get-up on th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
2026-11-07 V1 sit (D59): stand-up 20/20/20 on the tuning seeds and 20/20/19 on held-out seeds; balance gate PASS; sit pose from the sim (+2.75 deg); compliant stop loads (not converged, BLOCKER) and head and ne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
2026-11-07 WIP: sit_sim Stops class records impact omega per joint end (energy method input)
    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
2026-11-07 V1 sit (D59): Codex fix at the root: a mass case (balance +-5 %, held body) is a model variant compiled with mj_setConst before the collision edits (mj_setConst after them refuses the model); the cac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
2026-11-07 V1 sit (D59): the stop record carries the effective inertia with the base held (I_eff_held, the held-body shove case); sit_stress uses it for the head shoves
    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
2026-11-07 V1 sit (D59): energy method validated on single runs, balance gate rerun on the model variants (PASS, 75.6 mm), the head and neck stop design brief in SIT.md, history entry
    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
2026-11-07 WIP V1 sit (D59): Codex fix: the stop load is the larger of the impact energy peak and the sustained reaction (100 ms mean of the limit torque, the loaded phase flagged); sit_cad builds the neck stop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
2026-11-07 WIP V1 sit (D59): scripts for the neck stop block and head hook (links, sweep specs, records, print, cables, urdf colours, stress rows); sit_cad edge fit from mesh sections (not yet built)
    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
2026-11-07 V1 sit (D59): the neck stop block (trunk_top, F127 and F129) with its TPU faces and the head hook on the yoke's left arm with its TPU face built into the CAD; the neck sheets stock again; every chang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
    [foot_side.stl, foot_top.stl, head_pad.stl, head_pitch_to_yaw.stl, knee_to_ankle_left_sheet.stl, knee_to_ankle_right_sheet.stl, left_cache.stl, left_knee_to_ankle_left_sheet.stl]
2026-11-07 V1 sit (D59): robot.urdf, robot.xml and robot_motors.xml carry neck_stop, the two neck pads and the head pad on fixed links (14 sit parts, instances 131 to 144); records moved (F127 and F129 M2x6 to 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
    [robot.urdf, robot.xml, robot_motors.xml]
2026-11-07 V1 sit (D59): slice records (47 STLs), mass budget with the neck stop block and pads, print table rows; TEST_PLAN 19.8 (screw pull-out) and 19.9 (get-up servo margin); D59 text for the new stops; BOM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
    [parts.csv]
2026-11-07 WIP V1 sit (D59): the neck block keeps out of the S2 and S7 cable lane behind the windows (C3 found a 1.2 mm rub); the head hook is carved by the trunk's front top over the neck and head ranges toget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
2026-11-07 V1 sit (D59): final CAD of the neck stop block (13.3 cm3, 14.8 g, out of the S2 and S7 lane) and the head hook (3.7 cm3, carved by the trunk over the neck and head ranges); URDF, MJCF, records, slice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
    [head_pitch_to_yaw.stl, neck_stop.stl]
2026-11-07 V1 sit (D59): records and docs for the neck stop block and the head hook: SIT.md sections 1, 2, 5a, 7 and 8, CALIBRATION, STATE, PRINT_PLAN, MASS_BUDGET, MOUNTING, BOM 27 and 28
    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
    [bom_full.csv]
2026-11-07 V1 sit (D59): collision sweep on the final CAD (6 of 6 stops, path 204 and walk 32 clean, 26 get-up states), cables checked again (C3 pass, the block out of the S2 and S7 lane), SIT.md section 3
    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
2026-11-07 V1 sit (D59): SIT.md section 6 (cables on the final CAD); viewer data and BOM_FULL regenerated, 3 scenes load headless
    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
    [fasteners.csv]
2026-11-07 V1 sit (D59): fastener sweep and report on the final CAD; F127 and F129 counted under BOM line 17m (M2x12, 2 of 2)
    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
    [fasteners.csv]
2026-11-07 V1 sit (D59): SIT.md section 3 fastener sweep on the final CAD
    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
2026-11-07 V1 sit (D59): every sim on the final model (stand-up 20/20/20, held-out 20/20/19, push 0 falls, walk 0.100 m/s, balance gate PASS) and the stress on it: the neck block passes, its screws 482 N at the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
2026-11-07 WIP V1 sit (D59) design round 2: neck block with the pad low on the sheet's edge (r 28) and a back foot, the hook doubler over the whole arm face with a 10 mm face, the roll lug 14 mm wide with a con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
    [head_pad.stl, head_pitch_to_yaw.stl, left_roll_to_pitch.stl, neck_stop.stl, parts.csv, right_roll_to_pitch.stl, robot.urdf, robot.xml]
2026-11-07 WIP V1 sit (D59) round 2: the print STLs of the round, the flat roll_pad.stl of the first try removed
    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
    [head_pad.stl, head_pitch_to_yaw.stl, left_roll_to_pitch.stl, neck_stop.stl, right_roll_to_pitch.stl, roll_pad.stl, roll_pad_left.stl, roll_pad_right.stl]
2026-11-10 WIP V1 sit (D59) round 2: the roll lug 0.8 mm behind the case's path (only the conformal pad touches: sweep 6 of 6 stops, path 204, walk 32, get-up 66 states with the programs' ramps); URDF, records,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
    [left_roll_to_pitch.stl, right_roll_to_pitch.stl, roll_pad_left.stl, roll_pad_right.stl]
2026-11-10 V1 sit (D59) round 2: SIT.md sections 1 to 3 (the parts, the stops, the sweep with the get-up ramps and the corner answer), BOM 27 and 28, PRINT_PLAN, D59 note
    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
2026-11-10 V1 sit (D59) round 2: CALIBRATION stop references (neck pads at r 28, the roll pad at r 17.5)
    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
2026-11-10 V1 sit (D59) round 2: cables3d seats_ties.mount_patch no longer loops forever on a zero-area facet (the conformal roll lug's STL has some) and skips curved face groups before the ray search; sit_cabl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
2026-11-10 V1 sit (D59) round 2: sit_balance.json and sit_stress.json regenerated on the round-2 model (balance PASS 75.6 mm; stress all_ok, shove_ok, abuse_ok, stall_ok)
    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
2026-11-10 V1 sit (D59) round 2: cables, fasteners and viewer data on the round-2 CAD
    - sit_cables.py: the trunk-side neck loops (D1, SD1, P13, D13) ran 2.4 to 2.6 mm into the neck block's foot and grazed
    its right pillar; NECK_LANE takes them behind the foot and inside the lane, then every trunk segment is checked
    clear of the block on its exact mesh (worst 1.0 mm). Mounts within 30 mm of a changed or new part are re-checked
    against those parts (a new part over a stock mount was never seen): T021 and T012 under the block, T037 and T051
    under foot_top since the first pass, all placed again with the cables3d search.
    - check_cables.py: run lengths are taken again from the points over the URDF ran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
    [bom_full.csv, fasteners.csv, parts.csv]
2026-11-10 V1 sit (D59) round 2: SIT.md sections 1 and 4 to 9, MOUNTING, STATE, TEST_PLAN 19.2 and 19.8, MASS_BUDGET (2807.8 g), BOM 27
    Section 4: the round-2 stops and the full stress table from sit_stress.json (all 112 rows pass; the three stress
    BLOCKERs closed, the screw pull test a check at 0 N design load). Sections 5 and 5a on the round-2 model (inputs key
    8b6e8c92845763bd). Section 6: the neck lane, the mount re-check and the run lengths, with the cables now at the test
    fit. Section 7: slice and mass. Section 8: BLOCKERs. Section 1: the roll lug and roll pad rows.
    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
2026-11-10 V1 sit (D59) round 2: verification on the head, 21 PASS, 2 FAIL (E6, E6b, as on the base)
    - BOM 17m: the Line $ column held "BLOCKER" and stopped bom_totals.py and bom_md_to_json.py (E2, E3 not run); it is
    0.00 with the supplier BLOCKER, as line 22c. bom.json rebuilt (17m, 27, 28). BOM_FULL regenerated.
    - C9: START_HERE and PRINT_PLAN set counts (49 STLs, 68 parts); the 2026-11-07 PRINT_PLAN note says its set was then.
    - VERIFICATION.md: a full run_all.sh on the head, then --quick after these doc fixes (the sims, sweeps and viewer runs
    reused from the full run of the same head).
    Claude-Session: https://claude.ai/code/session_01Jzg4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
    [bom_full.csv]
2026-11-10 verify: e5 names a reused result by its place in the output folder, not its absolute path (it leaked into VERIFICATION.md under --quick)
    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
    [e5_current_budget.py]
2026-11-10 V1 sit (D59): sit_stress.py keeps the head shove's moment arm in metres (Codex)
    axis_static() takes the arm from MuJoCo's xipos and xanchor, already in metres; the hand calc divided it by 1000 again,
    so the sustained 12 N shove torque was its gravity torque alone, and arm_mm held metres. Now T = 12 N x arm + T_g and
    only arm_mm is converted (48.7 mm to the head pitch axis, 108.6 mm to the neck). Rerun on the round-2 inputs: the hand
    calc now sizes the head forward shove with the torque on (0.70 against 0.55 N m; weakest row 15.21 against 1.5, was
    19.46); every other design load is unchanged; all_ok, shove_ok, abuse_ok and stall_ok stay true. SIT.md section 4
    table and text follow.
    Co-Author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
2026-11-10 V1 sit (D59): the head hook root's polar moment integrated over the face region (Codex)
    head_geometry() took Jp as the mean squared vertex distance about the vertex mean times the area, and the farthest
    fibre from the vertices: a mesh-density average, not the section's moment. sit_stress.py now projects the root shell's
    facets that face the arm onto the x z plane (face_region: their union, holes kept), and integrates its area, area
    centroid, polar moment about that centroid and farthest fibre exactly (area_polar, Green's theorem); the run stops if
    that region and the shell's own area differ by more than 15 %. Unit tests: a rectangle off the origin, the unit square
    from its corners (1/6, not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
2026-11-10 V1 sit (D59): service loop spans and tie positions follow inserted route points (Codex)
    move_points() (the jog points) and neck_lane() inserted points, but each loop's span/spans and ties_at_mm kept the base
    indices and arc positions, so C3's loop check and grow_loops() could look at a stationary segment (P13's neck crossing
    moved to points 14 and 15, its loop stayed at 13 and 14). sit_cables.py now tags every run point with its base index
    and arc length before the edits and remap_loops() moves each crossing pair to the new index of its base point, checks
    that pair crosses the loop's joints, and maps the loop ties to the same fraction of the same base segment. The base
    already had 7 SP4 and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
2026-11-10 Get-up through the sit (D60): the search report and programs in the repo, re-run on the merged sit model, 248 of 296 (sim pass only)
    - twin/sit/getup/GETUP_VIA_SIT.md: the search report (local paths removed); programs/roll_back3.json beside chain_v3r and hand_I.
    - twin/sit/getup/VIA_SIT_EVAL.md and via_sit_runs.jsonl: the 296 cases on aad3a9a in the shared lab gym
    (overlay gym/overlays/duck): back 156/156, side 68/68, front 24/72, case by case the same as the search; torque,
    current and duty margins unchanged (hip pitch at its limit up to 1.08 s, no protection line held 2 s); every pose
    inside the stops and the SIT.md section 3 head rule.
    - SIT.md, STATE.md, GAPS.md B6, TEST_PLAN.md 19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
2026-11-10 Get-up via the sit eval: knee current with the STS3250 back-EMF constant (peak 1.43 A, 2 s mean 0.81 A, still far under the 3.8 A line) (calc only)
    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
2026-11-11 Nest charging dock (D61) replaces the feet-contact dock (D58): decision record, evidence in twin/dock/nest, STATE and history (sim pass only, calc only, CAD check only)
    - DECISIONS.md: new D61 with Ahmed's words, the concept, what it changes
    (D58 replaced, D50 four nets to two, D43 stands without tags), why the
    other routes were dropped, the sim evidence and the open BLOCKERs.
    D58 carries a superseded note; its text is kept.
    - twin/dock/nest/: the concept study, the stripe mat study and the
    sequence sim (540 runs) with their 17 figures and a README. Local
    paths removed; no videos, no scripts.
    - STATE.md: new Nest dock section. One new history entry.
    Concept only: no CAD, nothing b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
2026-11-11 Nest dock evidence (D61): prices removed from the copied reports (repo rule: no prices beyond the BOM)
    Every currency amount in twin/dock/nest/NATURAL_DOCK_IDEAS.md and
    stripes/STRIPE_MAT_STUDY.md is replaced by "price: BLOCKER, not
    recorded here" or dropped where the part is already in the BOM.
    sim/NEST_SIM.md and the README had none. Nothing else changed.
    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
2026-11-12 Nest dock: archive all work in progress (scripts, raw results, CAD, v2 sim) with a handover; project paused (sim pass only, calc only, CAD check only)
    - twin/dock/nest: scripts and JSON results of the concept study, the first
    sequence sim and the stripe study beside their reports; three clips;
    sim/v2 (the straight-crossing re-run, finished after D61); cad (the nest
    CAD with checks, renders, STL, STEP, GLB); superseded_feet_dock_d58 (the
    D58 feet-dock study, record only).
    - Archive only: nothing installed in print/, the URDF, the netlist, the BOM
    or the viewer.
    - Public repo cleaning: local paths removed, script paths made relative or
    set by environment variables, prices replaced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
    [body_middle_bottom.stl, body_middle_bottom_feedthroughs.stl, nest_assembly_new_parts.stl, nest_bolster_left.step, nest_bolster_left.stl, nest_bolster_right.step, nest_bolster_right.stl, nest_box_lid.step]
2026-11-12 Nest dock sims: wall and rim clearance over all runs, split by outcome (review finding; sim pass only)
    - sim/analyze.py and sim/v2/compare.py computed wall and rim clearance only
    over runs that reached a sit. Both now use all non-error runs and report
    three groups: reached a sit, fell, never sat without falling.
    - Summaries made again from the archived run JSON (nest_results.json,
    compare.json, compare_table.md, compare.log). No MuJoCo run repeated;
    every other number in them is unchanged; the figure is unchanged.
    - Straight crossing, all 540 runs: 9 runs with a part inside the wall
    plane or the rim (5 reached a sit, 3 fell, 1 never sat), not 5.
    Steering walk-on, all 540 runs: 0,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
2026-11-12 Allow a pin coupon before gate 0, and drop the false bay resize
    Gate 0 still blocks the duck, the welded pack, and the full order. A few
    pins and scraps of cloth and felt may be bought after Ahmed says yes, so
    the contact measurement has a path. The opened cell maximum already fits
    the sleeved bay of 22.2 by 43.7 by 71.0 mm. CAD check only.
2026-11-12 Point the power and heat twins at the P45B pack and the STS3215 sheet.
    The closed loop now reads the P45B discharge figure. The sheet-stall servo falls on the as-built bus. A docked charge with the charger in the trunk stays inside the cell, servo, and PLA windows on the thermal model. A walk still leaves 60 C.
    [session_bam_backlash_high-side.csv, session_bam_backlash_typical.csv]
2026-11-12 Treat the docked sit as stationary and heat the walk with RMS current.
    The sit no longer gets walking airflow. Pack and BEC resistive losses use the RMS current in each bin. The charger still stays inside the cell, servo, and PLA windows on this model. A walk still leaves 60 C.
    [session_bam_backlash_typical.csv]
2026-11-12 Check the knee heat numbers against the walk log and the STS3215 sheet.
    The 94.7 C body is the no-cutoff run. With the sheet torque-off on, the case peaks near 64 C. Continuous walking in this model still leaves 60 C.
2026-11-12 Drop the bought sentence from the knee heat study and its history note.
2026-11-12 Add a whole-duck audit and the plan to land the nest.
    The walking duck model is already in the print set, netlist, cables, and fasteners. The audit records the true gaps and schedules the nest install after the nest folder is finished.
2026-11-12 Name the current wiring sheets in the duck audit.
    The older schematic generators are kept and are not the drawings to build from. The communications row now records the unused Pi UART and the absence of SPI.
2026-11-12 Name the nest probe and reopen stock for the bill.
    The 100-40 catalog tip is 1.40 mm, not the drawn 2.3 mm. Felt, the gold cloth pair, the weld, and the M2x12 screw stay without a buyable part number. Live pages show the bare Pi and the P45B out of stock.
2026-11-12 Add the knee heat guard and the software, link, and efficiency notes.
    The walk stops at a 55 C servo reading, rests with torque off when idle or sitting, and may start again below 45 C. The Runtime is unchanged.
2026-11-12 Add the Camera Module 3 field on the measured head seat.
    The standard brief's 66 by 41 degree field is placed on the existing camera seat. On this head the wide axis is up and down. A level head sees the gold disc and ring from 1 m and from 2 m, and not at 0.3 m or 0.5 m. The sit looks away from the cloth. TEST_PLAN 20.9 stays not run.
2026-11-12 Add the nest contact twin for pin force, cloth resistance, and felt.
    The four spring pins are the catalog spring at the sit stroke. A missed pin, the cloth loop, and the felt dent are calc only, with the bench rows that would replace each blocker.
2026-11-12 Count disc pixels on the pinhole image plane.
    The rectangular field is rectilinear. A point's place on an axis is c[axis]/c[2], times the pixel count over twice the tangent of the half angle. The head-down 0.75 m near-to-far size is 187 pixels. Which samples fall inside the field did not change.
2026-11-12 Add the in-body charger board schematic.
    The MCP73213 reference circuit for the 2S P45B pack: 1.10 kOhm for 1 A, nest-contact protection, pack NTC window, and STAT on GPIO5. Calc check included. The robot netlist is not changed.
    [charger_board.kicad_sch]
2026-11-12 Escalate a failed torque-off, and require every servo to cool.
    A turn_off error now runs the existing hard stop. A cool staggered group no longer clears a knee that was not in that read.
    [walk_with_guard.py]
2026-11-12 Unload the nest pin when the felt dents under the tip.
    A local dent lowers the cloth while the body stays on the soles and the seat, so spring compression falls by the dent. The least bumper pin can lose contact.
2026-11-12 Note the proposed 1.40 mm tip beside the tip 40 pressure.
    The parts audit names 100-PRP4030S. That larger face is still several times the felt's 10 percent pressure, and the dent still unloads the spring.
2026-11-12 Move the charge window inside the cell limits and draw every part.
    The cold and hot dividers now trip at 2.60 C and 56.61 C so a 1 percent stack still stays inside 0 C to 60 C. The KiCad file is generated from the board yaml and includes all 28 parts.
    [charger_board.kicad_sch]
2026-11-12 Grade flush charge contacts against the five-line bar.
    Neither belly pins nor feet clear every line. The study keeps five flush seat wells as the layout to build toward, with the blind-sit window and the wear test still open.
2026-11-12 Nest sim v3: mixed walk-in, two 1 mm mat steps, and a 215 mm wall study (sim pass only).
    The mixed controller matches the spliced tables (503 of 540 first sit, 526 within 3 sits). Two 1 mm steps remove the trips (0 falls, 524 of 540). Aiming 20 mm right at 7.2 V raises that charge and tightens the head gap. A study with the sun 215 mm from the wall puts the worst head gap at 47.4 mm. The approved 190 mm is unchanged.
2026-11-12 Fix the nest ramp height and re-run that 540 (sim pass only).
    The ramp fraction was stored as a height-field sample, so the outer third sat under the floor. It is now a physical height converted to a sample. The re-run gives 0 falls, 523 of 540 at the first sit, and 539 of 540 within 3 sits.
2026-11-12 Extend the structure twin with a margin geometry check and a topology cut.
    Re-run the existing linear FEA on a voxel mesh of the current parts, thicken the ear wall and the loaded sheets where clearance allows, and record that an interior foot carve keeps the margin but makes the slicer heavier. Proposed STLs stay under twin/structure/topology/ and are not copied into print/.
    [foot_top.stl, knee_to_ankle_left_sheet.stl, knee_to_ankle_right_sheet.stl, left_roll_to_pitch.stl, neck_left_sheet.stl, neck_right_sheet.stl, right_roll_to_pitch.stl, shin_left_sheet.stl]
2026-11-12 Fix the hip pitch sweep, the right ear-wall overlap, and the foot support STL fallback.
    The thigh clearance now uses the joint origin. The negative-x pad overlaps the wall, so the right roll STL has the same component count as the stock file. Re-FEA of that pad is walk 2.41 and soft-fall worst 0.78.
    [left_roll_to_pitch.stl, right_roll_to_pitch.stl]
2026-11-12 Note which later pull requests covered audit gaps.
    The 2026-11-11 sections stay as written. The note records parts, software, the camera, the contact twin, the charger board, the open flush study, the nest sim, and the structure pass.
2026-11-12 Record that the contact twin and the charger board are merged.
    The flush study had said PR 39 was still open. It is merged. Its pin-on-cloth numbers stay out of the flush grades. The charger board is the pack charger, not the mat switch.
2026-11-12 Blind nest walk-in: camera field, then measured-speed dead reckoning (sim pass only).
    At 190 mm the first sit charges in 35 of 540 and 380 of 540 first seats land in the flush window. A 215 mm study is not better. Raw command integration stops about 280 mm short and charges 0 of 540.
2026-11-12 Name the two blind-walk scores so 35 and 380 are not read as one test.
    The 35 of 540 is the old sun-and-ring pin rule. The headline is the flush box: 380 of 540 at the first sit and 386 of 540 within 3 sits. The old pin counts stay as a second column.
2026-11-12 Give the shin drive eye a head-side web that clears the margins in PA6-CF.
    The stock eye and the other print materials stay under the walking and soft-fall lines on this load set. The web is a proposal under twin/structure and is not copied into print/.
    [shin_left_sheet_collar_cbore.stl, shin_left_sheet_taper.stl, shin_left_sheet_taper_cbore.stl, shin_left_sheet_web.stl, shin_left_sheet_web_cbore.stl]
2026-11-12 Reconcile the shin eye safety factors at the 0.75 mm voxel pitch.
    The 0.58 walk was the stock eye at 0.8 mm. At 0.75 mm the same study returns the topology stock walk 0.80 and the collar walk 1.30. The lab printer for PA6-CF is not known.
2026-11-12 Correct the blind re-sit heading and name the two charge scores.
    The turn now writes the simulated IMU yaw into the estimate before a re-sit. First sit is unchanged (flush box 380 of 540, old sun pins 35 of 540). Within 3 sits on the old pin rule is 43 of 540, not 98. The flush box is the headline score.
2026-11-12 Compare four ways to keep the nest in view up close (sim pass only).
    The wall card lands 533 of 540 first sits in the flush window, with the same one fall as the blind walk. Holding the head down makes the walk worse. The wide lens helps and still loses the sun near 0.31 m. Looking down at the turn adds falls and does not move the count.
2026-11-12 Match the close-up baseline to the merged blind run file.
    The merged 190 mm file has 0 falls and 383 of 540 within 3 sits, not 1 fall and 386. The wall card's fall is seed 211019, a miss on that baseline that tips while standing at the fine stage.
2026-11-12 Add a life note for heat, stress, and what breaks first.
    Reuses the thermal model, the current-print FEA, the shin eye study, and the 55 C guard. No new part.
2026-11-12 Red team the duck and the twin: ranked findings from the existing runs
    Rank the twin's weak claims from the existing nest runs, and keep the card 47 mm count as a seat-centre proxy rather than a pin hit.
2026-11-12 One order bill for the duck and the nest (#50)
    * Add one order bill for the duck and the nest.
    Collect the existing BOM, netlist, charger, nest, flush contacts, wall card, and shin-eye filament into altaay_lab/bom/order, with a match check against those files.
    * Add the Pi-header KK parts and the flush-well diode path.
    Both were already named and were missing from the order bill. The housing set and the diode path stay BLOCKER.
    ---------
    [ORDER.csv]
2026-11-12 Add a home companion plan and a local assistant demo.
    Rank published home behaviors and the blocks to reuse, wire a mock cloud client with no keys, and log a 480-step CPU smoke of the upstream walk trainer. The assistant imports its mock through the package path.
    Sim pass only for the smoke. Nothing ran on a duck. The paid GPU run still waits for an OK.
2026-11-12 US sale rules and a restricted-party check of the bill
    [PARTS_CHECK.csv]
2026-11-12 Cost-down: servos, pack, and print bounds
    A cost-down study under altaay_lab/costdown/. Prices stay in COSTS.csv. The heat rerun uses the integrator peak and t_cut, after the Codex note on 10 s samples.
    [COSTS.csv]
2026-11-12 Audit every duck and nest fastener already in the CAD
    The schedule reuses the existing screws, inserts, and build order. It does not add a screw or a mount. Later pads that bury the existing heads, and the build-order lines that disagree with the fastener file, are listed as edits for their owners.
2026-11-12 Name a plug or a solder end for every harness wire
    Names a plug or a solder end for every active netlist wire, using XT30, Mini-SPOX, KK 254, and WAGO 221 parts already on the bill. The battery socket return is checked on P-, not B-.
    [d2_plug.bom.tsv, servo_plus.bom.tsv, servo_plus.yml]
2026-11-12 DFA check: 324 fitted screws stay, no new latch
    CAD schedule count and the check that no fitted screw can be removed without a new latch or a strength loss. Codex review completed with no findings.
2026-11-12 Price the opened distributor lines on the order bill.
    DigiKey and Bolt Depot pages opened today replace the not-opened marks on the charger parts, fuses, speaker, foot switch, diode, zener, Mini-SPOX housing, and socket screws. Out-of-stock parts were swapped only for the same spec.
    [ORDER.csv]
2026-11-12 Match the build order to the fastener file and propose a nest lid fix.
    F127 and F129 are M2x12, F344 and F347 are M2x5, left-out screws are not driven, and the mic and cliff screws are in the order. The nest lid proposal stays off the chamfer and uses the existing M3x8 with a deeper bore. The nest STL is not changed.
2026-11-12 Rank the sheet-stall fall as the first open problem
    The sheet-stall walk falls at 3.4 to 3.6 s on the existing twin. The 7.4 V stall matches the datasheet. A slower command and a trained gain with matching current do not keep both bus corners up. Red team items 2 to 5 stay open.
    [dock_sim.py, foldback.py, stall_walk.py]
2026-11-12 Move the proposed lid posts clear of every reserved nest box.
    y 62 cleared the jack and entered the fuse holder and the gate board. The posts now sit at y 2 and -2, still mirrored about the tray centre, with at least 2 mm to each stand-in.
2026-11-12 Volume prices at 1, 100, and 1000, with the Waveshare stall check
    Every order line is priced only where a supplier prints a break. The in-stock one-duck sum excludes out-of-stock lines. The Waveshare stall match does not by itself say that servo falls: the published fall is the sag on the as-built bus.
    [VOLUME.csv]
2026-11-12 Nest mat v2: flush striped felt, no pins on the duck (#61)
    * Add the nest mat v2: a flush striped felt field and no pins on the duck.
    Score the stored 540 seeds against that window and the smaller magnetic and coil windows. CAD, STEP, STL, and the sit renders are in altaay_lab/cad/nest_v2. D61 is not edited.
    * Extend both foil poles across the seat window and fit the cord cap in the opening.
    The minus stripe no longer stops short of the back of the field, and the cap no longer overlaps the pocket walls. The stored 540-seed counts are unchanged.
    ---------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
    [cord_cap.step, cord_cap.stl, cord_pocket.step, cord_pocket.stl, felt_base.step, felt_base.stl, felt_top.step, felt_top.stl]
2026-11-12 Make the splice choice, the pack bead, and the charger watts agree.
    WAGO 221 is now the netlist text for the four power nodes, and the order bill follows it. The pack bead plugs into the divider already in the charger note. The 9.5 V heat is 2.30 W and 3.50 W. STAT and enable cuts stay open because the CAD has no route.
    [ORDER.csv, continuity_checklist.csv]
2026-11-12 Record D62: the striped felt nest supersedes the spring pins.
    Ahmed approved the mat. D61 is unchanged. The old pin drawing, the order note, the checklist, and the charger note now point at altaay_lab/cad/nest_v2/. No file was deleted.
2026-11-12 Test free bus changes against the sheet-stall fall.
    Thicker hops, shorter feeds, a knee star, a 470 uF cap, and the cited
    7 milliohm cell line still fall near 3.5 s on both corners. No change
    in the set walks 20 s. Worn cell resistance stays unknown.
    [bus_sag.py]
2026-11-12 Connect the pack bead to the comparator that stops charge.
    The MCP73213 pin table has no thermistor pin. The bead now feeds the bias, cold, and hot resistors into the comparator, and both outputs pull the enable gate down.
    [ORDER.csv, continuity_checklist.csv]
2026-11-12 Screw cuts: 14 clips, fitted count 310, still over 200
    The 56-screw gap is the factory case screws. A K3 clip sized by pull-off, not barb shear, clears 14 screws. Fitted count would fall from 324 to 310. Under 200 is not met. Codex finding on release force is answered in the pull-off commit.
2026-11-12 Stop the power sheet from drawing the removed sense wire.
    The bead no longer joins the SENSE splice, so the sheet call for that pair is gone. Regenerating the sheets now finishes.
    [make_sheets.py]
2026-11-12 Split the knee dip into pack, copper, and harness volts.
    The sheet walk's lowest knee is at 17.9 A, not 5 A. Zeroing the unmeasured drops still falls.
2026-11-12 Put the sense-to-bead route back in the cable file.
    Those 158 lines were the only copy of the splice-to-bead path. The file matches current altaay-lab again, and the conductor is back in the netlist. The bead pin is on both nets until that is decided.
    [continuity_checklist.csv]
2026-11-12 Test the 12 V STS3215 on a 3S pack in the sheet walk.
    Both corners hold 20 s. The drawn bay, the MCP73213, and the 2S protection board do not fit three cells.
    [sts12.py]
2026-11-12 Replace the knee-cap delay with a backward-Euler companion.
    The 470 uF row was holding the previous current for one step. The regenerated walk still falls at 3.56 s and 3.42 s.
    [bus_sag.py]
2026-11-12 Re-run the docked charge at 2.30 W and 3.50 W, and refresh gate 0 for PRs 45 to 66.
    The sit table uses the reconciled MCP73213 heat. Cells and the trunk wall stay inside the cited windows. The die on the cited 62 C/W board crosses 110 C if the current stays at 1 A. Felt temperature and the plastic against the package stay BLOCKER. The checklist marks each row done, partial, or BLOCKER. Nest v2 is the approved nest. Fitted screws are 310 on paper. The sheet-stall fall stays open.
    [gate_charge_watts.py]
2026-11-12 Work out the duck's domestic component share under DA 26-786
    The FCC FAQ states the 65 percent content test and says the off-the-shelf waiver does not apply. On the priced lines the domestic share is 6.07 percent. Seven current lines, led by the servos, are the smallest set that clears that gap.
    [DOMESTIC_ROWS.csv]
2026-11-12 Walk the 12 V servo for 60 s with the third cell in the trunk.
    A rear blister fits the cell without moving a screw. The nest voltage window still stops at 10 V.
2026-11-12 Count the seat wells and duck-side diode paths as unpriced components
    Both sit in the duck. Neither has a price, so both stay BLOCKER. The 6.07 percent share does not change.
    [DOMESTIC_ROWS.csv]
2026-11-12 Close the rear blister with 2.5 mm caps.
    The outer cylinder now extends past the cell cut, and the rays through the protruding cavity read 2.5 mm of plastic above and below.
2026-11-12 Set the 3S nest window on the same mat and price one 12 V servo.
    The supply is 15 V with an SMAJ16A. The 9.5 A sample stays under the 13 A trip. Fourteen Waveshare servos add 22.82 dollars.
2026-11-12 Keep PVCC under 20 V by opening the input FETs.
    The 26 V SMAJ16A clamp is legal for AVCC and not for PVCC. The datasheet pair opens at an 18 V input setpoint.
2026-11-13 Add the BQ24133 sit heat and the 2S fallback.
    At the planned 1.00 A the 3S loss is 0.963 W at 12.6 V. Cells, the PLA wall, and the die stay inside the cited limits. The 2.50 A maximum crosses 120 C. A 2S current limit that stays under 150 C misses the 6 hour timer. The same chip with CELL floating is the 2S fix. Nest v2 is unchanged.
    [gate_bq24133.py]
2026-11-13 Mark the docked sit blocked and treat die heat as an upper bound.
    The nest feeds the servos at 14.7 V, outside the 4 V to 14 V page, so pack-fed rows do not clear the gate. Converter loss includes the inductor and the sense resistor, so it is not the die. The 2.5 A crossing of 120 C is not confirmed.
2026-11-13 Add the 12 V 3S training config and a CPU smoke.
    The playground runner is unchanged. The config sets the sheet actuator, the 3S bus voltage, and the 70 g cell. The smoke is not a gait.
2026-11-13 Keep config generation out of the trainer process.
    Writing the config imports the inference stubs, so a combined write and smoke now writes in a child process. Inertial updates clear the old quat and diaginertia before setting fullinertia, the same replacement the mass copy already uses.
    [train_sts12.py]
2026-11-13 Cut the docked servo rail and draw the BQ24133 board.
    Hold the existing Pololu 2815 off while the nest is present so the servos sit at 0 V instead of 14.7 V. The 15.0 V nest and the nest v2 mat stay. Add the BQ24133 schematic, netlist, and BOM beside the MCP73213 record.
    [bq24133_board.kicad_sch]
2026-11-13 Check the limp nest sit and the awake pack current.
    The sheet does not print a backdrive torque, so the seated hold is blocked without that number. The Pi typical, if it stays on the pack, is 0.143 A and sits above the 0.10 A charge termination. Feed the 5 V branch from the nest instead.
2026-11-13 Feed AVCC from the adapter and swap the dock comparator.
    AVCC has to sit 300 mV above the pack before the input FETs turn on, so the 10 ohm feed comes from the fused adapter node. The LM393 sinks when the inverting input is higher, so the nest tap is that input and the switch stays off only while docked.
    [bq24133_board.kicad_sch]
2026-11-13 Let the servo rail turn on from the pack while still seated.
    The nest no longer reaches the servo switch, so enabling it does not put 15 V on the servos. The dock comparator is a flag to the Pi and does not hold the switch off until the contact opens.
    [bq24133_board.kicad_sch]
2026-11-13 Use one rail interlock and mark the unpowered sit blocked.
    Dock detect forces the servo rail off during charge. The Pi end-charge line releases that clamp and disables the charger, then the rail request can turn the pack-fed switch on before the duck stands. Felt and backdrive numbers were not found, so the seated hold stays blocked until a spring-scale bench. Two or three servos under 0.10 A do not hold the seat when friction is zero.
    [bq24133_board.kicad_sch]
2026-11-13 Match the rail interlock to the sit branch.
    Dock detect forces the servo rail off during charge. The Pi end-charge line releases the clamp and disables the charger, then the rail request turns the pack-fed switch on before the duck stands.
    [bq24133_board.kicad_sch]
2026-11-13 Add the filament, wire, and tool pages that opened today.
    The buy-today total now includes PLA, TPU, the four silicone gauges, the KK 254 replacement, and the supplies whose seller pages showed stock. Unavailable named listings stay off the total.
    [ORDER.csv]
2026-11-13 Mark the old sense tap superseded and align the current duck.
    The bead pin stays on NTC_MID only. The 2S fall, the 2S BEC case readings, and the earlier order totals stay in the files as superseded. The buy-today total is three cells at 1195.44 dollars, calc only. D61 is unchanged.
    [DOMESTIC_ROWS.csv, ORDER.csv, continuity_checklist.csv]
2026-11-13 Put the 12 V servo on the order and restate the share.
    The Waveshare line at 20.63 dollars replaces the 7.4 V Seeed price. Buy-today is 1204.26 dollars. Per-duck parts, without tools and full spools, are 957.75 dollars. The domestic share is 5.23 percent. Older figures stay marked superseded. D61 is unchanged.
    [DOMESTIC_ROWS.csv, ORDER.csv]
2026-11-13 File the 12 V run C walk and supersede the 0.088 m/s result.
    Run C holds 60 s with no fall, up to 0.252 m/s typical at a 0.40 command, sim pass only. The old policy numbers stay in FIT3. The policy file is under 1 MB.
2026-11-13 Mark the 2813 harness rail superseded by the 2815.
    The pins and wires stay so the earlier checks still run. The rail to build is the Pololu 2815 with the BQ24133 interlock.
2026-11-13 Add a US-made parts study for the domestic content gap.
    The study keeps the selected BOM and the twin, and records which lines have a true US equivalent.
    [US_PARTS.csv]
2026-11-13 Add an end-to-end test playbook with FMEA, bench records, and CPU fault runs.
    The playbook maps Definition of Done gates to tests, writes the characterization and wear procedures, and files the 12 V BEC heat case and fault-injection results as sim or calc only.
    [characterization_template.csv, tp_07_servo.yaml, tp_09_walk.csv]
2026-11-13 Set the 3S BEC to 12.0 V and reject set points outside cited limits.
    The 16 V pass-through and the 7.2 V netlist set point are marked superseded. The pack domain is 9.0 V to 12.6 V, and U3 VIN uses it. A check fails if a live set point leaves a cited range or if the netlist and the sim configs disagree.
    [check_power_limits.py, em_twin.py, gate_bq24133.py, make_sheets.py, mass_budget.py]
2026-11-13 Fix bench gate exits and use RMS current for pack heating.
    A failed hop or walk gate now exits nonzero, and a filled bench id the prediction does not name cannot pass. Walk I^2 R uses scaled RMS pack current. The 25 C BEC case is 60.7 C, sim pass only.
2026-11-13 Keep the shared 2S BEC default at 7.2 V.
    The 3S studies still pass 12.0 V. A two-cell pack cannot hold 12 V, so the shared power-path default must keep regulating at 7.2 V. The limit check rejects any other value in that default.
2026-11-13 Compare pack voltage and cell choices against the run C walk.
    The 12 V C018 on 3S was a sag fix, not a ranked optimum. This pass scores the rails and the cells that fit the bay, and walks the straight 3S pack, the Castle at 12.0 V, and a regulating 4S buck on the existing electromechanical twin.
    [system_voltage.py]
2026-11-13 Take the Castle off the wire-rail body and use switcher charge loss.
    The wire walk now removes the 29 g body, the output leads, the tape, and the two output splices at the BEC seat. The rerun keeps the same printed speed and current. Charger heat uses the Figure 10-4 efficiency instead of a linear drop.
2026-11-13 Add the knee-heat and chafe study with CPU thermal runs.
    The 3.3 minute and 95 C headlines are re-run on the existing twin, then a walk/sit guard and a per-limb eFuse are scored against the cited limits and the ATOF curve.
2026-11-13 Add servo idle heat on walks and stop treating the 100 ms average as a pulse.
    Walking bins now include the C001 21 mA idle, matching gate_p45b, and the 0.70-current case no longer sits under the PLA edge. The eFuse blanking note marks jog compatibility as open because the 13 A figure is a moving average.
    [knee_heat_chafe.py]
2026-11-13 Add run C per-joint current and rerun the Castle-off walk.
    The sheet walk now keeps every servo's motor and supply current on the 3S wire rail. Knee heat uses those amps. The Castle mass edit is written into the MJCF before MuJoCo loads it, because the earlier patch returned a new mass and left the file unchanged.
2026-11-14 Integrate every current bin and store the first fall time.
    The thermal step was 0.5 s on 0.1 s bins, so four bins in five never heated the model. Each bin is now one step, and a fall list no longer crashes the cut. The CPU rerun puts 55 C at 1.16 min, the case peak at 61.06 C, and the 25 C guard walk share at 0.140. Sim pass only.
    [runc_joint_current.py]
2026-11-14 Redraw the wiring sheets at the 12.0 V BEC set point.
    The merged netlist sets the Castle to 12.0 V. The committed sheets still said 7.2 V. Regenerated from the netlist. Coverage is 193 of 193 active wires.
2026-11-14 Keep the voltage study's wire model out of the design set point.
    system_voltage.py passes BEC_V 30 and zero dropout to model a straight wire. That is a study input. The checker still requires the netlist and the live sim default to hold 12.0 V and 0.3 V.
2026-11-14 Stop the limit checker from reading its own study note as a set point.
    The wire-model exception mentioned 30 V in a form the scanner treats as an assignment. The note no longer looks like a set point, and the wire study stays out of the design check.
    [check_power_limits.py]
2026-11-14 Ignore the voltage study wire stand-in in the design limit check.
    The adopted Castle set point stays 12.0 V. The straight-wire model is recorded and is not a second set point.
2026-11-14 Treat stored heat dumps as results, not as the design dropout.
    The run C wire cases record a zero drop because that study has no Castle. The design dropout stays 0.3 V.
2026-11-14 Mark the skipped-bin heat clocks unreliable and keep the regulator.
    Commit 6d8c153 stepped the thermal model at 0.5 s on 0.1 s bins. Those clocks stay in history and are labeled UNRELIABLE. The table is the CPU rerun that uses every bin. D64 keeps the Castle. The limb breakers, PETG knee sheets, and the rest rule are recorded and not installed.
    [continuity_checklist.csv]
2026-11-14 Hold the 3S servo rail at 12 V and close the protector, charger, and limb breakers.
    The Castle buck cannot keep 12 V while a 3S pack sags from 12.6 V to 9 V. The i7C buck-boost is set to 12.0 V, the pack uses a 3S protector and the BQ24133 charger with the bead on TS, and the three limb breakers sit in series with the servo feeds.
    [ORDER.csv, bq24133_board.kicad_sch, continuity_checklist.csv]
2026-11-14 Stop the walk at 10 V and seat the 3S protection board.
    The i7C current chart that was read starts at 10 V, so walking now stops at 10.0 V pack before the regulator is asked for an uncited current. The 60 mm protection board gets a rear pocket on the body back. The charger thermistor is on the TS pin, in parallel with the 12.7 kOhm resistor.
    [body_back.stl, bq24133_board.kicad_sch]
2026-11-14 Add one command that runs the duck twin end to end.
    The walk, the 10 V pack stop, the heat model, and the charge estimate all load the same parts file as the netlist and the order. Camera docking stays a blocker.
2026-11-14 Run the twin for 45 minutes with the heat rest inside the walk.
    The default session stops at the 10 V pack cutoff or at 45 minutes. The 10 V floor is only passed for the 3S run, and the regulator check uses output current. The nest trial uses run C at 12 V. Camera docking stays a blocker.
2026-11-14 Say what the 2.808 kg duck mass includes.
    It is the whole robot in the mass model, and MuJoCo loads the same total. The trunk body alone is 1.065 kg. The stock model is 2.107 kg. The file still has two cells and the Castle regulator.
2026-11-14 Match the MuJoCo mass model to the current bill.
    The walk model now carries the third P45B, the i7C, the 3S protection board, the BQ24133 board, and the limb breakers. The parts check fails if that rollup and the loaded MuJoCo total differ by more than 5 g.
    [mass_budget.py, parts_truth.py, run_twin.py]
2026-11-14 Use the cited 1 ohm knee heat and a stand that cools.
    The one-minute 55 C clock came from treating the stall-line resistance as copper. The C018 sheet prints 1.0 ohm, and that is what the Robo9 hold matches. The session now stands when the knee reaches 55 C, so it cools and walks again. A separate check folds to the 147 deg sit with the gains off.
    [em_twin.py, run_twin.py]
2026-11-14 Show the 17 A pack peak does not open the 15 A fuse.
    The peak lasts 12 ms, under the cited hold time. The cell node is the three P45B cans, and it ends at 43 C, so the charger temperature stop stays open. The knee still reaches 55 C because the sensor reads above the case once the copper heats.
2026-11-14 Make run D the twin walk and pin the policy it loads.
    make twin was walking the stock BEST_WALK_ONNX_2 because the ONNX path froze before the walk started. The rerun uses sts12_runD_policy.onnx: 41.48 walking minutes, 0 rests, knee peak 38.4 C, pack peak 13.81 A.
