aaltaay/Open_Duck_Mini_v2/(notices)

Notices in the files:
altaay_lab/compliance/COMPLIANCE.md:
7. Open-source licenses for the code and the CAD:
Applies: yes, to a duck that ships this code or is printed from this CAD.
The LICENSE file in this repo is Apache-2.0. If the code is redistributed, including in a product, the license requires a copy of the license for the recipient (section 4(a)), a notice on files that were changed (section 4(b)), and the copyright, patent, trademark, and attribution notices kept (section 4(c)). Section 4(d) applies when the work has a NOTICE file. This repo has no NOTICE file. Section 6 does not grant trademark rights, except the ordinary use of a name to say where the work came from. Section 3 includes
The dock copy of autodock is Apache-2.0. The license file and the change notes are kept. altaay_lab/software/dock/THIRD_PARTY.md records the copy. Keep those headers if that code ships.
altaay_lab/twin/companion/COMPANION.md records that the pretrained wake-word models are under CC BY-NC-SA 4.0, which is noncommercial, and that the duck trains its own model for that reason. Do not ship those pretrained models in a product that is sold.
The Onshape document is public. altaay_lab/README.md says its license is not stated. The Apache license on this repo does not by itself license a CAD file that is not in the repo. BLOCKER for selling printed parts, until the CAD terms allow the sale.
Must do: ship the Apache license with the code, mark changed files, do not ship the unlicensed runtime, playground, or reference generator, do not ship the noncommercial wake models, and do not sell under a character name this repo has no right to use.
